ITSMEEME/PropBoard/motoranschluss_varianten/README.md

# Fünf Varianten für den Motoranschluss

Fünf eigenständige Konzeptbilder für 1, 2, 2, 3 und 4 Carbonrohre. Direktanschluss am starren Rahmenknoten und kompakter Aluminium-Motorknoten mit integrierten Befestigungsaugen am feststehenden Motorfuß; keine separate Motorplatte. Ein tatsächliches Klappgelenk ist nicht ausgelegt. Die vorhandene Motor-/Rotorbaugruppe wird durch diese Bilder nicht umgebaut oder freigegeben.

V1 verwendet Ø35/32 mm als neuen Vergleichsquerschnitt. V2–V5 verwenden den vorhandenen Ø20/17-mm-Querschnitt. Ø35/32 ist kein nachgewiesener Kaufartikel.

| Variante | Rohre | Rohrquerschnitt | Nur Rohrmasse je Arm |
|---|---:|---|---:|
| [V1 – Einrohrarm](V1.png) | 1 | Ø35/32 mm | 97.2 g |
| [V2 – Vertikale V-Gabel](V2.png) | 2 | Ø20/17 mm | 108.1 g |
| [V3 – Horizontale V-Gabel](V3.png) | 2 | Ø20/17 mm | 108.0 g |
| [V4 – Räumliches Dreieck](V4.png) | 3 | Ø20/17 mm | 161.8 g |
| [V5 – Vierrohr-Raumrahmen](V5.png) | 4 | Ø20/17 mm | 216.3 g |

Rohrmassen beruhen auf den angenommenen Zuschnittkoordinaten und1600kg/m³. **Keine Gesamtmassen-Rangfolge:** Aluminiumknoten, Klemmkappen, Schrauben, Isolierung und Verbindungsmaterial sind noch nicht volumetrisch geschlossen. Weniger Klemmstellen sind ein Gewichtsargument, aber kein Festigkeitsnachweis.

Die bisherige separate D05-Motorplatte wiegt 502.4g je Motor beziehungsweise 2.010kg für vier Motoren. Ihr Entfall ist eine Brutto-Entnahme; neue integrierte Knoten müssen gegengerechnet werden. Die bisherigen Endschotte sollen durch die direkten Knoten ebenfalls entfallen, sind jedoch nicht als zusätzliche gesicherte Nettoersparnis angesetzt.

## Warum ein einzelnes Rohr nicht automatisch genügt

Vergleichsfall:420mm idealisierter Kragarm,400N Querlast,20Nm Torsionsmoment, angenommener Biegemodul70GPa und Schubmodul5GPa. Diese Lasten und Materialwerte sind Annahmen. Keine Sicherheitsfaktoren und kein Laminat-/Verbindungsnachweis.

| Einzelrohr | Biegespannung | Durchbiegung | Verdrehung |
|---|---:|---:|---:|
| Ø20/17 mm | 448 MPa | 37.6 mm | 12.8° |
| Ø35/32 mm | 132 MPa | 6.4 mm | 2.2° |

Der größere Einzelquerschnitt wiegt pro Meter weniger als zwei Ø20/17-Rohre zusammen und hat deutlich mehr Eigen-Biegesteifigkeit als ein einzelnes Ø20/17-Rohr. Ob er insgesamt am leichtesten ist und ausreichend trägt, bleibt offen: zulässige Laminatspannungen, Mindeststeifigkeit, Dauer-/Spitzenlasten, CFK-Klemmpressung und Knotenmasse fehlen. Die bestehende Ø20/17-Ausführung wird als einzelner langer Arm durch diesen Vergleich nicht freigegeben.

## Auswahlregel zugunsten des Gesamtgewichts

Zuerst V1 mit tatsächlich verfügbarem, geeignetem Laminat und leichten Knoten auslegen. Wenn Last/Steifigkeit nicht geschlossen werden, V2/V3 mit zwei vorhandenen Rohren vergleichen. V4 nur bei belegtem Nutzen des dritten Rohrs; V5 als Rückfalloption bei zusätzlichem Bedarf. Die größere Zahl Rohre ist kein automatischer Stabilitätsnachweis. Vollständige Materialmassen, Verbindungsmassen und Belastbarkeit gemeinsam bewerten.

Die Visualisierungen sind KI-generierte Gestaltungsvorschläge und nicht maßstäblich. Schrauben, Aufnahmen und Radien sind bildlich dargestellt, nicht aus einem nachgewiesenen parametrischen CAD-Modell abgeleitet. Das nominale Motor-Anschlussbild4×M6/PCD50 stammt aus der alten Projektzeichnung und ist nicht OEM-bestätigt; gezeichnete Schraubenköpfe sind keine verbindliche Montagezeichnung. Maßgeblich für die geometrischen Rechenannahmen sind Varianten.json und die gespeicherten Prompts. Die größeren Rohrdurchmesser von V1 brauchen einen neuen Artikel und eine neue CFK-Klemmung; die alten Ø20/17-Verbinder passen dort nicht. Keine Produktions- oder Flugfreigabe; der bekannte Rotor-/Rahmenkonflikt aus D06 wird hierdurch nicht als gelöst behauptet.
