ITSMEEME/PropBoard/modell_r04_taumel/README.md

# R04-Taumelmodell 1:4

**Aktuell: P11 – Direktantrieb 1:1 mit kugelgelagerten Führungsrollen.**
[Native Konstruktion und technische Grenzen](integration_p11/README.md) ·
[Visueller Physik-Prüfstand](simulation/Physik_Pruefstand.html) ·
[Flugsimulator](simulation/H01_Flugsimulator.html).
P10 und frühere Revisionen bleiben historische Vergleichsstände. Der spätere Ringmotor
ist noch auszuwählen; EMAX bleibt die elektrische Vergleichsreferenz.

Eigenständige Variante des R04-Testmodells: Der Pitch wird **je Rotor über eine Taumelscheibe** gestellt (kollektiv + zyklisch), nicht über einen Servo je Flügel. Das Servo-je-Flügel-Modell bleibt unverändert in [`modell_r04/`](../modell_r04/Implementationsplan.md). Die Begründung steht in [`modell_r04/Bewertung_Taumelscheibe.md`](../modell_r04/Bewertung_Taumelscheibe.md).

**Entwurf, keine Freigabe.** Alle Zahlen sind Modellwerte (BEMT mit vereinfachter Polare, Gleichstrom-Motormodell) und müssen am Prüfstand bestätigt werden.

## Historischer Integrationsstand P10

[P10 ergänzt die P09-Baugruppe um vier Punkte](integration_p10/README.md):

1. Die sechs Savöx-Servos sitzen jetzt in **Servohaltern**. Die Laschen sind mit M3 auf einen Steg geschraubt, der Steg mit Füßen auf verbreiterte Halteplatten. Damit gibt es einen durchgehenden Lastpfad zum Mittelrohr; vorher hingen die Servos frei.
2. Ein **Kabelbaum** mit 34 Leitungen läuft durch das Mittelrohr: Hauptstrom, UBEC, Servo-Verteiler oben und unten, Motoren, FC und Empfänger.
3. Ein **Kufenlandegestell** aus CFK sitzt an der verlängerten Akkuverschraubung.
4. Eine **Planetenstufe** ersetzt den einseitigen Außeneingriff: innenverzahntes Hohlrad Z130 im Rotordeckel, EMAX-Ritzel als angetriebener Planet und zwei Stützplaneten. Die Übersetzung bleibt 6,5 : 1, der Motor dreht jetzt gleichsinnig mit dem Rotor.

Der [Flugsimulator](simulation/H01_Flugsimulator.html) zeigt diese Baugruppe in WebGL, animiert aus dem Physikzustand. Neu sind Strömungspartikel, Bodenstart/Landung, ANGLE- und Positionsmodus sowie Tastatur-, Gamepad- und Touch-Steuerung.

Nicht enthalten: Fertigungs-, Festigkeits- oder Flugfreigabe.

## Gemeinsame Animation P09

[P09 verbindet Servoabtrieb, sechs Servogestänge, beide Taumelscheiben, 16 gefasste Blattgestänge und Rotorblätter in einer einzigen nativen Animation](bewegung_p09/README.md). Eine Offline-Browseranimation zeigt die tatsächlichen CAD-Oberflächen. 181 Stellungen und ausgewählte Festkörperkontakte sind geprüft; die Gesamt-Fertigungs-/Flugfreigabe bleibt offen. P08 und M01 sind frühere Teilstände.

## Mechanische Servoverbindung P08

[P08 modelliert den Lastpfad vom SB-2270SG+-Abtrieb zur Taumelscheibe](fertigung_p08/README.md): Klemmhebel, gefasste Kugelgelenke, RH/LH-Verstellstangen, Kontermuttern und radiale Taumelringaufnahmen. Sechs detaillierte Gestängeeinheiten mit 90 neuen Bauteilobjekten und separater FreeCAD-Bewegung. Gesamtfreigabe bleibt wegen offener Passungs-/Material-/Festigkeitsangaben, Servohalter und weiterer P06-Punkte gesperrt.

## Aktueller Servo-CAD-Stand P07

Der Nutzer hat **Savöx SB-2270SG+** ausgewählt. [P07 integriert die hochgeladene detaillierte STEP in sechs Instanzen](fertigung_p07/README.md), einschließlich dokumentiertem Geometriefehler des Imports. SB-2271-Leistungsdaten wurden nicht auf den neuen Servo übertragen; die bisherige Flugauswertung ist damit kein SB-2270-Nachweis.

## Aktuelle Vollständigkeitsprüfung P06

**Noch nicht fertigungsbereit:** [P06 erfasst jedes modellierte Bauteil und die fehlenden Konstruktionen](fertigung_p06/README.md). Funktionsgeometrien für Gestänge/Servohebel und unvollständige Befestigungen sind weiterhin vorhanden. P05 berücksichtigt die bestätigten Motoranschlüsse M3 maximal 3 mm und M5 nutzbar 9 mm; P06 ergänzt eine bauteilweise Prüfung, keine neue Geometriefreigabe.

## Historischer Datenabgleich P04

Die bereitgestellte EMAX-Zeichnung bestätigt **4×M3 auf Lochkreis Ø16 mm**. Die widersprechende 16×16-mm-Textrecherche und ihre P03-Geometrien wurden verworfen. [Aktuelle P04-Baugruppe und Datenabgleich](fertigung_p04/README.md), [nur noch fehlende Anschlussdaten](fertigung_p04/Noch_benoetigte_Daten_P04.md). Die Gesamtkonstruktion ist weiterhin nicht fertigungsfreigegeben.

## Kaufteile und Fertigungsstand P02

Lager, EMAX-Motoren und Savöx-Servos werden als komplette Kaufteile verwendet. [P02-Integration und Status](fertigung_p02/README.md) enthält importierte und maßlich geprüfte Normschrauben/-muttern sowie eine weiterhin gesperrte Gesamtbaugruppe. [Liste der fehlenden Herstellerdaten](fertigung_p02/Herstellerdaten_Anforderung.md). Die damalige offene Lochbildfrage ist durch die spätere EMAX-Zeichnung im P04-Stand geklärt; andere Schnittstellen bleiben offen.

## Bewegungsmodell M01 und gelieferte Servodaten

Die [FreeCAD-Bewegungsbaugruppe](bewegung/README.md) ergänzt feste Servo-/Blattgestänge, Hörner, Wellen, Motorglocken und schematische Lagerinnenteile. [Daten-/Lastauswertung](messdaten/README.md) übernimmt deine Savöx-Spezifikation (69 g, 6,0–7,4 V) und unterscheidet sie von noch ungemessener Reibung/Dynamik. Das aktuelle Massenbudget mit sechs solchen Servos beträgt **1,578 kg ohne neue Halter/BEC**. [Berechnete Aerodynamik](aerodynamik/README.md) verwendet das echte CAD-Profil mit 0,6-mm-Hinterkante; keine empirische Validierung. Der KST X15-755X ist auf dem Bild als 760-µs-Version ausgewiesen und bleibt reine Geometrie-Vergleichsoption.

## Geregelte Flugsimulation H01

[H01-Flugsimulator öffnen](simulation/H01_Flugsimulator.html): Das aktuelle FreeCAD-Modell liefert Schwerpunkt, volle Trägheitsmatrix und die sichtbare Geometrie. Der Simulator ergänzt sechs Freiheitsgrade, dynamische Rotorströmung, zwei Motor-PIDs, sechs lastbegrenzte Servoregler und eine kaskadierte Flugregelung. [Physik, Testfälle und Grenzen](simulation/README.md). Numerische Flugversuche ersetzen keine Messung oder Flugfreigabe.

## Gemeinsam mit dem Servo-Modell

Maßstab 1:4 (Flügelkreis Ø 375 mm, 8 Flügel je Ebene, Sehne 30 mm, NACA 0012, Ebenenabstand 60 mm), EMAX ECO II 2306 KV1900, SpeedyBee F405 V4 + BLS 55A (Bluejay), ELRS, Tattu 1550 mAh 6S, Druck auf 200 × 148 × 150 mm, PA-CF/PETG-CF für drehende Teile, Prüfstand draußen mit Schub- und Summenmoment-Wägezelle. Simulator und Antriebsmodell werden gemeinsam genutzt (`kreis_r04/simulation`, `modell_r04/auslegung/antrieb.js`).

## Unterschiede

| | Servo-Modell (`modell_r04`) | Taumelmodell (dieses Verzeichnis) |
|---|---|---|
| Pitchsteuerung | 16 drehende Servos, nur langsam | 2 Taumelscheiben, 6 feststehende Servos; kollektiv + **zyklisch** |
| Rotorelektronik | ESP32, Akkus, Funk je Rotor | keine |
| Flügelprofil ab | r = 62 mm | **r = 48 mm** (näher an R04: 37,5 mm) |
| Nabe | Trommel mit Servotaschen | **Topf** (Innenring, Boden, Außenwand), Pitchhebel innen |
| Zahnkranz / Ritzel | 91 Z / 14 Z, Motor bei r = 52,6 mm | **130 Z / 20 Z**, bis P09 außen mit Motor bei r = 75,1 mm; ab P10 Hohlrad innen, Motor bei r = 54,8 mm / 330°, zwei Stützplaneten, gleiche Übersetzung 6,5:1 |
| Flugsteuerung | offen | Roll/Nick zyklisch, Gieren über Differenz von Kollektiv bzw. Drehzahl |

## Elektronik und Firmware

- **Ausgänge:** Laut ArduPilot-Dokumentation hat der SpeedyBee F405 V4 bis zu 9 PWM-Ausgänge: M1–M4 am ESC-Stecker, M5–M8 auf Pads, PWM 9 am LED-Pad. Sie sind gruppiert (1-2, 3-4, 5-6, 7-8, 9), und innerhalb einer Gruppe muss das Protokoll gleich sein.
  - Vorschlag: M1/M2 DShot für die Motoren, M5–M8 und PWM 9 für fünf Servos (PWM).
  - Der sechste Servo braucht einen weiteren Ausgang, z. B. M3 oder M4 (Gruppe 3-4 auf PWM umstellen, ESC-Kanäle 3/4 dann unbenutzt). **Am Board prüfen.**
- **Prüfstand:** Für die ersten Messungen genügt die direkte Kanalzuordnung (Kollektiv oben/unten, Zyklik) über Sender bzw. Mischer.
- **Flug:** ArduPilot TradHeli mit `FRAME_CLASS 11` (Heli Dual).
  - Die offizielle Doku nennt die Modi Tandem, quer und ineinandergreifend.
  - Für Koaxialaufbauten wird `H_YAW_SCALER = 0` genannt. Ein eigener Koaxialmodus ist nur aus einem Forumsbeitrag mit angepasstem Code bekannt.
  - **Ob und wie der koaxiale Doppeltaumelscheiben-Aufbau damit läuft, ist am Prüfstand zu verifizieren**; sonst wird ein eigener Mischer nötig.

Quellen: [ArduPilot Dual Helicopter](https://ardupilot.org/copter/docs/dual-helicopter.html), [ArduPilot SpeedyBee F4 V3/V4](https://ardupilot.org/plane/docs/common-speedybeef4-v3.html), [Forum: Co-axial heli](https://discuss.ardupilot.org/t/new-co-axial-heli/60067).

## Inhalt

Die [unabhängige Mechanikprüfung](mechanik/README.md) untersucht die geschlossene Taumelscheibenkinematik und den Servobedarf einschließlich Pitchwurzelreibung und Massenrückkopplung. Die frühere pauschale 9-g-Servoempfehlung ist damit nicht bestätigt. [Halterungen H01](halterungen/README.md) ergänzen FC/ESC und den Akku 78 × 37 × 52 mm. Die Servoprodukte sind wegen noch gesperrter Herstellerdatenzugriffe als unbestätigte Kandidaten dokumentiert.

Die **Cohexial Study, Fertigungsentwurf F01**, liegt unter [`cad/`](cad/README.md): native Baugruppe, skriptparametrische Einzelteile mit TechDraw-Seiten, STEP/STL, Zeichnungssatz und Stücklisten. Führungsnut, Mitnehmerstift und Kappenanordnung wurden gegenüber V1 korrigiert. Fehlende Kaufteilanschlüsse, Passungen und Festigkeitsnachweise sind in den [Fertigungshinweisen](cad/Fertigung/Fertigungshinweise.md) aufgeführt; es liegt keine Fertigungsfreigabe vor.

- [`cad/`](cad/README.md): parametrisches FreeCAD-Modell, STL-Dateien, Prüfbericht
- [`auslegung/`](auslegung/): Nachrechnung der Betriebspunkte und der Steuerwirkung mit CAD-Masse

## Motoranschluss P05

[Bestätigte 9-mm-M5-/3-mm-M3-Anschlüsse und Montageentwurf](fertigung_p05/README.md). Native Baugruppe und STEP-Anschlussreferenzen inklusive Prüfbericht; Gesamtfreigabe weiterhin offen.
