ITSMEEME/PropBoard/quad_r380_d13/Quellen/README.md

# Quellenstatus

Verwendete Norm-/Schnittstellenreferenzen: ASTM B258 (nominaler AWG-Leiterdurchmesser/-querschnitt), IEC 61076-2-101 (M12-Steckfamilien), IEC 61076-2-104 (M8-Steckfamilie), CiA 303-1 (CANopen-Steckerbelegung als Referenz für den projektseitigen CAN-Anschluss). Es wird keine Prüfung gegen den vollständigen kostenpflichtigen Normtext oder eine bestimmte Ausgabe behauptet. Die neue Kabelkonfektion ist weder normzertifiziert noch OEM-freigegeben.

Die V200A-Daten stammen aus der vom Nutzer übermittelten Tabelle; [Transkription und Datensatz](../../quad_r380_d12/Quellen/Regler/). Die Originaltabelle enthält keinen Außen-Ø der DC- oder Encoderleitung und keine eindeutige Pinbelegung der JP-/M6-Anschlüsse. D13 ergänzt diese Lücken nicht durch erfundene Herstellerdaten.

Anderson SB120 ist eine ausgewählte Herstellerfamilie, keine allgemeine IEC-Gehäusenorm. Ein konkreter Artikel mit Datenblatt, zulässigem Kontakt für AWG10 und Original-CAD wurde noch nicht verifiziert. Die dokumentierten Einbaureserven und maximalen Leitungsdurchmesser sind Projektanforderungen. Sie sind nicht als aus einem Herstellerdatenblatt entnommene Maße zu verwenden. Es wurde kein fremdes CAD-Modell übernommen.
