ITSMEEME/PropBoard/quad_r380_d12/Ausgabe/Landelast_Kurzbericht.md

# Vorbemessung, keine Freigabe

Default V4/42 Zoll: vier kombinierte Einheiten 1.219 kg, Zuwachs gegenüber D11 0.772 kg. Gleichgeometrische Aluminiumstützen wären 120 g schwerer. Tatsächliche Regler fehlen in beiden Massen.

Annahme: 160 kg Gesamtmasse einschließlich 100 kg Nutzlast, 3 g vertikaler Spitzenlastfaktor auf zwei Füßen. Daraus folgen 2354 N je Fuß, bei gleicher Teilung 1177 N pro CFK-Stütze. Mittlere axiale Spannung 13.5 MPa, mittlere Klebfugenschubspannung 0.76 MPa. Es liegen keine qualifizierten Vergleichszulässigkeiten vor; diese Zahlen begründen keine Tragfähigkeitsfreigabe.

Bei 0,5 m/s Sinkgeschwindigkeit müssen bei 160 kg bereits 20 J Bewegungsenergie abgebaut werden. Für ideal konstante Verzögerung bei insgesamt 3 g wären 6,37 mm Weg erforderlich; bei nur 2 mm wären es etwa 7,37 g. Reale Spitzen können höher liegen. Die Sohle und der Rahmen haben keine gemessene Kraft-Weg-Kennlinie.

Die vergrößerten Schellen verteilen die nominelle Kontaktlast; Rohrquetschung, Verbundlaminat, Spannkraft und Gesamtarm bleiben nachzuweisen. Isolierte Stützenrechnung ersetzt keinen Nachweis der Carbonarme und ihrer Rahmen-/Motoranschlüsse.

Zuschnitt (je Länge vier Stück, Ø20/17): 153.74 mm und 160.01 mm. Sägeschnitt/Endbearbeitung und Bauteiltoleranzen müssen vor Fertigung ergänzt werden.
