ITSMEEME/PropBoard/modell_r04_taumel/fertigung_p06/Bauteilbericht.md

# P06 – vollständige Bauteilprüfung

Geprüft: 234 modellierte Bauteilobjekte und 4 Zugangs-/Freiräume. Alle Festkörper gültig und native Datei erneut geöffnet. **Gesamtstand nicht fertigungsbereit.**

Das Prüfergebnis bewertet Fertigungsvollständigkeit, nicht nur die Gültigkeit der Festkörper. Es verändert keine Geometrie und erteilt keine Freigabe.

| Bauteilkennung / Rolle | Anzahl | Darstellung | Noch auszuarbeiten |
|---|---:|---|---|
| FUEHRUNGSSTIFT-D3 | 2 | Nennmassreferenz | Stiftartikel, Befestigung am Taumelring und Verschleisspaarung festlegen. |
| H01 | 2 | Konstruierter Festkoerper | Kappe/Rohr: axiale Sicherung und Sitz-/Klemmtoleranzen festlegen; Stack-Daempfer/Anlagehoehen abstimmen. |
| H02 | 4 | Konstruierter Festkoerper | Zuordnung zu realem Stack und Daempfern; Toleranzen, Material/Prozess und Verschraubung abschliessen. |
| H03 | 4 | Konstruierter Festkoerper | Verschraubung, Toleranzen und Material/Prozess abschliessen. |
| H04 | 1 | Konstruierter Festkoerper | Rohr-/Kappenverbindung und Batteriehalter-Verschraubung abschliessen; Toleranzen und Material/Prozess festlegen. |
| H05 | 1 | Konstruierter Festkoerper | Akku 78x37x52 vorhanden; reale Polster-/Bandfixierung, Schraubenklemmung und Kabelzugang abschliessen. |
| H06 | 4 | Konstruierter Festkoerper | Endgueltige Klemmlaenge, Laengentoleranz und Werkstoff mit Batterieverschraubung abstimmen. |
| H07 | 1 | Konstruierter Festkoerper | Rohrprodukt/Werkstoff und Toleranzen, Kappen-/Klemmstellen und Kabeldurchfuehrung abschliessen. |
| ISO4032-M3 | 4 | Importiertes Normteil | Festigkeitsklasse, Bezugsartikel und Anzug/Sicherung festlegen. |
| ISO4035-M5 | 2 | Nennmassreferenz | Duennmutter h2.7: realen Artikel/Guete und Anzug/Losdrehsicherung am M5-Ritzel festlegen. |
| ISO7089-M3 | 8 | Nennmassreferenz | Realen Scheibenartikel und Dickengrenzen im P05-Einschraubbudget bestaetigen. |
| KUGELBOLZEN-M2 | 38 | Funktionsschema | Konkreten Kugelbolzen mit bemaesstem Gewinde, Sitz, Sicherung und passender Pfanne waehlen. |
| LAGER-6806 | 4 | Nennmassreferenz | Konkreten 6806-2RS-Artikel/Spielvariante und Anschlusszeichnung mit Fasen-/Schultergrenzen waehlen; Sitze/axiale Haltung darauf auslegen. |
| LAGER-6809 | 2 | Nennmassreferenz | Konkreten 6809-2RS-Artikel/Spielvariante und Anschlusszeichnung mit Fasen-/Schultergrenzen waehlen; Sitze/axiale Haltung darauf auslegen. |
| M01_Servoanschluss | 6 | Funktionsschema | 8mm-Hebel ist Funktionsgeometrie, kein bestaetigtes 25T-Kaufhorn; Aufnahme, Halteschraube und Kugelbolzenanschluss fehlen. |
| M01_Servoanschluss | 6 | Funktionsschema | Kugel ist Funktionsreferenz ohne realen Gewinde-/Sicherungsanschluss; konkreten Kugelbolzen waehlen. |
| M01_Servoanschluss | 6 | Funktionsschema | Zylinder ist Funktionsreferenz, keine vermessene 25T-Verzahnung. Gehoert zum kompletten Kaufservo. |
| M2x35 | 2 | Funktionsschema | Reale Schraube mit Kopf/Mutter/Anlageflaechen und finaler Klemmlaenge festlegen. |
| M3x12 | 4 | Importiertes Normteil | Nenngeometrie geprueft; Festigkeitsklasse, Bezugsartikel und Anzug/Sicherung festlegen. |
| M3x40 | 4 | Importiertes Normteil | Stack-Daempfer, obere Muttern und reale Anlagehoehen fehlen; Festigkeitsklasse/Anzug/Sicherung festlegen. |
| M3x7-P05-REFERENZ | 8 | Abgeleitete Normteilreferenz | Realen M3x7-Artikel/Guete beschaffen, Laengengrenzen und Anzug bestaetigen; CAD nur gekuerzte M3x10-Referenz. |
| M3x80 | 4 | Funktionsschema | Reale Batterieverschraubung mit Kopf, Muttern, Scheiben, Klemmlaenge und Sicherung abschliessen. |
| MITNEHMERSTIFT-D3 | 2 | Nennmassreferenz | Stiftartikel, Einbindung und axiale Sicherung festlegen; nominal D3 in D3.1 ist keine Sicherung. |
| MOTOR-ECO2-2306 | 2 | Bemasste Anschluss-/Bauraumreferenz | PCD16, M3 max3 und M5 nutzbar9 bestaetigt. Nicht bemasste Fuss-/Pilotkontur pruefen; Schrauben-/Kontermutteranzug und Rundlauf fehlen. Keine OEM-Innenteile erforderlich. |
| REF_AKKU | 1 | Bemasste Bauraumreferenz | Realen Akkuartikel, Polster/Band und Kabelaustritt/Steckerfreiraum bestaetigen. Keine Zellinnenteile erforderlich. |
| REF_ESC | 1 | Bemasste Bauraumreferenz | 55A-ESC: reale Daempfer-/Anlagehoehen, Kuehlung und Kabelraeume bestaetigen. |
| REF_FC | 1 | Bemasste Bauraumreferenz | F405-V4: reale Daempfer-/Anlagehoehen und Stecker-/Kabelraeume bestaetigen. |
| REF_POLSTER | 1 | Nennmassreferenz | Polstermaterial, Dicke/Kompression und Zuschnitt verbindlich festlegen. |
| RITZEL-M1-Z20 | 2 | P05 Gewinderitzelentwurf | M5x0.8-6H ist spezifiziert; Gewindeauslauf, Rundlauf/Zahnqualitaet, Anzug/Vorspannung und Losdrehsicherung nachweisen. Keine glatte Bohrung fertigen. |
| SERVO-PLATZHALTER | 6 | Savox Aussenreferenz | Savox SB-2271SG(+): genaue Variante, Laschendicke/Schlitzmasse und Hornanschluss fehlen; vollstaendiger tangentialer Halter fehlt. |
| SERVOSTANGE | 6 | Funktionsschema | Reale Pfannen, Einstellbereich, Gewindeeingriff und Schwenkraum fuer jeweilige Einbaulaenge fehlen. |
| STEUERSTANGE | 16 | Funktionsschema | Reale Pfannen/Gewindestange fuer 15mm Kugelmittenabstand; Gewindeeingriff, Montage und Schwenkraum fehlen. |
| STIFT-D2x18 | 32 | Nennmassreferenz | Konkreten Stiftstandard/Artikel, Enden, Sitzpassung und Sicherung festlegen. |
| TM-DECKEL-ZAHNKRANZ-130 | 2 | Konstruierter Festkoerper | Deckelbefestigung und Mitnehmerstift sichern; Verzahnungs-/Rundlauf- und Fertigungstoleranzen festlegen. |
| TM-FLUEGEL | 16 | Konstruierter Festkoerper | Fluegelzapfen/Nut/Stiftsitz: Passungen, Verschleiss und tragfaehige Sicherung; Werkstoff-/Prozess- und Toleranzfestlegung. |
| TM-HALTEPLATTE | 2 | Unvollstaendiger Anschluss | Motorlochbild PCD16 bestaetigt; Kragen ohne fertige Klemmschraubverbindung; tangentiale Servohalter und deren Lastpfad fehlen. |
| TM-HUELSE-MITTE | 1 | Konstruierter Festkoerper | Passung, axiale Festlegung und Montagebezuege festlegen. |
| TM-KLEMMRING | 2 | Unvollstaendiger Anschluss | Klemmschraube und tragfaehige axiale Rotorsicherung fehlen. |
| TM-NABE | 2 | Konstruierter Festkoerper | Zapfenlagerung und D2-Stiftsitze: Passungen und Sicherung; Lagersitz und axiale Lagerhaltung. |
| TM-PITCHHEBEL | 16 | Unvollstaendiger Anschluss | Realer Kugelbolzenanschluss fehlt; Vierkantpassung und axiale Hebelsicherung fehlen. |
| TM-TAUMEL-DREHRING | 2 | Unvollstaendiger Anschluss | Reale Kugelbolzenanschluesse, Lagerpassung und axiale Lagerhaltung festlegen. |
| TM-TAUMEL-GLEITKUGEL | 2 | Montage ungeklaert | Geschlossene Kugel-/Pfannenpaarung: Montagefolge bzw. Teilung mit Befestigung ausarbeiten; Gleitpassung/Oberflaeche festlegen. |
| TM-TAUMEL-INNENRING | 2 | Unvollstaendiger Anschluss | Kugelbolzen-/Fuehrungsstiftbefestigung und Kugelmontage fehlen; Gleitpassung festlegen. |

## Noch nicht vorhandene Bauteile

- Tangentialer Servo-Montagehalter: Noch kein finaler Halter mit passenden Savox-Laschenanschluessen, Schrauben und Lastpfad vorhanden.
- Klemm-/Axialsicherungsbefestigungen: Baugruppe enthaelt noch nicht alle notwendigen Klemmschrauben, Sicherungen und Anschluesse; Anzahl folgt aus fertiger Konstruktion.

## Bereits bestätigte Motoranschlüsse

4×M3 auf Ø16 mm Teilkreis; M3 maximal 3 mm Einschraubtiefe; M5 nutzbar 9 mm. P05 enthält M3×7 plus 0,5-mm-Scheibe bei 4-mm-Platte (2,5 mm Einschraubtiefe), Gewinderitzel 5,5 mm plus dünne Kontermutter 2,7 mm. Diese Maße werden nicht erneut angefordert.

M3/M5-Gewinde dürfen in einem Fertigungsmodell normgerecht vereinfacht dargestellt werden, wenn Zeichnung und Prüfmaße sie eindeutig festlegen. Fehlende Anschlüsse werden dadurch nicht vollständig. Kaufmotor-/Servo-/Lagerinnenteile werden gemäß vereinbarter Kaufteilstrategie nicht selbst gefertigt.
