ITSMEEME/PropBoard/quad_r380_d01/BESCHAFFUNGSAUFTRAG.md

# Quad R380 – gezielter Beschaffungsauftrag

Ziel: belastbare Komponentenauswahl und mechanische Integration. Lesender Zugriff; keine Bestellung, Registrierung oder Herstelleranschreiben beauftragt.

Freigabe für HTTPS, jeweils Stammdomain und www: emrax.com, plettenberg-motors.com, mgm-compro.com, mejzlik.eu, molicel.com, skf.com, te.com, littelfuse.com. Falls Hersteller auf zusätzliche Download-/CDN-Hosts verweisen, diese mit konkretem Quelllink benennen und gezielt ergänzen lassen. Keine Umgehung der Netzwerkregeln.

| Baugruppe | Gesuchte Unterlagen |
|---|---|
| Motoren: EMRAX / Plettenberg | Dauer- und Spitzenmoment über Drehzahl, Spannung, Strom, Wirkungsgrad, Kühlbedingungen, Temperaturgrenzen, Masse, Wellen-/Befestigungszeichnung, axial/radial zulässige Lagerlasten, STEP |
| Regler: MGM COMPRO | kompatible Motor-/Spannungsbereiche, dauerhafter Phasen- und Batteriestrom, Kühlung, Masse, Anschlussbelegung, Gehäusezeichnung/STEP |
| Rotoren: Mejzlik | nahe 760 mm Durchmesser, CW/CCW, Blattzahl, Schub-/Leistungskurven über Drehzahl, maximale Drehzahl, Blatt-/Nabenlasten, Befestigung, Masse, STEP/Zeichnung |
| Zellen: Molicel | aktuelles Datenblatt, Entladekurven, DCIR, Dauerstrom mit Temperaturbedingungen, Maßtoleranzen, Zellmasse, Lebensdauer, Sicherheits-/Transportunterlagen |
| Lager: SKF | Abmessungen, Lastzahlen, Drehzahlgrenzen, Passungen, Schmierung, STEP; erst nach Last-/Wellenklärung auswählen |
| Hochstromkomponenten: TE / Littelfuse | Stecker, Kontaktoren, Sicherungen: DC-Nennwerte und Abschaltvermögen, Temperaturderating, Widerstand, Gehäuse/STEP |

Je Dokument: Originaldatei, Hersteller-URL, Abrufdatum, Revision, SHA256 und konkrete Seiten-/Tabellenstelle. Werte mit Betriebsbedingungen übernehmen; fehlende Daten als offen markieren. Keine Drittanbieterangaben als OEM-Beleg ausgeben. Keine Daten durch Annahmen ersetzen.

Anforderungskorridor aus bisherigem *unbestätigten* Dreiblatt-Rechenmodell: vier unabhängige Antriebe, Rotor-Radius 380 mm, 150–200 kg Gesamtmasse, etwa 4.870–5.620 U/min, 18,6–24,8 Nm Schwebe-Drehmoment pro Antrieb. Ungefähre Wellenleistung pro Motor einschließlich 30 % Rechenreserve: 12,35–18,96 kW. Das sind Suchwerte; tatsächliche Rotor-/Motor-Kennfelder müssen sie ersetzen. 30 % Reserve ersetzt keine thermische oder mechanische Prüfung. Rotor-Drehzahlgrenzen und Anschlusskompatibilität zuerst prüfen.

Bisher kein OEM-Antrieb endgültig ausgewählt. IF90 im Rahmen ist ein projekteigenes Anschlussbild. Geeignete Alternativen dürfen mit nachgewiesenen Daten vorgeschlagen werden; Domain-Erweiterungen konkret begründen. Netzwerkkonfigurationsentwurf ist gespeichert, Aktivierung erfolgt durch Prüfung und Veröffentlichung in den Umgebungseinstellungen.
