ITSMEEME/PropBoard/quad_r380_d02/HERSTELLERDATEN.md

# Fehlende Daten für Antrieb, Akku und Elektronik

**Aktualisierung:** Ein ausdrücklich unbestätigter Text-Extrakt liegt jetzt vor. [Plausibilitätsbewertung und gezielter Nachauftrag](KENNDATEN_BEWERTUNG.md). Original-PDFs und verbindliche CAD-/Anschlussunterlagen fehlen weiterhin.

**Die Daten fehlen für eine konkrete Auswahl und die anschließende Detailintegration. Kein Motor-/Regler-/Akkutyp ist bisher abschließend ausgewählt.** Die genannten Hersteller sind Beschaffungskandidaten, keine freigegebenen Stücklistenpositionen. Zeichnungen allein reichen für Produktionsreife nicht aus.

| Baugruppe / Kandidaten | Vorhanden | Benötigt, um die Konstruktion zu schließen |
|---|---|---|
| Motor: T-Motor MN1330 KV40 | Nutzerzeichnung, XLS, 19 NS52x20-Prüfpunkte, teilweise Zeitangaben | Dauerkennfeld Drehmoment/Drehzahl/Strom/Wirkungsgrad bei definierter Spannung, Kühlung und Temperatur; zulässige Rotorträgheit sowie Axial-/Radiallasten; verbindliche Montagebezüge 65/66 mm, Gewindetiefen, STEP, Kabelabgang, Steckerkonfiguration. Bisherige Prüfpunkte decken den QuadR380-Dauerbetrieb nicht ab. |
| Alternative Motoren: EMRAX/Plettenberg | bisher keine verifizierten Unterlagen im Projekt | dieselben Kennfelder/Lastgrenzen; reale Masse einschließlich Kühlung; max. elektrische Drehzahl, Polzahl, Sensorik; Welle/Zentrierung/Flansch, Rundlauf und Befestigung; Cooling-loop-Anschlüsse und Betriebsbedingungen |
| Rotor/Nabe: Mejzlik oder technisch geeignete Alternative | R380-Dreiblatt-Rechenmodell mit angenommener Aerodynamik | real lieferbarer Rotor nahe Ø760 mm, CW/CCW, Blattzahl, Schub-/Drehmoment-/Leistungskennfelder über Drehzahl; max. Drehzahl, zugelassene Nabe/Schrauben, Blatt-/Nabentraglast, Masse/Trägheit, STEP/Zeichnungen; Abstand der flexiblen Blätter unter Last |
| Regler: MGM COMPRO oder bestätigter Motorkombinationslieferant | keine konkrete Ausführung | DC-Spannungsbereich bis maximaler Packspannung und Überspannung; dauerhafter DC-/Phasenstrom (unterscheiden!), Schaltfrequenz, Temperaturderating, Kühlbedingungen; Motor-/Geber-Kompatibilität, Befestigung/STEP, Anschlüsse, Pinbelegung, Leistungskabelabgänge, zulässige DC-Leitungslänge/Zwischenkreiskapazität |
| Akkuzellen: Molicel oder vollständiger Packlieferant | kein bestätigter Zell-/Packtyp | Originaldatenblatt samt Revision; Lade-/Entladekurven, Mindestspannung unter Last, Innenwiderstand/Temperatur/Alterung, Dauerstrom mit Abbruchtemperatur, Maße/Toleranzen/Masse, zulässige Kontaktierung/Schweißung, Entgasungsrichtung und notwendige Kühlung |
| Batteriepack | kein geschlossener Packentwurf | bestätigte S/P-Konfiguration aus Massen-/Leistungsiteration, Zellhalter/Kompression, Busbars, Schweiß-/Kontaktprozess, Isolation und Kriechstrecken, Sicherungen, Entgasung, mechanische Lastgrenzen, Gehäuseabdichtung, Kühlung, Wartungs-/Entnahmekonzept. Bei Fertigpack: verbindliche Gesamtzeichnung/STEP, Innenverschaltung, Anschlussbelegung, Masse/Schwerpunkt, Strom-/Temperaturlimits |
| BMS | kein Lieferteil ausgewählt | zulässige Zellenzahl/Chemie, galvanische Trennung, Messleitungen/Pinout, Strommessung, Temperaturfühler, Fehlerlogik, Kontaktor-/Vorladesteuerung, Zeichnung/STEP und Befestigung; Hauptstrom muss nicht durch die BMS-Platine fließen |
| Schütze/Vorladung/Service-Trenner: TE/Littelfuse oder Alternativen | keine bestätigten Typen | DC-Schaltvermögen bei tatsächlicher Spannung/Fehlerstrom, Schaltpolarität, Einschalt-/Abschaltgrenzen, Dauerstrom/Derating, Spulenversorgung, Hilfskontakte, Kontaktwiderstand, Anschlüsse/Anzugsmomente, Maßzeichnung/STEP; Vorladewiderstand Impulsenergie und Zwischenkreiskapazität |
| Haupt-/Abzweigsicherungen: Littelfuse | keine bestätigten Typen | DC-Nennspannung und Abschaltvermögen, Zeit-Strom-Kurven, I²t, Derating, Verlustleistung, Abmessungen, Halter/Schutzabdeckung; Selektivität gegenüber Zell-/Pack-Kurzschluss nachweisen |
| Kabel/Stecker: TE und geeigneter Kabelhersteller | logische Stromkreise benennbar, keine Liefergeometrien | Kabelaufbau/Leiterquerschnitt, tatsächlicher Außendurchmesser, Temperaturklasse, Strombelastbarkeit bei Bündelung/Kühlung, minimaler statischer/dynamischer Biegeradius, Schirm-/Masseführung; Steckgehäuse UND Kontakte, Crimpwerkzeug, Zugentlastung, Ein-/Aussteckweg, Verriegelung, Spannungs-/Stromderating, STEP/Pinout |
| Flugsteuerung/IMU/DC-DC | kein konkreter freigegebener Geräteverbund | genaue Modelle, Stromaufnahme/Spannungsbereich, Befestigung/STEP und Steckerpositionen, CAN/PWM/Geber-Belegung, galvanische Trennung, Vibrationsgrenzen, Kühlung und Redundanz-/Fehlerverhalten |
| Kühlung | keine bestätigten thermischen Lasten | Verlustleistungen aus gemessenen Betriebspunkten; Pumpen-/Lüfterkurven, Kühlerkennwerte, Fluide, Schlauch-/Fittingmaße, Biegeradien, Entlüftung und zulässige Einbaulagen |
| CFK CBU20171005TG / Klemmung | Nutzerangabe Ø20/17x1000, OD +/-0,2; originale P12-Aluklemmen | Hersteller/Lieferquelle eindeutig identifizieren; Laminataufbau, orthotrope Steifigkeiten/Festigkeiten, ID-Toleranz, zulässige lokale Flächenpressung; PU-Reibung/Haftung, Ermüdung und Einflüsse der Isolierlage; Qualifikation der Klemmkräfte und Schlupfsicherung |

Bei Beibehaltung von 24S mit 4,2 V Zell-Ladeschlussspannung ergäben sich maximal 100,8 V. Für 40 KV entspricht das idealisiert nur 4032 U/min im Leerlauf, unter Last weniger. Damit lässt sich der oben gemeinte alte QuadR380-Suchbereich von mindestens etwa 4870 U/min nicht einfach mit dem MN1330 KV40 im Direktantrieb abdecken. Eine andere Rotor-/Motor-/Spannungskombination ist anhand echter Kennfelder zu wählen; 24S ist für D02 noch nicht festgelegt.

## Beschaffungsformat

Je Quelle Originaldatei, Hersteller-URL, Abrufdatum, Dokumentrevision, relevante Seiten/Tabelle und SHA256. STEP und Zeichnung auf gleiche Variante/Revision prüfen. Interne Rotor- oder Motorgeometrie ist nur nötig, soweit Lastpfad, Kühlung oder Schnittstellen sie erfordern; unbekannte Kaufteilinnereien nicht erfinden.

Vorläufiger Suchkorridor: vier Antriebe mit R380; aus dem unbestätigten alten Dreiblattmodell bei 150–200 kg etwa 4870–5620 U/min, 18,6–24,8 Nm Schwebe-Drehmoment pro Motor und 12,35–18,96 kW Wellenleistung je Motor einschließlich 30 % Rechenreserve. Nach der CFK-Umstellung muss die komplette Masse neu iteriert werden. Diese Werte sind keine bestätigte Komponentenauslegung.

Lesender HTTPS-Zugriff, Stammdomain und www: emrax.com, plettenberg-motors.com, mgm-compro.com, mejzlik.eu, molicel.com, skf.com, te.com, littelfuse.com. Der konkrete CFK-Anbieter und Lieferanten für BMS, Flugsteuerung und Kabel kommen nach eindeutiger Identifikation hinzu. Download-/CDN-Hosts nur anhand tatsächlicher Herstellerlinks ergänzen.

Umgebungsstatus erneut geprüft: Herstellerhosts weiterhin nicht freigeschaltet. Der bereits gespeicherte Netzwerkentwurf wurde noch nicht aktiviert. Daten können alternativ vom beauftragten Beschaffungsagenten als Dateien im Projekt bereitgestellt werden. Keine Bestellung oder Herstellerkontaktaufnahme beauftragt.
