ITSMEEME/PropBoard/tragfaehigkeit/Nachweisversuch.md

---
title: "PropBoard – Tragfähigkeits-Nachweisversuch"
subtitle: "Geometrie, Massen, Antrieb, Batterie und Struktur · rechnerischer Prüfstand"
lang: de-DE
---

# 1. Ergebnis

**Der Nachweis für 100 kg Personengewicht plus Ausrüstung ist mit dem aktuellen Entwurf nicht erbracht. Eine zulässige Nutzlast in kg wird nicht freigegeben.** Das bedeutet weder, dass die nachgewiesene Tragfähigkeit 0 kg betrage, noch dass jeder weiterentwickelte Flügelumlauf unmöglich sei.

Dieser Bericht geht über ein bloßes „Daten fehlen“ hinaus: Er rechnet ausgewählte CAD-Materialgruppen nach, leitet Auftriebs- und Umlenkanforderungen ab, untersucht Energiebedarf und Akku-Massenrückkopplung in ausdrücklich definierten Referenzmodellen und prüft einzelne mechanische Bedingungen. Ein positiver Nachweis darf jedoch nicht durch frei gewählte Auftriebsbeiwerte, Wirkungsgrade oder Akkudaten ersetzt werden.

Wesentliche Ergebnisse:

- Ausgewählte Materialgruppen ergeben bei angesetzten Dichten bereits **75,36 kg**. Das ist eine unvollständige, bedingte CAD-Massenrechnung, kein gemessenes Leergewicht und keine allgemeine Untergrenze für einen später optimierten Entwurf.
- Im quasistationären Geometrieszenario benötigen 200 kg Gesamtmasse bei angenommenem CL = 1 ungefähr **50,05 m/s** am Bahnmittelpunkt. Dieser CL wurde für den realen Flügel nicht nachgewiesen.
- Das ergibt am mittleren Radius ungefähr **5568 N pro kg bewegter Masse** an radialer Schwerpunktkraft. Gegenläufigkeit beseitigt diese lokalen Lasten nicht.
- Der früher beschriebene Tattu-Pack passt nach seinen gegebenen nominalen Abmessungen nicht in die aktuellen 60-mm-hohen Modulräume.
- Im untersuchten hypothetischen 54-Fälle-Raster aus Akkuenergiedichten, Wirkungsgraden und 0/10/20 kg Ausrüstung werden im Vergleichsmodell maximal **9,33 Minuten** erreicht. Das gilt nur für diese Annahmen; es ist keine allgemeine Flugzeitgrenze.

Es wurden **keine neue realmaßstäbliche 3D-CFD, kein Magnetfeldnachweis, kein Antriebsprüfstand und kein Flugversuch** ausgeführt. Die derzeitige Konstruktion bleibt ein Vorentwurf.

# 2. Ziel und erforderliche Nachweiskette

Gefordert sind 100 kg Personengewicht zuzüglich Ausrüstung, maximal 2100 × 1700 × 600 mm Fahrzeughülle, mindestens 15 Minuten Flugzeit und ungefähr 80 km/h Zielgeschwindigkeit. Die Ausrüstungsmasse wird mangels bestätigtem Wert mit 0, 10 und 20 kg getrennt betrachtet. Zehn Kilogramm sind ein Rechenfall, keine bestätigte Nutzervorgabe.

Der Nachweis müsste gleichzeitig schließen:

1. `F_z,dauer >= m_gesamt × g`, mit ausreichender Regel-/Manöverreserve und kontrollierbaren Restkräften/Momenten.
2. `m_gesamt = Person + Ausrüstung + Struktur + bewegte Teile + Antriebe + Elektrik + Akku + Schutz + Nebenaggregate`.
3. Dauerkräfte, Drehmomente, Winkelraten und Temperaturen der tatsächlichen Linear-/Pitchantriebe und Führungen.
4. Genügend nutzbare Akkuenergie **und** gleichzeitig genügend Strom-/Dauerleistungsfähigkeit im zulässigen Bauraum.
5. Nachweis der CFK-Laminate, Verbindungen, Lager-/Fangkräfte, Ermüdung und Bewegungsfreiheit.

Nur ein Gleichgewicht der aerodynamischen Kraft ist noch keine zulässige Personen-Tragfähigkeit. Ein 30-%-Auftriebszuschlag wird weiter unten ausschließlich als zusätzliche Rechenannahme gezeigt; er ist keine Normvorgabe und kein ausreichender Ausfallnachweis.

# 3. Geometrie und Massenrechnung aus dem CAD

Die Hauptvariante besitzt zwei horizontale Gegenläufe mit zusammen 16 Flügeln, jeweils 120 mm Sehne und 600 mm Spannweite. Die geometrische Flächensumme beträgt 1,152 m². Mittlerer Kurvenradius: 450 mm. Gerade Abschnitte: je 500 mm. Die Batteriebauräume umfassen zusammen 6,72 Liter.

Für die Massenrechnung wurden aus `Stueckliste_Instanzen.csv` ausschließlich die markierten Körper der Steh-Hauptbaugruppe ausgewertet. Personenreferenzen und reine Antriebs-/Elektronik-Bauraumkörper wurden nicht als reale Hardwaremassen behandelt. Die Dichten sind ausdrücklich angenommene Rechenwerte, keine bestätigten Lieferantendaten.

| Gruppe | Rechenmasse, kg | Eingesetzte Dichte, kg/m³ |
| --- | --- | --- |
| Aluminiumgruppen | 37,05 | 2700 |
| CFK-Rohre und Fluegelhuellen | 13,12 | 1600 |
| Rueckschluss, als Stahl gerechnet | 21,15 | 7850 |
| Pitchwellen, als Stahl gerechnet | 4,04 | 7850 |

Die Instanzliste wurde separat gegen die native FreeCAD-Hauptdatei geprüft: 712 Instanzen stimmten hinsichtlich ID und gespeichertem CAD-Volumen innerhalb der Rundungstoleranz von 0,002 mm³ überein. Das verifiziert die Volumenübernahme, nicht die Materialdichten oder die Festigkeit.

Die Überlagerung von C-Rückwand und Flanschen wurde mit **1,470 Litern** aus der Aluminiumsumme abgezogen. Die hierfür verwendete Überlappung beträgt zwei 8-mm-Zonen an einer 60-mm-Rückwand. Andere noch nicht fertig ausgearbeitete Materialübergänge und Anschlusskontakte sind damit nicht automatisch bereinigt.

Die Summe liegt im gewählten Dichteszenario bei 75,36 kg; bei den variierten Dichten bei etwa 72,73 bis 78,72 kg. Die Szenariospanne erfasst nur die angesetzten Dichten, nicht sämtliche Konstruktions- und Volumenunsicherheiten.

**Nicht geschlossen enthalten:** tatsächliche Akkus, Motor-/Magnetlagerinnenteile, Wicklungsfüllung und Isolation, Lager/Regler, Sandwich-Deck, Elastomere, real ausgewählte Befestigungen, Kühlung, Schutz- und thermische Systeme. Deshalb darf die Summe nicht als verifiziertes Leergewicht oder als alleinige untere Massenbegrenzung verwendet werden. Ein später anderes Material-/Schienenkonzept verändert sie.

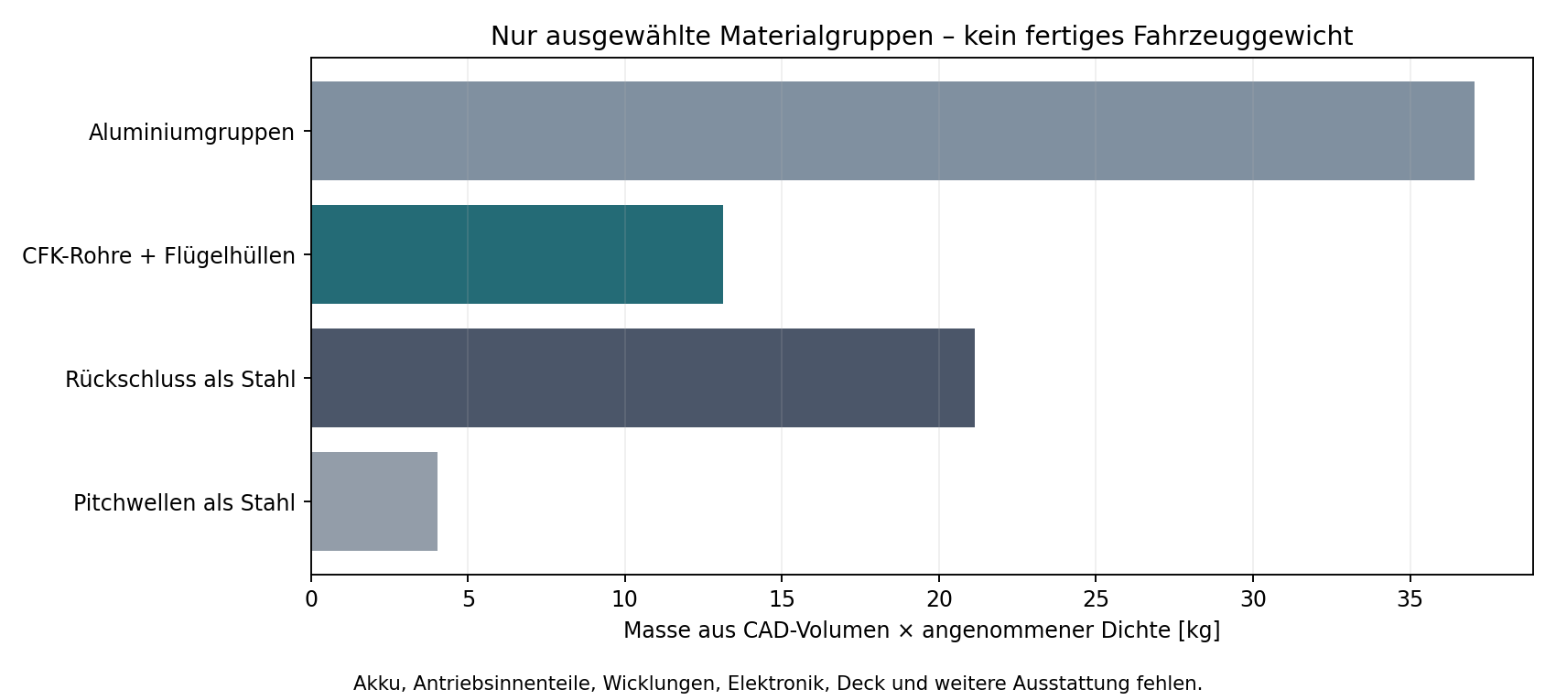
[picture p38: tragfaehigkeit/CAD_Massenszenario.png]
Ausgewählte CAD-Materialgruppen mit angenommenen Dichten.


Die frühere pauschale 45-kg-Nicht-Akku-Annahme wird für diesen Detailentwurf nicht übernommen. Für das folgende gekoppelte Referenzszenario ergeben Person 100 kg, Ausrüstung 10 kg und die ausgewählte Teilmasse zusammen **185,36 kg ohne Akku**, wobei fehlende weitere Systemmassen zunächst mit null angesetzt werden. Das ist eine bewusst unvollständige, günstige Szenariobasis, kein geschlossenes Fahrzeug.
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
