ITSMEEME/PropBoard/entwicklung_ab/HEXA_R265_B4_Draufsicht.png

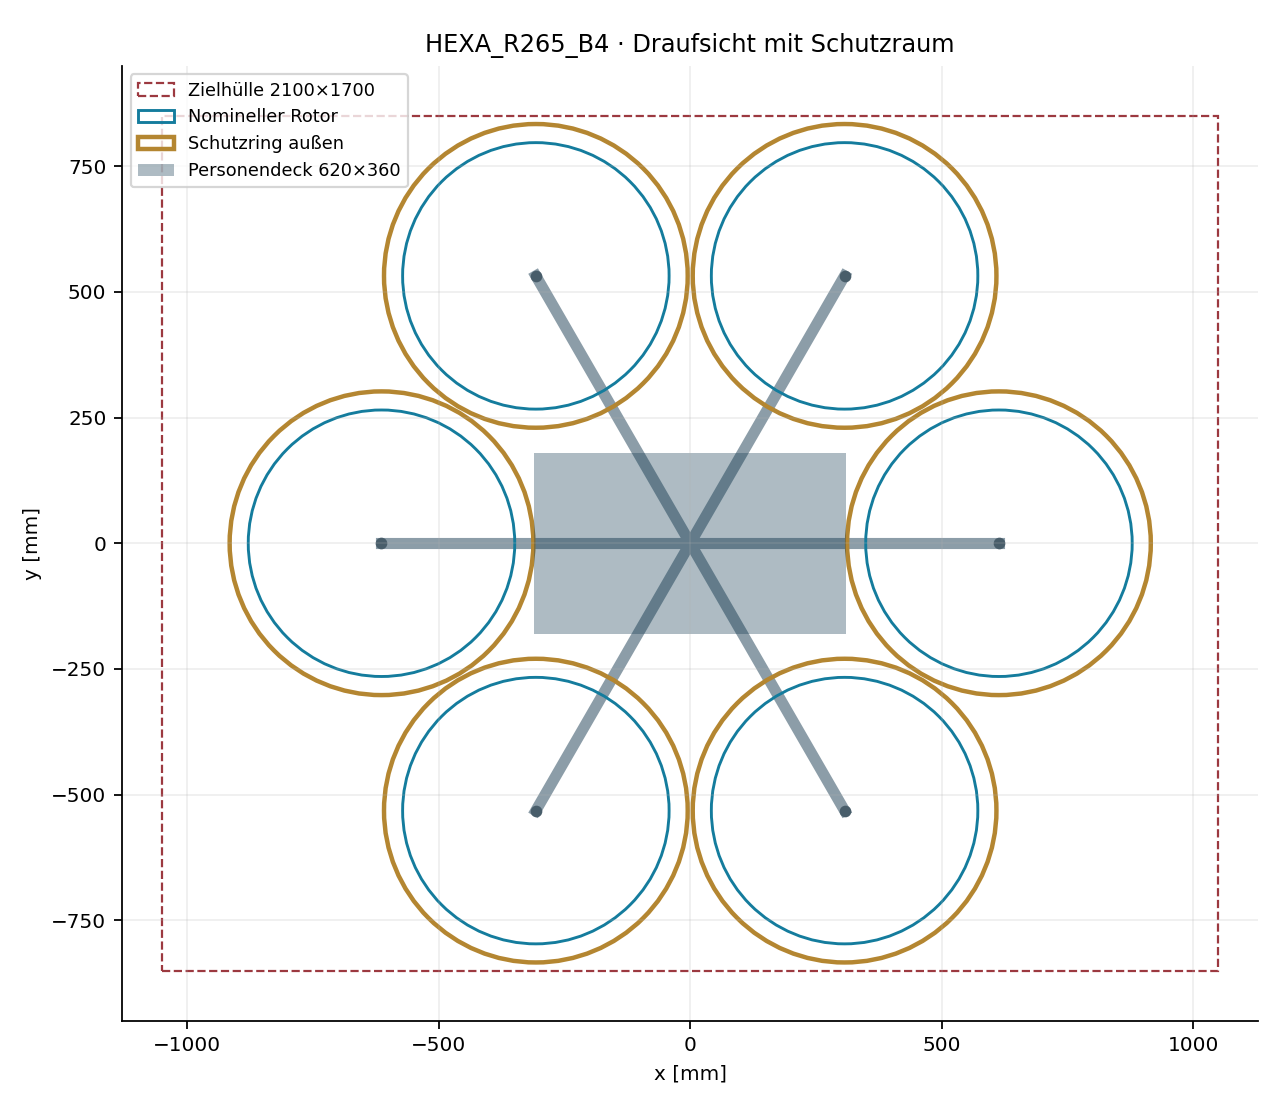
entwicklung_ab/HEXA_R265_B4_Draufsicht.png
