ITSMEEME/PropBoard/entwicklung_ab/P14_R750_Draufsicht.png

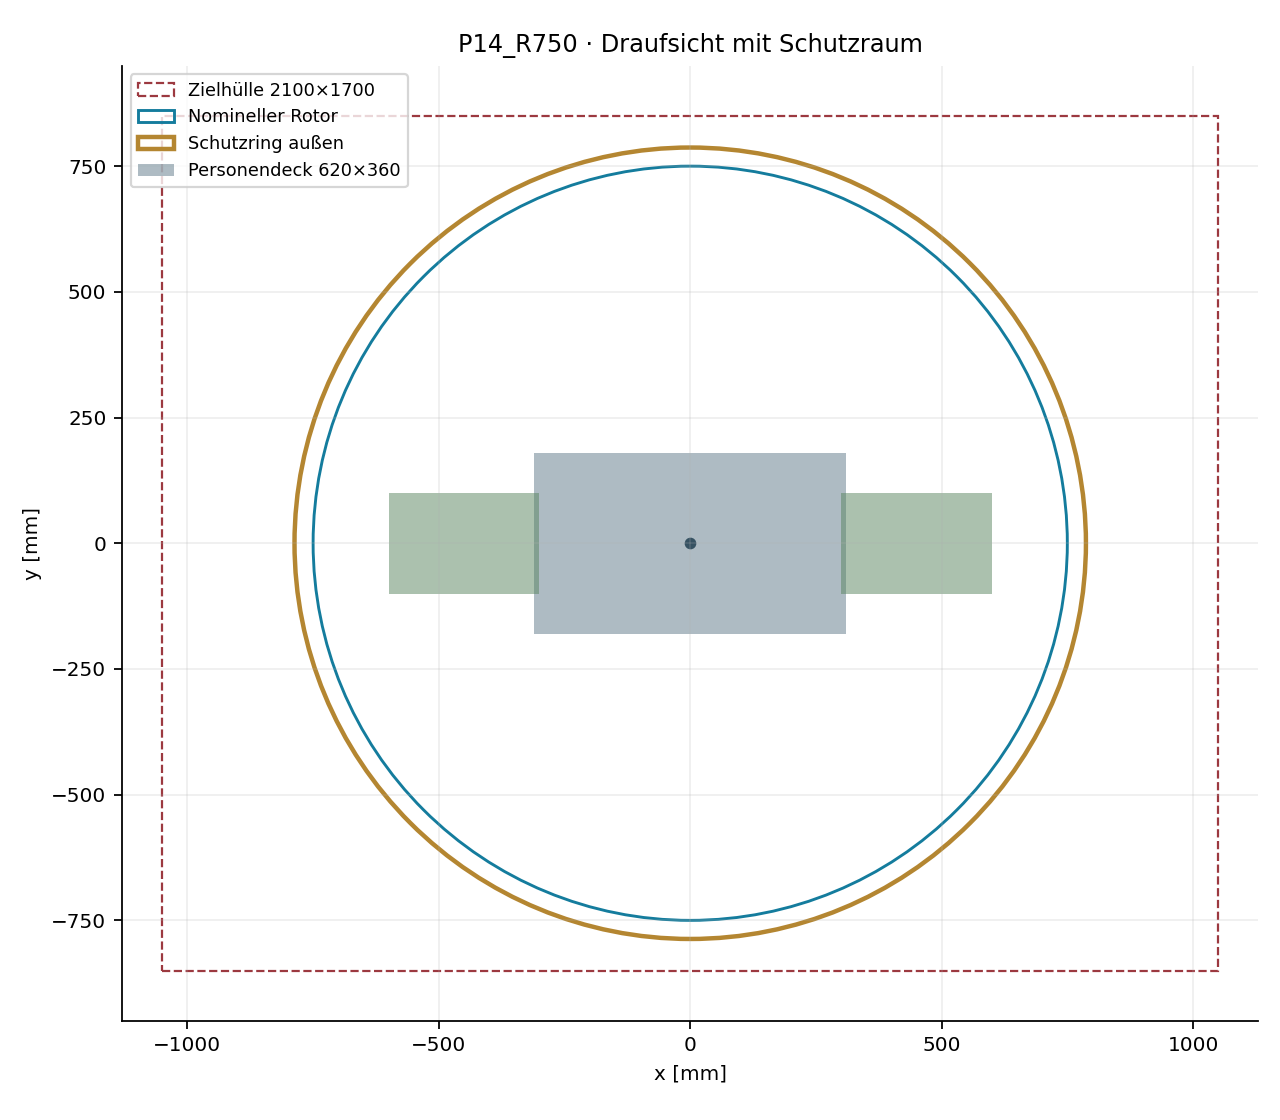
entwicklung_ab/P14_R750_Draufsicht.png
