ITSMEEME/PropBoard/entwicklung_ab/P14_R800_Draufsicht.png

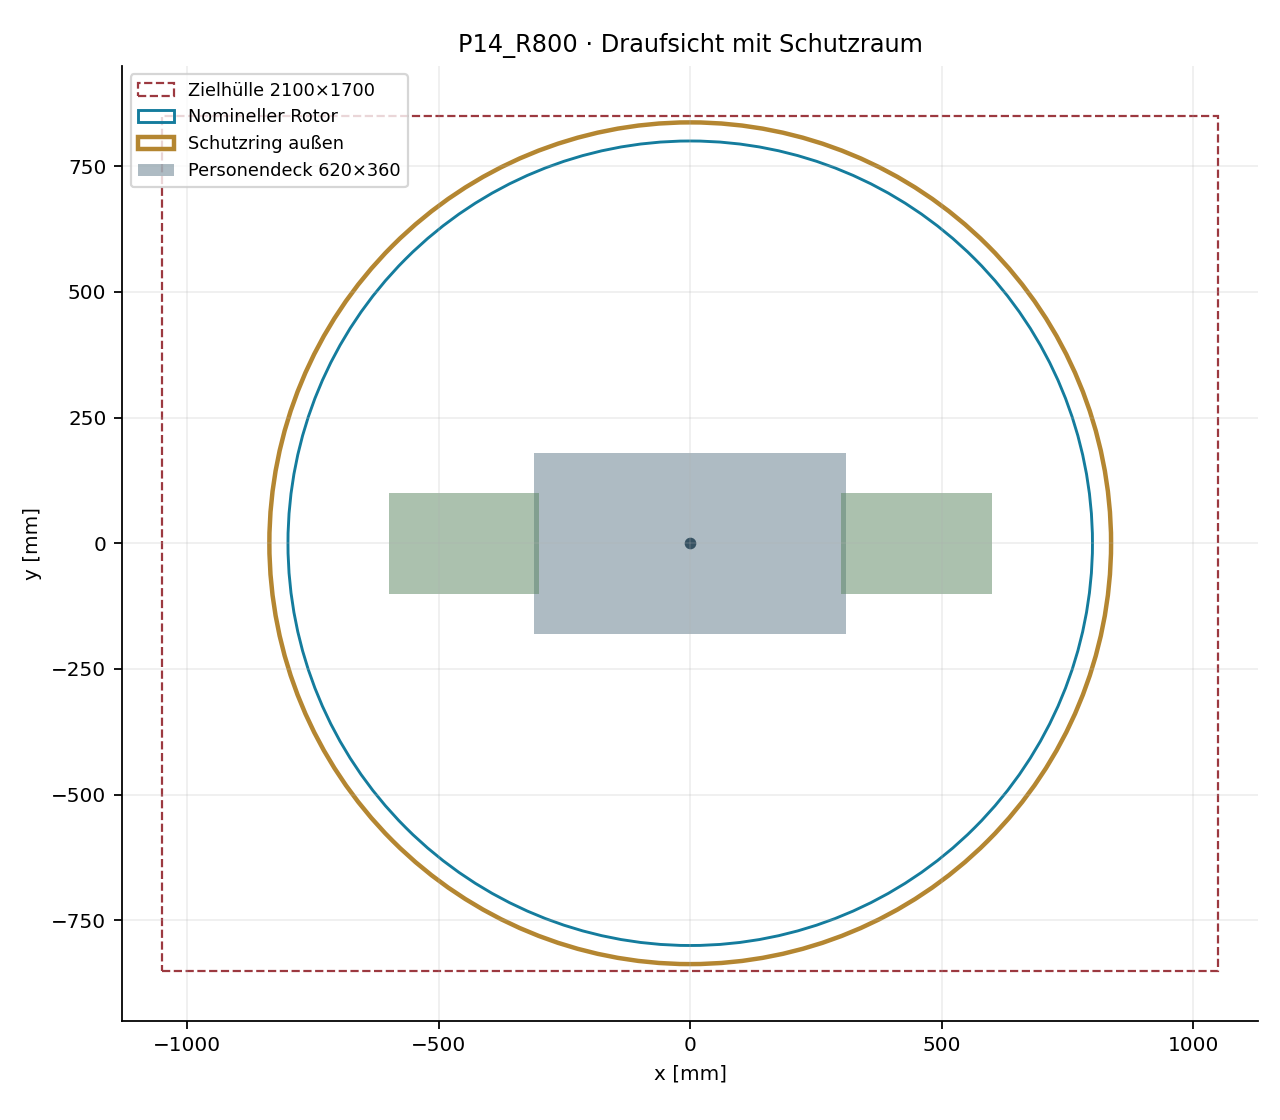
entwicklung_ab/P14_R800_Draufsicht.png
