ITSMEEME/PropBoard/entwicklung_ab/QUAD_R380_CAD.png

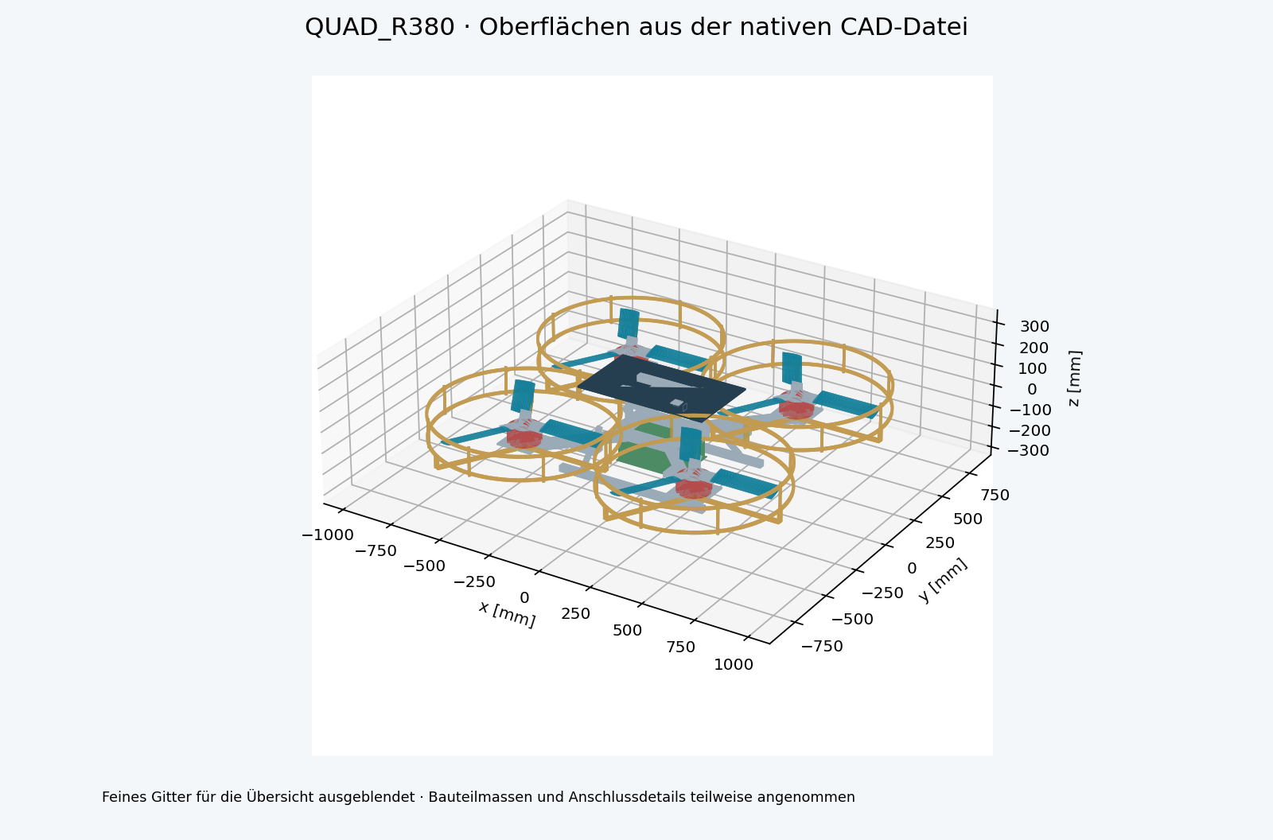
entwicklung_ab/QUAD_R380_CAD.png
