ITSMEEME/PropBoard/entwicklung_ab/Viewer_Vorschau.png

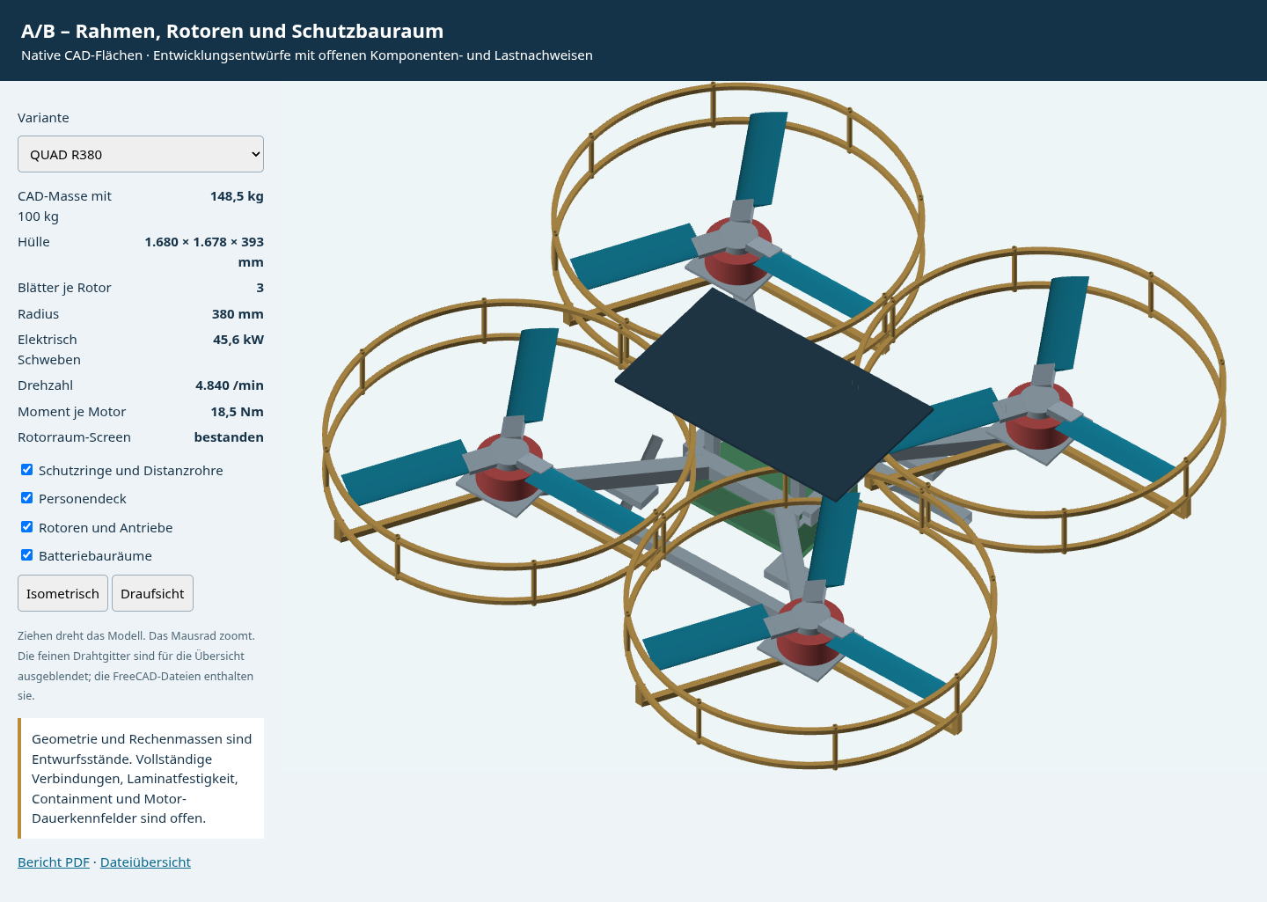
entwicklung_ab/Viewer_Vorschau.png
