ITSMEEME/PropBoard/flugsimulator/Ergebnisse/Simulator_Akku_SemiSolid.png

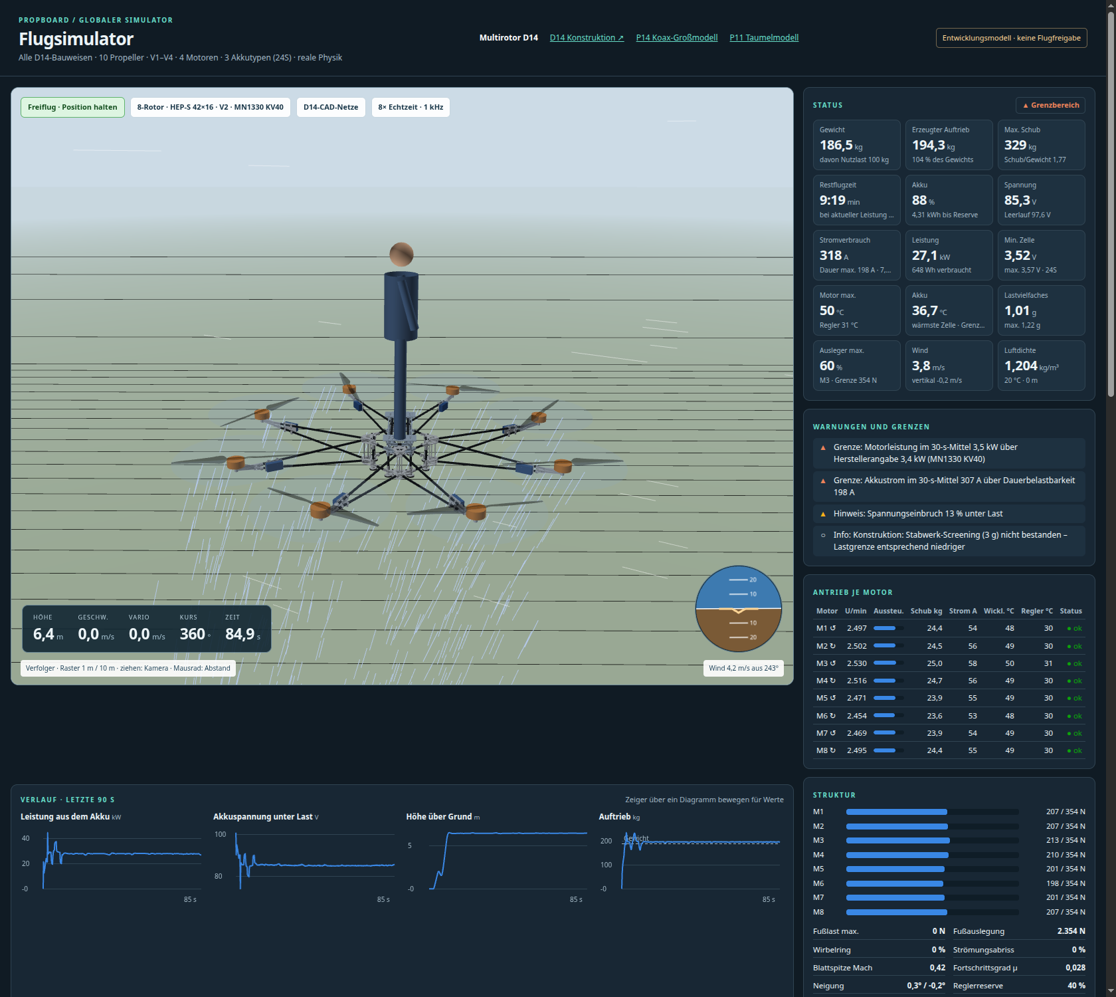
flugsimulator/Ergebnisse/Simulator_Akku_SemiSolid.png
