ITSMEEME/PropBoard/flugsimulator/Ergebnisse/Simulator_Hexa42_Motorausfall.png

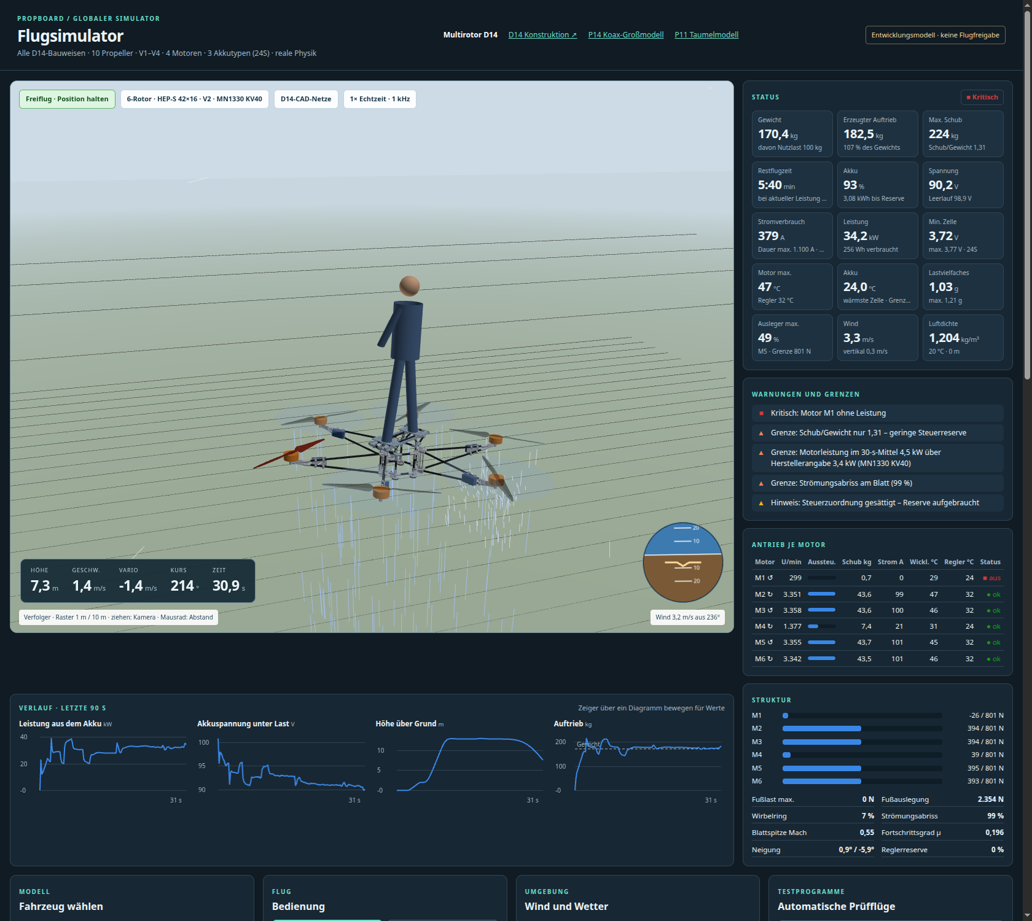
flugsimulator/Ergebnisse/Simulator_Hexa42_Motorausfall.png
