ITSMEEME/PropBoard/flugsimulator/Ergebnisse/Simulator_Koax42_Wirbelring.png

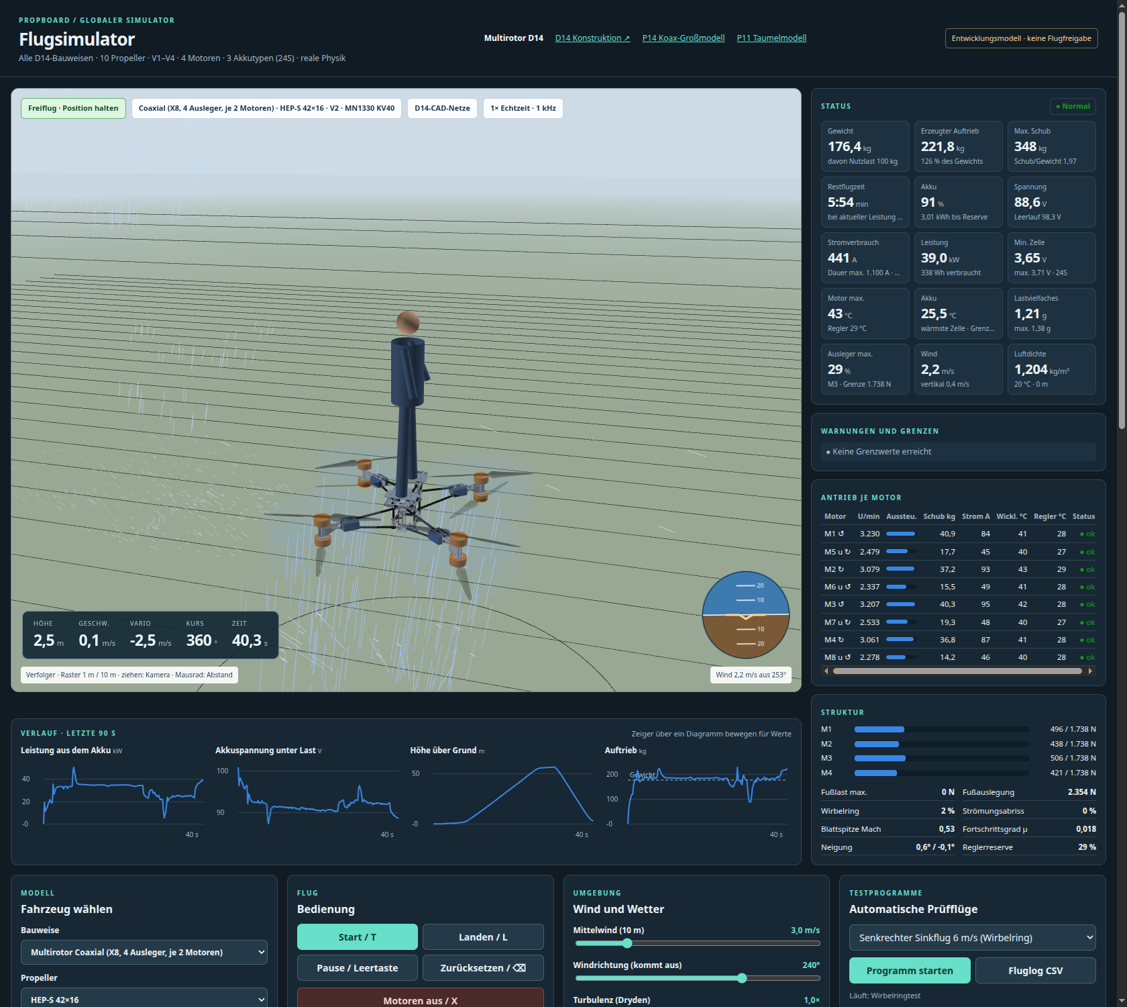
flugsimulator/Ergebnisse/Simulator_Koax42_Wirbelring.png
