ITSMEEME/PropBoard/flugsimulator/Ergebnisse/Simulator_mobil.png

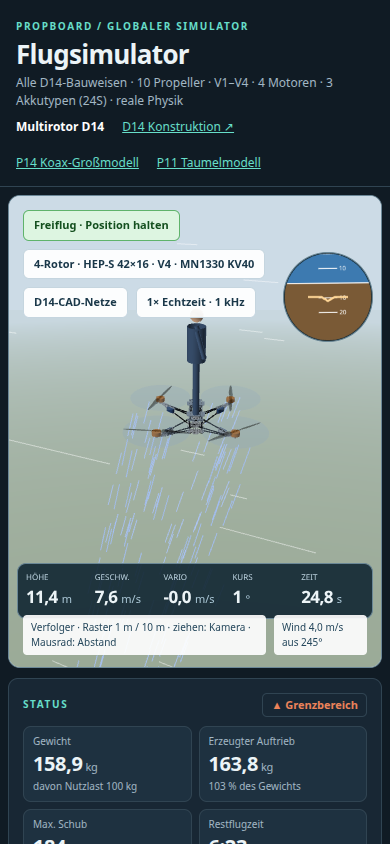
flugsimulator/Ergebnisse/Simulator_mobil.png
