ITSMEEME/PropBoard/flugsimulator/Ergebnisse/Simulator_Okto30_U15II.png

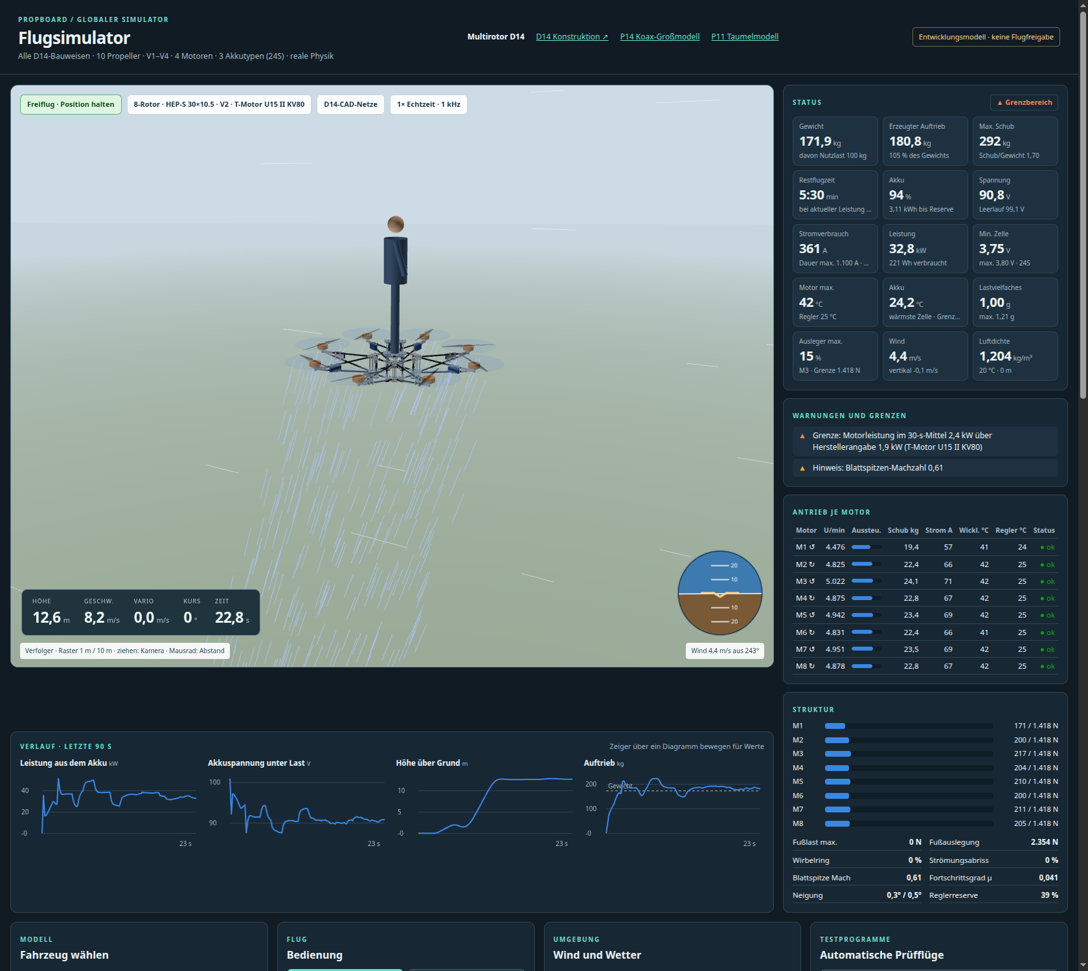
flugsimulator/Ergebnisse/Simulator_Okto30_U15II.png
