ITSMEEME/PropBoard/flugsimulator/Ergebnisse/Simulator_Okto42_Dashboard.png

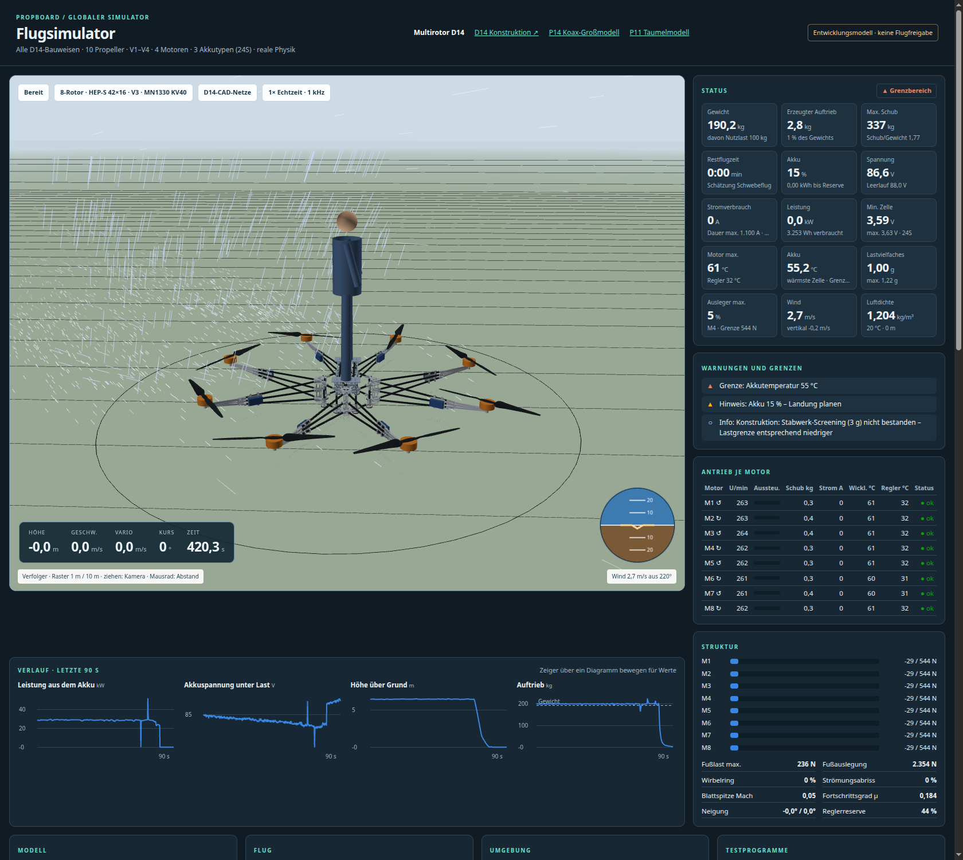
flugsimulator/Ergebnisse/Simulator_Okto42_Dashboard.png
