ITSMEEME/PropBoard/flugsimulator/Ergebnisse/Simulator_Quad42_V4.png

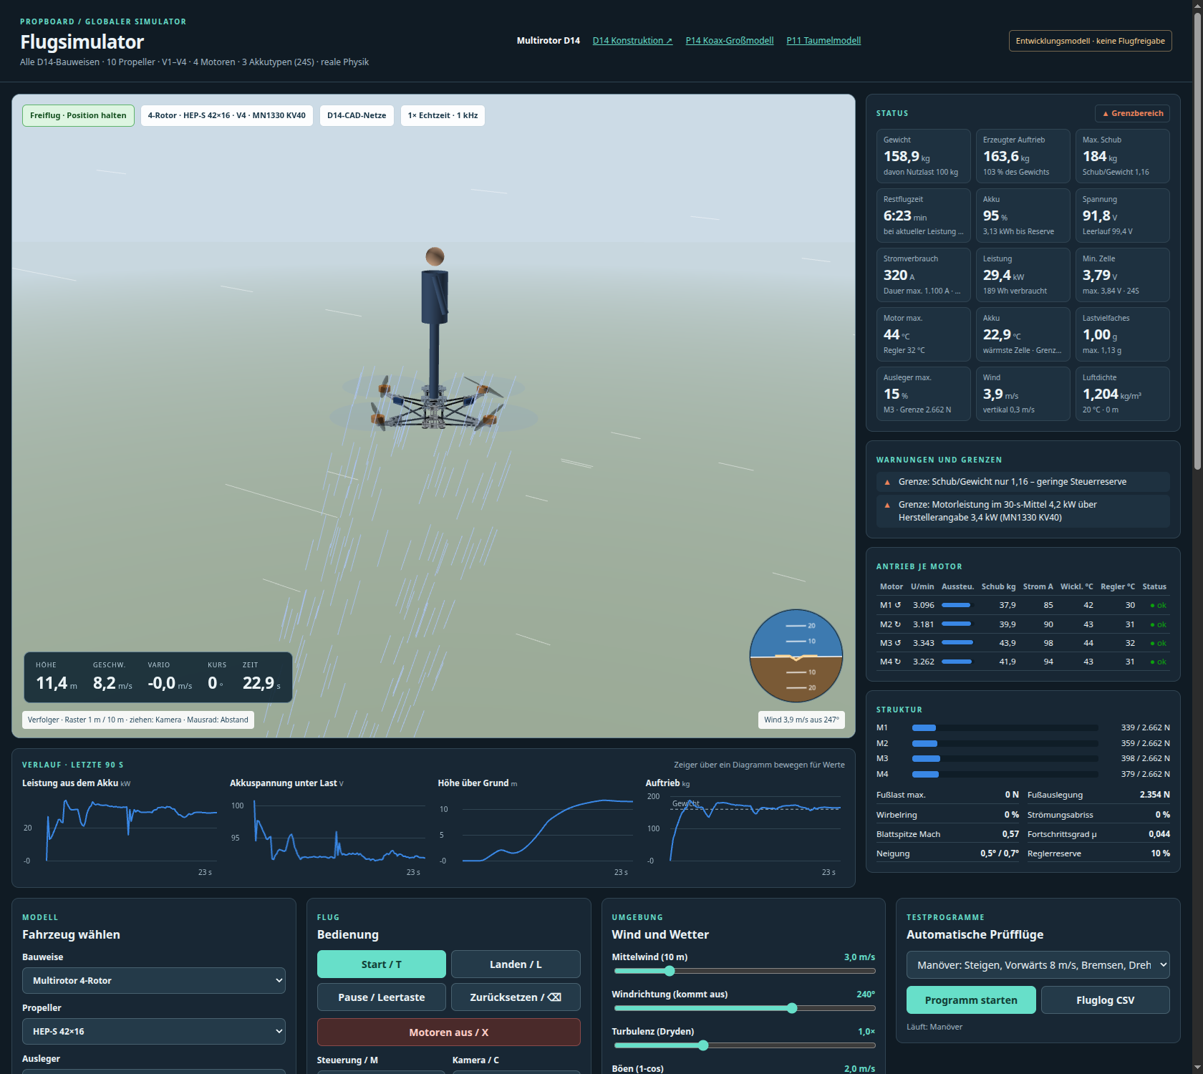
flugsimulator/Ergebnisse/Simulator_Quad42_V4.png
