ITSMEEME/PropBoard/horizontal_z_r02/Ansicht_01.png

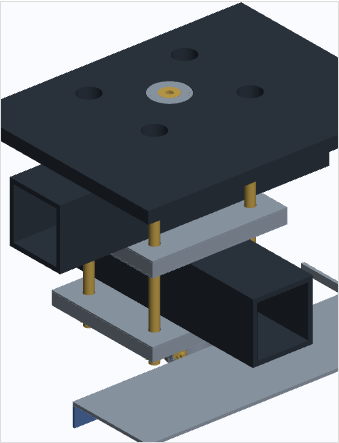
horizontal_z_r02/Ansicht_01.png
