ITSMEEME/PropBoard/horizontal_z_r02/Ansicht_04.png

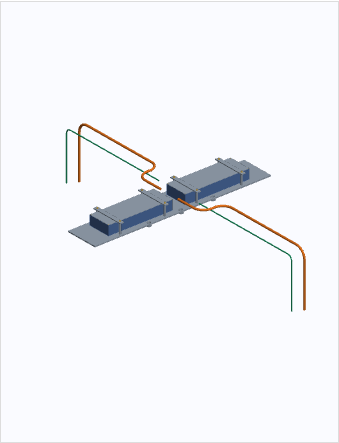
horizontal_z_r02/Ansicht_04.png
