ITSMEEME/PropBoard/konstruktion/Ansicht_00_ohne_Pilot.png

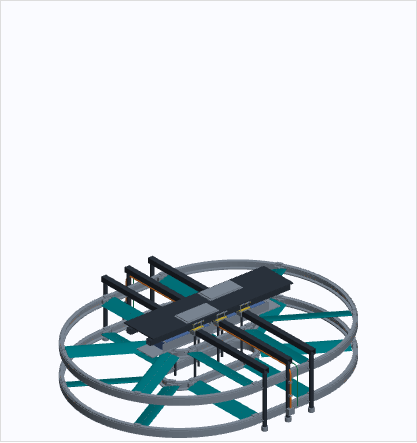
konstruktion/Ansicht_00_ohne_Pilot.png
