ITSMEEME/PropBoard/konstruktion/Ansicht_06.png

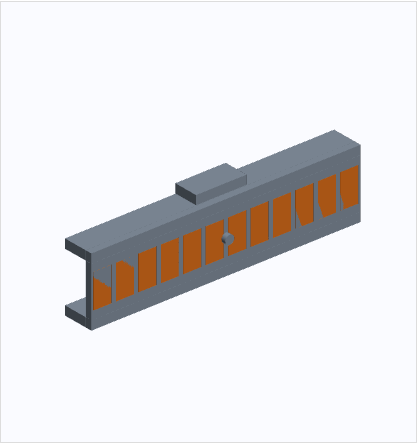
konstruktion/Ansicht_06.png
