ITSMEEME/PropBoard/kreis_r04/mn1330_p12/Ausgabe/Zwischenstand_P12_Perspektive.png

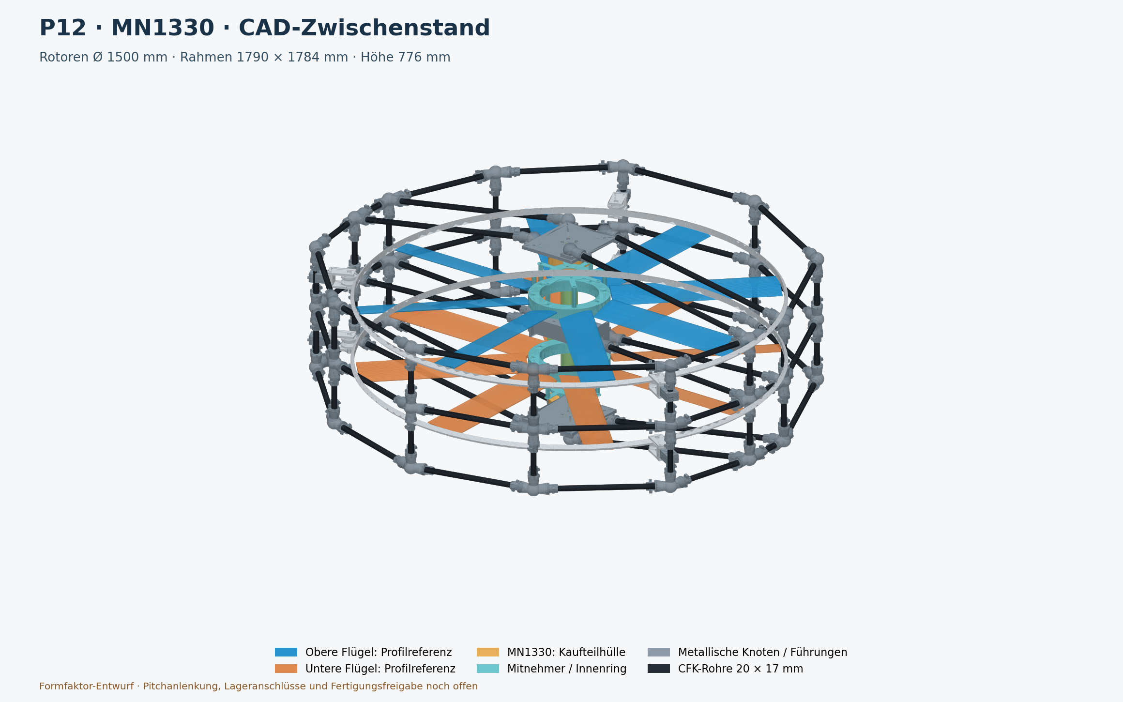
kreis_r04/mn1330_p12/Ausgabe/Zwischenstand_P12_Perspektive.png
