ITSMEEME/PropBoard/kreis_r04/mn1330_p13/Ausgabe/P13_Gesamtansicht.png

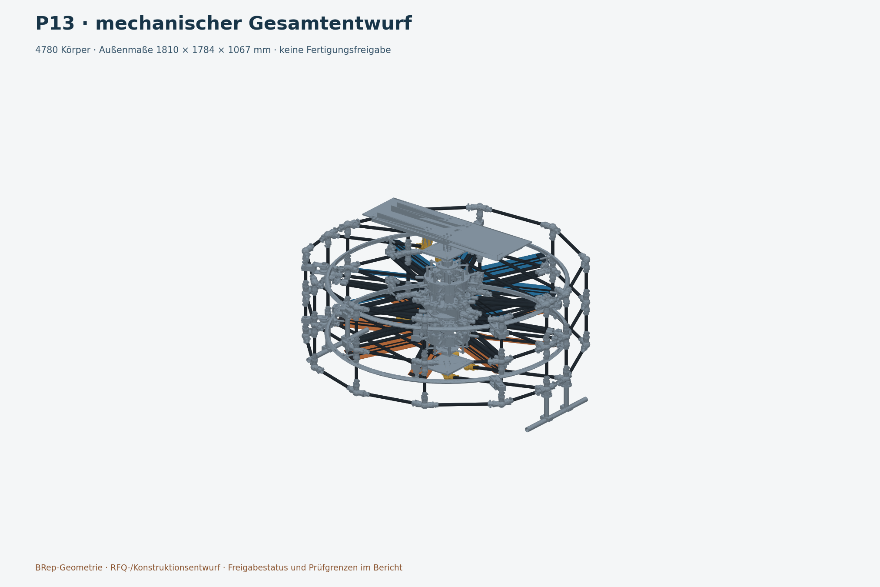
kreis_r04/mn1330_p13/Ausgabe/P13_Gesamtansicht.png
