ITSMEEME/PropBoard/kreis_r04/mn1330_p14/Ansichten/MN1330_Pruefdaten_und_P14.png

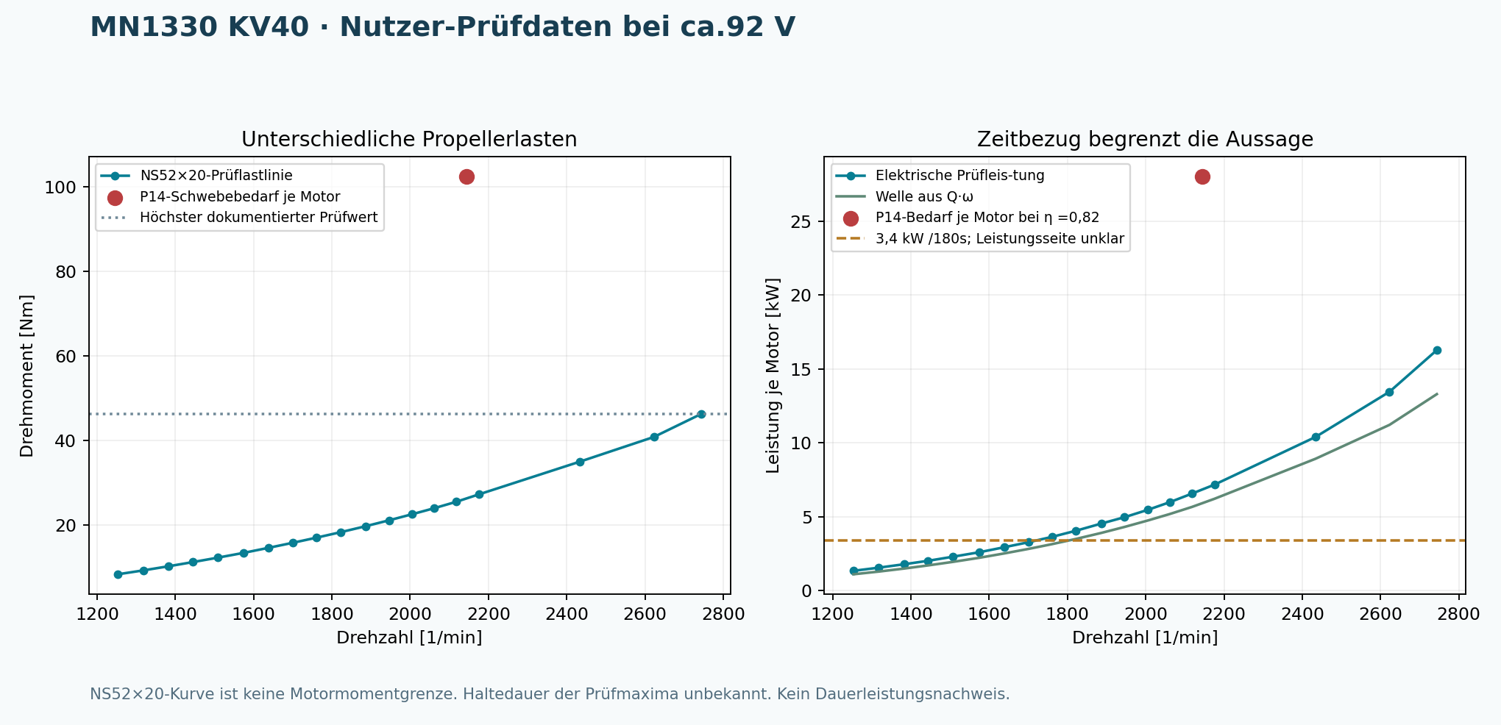
kreis_r04/mn1330_p14/Ansichten/MN1330_Pruefdaten_und_P14.png
