ITSMEEME/PropBoard/kreis_r04/mn1330_p14/Ansichten/P14_Flugsimulator_Mobil.png

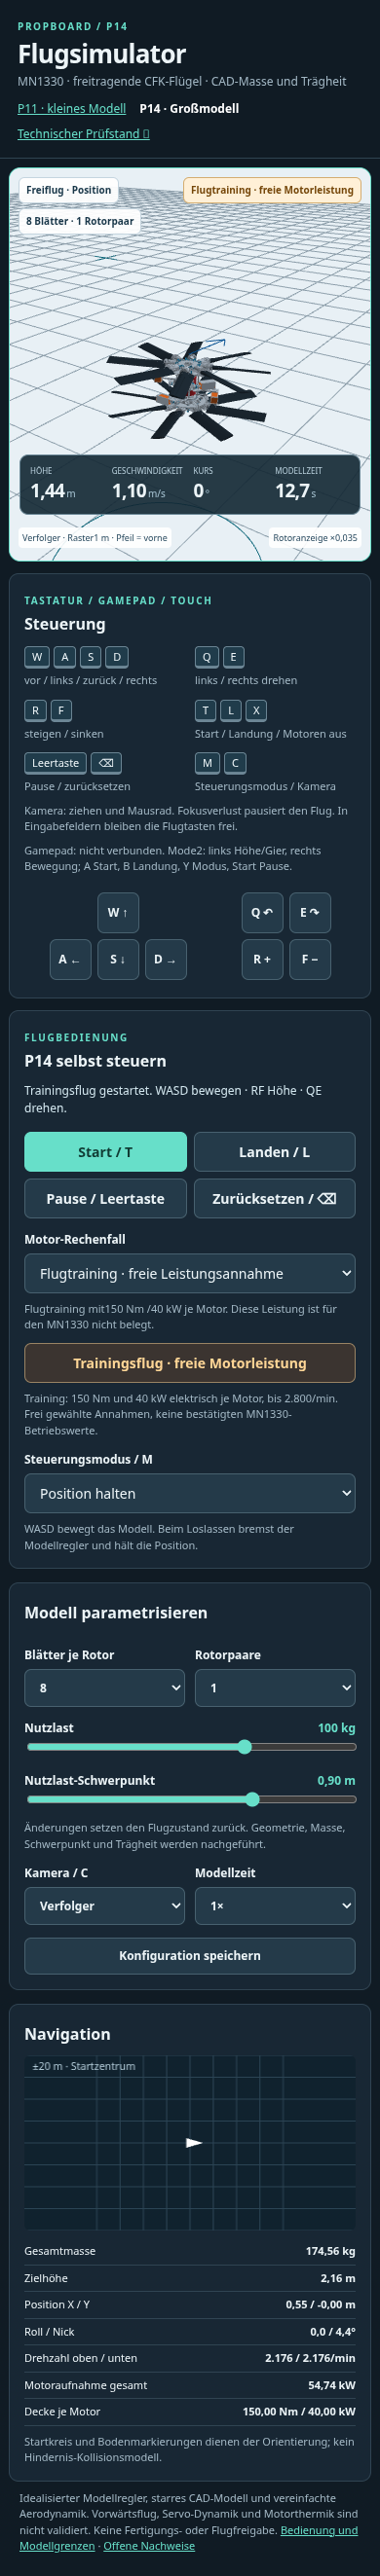
kreis_r04/mn1330_p14/Ansichten/P14_Flugsimulator_Mobil.png
