ITSMEEME/PropBoard/kreis_r04/mn1330_p14/Ansichten/P14_Gelenk_Explodiert.png

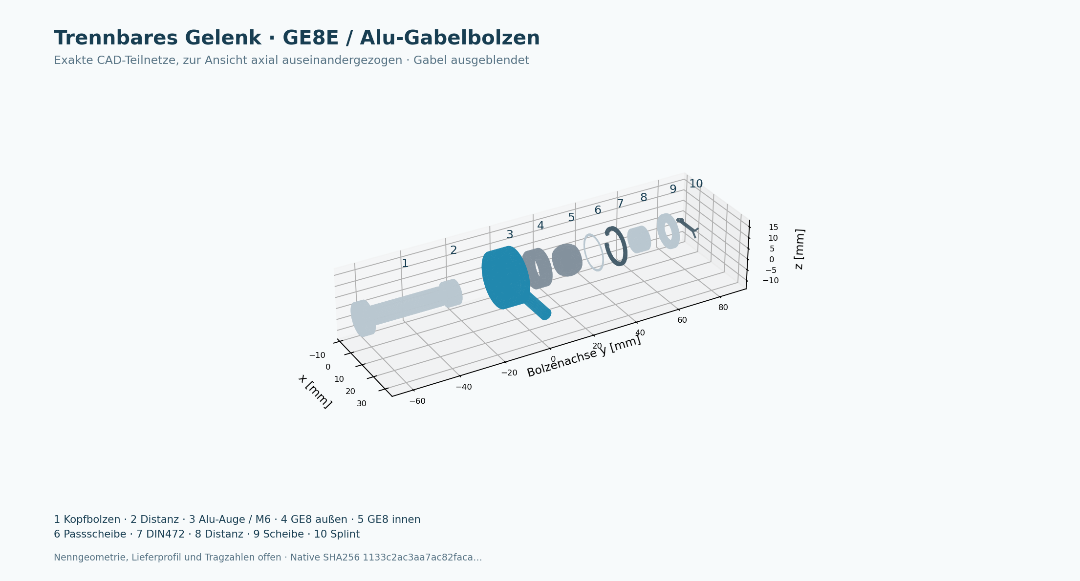
kreis_r04/mn1330_p14/Ansichten/P14_Gelenk_Explodiert.png
