ITSMEEME/PropBoard/kreis_r04/mn1330_p14/Ansichten/P14_Servo.png

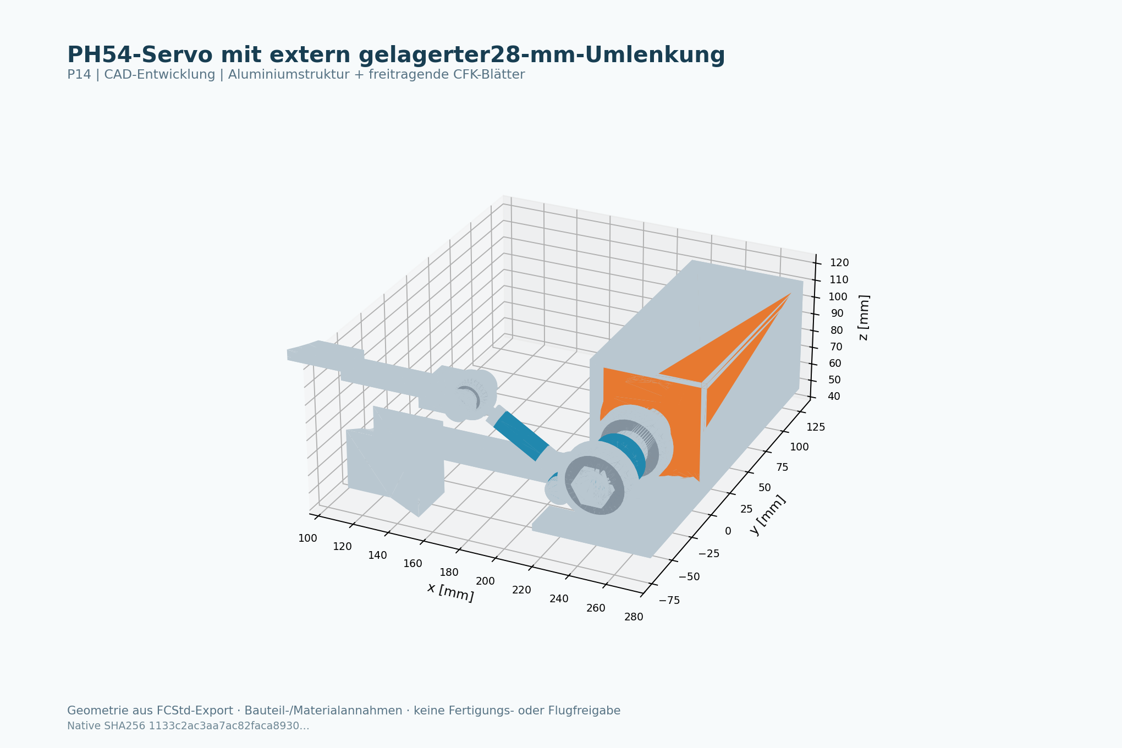
kreis_r04/mn1330_p14/Ansichten/P14_Servo.png
