ITSMEEME/PropBoard/kreis_r04/mn1330_p14/Ansichten/P14_Zentrum_Interaktiv.png

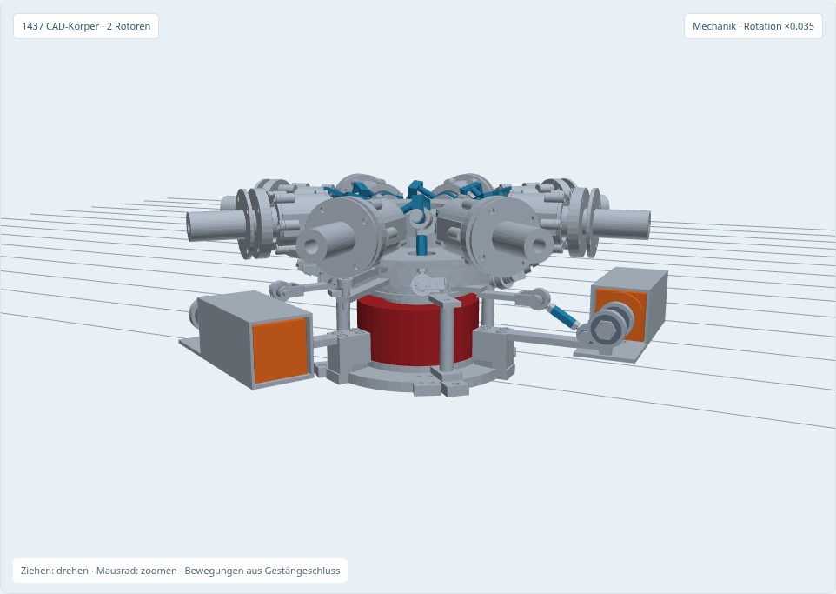
kreis_r04/mn1330_p14/Ansichten/P14_Zentrum_Interaktiv.png
