ITSMEEME/PropBoard/modell_r04/cad/Vorschau_Nabe.png

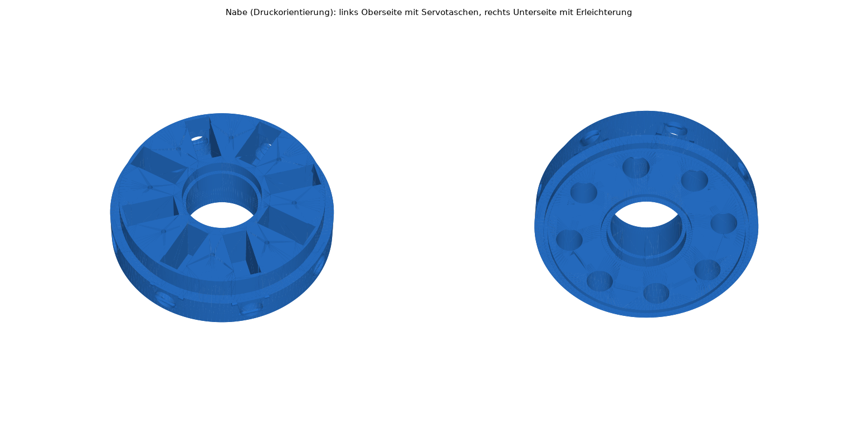
modell_r04/cad/Vorschau_Nabe.png
