ITSMEEME/PropBoard/modell_r04_taumel/aerodynamik/Ausgabe/CAD_Polaren.png

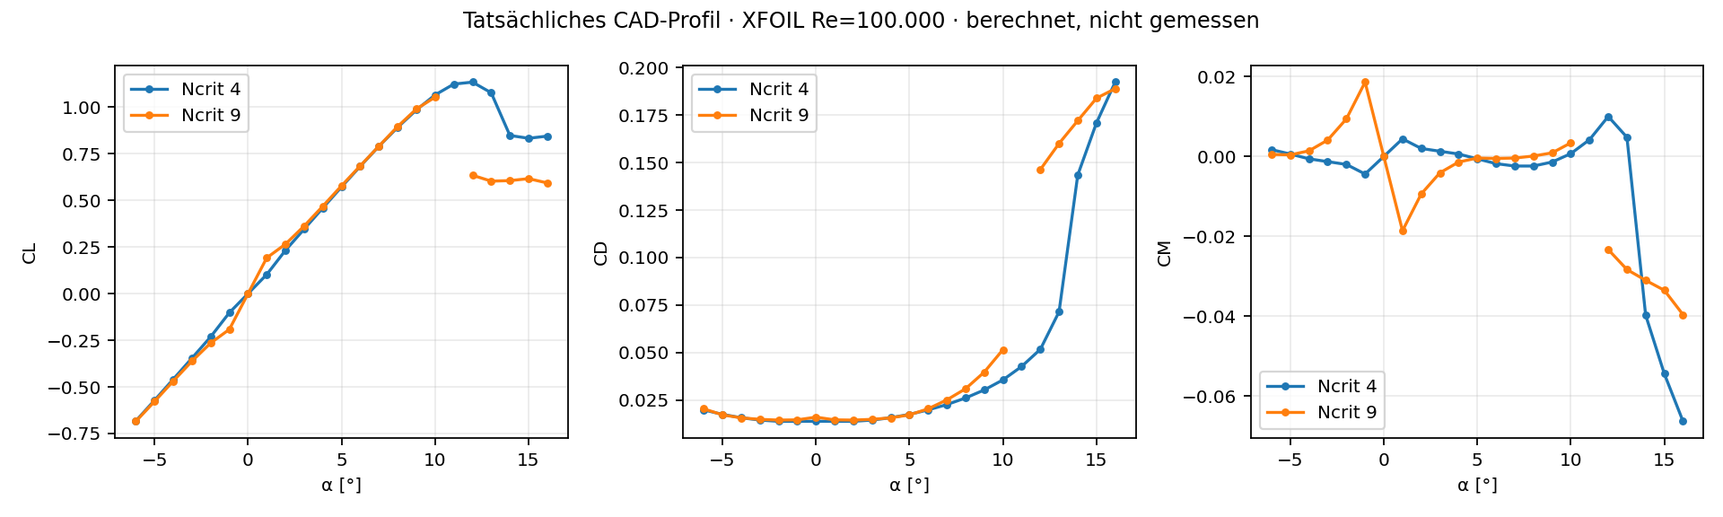
modell_r04_taumel/aerodynamik/Ausgabe/CAD_Polaren.png
