ITSMEEME/PropBoard/modell_r04_taumel/bewegung/Ausgabe/Vorschau_M01.png

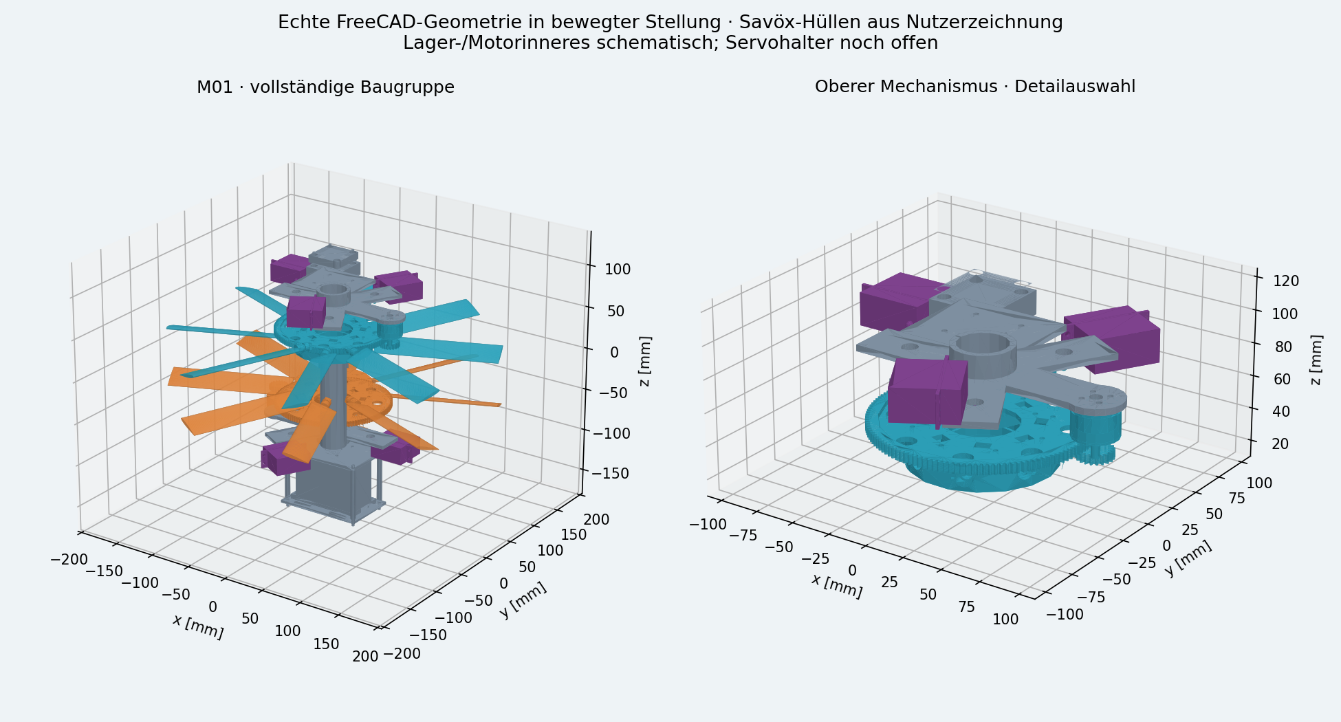
modell_r04_taumel/bewegung/Ausgabe/Vorschau_M01.png
