ITSMEEME/PropBoard/modell_r04_taumel/bewegung_p09/Ausgabe/Browser_P09.png

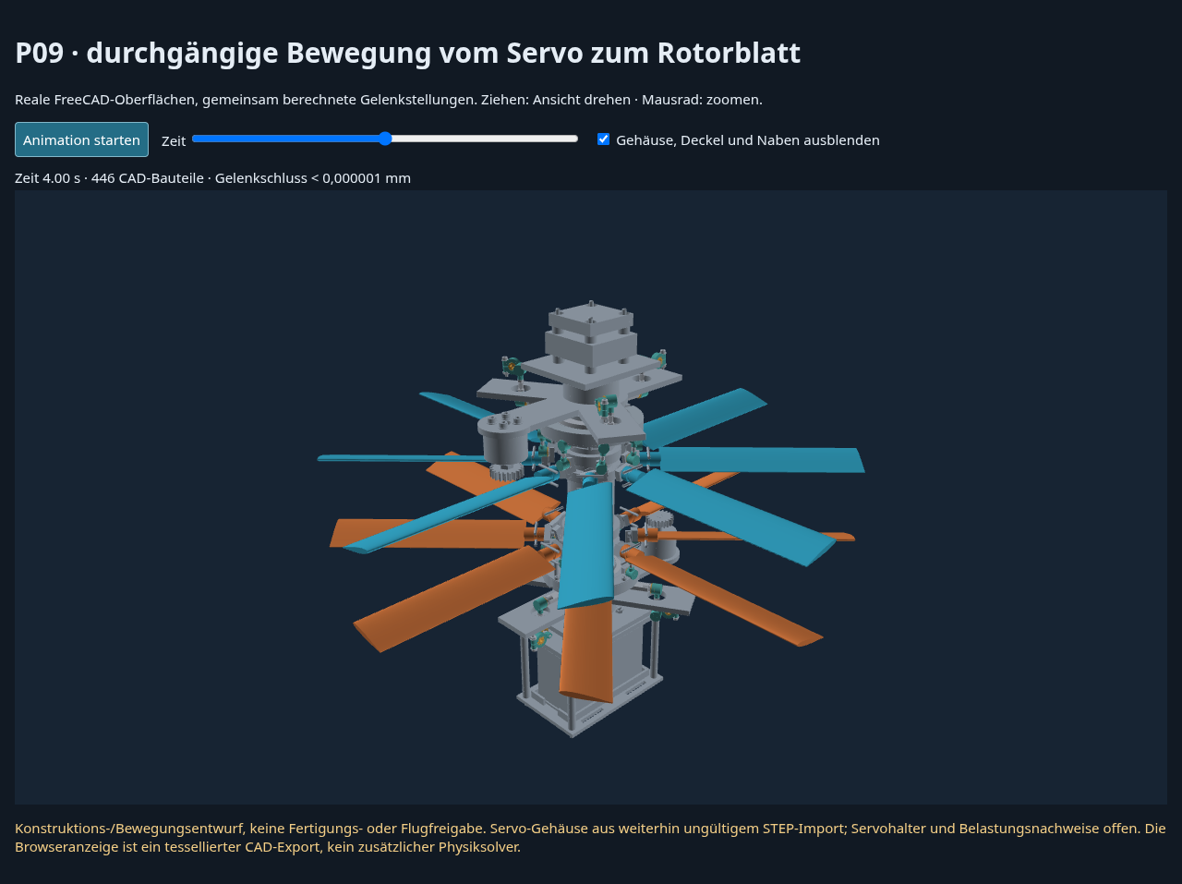
modell_r04_taumel/bewegung_p09/Ausgabe/Browser_P09.png
