ITSMEEME/PropBoard/modell_r04_taumel/cad/Vorschau_Baugruppe.png

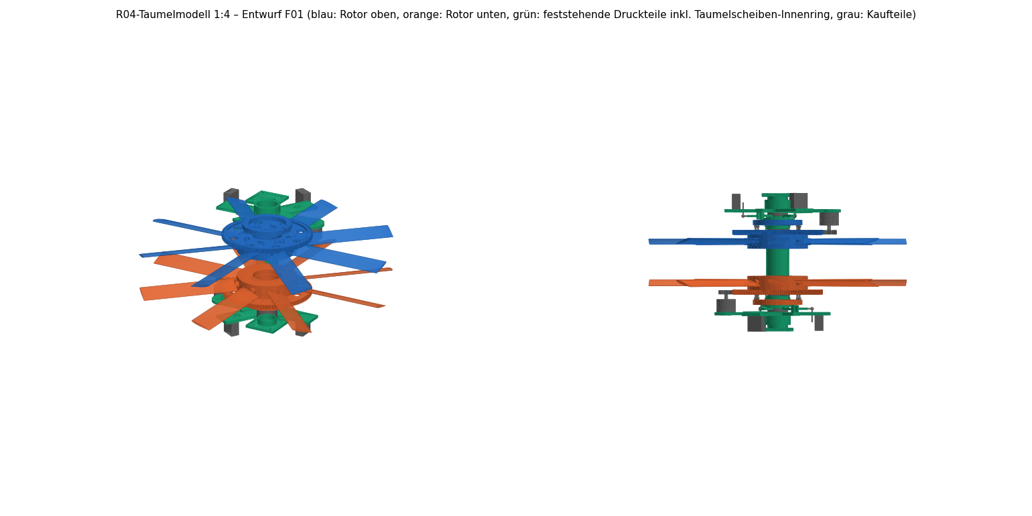
modell_r04_taumel/cad/Vorschau_Baugruppe.png
