ITSMEEME/PropBoard/modell_r04_taumel/cad/Vorschau_Nabe.png

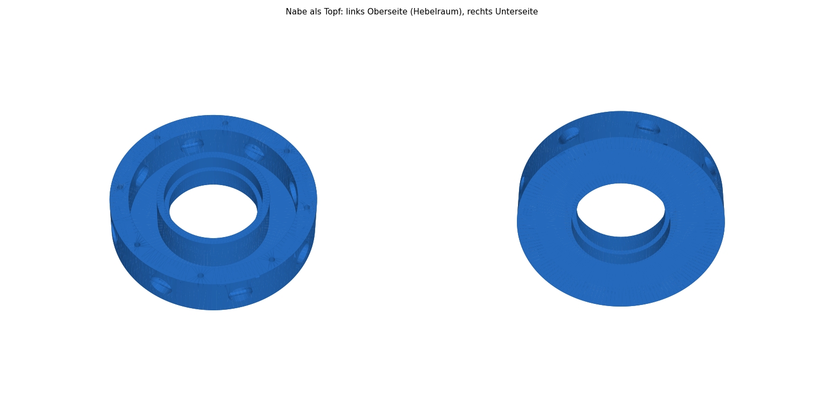
modell_r04_taumel/cad/Vorschau_Nabe.png
