ITSMEEME/PropBoard/modell_r04_taumel/cfd_top10/Ausgabe/K01_coarse_Konvergenz.png

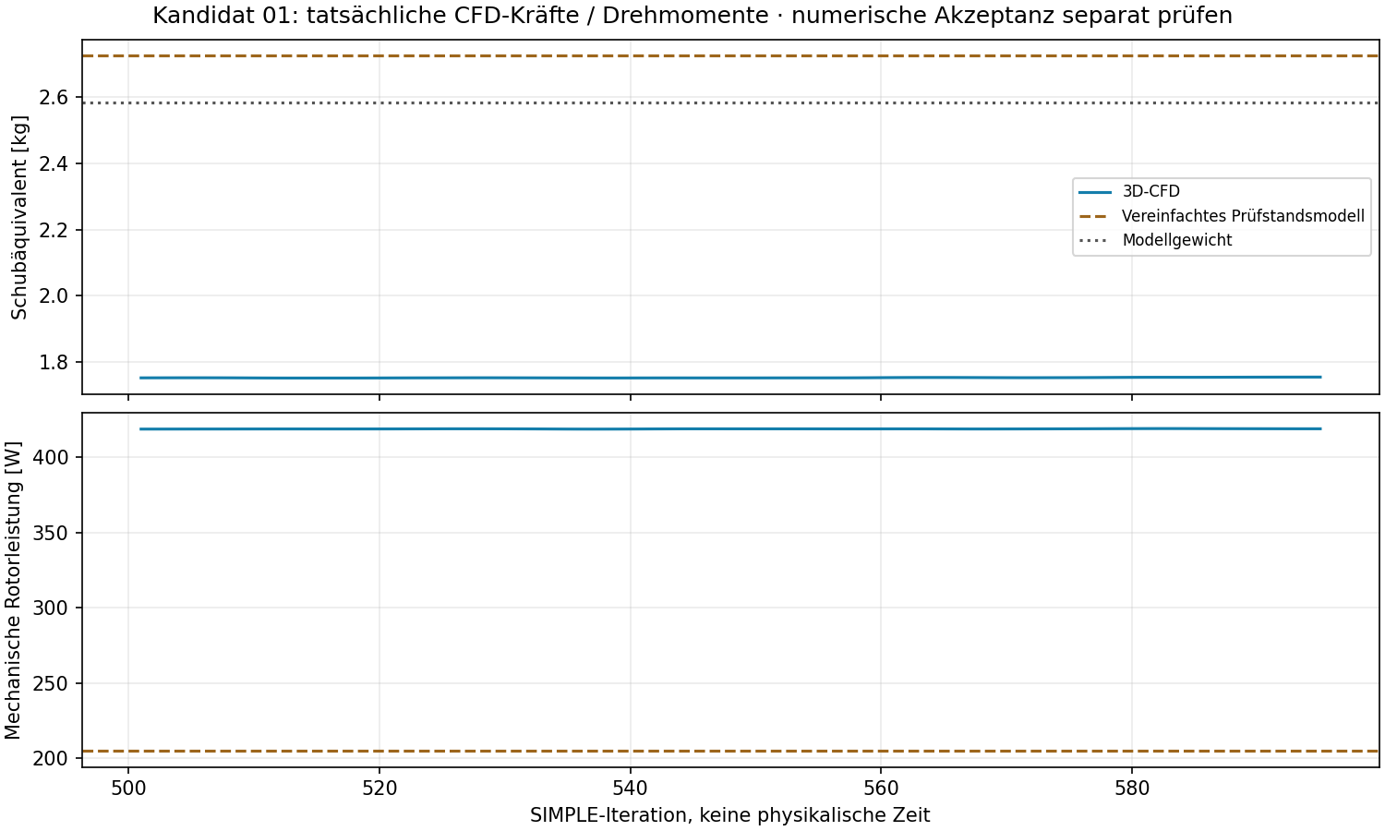
modell_r04_taumel/cfd_top10/Ausgabe/K01_coarse_Konvergenz.png
