ITSMEEME/PropBoard/modell_r04_taumel/cfd_top10/Ausgabe/K01_I500_coarse_Stroemung.png

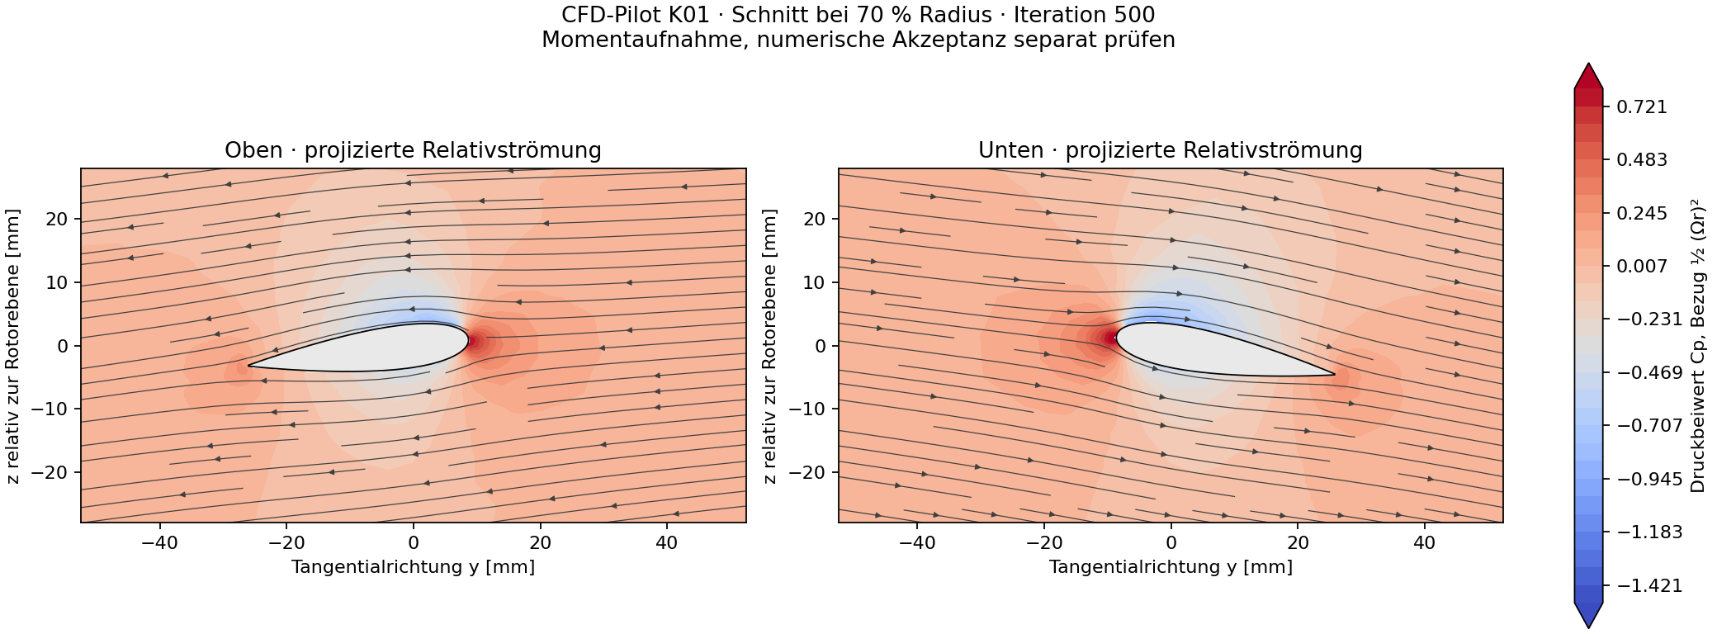
modell_r04_taumel/cfd_top10/Ausgabe/K01_I500_coarse_Stroemung.png
