ITSMEEME/PropBoard/modell_r04_taumel/cfd_top10/Ausgabe/Top10_Planformen.png

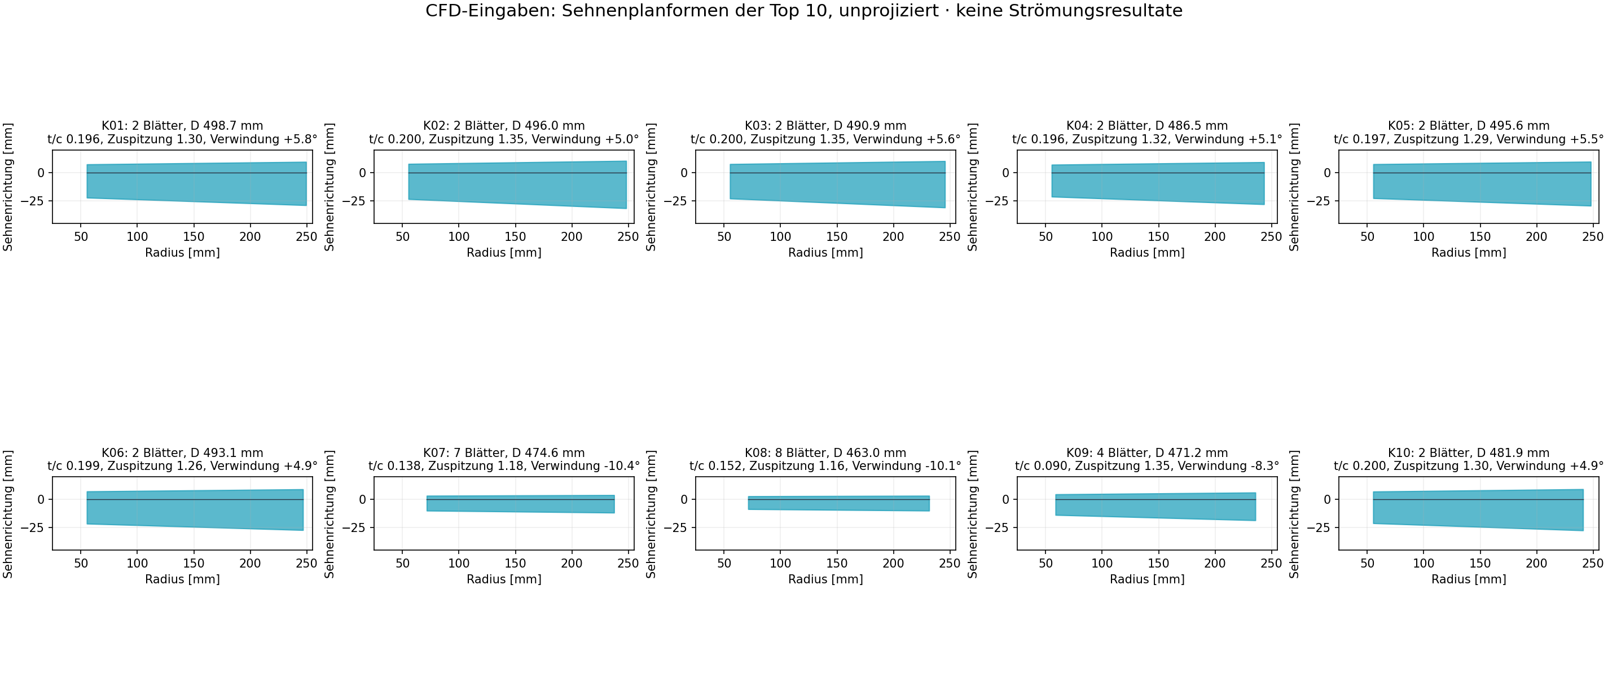
modell_r04_taumel/cfd_top10/Ausgabe/Top10_Planformen.png
