ITSMEEME/PropBoard/modell_r04_taumel/cfd_top10/Ausgabe/Top10_Profile.png

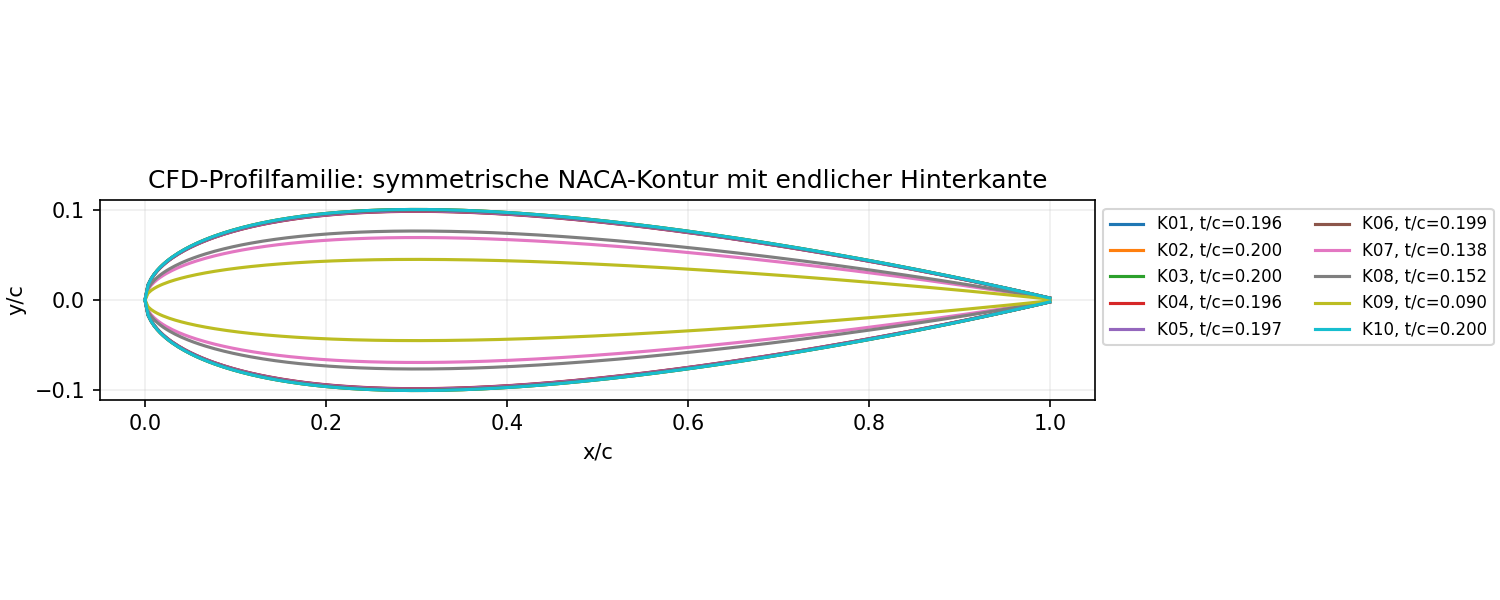
modell_r04_taumel/cfd_top10/Ausgabe/Top10_Profile.png
