ITSMEEME/PropBoard/modell_r04_taumel/fertigung_p08/Ausgabe/Anschluss_Vorschau.png

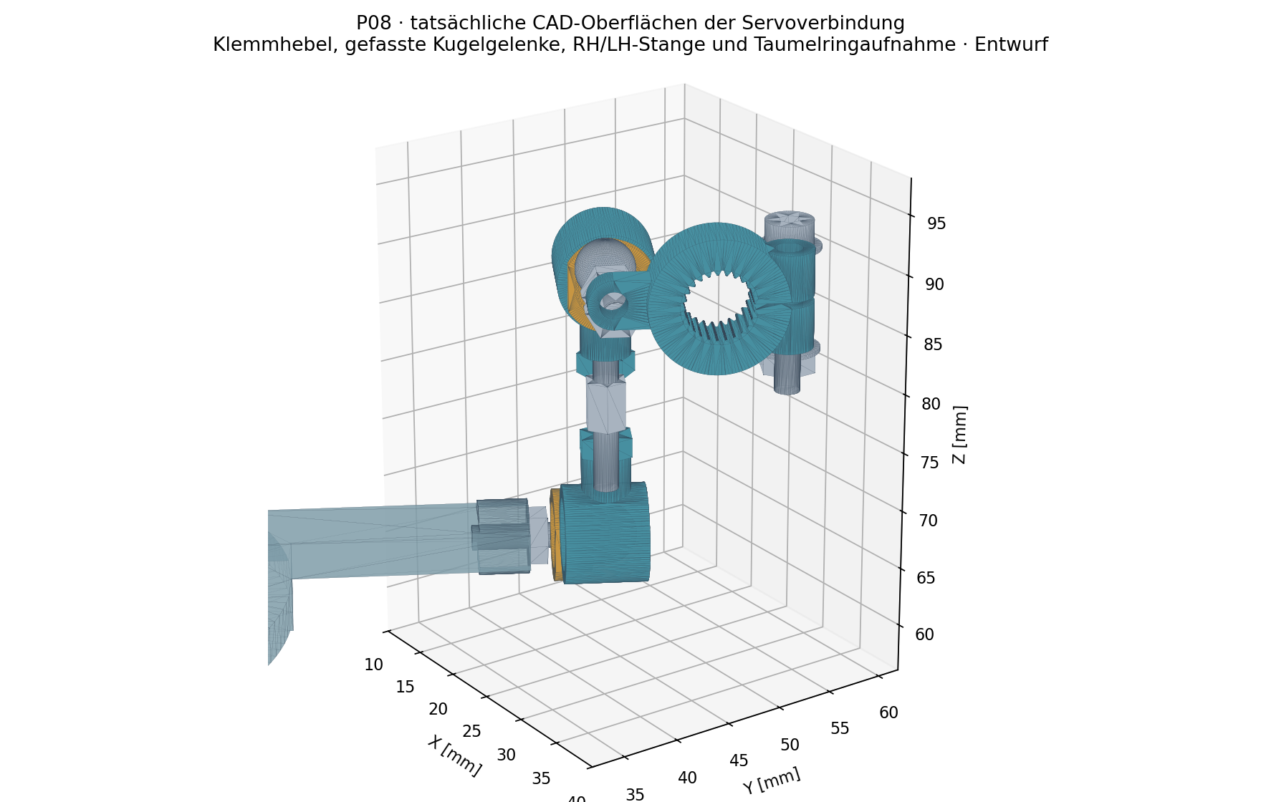
modell_r04_taumel/fertigung_p08/Ausgabe/Anschluss_Vorschau.png
