ITSMEEME/PropBoard/modell_r04_taumel/halterungen/Ausgabe/Vorschau_H01.png

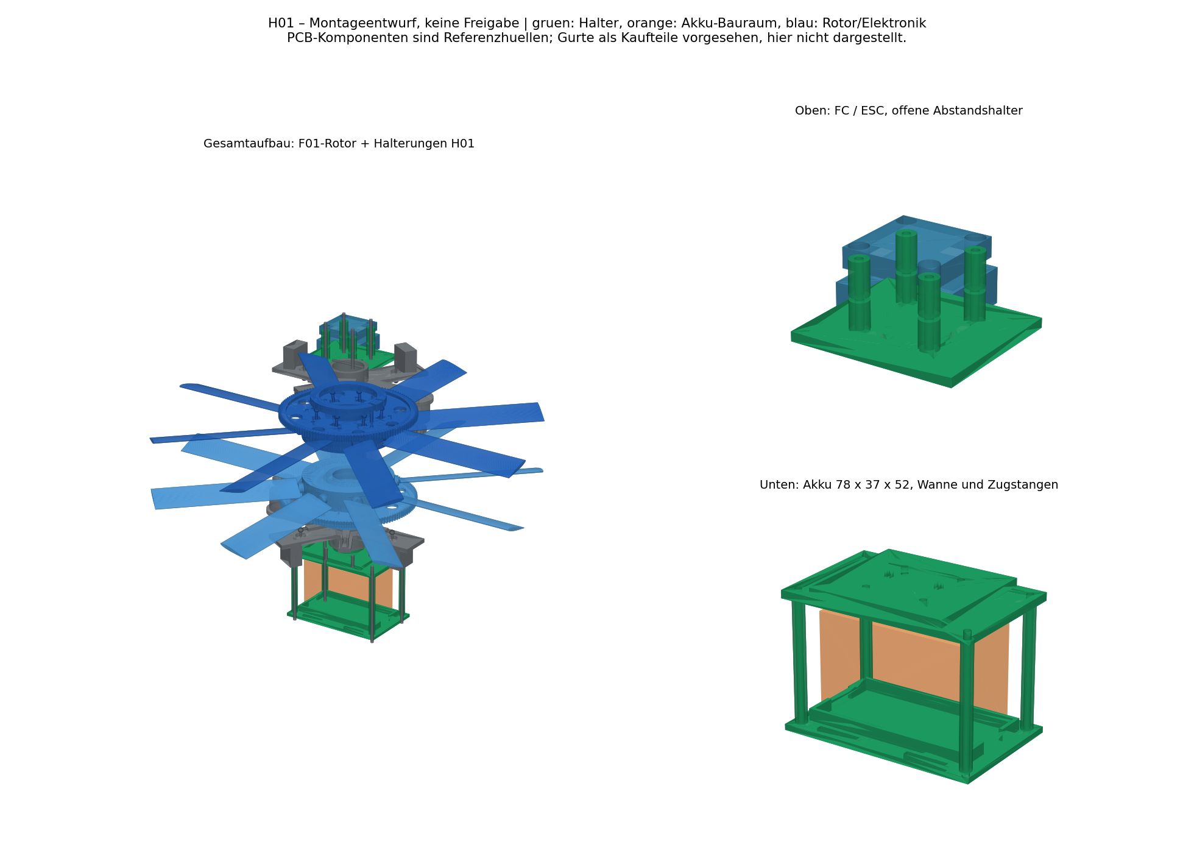
modell_r04_taumel/halterungen/Ausgabe/Vorschau_H01.png
