ITSMEEME/PropBoard/modell_r04_taumel/mechanik/Pitchvergleich.png

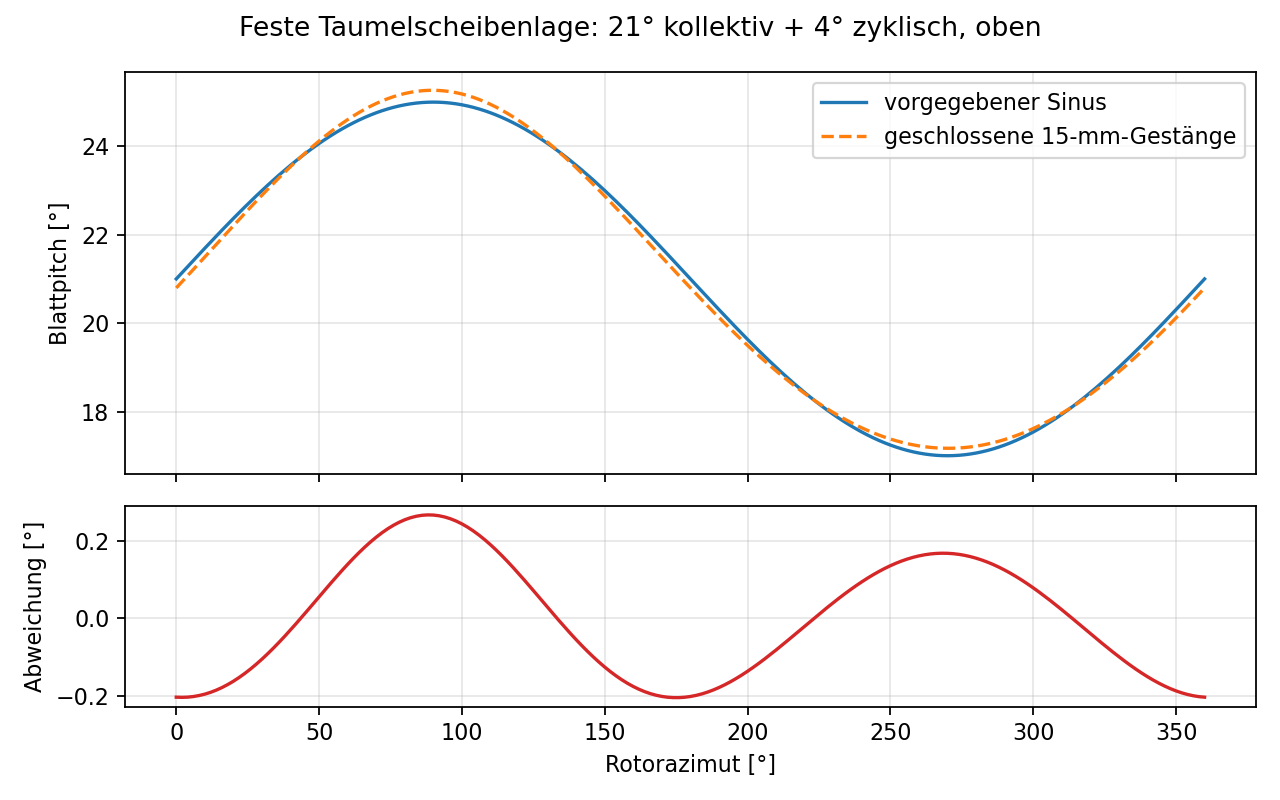
modell_r04_taumel/mechanik/Pitchvergleich.png
