ITSMEEME/PropBoard/modell_r04_taumel/mechanik/Servomoment_Reibung.png

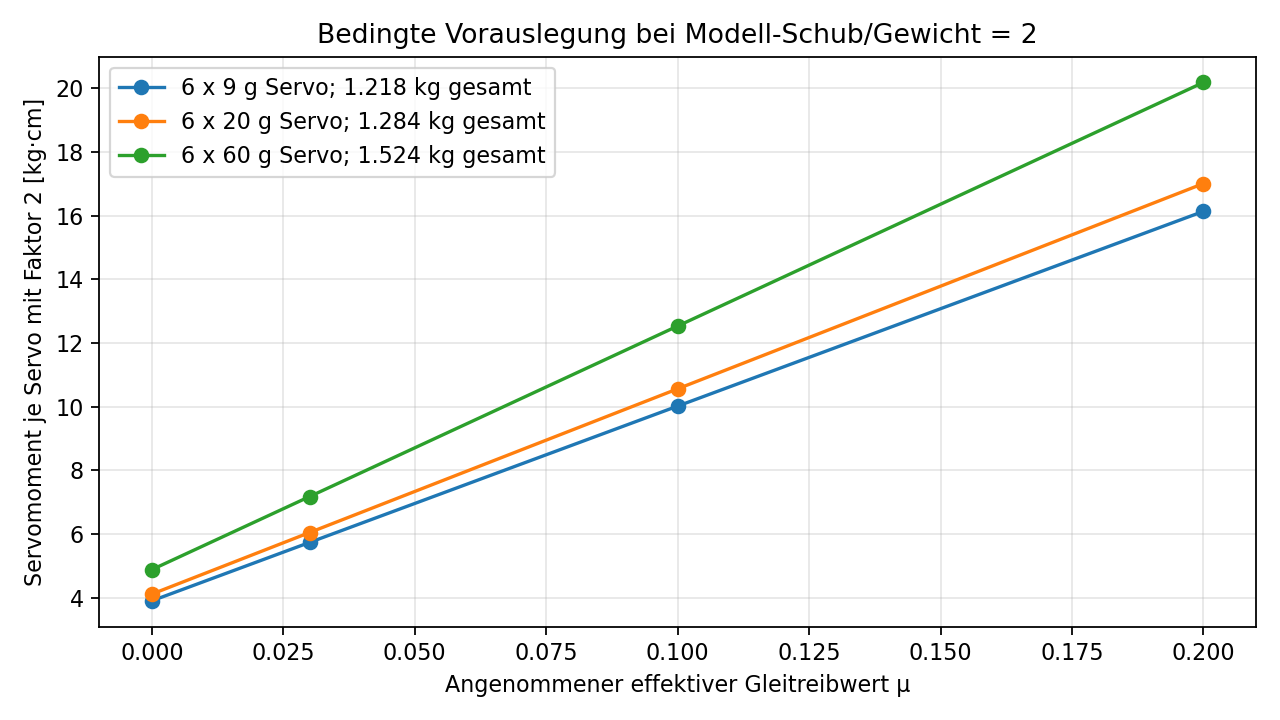
modell_r04_taumel/mechanik/Servomoment_Reibung.png
