ITSMEEME/PropBoard/modell_r04_taumel/messdaten/Reibung_Lastscreen.png

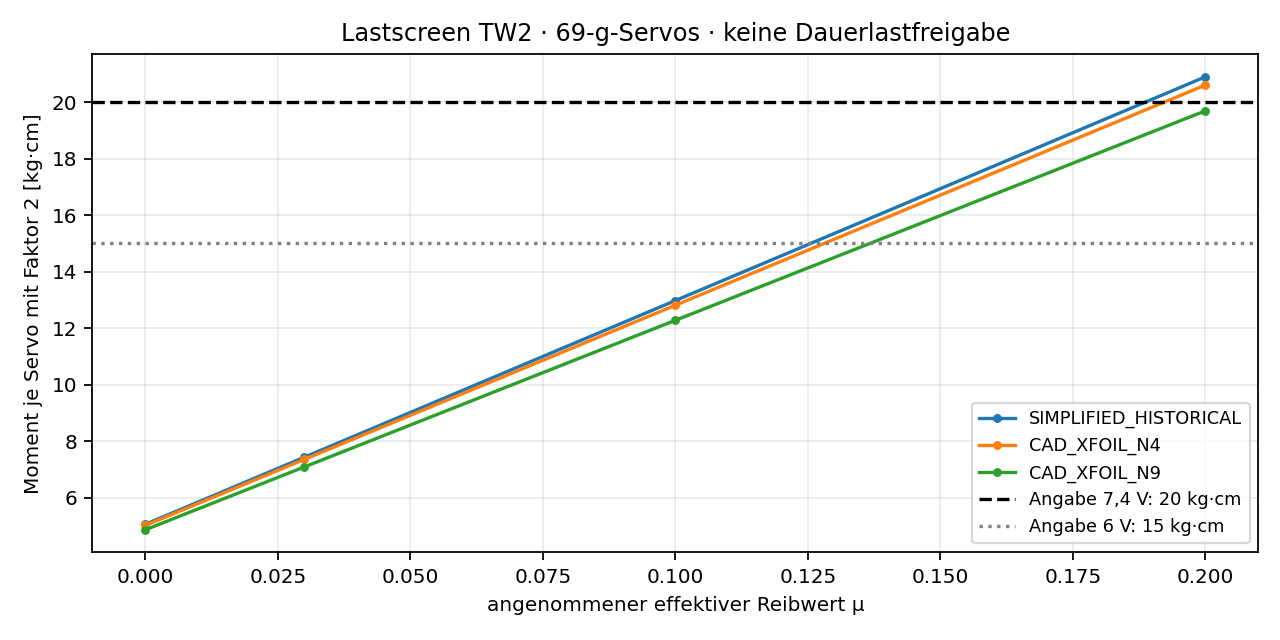
modell_r04_taumel/messdaten/Reibung_Lastscreen.png
