ITSMEEME/PropBoard/modell_r04_taumel/simulation/Ergebnisse/Browser_Desktop.png

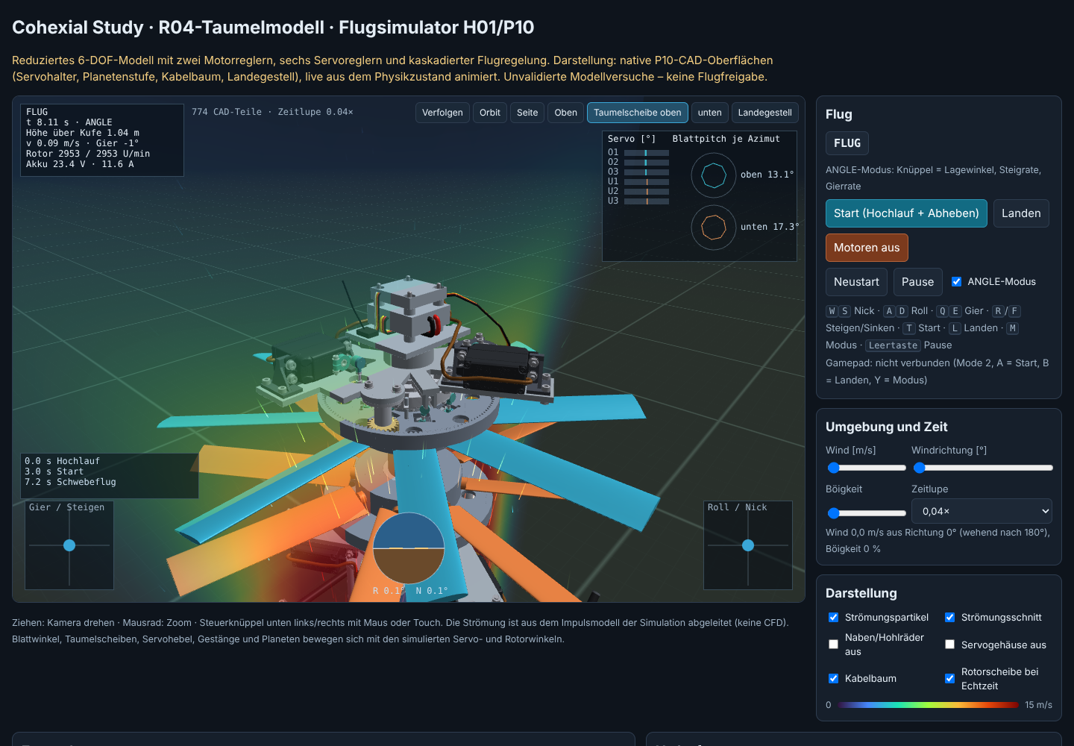
modell_r04_taumel/simulation/Ergebnisse/Browser_Desktop.png
