ITSMEEME/PropBoard/modell_r04_taumel/simulation/Ergebnisse/Browser_Mobil.png

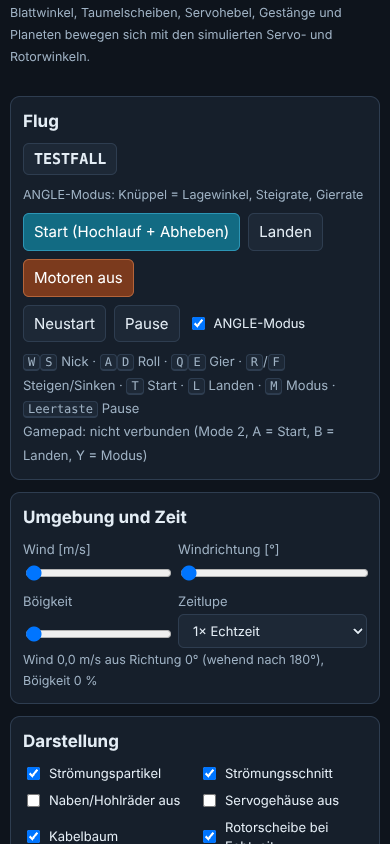
modell_r04_taumel/simulation/Ergebnisse/Browser_Mobil.png
