ITSMEEME/PropBoard/modell_r04_taumel/simulation/Ergebnisse/Flugverhalten.png

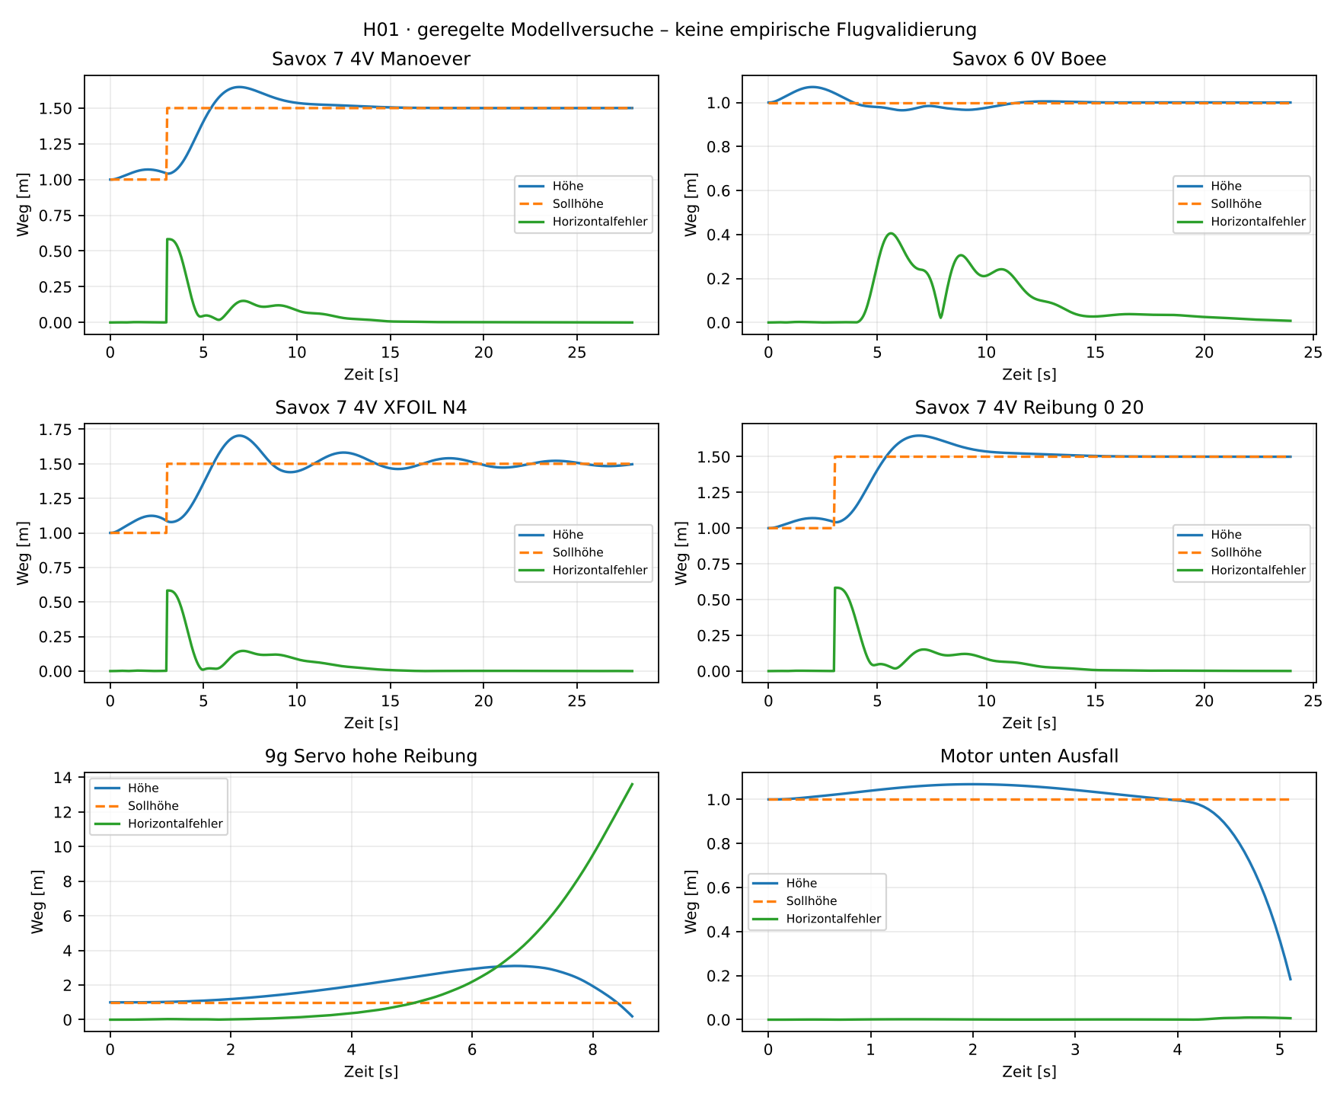
modell_r04_taumel/simulation/Ergebnisse/Flugverhalten.png
