ITSMEEME/PropBoard/modell_r04_taumel/simulation/Ergebnisse/P10_Bodenstart_Landung.png

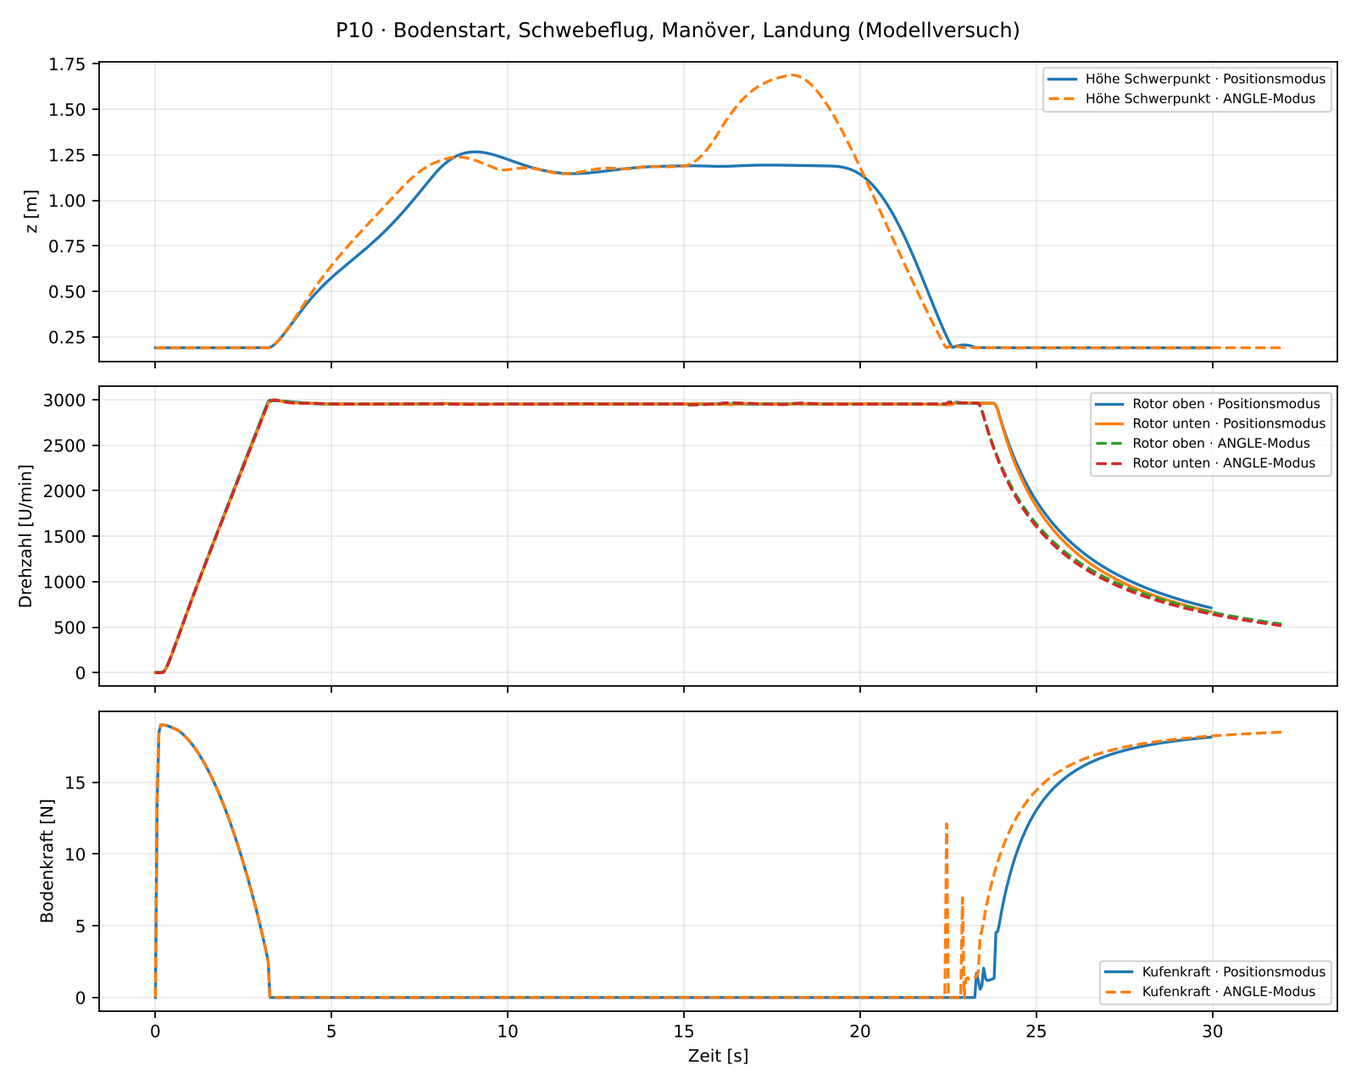
modell_r04_taumel/simulation/Ergebnisse/P10_Bodenstart_Landung.png
