ITSMEEME/PropBoard/modell_r04_taumel/simulation/Ergebnisse/P11/Physik_Pruefstand.png

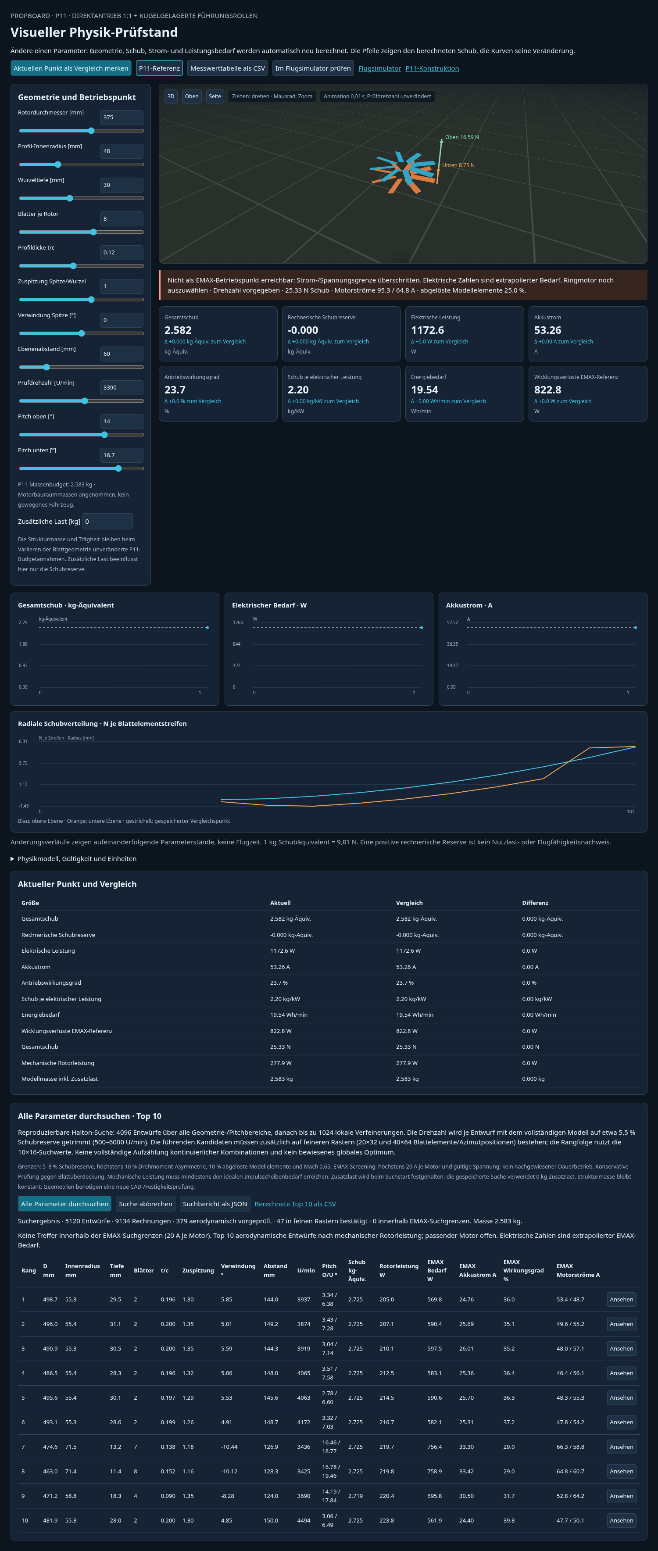
modell_r04_taumel/simulation/Ergebnisse/P11/Physik_Pruefstand.png
