ITSMEEME/PropBoard/modell_r04_taumel/simulation/Ergebnisse/PID_Antwort.png

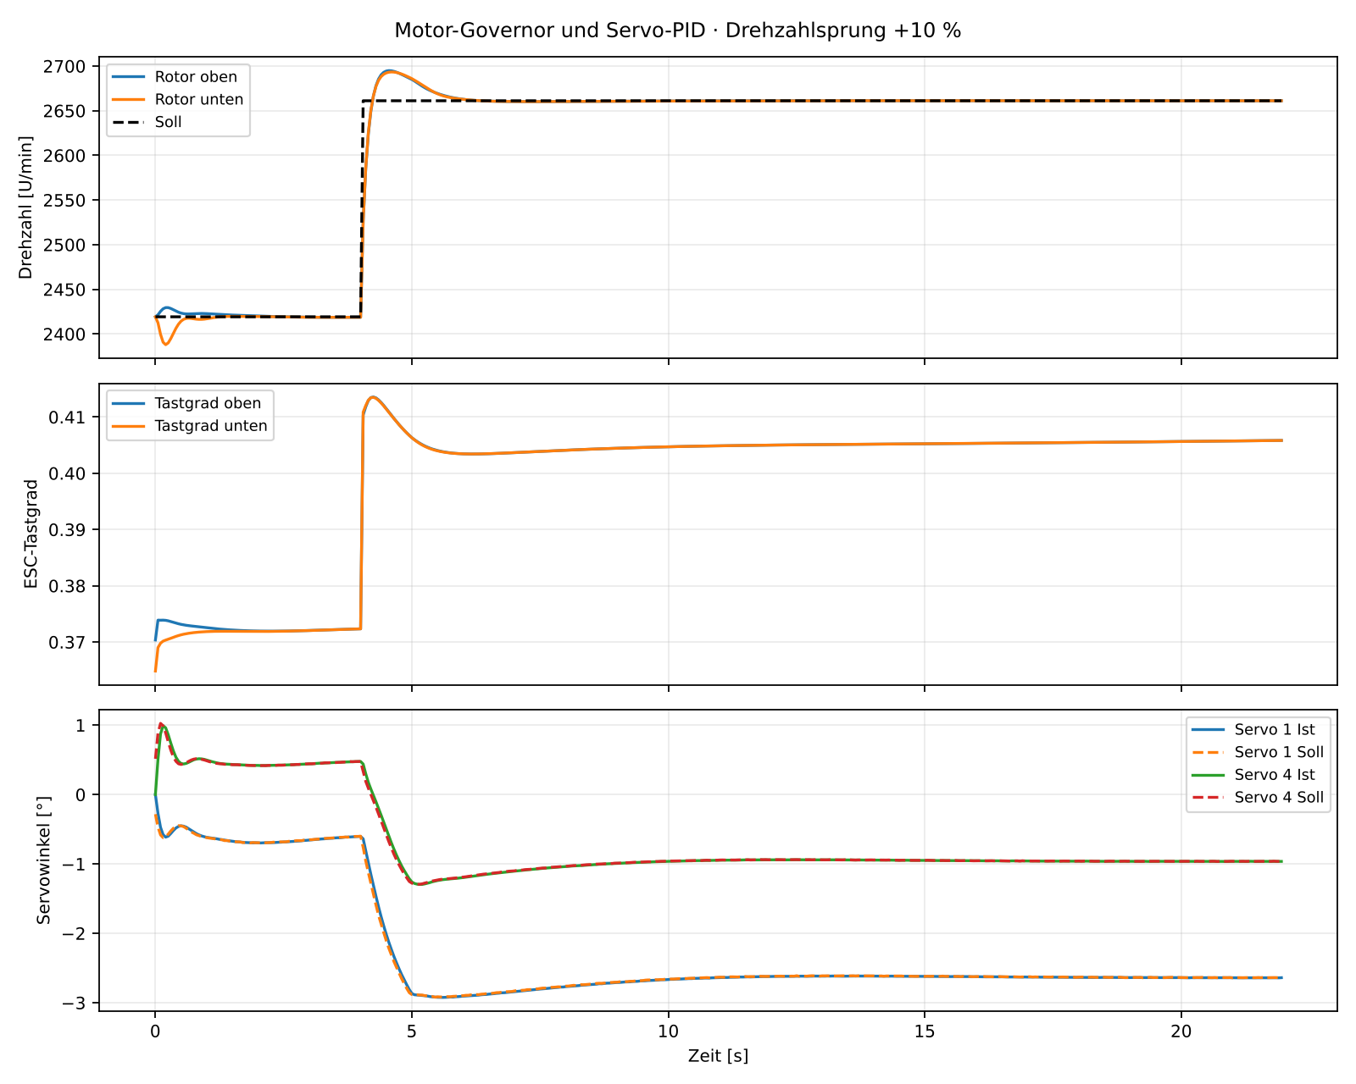
modell_r04_taumel/simulation/Ergebnisse/PID_Antwort.png
