ITSMEEME/PropBoard/motoranschluss_varianten/V1.png

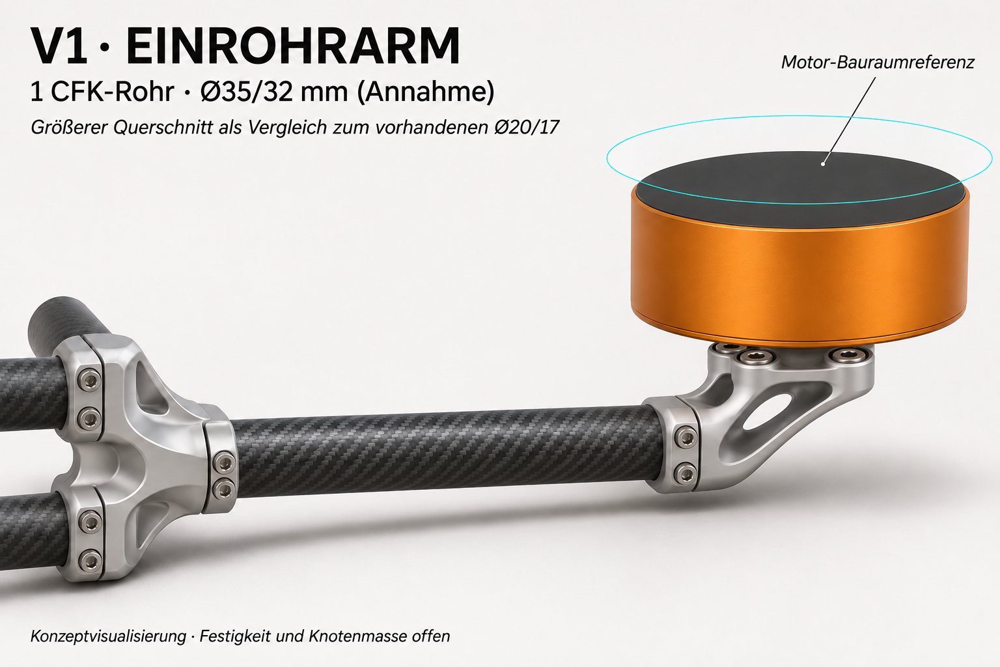
motoranschluss_varianten/V1.png
