ITSMEEME/PropBoard/motoranschluss_varianten/V2.png

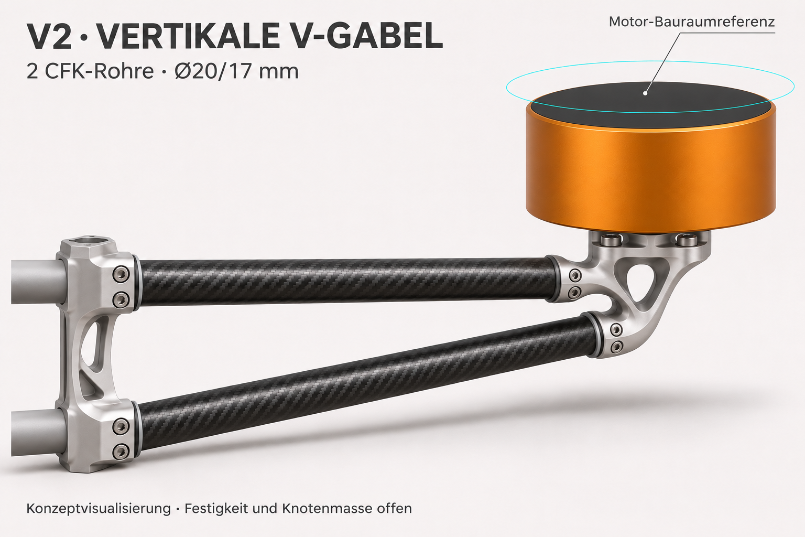
motoranschluss_varianten/V2.png
