ITSMEEME/PropBoard/motoranschluss_varianten/V3.png

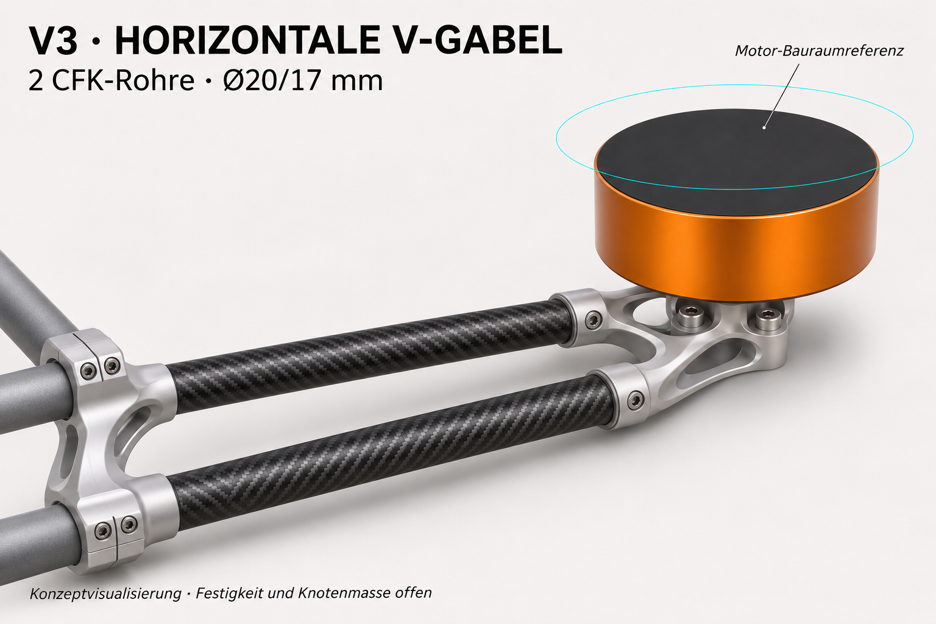
motoranschluss_varianten/V3.png
