ITSMEEME/PropBoard/motoranschluss_varianten/V4.png

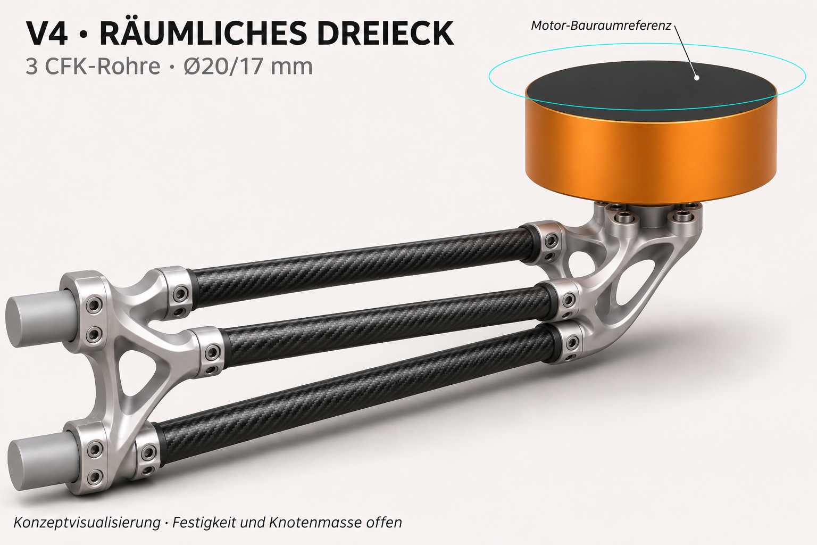
motoranschluss_varianten/V4.png
