ITSMEEME/PropBoard/motoranschluss_varianten/V5.png

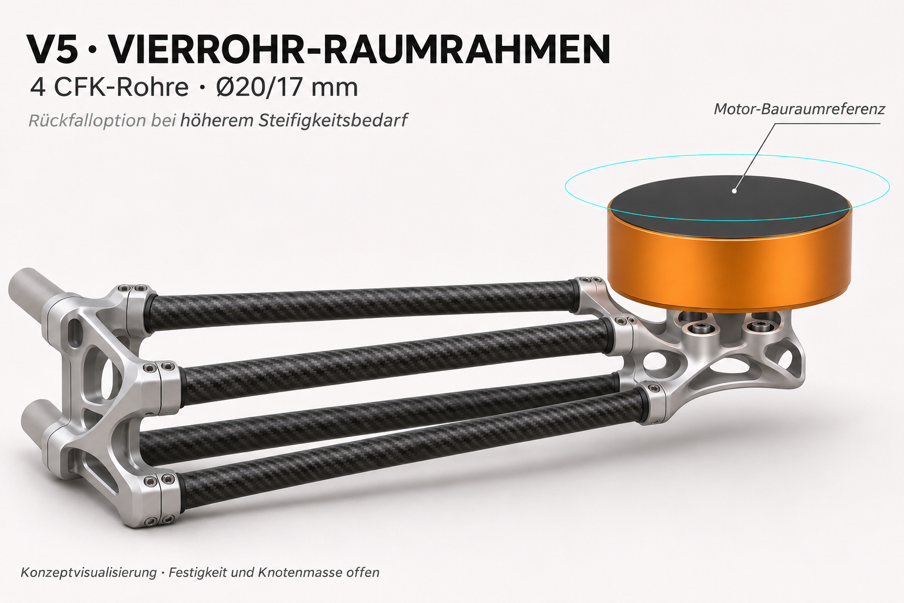
motoranschluss_varianten/V5.png
