ITSMEEME/PropBoard/multirotor_d14/Ausgabe/Dreiecksverbinder_HEXA_30_V2.png

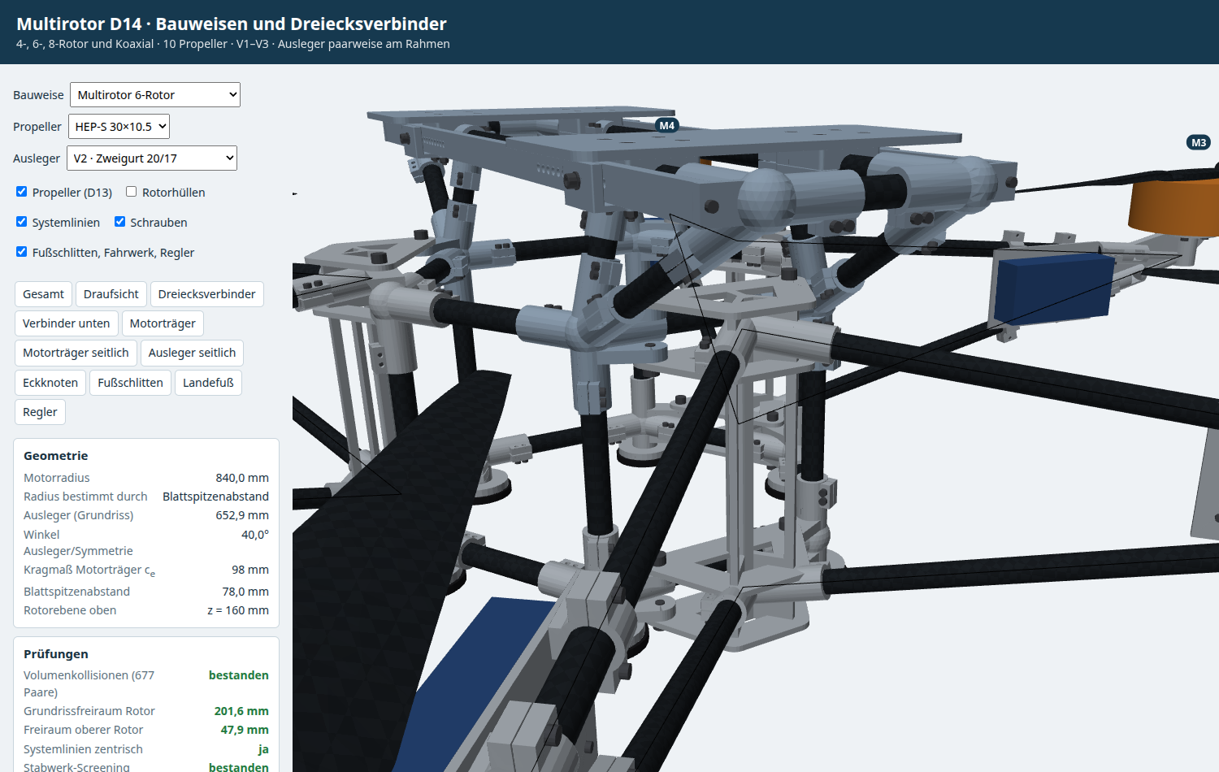
multirotor_d14/Ausgabe/Dreiecksverbinder_HEXA_30_V2.png
