ITSMEEME/PropBoard/multirotor_d14/Ausgabe/Fussschlitten_OKTO_30_V2.png

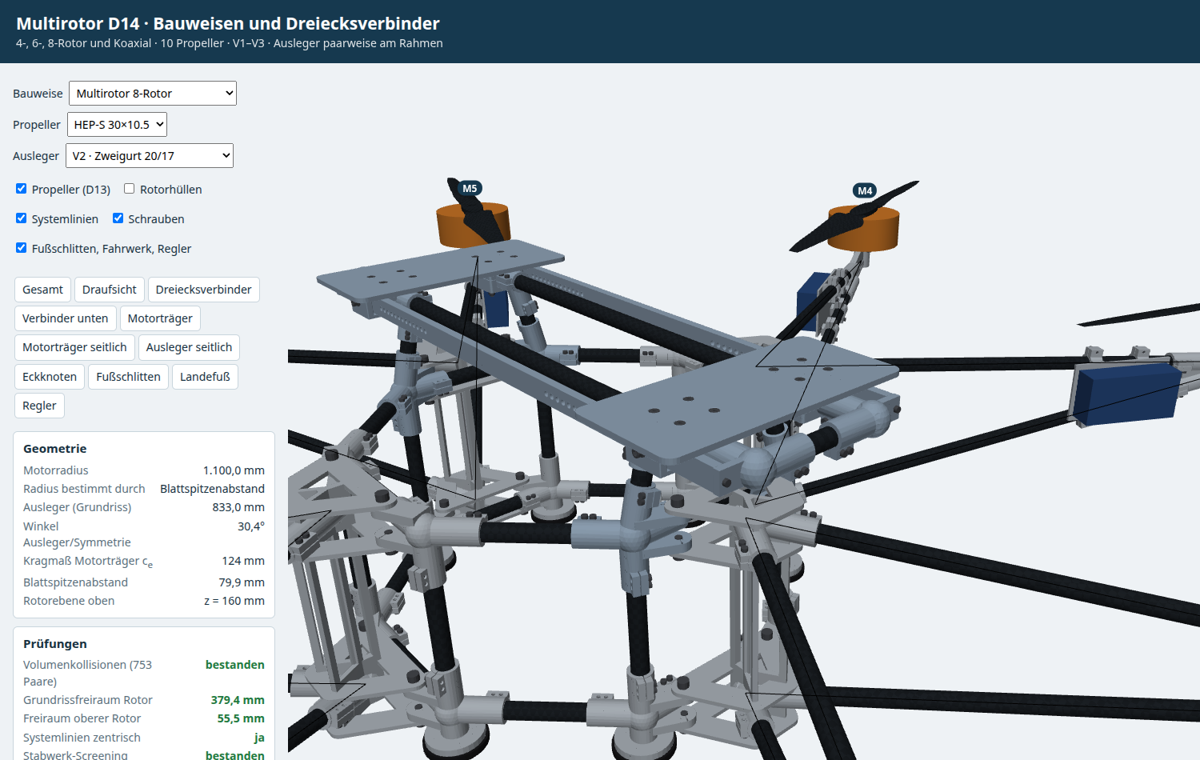
multirotor_d14/Ausgabe/Fussschlitten_OKTO_30_V2.png
