ITSMEEME/PropBoard/multirotor_d14/Ausgabe/Koax_42_V3_seitlich.png

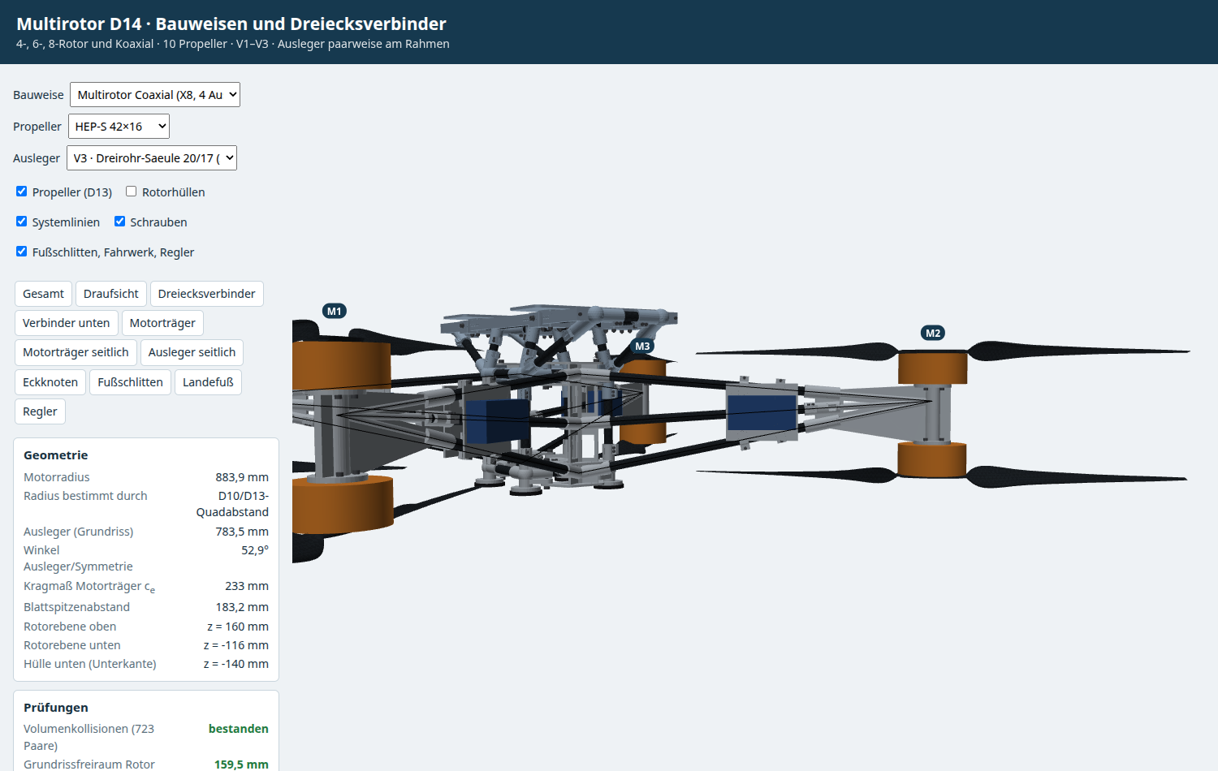
multirotor_d14/Ausgabe/Koax_42_V3_seitlich.png
