ITSMEEME/PropBoard/multirotor_d14/Ausgabe/Regler_QUAD_42_V2.png

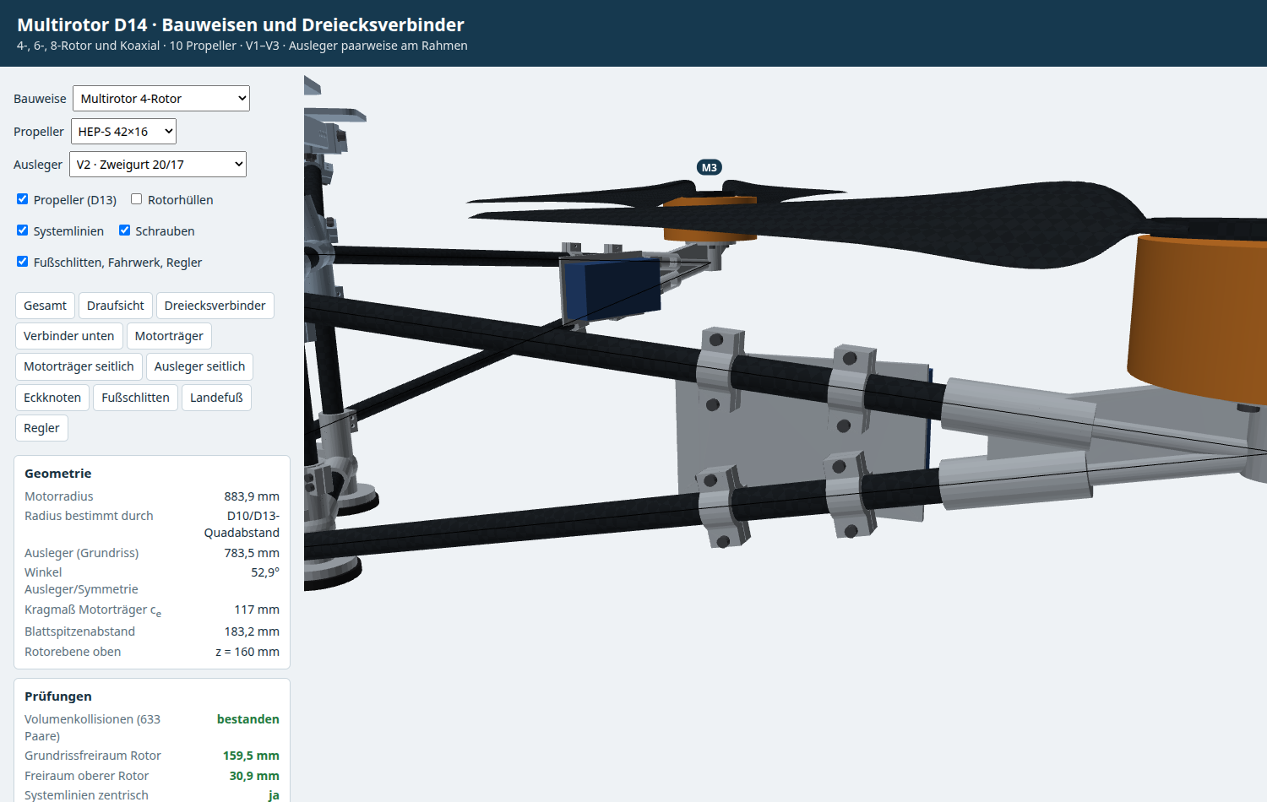
multirotor_d14/Ausgabe/Regler_QUAD_42_V2.png
