ITSMEEME/PropBoard/multirotor_d14/Ausgabe/V4_QUAD_42_drauf.png

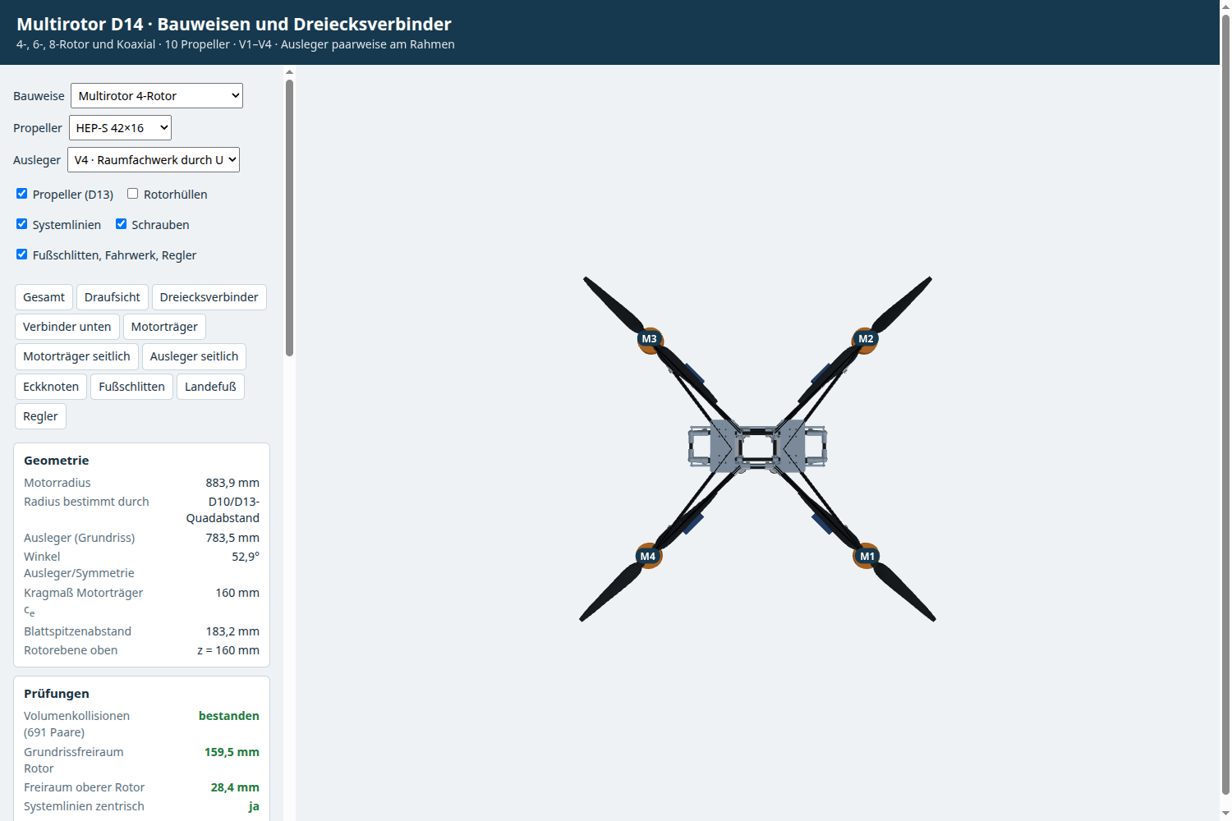
multirotor_d14/Ausgabe/V4_QUAD_42_drauf.png
