ITSMEEME/PropBoard/quad_r380_d01/Armwurzel_Detail.png

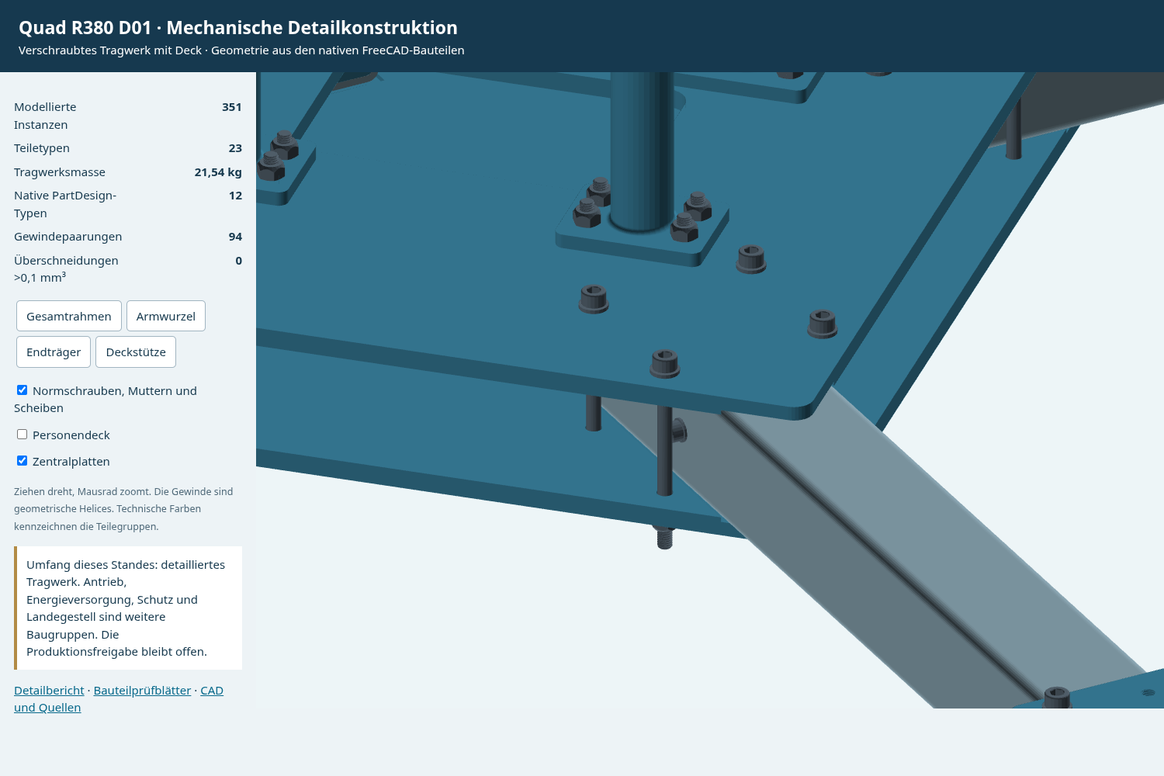
quad_r380_d01/Armwurzel_Detail.png
