ITSMEEME/PropBoard/quad_r380_d01/Tragwerk_Ansicht.png

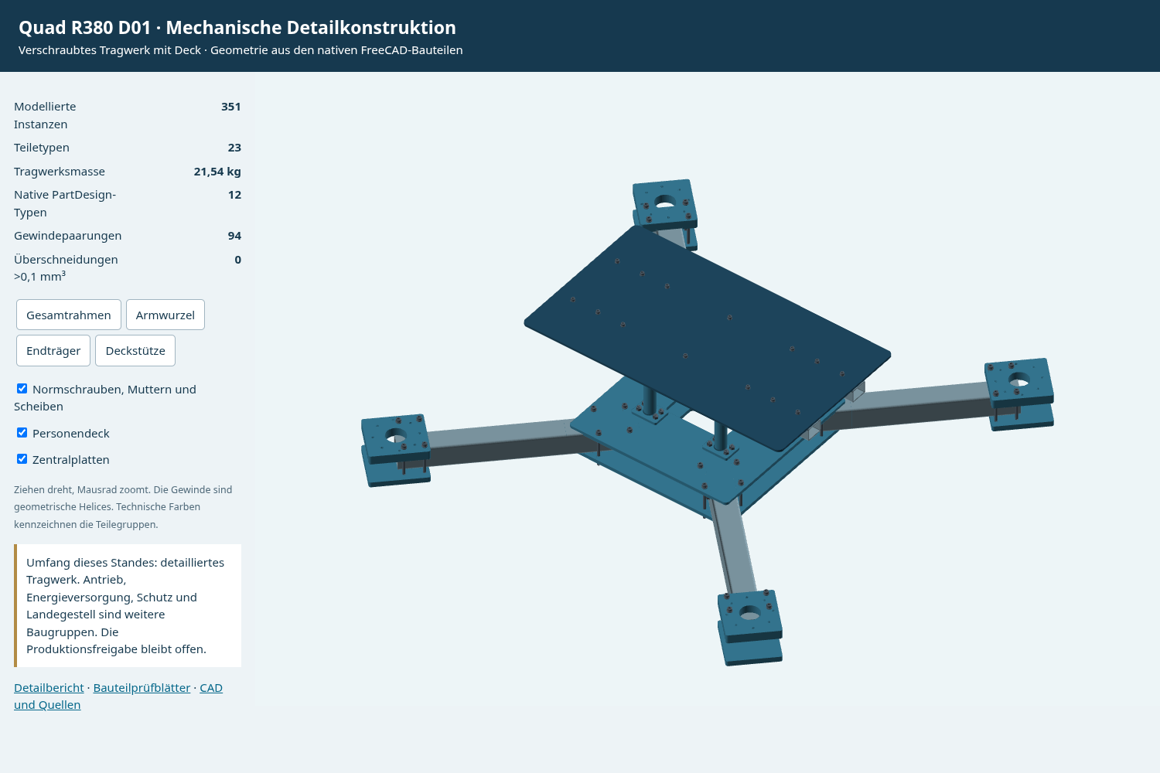
quad_r380_d01/Tragwerk_Ansicht.png
