ITSMEEME/PropBoard/quad_r380_d02/Fussschlitten_Detail.png

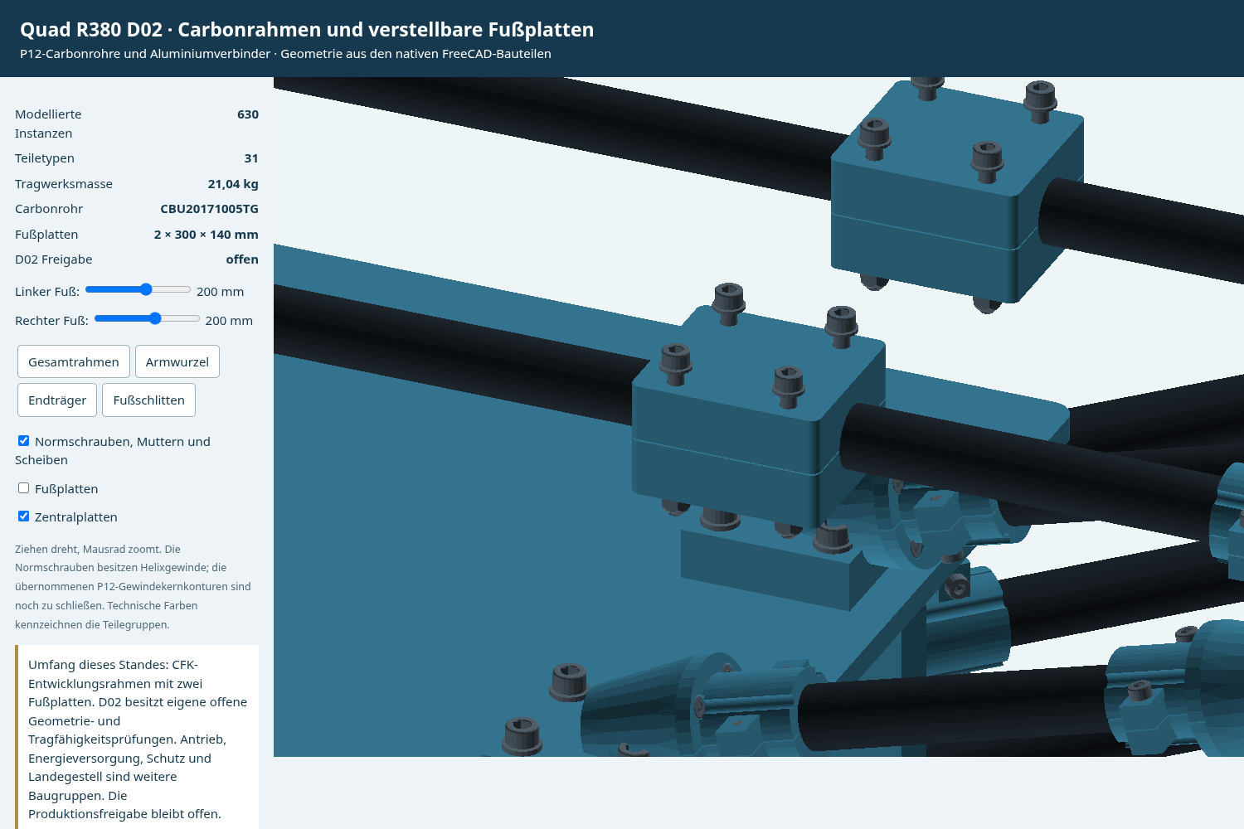
quad_r380_d02/Fussschlitten_Detail.png
