ITSMEEME/PropBoard/quad_r380_d02/Fussverstellung.png

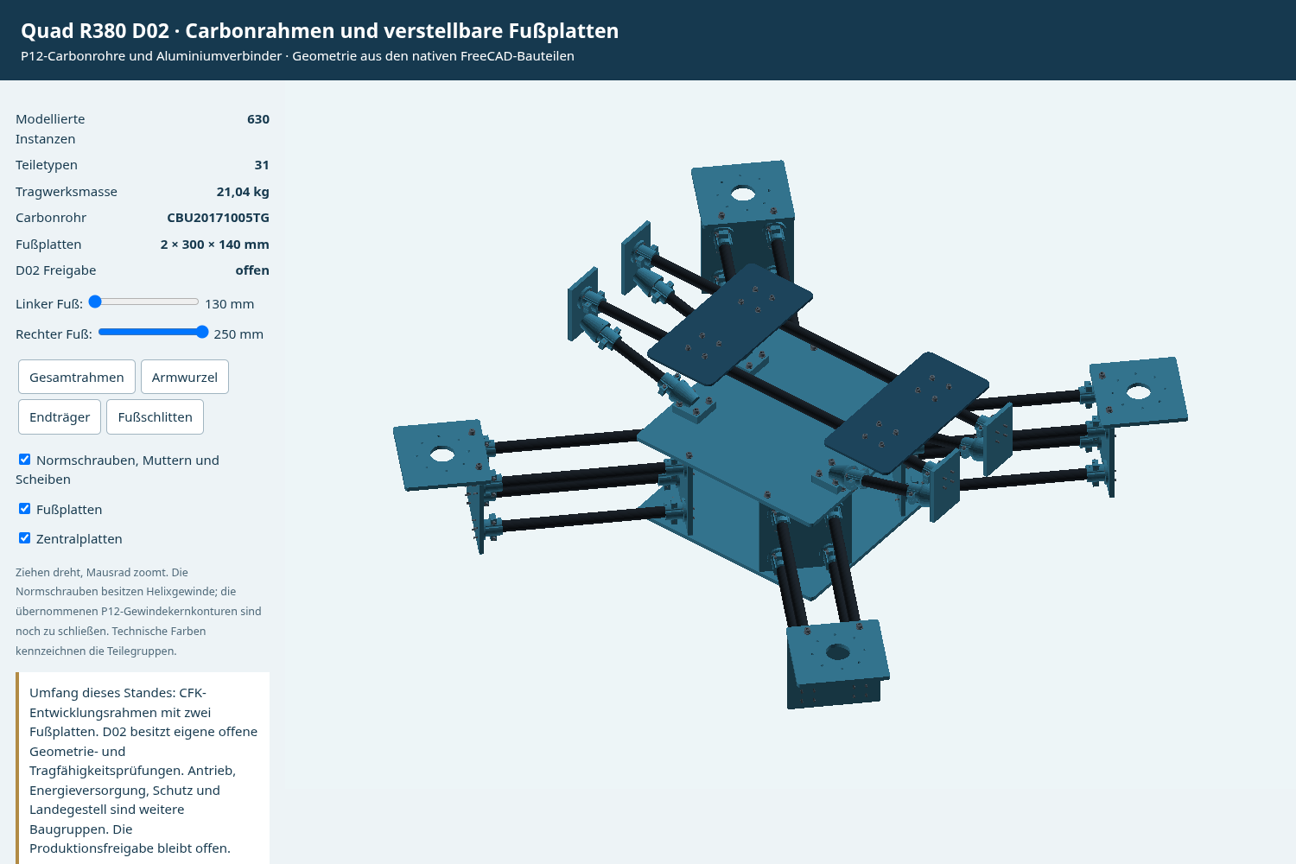
quad_r380_d02/Fussverstellung.png
