ITSMEEME/PropBoard/quad_r380_d03/Fussschlitten_Detail.png

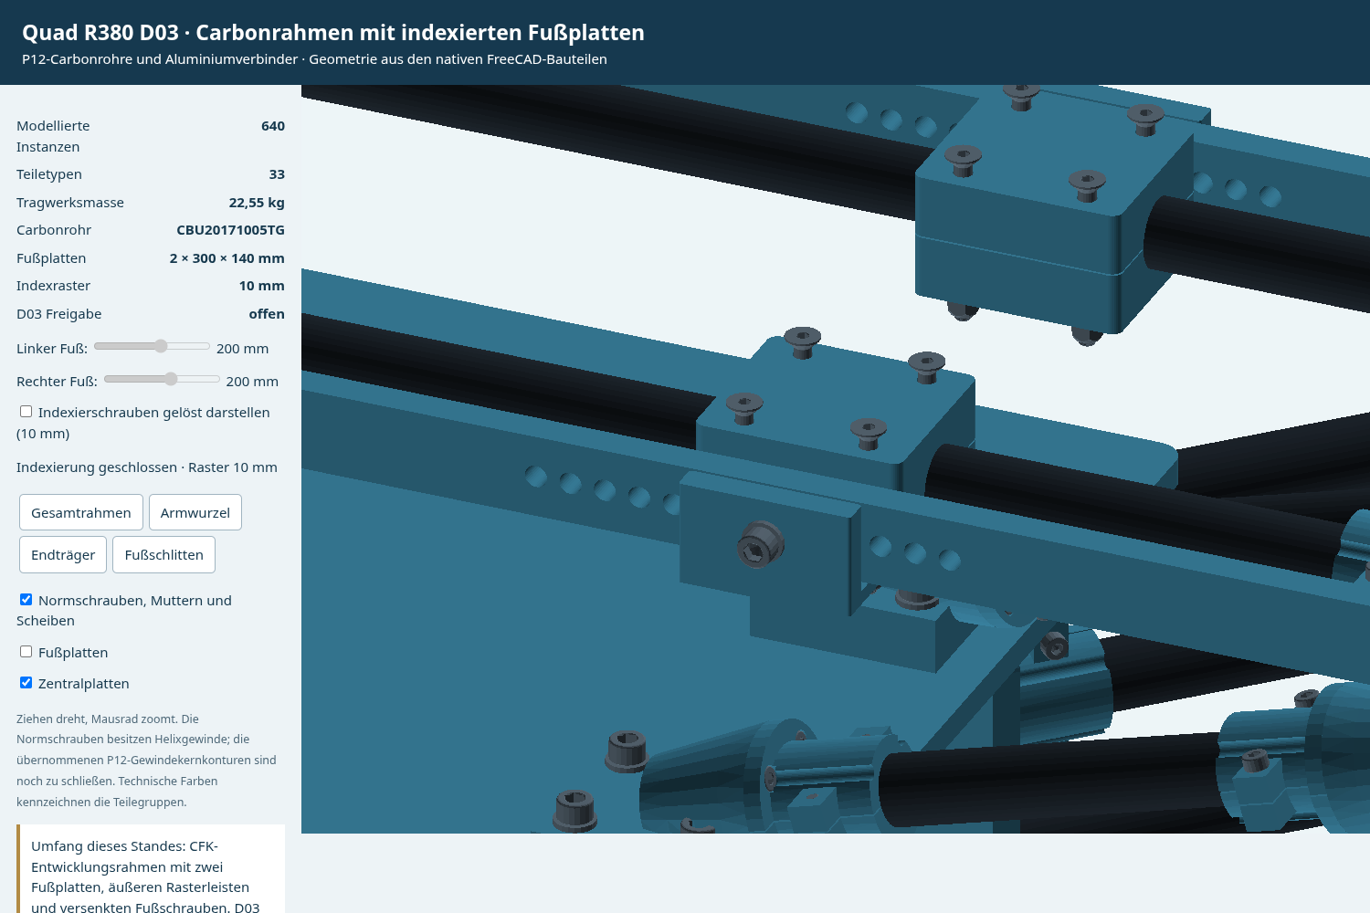
quad_r380_d03/Fussschlitten_Detail.png
