ITSMEEME/PropBoard/quad_r380_d04/Carbon_Mitte.png

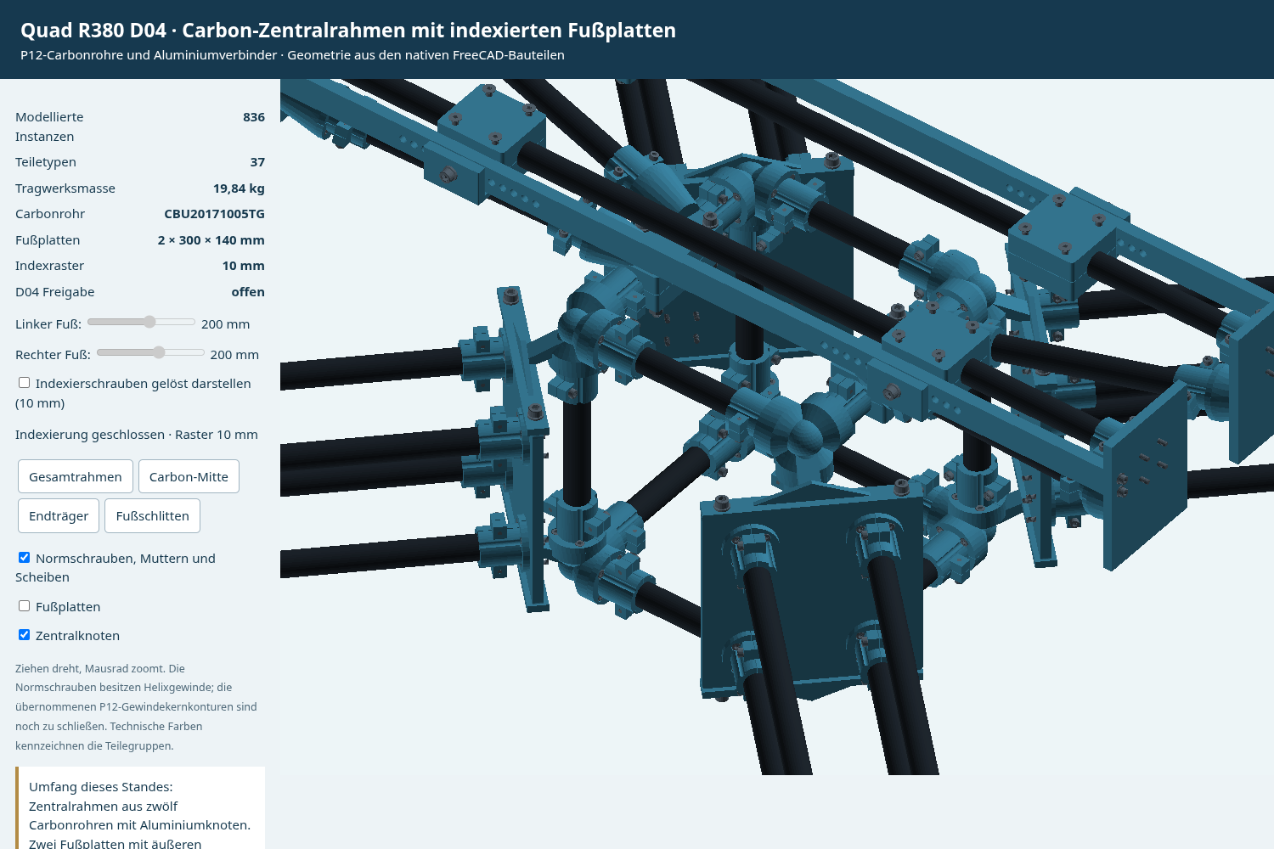
quad_r380_d04/Carbon_Mitte.png
