ITSMEEME/PropBoard/quad_r380_d04/Fussschlitten_Detail.png

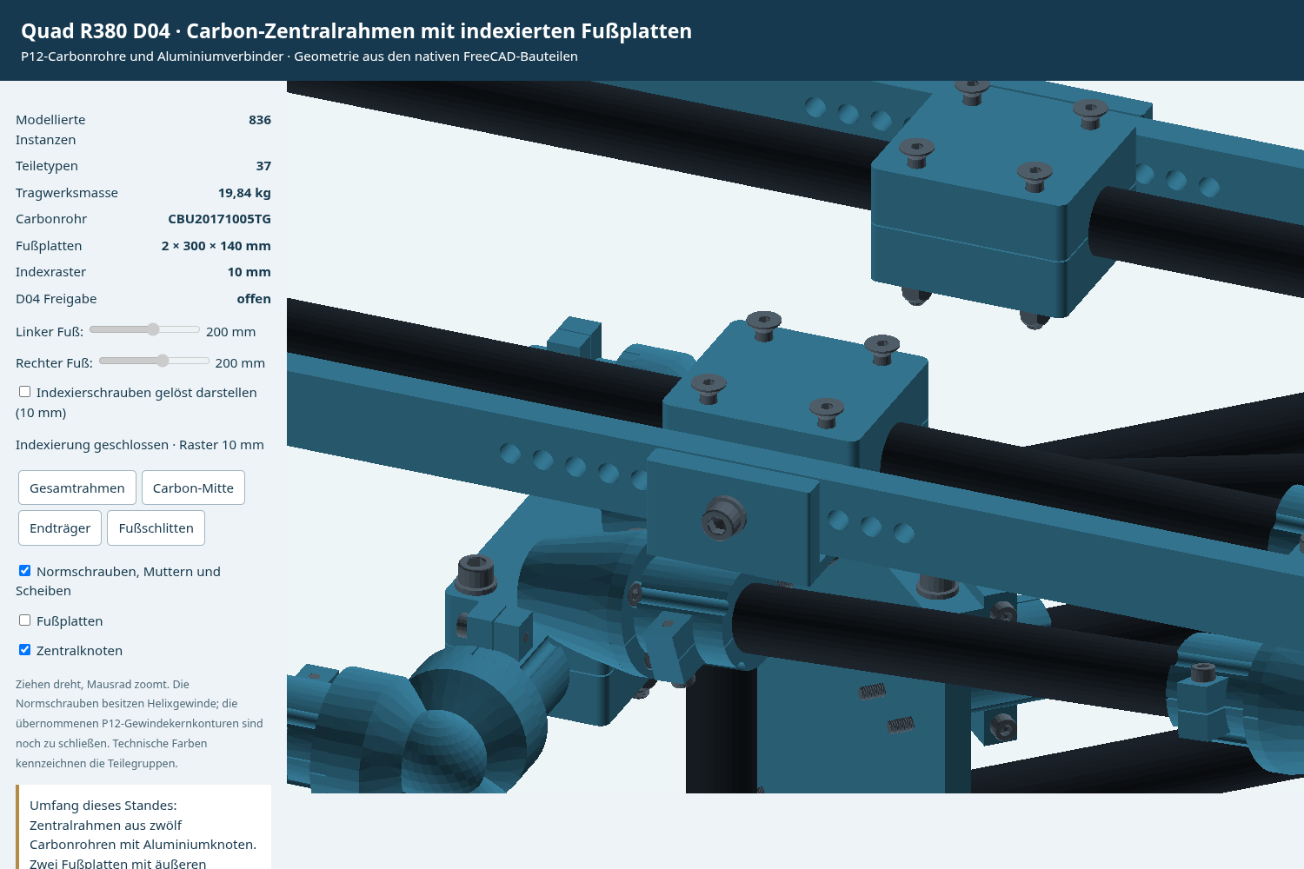
quad_r380_d04/Fussschlitten_Detail.png
