ITSMEEME/PropBoard/quad_r380_d05/Fussschlitten_Detail.png

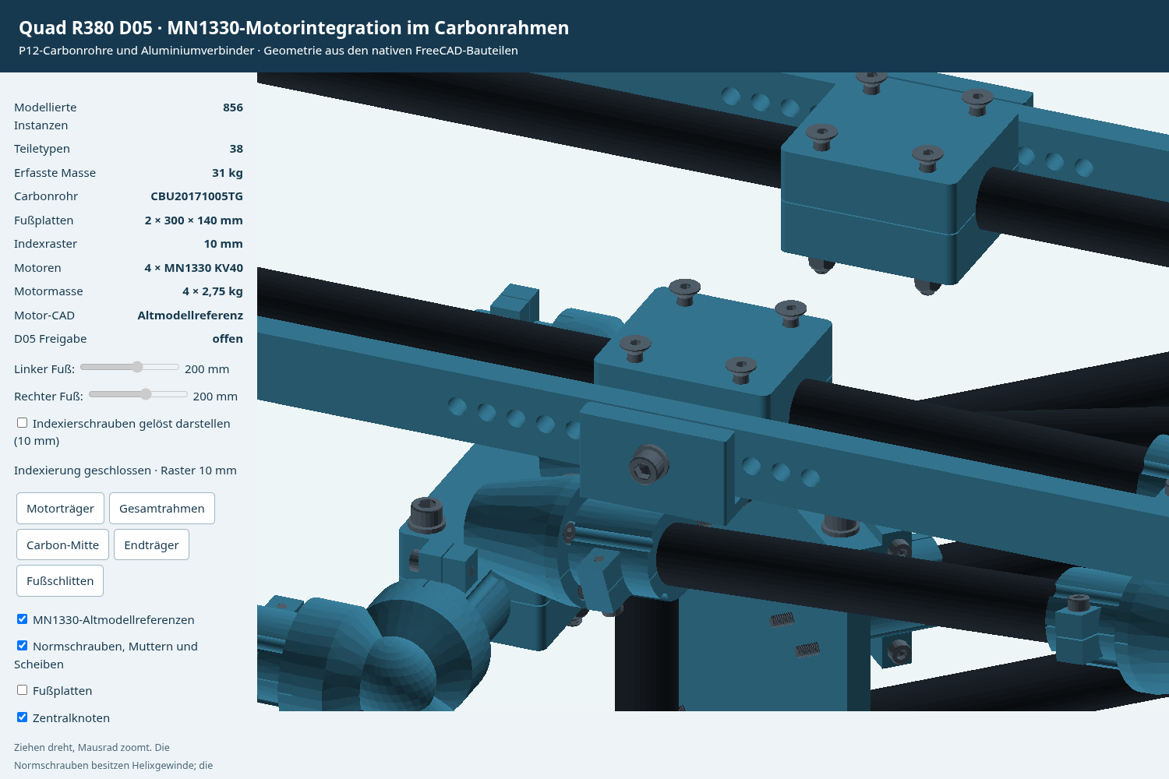
quad_r380_d05/Fussschlitten_Detail.png
