ITSMEEME/PropBoard/quad_r380_d05/Fussverstellung.png

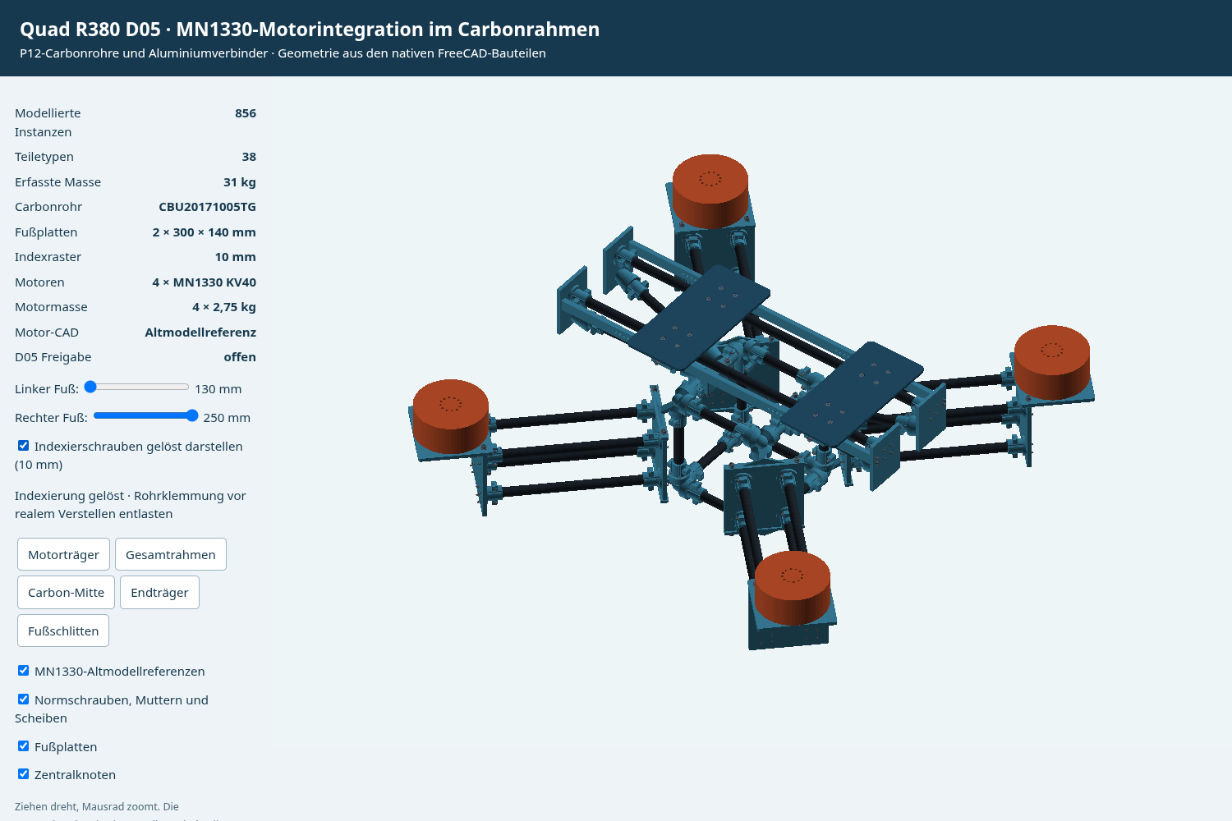
quad_r380_d05/Fussverstellung.png
