ITSMEEME/PropBoard/quad_r380_d05/MN1330_Motortraeger.png

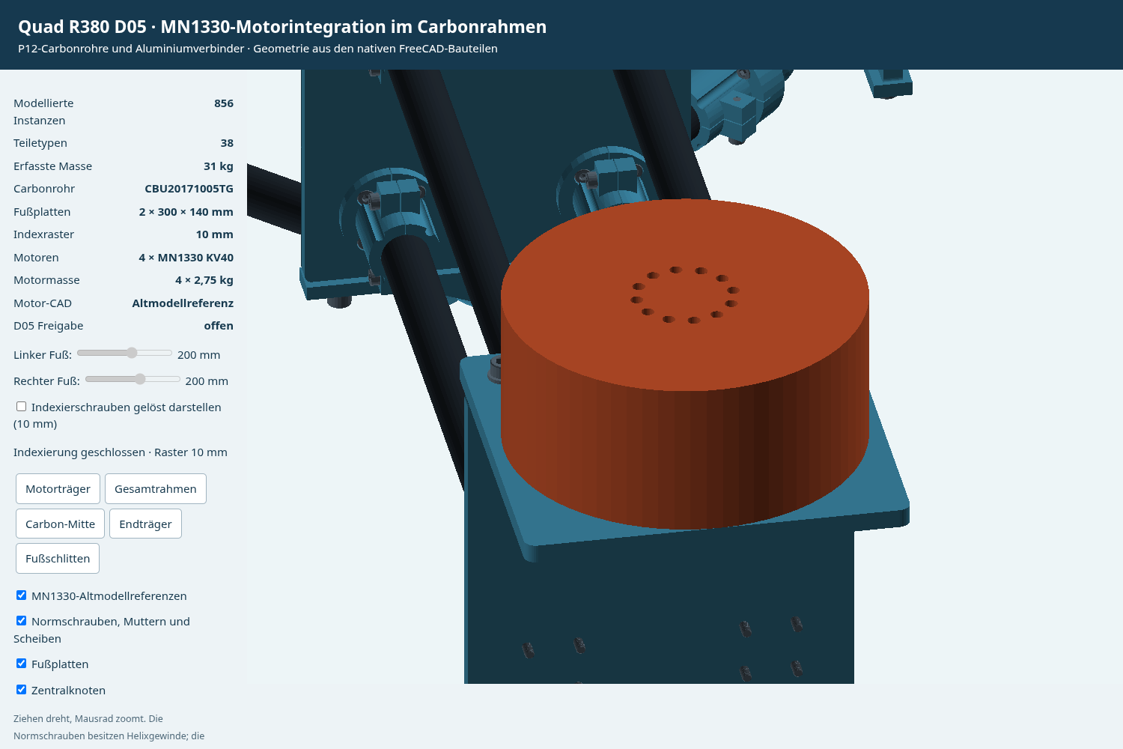
quad_r380_d05/MN1330_Motortraeger.png
