ITSMEEME/PropBoard/quad_r380_d06/Blattinneres.png

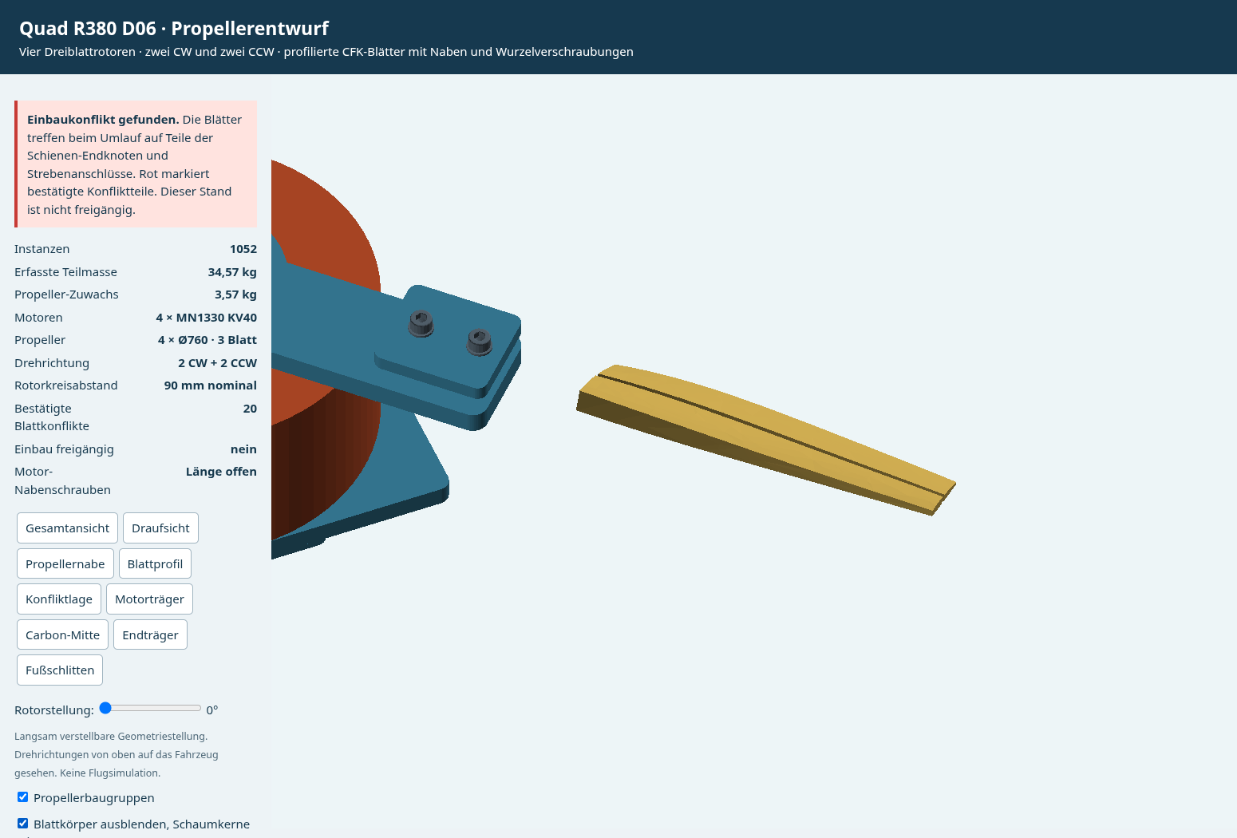
quad_r380_d06/Blattinneres.png
