ITSMEEME/PropBoard/quad_r380_d06/Propeller_Draufsicht.png

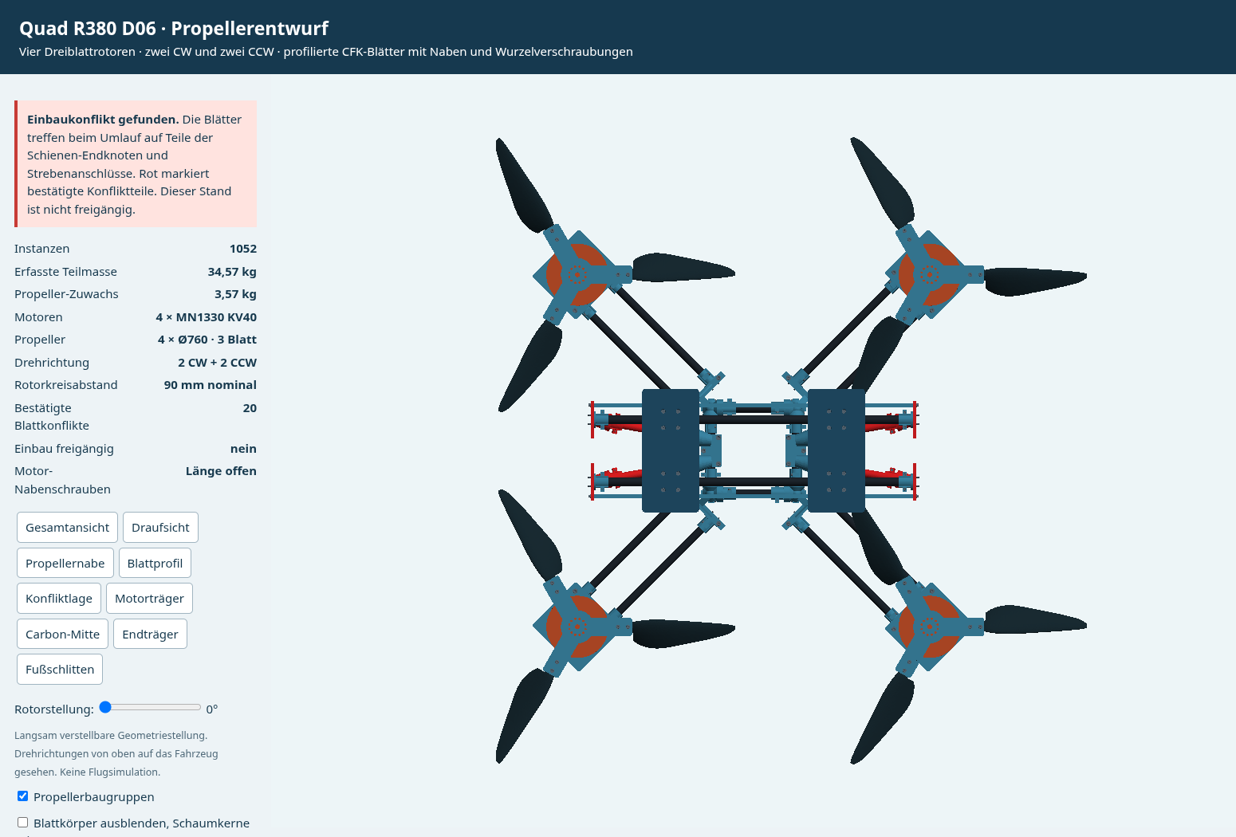
quad_r380_d06/Propeller_Draufsicht.png
