ITSMEEME/PropBoard/quad_r380_d06/Propeller_Gesamt.png

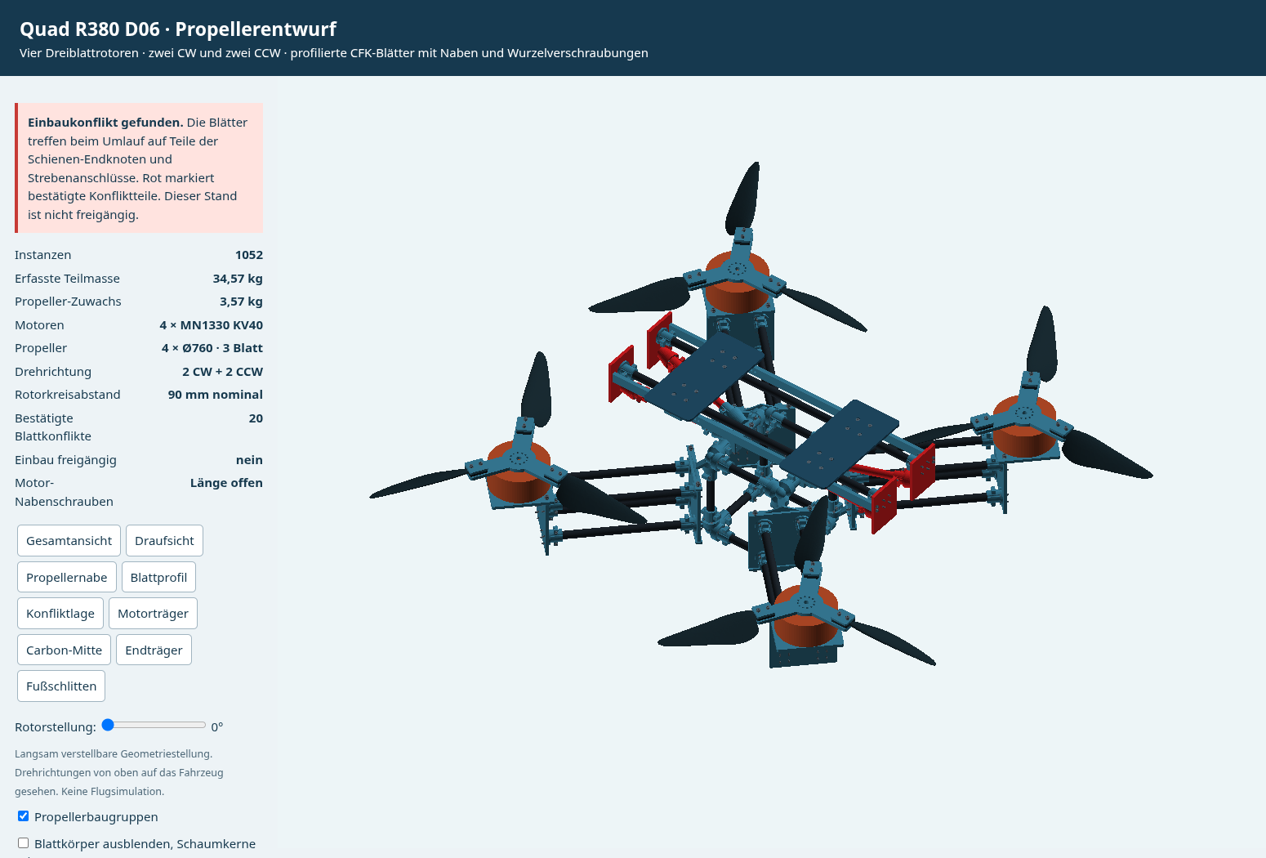
quad_r380_d06/Propeller_Gesamt.png
