ITSMEEME/PropBoard/quad_r380_d06/Propellernabe.png

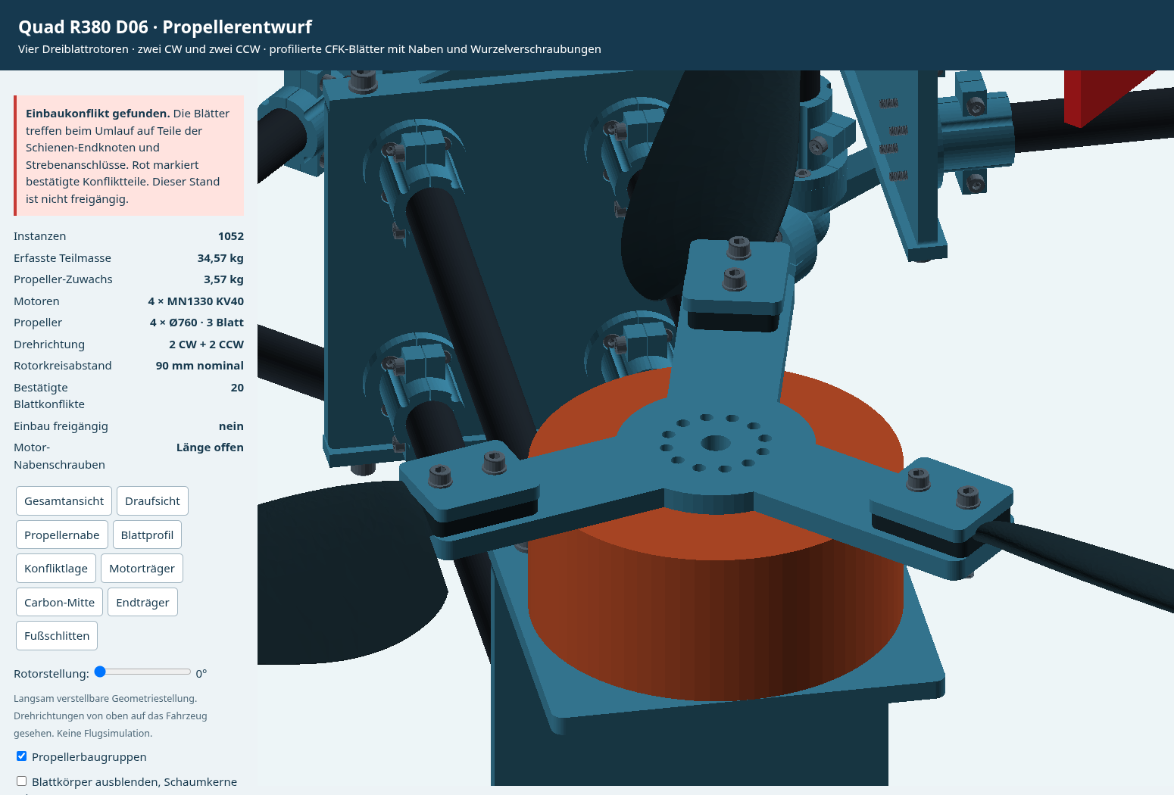
quad_r380_d06/Propellernabe.png
