ITSMEEME/PropBoard/quad_r380_d06/Rotor_Konflikt.png

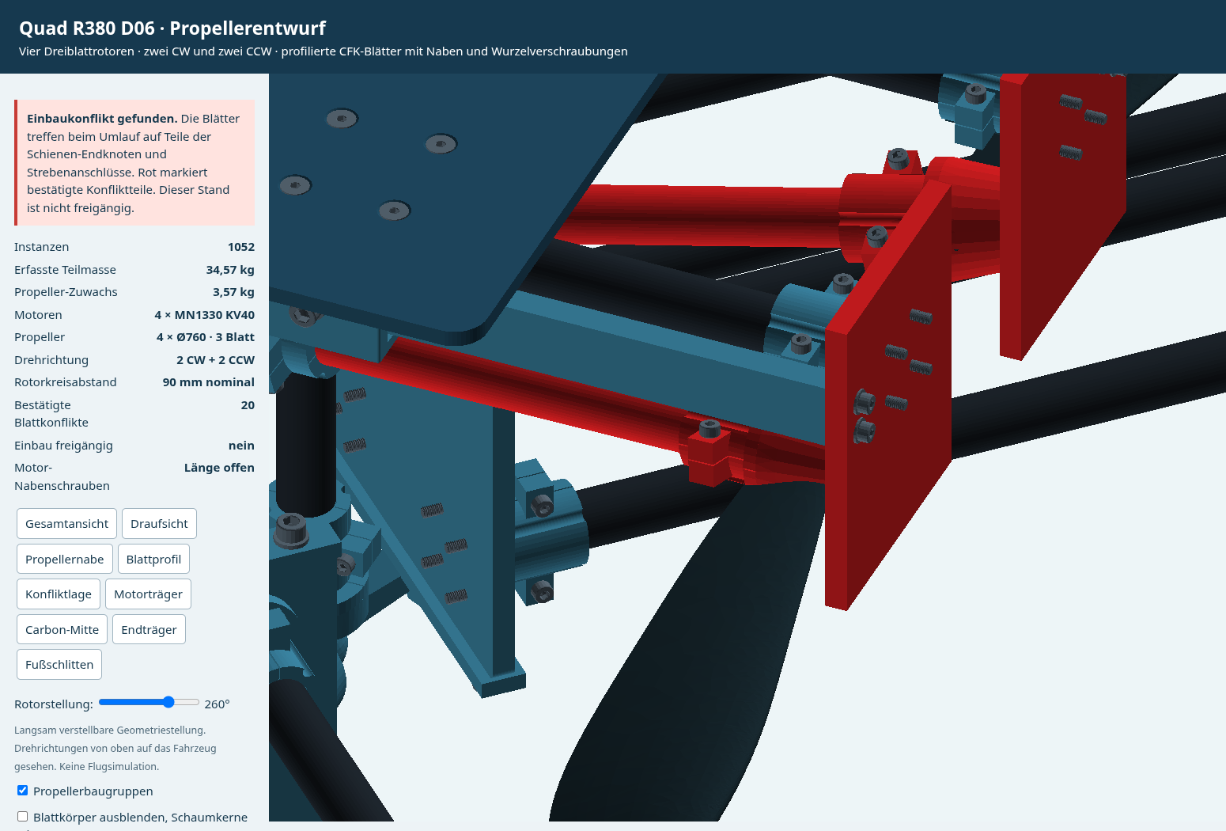
quad_r380_d06/Rotor_Konflikt.png
