ITSMEEME/PropBoard/quad_r380_d08/Ausgabe/Antrieb_Struktur.png

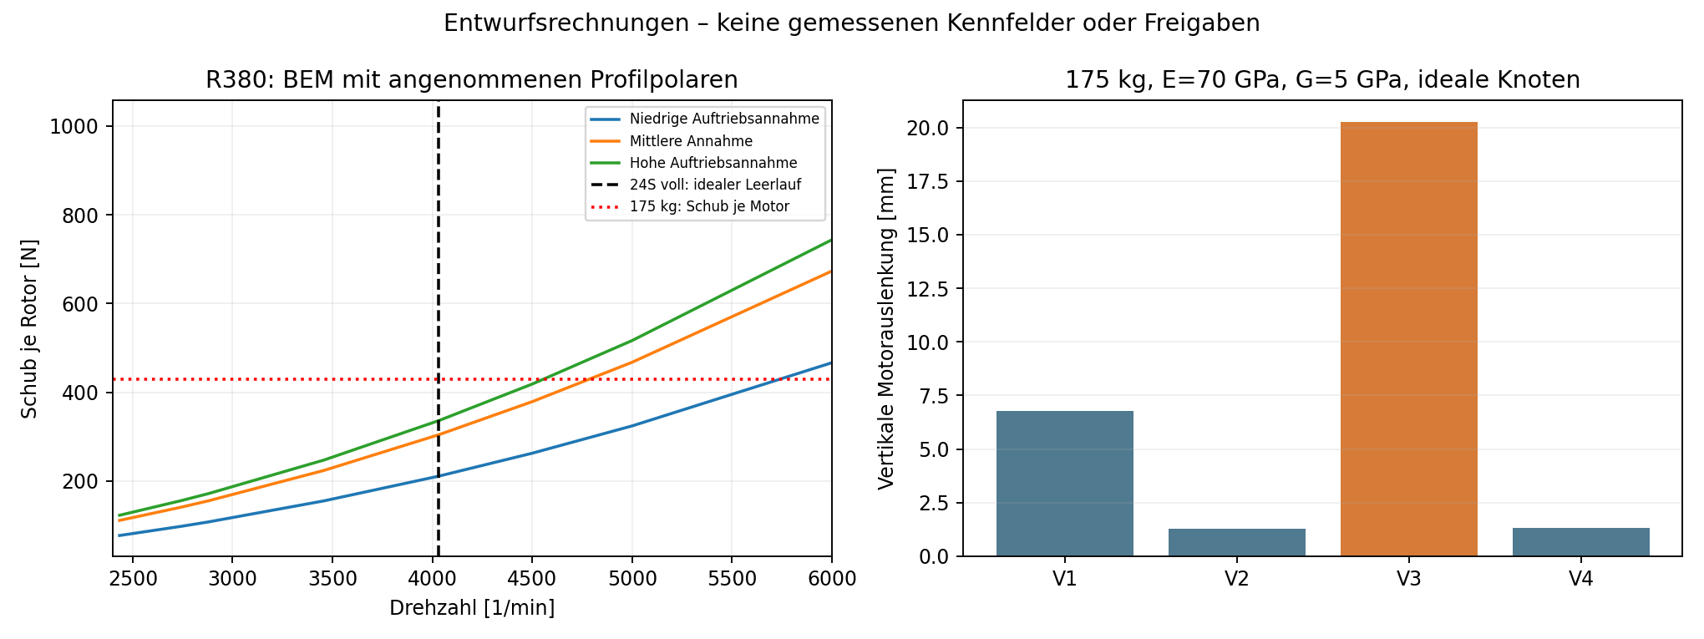
quad_r380_d08/Ausgabe/Antrieb_Struktur.png
