ITSMEEME/PropBoard/quad_r380_d09/Ausgabe/HEPS_18_V4.png

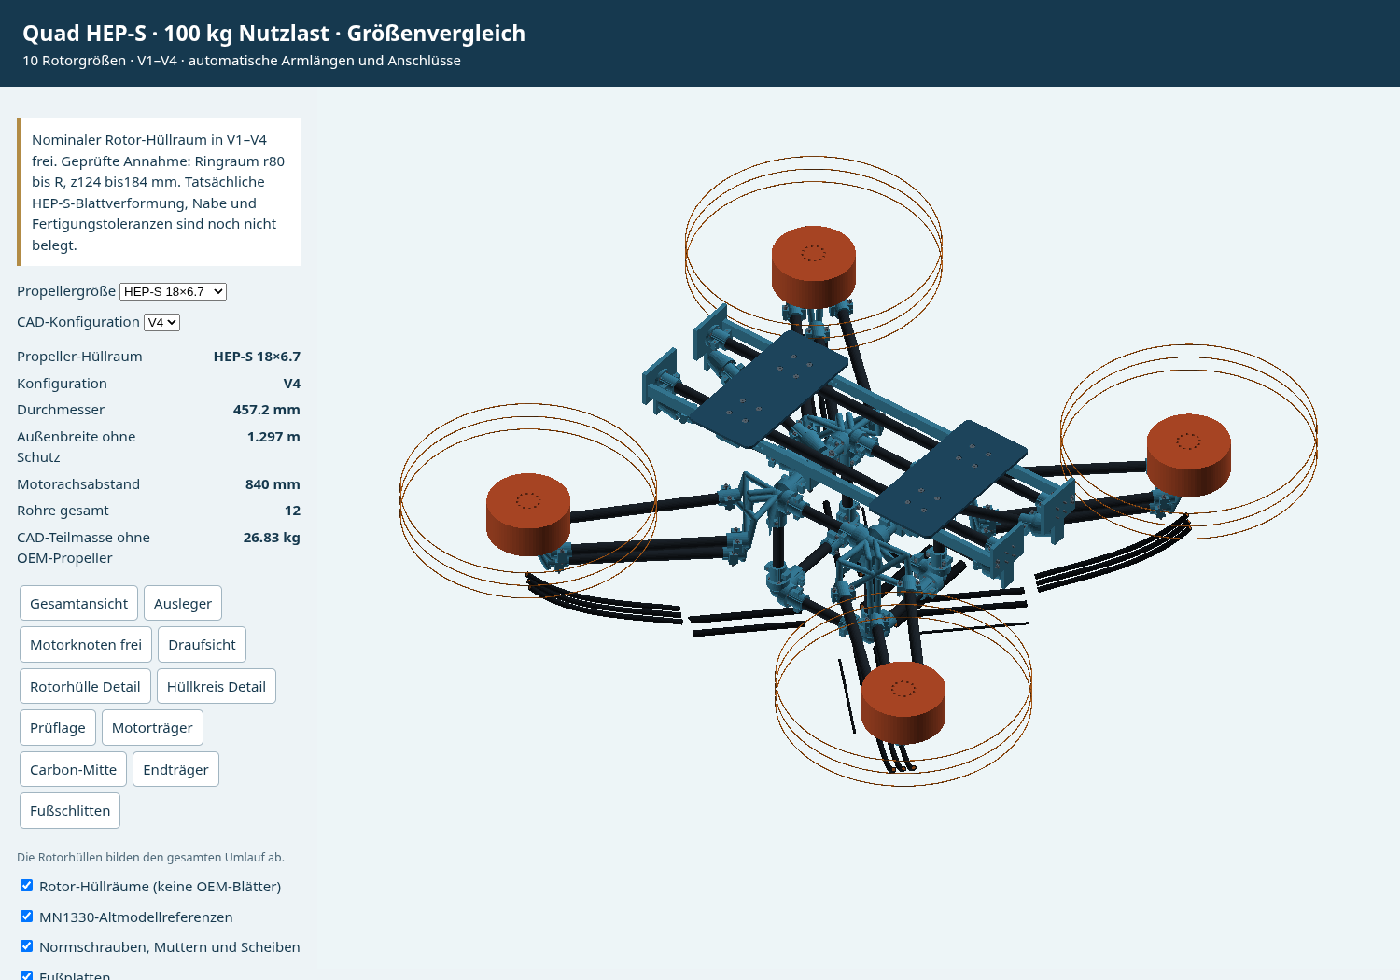
quad_r380_d09/Ausgabe/HEPS_18_V4.png
