ITSMEEME/PropBoard/quad_r380_d09/Ausgabe/HEPS_42_V4_Motorknoten.png

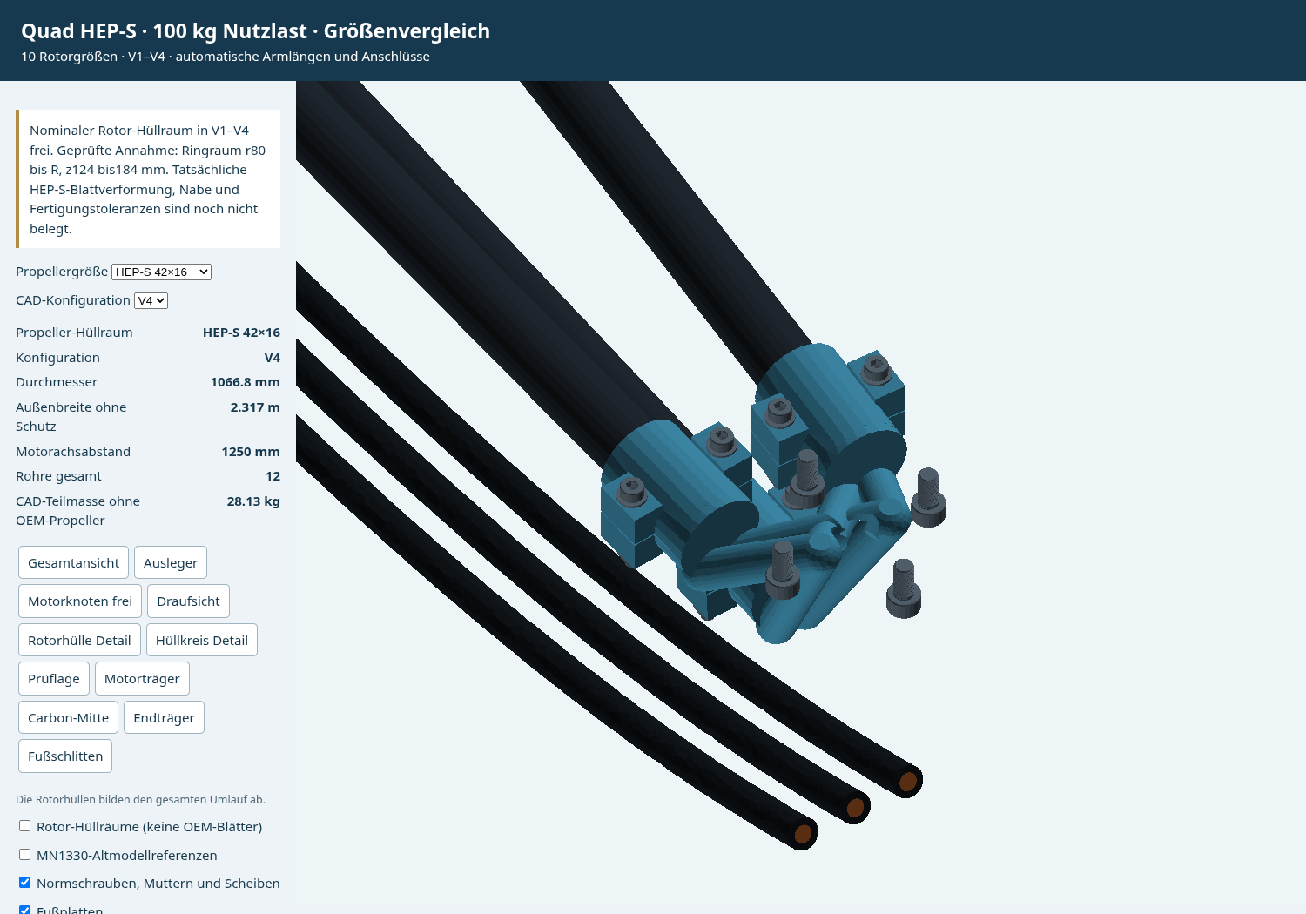
quad_r380_d09/Ausgabe/HEPS_42_V4_Motorknoten.png
