ITSMEEME/PropBoard/quad_r380_d09/Ausgabe/Propeller_Struktur_Vergleich.png

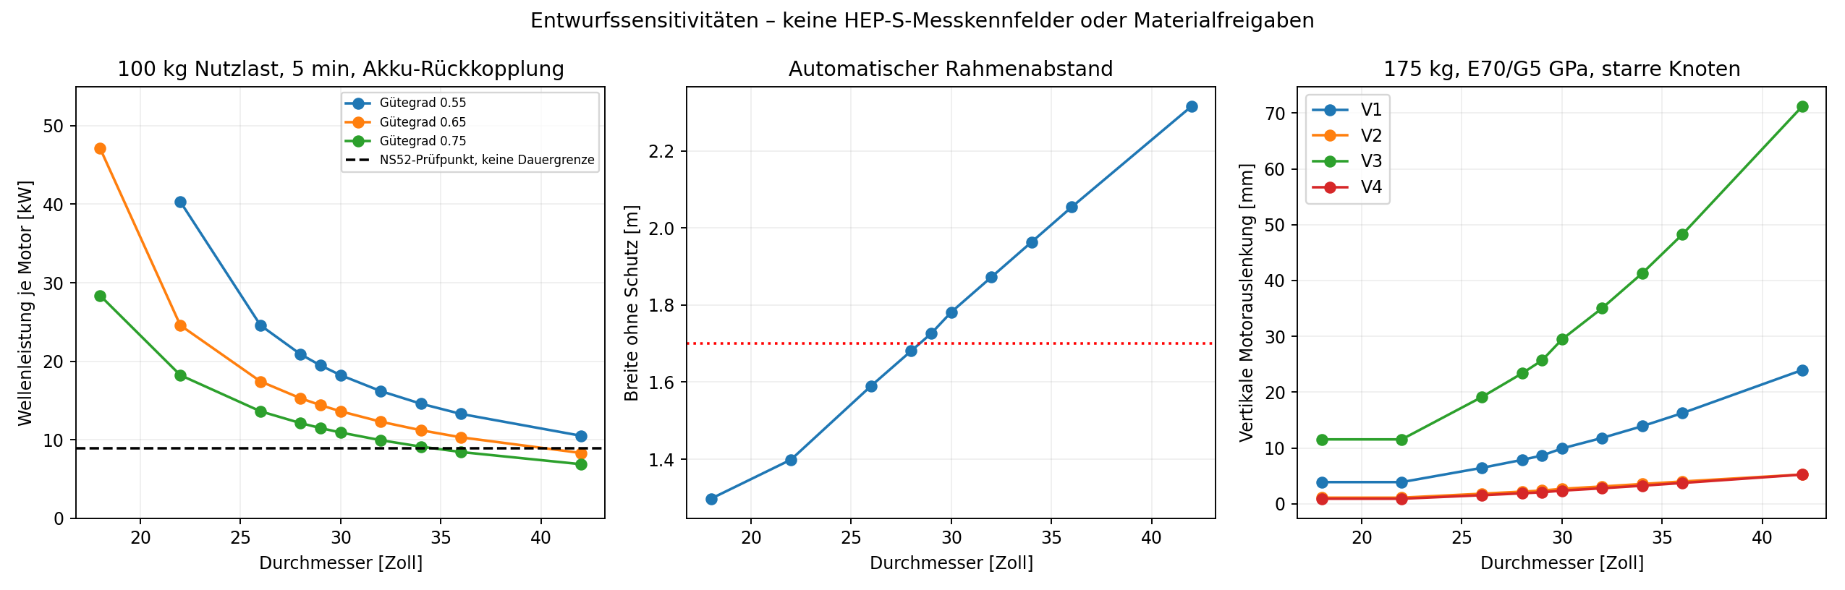
quad_r380_d09/Ausgabe/Propeller_Struktur_Vergleich.png
