ITSMEEME/PropBoard/quad_r380_d10/Ausgabe/Materialreduzierung.png

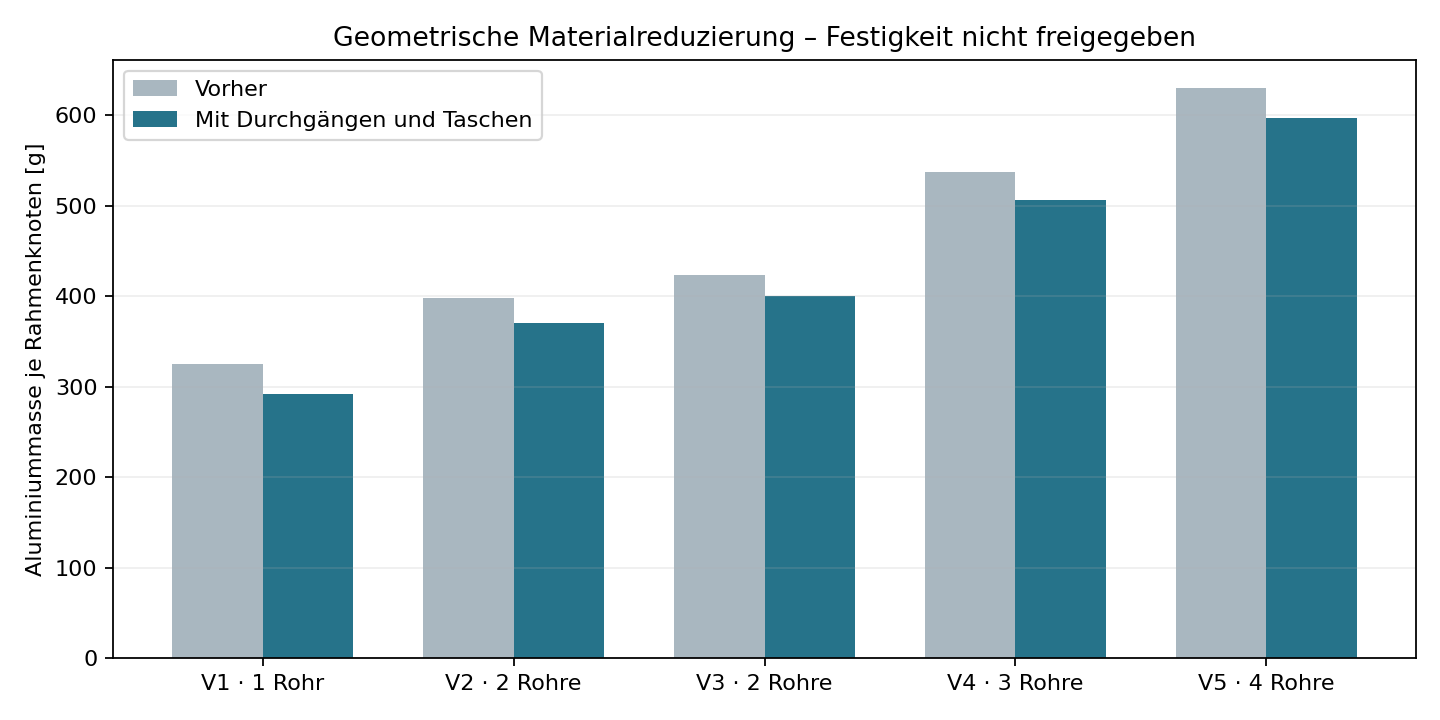
quad_r380_d10/Ausgabe/Materialreduzierung.png
