ITSMEEME/PropBoard/quad_r380_d11/Ausgabe/Reglerhalter_42_V4.png

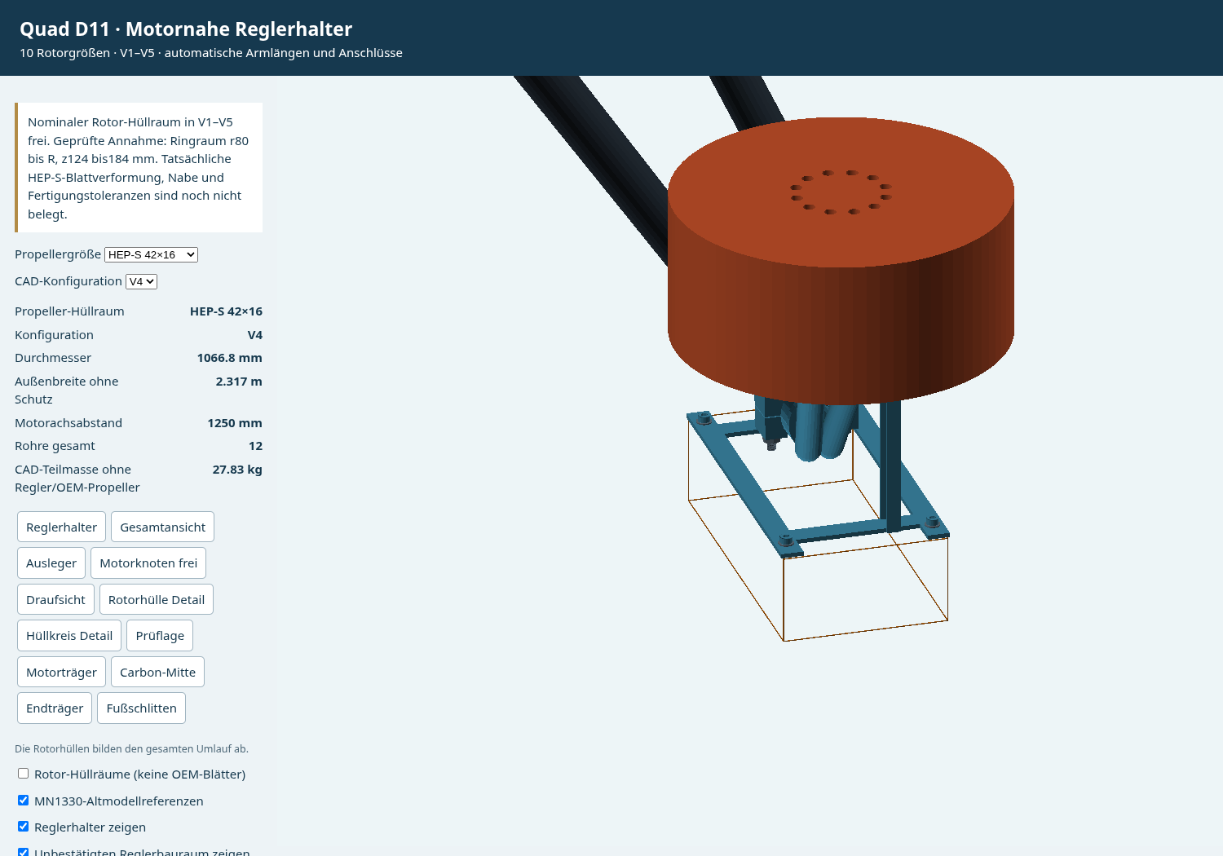
quad_r380_d11/Ausgabe/Reglerhalter_42_V4.png
