ITSMEEME/PropBoard/quad_r380_d12/Ausgabe/Innenverkabelung_V1.png

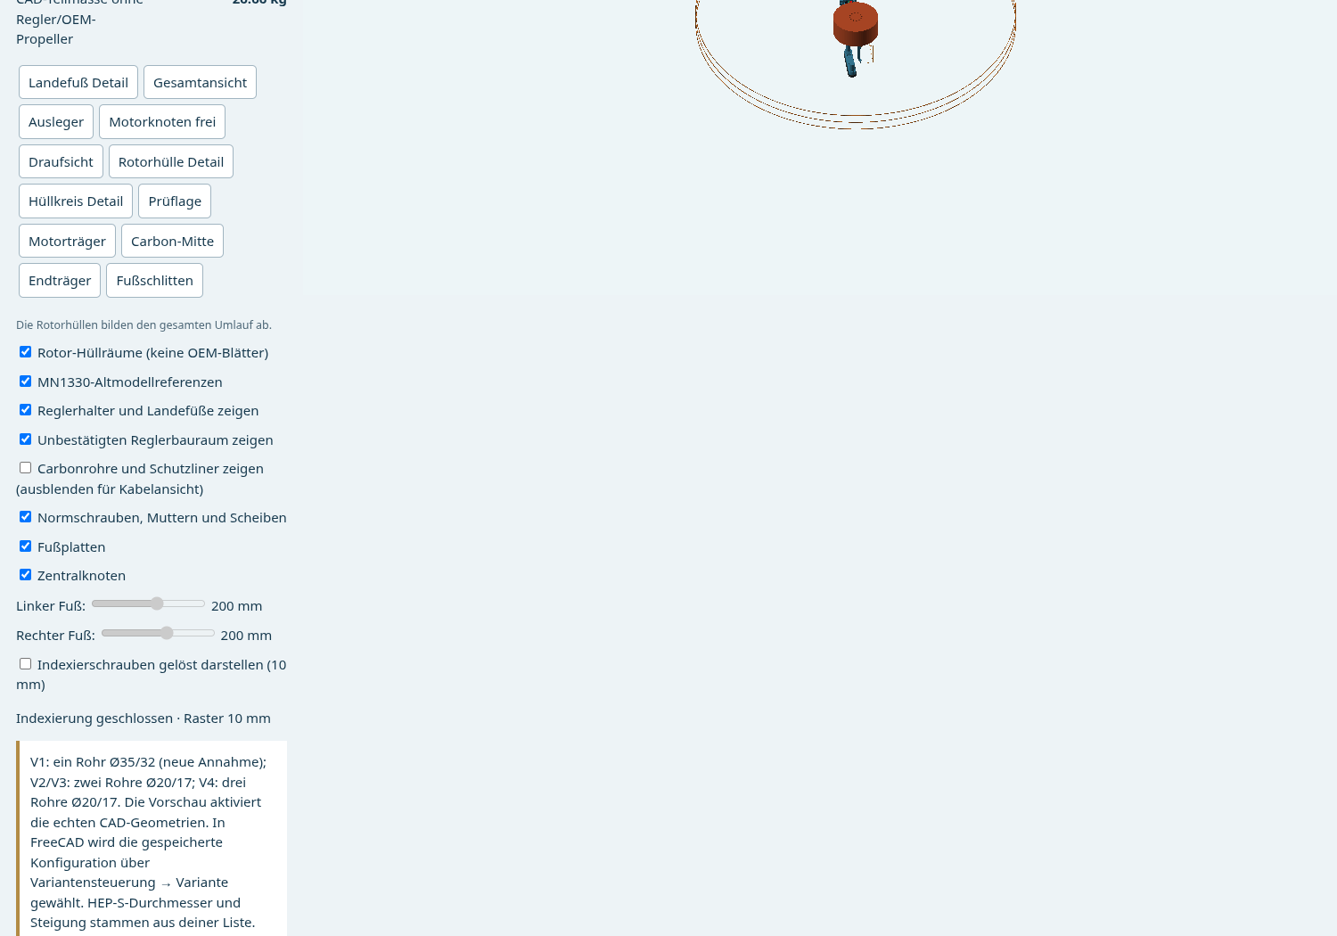
quad_r380_d12/Ausgabe/Innenverkabelung_V1.png
