ITSMEEME/PropBoard/quad_r380_d12/Ausgabe/Landefuss_42_V4.png

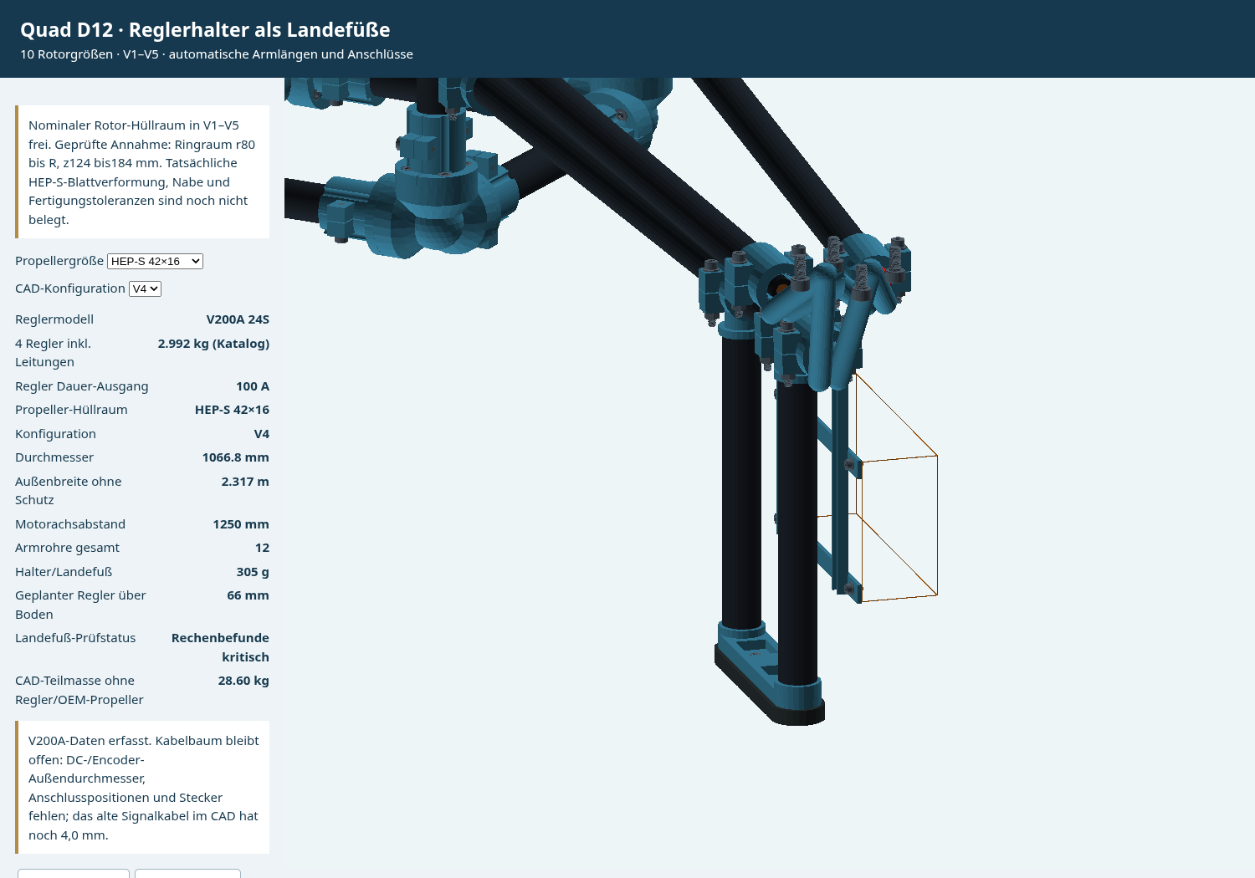
quad_r380_d12/Ausgabe/Landefuss_42_V4.png
