ITSMEEME/PropBoard/quad_r380_d12/Ausgabe/Landefuss_Detail.png

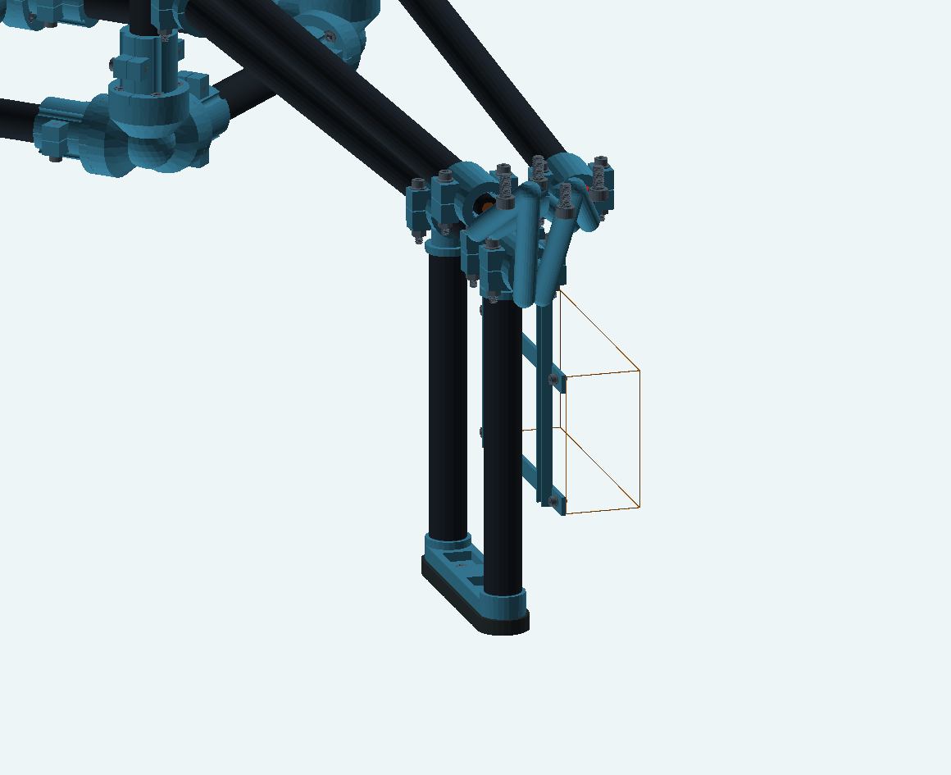
quad_r380_d12/Ausgabe/Landefuss_Detail.png
