ITSMEEME/PropBoard/quad_r380_d13/Ausgabe/HEPS_18_V5.png

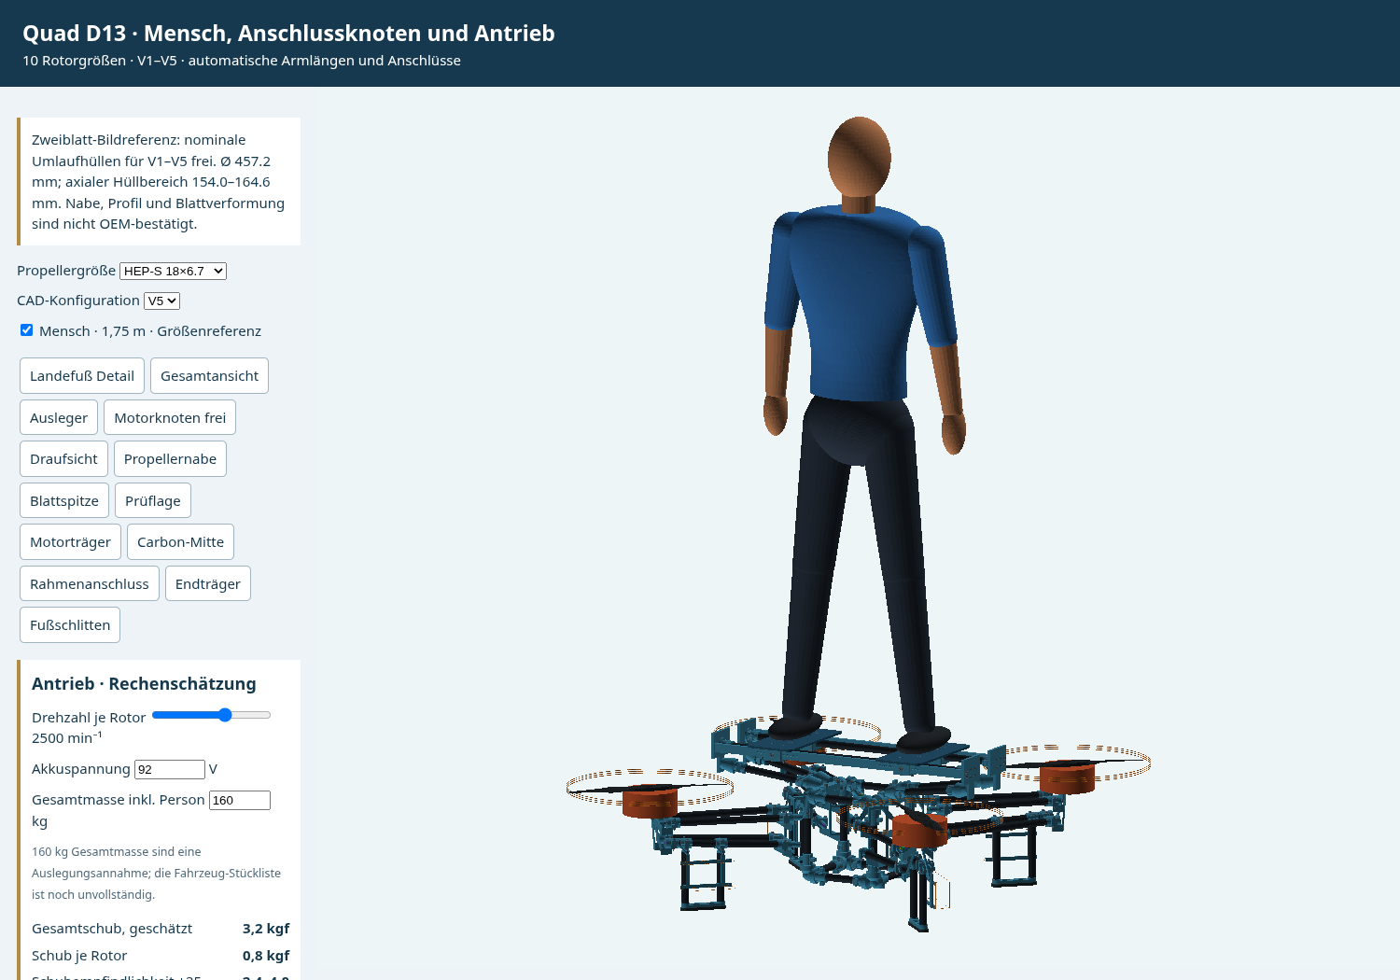
quad_r380_d13/Ausgabe/HEPS_18_V5.png
