ITSMEEME/PropBoard/quad_r380_d13/Ausgabe/Mobile_Ansicht.png

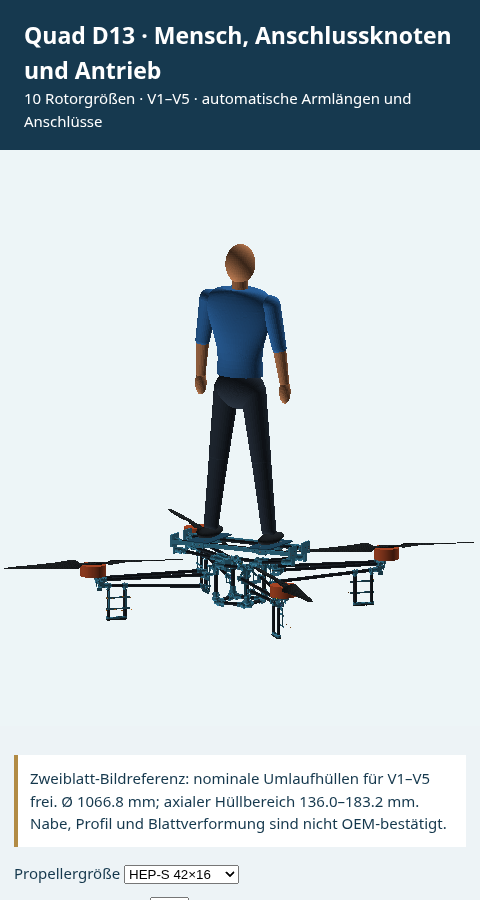
quad_r380_d13/Ausgabe/Mobile_Ansicht.png
