ITSMEEME/PropBoard/quad_r380_d13/Ausgabe/Motoranschluss_V4.png

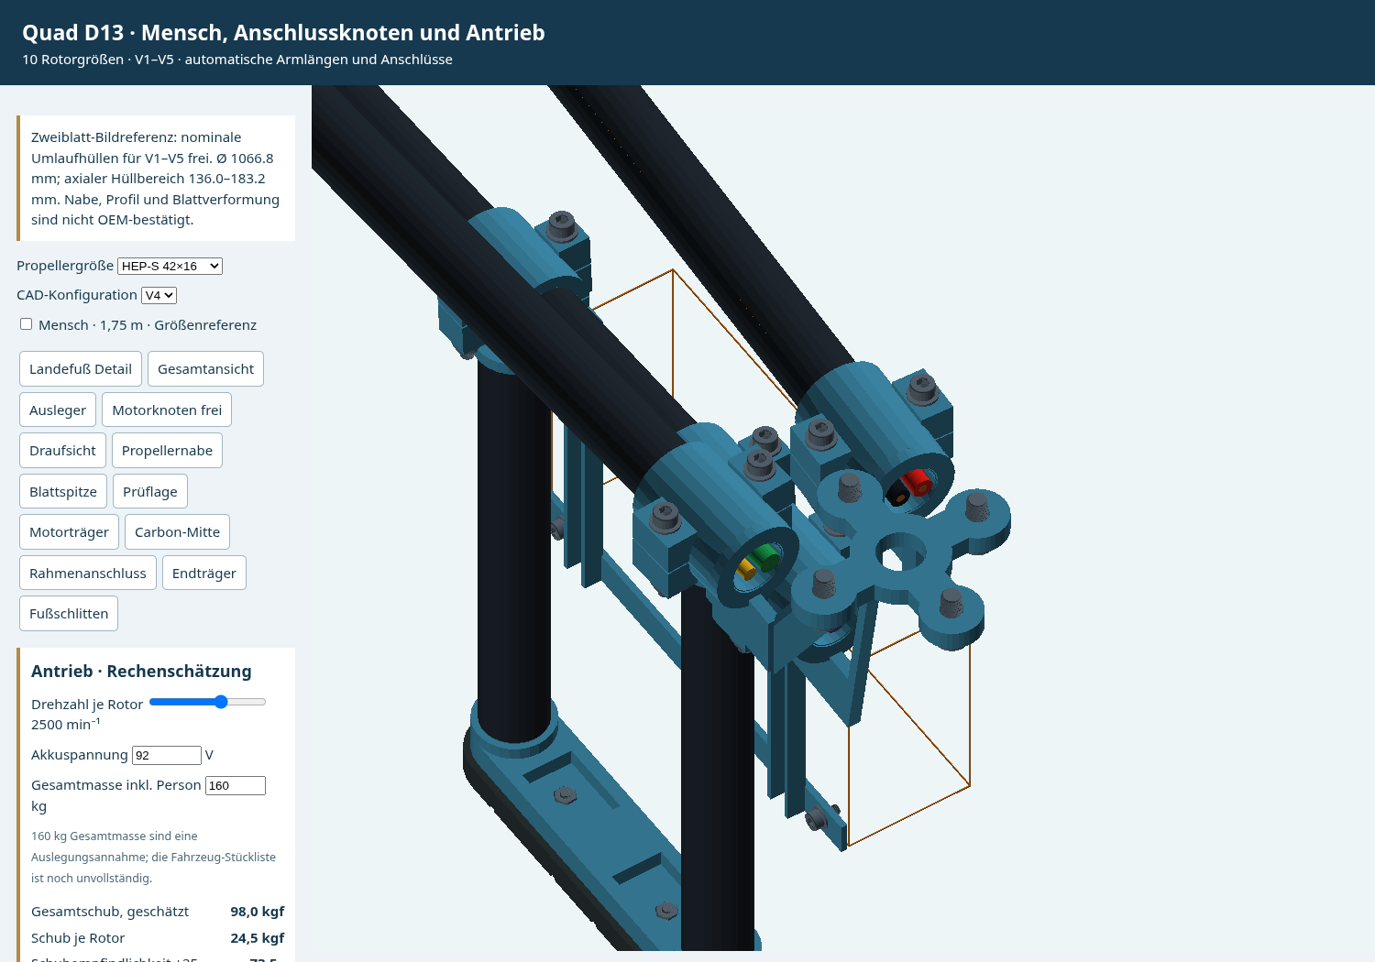
quad_r380_d13/Ausgabe/Motoranschluss_V4.png
