ITSMEEME/PropBoard/quad_r380_d13/Ausgabe/Propeller_18_Detail.png

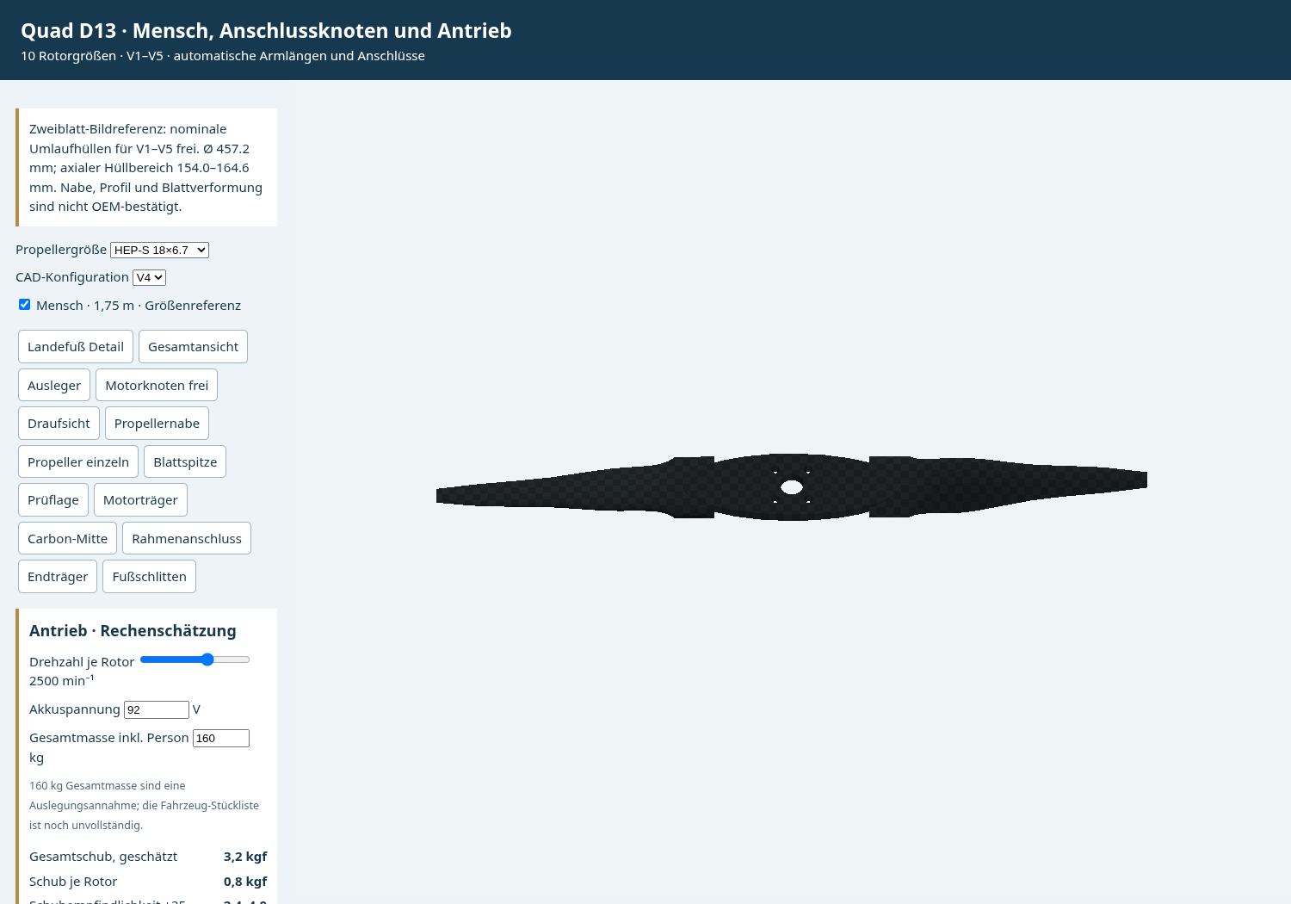
quad_r380_d13/Ausgabe/Propeller_18_Detail.png
