ITSMEEME/PropBoard/quad_r380_varianten/V1_Motorknoten.png

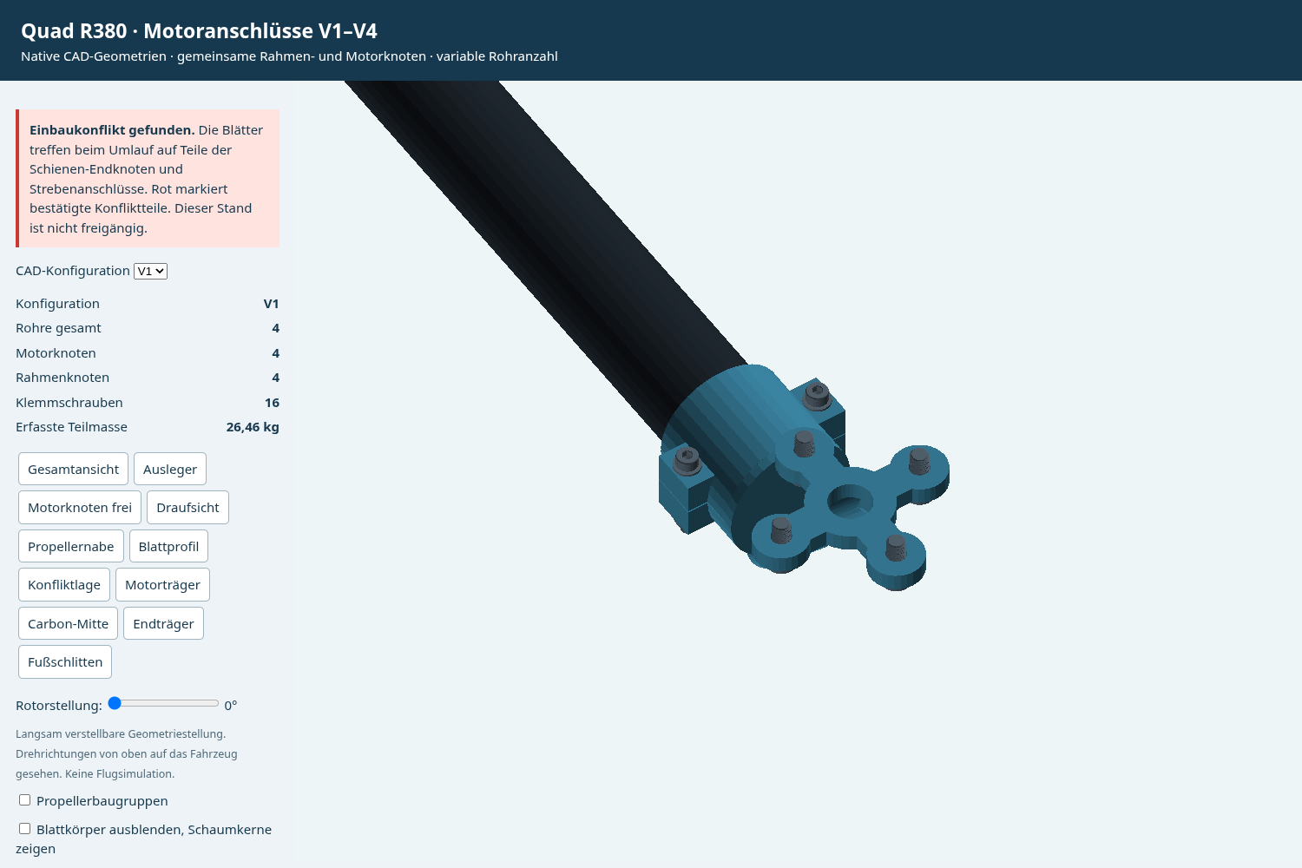
quad_r380_varianten/V1_Motorknoten.png
