ITSMEEME/PropBoard/tragfaehigkeit/Akku_Massenrueckkopplung.png

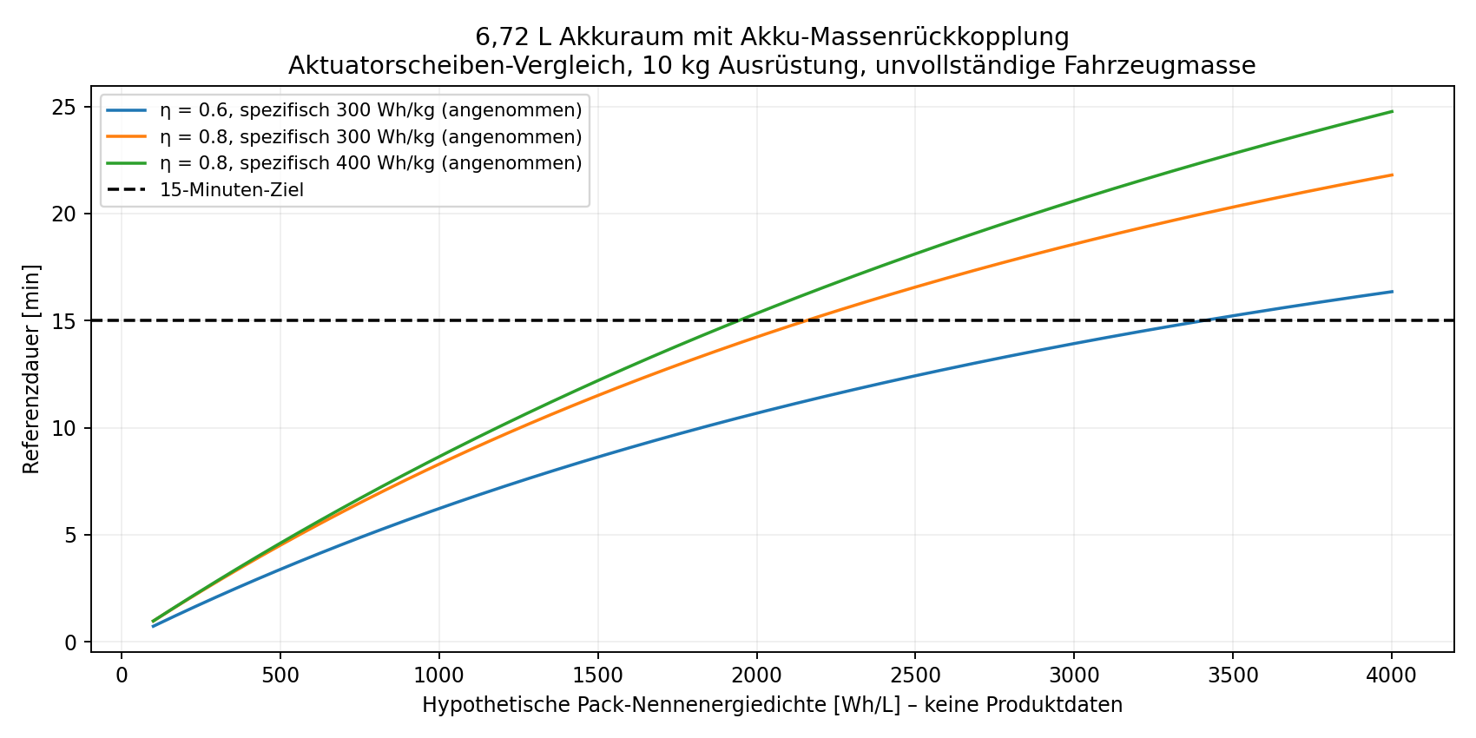
tragfaehigkeit/Akku_Massenrueckkopplung.png
