ITSMEEME/PropBoard/tragfaehigkeit/Auftrieb_und_Umlenkung.png

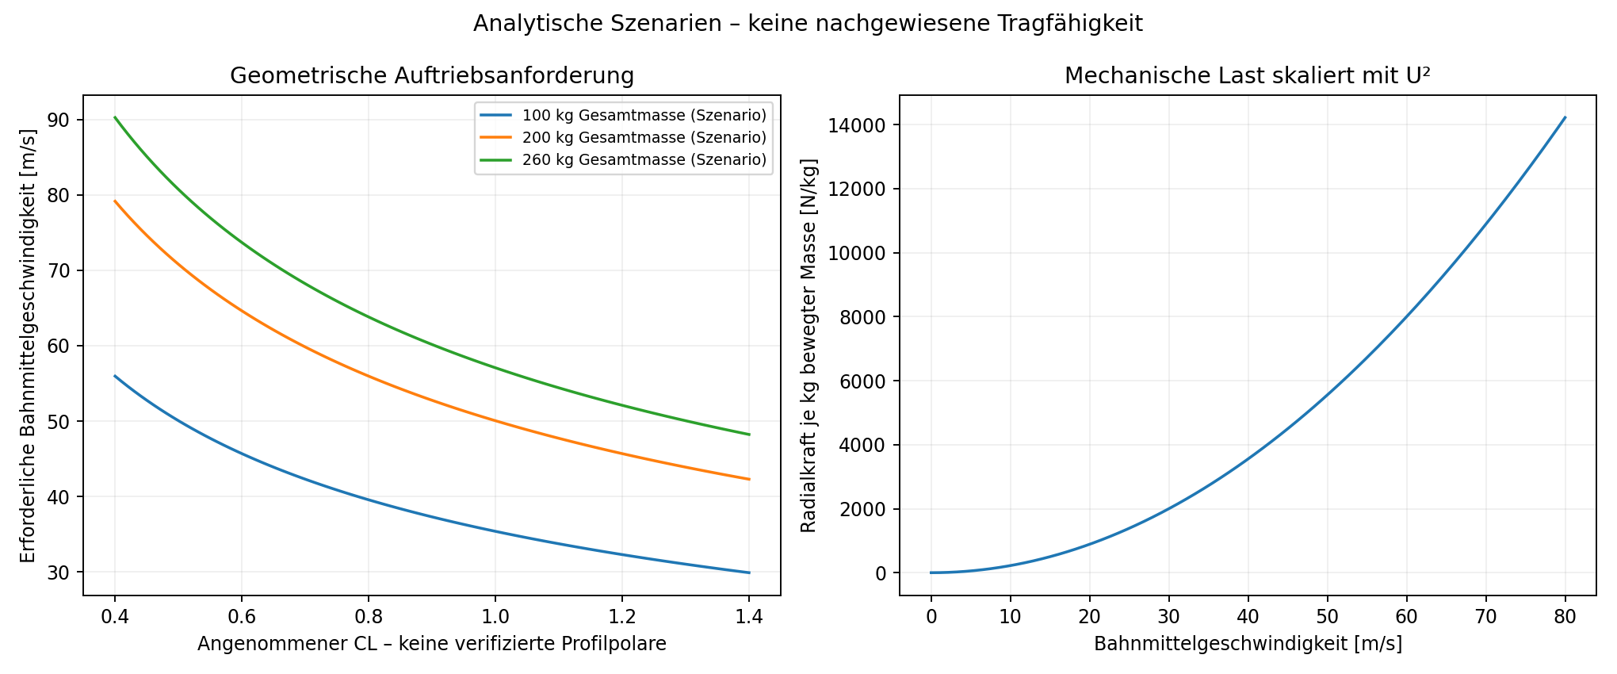
tragfaehigkeit/Auftrieb_und_Umlenkung.png
