ITSMEEME/PropBoard/konstruktion/Stueckliste_Hauptbaugruppe_Familien.csv

ID_Familie | Material_Annahme | Referenz | Instanzanzahl | Freigabe
BAT-BUEGEL | Aluminium / Legierung und Zustand TBD | NEIN | 4 | VOR_ENTWURF_NICHT_BESTELLFERTIG
BAT-GLEIT | GFK/PEEK TBD | NEIN | 4 | VOR_ENTWURF_NICHT_BESTELLFERTIG
BAT-GUARD | GFK/FR4/Brandkonzept TBD | NEIN | 1 | VOR_ENTWURF_NICHT_BESTELLFERTIG
BAT-MOD-REF | Akkusystem unbestimmt | JA | 2 | VOR_ENTWURF_NICHT_BESTELLFERTIG
BAT-TRAY | Aluminium / Legierung und Zustand TBD | NEIN | 1 | VOR_ENTWURF_NICHT_BESTELLFERTIG
BOLT-REF | Schraubenauswahl TBD | JA | 24 | VOR_ENTWURF_NICHT_BESTELLFERTIG
CFK-L01 | CFK Rohr / Laminat TBD | NEIN | 2 | VOR_ENTWURF_NICHT_BESTELLFERTIG
CFK-Q01 | CFK Rohr / Laminat TBD | NEIN | 3 | VOR_ENTWURF_NICHT_BESTELLFERTIG
CFK-S01 | CFK Rohr / Laminat TBD | NEIN | 6 | VOR_ENTWURF_NICHT_BESTELLFERTIG
CFK-S02 | CFK Rohr / Laminat TBD | NEIN | 6 | VOR_ENTWURF_NICHT_BESTELLFERTIG
CTRL-MOB-REF | Elektronik TBD | JA | 32 | VOR_ENTWURF_NICHT_BESTELLFERTIG
DECK-01 | CFK Sandwich / Kern und Laminat TBD | NEIN | 1 | VOR_ENTWURF_NICHT_BESTELLFERTIG
DECK-SP01 | Isolierender Hartpunkt TBD | NEIN | 6 | VOR_ENTWURF_NICHT_BESTELLFERTIG
ENC-REF | Encoder TBD | JA | 16 | VOR_ENTWURF_NICHT_BESTELLFERTIG
ERG-ST-G01 | Elastomer TBD | NEIN | 2 | VOR_ENTWURF_NICHT_BESTELLFERTIG
ERG-ST-P01 | Aluminium / Legierung und Zustand TBD | NEIN | 2 | VOR_ENTWURF_NICHT_BESTELLFERTIG
FANG-REF | PEEK / Lager TBD | JA | 128 | VOR_ENTWURF_NICHT_BESTELLFERTIG
FL-CFK-REF | CFK Laminat TBD | NEIN | 16 | VOR_ENTWURF_NICHT_BESTELLFERTIG
FUEHR-C | Aluminium / Zustand TBD | NEIN | 4 | VOR_ENTWURF_NICHT_BESTELLFERTIG
FUEHR-F | Aluminium / Zustand TBD | NEIN | 8 | VOR_ENTWURF_NICHT_BESTELLFERTIG
FUEHR-L01 | Aluminium / Legierung und Zustand TBD | NEIN | 12 | VOR_ENTWURF_NICHT_BESTELLFERTIG
FUEHR-L02 | Aluminium / Legierung und Zustand TBD | NEIN | 12 | VOR_ENTWURF_NICHT_BESTELLFERTIG
FUSS-01 | Elastomer TBD | NEIN | 6 | VOR_ENTWURF_NICHT_BESTELLFERTIG
HEAD-REF | Schraubenauswahl TBD | JA | 24 | VOR_ENTWURF_NICHT_BESTELLFERTIG
HV-BOX-REF | Isolierendes Gehaeuse TBD | JA | 1 | VOR_ENTWURF_NICHT_BESTELLFERTIG
HV-CABLE-REF | Kabeltyp/Aderquerschnitt TBD | JA | 2 | VOR_ENTWURF_NICHT_BESTELLFERTIG
IPT-PRI-REF | Induktivsystem TBD | NEIN | 4 | VOR_ENTWURF_NICHT_BESTELLFERTIG
IPT-SEC-REF | Sekundaerwicklung TBD | JA | 32 | VOR_ENTWURF_NICHT_BESTELLFERTIG
ISO-01 | GFK/FR4 TBD | NEIN | 18 | VOR_ENTWURF_NICHT_BESTELLFERTIG
KABEL-CLIP | Isolierwerkstoff TBD | NEIN | 6 | VOR_ENTWURF_NICHT_BESTELLFERTIG
KNOTEN-P01 | Aluminium / Legierung und Zustand TBD | NEIN | 12 | VOR_ENTWURF_NICHT_BESTELLFERTIG
KNOTEN-REF | Metall + Isolierlagen TBD | JA | 6 | VOR_ENTWURF_NICHT_BESTELLFERTIG
LAGER-G01 | Aluminium TBD | NEIN | 32 | VOR_ENTWURF_NICHT_BESTELLFERTIG
LAGER-REF | Katalogauswahl offen | JA | 32 | VOR_ENTWURF_NICHT_BESTELLFERTIG
LM-MAG-REF | Permanentmagnet / Guete TBD | JA | 64 | VOR_ENTWURF_NICHT_BESTELLFERTIG
LM-STATOR-REF | Wicklungsbauraum, KEIN Vollkupferteil | NEIN | 4 | VOR_ENTWURF_NICHT_BESTELLFERTIG
LV-CABLE-REF | Daten-/Versorgungstyp TBD | JA | 2 | VOR_ENTWURF_NICHT_BESTELLFERTIG
MAG-AKT-REF | Aktives Magnetlager TBD | JA | 64 | VOR_ENTWURF_NICHT_BESTELLFERTIG
MAG-JOCH | Elektroblech / Paket TBD | NEIN | 4 | VOR_ENTWURF_NICHT_BESTELLFERTIG
PILOT-REF | Menschliche Referenzhuelle | JA | 9 | VOR_ENTWURF_NICHT_BESTELLFERTIG
PITCH-G01 | Aluminium / Zustand TBD | NEIN | 32 | VOR_ENTWURF_NICHT_BESTELLFERTIG
PITCH-MOT-REF | Direktantrieb TBD | JA | 16 | VOR_ENTWURF_NICHT_BESTELLFERTIG
PITCH-W01 | Wellenwerkstoff TBD | NEIN | 16 | VOR_ENTWURF_NICHT_BESTELLFERTIG
SCHL-01 | Aluminium / Zustand TBD | NEIN | 32 | VOR_ENTWURF_NICHT_BESTELLFERTIG
STATOR-JB-REF | Elektronik/Isolation TBD | JA | 2 | VOR_ENTWURF_NICHT_BESTELLFERTIG
