ITSMEEME/PropBoard/konstruktion/Stueckliste_Instanzen.csv

Datei | Instanz | ID | Material_Annahme | Prozess | Referenz | Volumen_mm3 | Bemerkung | Freigabe
01_CFK_Rahmen.FCStd | Laengsrohr_0 | CFK-L01 | CFK Rohr / Laminat TBD | Zuschnitt; Enden/Lastanschluesse gesondert auslegen | NEIN | 532800.0 | Wand 3 mm nur Geometrieannahme. Keine Faserfolge, Festigkeit oder Klebfuge nachgewiesen. | VOR_ENTWURF
01_CFK_Rahmen.FCStd | Laengsrohr_200 | CFK-L01 | CFK Rohr / Laminat TBD | Zuschnitt; Enden/Lastanschluesse gesondert auslegen | NEIN | 532800.0 | Wand 3 mm nur Geometrieannahme. Keine Faserfolge, Festigkeit oder Klebfuge nachgewiesen. | VOR_ENTWURF
01_CFK_Rahmen.FCStd | Quertraeger_0 | CFK-Q01 | CFK Rohr / Laminat TBD | Zuschnitt; Enden/Lastanschluesse gesondert auslegen | NEIN | 737040.0 | Wand 3 mm nur Geometrieannahme. Keine Faserfolge, Festigkeit oder Klebfuge nachgewiesen. | VOR_ENTWURF
01_CFK_Rahmen.FCStd | Aussenstuetze_0_0 | CFK-S01 | CFK Rohr / Laminat TBD | Zuschnitt; Klemm-/Knotenanschluss TBD | NEIN | 101787.602 | Keine Bohrung direkt in tragende CFK-Rohre vorgesehen | VOR_ENTWURF
01_CFK_Rahmen.FCStd | Fuss_Puffer | FUSS-01 | Elastomer TBD | Drehteil / Bauraum | NEIN | 45615.925 | Kein Aufprall-/Landefahrwerksnachweis | VOR_ENTWURF
01_CFK_Rahmen.FCStd | Aussenstuetze_0_1620 | CFK-S01 | CFK Rohr / Laminat TBD | Zuschnitt; Klemm-/Knotenanschluss TBD | NEIN | 101787.602 | Keine Bohrung direkt in tragende CFK-Rohre vorgesehen | VOR_ENTWURF
01_CFK_Rahmen.FCStd | Fuss_Puffer001 | FUSS-01 | Elastomer TBD | Drehteil / Bauraum | NEIN | 45615.925 | Kein Aufprall-/Landefahrwerksnachweis | VOR_ENTWURF
01_CFK_Rahmen.FCStd | Innenstuetze | CFK-S02 | CFK Rohr / Laminat TBD | Zuschnitt; Klemm-/Knotenanschluss TBD | NEIN | 49008.845 | Keine Bohrung direkt in tragende CFK-Rohre vorgesehen | VOR_ENTWURF
01_CFK_Rahmen.FCStd | Klemmplatte_Schnitt3 | KNOTEN-P01 | Aluminium / Legierung und Zustand TBD | Fraesen, Bohren, Entgraten | NEIN | 56505.218 | Bohrbild 64 x 52, D6.6 als Referenz. Schraubenvorspannung/Klemmdruck nicht ausgelegt. | VOR_ENTWURF
01_CFK_Rahmen.FCStd | Klemmplatte_Schnitt007 | KNOTEN-P01 | Aluminium / Legierung und Zustand TBD | Fraesen, Bohren, Entgraten | NEIN | 56505.218 | Bohrbild 64 x 52, D6.6 als Referenz. Schraubenvorspannung/Klemmdruck nicht ausgelegt. | VOR_ENTWURF
01_CFK_Rahmen.FCStd | Isolierlage_Knoten_Schnitt3 | ISO-01 | GFK/FR4 TBD | Fraesen, Bohren, Entgraten | NEIN | 7063.152 | Galvanische Trennung konzeptionell; Feuchte, Durchschlag, Kriechen nicht validiert | VOR_ENTWURF
01_CFK_Rahmen.FCStd | Isolierlage_Knoten_Schnitt007 | ISO-01 | GFK/FR4 TBD | Fraesen, Bohren, Entgraten | NEIN | 7063.152 | Galvanische Trennung konzeptionell; Feuchte, Durchschlag, Kriechen nicht validiert | VOR_ENTWURF
01_CFK_Rahmen.FCStd | Isolierlage_Knoten_Schnitt011 | ISO-01 | GFK/FR4 TBD | Fraesen, Bohren, Entgraten | NEIN | 7063.152 | Galvanische Trennung konzeptionell; Feuchte, Durchschlag, Kriechen nicht validiert | VOR_ENTWURF
01_CFK_Rahmen.FCStd | Schraubenschaft_REF | BOLT-REF | Schraubenauswahl TBD | Drehteil / Bauraum | JA | 1753.009 | Gewinde/Kopf/Vorspannung nicht ausgelegt | VOR_ENTWURF
01_CFK_Rahmen.FCStd | Schraubenkopf_REF | HEAD-REF | Schraubenauswahl TBD | Drehteil / Bauraum | JA | 314.159 |  | VOR_ENTWURF
01_CFK_Rahmen.FCStd | Schraubenschaft_REF001 | BOLT-REF | Schraubenauswahl TBD | Drehteil / Bauraum | JA | 1753.009 | Gewinde/Kopf/Vorspannung nicht ausgelegt | VOR_ENTWURF
01_CFK_Rahmen.FCStd | Schraubenkopf_REF001 | HEAD-REF | Schraubenauswahl TBD | Drehteil / Bauraum | JA | 314.159 |  | VOR_ENTWURF
01_CFK_Rahmen.FCStd | Schraubenschaft_REF002 | BOLT-REF | Schraubenauswahl TBD | Drehteil / Bauraum | JA | 1753.009 | Gewinde/Kopf/Vorspannung nicht ausgelegt | VOR_ENTWURF
01_CFK_Rahmen.FCStd | Schraubenkopf_REF002 | HEAD-REF | Schraubenauswahl TBD | Drehteil / Bauraum | JA | 314.159 |  | VOR_ENTWURF
01_CFK_Rahmen.FCStd | Schraubenschaft_REF003 | BOLT-REF | Schraubenauswahl TBD | Drehteil / Bauraum | JA | 1753.009 | Gewinde/Kopf/Vorspannung nicht ausgelegt | VOR_ENTWURF
01_CFK_Rahmen.FCStd | Schraubenkopf_REF003 | HEAD-REF | Schraubenauswahl TBD | Drehteil / Bauraum | JA | 314.159 |  | VOR_ENTWURF
01_CFK_Rahmen.FCStd | Deck_Distanz | DECK-SP01 | Isolierender Hartpunkt TBD | Drehteil / Bauraum | NEIN | 4071.504 | Druck-/Kernlast nicht nachgewiesen | VOR_ENTWURF
01_CFK_Rahmen.FCStd | Innenstuetze001 | CFK-S02 | CFK Rohr / Laminat TBD | Zuschnitt; Klemm-/Knotenanschluss TBD | NEIN | 49008.845 | Keine Bohrung direkt in tragende CFK-Rohre vorgesehen | VOR_ENTWURF
01_CFK_Rahmen.FCStd | Klemmplatte_Schnitt011 | KNOTEN-P01 | Aluminium / Legierung und Zustand TBD | Fraesen, Bohren, Entgraten | NEIN | 56505.218 | Bohrbild 64 x 52, D6.6 als Referenz. Schraubenvorspannung/Klemmdruck nicht ausgelegt. | VOR_ENTWURF
01_CFK_Rahmen.FCStd | Klemmplatte_Schnitt015 | KNOTEN-P01 | Aluminium / Legierung und Zustand TBD | Fraesen, Bohren, Entgraten | NEIN | 56505.218 | Bohrbild 64 x 52, D6.6 als Referenz. Schraubenvorspannung/Klemmdruck nicht ausgelegt. | VOR_ENTWURF
01_CFK_Rahmen.FCStd | Isolierlage_Knoten_Schnitt015 | ISO-01 | GFK/FR4 TBD | Fraesen, Bohren, Entgraten | NEIN | 7063.152 | Galvanische Trennung konzeptionell; Feuchte, Durchschlag, Kriechen nicht validiert | VOR_ENTWURF
01_CFK_Rahmen.FCStd | Isolierlage_Knoten_Schnitt019 | ISO-01 | GFK/FR4 TBD | Fraesen, Bohren, Entgraten | NEIN | 7063.152 | Galvanische Trennung konzeptionell; Feuchte, Durchschlag, Kriechen nicht validiert | VOR_ENTWURF
01_CFK_Rahmen.FCStd | Isolierlage_Knoten_Schnitt023 | ISO-01 | GFK/FR4 TBD | Fraesen, Bohren, Entgraten | NEIN | 7063.152 | Galvanische Trennung konzeptionell; Feuchte, Durchschlag, Kriechen nicht validiert | VOR_ENTWURF
01_CFK_Rahmen.FCStd | Schraubenschaft_REF004 | BOLT-REF | Schraubenauswahl TBD | Drehteil / Bauraum | JA | 1753.009 | Gewinde/Kopf/Vorspannung nicht ausgelegt | VOR_ENTWURF
01_CFK_Rahmen.FCStd | Schraubenkopf_REF004 | HEAD-REF | Schraubenauswahl TBD | Drehteil / Bauraum | JA | 314.159 |  | VOR_ENTWURF
01_CFK_Rahmen.FCStd | Schraubenschaft_REF005 | BOLT-REF | Schraubenauswahl TBD | Drehteil / Bauraum | JA | 1753.009 | Gewinde/Kopf/Vorspannung nicht ausgelegt | VOR_ENTWURF
01_CFK_Rahmen.FCStd | Schraubenkopf_REF005 | HEAD-REF | Schraubenauswahl TBD | Drehteil / Bauraum | JA | 314.159 |  | VOR_ENTWURF
01_CFK_Rahmen.FCStd | Schraubenschaft_REF006 | BOLT-REF | Schraubenauswahl TBD | Drehteil / Bauraum | JA | 1753.009 | Gewinde/Kopf/Vorspannung nicht ausgelegt | VOR_ENTWURF
01_CFK_Rahmen.FCStd | Schraubenkopf_REF006 | HEAD-REF | Schraubenauswahl TBD | Drehteil / Bauraum | JA | 314.159 |  | VOR_ENTWURF
01_CFK_Rahmen.FCStd | Schraubenschaft_REF007 | BOLT-REF | Schraubenauswahl TBD | Drehteil / Bauraum | JA | 1753.009 | Gewinde/Kopf/Vorspannung nicht ausgelegt | VOR_ENTWURF
01_CFK_Rahmen.FCStd | Schraubenkopf_REF007 | HEAD-REF | Schraubenauswahl TBD | Drehteil / Bauraum | JA | 314.159 |  | VOR_ENTWURF
01_CFK_Rahmen.FCStd | Deck_Distanz001 | DECK-SP01 | Isolierender Hartpunkt TBD | Drehteil / Bauraum | NEIN | 4071.504 | Druck-/Kernlast nicht nachgewiesen | VOR_ENTWURF
01_CFK_Rahmen.FCStd | Quertraeger_200 | CFK-Q01 | CFK Rohr / Laminat TBD | Zuschnitt; Enden/Lastanschluesse gesondert auslegen | NEIN | 737040.0 | Wand 3 mm nur Geometrieannahme. Keine Faserfolge, Festigkeit oder Klebfuge nachgewiesen. | VOR_ENTWURF
01_CFK_Rahmen.FCStd | Aussenstuetze_200_0 | CFK-S01 | CFK Rohr / Laminat TBD | Zuschnitt; Klemm-/Knotenanschluss TBD | NEIN | 101787.602 | Keine Bohrung direkt in tragende CFK-Rohre vorgesehen | VOR_ENTWURF
01_CFK_Rahmen.FCStd | Fuss_Puffer002 | FUSS-01 | Elastomer TBD | Drehteil / Bauraum | NEIN | 45615.925 | Kein Aufprall-/Landefahrwerksnachweis | VOR_ENTWURF
01_CFK_Rahmen.FCStd | Aussenstuetze_200_1620 | CFK-S01 | CFK Rohr / Laminat TBD | Zuschnitt; Klemm-/Knotenanschluss TBD | NEIN | 101787.602 | Keine Bohrung direkt in tragende CFK-Rohre vorgesehen | VOR_ENTWURF
01_CFK_Rahmen.FCStd | Fuss_Puffer003 | FUSS-01 | Elastomer TBD | Drehteil / Bauraum | NEIN | 45615.925 | Kein Aufprall-/Landefahrwerksnachweis | VOR_ENTWURF
01_CFK_Rahmen.FCStd | Innenstuetze002 | CFK-S02 | CFK Rohr / Laminat TBD | Zuschnitt; Klemm-/Knotenanschluss TBD | NEIN | 49008.845 | Keine Bohrung direkt in tragende CFK-Rohre vorgesehen | VOR_ENTWURF
01_CFK_Rahmen.FCStd | Klemmplatte_Schnitt019 | KNOTEN-P01 | Aluminium / Legierung und Zustand TBD | Fraesen, Bohren, Entgraten | NEIN | 56505.218 | Bohrbild 64 x 52, D6.6 als Referenz. Schraubenvorspannung/Klemmdruck nicht ausgelegt. | VOR_ENTWURF
01_CFK_Rahmen.FCStd | Klemmplatte_Schnitt023 | KNOTEN-P01 | Aluminium / Legierung und Zustand TBD | Fraesen, Bohren, Entgraten | NEIN | 56505.218 | Bohrbild 64 x 52, D6.6 als Referenz. Schraubenvorspannung/Klemmdruck nicht ausgelegt. | VOR_ENTWURF
01_CFK_Rahmen.FCStd | Isolierlage_Knoten_Schnitt027 | ISO-01 | GFK/FR4 TBD | Fraesen, Bohren, Entgraten | NEIN | 7063.152 | Galvanische Trennung konzeptionell; Feuchte, Durchschlag, Kriechen nicht validiert | VOR_ENTWURF
01_CFK_Rahmen.FCStd | Isolierlage_Knoten_Schnitt031 | ISO-01 | GFK/FR4 TBD | Fraesen, Bohren, Entgraten | NEIN | 7063.152 | Galvanische Trennung konzeptionell; Feuchte, Durchschlag, Kriechen nicht validiert | VOR_ENTWURF
01_CFK_Rahmen.FCStd | Isolierlage_Knoten_Schnitt035 | ISO-01 | GFK/FR4 TBD | Fraesen, Bohren, Entgraten | NEIN | 7063.152 | Galvanische Trennung konzeptionell; Feuchte, Durchschlag, Kriechen nicht validiert | VOR_ENTWURF
01_CFK_Rahmen.FCStd | Schraubenschaft_REF008 | BOLT-REF | Schraubenauswahl TBD | Drehteil / Bauraum | JA | 1753.009 | Gewinde/Kopf/Vorspannung nicht ausgelegt | VOR_ENTWURF
01_CFK_Rahmen.FCStd | Schraubenkopf_REF008 | HEAD-REF | Schraubenauswahl TBD | Drehteil / Bauraum | JA | 314.159 |  | VOR_ENTWURF
01_CFK_Rahmen.FCStd | Schraubenschaft_REF009 | BOLT-REF | Schraubenauswahl TBD | Drehteil / Bauraum | JA | 1753.009 | Gewinde/Kopf/Vorspannung nicht ausgelegt | VOR_ENTWURF
01_CFK_Rahmen.FCStd | Schraubenkopf_REF009 | HEAD-REF | Schraubenauswahl TBD | Drehteil / Bauraum | JA | 314.159 |  | VOR_ENTWURF
01_CFK_Rahmen.FCStd | Schraubenschaft_REF010 | BOLT-REF | Schraubenauswahl TBD | Drehteil / Bauraum | JA | 1753.009 | Gewinde/Kopf/Vorspannung nicht ausgelegt | VOR_ENTWURF
01_CFK_Rahmen.FCStd | Schraubenkopf_REF010 | HEAD-REF | Schraubenauswahl TBD | Drehteil / Bauraum | JA | 314.159 |  | VOR_ENTWURF
01_CFK_Rahmen.FCStd | Schraubenschaft_REF011 | BOLT-REF | Schraubenauswahl TBD | Drehteil / Bauraum | JA | 1753.009 | Gewinde/Kopf/Vorspannung nicht ausgelegt | VOR_ENTWURF
01_CFK_Rahmen.FCStd | Schraubenkopf_REF011 | HEAD-REF | Schraubenauswahl TBD | Drehteil / Bauraum | JA | 314.159 |  | VOR_ENTWURF
01_CFK_Rahmen.FCStd | Deck_Distanz002 | DECK-SP01 | Isolierender Hartpunkt TBD | Drehteil / Bauraum | NEIN | 4071.504 | Druck-/Kernlast nicht nachgewiesen | VOR_ENTWURF
01_CFK_Rahmen.FCStd | Innenstuetze003 | CFK-S02 | CFK Rohr / Laminat TBD | Zuschnitt; Klemm-/Knotenanschluss TBD | NEIN | 49008.845 | Keine Bohrung direkt in tragende CFK-Rohre vorgesehen | VOR_ENTWURF
01_CFK_Rahmen.FCStd | Klemmplatte_Schnitt027 | KNOTEN-P01 | Aluminium / Legierung und Zustand TBD | Fraesen, Bohren, Entgraten | NEIN | 56505.218 | Bohrbild 64 x 52, D6.6 als Referenz. Schraubenvorspannung/Klemmdruck nicht ausgelegt. | VOR_ENTWURF
01_CFK_Rahmen.FCStd | Klemmplatte_Schnitt031 | KNOTEN-P01 | Aluminium / Legierung und Zustand TBD | Fraesen, Bohren, Entgraten | NEIN | 56505.218 | Bohrbild 64 x 52, D6.6 als Referenz. Schraubenvorspannung/Klemmdruck nicht ausgelegt. | VOR_ENTWURF
01_CFK_Rahmen.FCStd | Isolierlage_Knoten_Schnitt039 | ISO-01 | GFK/FR4 TBD | Fraesen, Bohren, Entgraten | NEIN | 7063.152 | Galvanische Trennung konzeptionell; Feuchte, Durchschlag, Kriechen nicht validiert | VOR_ENTWURF
01_CFK_Rahmen.FCStd | Isolierlage_Knoten_Schnitt043 | ISO-01 | GFK/FR4 TBD | Fraesen, Bohren, Entgraten | NEIN | 7063.152 | Galvanische Trennung konzeptionell; Feuchte, Durchschlag, Kriechen nicht validiert | VOR_ENTWURF
01_CFK_Rahmen.FCStd | Isolierlage_Knoten_Schnitt047 | ISO-01 | GFK/FR4 TBD | Fraesen, Bohren, Entgraten | NEIN | 7063.152 | Galvanische Trennung konzeptionell; Feuchte, Durchschlag, Kriechen nicht validiert | VOR_ENTWURF
01_CFK_Rahmen.FCStd | Schraubenschaft_REF012 | BOLT-REF | Schraubenauswahl TBD | Drehteil / Bauraum | JA | 1753.009 | Gewinde/Kopf/Vorspannung nicht ausgelegt | VOR_ENTWURF
01_CFK_Rahmen.FCStd | Schraubenkopf_REF012 | HEAD-REF | Schraubenauswahl TBD | Drehteil / Bauraum | JA | 314.159 |  | VOR_ENTWURF
01_CFK_Rahmen.FCStd | Schraubenschaft_REF013 | BOLT-REF | Schraubenauswahl TBD | Drehteil / Bauraum | JA | 1753.009 | Gewinde/Kopf/Vorspannung nicht ausgelegt | VOR_ENTWURF
01_CFK_Rahmen.FCStd | Schraubenkopf_REF013 | HEAD-REF | Schraubenauswahl TBD | Drehteil / Bauraum | JA | 314.159 |  | VOR_ENTWURF
01_CFK_Rahmen.FCStd | Schraubenschaft_REF014 | BOLT-REF | Schraubenauswahl TBD | Drehteil / Bauraum | JA | 1753.009 | Gewinde/Kopf/Vorspannung nicht ausgelegt | VOR_ENTWURF
01_CFK_Rahmen.FCStd | Schraubenkopf_REF014 | HEAD-REF | Schraubenauswahl TBD | Drehteil / Bauraum | JA | 314.159 |  | VOR_ENTWURF
01_CFK_Rahmen.FCStd | Schraubenschaft_REF015 | BOLT-REF | Schraubenauswahl TBD | Drehteil / Bauraum | JA | 1753.009 | Gewinde/Kopf/Vorspannung nicht ausgelegt | VOR_ENTWURF
01_CFK_Rahmen.FCStd | Schraubenkopf_REF015 | HEAD-REF | Schraubenauswahl TBD | Drehteil / Bauraum | JA | 314.159 |  | VOR_ENTWURF
01_CFK_Rahmen.FCStd | Deck_Distanz003 | DECK-SP01 | Isolierender Hartpunkt TBD | Drehteil / Bauraum | NEIN | 4071.504 | Druck-/Kernlast nicht nachgewiesen | VOR_ENTWURF
01_CFK_Rahmen.FCStd | Quertraeger_400 | CFK-Q01 | CFK Rohr / Laminat TBD | Zuschnitt; Enden/Lastanschluesse gesondert auslegen | NEIN | 737040.0 | Wand 3 mm nur Geometrieannahme. Keine Faserfolge, Festigkeit oder Klebfuge nachgewiesen. | VOR_ENTWURF
01_CFK_Rahmen.FCStd | Aussenstuetze_400_0 | CFK-S01 | CFK Rohr / Laminat TBD | Zuschnitt; Klemm-/Knotenanschluss TBD | NEIN | 101787.602 | Keine Bohrung direkt in tragende CFK-Rohre vorgesehen | VOR_ENTWURF
01_CFK_Rahmen.FCStd | Fuss_Puffer004 | FUSS-01 | Elastomer TBD | Drehteil / Bauraum | NEIN | 45615.925 | Kein Aufprall-/Landefahrwerksnachweis | VOR_ENTWURF
01_CFK_Rahmen.FCStd | Aussenstuetze_400_1620 | CFK-S01 | CFK Rohr / Laminat TBD | Zuschnitt; Klemm-/Knotenanschluss TBD | NEIN | 101787.602 | Keine Bohrung direkt in tragende CFK-Rohre vorgesehen | VOR_ENTWURF
01_CFK_Rahmen.FCStd | Fuss_Puffer005 | FUSS-01 | Elastomer TBD | Drehteil / Bauraum | NEIN | 45615.925 | Kein Aufprall-/Landefahrwerksnachweis | VOR_ENTWURF
01_CFK_Rahmen.FCStd | Innenstuetze004 | CFK-S02 | CFK Rohr / Laminat TBD | Zuschnitt; Klemm-/Knotenanschluss TBD | NEIN | 49008.845 | Keine Bohrung direkt in tragende CFK-Rohre vorgesehen | VOR_ENTWURF
01_CFK_Rahmen.FCStd | Klemmplatte_Schnitt035 | KNOTEN-P01 | Aluminium / Legierung und Zustand TBD | Fraesen, Bohren, Entgraten | NEIN | 56505.218 | Bohrbild 64 x 52, D6.6 als Referenz. Schraubenvorspannung/Klemmdruck nicht ausgelegt. | VOR_ENTWURF
01_CFK_Rahmen.FCStd | Klemmplatte_Schnitt039 | KNOTEN-P01 | Aluminium / Legierung und Zustand TBD | Fraesen, Bohren, Entgraten | NEIN | 56505.218 | Bohrbild 64 x 52, D6.6 als Referenz. Schraubenvorspannung/Klemmdruck nicht ausgelegt. | VOR_ENTWURF
01_CFK_Rahmen.FCStd | Isolierlage_Knoten_Schnitt051 | ISO-01 | GFK/FR4 TBD | Fraesen, Bohren, Entgraten | NEIN | 7063.152 | Galvanische Trennung konzeptionell; Feuchte, Durchschlag, Kriechen nicht validiert | VOR_ENTWURF
01_CFK_Rahmen.FCStd | Isolierlage_Knoten_Schnitt055 | ISO-01 | GFK/FR4 TBD | Fraesen, Bohren, Entgraten | NEIN | 7063.152 | Galvanische Trennung konzeptionell; Feuchte, Durchschlag, Kriechen nicht validiert | VOR_ENTWURF
01_CFK_Rahmen.FCStd | Isolierlage_Knoten_Schnitt059 | ISO-01 | GFK/FR4 TBD | Fraesen, Bohren, Entgraten | NEIN | 7063.152 | Galvanische Trennung konzeptionell; Feuchte, Durchschlag, Kriechen nicht validiert | VOR_ENTWURF
01_CFK_Rahmen.FCStd | Schraubenschaft_REF016 | BOLT-REF | Schraubenauswahl TBD | Drehteil / Bauraum | JA | 1753.009 | Gewinde/Kopf/Vorspannung nicht ausgelegt | VOR_ENTWURF
01_CFK_Rahmen.FCStd | Schraubenkopf_REF016 | HEAD-REF | Schraubenauswahl TBD | Drehteil / Bauraum | JA | 314.159 |  | VOR_ENTWURF
01_CFK_Rahmen.FCStd | Schraubenschaft_REF017 | BOLT-REF | Schraubenauswahl TBD | Drehteil / Bauraum | JA | 1753.009 | Gewinde/Kopf/Vorspannung nicht ausgelegt | VOR_ENTWURF
01_CFK_Rahmen.FCStd | Schraubenkopf_REF017 | HEAD-REF | Schraubenauswahl TBD | Drehteil / Bauraum | JA | 314.159 |  | VOR_ENTWURF
01_CFK_Rahmen.FCStd | Schraubenschaft_REF018 | BOLT-REF | Schraubenauswahl TBD | Drehteil / Bauraum | JA | 1753.009 | Gewinde/Kopf/Vorspannung nicht ausgelegt | VOR_ENTWURF
01_CFK_Rahmen.FCStd | Schraubenkopf_REF018 | HEAD-REF | Schraubenauswahl TBD | Drehteil / Bauraum | JA | 314.159 |  | VOR_ENTWURF
01_CFK_Rahmen.FCStd | Schraubenschaft_REF019 | BOLT-REF | Schraubenauswahl TBD | Drehteil / Bauraum | JA | 1753.009 | Gewinde/Kopf/Vorspannung nicht ausgelegt | VOR_ENTWURF
01_CFK_Rahmen.FCStd | Schraubenkopf_REF019 | HEAD-REF | Schraubenauswahl TBD | Drehteil / Bauraum | JA | 314.159 |  | VOR_ENTWURF
01_CFK_Rahmen.FCStd | Deck_Distanz004 | DECK-SP01 | Isolierender Hartpunkt TBD | Drehteil / Bauraum | NEIN | 4071.504 | Druck-/Kernlast nicht nachgewiesen | VOR_ENTWURF
01_CFK_Rahmen.FCStd | Innenstuetze005 | CFK-S02 | CFK Rohr / Laminat TBD | Zuschnitt; Klemm-/Knotenanschluss TBD | NEIN | 49008.845 | Keine Bohrung direkt in tragende CFK-Rohre vorgesehen | VOR_ENTWURF
01_CFK_Rahmen.FCStd | Klemmplatte_Schnitt043 | KNOTEN-P01 | Aluminium / Legierung und Zustand TBD | Fraesen, Bohren, Entgraten | NEIN | 56505.218 | Bohrbild 64 x 52, D6.6 als Referenz. Schraubenvorspannung/Klemmdruck nicht ausgelegt. | VOR_ENTWURF
01_CFK_Rahmen.FCStd | Klemmplatte_Schnitt047 | KNOTEN-P01 | Aluminium / Legierung und Zustand TBD | Fraesen, Bohren, Entgraten | NEIN | 56505.218 | Bohrbild 64 x 52, D6.6 als Referenz. Schraubenvorspannung/Klemmdruck nicht ausgelegt. | VOR_ENTWURF
01_CFK_Rahmen.FCStd | Isolierlage_Knoten_Schnitt063 | ISO-01 | GFK/FR4 TBD | Fraesen, Bohren, Entgraten | NEIN | 7063.152 | Galvanische Trennung konzeptionell; Feuchte, Durchschlag, Kriechen nicht validiert | VOR_ENTWURF
01_CFK_Rahmen.FCStd | Isolierlage_Knoten_Schnitt067 | ISO-01 | GFK/FR4 TBD | Fraesen, Bohren, Entgraten | NEIN | 7063.152 | Galvanische Trennung konzeptionell; Feuchte, Durchschlag, Kriechen nicht validiert | VOR_ENTWURF
01_CFK_Rahmen.FCStd | Isolierlage_Knoten_Schnitt071 | ISO-01 | GFK/FR4 TBD | Fraesen, Bohren, Entgraten | NEIN | 7063.152 | Galvanische Trennung konzeptionell; Feuchte, Durchschlag, Kriechen nicht validiert | VOR_ENTWURF
01_CFK_Rahmen.FCStd | Schraubenschaft_REF020 | BOLT-REF | Schraubenauswahl TBD | Drehteil / Bauraum | JA | 1753.009 | Gewinde/Kopf/Vorspannung nicht ausgelegt | VOR_ENTWURF
01_CFK_Rahmen.FCStd | Schraubenkopf_REF020 | HEAD-REF | Schraubenauswahl TBD | Drehteil / Bauraum | JA | 314.159 |  | VOR_ENTWURF
01_CFK_Rahmen.FCStd | Schraubenschaft_REF021 | BOLT-REF | Schraubenauswahl TBD | Drehteil / Bauraum | JA | 1753.009 | Gewinde/Kopf/Vorspannung nicht ausgelegt | VOR_ENTWURF
01_CFK_Rahmen.FCStd | Schraubenkopf_REF021 | HEAD-REF | Schraubenauswahl TBD | Drehteil / Bauraum | JA | 314.159 |  | VOR_ENTWURF
01_CFK_Rahmen.FCStd | Schraubenschaft_REF022 | BOLT-REF | Schraubenauswahl TBD | Drehteil / Bauraum | JA | 1753.009 | Gewinde/Kopf/Vorspannung nicht ausgelegt | VOR_ENTWURF
01_CFK_Rahmen.FCStd | Schraubenkopf_REF022 | HEAD-REF | Schraubenauswahl TBD | Drehteil / Bauraum | JA | 314.159 |  | VOR_ENTWURF
01_CFK_Rahmen.FCStd | Schraubenschaft_REF023 | BOLT-REF | Schraubenauswahl TBD | Drehteil / Bauraum | JA | 1753.009 | Gewinde/Kopf/Vorspannung nicht ausgelegt | VOR_ENTWURF
01_CFK_Rahmen.FCStd | Schraubenkopf_REF023 | HEAD-REF | Schraubenauswahl TBD | Drehteil / Bauraum | JA | 314.159 |  | VOR_ENTWURF
01_CFK_Rahmen.FCStd | Deck_Distanz005 | DECK-SP01 | Isolierender Hartpunkt TBD | Drehteil / Bauraum | NEIN | 4071.504 | Druck-/Kernlast nicht nachgewiesen | VOR_ENTWURF
01_CFK_Rahmen.FCStd | Deckplatte | DECK-01 | CFK Sandwich / Kern und Laminat TBD | Panelzuschnitt; Hardpoints TBD | NEIN | 2880000.0 | Keine Lasteinleitung in Kern ohne ausgelegte Inserts. Nicht als ungepruefte Stehplatte verwenden. | VOR_ENTWURF
01_CFK_Rahmen.FCStd | Knotenwinkel_Bauraum | KNOTEN-REF | Metall + Isolierlagen TBD | Referenzhülle | JA | 87500.0 | Ueberlagerung mit Rohren ist Anschlussbauraum, kein fertiger Formschluss | VOR_ENTWURF
01_CFK_Rahmen.FCStd | Knotenwinkel_Bauraum001 | KNOTEN-REF | Metall + Isolierlagen TBD | Referenzhülle | JA | 87500.0 | Ueberlagerung mit Rohren ist Anschlussbauraum, kein fertiger Formschluss | VOR_ENTWURF
01_CFK_Rahmen.FCStd | Knotenwinkel_Bauraum002 | KNOTEN-REF | Metall + Isolierlagen TBD | Referenzhülle | JA | 87500.0 | Ueberlagerung mit Rohren ist Anschlussbauraum, kein fertiger Formschluss | VOR_ENTWURF
01_CFK_Rahmen.FCStd | Knotenwinkel_Bauraum003 | KNOTEN-REF | Metall + Isolierlagen TBD | Referenzhülle | JA | 87500.0 | Ueberlagerung mit Rohren ist Anschlussbauraum, kein fertiger Formschluss | VOR_ENTWURF
01_CFK_Rahmen.FCStd | Knotenwinkel_Bauraum004 | KNOTEN-REF | Metall + Isolierlagen TBD | Referenzhülle | JA | 87500.0 | Ueberlagerung mit Rohren ist Anschlussbauraum, kein fertiger Formschluss | VOR_ENTWURF
01_CFK_Rahmen.FCStd | Knotenwinkel_Bauraum005 | KNOTEN-REF | Metall + Isolierlagen TBD | Referenzhülle | JA | 87500.0 | Ueberlagerung mit Rohren ist Anschlussbauraum, kein fertiger Formschluss | VOR_ENTWURF
02_Fuehrung_Antrieb_Detail.FCStd | Fluegel_Huelle | FL-CFK-REF | CFK Laminat TBD | Formwerkzeug/Laminieren; Profilinnenkontur nur Referenz | NEIN | 251149.264 | Innenkontur skaliert, NICHT konstante Wandstaerke. Kein Laminat-, Flatter- oder Ermuedungsnachweis. | VOR_ENTWURF
02_Fuehrung_Antrieb_Detail.FCStd | Pitchwelle | PITCH-W01 | Wellenwerkstoff TBD | Drehteil / Bauraum | NEIN | 32169.909 | Achse bei 50 Prozent Sehne wie Referenzmodell; Torsion und Eigenfrequenz offen | VOR_ENTWURF
02_Fuehrung_Antrieb_Detail.FCStd | Schlitten_Traeger | SCHL-01 | Aluminium / Zustand TBD | Fraesen, Querbohren | NEIN | 29848.107 | Lagersitz und integrierter Motorbauraum ohne Passungs-, Last- oder Waermenachweis | VOR_ENTWURF
02_Fuehrung_Antrieb_Detail.FCStd | Pitchlager_Sitz | LAGER-G01 | Aluminium TBD | Dreh-/Katalogbauraum | NEIN | 2558.262 | Sitz D22.2 nur Referenz, keine Passungsfreigabe | VOR_ENTWURF
02_Fuehrung_Antrieb_Detail.FCStd | Lager_Bauraum | LAGER-REF | Katalogauswahl offen | Dreh-/Katalogbauraum | JA | 2309.071 | Nur Geometrie 8/22/7; kein ausgewaehltes oder lastbewertetes Lager | VOR_ENTWURF
02_Fuehrung_Antrieb_Detail.FCStd | Wurzelgabel | PITCH-G01 | Aluminium / Zustand TBD | Fraesen, Querbohren | NEIN | 1395.494 | Lagersitz und integrierter Motorbauraum ohne Passungs-, Last- oder Waermenachweis | VOR_ENTWURF
02_Fuehrung_Antrieb_Detail.FCStd | Magnet_0_0 | LM-MAG-REF | Permanentmagnet / Guete TBD | Katalogbauraum | JA | 384.0 | Polsymbol N; Polteilung und Fluss nicht ausgelegt | VOR_ENTWURF
02_Fuehrung_Antrieb_Detail.FCStd | Magnet_0_1 | LM-MAG-REF | Permanentmagnet / Guete TBD | Katalogbauraum | JA | 384.0 | Polsymbol S; Polteilung und Fluss nicht ausgelegt | VOR_ENTWURF
02_Fuehrung_Antrieb_Detail.FCStd | Fuehrpol_Bauraum | MAG-AKT-REF | Aktives Magnetlager TBD | Referenzvolumen | JA | 1152.0 | Nomineller CAD-Abstand 2 mm zum Flansch; kein funktionsfaehiger Luftspaltnachweis | VOR_ENTWURF
02_Fuehrung_Antrieb_Detail.FCStd | Fangrolle | FANG-REF | PEEK / Lager TBD | Drehteil / Bauraum | JA | 565.487 | 1 mm nominelle Restfreiheit; keine Fanglastfreigabe | VOR_ENTWURF
02_Fuehrung_Antrieb_Detail.FCStd | Fangrolle001 | FANG-REF | PEEK / Lager TBD | Drehteil / Bauraum | JA | 565.487 | 1 mm nominelle Restfreiheit; keine Fanglastfreigabe | VOR_ENTWURF
02_Fuehrung_Antrieb_Detail.FCStd | Fuehrpol_Bauraum001 | MAG-AKT-REF | Aktives Magnetlager TBD | Referenzvolumen | JA | 1152.0 | Nomineller CAD-Abstand 2 mm zum Flansch; kein funktionsfaehiger Luftspaltnachweis | VOR_ENTWURF
02_Fuehrung_Antrieb_Detail.FCStd | Fangrolle002 | FANG-REF | PEEK / Lager TBD | Drehteil / Bauraum | JA | 565.487 | 1 mm nominelle Restfreiheit; keine Fanglastfreigabe | VOR_ENTWURF
02_Fuehrung_Antrieb_Detail.FCStd | Fangrolle003 | FANG-REF | PEEK / Lager TBD | Drehteil / Bauraum | JA | 565.487 | 1 mm nominelle Restfreiheit; keine Fanglastfreigabe | VOR_ENTWURF
02_Fuehrung_Antrieb_Detail.FCStd | Induktiv_Sekundaer | IPT-SEC-REF | Sekundaerwicklung TBD | Bauraum | JA | 2160.0 | Versorgt Pitch/Encoder nur konzeptionell; Leistungsuebertragung nicht nachgewiesen | VOR_ENTWURF
02_Fuehrung_Antrieb_Detail.FCStd | Schlitten_Elektronik | CTRL-MOB-REF | Elektronik TBD | Bauraum | JA | 7920.0 | Positionssensor, Pitchregler und Puffer; keine fertige Elektronik | VOR_ENTWURF
02_Fuehrung_Antrieb_Detail.FCStd | Schlitten_Traeger001 | SCHL-01 | Aluminium / Zustand TBD | Fraesen, Querbohren | NEIN | 29848.107 | Lagersitz und integrierter Motorbauraum ohne Passungs-, Last- oder Waermenachweis | VOR_ENTWURF
02_Fuehrung_Antrieb_Detail.FCStd | Pitchlager_Sitz001 | LAGER-G01 | Aluminium TBD | Dreh-/Katalogbauraum | NEIN | 2558.262 | Sitz D22.2 nur Referenz, keine Passungsfreigabe | VOR_ENTWURF
02_Fuehrung_Antrieb_Detail.FCStd | Lager_Bauraum001 | LAGER-REF | Katalogauswahl offen | Dreh-/Katalogbauraum | JA | 2309.071 | Nur Geometrie 8/22/7; kein ausgewaehltes oder lastbewertetes Lager | VOR_ENTWURF
02_Fuehrung_Antrieb_Detail.FCStd | Wurzelgabel001 | PITCH-G01 | Aluminium / Zustand TBD | Fraesen, Querbohren | NEIN | 1395.494 | Lagersitz und integrierter Motorbauraum ohne Passungs-, Last- oder Waermenachweis | VOR_ENTWURF
02_Fuehrung_Antrieb_Detail.FCStd | Magnet_2_0 | LM-MAG-REF | Permanentmagnet / Guete TBD | Katalogbauraum | JA | 384.0 | Polsymbol N; Polteilung und Fluss nicht ausgelegt | VOR_ENTWURF
02_Fuehrung_Antrieb_Detail.FCStd | Magnet_2_1 | LM-MAG-REF | Permanentmagnet / Guete TBD | Katalogbauraum | JA | 384.0 | Polsymbol S; Polteilung und Fluss nicht ausgelegt | VOR_ENTWURF
02_Fuehrung_Antrieb_Detail.FCStd | Fuehrpol_Bauraum002 | MAG-AKT-REF | Aktives Magnetlager TBD | Referenzvolumen | JA | 1152.0 | Nomineller CAD-Abstand 2 mm zum Flansch; kein funktionsfaehiger Luftspaltnachweis | VOR_ENTWURF
02_Fuehrung_Antrieb_Detail.FCStd | Fangrolle004 | FANG-REF | PEEK / Lager TBD | Drehteil / Bauraum | JA | 565.487 | 1 mm nominelle Restfreiheit; keine Fanglastfreigabe | VOR_ENTWURF
02_Fuehrung_Antrieb_Detail.FCStd | Fangrolle005 | FANG-REF | PEEK / Lager TBD | Drehteil / Bauraum | JA | 565.487 | 1 mm nominelle Restfreiheit; keine Fanglastfreigabe | VOR_ENTWURF
02_Fuehrung_Antrieb_Detail.FCStd | Fuehrpol_Bauraum003 | MAG-AKT-REF | Aktives Magnetlager TBD | Referenzvolumen | JA | 1152.0 | Nomineller CAD-Abstand 2 mm zum Flansch; kein funktionsfaehiger Luftspaltnachweis | VOR_ENTWURF
02_Fuehrung_Antrieb_Detail.FCStd | Fangrolle006 | FANG-REF | PEEK / Lager TBD | Drehteil / Bauraum | JA | 565.487 | 1 mm nominelle Restfreiheit; keine Fanglastfreigabe | VOR_ENTWURF
02_Fuehrung_Antrieb_Detail.FCStd | Fangrolle007 | FANG-REF | PEEK / Lager TBD | Drehteil / Bauraum | JA | 565.487 | 1 mm nominelle Restfreiheit; keine Fanglastfreigabe | VOR_ENTWURF
02_Fuehrung_Antrieb_Detail.FCStd | Induktiv_Sekundaer001 | IPT-SEC-REF | Sekundaerwicklung TBD | Bauraum | JA | 2160.0 | Versorgt Pitch/Encoder nur konzeptionell; Leistungsuebertragung nicht nachgewiesen | VOR_ENTWURF
02_Fuehrung_Antrieb_Detail.FCStd | Schlitten_Elektronik001 | CTRL-MOB-REF | Elektronik TBD | Bauraum | JA | 7920.0 | Positionssensor, Pitchregler und Puffer; keine fertige Elektronik | VOR_ENTWURF
02_Fuehrung_Antrieb_Detail.FCStd | Pitch_Torquemotor_Huelle | PITCH-MOT-REF | Direktantrieb TBD | Dreh-/Katalogbauraum | JA | 4763.66 | Integrierter koaxialer Motorbauraum; kein Drehmoment-, Winkelraten- oder Waermenachweis | VOR_ENTWURF
02_Fuehrung_Antrieb_Detail.FCStd | Absolutencoder_Bauraum | ENC-REF | Encoder TBD | Dreh-/Katalogbauraum | JA | 582.577 | Referenzhuelle | VOR_ENTWURF
02_Fuehrung_Antrieb_Detail.FCStd | C_Probe_Rueckwand | FUEHR-C-PROBE | Aluminium TBD | Fraes-/Profilreferenz | NEIN | 86400.0 |  | VOR_ENTWURF
02_Fuehrung_Antrieb_Detail.FCStd | C_Probe_Flansch | FUEHR-F-PROBE | Aluminium TBD | Profilreferenz | NEIN | 53760.0 |  | VOR_ENTWURF
02_Fuehrung_Antrieb_Detail.FCStd | C_Probe_Flansch001 | FUEHR-F-PROBE | Aluminium TBD | Profilreferenz | NEIN | 53760.0 |  | VOR_ENTWURF
02_Fuehrung_Antrieb_Detail.FCStd | ABC_Statorzelle | LM-SPULE-REF | Wicklungsraum TBD | Referenz | JA | 1920.0 | Phasenkennzeichen A; KEINE Wicklungsauslegung | VOR_ENTWURF
02_Fuehrung_Antrieb_Detail.FCStd | ABC_Statorzelle001 | LM-SPULE-REF | Wicklungsraum TBD | Referenz | JA | 1920.0 | Phasenkennzeichen B; KEINE Wicklungsauslegung | VOR_ENTWURF
02_Fuehrung_Antrieb_Detail.FCStd | ABC_Statorzelle002 | LM-SPULE-REF | Wicklungsraum TBD | Referenz | JA | 1920.0 | Phasenkennzeichen C; KEINE Wicklungsauslegung | VOR_ENTWURF
02_Fuehrung_Antrieb_Detail.FCStd | ABC_Statorzelle003 | LM-SPULE-REF | Wicklungsraum TBD | Referenz | JA | 1920.0 | Phasenkennzeichen A; KEINE Wicklungsauslegung | VOR_ENTWURF
02_Fuehrung_Antrieb_Detail.FCStd | ABC_Statorzelle004 | LM-SPULE-REF | Wicklungsraum TBD | Referenz | JA | 1920.0 | Phasenkennzeichen B; KEINE Wicklungsauslegung | VOR_ENTWURF
02_Fuehrung_Antrieb_Detail.FCStd | ABC_Statorzelle005 | LM-SPULE-REF | Wicklungsraum TBD | Referenz | JA | 1920.0 | Phasenkennzeichen C; KEINE Wicklungsauslegung | VOR_ENTWURF
02_Fuehrung_Antrieb_Detail.FCStd | ABC_Statorzelle006 | LM-SPULE-REF | Wicklungsraum TBD | Referenz | JA | 1920.0 | Phasenkennzeichen A; KEINE Wicklungsauslegung | VOR_ENTWURF
02_Fuehrung_Antrieb_Detail.FCStd | ABC_Statorzelle007 | LM-SPULE-REF | Wicklungsraum TBD | Referenz | JA | 1920.0 | Phasenkennzeichen B; KEINE Wicklungsauslegung | VOR_ENTWURF
02_Fuehrung_Antrieb_Detail.FCStd | ABC_Statorzelle008 | LM-SPULE-REF | Wicklungsraum TBD | Referenz | JA | 1920.0 | Phasenkennzeichen C; KEINE Wicklungsauslegung | VOR_ENTWURF
02_Fuehrung_Antrieb_Detail.FCStd | ABC_Statorzelle009 | LM-SPULE-REF | Wicklungsraum TBD | Referenz | JA | 1920.0 | Phasenkennzeichen A; KEINE Wicklungsauslegung | VOR_ENTWURF
02_Fuehrung_Antrieb_Detail.FCStd | ABC_Statorzelle010 | LM-SPULE-REF | Wicklungsraum TBD | Referenz | JA | 1920.0 | Phasenkennzeichen B; KEINE Wicklungsauslegung | VOR_ENTWURF
02_Fuehrung_Antrieb_Detail.FCStd | ABC_Statorzelle011 | LM-SPULE-REF | Wicklungsraum TBD | Referenz | JA | 1920.0 | Phasenkennzeichen C; KEINE Wicklungsauslegung | VOR_ENTWURF
02_Fuehrung_Antrieb_Detail.FCStd | C_Probe_Rueckwand001 | FUEHR-C-PROBE | Aluminium TBD | Fraes-/Profilreferenz | NEIN | 86400.0 |  | VOR_ENTWURF
02_Fuehrung_Antrieb_Detail.FCStd | C_Probe_Flansch002 | FUEHR-F-PROBE | Aluminium TBD | Profilreferenz | NEIN | 53760.0 |  | VOR_ENTWURF
02_Fuehrung_Antrieb_Detail.FCStd | C_Probe_Flansch003 | FUEHR-F-PROBE | Aluminium TBD | Profilreferenz | NEIN | 53760.0 |  | VOR_ENTWURF
02_Fuehrung_Antrieb_Detail.FCStd | ABC_Statorzelle012 | LM-SPULE-REF | Wicklungsraum TBD | Referenz | JA | 1920.0 | Phasenkennzeichen A; KEINE Wicklungsauslegung | VOR_ENTWURF
02_Fuehrung_Antrieb_Detail.FCStd | ABC_Statorzelle013 | LM-SPULE-REF | Wicklungsraum TBD | Referenz | JA | 1920.0 | Phasenkennzeichen B; KEINE Wicklungsauslegung | VOR_ENTWURF
02_Fuehrung_Antrieb_Detail.FCStd | ABC_Statorzelle014 | LM-SPULE-REF | Wicklungsraum TBD | Referenz | JA | 1920.0 | Phasenkennzeichen C; KEINE Wicklungsauslegung | VOR_ENTWURF
02_Fuehrung_Antrieb_Detail.FCStd | ABC_Statorzelle015 | LM-SPULE-REF | Wicklungsraum TBD | Referenz | JA | 1920.0 | Phasenkennzeichen A; KEINE Wicklungsauslegung | VOR_ENTWURF
02_Fuehrung_Antrieb_Detail.FCStd | ABC_Statorzelle016 | LM-SPULE-REF | Wicklungsraum TBD | Referenz | JA | 1920.0 | Phasenkennzeichen B; KEINE Wicklungsauslegung | VOR_ENTWURF
02_Fuehrung_Antrieb_Detail.FCStd | ABC_Statorzelle017 | LM-SPULE-REF | Wicklungsraum TBD | Referenz | JA | 1920.0 | Phasenkennzeichen C; KEINE Wicklungsauslegung | VOR_ENTWURF
02_Fuehrung_Antrieb_Detail.FCStd | ABC_Statorzelle018 | LM-SPULE-REF | Wicklungsraum TBD | Referenz | JA | 1920.0 | Phasenkennzeichen A; KEINE Wicklungsauslegung | VOR_ENTWURF
02_Fuehrung_Antrieb_Detail.FCStd | ABC_Statorzelle019 | LM-SPULE-REF | Wicklungsraum TBD | Referenz | JA | 1920.0 | Phasenkennzeichen B; KEINE Wicklungsauslegung | VOR_ENTWURF
02_Fuehrung_Antrieb_Detail.FCStd | ABC_Statorzelle020 | LM-SPULE-REF | Wicklungsraum TBD | Referenz | JA | 1920.0 | Phasenkennzeichen C; KEINE Wicklungsauslegung | VOR_ENTWURF
02_Fuehrung_Antrieb_Detail.FCStd | ABC_Statorzelle021 | LM-SPULE-REF | Wicklungsraum TBD | Referenz | JA | 1920.0 | Phasenkennzeichen A; KEINE Wicklungsauslegung | VOR_ENTWURF
02_Fuehrung_Antrieb_Detail.FCStd | ABC_Statorzelle022 | LM-SPULE-REF | Wicklungsraum TBD | Referenz | JA | 1920.0 | Phasenkennzeichen B; KEINE Wicklungsauslegung | VOR_ENTWURF
02_Fuehrung_Antrieb_Detail.FCStd | ABC_Statorzelle023 | LM-SPULE-REF | Wicklungsraum TBD | Referenz | JA | 1920.0 | Phasenkennzeichen C; KEINE Wicklungsauslegung | VOR_ENTWURF
03_Batterie_Kabel.FCStd | Trennschutz_Unterseite | BAT-GUARD | GFK/FR4/Brandkonzept TBD | Zuschnitt | NEIN | 704000.0 | Nur Trenngeometrie. Keine Brand-, Splitter- oder Durchschlagpruefung. | VOR_ENTWURF
03_Batterie_Kabel.FCStd | Schubkasten_Boden_Rohteil | BAT-TRAY | Aluminium / Legierung und Zustand TBD | Fraesen, Bohren, Entgraten | NEIN | 528000.0 | Entnahme laengs x; Befestigung und Rueckhaltung offen | VOR_ENTWURF
03_Batterie_Kabel.FCStd | Akku_Modulhuelle | BAT-MOD-REF | Akkusystem unbestimmt | Bauraum | JA | 3360000.0 | KEINE Tattu-Auswahl. Energie, Spannung, Strom, Masse und thermischer Aufbau offen. | VOR_ENTWURF
03_Batterie_Kabel.FCStd | Gleit_Isolation | BAT-GLEIT | GFK/PEEK TBD | Zuschnitt | NEIN | 77400.0 | Keine Kriech-/Brandfreigabe | VOR_ENTWURF
03_Batterie_Kabel.FCStd | Gleit_Isolation001 | BAT-GLEIT | GFK/PEEK TBD | Zuschnitt | NEIN | 77400.0 | Keine Kriech-/Brandfreigabe | VOR_ENTWURF
03_Batterie_Kabel.FCStd | Modul_Rueckhaltebuegel_Schnitt1 | BAT-BUEGEL | Aluminium / Legierung und Zustand TBD | Fraesen, Bohren, Entgraten | NEIN | 9257.881 | Positiver Rueckhalt nur Konzept; Belastung, Verriegelung und Sicherung offen | VOR_ENTWURF
03_Batterie_Kabel.FCStd | Modul_Rueckhaltebuegel_Schnitt003 | BAT-BUEGEL | Aluminium / Legierung und Zustand TBD | Fraesen, Bohren, Entgraten | NEIN | 9257.881 | Positiver Rueckhalt nur Konzept; Belastung, Verriegelung und Sicherung offen | VOR_ENTWURF
03_Batterie_Kabel.FCStd | Akku_Modulhuelle001 | BAT-MOD-REF | Akkusystem unbestimmt | Bauraum | JA | 3360000.0 | KEINE Tattu-Auswahl. Energie, Spannung, Strom, Masse und thermischer Aufbau offen. | VOR_ENTWURF
03_Batterie_Kabel.FCStd | Gleit_Isolation002 | BAT-GLEIT | GFK/PEEK TBD | Zuschnitt | NEIN | 77400.0 | Keine Kriech-/Brandfreigabe | VOR_ENTWURF
03_Batterie_Kabel.FCStd | Gleit_Isolation003 | BAT-GLEIT | GFK/PEEK TBD | Zuschnitt | NEIN | 77400.0 | Keine Kriech-/Brandfreigabe | VOR_ENTWURF
03_Batterie_Kabel.FCStd | Modul_Rueckhaltebuegel_Schnitt005 | BAT-BUEGEL | Aluminium / Legierung und Zustand TBD | Fraesen, Bohren, Entgraten | NEIN | 9257.881 | Positiver Rueckhalt nur Konzept; Belastung, Verriegelung und Sicherung offen | VOR_ENTWURF
03_Batterie_Kabel.FCStd | Modul_Rueckhaltebuegel_Schnitt007 | BAT-BUEGEL | Aluminium / Legierung und Zustand TBD | Fraesen, Bohren, Entgraten | NEIN | 9257.881 | Positiver Rueckhalt nur Konzept; Belastung, Verriegelung und Sicherung offen | VOR_ENTWURF
03_Batterie_Kabel.FCStd | Servicebox_HV | HV-BOX-REF | Isolierendes Gehaeuse TBD | Bauraum | JA | 504000.0 | BMS, Sicherung, Schuetze, Vorladung, Trennstelle nur Funktionsanforderungen; kein Schaltplan | VOR_ENTWURF
03_Batterie_Kabel.FCStd | HV_Kabelraum | HV-CABLE-REF | Kabeltyp/Aderquerschnitt TBD | Routingbauraum | JA | 121494.562 | D12 und R60 nur CAD-Referenz; keine Strombelastbarkeit, Isolations- oder Mindestbiegeradiusfreigabe | VOR_ENTWURF
03_Batterie_Kabel.FCStd | LV_Datenraum | LV-CABLE-REF | Daten-/Versorgungstyp TBD | Routingbauraum | JA | 27486.155 | Getrennte Trasse; kein EMV- oder Sicherheitsabstandsnachweis | VOR_ENTWURF
03_Batterie_Kabel.FCStd | Stator_Verteilbox | STATOR-JB-REF | Elektronik/Isolation TBD | Bauraum | JA | 63000.0 | Fester Anschluss an untere/obere Statorzonen noch elektrisch auszuarbeiten | VOR_ENTWURF
03_Batterie_Kabel.FCStd | Kabelschelle_Isoliert | KABEL-CLIP | Isolierwerkstoff TBD | Klemmhalter | NEIN | 6048.0 | Schellen-Ueberlagerung mit Kabel ist beabsichtigter Halteraum; keine Klemmkraftfreigabe | VOR_ENTWURF
03_Batterie_Kabel.FCStd | Kabelschelle_Isoliert001 | KABEL-CLIP | Isolierwerkstoff TBD | Klemmhalter | NEIN | 6048.0 | Schellen-Ueberlagerung mit Kabel ist beabsichtigter Halteraum; keine Klemmkraftfreigabe | VOR_ENTWURF
03_Batterie_Kabel.FCStd | Kabelschelle_Isoliert002 | KABEL-CLIP | Isolierwerkstoff TBD | Klemmhalter | NEIN | 6048.0 | Schellen-Ueberlagerung mit Kabel ist beabsichtigter Halteraum; keine Klemmkraftfreigabe | VOR_ENTWURF
03_Batterie_Kabel.FCStd | HV_Kabelraum001 | HV-CABLE-REF | Kabeltyp/Aderquerschnitt TBD | Routingbauraum | JA | 121494.562 | D12 und R60 nur CAD-Referenz; keine Strombelastbarkeit, Isolations- oder Mindestbiegeradiusfreigabe | VOR_ENTWURF
03_Batterie_Kabel.FCStd | LV_Datenraum001 | LV-CABLE-REF | Daten-/Versorgungstyp TBD | Routingbauraum | JA | 27486.155 | Getrennte Trasse; kein EMV- oder Sicherheitsabstandsnachweis | VOR_ENTWURF
03_Batterie_Kabel.FCStd | Stator_Verteilbox001 | STATOR-JB-REF | Elektronik/Isolation TBD | Bauraum | JA | 63000.0 | Fester Anschluss an untere/obere Statorzonen noch elektrisch auszuarbeiten | VOR_ENTWURF
03_Batterie_Kabel.FCStd | Kabelschelle_Isoliert003 | KABEL-CLIP | Isolierwerkstoff TBD | Klemmhalter | NEIN | 6048.0 | Schellen-Ueberlagerung mit Kabel ist beabsichtigter Halteraum; keine Klemmkraftfreigabe | VOR_ENTWURF
03_Batterie_Kabel.FCStd | Kabelschelle_Isoliert004 | KABEL-CLIP | Isolierwerkstoff TBD | Klemmhalter | NEIN | 6048.0 | Schellen-Ueberlagerung mit Kabel ist beabsichtigter Halteraum; keine Klemmkraftfreigabe | VOR_ENTWURF
03_Batterie_Kabel.FCStd | Kabelschelle_Isoliert005 | KABEL-CLIP | Isolierwerkstoff TBD | Klemmhalter | NEIN | 6048.0 | Schellen-Ueberlagerung mit Kabel ist beabsichtigter Halteraum; keine Klemmkraftfreigabe | VOR_ENTWURF
00_PropBoard_Detail_Stehen.FCStd | Laengsrohr_0 | CFK-L01 | CFK Rohr / Laminat TBD | Zuschnitt; Enden/Lastanschluesse gesondert auslegen | NEIN | 532800.0 | Wand 3 mm nur Geometrieannahme. Keine Faserfolge, Festigkeit oder Klebfuge nachgewiesen. | VOR_ENTWURF
00_PropBoard_Detail_Stehen.FCStd | Laengsrohr_200 | CFK-L01 | CFK Rohr / Laminat TBD | Zuschnitt; Enden/Lastanschluesse gesondert auslegen | NEIN | 532800.0 | Wand 3 mm nur Geometrieannahme. Keine Faserfolge, Festigkeit oder Klebfuge nachgewiesen. | VOR_ENTWURF
00_PropBoard_Detail_Stehen.FCStd | Quertraeger_0 | CFK-Q01 | CFK Rohr / Laminat TBD | Zuschnitt; Enden/Lastanschluesse gesondert auslegen | NEIN | 737040.0 | Wand 3 mm nur Geometrieannahme. Keine Faserfolge, Festigkeit oder Klebfuge nachgewiesen. | VOR_ENTWURF
00_PropBoard_Detail_Stehen.FCStd | Aussenstuetze_0_0 | CFK-S01 | CFK Rohr / Laminat TBD | Zuschnitt; Klemm-/Knotenanschluss TBD | NEIN | 101787.602 | Keine Bohrung direkt in tragende CFK-Rohre vorgesehen | VOR_ENTWURF
00_PropBoard_Detail_Stehen.FCStd | Fuss_Puffer | FUSS-01 | Elastomer TBD | Drehteil / Bauraum | NEIN | 45615.925 | Kein Aufprall-/Landefahrwerksnachweis | VOR_ENTWURF
00_PropBoard_Detail_Stehen.FCStd | Aussenstuetze_0_1620 | CFK-S01 | CFK Rohr / Laminat TBD | Zuschnitt; Klemm-/Knotenanschluss TBD | NEIN | 101787.602 | Keine Bohrung direkt in tragende CFK-Rohre vorgesehen | VOR_ENTWURF
00_PropBoard_Detail_Stehen.FCStd | Fuss_Puffer001 | FUSS-01 | Elastomer TBD | Drehteil / Bauraum | NEIN | 45615.925 | Kein Aufprall-/Landefahrwerksnachweis | VOR_ENTWURF
00_PropBoard_Detail_Stehen.FCStd | Innenstuetze | CFK-S02 | CFK Rohr / Laminat TBD | Zuschnitt; Klemm-/Knotenanschluss TBD | NEIN | 49008.845 | Keine Bohrung direkt in tragende CFK-Rohre vorgesehen | VOR_ENTWURF
00_PropBoard_Detail_Stehen.FCStd | Klemmplatte_Schnitt3 | KNOTEN-P01 | Aluminium / Legierung und Zustand TBD | Fraesen, Bohren, Entgraten | NEIN | 56505.218 | Bohrbild 64 x 52, D6.6 als Referenz. Schraubenvorspannung/Klemmdruck nicht ausgelegt. | VOR_ENTWURF
00_PropBoard_Detail_Stehen.FCStd | Klemmplatte_Schnitt007 | KNOTEN-P01 | Aluminium / Legierung und Zustand TBD | Fraesen, Bohren, Entgraten | NEIN | 56505.218 | Bohrbild 64 x 52, D6.6 als Referenz. Schraubenvorspannung/Klemmdruck nicht ausgelegt. | VOR_ENTWURF
00_PropBoard_Detail_Stehen.FCStd | Isolierlage_Knoten_Schnitt3 | ISO-01 | GFK/FR4 TBD | Fraesen, Bohren, Entgraten | NEIN | 7063.152 | Galvanische Trennung konzeptionell; Feuchte, Durchschlag, Kriechen nicht validiert | VOR_ENTWURF
00_PropBoard_Detail_Stehen.FCStd | Isolierlage_Knoten_Schnitt007 | ISO-01 | GFK/FR4 TBD | Fraesen, Bohren, Entgraten | NEIN | 7063.152 | Galvanische Trennung konzeptionell; Feuchte, Durchschlag, Kriechen nicht validiert | VOR_ENTWURF
00_PropBoard_Detail_Stehen.FCStd | Isolierlage_Knoten_Schnitt011 | ISO-01 | GFK/FR4 TBD | Fraesen, Bohren, Entgraten | NEIN | 7063.152 | Galvanische Trennung konzeptionell; Feuchte, Durchschlag, Kriechen nicht validiert | VOR_ENTWURF
00_PropBoard_Detail_Stehen.FCStd | Schraubenschaft_REF | BOLT-REF | Schraubenauswahl TBD | Drehteil / Bauraum | JA | 1753.009 | Gewinde/Kopf/Vorspannung nicht ausgelegt | VOR_ENTWURF
00_PropBoard_Detail_Stehen.FCStd | Schraubenkopf_REF | HEAD-REF | Schraubenauswahl TBD | Drehteil / Bauraum | JA | 314.159 |  | VOR_ENTWURF
00_PropBoard_Detail_Stehen.FCStd | Schraubenschaft_REF001 | BOLT-REF | Schraubenauswahl TBD | Drehteil / Bauraum | JA | 1753.009 | Gewinde/Kopf/Vorspannung nicht ausgelegt | VOR_ENTWURF
00_PropBoard_Detail_Stehen.FCStd | Schraubenkopf_REF001 | HEAD-REF | Schraubenauswahl TBD | Drehteil / Bauraum | JA | 314.159 |  | VOR_ENTWURF
00_PropBoard_Detail_Stehen.FCStd | Schraubenschaft_REF002 | BOLT-REF | Schraubenauswahl TBD | Drehteil / Bauraum | JA | 1753.009 | Gewinde/Kopf/Vorspannung nicht ausgelegt | VOR_ENTWURF
00_PropBoard_Detail_Stehen.FCStd | Schraubenkopf_REF002 | HEAD-REF | Schraubenauswahl TBD | Drehteil / Bauraum | JA | 314.159 |  | VOR_ENTWURF
00_PropBoard_Detail_Stehen.FCStd | Schraubenschaft_REF003 | BOLT-REF | Schraubenauswahl TBD | Drehteil / Bauraum | JA | 1753.009 | Gewinde/Kopf/Vorspannung nicht ausgelegt | VOR_ENTWURF
00_PropBoard_Detail_Stehen.FCStd | Schraubenkopf_REF003 | HEAD-REF | Schraubenauswahl TBD | Drehteil / Bauraum | JA | 314.159 |  | VOR_ENTWURF
00_PropBoard_Detail_Stehen.FCStd | Deck_Distanz | DECK-SP01 | Isolierender Hartpunkt TBD | Drehteil / Bauraum | NEIN | 4071.504 | Druck-/Kernlast nicht nachgewiesen | VOR_ENTWURF
00_PropBoard_Detail_Stehen.FCStd | Innenstuetze001 | CFK-S02 | CFK Rohr / Laminat TBD | Zuschnitt; Klemm-/Knotenanschluss TBD | NEIN | 49008.845 | Keine Bohrung direkt in tragende CFK-Rohre vorgesehen | VOR_ENTWURF
00_PropBoard_Detail_Stehen.FCStd | Klemmplatte_Schnitt011 | KNOTEN-P01 | Aluminium / Legierung und Zustand TBD | Fraesen, Bohren, Entgraten | NEIN | 56505.218 | Bohrbild 64 x 52, D6.6 als Referenz. Schraubenvorspannung/Klemmdruck nicht ausgelegt. | VOR_ENTWURF
00_PropBoard_Detail_Stehen.FCStd | Klemmplatte_Schnitt015 | KNOTEN-P01 | Aluminium / Legierung und Zustand TBD | Fraesen, Bohren, Entgraten | NEIN | 56505.218 | Bohrbild 64 x 52, D6.6 als Referenz. Schraubenvorspannung/Klemmdruck nicht ausgelegt. | VOR_ENTWURF
00_PropBoard_Detail_Stehen.FCStd | Isolierlage_Knoten_Schnitt015 | ISO-01 | GFK/FR4 TBD | Fraesen, Bohren, Entgraten | NEIN | 7063.152 | Galvanische Trennung konzeptionell; Feuchte, Durchschlag, Kriechen nicht validiert | VOR_ENTWURF
00_PropBoard_Detail_Stehen.FCStd | Isolierlage_Knoten_Schnitt019 | ISO-01 | GFK/FR4 TBD | Fraesen, Bohren, Entgraten | NEIN | 7063.152 | Galvanische Trennung konzeptionell; Feuchte, Durchschlag, Kriechen nicht validiert | VOR_ENTWURF
00_PropBoard_Detail_Stehen.FCStd | Isolierlage_Knoten_Schnitt023 | ISO-01 | GFK/FR4 TBD | Fraesen, Bohren, Entgraten | NEIN | 7063.152 | Galvanische Trennung konzeptionell; Feuchte, Durchschlag, Kriechen nicht validiert | VOR_ENTWURF
00_PropBoard_Detail_Stehen.FCStd | Schraubenschaft_REF004 | BOLT-REF | Schraubenauswahl TBD | Drehteil / Bauraum | JA | 1753.009 | Gewinde/Kopf/Vorspannung nicht ausgelegt | VOR_ENTWURF
00_PropBoard_Detail_Stehen.FCStd | Schraubenkopf_REF004 | HEAD-REF | Schraubenauswahl TBD | Drehteil / Bauraum | JA | 314.159 |  | VOR_ENTWURF
00_PropBoard_Detail_Stehen.FCStd | Schraubenschaft_REF005 | BOLT-REF | Schraubenauswahl TBD | Drehteil / Bauraum | JA | 1753.009 | Gewinde/Kopf/Vorspannung nicht ausgelegt | VOR_ENTWURF
00_PropBoard_Detail_Stehen.FCStd | Schraubenkopf_REF005 | HEAD-REF | Schraubenauswahl TBD | Drehteil / Bauraum | JA | 314.159 |  | VOR_ENTWURF
00_PropBoard_Detail_Stehen.FCStd | Schraubenschaft_REF006 | BOLT-REF | Schraubenauswahl TBD | Drehteil / Bauraum | JA | 1753.009 | Gewinde/Kopf/Vorspannung nicht ausgelegt | VOR_ENTWURF
00_PropBoard_Detail_Stehen.FCStd | Schraubenkopf_REF006 | HEAD-REF | Schraubenauswahl TBD | Drehteil / Bauraum | JA | 314.159 |  | VOR_ENTWURF
00_PropBoard_Detail_Stehen.FCStd | Schraubenschaft_REF007 | BOLT-REF | Schraubenauswahl TBD | Drehteil / Bauraum | JA | 1753.009 | Gewinde/Kopf/Vorspannung nicht ausgelegt | VOR_ENTWURF
00_PropBoard_Detail_Stehen.FCStd | Schraubenkopf_REF007 | HEAD-REF | Schraubenauswahl TBD | Drehteil / Bauraum | JA | 314.159 |  | VOR_ENTWURF
00_PropBoard_Detail_Stehen.FCStd | Deck_Distanz001 | DECK-SP01 | Isolierender Hartpunkt TBD | Drehteil / Bauraum | NEIN | 4071.504 | Druck-/Kernlast nicht nachgewiesen | VOR_ENTWURF
00_PropBoard_Detail_Stehen.FCStd | Quertraeger_200 | CFK-Q01 | CFK Rohr / Laminat TBD | Zuschnitt; Enden/Lastanschluesse gesondert auslegen | NEIN | 737040.0 | Wand 3 mm nur Geometrieannahme. Keine Faserfolge, Festigkeit oder Klebfuge nachgewiesen. | VOR_ENTWURF
00_PropBoard_Detail_Stehen.FCStd | Aussenstuetze_200_0 | CFK-S01 | CFK Rohr / Laminat TBD | Zuschnitt; Klemm-/Knotenanschluss TBD | NEIN | 101787.602 | Keine Bohrung direkt in tragende CFK-Rohre vorgesehen | VOR_ENTWURF
00_PropBoard_Detail_Stehen.FCStd | Fuss_Puffer002 | FUSS-01 | Elastomer TBD | Drehteil / Bauraum | NEIN | 45615.925 | Kein Aufprall-/Landefahrwerksnachweis | VOR_ENTWURF
00_PropBoard_Detail_Stehen.FCStd | Aussenstuetze_200_1620 | CFK-S01 | CFK Rohr / Laminat TBD | Zuschnitt; Klemm-/Knotenanschluss TBD | NEIN | 101787.602 | Keine Bohrung direkt in tragende CFK-Rohre vorgesehen | VOR_ENTWURF
00_PropBoard_Detail_Stehen.FCStd | Fuss_Puffer003 | FUSS-01 | Elastomer TBD | Drehteil / Bauraum | NEIN | 45615.925 | Kein Aufprall-/Landefahrwerksnachweis | VOR_ENTWURF
00_PropBoard_Detail_Stehen.FCStd | Innenstuetze002 | CFK-S02 | CFK Rohr / Laminat TBD | Zuschnitt; Klemm-/Knotenanschluss TBD | NEIN | 49008.845 | Keine Bohrung direkt in tragende CFK-Rohre vorgesehen | VOR_ENTWURF
00_PropBoard_Detail_Stehen.FCStd | Klemmplatte_Schnitt019 | KNOTEN-P01 | Aluminium / Legierung und Zustand TBD | Fraesen, Bohren, Entgraten | NEIN | 56505.218 | Bohrbild 64 x 52, D6.6 als Referenz. Schraubenvorspannung/Klemmdruck nicht ausgelegt. | VOR_ENTWURF
00_PropBoard_Detail_Stehen.FCStd | Klemmplatte_Schnitt023 | KNOTEN-P01 | Aluminium / Legierung und Zustand TBD | Fraesen, Bohren, Entgraten | NEIN | 56505.218 | Bohrbild 64 x 52, D6.6 als Referenz. Schraubenvorspannung/Klemmdruck nicht ausgelegt. | VOR_ENTWURF
00_PropBoard_Detail_Stehen.FCStd | Isolierlage_Knoten_Schnitt027 | ISO-01 | GFK/FR4 TBD | Fraesen, Bohren, Entgraten | NEIN | 7063.152 | Galvanische Trennung konzeptionell; Feuchte, Durchschlag, Kriechen nicht validiert | VOR_ENTWURF
00_PropBoard_Detail_Stehen.FCStd | Isolierlage_Knoten_Schnitt031 | ISO-01 | GFK/FR4 TBD | Fraesen, Bohren, Entgraten | NEIN | 7063.152 | Galvanische Trennung konzeptionell; Feuchte, Durchschlag, Kriechen nicht validiert | VOR_ENTWURF
00_PropBoard_Detail_Stehen.FCStd | Isolierlage_Knoten_Schnitt035 | ISO-01 | GFK/FR4 TBD | Fraesen, Bohren, Entgraten | NEIN | 7063.152 | Galvanische Trennung konzeptionell; Feuchte, Durchschlag, Kriechen nicht validiert | VOR_ENTWURF
00_PropBoard_Detail_Stehen.FCStd | Schraubenschaft_REF008 | BOLT-REF | Schraubenauswahl TBD | Drehteil / Bauraum | JA | 1753.009 | Gewinde/Kopf/Vorspannung nicht ausgelegt | VOR_ENTWURF
00_PropBoard_Detail_Stehen.FCStd | Schraubenkopf_REF008 | HEAD-REF | Schraubenauswahl TBD | Drehteil / Bauraum | JA | 314.159 |  | VOR_ENTWURF
00_PropBoard_Detail_Stehen.FCStd | Schraubenschaft_REF009 | BOLT-REF | Schraubenauswahl TBD | Drehteil / Bauraum | JA | 1753.009 | Gewinde/Kopf/Vorspannung nicht ausgelegt | VOR_ENTWURF
00_PropBoard_Detail_Stehen.FCStd | Schraubenkopf_REF009 | HEAD-REF | Schraubenauswahl TBD | Drehteil / Bauraum | JA | 314.159 |  | VOR_ENTWURF
00_PropBoard_Detail_Stehen.FCStd | Schraubenschaft_REF010 | BOLT-REF | Schraubenauswahl TBD | Drehteil / Bauraum | JA | 1753.009 | Gewinde/Kopf/Vorspannung nicht ausgelegt | VOR_ENTWURF
00_PropBoard_Detail_Stehen.FCStd | Schraubenkopf_REF010 | HEAD-REF | Schraubenauswahl TBD | Drehteil / Bauraum | JA | 314.159 |  | VOR_ENTWURF
00_PropBoard_Detail_Stehen.FCStd | Schraubenschaft_REF011 | BOLT-REF | Schraubenauswahl TBD | Drehteil / Bauraum | JA | 1753.009 | Gewinde/Kopf/Vorspannung nicht ausgelegt | VOR_ENTWURF
00_PropBoard_Detail_Stehen.FCStd | Schraubenkopf_REF011 | HEAD-REF | Schraubenauswahl TBD | Drehteil / Bauraum | JA | 314.159 |  | VOR_ENTWURF
00_PropBoard_Detail_Stehen.FCStd | Deck_Distanz002 | DECK-SP01 | Isolierender Hartpunkt TBD | Drehteil / Bauraum | NEIN | 4071.504 | Druck-/Kernlast nicht nachgewiesen | VOR_ENTWURF
00_PropBoard_Detail_Stehen.FCStd | Innenstuetze003 | CFK-S02 | CFK Rohr / Laminat TBD | Zuschnitt; Klemm-/Knotenanschluss TBD | NEIN | 49008.845 | Keine Bohrung direkt in tragende CFK-Rohre vorgesehen | VOR_ENTWURF
00_PropBoard_Detail_Stehen.FCStd | Klemmplatte_Schnitt027 | KNOTEN-P01 | Aluminium / Legierung und Zustand TBD | Fraesen, Bohren, Entgraten | NEIN | 56505.218 | Bohrbild 64 x 52, D6.6 als Referenz. Schraubenvorspannung/Klemmdruck nicht ausgelegt. | VOR_ENTWURF
00_PropBoard_Detail_Stehen.FCStd | Klemmplatte_Schnitt031 | KNOTEN-P01 | Aluminium / Legierung und Zustand TBD | Fraesen, Bohren, Entgraten | NEIN | 56505.218 | Bohrbild 64 x 52, D6.6 als Referenz. Schraubenvorspannung/Klemmdruck nicht ausgelegt. | VOR_ENTWURF
00_PropBoard_Detail_Stehen.FCStd | Isolierlage_Knoten_Schnitt039 | ISO-01 | GFK/FR4 TBD | Fraesen, Bohren, Entgraten | NEIN | 7063.152 | Galvanische Trennung konzeptionell; Feuchte, Durchschlag, Kriechen nicht validiert | VOR_ENTWURF
00_PropBoard_Detail_Stehen.FCStd | Isolierlage_Knoten_Schnitt043 | ISO-01 | GFK/FR4 TBD | Fraesen, Bohren, Entgraten | NEIN | 7063.152 | Galvanische Trennung konzeptionell; Feuchte, Durchschlag, Kriechen nicht validiert | VOR_ENTWURF
00_PropBoard_Detail_Stehen.FCStd | Isolierlage_Knoten_Schnitt047 | ISO-01 | GFK/FR4 TBD | Fraesen, Bohren, Entgraten | NEIN | 7063.152 | Galvanische Trennung konzeptionell; Feuchte, Durchschlag, Kriechen nicht validiert | VOR_ENTWURF
00_PropBoard_Detail_Stehen.FCStd | Schraubenschaft_REF012 | BOLT-REF | Schraubenauswahl TBD | Drehteil / Bauraum | JA | 1753.009 | Gewinde/Kopf/Vorspannung nicht ausgelegt | VOR_ENTWURF
00_PropBoard_Detail_Stehen.FCStd | Schraubenkopf_REF012 | HEAD-REF | Schraubenauswahl TBD | Drehteil / Bauraum | JA | 314.159 |  | VOR_ENTWURF
00_PropBoard_Detail_Stehen.FCStd | Schraubenschaft_REF013 | BOLT-REF | Schraubenauswahl TBD | Drehteil / Bauraum | JA | 1753.009 | Gewinde/Kopf/Vorspannung nicht ausgelegt | VOR_ENTWURF
00_PropBoard_Detail_Stehen.FCStd | Schraubenkopf_REF013 | HEAD-REF | Schraubenauswahl TBD | Drehteil / Bauraum | JA | 314.159 |  | VOR_ENTWURF
00_PropBoard_Detail_Stehen.FCStd | Schraubenschaft_REF014 | BOLT-REF | Schraubenauswahl TBD | Drehteil / Bauraum | JA | 1753.009 | Gewinde/Kopf/Vorspannung nicht ausgelegt | VOR_ENTWURF
00_PropBoard_Detail_Stehen.FCStd | Schraubenkopf_REF014 | HEAD-REF | Schraubenauswahl TBD | Drehteil / Bauraum | JA | 314.159 |  | VOR_ENTWURF
00_PropBoard_Detail_Stehen.FCStd | Schraubenschaft_REF015 | BOLT-REF | Schraubenauswahl TBD | Drehteil / Bauraum | JA | 1753.009 | Gewinde/Kopf/Vorspannung nicht ausgelegt | VOR_ENTWURF
00_PropBoard_Detail_Stehen.FCStd | Schraubenkopf_REF015 | HEAD-REF | Schraubenauswahl TBD | Drehteil / Bauraum | JA | 314.159 |  | VOR_ENTWURF
00_PropBoard_Detail_Stehen.FCStd | Deck_Distanz003 | DECK-SP01 | Isolierender Hartpunkt TBD | Drehteil / Bauraum | NEIN | 4071.504 | Druck-/Kernlast nicht nachgewiesen | VOR_ENTWURF
00_PropBoard_Detail_Stehen.FCStd | Quertraeger_400 | CFK-Q01 | CFK Rohr / Laminat TBD | Zuschnitt; Enden/Lastanschluesse gesondert auslegen | NEIN | 737040.0 | Wand 3 mm nur Geometrieannahme. Keine Faserfolge, Festigkeit oder Klebfuge nachgewiesen. | VOR_ENTWURF
00_PropBoard_Detail_Stehen.FCStd | Aussenstuetze_400_0 | CFK-S01 | CFK Rohr / Laminat TBD | Zuschnitt; Klemm-/Knotenanschluss TBD | NEIN | 101787.602 | Keine Bohrung direkt in tragende CFK-Rohre vorgesehen | VOR_ENTWURF
00_PropBoard_Detail_Stehen.FCStd | Fuss_Puffer004 | FUSS-01 | Elastomer TBD | Drehteil / Bauraum | NEIN | 45615.925 | Kein Aufprall-/Landefahrwerksnachweis | VOR_ENTWURF
00_PropBoard_Detail_Stehen.FCStd | Aussenstuetze_400_1620 | CFK-S01 | CFK Rohr / Laminat TBD | Zuschnitt; Klemm-/Knotenanschluss TBD | NEIN | 101787.602 | Keine Bohrung direkt in tragende CFK-Rohre vorgesehen | VOR_ENTWURF
00_PropBoard_Detail_Stehen.FCStd | Fuss_Puffer005 | FUSS-01 | Elastomer TBD | Drehteil / Bauraum | NEIN | 45615.925 | Kein Aufprall-/Landefahrwerksnachweis | VOR_ENTWURF
00_PropBoard_Detail_Stehen.FCStd | Innenstuetze004 | CFK-S02 | CFK Rohr / Laminat TBD | Zuschnitt; Klemm-/Knotenanschluss TBD | NEIN | 49008.845 | Keine Bohrung direkt in tragende CFK-Rohre vorgesehen | VOR_ENTWURF
00_PropBoard_Detail_Stehen.FCStd | Klemmplatte_Schnitt035 | KNOTEN-P01 | Aluminium / Legierung und Zustand TBD | Fraesen, Bohren, Entgraten | NEIN | 56505.218 | Bohrbild 64 x 52, D6.6 als Referenz. Schraubenvorspannung/Klemmdruck nicht ausgelegt. | VOR_ENTWURF
00_PropBoard_Detail_Stehen.FCStd | Klemmplatte_Schnitt039 | KNOTEN-P01 | Aluminium / Legierung und Zustand TBD | Fraesen, Bohren, Entgraten | NEIN | 56505.218 | Bohrbild 64 x 52, D6.6 als Referenz. Schraubenvorspannung/Klemmdruck nicht ausgelegt. | VOR_ENTWURF
00_PropBoard_Detail_Stehen.FCStd | Isolierlage_Knoten_Schnitt051 | ISO-01 | GFK/FR4 TBD | Fraesen, Bohren, Entgraten | NEIN | 7063.152 | Galvanische Trennung konzeptionell; Feuchte, Durchschlag, Kriechen nicht validiert | VOR_ENTWURF
00_PropBoard_Detail_Stehen.FCStd | Isolierlage_Knoten_Schnitt055 | ISO-01 | GFK/FR4 TBD | Fraesen, Bohren, Entgraten | NEIN | 7063.152 | Galvanische Trennung konzeptionell; Feuchte, Durchschlag, Kriechen nicht validiert | VOR_ENTWURF
00_PropBoard_Detail_Stehen.FCStd | Isolierlage_Knoten_Schnitt059 | ISO-01 | GFK/FR4 TBD | Fraesen, Bohren, Entgraten | NEIN | 7063.152 | Galvanische Trennung konzeptionell; Feuchte, Durchschlag, Kriechen nicht validiert | VOR_ENTWURF
00_PropBoard_Detail_Stehen.FCStd | Schraubenschaft_REF016 | BOLT-REF | Schraubenauswahl TBD | Drehteil / Bauraum | JA | 1753.009 | Gewinde/Kopf/Vorspannung nicht ausgelegt | VOR_ENTWURF
00_PropBoard_Detail_Stehen.FCStd | Schraubenkopf_REF016 | HEAD-REF | Schraubenauswahl TBD | Drehteil / Bauraum | JA | 314.159 |  | VOR_ENTWURF
00_PropBoard_Detail_Stehen.FCStd | Schraubenschaft_REF017 | BOLT-REF | Schraubenauswahl TBD | Drehteil / Bauraum | JA | 1753.009 | Gewinde/Kopf/Vorspannung nicht ausgelegt | VOR_ENTWURF
00_PropBoard_Detail_Stehen.FCStd | Schraubenkopf_REF017 | HEAD-REF | Schraubenauswahl TBD | Drehteil / Bauraum | JA | 314.159 |  | VOR_ENTWURF
00_PropBoard_Detail_Stehen.FCStd | Schraubenschaft_REF018 | BOLT-REF | Schraubenauswahl TBD | Drehteil / Bauraum | JA | 1753.009 | Gewinde/Kopf/Vorspannung nicht ausgelegt | VOR_ENTWURF
00_PropBoard_Detail_Stehen.FCStd | Schraubenkopf_REF018 | HEAD-REF | Schraubenauswahl TBD | Drehteil / Bauraum | JA | 314.159 |  | VOR_ENTWURF
00_PropBoard_Detail_Stehen.FCStd | Schraubenschaft_REF019 | BOLT-REF | Schraubenauswahl TBD | Drehteil / Bauraum | JA | 1753.009 | Gewinde/Kopf/Vorspannung nicht ausgelegt | VOR_ENTWURF
00_PropBoard_Detail_Stehen.FCStd | Schraubenkopf_REF019 | HEAD-REF | Schraubenauswahl TBD | Drehteil / Bauraum | JA | 314.159 |  | VOR_ENTWURF
00_PropBoard_Detail_Stehen.FCStd | Deck_Distanz004 | DECK-SP01 | Isolierender Hartpunkt TBD | Drehteil / Bauraum | NEIN | 4071.504 | Druck-/Kernlast nicht nachgewiesen | VOR_ENTWURF
00_PropBoard_Detail_Stehen.FCStd | Innenstuetze005 | CFK-S02 | CFK Rohr / Laminat TBD | Zuschnitt; Klemm-/Knotenanschluss TBD | NEIN | 49008.845 | Keine Bohrung direkt in tragende CFK-Rohre vorgesehen | VOR_ENTWURF
00_PropBoard_Detail_Stehen.FCStd | Klemmplatte_Schnitt043 | KNOTEN-P01 | Aluminium / Legierung und Zustand TBD | Fraesen, Bohren, Entgraten | NEIN | 56505.218 | Bohrbild 64 x 52, D6.6 als Referenz. Schraubenvorspannung/Klemmdruck nicht ausgelegt. | VOR_ENTWURF
00_PropBoard_Detail_Stehen.FCStd | Klemmplatte_Schnitt047 | KNOTEN-P01 | Aluminium / Legierung und Zustand TBD | Fraesen, Bohren, Entgraten | NEIN | 56505.218 | Bohrbild 64 x 52, D6.6 als Referenz. Schraubenvorspannung/Klemmdruck nicht ausgelegt. | VOR_ENTWURF
00_PropBoard_Detail_Stehen.FCStd | Isolierlage_Knoten_Schnitt063 | ISO-01 | GFK/FR4 TBD | Fraesen, Bohren, Entgraten | NEIN | 7063.152 | Galvanische Trennung konzeptionell; Feuchte, Durchschlag, Kriechen nicht validiert | VOR_ENTWURF
00_PropBoard_Detail_Stehen.FCStd | Isolierlage_Knoten_Schnitt067 | ISO-01 | GFK/FR4 TBD | Fraesen, Bohren, Entgraten | NEIN | 7063.152 | Galvanische Trennung konzeptionell; Feuchte, Durchschlag, Kriechen nicht validiert | VOR_ENTWURF
00_PropBoard_Detail_Stehen.FCStd | Isolierlage_Knoten_Schnitt071 | ISO-01 | GFK/FR4 TBD | Fraesen, Bohren, Entgraten | NEIN | 7063.152 | Galvanische Trennung konzeptionell; Feuchte, Durchschlag, Kriechen nicht validiert | VOR_ENTWURF
00_PropBoard_Detail_Stehen.FCStd | Schraubenschaft_REF020 | BOLT-REF | Schraubenauswahl TBD | Drehteil / Bauraum | JA | 1753.009 | Gewinde/Kopf/Vorspannung nicht ausgelegt | VOR_ENTWURF
00_PropBoard_Detail_Stehen.FCStd | Schraubenkopf_REF020 | HEAD-REF | Schraubenauswahl TBD | Drehteil / Bauraum | JA | 314.159 |  | VOR_ENTWURF
00_PropBoard_Detail_Stehen.FCStd | Schraubenschaft_REF021 | BOLT-REF | Schraubenauswahl TBD | Drehteil / Bauraum | JA | 1753.009 | Gewinde/Kopf/Vorspannung nicht ausgelegt | VOR_ENTWURF
00_PropBoard_Detail_Stehen.FCStd | Schraubenkopf_REF021 | HEAD-REF | Schraubenauswahl TBD | Drehteil / Bauraum | JA | 314.159 |  | VOR_ENTWURF
00_PropBoard_Detail_Stehen.FCStd | Schraubenschaft_REF022 | BOLT-REF | Schraubenauswahl TBD | Drehteil / Bauraum | JA | 1753.009 | Gewinde/Kopf/Vorspannung nicht ausgelegt | VOR_ENTWURF
00_PropBoard_Detail_Stehen.FCStd | Schraubenkopf_REF022 | HEAD-REF | Schraubenauswahl TBD | Drehteil / Bauraum | JA | 314.159 |  | VOR_ENTWURF
00_PropBoard_Detail_Stehen.FCStd | Schraubenschaft_REF023 | BOLT-REF | Schraubenauswahl TBD | Drehteil / Bauraum | JA | 1753.009 | Gewinde/Kopf/Vorspannung nicht ausgelegt | VOR_ENTWURF
00_PropBoard_Detail_Stehen.FCStd | Schraubenkopf_REF023 | HEAD-REF | Schraubenauswahl TBD | Drehteil / Bauraum | JA | 314.159 |  | VOR_ENTWURF
00_PropBoard_Detail_Stehen.FCStd | Deck_Distanz005 | DECK-SP01 | Isolierender Hartpunkt TBD | Drehteil / Bauraum | NEIN | 4071.504 | Druck-/Kernlast nicht nachgewiesen | VOR_ENTWURF
00_PropBoard_Detail_Stehen.FCStd | Deckplatte | DECK-01 | CFK Sandwich / Kern und Laminat TBD | Panelzuschnitt; Hardpoints TBD | NEIN | 2880000.0 | Keine Lasteinleitung in Kern ohne ausgelegte Inserts. Nicht als ungepruefte Stehplatte verwenden. | VOR_ENTWURF
00_PropBoard_Detail_Stehen.FCStd | Knotenwinkel_Bauraum | KNOTEN-REF | Metall + Isolierlagen TBD | Referenzhülle | JA | 87500.0 | Ueberlagerung mit Rohren ist Anschlussbauraum, kein fertiger Formschluss | VOR_ENTWURF
00_PropBoard_Detail_Stehen.FCStd | Knotenwinkel_Bauraum001 | KNOTEN-REF | Metall + Isolierlagen TBD | Referenzhülle | JA | 87500.0 | Ueberlagerung mit Rohren ist Anschlussbauraum, kein fertiger Formschluss | VOR_ENTWURF
00_PropBoard_Detail_Stehen.FCStd | Knotenwinkel_Bauraum002 | KNOTEN-REF | Metall + Isolierlagen TBD | Referenzhülle | JA | 87500.0 | Ueberlagerung mit Rohren ist Anschlussbauraum, kein fertiger Formschluss | VOR_ENTWURF
00_PropBoard_Detail_Stehen.FCStd | Knotenwinkel_Bauraum003 | KNOTEN-REF | Metall + Isolierlagen TBD | Referenzhülle | JA | 87500.0 | Ueberlagerung mit Rohren ist Anschlussbauraum, kein fertiger Formschluss | VOR_ENTWURF
00_PropBoard_Detail_Stehen.FCStd | Knotenwinkel_Bauraum004 | KNOTEN-REF | Metall + Isolierlagen TBD | Referenzhülle | JA | 87500.0 | Ueberlagerung mit Rohren ist Anschlussbauraum, kein fertiger Formschluss | VOR_ENTWURF
00_PropBoard_Detail_Stehen.FCStd | Knotenwinkel_Bauraum005 | KNOTEN-REF | Metall + Isolierlagen TBD | Referenzhülle | JA | 87500.0 | Ueberlagerung mit Rohren ist Anschlussbauraum, kein fertiger Formschluss | VOR_ENTWURF
00_PropBoard_Detail_Stehen.FCStd | C_Rueckwand | FUEHR-C | Aluminium / Zustand TBD | Segmentierte Schiene erforderlich; hier Gesamt-Huelle | NEIN | 624647.765 | C-Profil; Oeffnung zur Fluegelspannweite. Keine Magnet- oder Kontaktkraftauslegung. | VOR_ENTWURF
00_PropBoard_Detail_Stehen.FCStd | C_Flansch | FUEHR-F | Aluminium / Zustand TBD | Segmentierte Schiene erforderlich; hier Gesamt-Huelle | NEIN | 404151.489 | Freiraum/Fangfunktion nur geometrischer Entwurf; Segmente und Stossfugen offen | VOR_ENTWURF
00_PropBoard_Detail_Stehen.FCStd | C_Flansch001 | FUEHR-F | Aluminium / Zustand TBD | Segmentierte Schiene erforderlich; hier Gesamt-Huelle | NEIN | 404151.489 | Freiraum/Fangfunktion nur geometrischer Entwurf; Segmente und Stossfugen offen | VOR_ENTWURF
00_PropBoard_Detail_Stehen.FCStd | Rueckschluss_Eisen | MAG-JOCH | Elektroblech / Paket TBD | Segmentierte Schiene erforderlich; hier Gesamt-Huelle | NEIN | 299854.149 | Keine Saettigungs-, Wirbelstrom- oder Waermenachweise | VOR_ENTWURF
00_PropBoard_Detail_Stehen.FCStd | Stator_Wicklungsraum | LM-STATOR-REF | Wicklungsbauraum, KEIN Vollkupferteil | Segmentierte Schiene erforderlich; hier Gesamt-Huelle | NEIN | 207461.939 | Polteilung, Windungen, Isolation und Strom noch offen | VOR_ENTWURF
00_PropBoard_Detail_Stehen.FCStd | Kontaktlose_Energie_Primaer | IPT-PRI-REF | Induktivsystem TBD | Segmentierte Schiene erforderlich; hier Gesamt-Huelle | NEIN | 41492.388 | Frequenz, Leistung, EMV und Beruehrschutz nicht ausgelegt | VOR_ENTWURF
00_PropBoard_Detail_Stehen.FCStd | C_Rueckwand001 | FUEHR-C | Aluminium / Zustand TBD | Segmentierte Schiene erforderlich; hier Gesamt-Huelle | NEIN | 2131104.274 | C-Profil; Oeffnung zur Fluegelspannweite. Keine Magnet- oder Kontaktkraftauslegung. | VOR_ENTWURF
00_PropBoard_Detail_Stehen.FCStd | C_Flansch002 | FUEHR-F | Aluminium / Zustand TBD | Segmentierte Schiene erforderlich; hier Gesamt-Huelle | NEIN | 1310538.669 | Freiraum/Fangfunktion nur geometrischer Entwurf; Segmente und Stossfugen offen | VOR_ENTWURF
00_PropBoard_Detail_Stehen.FCStd | C_Flansch003 | FUEHR-F | Aluminium / Zustand TBD | Segmentierte Schiene erforderlich; hier Gesamt-Huelle | NEIN | 1310538.669 | Freiraum/Fangfunktion nur geometrischer Entwurf; Segmente und Stossfugen offen | VOR_ENTWURF
00_PropBoard_Detail_Stehen.FCStd | Rueckschluss_Eisen001 | MAG-JOCH | Elektroblech / Paket TBD | Segmentierte Schiene erforderlich; hier Gesamt-Huelle | NEIN | 1047402.404 | Keine Saettigungs-, Wirbelstrom- oder Waermenachweise | VOR_ENTWURF
00_PropBoard_Detail_Stehen.FCStd | Stator_Wicklungsraum001 | LM-STATOR-REF | Wicklungsbauraum, KEIN Vollkupferteil | Segmentierte Schiene erforderlich; hier Gesamt-Huelle | NEIN | 711122.074 | Polteilung, Windungen, Isolation und Strom noch offen | VOR_ENTWURF
00_PropBoard_Detail_Stehen.FCStd | Kontaktlose_Energie_Primaer001 | IPT-PRI-REF | Induktivsystem TBD | Segmentierte Schiene erforderlich; hier Gesamt-Huelle | NEIN | 142224.415 | Frequenz, Leistung, EMV und Beruehrschutz nicht ausgelegt | VOR_ENTWURF
00_PropBoard_Detail_Stehen.FCStd | C_Rueckwand002 | FUEHR-C | Aluminium / Zustand TBD | Segmentierte Schiene erforderlich; hier Gesamt-Huelle | NEIN | 624647.765 | C-Profil; Oeffnung zur Fluegelspannweite. Keine Magnet- oder Kontaktkraftauslegung. | VOR_ENTWURF
00_PropBoard_Detail_Stehen.FCStd | C_Flansch004 | FUEHR-F | Aluminium / Zustand TBD | Segmentierte Schiene erforderlich; hier Gesamt-Huelle | NEIN | 404151.489 | Freiraum/Fangfunktion nur geometrischer Entwurf; Segmente und Stossfugen offen | VOR_ENTWURF
00_PropBoard_Detail_Stehen.FCStd | C_Flansch005 | FUEHR-F | Aluminium / Zustand TBD | Segmentierte Schiene erforderlich; hier Gesamt-Huelle | NEIN | 404151.489 | Freiraum/Fangfunktion nur geometrischer Entwurf; Segmente und Stossfugen offen | VOR_ENTWURF
00_PropBoard_Detail_Stehen.FCStd | Rueckschluss_Eisen002 | MAG-JOCH | Elektroblech / Paket TBD | Segmentierte Schiene erforderlich; hier Gesamt-Huelle | NEIN | 299854.149 | Keine Saettigungs-, Wirbelstrom- oder Waermenachweise | VOR_ENTWURF
00_PropBoard_Detail_Stehen.FCStd | Stator_Wicklungsraum002 | LM-STATOR-REF | Wicklungsbauraum, KEIN Vollkupferteil | Segmentierte Schiene erforderlich; hier Gesamt-Huelle | NEIN | 207461.939 | Polteilung, Windungen, Isolation und Strom noch offen | VOR_ENTWURF
00_PropBoard_Detail_Stehen.FCStd | Kontaktlose_Energie_Primaer002 | IPT-PRI-REF | Induktivsystem TBD | Segmentierte Schiene erforderlich; hier Gesamt-Huelle | NEIN | 41492.388 | Frequenz, Leistung, EMV und Beruehrschutz nicht ausgelegt | VOR_ENTWURF
00_PropBoard_Detail_Stehen.FCStd | C_Rueckwand003 | FUEHR-C | Aluminium / Zustand TBD | Segmentierte Schiene erforderlich; hier Gesamt-Huelle | NEIN | 2131104.274 | C-Profil; Oeffnung zur Fluegelspannweite. Keine Magnet- oder Kontaktkraftauslegung. | VOR_ENTWURF
00_PropBoard_Detail_Stehen.FCStd | C_Flansch006 | FUEHR-F | Aluminium / Zustand TBD | Segmentierte Schiene erforderlich; hier Gesamt-Huelle | NEIN | 1310538.669 | Freiraum/Fangfunktion nur geometrischer Entwurf; Segmente und Stossfugen offen | VOR_ENTWURF
00_PropBoard_Detail_Stehen.FCStd | C_Flansch007 | FUEHR-F | Aluminium / Zustand TBD | Segmentierte Schiene erforderlich; hier Gesamt-Huelle | NEIN | 1310538.669 | Freiraum/Fangfunktion nur geometrischer Entwurf; Segmente und Stossfugen offen | VOR_ENTWURF
00_PropBoard_Detail_Stehen.FCStd | Rueckschluss_Eisen003 | MAG-JOCH | Elektroblech / Paket TBD | Segmentierte Schiene erforderlich; hier Gesamt-Huelle | NEIN | 1047402.404 | Keine Saettigungs-, Wirbelstrom- oder Waermenachweise | VOR_ENTWURF
00_PropBoard_Detail_Stehen.FCStd | Stator_Wicklungsraum003 | LM-STATOR-REF | Wicklungsbauraum, KEIN Vollkupferteil | Segmentierte Schiene erforderlich; hier Gesamt-Huelle | NEIN | 711122.074 | Polteilung, Windungen, Isolation und Strom noch offen | VOR_ENTWURF
00_PropBoard_Detail_Stehen.FCStd | Kontaktlose_Energie_Primaer003 | IPT-PRI-REF | Induktivsystem TBD | Segmentierte Schiene erforderlich; hier Gesamt-Huelle | NEIN | 142224.415 | Frequenz, Leistung, EMV und Beruehrschutz nicht ausgelegt | VOR_ENTWURF
00_PropBoard_Detail_Stehen.FCStd | Aussen_Statorlasche_Schnitt1 | FUEHR-L01 | Aluminium / Legierung und Zustand TBD | Fraesen, Bohren, Entgraten | NEIN | 6933.457 | Backside-Anbindung; isolierter Anschluss an CFK-Stuetze konstruktiv abzustimmen | VOR_ENTWURF
00_PropBoard_Detail_Stehen.FCStd | Innen_Statorlasche_Rohteil | FUEHR-L02 | Aluminium / Legierung und Zustand TBD | Fraesen, Bohren, Entgraten | NEIN | 4320.0 | Montagezone innen; Anbindung und Verbindung nicht festigkeitsvalidiert | VOR_ENTWURF
00_PropBoard_Detail_Stehen.FCStd | Aussen_Statorlasche_Schnitt003 | FUEHR-L01 | Aluminium / Legierung und Zustand TBD | Fraesen, Bohren, Entgraten | NEIN | 6933.457 | Backside-Anbindung; isolierter Anschluss an CFK-Stuetze konstruktiv abzustimmen | VOR_ENTWURF
00_PropBoard_Detail_Stehen.FCStd | Innen_Statorlasche_Rohteil001 | FUEHR-L02 | Aluminium / Legierung und Zustand TBD | Fraesen, Bohren, Entgraten | NEIN | 4320.0 | Montagezone innen; Anbindung und Verbindung nicht festigkeitsvalidiert | VOR_ENTWURF
00_PropBoard_Detail_Stehen.FCStd | Aussen_Statorlasche_Schnitt005 | FUEHR-L01 | Aluminium / Legierung und Zustand TBD | Fraesen, Bohren, Entgraten | NEIN | 6933.457 | Backside-Anbindung; isolierter Anschluss an CFK-Stuetze konstruktiv abzustimmen | VOR_ENTWURF
00_PropBoard_Detail_Stehen.FCStd | Innen_Statorlasche_Rohteil002 | FUEHR-L02 | Aluminium / Legierung und Zustand TBD | Fraesen, Bohren, Entgraten | NEIN | 4320.0 | Montagezone innen; Anbindung und Verbindung nicht festigkeitsvalidiert | VOR_ENTWURF
00_PropBoard_Detail_Stehen.FCStd | Aussen_Statorlasche_Schnitt007 | FUEHR-L01 | Aluminium / Legierung und Zustand TBD | Fraesen, Bohren, Entgraten | NEIN | 6933.457 | Backside-Anbindung; isolierter Anschluss an CFK-Stuetze konstruktiv abzustimmen | VOR_ENTWURF
00_PropBoard_Detail_Stehen.FCStd | Innen_Statorlasche_Rohteil003 | FUEHR-L02 | Aluminium / Legierung und Zustand TBD | Fraesen, Bohren, Entgraten | NEIN | 4320.0 | Montagezone innen; Anbindung und Verbindung nicht festigkeitsvalidiert | VOR_ENTWURF
00_PropBoard_Detail_Stehen.FCStd | Aussen_Statorlasche_Schnitt009 | FUEHR-L01 | Aluminium / Legierung und Zustand TBD | Fraesen, Bohren, Entgraten | NEIN | 6933.457 | Backside-Anbindung; isolierter Anschluss an CFK-Stuetze konstruktiv abzustimmen | VOR_ENTWURF
00_PropBoard_Detail_Stehen.FCStd | Innen_Statorlasche_Rohteil004 | FUEHR-L02 | Aluminium / Legierung und Zustand TBD | Fraesen, Bohren, Entgraten | NEIN | 4320.0 | Montagezone innen; Anbindung und Verbindung nicht festigkeitsvalidiert | VOR_ENTWURF
00_PropBoard_Detail_Stehen.FCStd | Aussen_Statorlasche_Schnitt011 | FUEHR-L01 | Aluminium / Legierung und Zustand TBD | Fraesen, Bohren, Entgraten | NEIN | 6933.457 | Backside-Anbindung; isolierter Anschluss an CFK-Stuetze konstruktiv abzustimmen | VOR_ENTWURF
00_PropBoard_Detail_Stehen.FCStd | Innen_Statorlasche_Rohteil005 | FUEHR-L02 | Aluminium / Legierung und Zustand TBD | Fraesen, Bohren, Entgraten | NEIN | 4320.0 | Montagezone innen; Anbindung und Verbindung nicht festigkeitsvalidiert | VOR_ENTWURF
00_PropBoard_Detail_Stehen.FCStd | Aussen_Statorlasche_Schnitt013 | FUEHR-L01 | Aluminium / Legierung und Zustand TBD | Fraesen, Bohren, Entgraten | NEIN | 6933.457 | Backside-Anbindung; isolierter Anschluss an CFK-Stuetze konstruktiv abzustimmen | VOR_ENTWURF
00_PropBoard_Detail_Stehen.FCStd | Innen_Statorlasche_Rohteil006 | FUEHR-L02 | Aluminium / Legierung und Zustand TBD | Fraesen, Bohren, Entgraten | NEIN | 4320.0 | Montagezone innen; Anbindung und Verbindung nicht festigkeitsvalidiert | VOR_ENTWURF
00_PropBoard_Detail_Stehen.FCStd | Aussen_Statorlasche_Schnitt015 | FUEHR-L01 | Aluminium / Legierung und Zustand TBD | Fraesen, Bohren, Entgraten | NEIN | 6933.457 | Backside-Anbindung; isolierter Anschluss an CFK-Stuetze konstruktiv abzustimmen | VOR_ENTWURF
00_PropBoard_Detail_Stehen.FCStd | Innen_Statorlasche_Rohteil007 | FUEHR-L02 | Aluminium / Legierung und Zustand TBD | Fraesen, Bohren, Entgraten | NEIN | 4320.0 | Montagezone innen; Anbindung und Verbindung nicht festigkeitsvalidiert | VOR_ENTWURF
00_PropBoard_Detail_Stehen.FCStd | Aussen_Statorlasche_Schnitt017 | FUEHR-L01 | Aluminium / Legierung und Zustand TBD | Fraesen, Bohren, Entgraten | NEIN | 6933.457 | Backside-Anbindung; isolierter Anschluss an CFK-Stuetze konstruktiv abzustimmen | VOR_ENTWURF
00_PropBoard_Detail_Stehen.FCStd | Innen_Statorlasche_Rohteil008 | FUEHR-L02 | Aluminium / Legierung und Zustand TBD | Fraesen, Bohren, Entgraten | NEIN | 4320.0 | Montagezone innen; Anbindung und Verbindung nicht festigkeitsvalidiert | VOR_ENTWURF
00_PropBoard_Detail_Stehen.FCStd | Aussen_Statorlasche_Schnitt019 | FUEHR-L01 | Aluminium / Legierung und Zustand TBD | Fraesen, Bohren, Entgraten | NEIN | 6933.457 | Backside-Anbindung; isolierter Anschluss an CFK-Stuetze konstruktiv abzustimmen | VOR_ENTWURF
00_PropBoard_Detail_Stehen.FCStd | Innen_Statorlasche_Rohteil009 | FUEHR-L02 | Aluminium / Legierung und Zustand TBD | Fraesen, Bohren, Entgraten | NEIN | 4320.0 | Montagezone innen; Anbindung und Verbindung nicht festigkeitsvalidiert | VOR_ENTWURF
00_PropBoard_Detail_Stehen.FCStd | Aussen_Statorlasche_Schnitt021 | FUEHR-L01 | Aluminium / Legierung und Zustand TBD | Fraesen, Bohren, Entgraten | NEIN | 6933.457 | Backside-Anbindung; isolierter Anschluss an CFK-Stuetze konstruktiv abzustimmen | VOR_ENTWURF
00_PropBoard_Detail_Stehen.FCStd | Innen_Statorlasche_Rohteil010 | FUEHR-L02 | Aluminium / Legierung und Zustand TBD | Fraesen, Bohren, Entgraten | NEIN | 4320.0 | Montagezone innen; Anbindung und Verbindung nicht festigkeitsvalidiert | VOR_ENTWURF
00_PropBoard_Detail_Stehen.FCStd | Aussen_Statorlasche_Schnitt023 | FUEHR-L01 | Aluminium / Legierung und Zustand TBD | Fraesen, Bohren, Entgraten | NEIN | 6933.457 | Backside-Anbindung; isolierter Anschluss an CFK-Stuetze konstruktiv abzustimmen | VOR_ENTWURF
00_PropBoard_Detail_Stehen.FCStd | Innen_Statorlasche_Rohteil011 | FUEHR-L02 | Aluminium / Legierung und Zustand TBD | Fraesen, Bohren, Entgraten | NEIN | 4320.0 | Montagezone innen; Anbindung und Verbindung nicht festigkeitsvalidiert | VOR_ENTWURF
00_PropBoard_Detail_Stehen.FCStd | Trennschutz_Unterseite | BAT-GUARD | GFK/FR4/Brandkonzept TBD | Zuschnitt | NEIN | 704000.0 | Nur Trenngeometrie. Keine Brand-, Splitter- oder Durchschlagpruefung. | VOR_ENTWURF
00_PropBoard_Detail_Stehen.FCStd | Schubkasten_Boden_Rohteil | BAT-TRAY | Aluminium / Legierung und Zustand TBD | Fraesen, Bohren, Entgraten | NEIN | 528000.0 | Entnahme laengs x; Befestigung und Rueckhaltung offen | VOR_ENTWURF
00_PropBoard_Detail_Stehen.FCStd | Akku_Modulhuelle | BAT-MOD-REF | Akkusystem unbestimmt | Bauraum | JA | 3360000.0 | KEINE Tattu-Auswahl. Energie, Spannung, Strom, Masse und thermischer Aufbau offen. | VOR_ENTWURF
00_PropBoard_Detail_Stehen.FCStd | Gleit_Isolation | BAT-GLEIT | GFK/PEEK TBD | Zuschnitt | NEIN | 77400.0 | Keine Kriech-/Brandfreigabe | VOR_ENTWURF
00_PropBoard_Detail_Stehen.FCStd | Gleit_Isolation001 | BAT-GLEIT | GFK/PEEK TBD | Zuschnitt | NEIN | 77400.0 | Keine Kriech-/Brandfreigabe | VOR_ENTWURF
00_PropBoard_Detail_Stehen.FCStd | Modul_Rueckhaltebuegel_Schnitt1 | BAT-BUEGEL | Aluminium / Legierung und Zustand TBD | Fraesen, Bohren, Entgraten | NEIN | 9257.881 | Positiver Rueckhalt nur Konzept; Belastung, Verriegelung und Sicherung offen | VOR_ENTWURF
00_PropBoard_Detail_Stehen.FCStd | Modul_Rueckhaltebuegel_Schnitt003 | BAT-BUEGEL | Aluminium / Legierung und Zustand TBD | Fraesen, Bohren, Entgraten | NEIN | 9257.881 | Positiver Rueckhalt nur Konzept; Belastung, Verriegelung und Sicherung offen | VOR_ENTWURF
00_PropBoard_Detail_Stehen.FCStd | Akku_Modulhuelle001 | BAT-MOD-REF | Akkusystem unbestimmt | Bauraum | JA | 3360000.0 | KEINE Tattu-Auswahl. Energie, Spannung, Strom, Masse und thermischer Aufbau offen. | VOR_ENTWURF
00_PropBoard_Detail_Stehen.FCStd | Gleit_Isolation002 | BAT-GLEIT | GFK/PEEK TBD | Zuschnitt | NEIN | 77400.0 | Keine Kriech-/Brandfreigabe | VOR_ENTWURF
00_PropBoard_Detail_Stehen.FCStd | Gleit_Isolation003 | BAT-GLEIT | GFK/PEEK TBD | Zuschnitt | NEIN | 77400.0 | Keine Kriech-/Brandfreigabe | VOR_ENTWURF
00_PropBoard_Detail_Stehen.FCStd | Modul_Rueckhaltebuegel_Schnitt005 | BAT-BUEGEL | Aluminium / Legierung und Zustand TBD | Fraesen, Bohren, Entgraten | NEIN | 9257.881 | Positiver Rueckhalt nur Konzept; Belastung, Verriegelung und Sicherung offen | VOR_ENTWURF
00_PropBoard_Detail_Stehen.FCStd | Modul_Rueckhaltebuegel_Schnitt007 | BAT-BUEGEL | Aluminium / Legierung und Zustand TBD | Fraesen, Bohren, Entgraten | NEIN | 9257.881 | Positiver Rueckhalt nur Konzept; Belastung, Verriegelung und Sicherung offen | VOR_ENTWURF
00_PropBoard_Detail_Stehen.FCStd | Servicebox_HV | HV-BOX-REF | Isolierendes Gehaeuse TBD | Bauraum | JA | 504000.0 | BMS, Sicherung, Schuetze, Vorladung, Trennstelle nur Funktionsanforderungen; kein Schaltplan | VOR_ENTWURF
00_PropBoard_Detail_Stehen.FCStd | HV_Kabelraum | HV-CABLE-REF | Kabeltyp/Aderquerschnitt TBD | Routingbauraum | JA | 121494.562 | D12 und R60 nur CAD-Referenz; keine Strombelastbarkeit, Isolations- oder Mindestbiegeradiusfreigabe | VOR_ENTWURF
00_PropBoard_Detail_Stehen.FCStd | LV_Datenraum | LV-CABLE-REF | Daten-/Versorgungstyp TBD | Routingbauraum | JA | 27486.155 | Getrennte Trasse; kein EMV- oder Sicherheitsabstandsnachweis | VOR_ENTWURF
00_PropBoard_Detail_Stehen.FCStd | Stator_Verteilbox | STATOR-JB-REF | Elektronik/Isolation TBD | Bauraum | JA | 63000.0 | Fester Anschluss an untere/obere Statorzonen noch elektrisch auszuarbeiten | VOR_ENTWURF
00_PropBoard_Detail_Stehen.FCStd | Kabelschelle_Isoliert | KABEL-CLIP | Isolierwerkstoff TBD | Klemmhalter | NEIN | 6048.0 | Schellen-Ueberlagerung mit Kabel ist beabsichtigter Halteraum; keine Klemmkraftfreigabe | VOR_ENTWURF
00_PropBoard_Detail_Stehen.FCStd | Kabelschelle_Isoliert001 | KABEL-CLIP | Isolierwerkstoff TBD | Klemmhalter | NEIN | 6048.0 | Schellen-Ueberlagerung mit Kabel ist beabsichtigter Halteraum; keine Klemmkraftfreigabe | VOR_ENTWURF
00_PropBoard_Detail_Stehen.FCStd | Kabelschelle_Isoliert002 | KABEL-CLIP | Isolierwerkstoff TBD | Klemmhalter | NEIN | 6048.0 | Schellen-Ueberlagerung mit Kabel ist beabsichtigter Halteraum; keine Klemmkraftfreigabe | VOR_ENTWURF
00_PropBoard_Detail_Stehen.FCStd | HV_Kabelraum001 | HV-CABLE-REF | Kabeltyp/Aderquerschnitt TBD | Routingbauraum | JA | 121494.562 | D12 und R60 nur CAD-Referenz; keine Strombelastbarkeit, Isolations- oder Mindestbiegeradiusfreigabe | VOR_ENTWURF
00_PropBoard_Detail_Stehen.FCStd | LV_Datenraum001 | LV-CABLE-REF | Daten-/Versorgungstyp TBD | Routingbauraum | JA | 27486.155 | Getrennte Trasse; kein EMV- oder Sicherheitsabstandsnachweis | VOR_ENTWURF
00_PropBoard_Detail_Stehen.FCStd | Stator_Verteilbox001 | STATOR-JB-REF | Elektronik/Isolation TBD | Bauraum | JA | 63000.0 | Fester Anschluss an untere/obere Statorzonen noch elektrisch auszuarbeiten | VOR_ENTWURF
00_PropBoard_Detail_Stehen.FCStd | Kabelschelle_Isoliert003 | KABEL-CLIP | Isolierwerkstoff TBD | Klemmhalter | NEIN | 6048.0 | Schellen-Ueberlagerung mit Kabel ist beabsichtigter Halteraum; keine Klemmkraftfreigabe | VOR_ENTWURF
00_PropBoard_Detail_Stehen.FCStd | Kabelschelle_Isoliert004 | KABEL-CLIP | Isolierwerkstoff TBD | Klemmhalter | NEIN | 6048.0 | Schellen-Ueberlagerung mit Kabel ist beabsichtigter Halteraum; keine Klemmkraftfreigabe | VOR_ENTWURF
00_PropBoard_Detail_Stehen.FCStd | Kabelschelle_Isoliert005 | KABEL-CLIP | Isolierwerkstoff TBD | Klemmhalter | NEIN | 6048.0 | Schellen-Ueberlagerung mit Kabel ist beabsichtigter Halteraum; keine Klemmkraftfreigabe | VOR_ENTWURF
00_PropBoard_Detail_Stehen.FCStd | Fluegel_0_0_Fluegel_Huelle | FL-CFK-REF | CFK Laminat TBD | Formwerkzeug/Laminieren; Profilinnenkontur nur Referenz | NEIN | 251149.264 | Innenkontur skaliert, NICHT konstante Wandstaerke. Kein Laminat-, Flatter- oder Ermuedungsnachweis. | Kopie aus Mechanismus-Datei; lokale Quellen editierbar. | VOR_ENTWURF
00_PropBoard_Detail_Stehen.FCStd | Fluegel_0_0_Pitchwelle | PITCH-W01 | Wellenwerkstoff TBD | Drehteil / Bauraum | NEIN | 32169.909 | Achse bei 50 Prozent Sehne wie Referenzmodell; Torsion und Eigenfrequenz offen | Kopie aus Mechanismus-Datei; lokale Quellen editierbar. | VOR_ENTWURF
00_PropBoard_Detail_Stehen.FCStd | Fluegel_0_0_Schlitten_Traeger | SCHL-01 | Aluminium / Zustand TBD | Fraesen, Querbohren | NEIN | 29848.107 | Lagersitz und integrierter Motorbauraum ohne Passungs-, Last- oder Waermenachweis | Kopie aus Mechanismus-Datei; lokale Quellen editierbar. | VOR_ENTWURF
00_PropBoard_Detail_Stehen.FCStd | Fluegel_0_0_Pitchlager_Sitz | LAGER-G01 | Aluminium TBD | Dreh-/Katalogbauraum | NEIN | 2558.262 | Sitz D22.2 nur Referenz, keine Passungsfreigabe | Kopie aus Mechanismus-Datei; lokale Quellen editierbar. | VOR_ENTWURF
00_PropBoard_Detail_Stehen.FCStd | Fluegel_0_0_Lager_Bauraum | LAGER-REF | Katalogauswahl offen | Dreh-/Katalogbauraum | JA | 2309.071 | Nur Geometrie 8/22/7; kein ausgewaehltes oder lastbewertetes Lager | Kopie aus Mechanismus-Datei; lokale Quellen editierbar. | VOR_ENTWURF
00_PropBoard_Detail_Stehen.FCStd | Fluegel_0_0_Wurzelgabel | PITCH-G01 | Aluminium / Zustand TBD | Fraesen, Querbohren | NEIN | 1395.494 | Lagersitz und integrierter Motorbauraum ohne Passungs-, Last- oder Waermenachweis | Kopie aus Mechanismus-Datei; lokale Quellen editierbar. | VOR_ENTWURF
00_PropBoard_Detail_Stehen.FCStd | Fluegel_0_0_Magnet_0_0 | LM-MAG-REF | Permanentmagnet / Guete TBD | Katalogbauraum | JA | 384.0 | Polsymbol N; Polteilung und Fluss nicht ausgelegt | Kopie aus Mechanismus-Datei; lokale Quellen editierbar. | VOR_ENTWURF
00_PropBoard_Detail_Stehen.FCStd | Fluegel_0_0_Magnet_0_1 | LM-MAG-REF | Permanentmagnet / Guete TBD | Katalogbauraum | JA | 384.0 | Polsymbol S; Polteilung und Fluss nicht ausgelegt | Kopie aus Mechanismus-Datei; lokale Quellen editierbar. | VOR_ENTWURF
00_PropBoard_Detail_Stehen.FCStd | Fluegel_0_0_Fuehrpol_Bauraum | MAG-AKT-REF | Aktives Magnetlager TBD | Referenzvolumen | JA | 1152.0 | Nomineller CAD-Abstand 2 mm zum Flansch; kein funktionsfaehiger Luftspaltnachweis | Kopie aus Mechanismus-Datei; lokale Quellen editierbar. | VOR_ENTWURF
00_PropBoard_Detail_Stehen.FCStd | Fluegel_0_0_Fangrolle | FANG-REF | PEEK / Lager TBD | Drehteil / Bauraum | JA | 565.487 | 1 mm nominelle Restfreiheit; keine Fanglastfreigabe | Kopie aus Mechanismus-Datei; lokale Quellen editierbar. | VOR_ENTWURF
00_PropBoard_Detail_Stehen.FCStd | Fluegel_0_0_Fangrolle001 | FANG-REF | PEEK / Lager TBD | Drehteil / Bauraum | JA | 565.487 | 1 mm nominelle Restfreiheit; keine Fanglastfreigabe | Kopie aus Mechanismus-Datei; lokale Quellen editierbar. | VOR_ENTWURF
00_PropBoard_Detail_Stehen.FCStd | Fluegel_0_0_Fuehrpol_Bauraum001 | MAG-AKT-REF | Aktives Magnetlager TBD | Referenzvolumen | JA | 1152.0 | Nomineller CAD-Abstand 2 mm zum Flansch; kein funktionsfaehiger Luftspaltnachweis | Kopie aus Mechanismus-Datei; lokale Quellen editierbar. | VOR_ENTWURF
00_PropBoard_Detail_Stehen.FCStd | Fluegel_0_0_Fangrolle002 | FANG-REF | PEEK / Lager TBD | Drehteil / Bauraum | JA | 565.487 | 1 mm nominelle Restfreiheit; keine Fanglastfreigabe | Kopie aus Mechanismus-Datei; lokale Quellen editierbar. | VOR_ENTWURF
00_PropBoard_Detail_Stehen.FCStd | Fluegel_0_0_Fangrolle003 | FANG-REF | PEEK / Lager TBD | Drehteil / Bauraum | JA | 565.487 | 1 mm nominelle Restfreiheit; keine Fanglastfreigabe | Kopie aus Mechanismus-Datei; lokale Quellen editierbar. | VOR_ENTWURF
00_PropBoard_Detail_Stehen.FCStd | Fluegel_0_0_Induktiv_Sekundaer | IPT-SEC-REF | Sekundaerwicklung TBD | Bauraum | JA | 2160.0 | Versorgt Pitch/Encoder nur konzeptionell; Leistungsuebertragung nicht nachgewiesen | Kopie aus Mechanismus-Datei; lokale Quellen editierbar. | VOR_ENTWURF
00_PropBoard_Detail_Stehen.FCStd | Fluegel_0_0_Schlitten_Elektronik | CTRL-MOB-REF | Elektronik TBD | Bauraum | JA | 7920.0 | Positionssensor, Pitchregler und Puffer; keine fertige Elektronik | Kopie aus Mechanismus-Datei; lokale Quellen editierbar. | VOR_ENTWURF
00_PropBoard_Detail_Stehen.FCStd | Fluegel_0_0_Schlitten_Traeger001 | SCHL-01 | Aluminium / Zustand TBD | Fraesen, Querbohren | NEIN | 29848.107 | Lagersitz und integrierter Motorbauraum ohne Passungs-, Last- oder Waermenachweis | Kopie aus Mechanismus-Datei; lokale Quellen editierbar. | VOR_ENTWURF
00_PropBoard_Detail_Stehen.FCStd | Fluegel_0_0_Pitchlager_Sitz001 | LAGER-G01 | Aluminium TBD | Dreh-/Katalogbauraum | NEIN | 2558.262 | Sitz D22.2 nur Referenz, keine Passungsfreigabe | Kopie aus Mechanismus-Datei; lokale Quellen editierbar. | VOR_ENTWURF
00_PropBoard_Detail_Stehen.FCStd | Fluegel_0_0_Lager_Bauraum001 | LAGER-REF | Katalogauswahl offen | Dreh-/Katalogbauraum | JA | 2309.071 | Nur Geometrie 8/22/7; kein ausgewaehltes oder lastbewertetes Lager | Kopie aus Mechanismus-Datei; lokale Quellen editierbar. | VOR_ENTWURF
00_PropBoard_Detail_Stehen.FCStd | Fluegel_0_0_Wurzelgabel001 | PITCH-G01 | Aluminium / Zustand TBD | Fraesen, Querbohren | NEIN | 1395.494 | Lagersitz und integrierter Motorbauraum ohne Passungs-, Last- oder Waermenachweis | Kopie aus Mechanismus-Datei; lokale Quellen editierbar. | VOR_ENTWURF
00_PropBoard_Detail_Stehen.FCStd | Fluegel_0_0_Magnet_2_0 | LM-MAG-REF | Permanentmagnet / Guete TBD | Katalogbauraum | JA | 384.0 | Polsymbol N; Polteilung und Fluss nicht ausgelegt | Kopie aus Mechanismus-Datei; lokale Quellen editierbar. | VOR_ENTWURF
00_PropBoard_Detail_Stehen.FCStd | Fluegel_0_0_Magnet_2_1 | LM-MAG-REF | Permanentmagnet / Guete TBD | Katalogbauraum | JA | 384.0 | Polsymbol S; Polteilung und Fluss nicht ausgelegt | Kopie aus Mechanismus-Datei; lokale Quellen editierbar. | VOR_ENTWURF
00_PropBoard_Detail_Stehen.FCStd | Fluegel_0_0_Fuehrpol_Bauraum002 | MAG-AKT-REF | Aktives Magnetlager TBD | Referenzvolumen | JA | 1152.0 | Nomineller CAD-Abstand 2 mm zum Flansch; kein funktionsfaehiger Luftspaltnachweis | Kopie aus Mechanismus-Datei; lokale Quellen editierbar. | VOR_ENTWURF
00_PropBoard_Detail_Stehen.FCStd | Fluegel_0_0_Fangrolle004 | FANG-REF | PEEK / Lager TBD | Drehteil / Bauraum | JA | 565.487 | 1 mm nominelle Restfreiheit; keine Fanglastfreigabe | Kopie aus Mechanismus-Datei; lokale Quellen editierbar. | VOR_ENTWURF
00_PropBoard_Detail_Stehen.FCStd | Fluegel_0_0_Fangrolle005 | FANG-REF | PEEK / Lager TBD | Drehteil / Bauraum | JA | 565.487 | 1 mm nominelle Restfreiheit; keine Fanglastfreigabe | Kopie aus Mechanismus-Datei; lokale Quellen editierbar. | VOR_ENTWURF
00_PropBoard_Detail_Stehen.FCStd | Fluegel_0_0_Fuehrpol_Bauraum003 | MAG-AKT-REF | Aktives Magnetlager TBD | Referenzvolumen | JA | 1152.0 | Nomineller CAD-Abstand 2 mm zum Flansch; kein funktionsfaehiger Luftspaltnachweis | Kopie aus Mechanismus-Datei; lokale Quellen editierbar. | VOR_ENTWURF
00_PropBoard_Detail_Stehen.FCStd | Fluegel_0_0_Fangrolle006 | FANG-REF | PEEK / Lager TBD | Drehteil / Bauraum | JA | 565.487 | 1 mm nominelle Restfreiheit; keine Fanglastfreigabe | Kopie aus Mechanismus-Datei; lokale Quellen editierbar. | VOR_ENTWURF
00_PropBoard_Detail_Stehen.FCStd | Fluegel_0_0_Fangrolle007 | FANG-REF | PEEK / Lager TBD | Drehteil / Bauraum | JA | 565.487 | 1 mm nominelle Restfreiheit; keine Fanglastfreigabe | Kopie aus Mechanismus-Datei; lokale Quellen editierbar. | VOR_ENTWURF
00_PropBoard_Detail_Stehen.FCStd | Fluegel_0_0_Induktiv_Sekundaer001 | IPT-SEC-REF | Sekundaerwicklung TBD | Bauraum | JA | 2160.0 | Versorgt Pitch/Encoder nur konzeptionell; Leistungsuebertragung nicht nachgewiesen | Kopie aus Mechanismus-Datei; lokale Quellen editierbar. | VOR_ENTWURF
00_PropBoard_Detail_Stehen.FCStd | Fluegel_0_0_Schlitten_Elektronik001 | CTRL-MOB-REF | Elektronik TBD | Bauraum | JA | 7920.0 | Positionssensor, Pitchregler und Puffer; keine fertige Elektronik | Kopie aus Mechanismus-Datei; lokale Quellen editierbar. | VOR_ENTWURF
00_PropBoard_Detail_Stehen.FCStd | Fluegel_0_0_Pitch_Torquemotor_Huelle | PITCH-MOT-REF | Direktantrieb TBD | Dreh-/Katalogbauraum | JA | 4763.66 | Integrierter koaxialer Motorbauraum; kein Drehmoment-, Winkelraten- oder Waermenachweis | Kopie aus Mechanismus-Datei; lokale Quellen editierbar. | VOR_ENTWURF
00_PropBoard_Detail_Stehen.FCStd | Fluegel_0_0_Absolutencoder_Bauraum | ENC-REF | Encoder TBD | Dreh-/Katalogbauraum | JA | 582.577 | Referenzhuelle | Kopie aus Mechanismus-Datei; lokale Quellen editierbar. | VOR_ENTWURF
00_PropBoard_Detail_Stehen.FCStd | Fluegel_0_1_Fluegel_Huelle | FL-CFK-REF | CFK Laminat TBD | Formwerkzeug/Laminieren; Profilinnenkontur nur Referenz | NEIN | 251149.264 | Innenkontur skaliert, NICHT konstante Wandstaerke. Kein Laminat-, Flatter- oder Ermuedungsnachweis. | Kopie aus Mechanismus-Datei; lokale Quellen editierbar. | VOR_ENTWURF
00_PropBoard_Detail_Stehen.FCStd | Fluegel_0_1_Pitchwelle | PITCH-W01 | Wellenwerkstoff TBD | Drehteil / Bauraum | NEIN | 32169.909 | Achse bei 50 Prozent Sehne wie Referenzmodell; Torsion und Eigenfrequenz offen | Kopie aus Mechanismus-Datei; lokale Quellen editierbar. | VOR_ENTWURF
00_PropBoard_Detail_Stehen.FCStd | Fluegel_0_1_Schlitten_Traeger | SCHL-01 | Aluminium / Zustand TBD | Fraesen, Querbohren | NEIN | 29848.107 | Lagersitz und integrierter Motorbauraum ohne Passungs-, Last- oder Waermenachweis | Kopie aus Mechanismus-Datei; lokale Quellen editierbar. | VOR_ENTWURF
00_PropBoard_Detail_Stehen.FCStd | Fluegel_0_1_Pitchlager_Sitz | LAGER-G01 | Aluminium TBD | Dreh-/Katalogbauraum | NEIN | 2558.262 | Sitz D22.2 nur Referenz, keine Passungsfreigabe | Kopie aus Mechanismus-Datei; lokale Quellen editierbar. | VOR_ENTWURF
00_PropBoard_Detail_Stehen.FCStd | Fluegel_0_1_Lager_Bauraum | LAGER-REF | Katalogauswahl offen | Dreh-/Katalogbauraum | JA | 2309.071 | Nur Geometrie 8/22/7; kein ausgewaehltes oder lastbewertetes Lager | Kopie aus Mechanismus-Datei; lokale Quellen editierbar. | VOR_ENTWURF
00_PropBoard_Detail_Stehen.FCStd | Fluegel_0_1_Wurzelgabel | PITCH-G01 | Aluminium / Zustand TBD | Fraesen, Querbohren | NEIN | 1395.494 | Lagersitz und integrierter Motorbauraum ohne Passungs-, Last- oder Waermenachweis | Kopie aus Mechanismus-Datei; lokale Quellen editierbar. | VOR_ENTWURF
00_PropBoard_Detail_Stehen.FCStd | Fluegel_0_1_Magnet_0_0 | LM-MAG-REF | Permanentmagnet / Guete TBD | Katalogbauraum | JA | 384.0 | Polsymbol N; Polteilung und Fluss nicht ausgelegt | Kopie aus Mechanismus-Datei; lokale Quellen editierbar. | VOR_ENTWURF
00_PropBoard_Detail_Stehen.FCStd | Fluegel_0_1_Magnet_0_1 | LM-MAG-REF | Permanentmagnet / Guete TBD | Katalogbauraum | JA | 384.0 | Polsymbol S; Polteilung und Fluss nicht ausgelegt | Kopie aus Mechanismus-Datei; lokale Quellen editierbar. | VOR_ENTWURF
00_PropBoard_Detail_Stehen.FCStd | Fluegel_0_1_Fuehrpol_Bauraum | MAG-AKT-REF | Aktives Magnetlager TBD | Referenzvolumen | JA | 1152.0 | Nomineller CAD-Abstand 2 mm zum Flansch; kein funktionsfaehiger Luftspaltnachweis | Kopie aus Mechanismus-Datei; lokale Quellen editierbar. | VOR_ENTWURF
00_PropBoard_Detail_Stehen.FCStd | Fluegel_0_1_Fangrolle | FANG-REF | PEEK / Lager TBD | Drehteil / Bauraum | JA | 565.487 | 1 mm nominelle Restfreiheit; keine Fanglastfreigabe | Kopie aus Mechanismus-Datei; lokale Quellen editierbar. | VOR_ENTWURF
00_PropBoard_Detail_Stehen.FCStd | Fluegel_0_1_Fangrolle001 | FANG-REF | PEEK / Lager TBD | Drehteil / Bauraum | JA | 565.487 | 1 mm nominelle Restfreiheit; keine Fanglastfreigabe | Kopie aus Mechanismus-Datei; lokale Quellen editierbar. | VOR_ENTWURF
00_PropBoard_Detail_Stehen.FCStd | Fluegel_0_1_Fuehrpol_Bauraum001 | MAG-AKT-REF | Aktives Magnetlager TBD | Referenzvolumen | JA | 1152.0 | Nomineller CAD-Abstand 2 mm zum Flansch; kein funktionsfaehiger Luftspaltnachweis | Kopie aus Mechanismus-Datei; lokale Quellen editierbar. | VOR_ENTWURF
00_PropBoard_Detail_Stehen.FCStd | Fluegel_0_1_Fangrolle002 | FANG-REF | PEEK / Lager TBD | Drehteil / Bauraum | JA | 565.487 | 1 mm nominelle Restfreiheit; keine Fanglastfreigabe | Kopie aus Mechanismus-Datei; lokale Quellen editierbar. | VOR_ENTWURF
00_PropBoard_Detail_Stehen.FCStd | Fluegel_0_1_Fangrolle003 | FANG-REF | PEEK / Lager TBD | Drehteil / Bauraum | JA | 565.487 | 1 mm nominelle Restfreiheit; keine Fanglastfreigabe | Kopie aus Mechanismus-Datei; lokale Quellen editierbar. | VOR_ENTWURF
00_PropBoard_Detail_Stehen.FCStd | Fluegel_0_1_Induktiv_Sekundaer | IPT-SEC-REF | Sekundaerwicklung TBD | Bauraum | JA | 2160.0 | Versorgt Pitch/Encoder nur konzeptionell; Leistungsuebertragung nicht nachgewiesen | Kopie aus Mechanismus-Datei; lokale Quellen editierbar. | VOR_ENTWURF
00_PropBoard_Detail_Stehen.FCStd | Fluegel_0_1_Schlitten_Elektronik | CTRL-MOB-REF | Elektronik TBD | Bauraum | JA | 7920.0 | Positionssensor, Pitchregler und Puffer; keine fertige Elektronik | Kopie aus Mechanismus-Datei; lokale Quellen editierbar. | VOR_ENTWURF
00_PropBoard_Detail_Stehen.FCStd | Fluegel_0_1_Schlitten_Traeger001 | SCHL-01 | Aluminium / Zustand TBD | Fraesen, Querbohren | NEIN | 29848.107 | Lagersitz und integrierter Motorbauraum ohne Passungs-, Last- oder Waermenachweis | Kopie aus Mechanismus-Datei; lokale Quellen editierbar. | VOR_ENTWURF
00_PropBoard_Detail_Stehen.FCStd | Fluegel_0_1_Pitchlager_Sitz001 | LAGER-G01 | Aluminium TBD | Dreh-/Katalogbauraum | NEIN | 2558.262 | Sitz D22.2 nur Referenz, keine Passungsfreigabe | Kopie aus Mechanismus-Datei; lokale Quellen editierbar. | VOR_ENTWURF
00_PropBoard_Detail_Stehen.FCStd | Fluegel_0_1_Lager_Bauraum001 | LAGER-REF | Katalogauswahl offen | Dreh-/Katalogbauraum | JA | 2309.071 | Nur Geometrie 8/22/7; kein ausgewaehltes oder lastbewertetes Lager | Kopie aus Mechanismus-Datei; lokale Quellen editierbar. | VOR_ENTWURF
00_PropBoard_Detail_Stehen.FCStd | Fluegel_0_1_Wurzelgabel001 | PITCH-G01 | Aluminium / Zustand TBD | Fraesen, Querbohren | NEIN | 1395.494 | Lagersitz und integrierter Motorbauraum ohne Passungs-, Last- oder Waermenachweis | Kopie aus Mechanismus-Datei; lokale Quellen editierbar. | VOR_ENTWURF
00_PropBoard_Detail_Stehen.FCStd | Fluegel_0_1_Magnet_2_0 | LM-MAG-REF | Permanentmagnet / Guete TBD | Katalogbauraum | JA | 384.0 | Polsymbol N; Polteilung und Fluss nicht ausgelegt | Kopie aus Mechanismus-Datei; lokale Quellen editierbar. | VOR_ENTWURF
00_PropBoard_Detail_Stehen.FCStd | Fluegel_0_1_Magnet_2_1 | LM-MAG-REF | Permanentmagnet / Guete TBD | Katalogbauraum | JA | 384.0 | Polsymbol S; Polteilung und Fluss nicht ausgelegt | Kopie aus Mechanismus-Datei; lokale Quellen editierbar. | VOR_ENTWURF
00_PropBoard_Detail_Stehen.FCStd | Fluegel_0_1_Fuehrpol_Bauraum002 | MAG-AKT-REF | Aktives Magnetlager TBD | Referenzvolumen | JA | 1152.0 | Nomineller CAD-Abstand 2 mm zum Flansch; kein funktionsfaehiger Luftspaltnachweis | Kopie aus Mechanismus-Datei; lokale Quellen editierbar. | VOR_ENTWURF
00_PropBoard_Detail_Stehen.FCStd | Fluegel_0_1_Fangrolle004 | FANG-REF | PEEK / Lager TBD | Drehteil / Bauraum | JA | 565.487 | 1 mm nominelle Restfreiheit; keine Fanglastfreigabe | Kopie aus Mechanismus-Datei; lokale Quellen editierbar. | VOR_ENTWURF
00_PropBoard_Detail_Stehen.FCStd | Fluegel_0_1_Fangrolle005 | FANG-REF | PEEK / Lager TBD | Drehteil / Bauraum | JA | 565.487 | 1 mm nominelle Restfreiheit; keine Fanglastfreigabe | Kopie aus Mechanismus-Datei; lokale Quellen editierbar. | VOR_ENTWURF
00_PropBoard_Detail_Stehen.FCStd | Fluegel_0_1_Fuehrpol_Bauraum003 | MAG-AKT-REF | Aktives Magnetlager TBD | Referenzvolumen | JA | 1152.0 | Nomineller CAD-Abstand 2 mm zum Flansch; kein funktionsfaehiger Luftspaltnachweis | Kopie aus Mechanismus-Datei; lokale Quellen editierbar. | VOR_ENTWURF
00_PropBoard_Detail_Stehen.FCStd | Fluegel_0_1_Fangrolle006 | FANG-REF | PEEK / Lager TBD | Drehteil / Bauraum | JA | 565.487 | 1 mm nominelle Restfreiheit; keine Fanglastfreigabe | Kopie aus Mechanismus-Datei; lokale Quellen editierbar. | VOR_ENTWURF
00_PropBoard_Detail_Stehen.FCStd | Fluegel_0_1_Fangrolle007 | FANG-REF | PEEK / Lager TBD | Drehteil / Bauraum | JA | 565.487 | 1 mm nominelle Restfreiheit; keine Fanglastfreigabe | Kopie aus Mechanismus-Datei; lokale Quellen editierbar. | VOR_ENTWURF
00_PropBoard_Detail_Stehen.FCStd | Fluegel_0_1_Induktiv_Sekundaer001 | IPT-SEC-REF | Sekundaerwicklung TBD | Bauraum | JA | 2160.0 | Versorgt Pitch/Encoder nur konzeptionell; Leistungsuebertragung nicht nachgewiesen | Kopie aus Mechanismus-Datei; lokale Quellen editierbar. | VOR_ENTWURF
00_PropBoard_Detail_Stehen.FCStd | Fluegel_0_1_Schlitten_Elektronik001 | CTRL-MOB-REF | Elektronik TBD | Bauraum | JA | 7920.0 | Positionssensor, Pitchregler und Puffer; keine fertige Elektronik | Kopie aus Mechanismus-Datei; lokale Quellen editierbar. | VOR_ENTWURF
00_PropBoard_Detail_Stehen.FCStd | Fluegel_0_1_Pitch_Torquemotor_Huelle | PITCH-MOT-REF | Direktantrieb TBD | Dreh-/Katalogbauraum | JA | 4763.66 | Integrierter koaxialer Motorbauraum; kein Drehmoment-, Winkelraten- oder Waermenachweis | Kopie aus Mechanismus-Datei; lokale Quellen editierbar. | VOR_ENTWURF
00_PropBoard_Detail_Stehen.FCStd | Fluegel_0_1_Absolutencoder_Bauraum | ENC-REF | Encoder TBD | Dreh-/Katalogbauraum | JA | 582.577 | Referenzhuelle | Kopie aus Mechanismus-Datei; lokale Quellen editierbar. | VOR_ENTWURF
00_PropBoard_Detail_Stehen.FCStd | Fluegel_0_2_Fluegel_Huelle | FL-CFK-REF | CFK Laminat TBD | Formwerkzeug/Laminieren; Profilinnenkontur nur Referenz | NEIN | 251149.264 | Innenkontur skaliert, NICHT konstante Wandstaerke. Kein Laminat-, Flatter- oder Ermuedungsnachweis. | Kopie aus Mechanismus-Datei; lokale Quellen editierbar. | VOR_ENTWURF
00_PropBoard_Detail_Stehen.FCStd | Fluegel_0_2_Pitchwelle | PITCH-W01 | Wellenwerkstoff TBD | Drehteil / Bauraum | NEIN | 32169.909 | Achse bei 50 Prozent Sehne wie Referenzmodell; Torsion und Eigenfrequenz offen | Kopie aus Mechanismus-Datei; lokale Quellen editierbar. | VOR_ENTWURF
00_PropBoard_Detail_Stehen.FCStd | Fluegel_0_2_Schlitten_Traeger | SCHL-01 | Aluminium / Zustand TBD | Fraesen, Querbohren | NEIN | 29848.107 | Lagersitz und integrierter Motorbauraum ohne Passungs-, Last- oder Waermenachweis | Kopie aus Mechanismus-Datei; lokale Quellen editierbar. | VOR_ENTWURF
00_PropBoard_Detail_Stehen.FCStd | Fluegel_0_2_Pitchlager_Sitz | LAGER-G01 | Aluminium TBD | Dreh-/Katalogbauraum | NEIN | 2558.262 | Sitz D22.2 nur Referenz, keine Passungsfreigabe | Kopie aus Mechanismus-Datei; lokale Quellen editierbar. | VOR_ENTWURF
00_PropBoard_Detail_Stehen.FCStd | Fluegel_0_2_Lager_Bauraum | LAGER-REF | Katalogauswahl offen | Dreh-/Katalogbauraum | JA | 2309.071 | Nur Geometrie 8/22/7; kein ausgewaehltes oder lastbewertetes Lager | Kopie aus Mechanismus-Datei; lokale Quellen editierbar. | VOR_ENTWURF
00_PropBoard_Detail_Stehen.FCStd | Fluegel_0_2_Wurzelgabel | PITCH-G01 | Aluminium / Zustand TBD | Fraesen, Querbohren | NEIN | 1395.494 | Lagersitz und integrierter Motorbauraum ohne Passungs-, Last- oder Waermenachweis | Kopie aus Mechanismus-Datei; lokale Quellen editierbar. | VOR_ENTWURF
00_PropBoard_Detail_Stehen.FCStd | Fluegel_0_2_Magnet_0_0 | LM-MAG-REF | Permanentmagnet / Guete TBD | Katalogbauraum | JA | 384.0 | Polsymbol N; Polteilung und Fluss nicht ausgelegt | Kopie aus Mechanismus-Datei; lokale Quellen editierbar. | VOR_ENTWURF
00_PropBoard_Detail_Stehen.FCStd | Fluegel_0_2_Magnet_0_1 | LM-MAG-REF | Permanentmagnet / Guete TBD | Katalogbauraum | JA | 384.0 | Polsymbol S; Polteilung und Fluss nicht ausgelegt | Kopie aus Mechanismus-Datei; lokale Quellen editierbar. | VOR_ENTWURF
00_PropBoard_Detail_Stehen.FCStd | Fluegel_0_2_Fuehrpol_Bauraum | MAG-AKT-REF | Aktives Magnetlager TBD | Referenzvolumen | JA | 1152.0 | Nomineller CAD-Abstand 2 mm zum Flansch; kein funktionsfaehiger Luftspaltnachweis | Kopie aus Mechanismus-Datei; lokale Quellen editierbar. | VOR_ENTWURF
00_PropBoard_Detail_Stehen.FCStd | Fluegel_0_2_Fangrolle | FANG-REF | PEEK / Lager TBD | Drehteil / Bauraum | JA | 565.487 | 1 mm nominelle Restfreiheit; keine Fanglastfreigabe | Kopie aus Mechanismus-Datei; lokale Quellen editierbar. | VOR_ENTWURF
00_PropBoard_Detail_Stehen.FCStd | Fluegel_0_2_Fangrolle001 | FANG-REF | PEEK / Lager TBD | Drehteil / Bauraum | JA | 565.487 | 1 mm nominelle Restfreiheit; keine Fanglastfreigabe | Kopie aus Mechanismus-Datei; lokale Quellen editierbar. | VOR_ENTWURF
00_PropBoard_Detail_Stehen.FCStd | Fluegel_0_2_Fuehrpol_Bauraum001 | MAG-AKT-REF | Aktives Magnetlager TBD | Referenzvolumen | JA | 1152.0 | Nomineller CAD-Abstand 2 mm zum Flansch; kein funktionsfaehiger Luftspaltnachweis | Kopie aus Mechanismus-Datei; lokale Quellen editierbar. | VOR_ENTWURF
00_PropBoard_Detail_Stehen.FCStd | Fluegel_0_2_Fangrolle002 | FANG-REF | PEEK / Lager TBD | Drehteil / Bauraum | JA | 565.487 | 1 mm nominelle Restfreiheit; keine Fanglastfreigabe | Kopie aus Mechanismus-Datei; lokale Quellen editierbar. | VOR_ENTWURF
00_PropBoard_Detail_Stehen.FCStd | Fluegel_0_2_Fangrolle003 | FANG-REF | PEEK / Lager TBD | Drehteil / Bauraum | JA | 565.487 | 1 mm nominelle Restfreiheit; keine Fanglastfreigabe | Kopie aus Mechanismus-Datei; lokale Quellen editierbar. | VOR_ENTWURF
00_PropBoard_Detail_Stehen.FCStd | Fluegel_0_2_Induktiv_Sekundaer | IPT-SEC-REF | Sekundaerwicklung TBD | Bauraum | JA | 2160.0 | Versorgt Pitch/Encoder nur konzeptionell; Leistungsuebertragung nicht nachgewiesen | Kopie aus Mechanismus-Datei; lokale Quellen editierbar. | VOR_ENTWURF
00_PropBoard_Detail_Stehen.FCStd | Fluegel_0_2_Schlitten_Elektronik | CTRL-MOB-REF | Elektronik TBD | Bauraum | JA | 7920.0 | Positionssensor, Pitchregler und Puffer; keine fertige Elektronik | Kopie aus Mechanismus-Datei; lokale Quellen editierbar. | VOR_ENTWURF
00_PropBoard_Detail_Stehen.FCStd | Fluegel_0_2_Schlitten_Traeger001 | SCHL-01 | Aluminium / Zustand TBD | Fraesen, Querbohren | NEIN | 29848.107 | Lagersitz und integrierter Motorbauraum ohne Passungs-, Last- oder Waermenachweis | Kopie aus Mechanismus-Datei; lokale Quellen editierbar. | VOR_ENTWURF
00_PropBoard_Detail_Stehen.FCStd | Fluegel_0_2_Pitchlager_Sitz001 | LAGER-G01 | Aluminium TBD | Dreh-/Katalogbauraum | NEIN | 2558.262 | Sitz D22.2 nur Referenz, keine Passungsfreigabe | Kopie aus Mechanismus-Datei; lokale Quellen editierbar. | VOR_ENTWURF
00_PropBoard_Detail_Stehen.FCStd | Fluegel_0_2_Lager_Bauraum001 | LAGER-REF | Katalogauswahl offen | Dreh-/Katalogbauraum | JA | 2309.071 | Nur Geometrie 8/22/7; kein ausgewaehltes oder lastbewertetes Lager | Kopie aus Mechanismus-Datei; lokale Quellen editierbar. | VOR_ENTWURF
00_PropBoard_Detail_Stehen.FCStd | Fluegel_0_2_Wurzelgabel001 | PITCH-G01 | Aluminium / Zustand TBD | Fraesen, Querbohren | NEIN | 1395.494 | Lagersitz und integrierter Motorbauraum ohne Passungs-, Last- oder Waermenachweis | Kopie aus Mechanismus-Datei; lokale Quellen editierbar. | VOR_ENTWURF
00_PropBoard_Detail_Stehen.FCStd | Fluegel_0_2_Magnet_2_0 | LM-MAG-REF | Permanentmagnet / Guete TBD | Katalogbauraum | JA | 384.0 | Polsymbol N; Polteilung und Fluss nicht ausgelegt | Kopie aus Mechanismus-Datei; lokale Quellen editierbar. | VOR_ENTWURF
00_PropBoard_Detail_Stehen.FCStd | Fluegel_0_2_Magnet_2_1 | LM-MAG-REF | Permanentmagnet / Guete TBD | Katalogbauraum | JA | 384.0 | Polsymbol S; Polteilung und Fluss nicht ausgelegt | Kopie aus Mechanismus-Datei; lokale Quellen editierbar. | VOR_ENTWURF
00_PropBoard_Detail_Stehen.FCStd | Fluegel_0_2_Fuehrpol_Bauraum002 | MAG-AKT-REF | Aktives Magnetlager TBD | Referenzvolumen | JA | 1152.0 | Nomineller CAD-Abstand 2 mm zum Flansch; kein funktionsfaehiger Luftspaltnachweis | Kopie aus Mechanismus-Datei; lokale Quellen editierbar. | VOR_ENTWURF
00_PropBoard_Detail_Stehen.FCStd | Fluegel_0_2_Fangrolle004 | FANG-REF | PEEK / Lager TBD | Drehteil / Bauraum | JA | 565.487 | 1 mm nominelle Restfreiheit; keine Fanglastfreigabe | Kopie aus Mechanismus-Datei; lokale Quellen editierbar. | VOR_ENTWURF
00_PropBoard_Detail_Stehen.FCStd | Fluegel_0_2_Fangrolle005 | FANG-REF | PEEK / Lager TBD | Drehteil / Bauraum | JA | 565.487 | 1 mm nominelle Restfreiheit; keine Fanglastfreigabe | Kopie aus Mechanismus-Datei; lokale Quellen editierbar. | VOR_ENTWURF
00_PropBoard_Detail_Stehen.FCStd | Fluegel_0_2_Fuehrpol_Bauraum003 | MAG-AKT-REF | Aktives Magnetlager TBD | Referenzvolumen | JA | 1152.0 | Nomineller CAD-Abstand 2 mm zum Flansch; kein funktionsfaehiger Luftspaltnachweis | Kopie aus Mechanismus-Datei; lokale Quellen editierbar. | VOR_ENTWURF
00_PropBoard_Detail_Stehen.FCStd | Fluegel_0_2_Fangrolle006 | FANG-REF | PEEK / Lager TBD | Drehteil / Bauraum | JA | 565.487 | 1 mm nominelle Restfreiheit; keine Fanglastfreigabe | Kopie aus Mechanismus-Datei; lokale Quellen editierbar. | VOR_ENTWURF
00_PropBoard_Detail_Stehen.FCStd | Fluegel_0_2_Fangrolle007 | FANG-REF | PEEK / Lager TBD | Drehteil / Bauraum | JA | 565.487 | 1 mm nominelle Restfreiheit; keine Fanglastfreigabe | Kopie aus Mechanismus-Datei; lokale Quellen editierbar. | VOR_ENTWURF
00_PropBoard_Detail_Stehen.FCStd | Fluegel_0_2_Induktiv_Sekundaer001 | IPT-SEC-REF | Sekundaerwicklung TBD | Bauraum | JA | 2160.0 | Versorgt Pitch/Encoder nur konzeptionell; Leistungsuebertragung nicht nachgewiesen | Kopie aus Mechanismus-Datei; lokale Quellen editierbar. | VOR_ENTWURF
00_PropBoard_Detail_Stehen.FCStd | Fluegel_0_2_Schlitten_Elektronik001 | CTRL-MOB-REF | Elektronik TBD | Bauraum | JA | 7920.0 | Positionssensor, Pitchregler und Puffer; keine fertige Elektronik | Kopie aus Mechanismus-Datei; lokale Quellen editierbar. | VOR_ENTWURF
00_PropBoard_Detail_Stehen.FCStd | Fluegel_0_2_Pitch_Torquemotor_Huelle | PITCH-MOT-REF | Direktantrieb TBD | Dreh-/Katalogbauraum | JA | 4763.66 | Integrierter koaxialer Motorbauraum; kein Drehmoment-, Winkelraten- oder Waermenachweis | Kopie aus Mechanismus-Datei; lokale Quellen editierbar. | VOR_ENTWURF
00_PropBoard_Detail_Stehen.FCStd | Fluegel_0_2_Absolutencoder_Bauraum | ENC-REF | Encoder TBD | Dreh-/Katalogbauraum | JA | 582.577 | Referenzhuelle | Kopie aus Mechanismus-Datei; lokale Quellen editierbar. | VOR_ENTWURF
00_PropBoard_Detail_Stehen.FCStd | Fluegel_0_3_Fluegel_Huelle | FL-CFK-REF | CFK Laminat TBD | Formwerkzeug/Laminieren; Profilinnenkontur nur Referenz | NEIN | 251149.264 | Innenkontur skaliert, NICHT konstante Wandstaerke. Kein Laminat-, Flatter- oder Ermuedungsnachweis. | Kopie aus Mechanismus-Datei; lokale Quellen editierbar. | VOR_ENTWURF
00_PropBoard_Detail_Stehen.FCStd | Fluegel_0_3_Pitchwelle | PITCH-W01 | Wellenwerkstoff TBD | Drehteil / Bauraum | NEIN | 32169.909 | Achse bei 50 Prozent Sehne wie Referenzmodell; Torsion und Eigenfrequenz offen | Kopie aus Mechanismus-Datei; lokale Quellen editierbar. | VOR_ENTWURF
00_PropBoard_Detail_Stehen.FCStd | Fluegel_0_3_Schlitten_Traeger | SCHL-01 | Aluminium / Zustand TBD | Fraesen, Querbohren | NEIN | 29848.107 | Lagersitz und integrierter Motorbauraum ohne Passungs-, Last- oder Waermenachweis | Kopie aus Mechanismus-Datei; lokale Quellen editierbar. | VOR_ENTWURF
00_PropBoard_Detail_Stehen.FCStd | Fluegel_0_3_Pitchlager_Sitz | LAGER-G01 | Aluminium TBD | Dreh-/Katalogbauraum | NEIN | 2558.262 | Sitz D22.2 nur Referenz, keine Passungsfreigabe | Kopie aus Mechanismus-Datei; lokale Quellen editierbar. | VOR_ENTWURF
00_PropBoard_Detail_Stehen.FCStd | Fluegel_0_3_Lager_Bauraum | LAGER-REF | Katalogauswahl offen | Dreh-/Katalogbauraum | JA | 2309.071 | Nur Geometrie 8/22/7; kein ausgewaehltes oder lastbewertetes Lager | Kopie aus Mechanismus-Datei; lokale Quellen editierbar. | VOR_ENTWURF
00_PropBoard_Detail_Stehen.FCStd | Fluegel_0_3_Wurzelgabel | PITCH-G01 | Aluminium / Zustand TBD | Fraesen, Querbohren | NEIN | 1395.494 | Lagersitz und integrierter Motorbauraum ohne Passungs-, Last- oder Waermenachweis | Kopie aus Mechanismus-Datei; lokale Quellen editierbar. | VOR_ENTWURF
00_PropBoard_Detail_Stehen.FCStd | Fluegel_0_3_Magnet_0_0 | LM-MAG-REF | Permanentmagnet / Guete TBD | Katalogbauraum | JA | 384.0 | Polsymbol N; Polteilung und Fluss nicht ausgelegt | Kopie aus Mechanismus-Datei; lokale Quellen editierbar. | VOR_ENTWURF
00_PropBoard_Detail_Stehen.FCStd | Fluegel_0_3_Magnet_0_1 | LM-MAG-REF | Permanentmagnet / Guete TBD | Katalogbauraum | JA | 384.0 | Polsymbol S; Polteilung und Fluss nicht ausgelegt | Kopie aus Mechanismus-Datei; lokale Quellen editierbar. | VOR_ENTWURF
00_PropBoard_Detail_Stehen.FCStd | Fluegel_0_3_Fuehrpol_Bauraum | MAG-AKT-REF | Aktives Magnetlager TBD | Referenzvolumen | JA | 1152.0 | Nomineller CAD-Abstand 2 mm zum Flansch; kein funktionsfaehiger Luftspaltnachweis | Kopie aus Mechanismus-Datei; lokale Quellen editierbar. | VOR_ENTWURF
00_PropBoard_Detail_Stehen.FCStd | Fluegel_0_3_Fangrolle | FANG-REF | PEEK / Lager TBD | Drehteil / Bauraum | JA | 565.487 | 1 mm nominelle Restfreiheit; keine Fanglastfreigabe | Kopie aus Mechanismus-Datei; lokale Quellen editierbar. | VOR_ENTWURF
00_PropBoard_Detail_Stehen.FCStd | Fluegel_0_3_Fangrolle001 | FANG-REF | PEEK / Lager TBD | Drehteil / Bauraum | JA | 565.487 | 1 mm nominelle Restfreiheit; keine Fanglastfreigabe | Kopie aus Mechanismus-Datei; lokale Quellen editierbar. | VOR_ENTWURF
00_PropBoard_Detail_Stehen.FCStd | Fluegel_0_3_Fuehrpol_Bauraum001 | MAG-AKT-REF | Aktives Magnetlager TBD | Referenzvolumen | JA | 1152.0 | Nomineller CAD-Abstand 2 mm zum Flansch; kein funktionsfaehiger Luftspaltnachweis | Kopie aus Mechanismus-Datei; lokale Quellen editierbar. | VOR_ENTWURF
00_PropBoard_Detail_Stehen.FCStd | Fluegel_0_3_Fangrolle002 | FANG-REF | PEEK / Lager TBD | Drehteil / Bauraum | JA | 565.487 | 1 mm nominelle Restfreiheit; keine Fanglastfreigabe | Kopie aus Mechanismus-Datei; lokale Quellen editierbar. | VOR_ENTWURF
00_PropBoard_Detail_Stehen.FCStd | Fluegel_0_3_Fangrolle003 | FANG-REF | PEEK / Lager TBD | Drehteil / Bauraum | JA | 565.487 | 1 mm nominelle Restfreiheit; keine Fanglastfreigabe | Kopie aus Mechanismus-Datei; lokale Quellen editierbar. | VOR_ENTWURF
00_PropBoard_Detail_Stehen.FCStd | Fluegel_0_3_Induktiv_Sekundaer | IPT-SEC-REF | Sekundaerwicklung TBD | Bauraum | JA | 2160.0 | Versorgt Pitch/Encoder nur konzeptionell; Leistungsuebertragung nicht nachgewiesen | Kopie aus Mechanismus-Datei; lokale Quellen editierbar. | VOR_ENTWURF
00_PropBoard_Detail_Stehen.FCStd | Fluegel_0_3_Schlitten_Elektronik | CTRL-MOB-REF | Elektronik TBD | Bauraum | JA | 7920.0 | Positionssensor, Pitchregler und Puffer; keine fertige Elektronik | Kopie aus Mechanismus-Datei; lokale Quellen editierbar. | VOR_ENTWURF
00_PropBoard_Detail_Stehen.FCStd | Fluegel_0_3_Schlitten_Traeger001 | SCHL-01 | Aluminium / Zustand TBD | Fraesen, Querbohren | NEIN | 29848.107 | Lagersitz und integrierter Motorbauraum ohne Passungs-, Last- oder Waermenachweis | Kopie aus Mechanismus-Datei; lokale Quellen editierbar. | VOR_ENTWURF
00_PropBoard_Detail_Stehen.FCStd | Fluegel_0_3_Pitchlager_Sitz001 | LAGER-G01 | Aluminium TBD | Dreh-/Katalogbauraum | NEIN | 2558.262 | Sitz D22.2 nur Referenz, keine Passungsfreigabe | Kopie aus Mechanismus-Datei; lokale Quellen editierbar. | VOR_ENTWURF
00_PropBoard_Detail_Stehen.FCStd | Fluegel_0_3_Lager_Bauraum001 | LAGER-REF | Katalogauswahl offen | Dreh-/Katalogbauraum | JA | 2309.071 | Nur Geometrie 8/22/7; kein ausgewaehltes oder lastbewertetes Lager | Kopie aus Mechanismus-Datei; lokale Quellen editierbar. | VOR_ENTWURF
00_PropBoard_Detail_Stehen.FCStd | Fluegel_0_3_Wurzelgabel001 | PITCH-G01 | Aluminium / Zustand TBD | Fraesen, Querbohren | NEIN | 1395.494 | Lagersitz und integrierter Motorbauraum ohne Passungs-, Last- oder Waermenachweis | Kopie aus Mechanismus-Datei; lokale Quellen editierbar. | VOR_ENTWURF
00_PropBoard_Detail_Stehen.FCStd | Fluegel_0_3_Magnet_2_0 | LM-MAG-REF | Permanentmagnet / Guete TBD | Katalogbauraum | JA | 384.0 | Polsymbol N; Polteilung und Fluss nicht ausgelegt | Kopie aus Mechanismus-Datei; lokale Quellen editierbar. | VOR_ENTWURF
00_PropBoard_Detail_Stehen.FCStd | Fluegel_0_3_Magnet_2_1 | LM-MAG-REF | Permanentmagnet / Guete TBD | Katalogbauraum | JA | 384.0 | Polsymbol S; Polteilung und Fluss nicht ausgelegt | Kopie aus Mechanismus-Datei; lokale Quellen editierbar. | VOR_ENTWURF
00_PropBoard_Detail_Stehen.FCStd | Fluegel_0_3_Fuehrpol_Bauraum002 | MAG-AKT-REF | Aktives Magnetlager TBD | Referenzvolumen | JA | 1152.0 | Nomineller CAD-Abstand 2 mm zum Flansch; kein funktionsfaehiger Luftspaltnachweis | Kopie aus Mechanismus-Datei; lokale Quellen editierbar. | VOR_ENTWURF
00_PropBoard_Detail_Stehen.FCStd | Fluegel_0_3_Fangrolle004 | FANG-REF | PEEK / Lager TBD | Drehteil / Bauraum | JA | 565.487 | 1 mm nominelle Restfreiheit; keine Fanglastfreigabe | Kopie aus Mechanismus-Datei; lokale Quellen editierbar. | VOR_ENTWURF
00_PropBoard_Detail_Stehen.FCStd | Fluegel_0_3_Fangrolle005 | FANG-REF | PEEK / Lager TBD | Drehteil / Bauraum | JA | 565.487 | 1 mm nominelle Restfreiheit; keine Fanglastfreigabe | Kopie aus Mechanismus-Datei; lokale Quellen editierbar. | VOR_ENTWURF
00_PropBoard_Detail_Stehen.FCStd | Fluegel_0_3_Fuehrpol_Bauraum003 | MAG-AKT-REF | Aktives Magnetlager TBD | Referenzvolumen | JA | 1152.0 | Nomineller CAD-Abstand 2 mm zum Flansch; kein funktionsfaehiger Luftspaltnachweis | Kopie aus Mechanismus-Datei; lokale Quellen editierbar. | VOR_ENTWURF
00_PropBoard_Detail_Stehen.FCStd | Fluegel_0_3_Fangrolle006 | FANG-REF | PEEK / Lager TBD | Drehteil / Bauraum | JA | 565.487 | 1 mm nominelle Restfreiheit; keine Fanglastfreigabe | Kopie aus Mechanismus-Datei; lokale Quellen editierbar. | VOR_ENTWURF
00_PropBoard_Detail_Stehen.FCStd | Fluegel_0_3_Fangrolle007 | FANG-REF | PEEK / Lager TBD | Drehteil / Bauraum | JA | 565.487 | 1 mm nominelle Restfreiheit; keine Fanglastfreigabe | Kopie aus Mechanismus-Datei; lokale Quellen editierbar. | VOR_ENTWURF
00_PropBoard_Detail_Stehen.FCStd | Fluegel_0_3_Induktiv_Sekundaer001 | IPT-SEC-REF | Sekundaerwicklung TBD | Bauraum | JA | 2160.0 | Versorgt Pitch/Encoder nur konzeptionell; Leistungsuebertragung nicht nachgewiesen | Kopie aus Mechanismus-Datei; lokale Quellen editierbar. | VOR_ENTWURF
00_PropBoard_Detail_Stehen.FCStd | Fluegel_0_3_Schlitten_Elektronik001 | CTRL-MOB-REF | Elektronik TBD | Bauraum | JA | 7920.0 | Positionssensor, Pitchregler und Puffer; keine fertige Elektronik | Kopie aus Mechanismus-Datei; lokale Quellen editierbar. | VOR_ENTWURF
00_PropBoard_Detail_Stehen.FCStd | Fluegel_0_3_Pitch_Torquemotor_Huelle | PITCH-MOT-REF | Direktantrieb TBD | Dreh-/Katalogbauraum | JA | 4763.66 | Integrierter koaxialer Motorbauraum; kein Drehmoment-, Winkelraten- oder Waermenachweis | Kopie aus Mechanismus-Datei; lokale Quellen editierbar. | VOR_ENTWURF
00_PropBoard_Detail_Stehen.FCStd | Fluegel_0_3_Absolutencoder_Bauraum | ENC-REF | Encoder TBD | Dreh-/Katalogbauraum | JA | 582.577 | Referenzhuelle | Kopie aus Mechanismus-Datei; lokale Quellen editierbar. | VOR_ENTWURF
00_PropBoard_Detail_Stehen.FCStd | Fluegel_0_4_Fluegel_Huelle | FL-CFK-REF | CFK Laminat TBD | Formwerkzeug/Laminieren; Profilinnenkontur nur Referenz | NEIN | 251149.264 | Innenkontur skaliert, NICHT konstante Wandstaerke. Kein Laminat-, Flatter- oder Ermuedungsnachweis. | Kopie aus Mechanismus-Datei; lokale Quellen editierbar. | VOR_ENTWURF
00_PropBoard_Detail_Stehen.FCStd | Fluegel_0_4_Pitchwelle | PITCH-W01 | Wellenwerkstoff TBD | Drehteil / Bauraum | NEIN | 32169.909 | Achse bei 50 Prozent Sehne wie Referenzmodell; Torsion und Eigenfrequenz offen | Kopie aus Mechanismus-Datei; lokale Quellen editierbar. | VOR_ENTWURF
00_PropBoard_Detail_Stehen.FCStd | Fluegel_0_4_Schlitten_Traeger | SCHL-01 | Aluminium / Zustand TBD | Fraesen, Querbohren | NEIN | 29848.107 | Lagersitz und integrierter Motorbauraum ohne Passungs-, Last- oder Waermenachweis | Kopie aus Mechanismus-Datei; lokale Quellen editierbar. | VOR_ENTWURF
00_PropBoard_Detail_Stehen.FCStd | Fluegel_0_4_Pitchlager_Sitz | LAGER-G01 | Aluminium TBD | Dreh-/Katalogbauraum | NEIN | 2558.262 | Sitz D22.2 nur Referenz, keine Passungsfreigabe | Kopie aus Mechanismus-Datei; lokale Quellen editierbar. | VOR_ENTWURF
00_PropBoard_Detail_Stehen.FCStd | Fluegel_0_4_Lager_Bauraum | LAGER-REF | Katalogauswahl offen | Dreh-/Katalogbauraum | JA | 2309.071 | Nur Geometrie 8/22/7; kein ausgewaehltes oder lastbewertetes Lager | Kopie aus Mechanismus-Datei; lokale Quellen editierbar. | VOR_ENTWURF
00_PropBoard_Detail_Stehen.FCStd | Fluegel_0_4_Wurzelgabel | PITCH-G01 | Aluminium / Zustand TBD | Fraesen, Querbohren | NEIN | 1395.494 | Lagersitz und integrierter Motorbauraum ohne Passungs-, Last- oder Waermenachweis | Kopie aus Mechanismus-Datei; lokale Quellen editierbar. | VOR_ENTWURF
00_PropBoard_Detail_Stehen.FCStd | Fluegel_0_4_Magnet_0_0 | LM-MAG-REF | Permanentmagnet / Guete TBD | Katalogbauraum | JA | 384.0 | Polsymbol N; Polteilung und Fluss nicht ausgelegt | Kopie aus Mechanismus-Datei; lokale Quellen editierbar. | VOR_ENTWURF
00_PropBoard_Detail_Stehen.FCStd | Fluegel_0_4_Magnet_0_1 | LM-MAG-REF | Permanentmagnet / Guete TBD | Katalogbauraum | JA | 384.0 | Polsymbol S; Polteilung und Fluss nicht ausgelegt | Kopie aus Mechanismus-Datei; lokale Quellen editierbar. | VOR_ENTWURF
00_PropBoard_Detail_Stehen.FCStd | Fluegel_0_4_Fuehrpol_Bauraum | MAG-AKT-REF | Aktives Magnetlager TBD | Referenzvolumen | JA | 1152.0 | Nomineller CAD-Abstand 2 mm zum Flansch; kein funktionsfaehiger Luftspaltnachweis | Kopie aus Mechanismus-Datei; lokale Quellen editierbar. | VOR_ENTWURF
00_PropBoard_Detail_Stehen.FCStd | Fluegel_0_4_Fangrolle | FANG-REF | PEEK / Lager TBD | Drehteil / Bauraum | JA | 565.487 | 1 mm nominelle Restfreiheit; keine Fanglastfreigabe | Kopie aus Mechanismus-Datei; lokale Quellen editierbar. | VOR_ENTWURF
00_PropBoard_Detail_Stehen.FCStd | Fluegel_0_4_Fangrolle001 | FANG-REF | PEEK / Lager TBD | Drehteil / Bauraum | JA | 565.487 | 1 mm nominelle Restfreiheit; keine Fanglastfreigabe | Kopie aus Mechanismus-Datei; lokale Quellen editierbar. | VOR_ENTWURF
00_PropBoard_Detail_Stehen.FCStd | Fluegel_0_4_Fuehrpol_Bauraum001 | MAG-AKT-REF | Aktives Magnetlager TBD | Referenzvolumen | JA | 1152.0 | Nomineller CAD-Abstand 2 mm zum Flansch; kein funktionsfaehiger Luftspaltnachweis | Kopie aus Mechanismus-Datei; lokale Quellen editierbar. | VOR_ENTWURF
00_PropBoard_Detail_Stehen.FCStd | Fluegel_0_4_Fangrolle002 | FANG-REF | PEEK / Lager TBD | Drehteil / Bauraum | JA | 565.487 | 1 mm nominelle Restfreiheit; keine Fanglastfreigabe | Kopie aus Mechanismus-Datei; lokale Quellen editierbar. | VOR_ENTWURF
00_PropBoard_Detail_Stehen.FCStd | Fluegel_0_4_Fangrolle003 | FANG-REF | PEEK / Lager TBD | Drehteil / Bauraum | JA | 565.487 | 1 mm nominelle Restfreiheit; keine Fanglastfreigabe | Kopie aus Mechanismus-Datei; lokale Quellen editierbar. | VOR_ENTWURF
00_PropBoard_Detail_Stehen.FCStd | Fluegel_0_4_Induktiv_Sekundaer | IPT-SEC-REF | Sekundaerwicklung TBD | Bauraum | JA | 2160.0 | Versorgt Pitch/Encoder nur konzeptionell; Leistungsuebertragung nicht nachgewiesen | Kopie aus Mechanismus-Datei; lokale Quellen editierbar. | VOR_ENTWURF
00_PropBoard_Detail_Stehen.FCStd | Fluegel_0_4_Schlitten_Elektronik | CTRL-MOB-REF | Elektronik TBD | Bauraum | JA | 7920.0 | Positionssensor, Pitchregler und Puffer; keine fertige Elektronik | Kopie aus Mechanismus-Datei; lokale Quellen editierbar. | VOR_ENTWURF
00_PropBoard_Detail_Stehen.FCStd | Fluegel_0_4_Schlitten_Traeger001 | SCHL-01 | Aluminium / Zustand TBD | Fraesen, Querbohren | NEIN | 29848.107 | Lagersitz und integrierter Motorbauraum ohne Passungs-, Last- oder Waermenachweis | Kopie aus Mechanismus-Datei; lokale Quellen editierbar. | VOR_ENTWURF
00_PropBoard_Detail_Stehen.FCStd | Fluegel_0_4_Pitchlager_Sitz001 | LAGER-G01 | Aluminium TBD | Dreh-/Katalogbauraum | NEIN | 2558.262 | Sitz D22.2 nur Referenz, keine Passungsfreigabe | Kopie aus Mechanismus-Datei; lokale Quellen editierbar. | VOR_ENTWURF
00_PropBoard_Detail_Stehen.FCStd | Fluegel_0_4_Lager_Bauraum001 | LAGER-REF | Katalogauswahl offen | Dreh-/Katalogbauraum | JA | 2309.071 | Nur Geometrie 8/22/7; kein ausgewaehltes oder lastbewertetes Lager | Kopie aus Mechanismus-Datei; lokale Quellen editierbar. | VOR_ENTWURF
00_PropBoard_Detail_Stehen.FCStd | Fluegel_0_4_Wurzelgabel001 | PITCH-G01 | Aluminium / Zustand TBD | Fraesen, Querbohren | NEIN | 1395.494 | Lagersitz und integrierter Motorbauraum ohne Passungs-, Last- oder Waermenachweis | Kopie aus Mechanismus-Datei; lokale Quellen editierbar. | VOR_ENTWURF
00_PropBoard_Detail_Stehen.FCStd | Fluegel_0_4_Magnet_2_0 | LM-MAG-REF | Permanentmagnet / Guete TBD | Katalogbauraum | JA | 384.0 | Polsymbol N; Polteilung und Fluss nicht ausgelegt | Kopie aus Mechanismus-Datei; lokale Quellen editierbar. | VOR_ENTWURF
00_PropBoard_Detail_Stehen.FCStd | Fluegel_0_4_Magnet_2_1 | LM-MAG-REF | Permanentmagnet / Guete TBD | Katalogbauraum | JA | 384.0 | Polsymbol S; Polteilung und Fluss nicht ausgelegt | Kopie aus Mechanismus-Datei; lokale Quellen editierbar. | VOR_ENTWURF
00_PropBoard_Detail_Stehen.FCStd | Fluegel_0_4_Fuehrpol_Bauraum002 | MAG-AKT-REF | Aktives Magnetlager TBD | Referenzvolumen | JA | 1152.0 | Nomineller CAD-Abstand 2 mm zum Flansch; kein funktionsfaehiger Luftspaltnachweis | Kopie aus Mechanismus-Datei; lokale Quellen editierbar. | VOR_ENTWURF
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
