ITSMEEME/PropBoard/modell_r04_taumel/cad/Stueckliste.csv

BauteilID | Herstellung | Anzahl | Masse_gesamt_g
FUEHRUNGSSTIFT-D3 | Kauf | 2 | 1.0
KUGELBOLZEN-M2 | Kauf | 38 | 19.0
LAGER-6806 | Kauf | 4 | 76
LAGER-6809 | Kauf | 2 | 64
MITNEHMERSTIFT-D3 | Kauf | 2 | 2.2
MITTELROHR-AL-D30x1 | Kauf | 1 | 47.2
MOTOR-ECO2-2306 | Kauf | 2 | 64
MOTORWELLE-M5 | Teil Motor | 2 | 0
RITZEL-M1-Z20 | Kauf | 2 | 16
SERVO-PLATZHALTER | Kauf | 6 | 54
SERVOSTANGE | Kauf | 6 | 6.0
STEUERSTANGE | Kauf | 16 | 16.0
STIFT-D2x18 | Kauf | 32 | 14.2
TM-DECKEL-ZAHNKRANZ-130 | Druck | 2 | 61.3
TM-FLUEGEL | Druck | 16 | 142.7
TM-HALTEPLATTE | Druck | 2 | 48.9
TM-HUELSE-MITTE | Druck | 1 | 6.5
TM-KAPPE-STACK-PRUEFSTAND | Druck | 2 | 11.9
TM-KLEMMRING | Druck | 2 | 1.2
TM-NABE | Druck | 2 | 59.1
TM-PITCHHEBEL | Druck | 16 | 6.8
TM-TAUMEL-DREHRING | Druck | 2 | 18.0
TM-TAUMEL-GLEITKUGEL | Druck | 2 | 10.0
TM-TAUMEL-INNENRING | Druck | 2 | 15.5
BATTERY | Kauf | 1 | 255
FC_ESC | Kauf | 1 | 26
RECEIVER | Kauf | 1 | 3
WIRING | Kauf | 1 | 45
