ITSMEEME/PropBoard/modell_r04/cad/Stueckliste.csv

BauteilID | Herstellung | Anzahl | Masse_gesamt_g
LAGER-6806 | Kauf | 4 | 76
MITTELROHR-AL-D30x1 | Kauf | 1 | 49.2
MOTOR-ECO2-2306 | Kauf | 2 | 64
MOTORWELLE-M5 | Teil Motor | 2 | 0
RITZEL-M1-Z14 | Kauf | 2 | 12
ROT-ESP32C3 | Kauf | 2 | 6
ROT-SCHALTER | Kauf | 2 | 4
ROT-ZELLE-1S | Kauf | 4 | 36
SERVO-PLATZHALTER | Kauf | 16 | 144
STIFT-D2x20 | Kauf | 32 | 15.7
TM-FLUEGEL | Druck | 16 | 126.1
TM-HALTEPLATTE | Druck | 2 | 32.6
TM-HUELSE-AUSSEN | Druck | 2 | 10.6
TM-HUELSE-MITTE | Druck | 1 | 5.2
TM-MITNEHMER | Druck | 16 | 7.0
TM-NABE | Druck | 2 | 221.5
TM-ZAHNKRANZ-91 | Druck | 2 | 48.0
BATTERY | Kauf | 1 | 255
FC_ESC | Kauf | 1 | 26
RECEIVER | Kauf | 1 | 3
BRIDGE | Kauf | 1 | 3
WIRING | Kauf | 1 | 50
