ITSMEEME/PropBoard/entwicklung_ab/Ausgabe/HEXA_R265/Stueckliste.csv

id | label | group | material | mass_kg | volume_mm3 | cg_mm | solid_count | mass_override | note
CENTER_FRAME | Zentralrahmen 40×40×2,5 | new_static | CFK | 0.6098000000000002 | 381125.0000000002 | [1.7410754236983652e-13, 6.042218655005715e-15, -110.00000000000003] | 1 | False | Rohranschlüsse als starrer Ersatz; reale Klemmen und Laminatnachweis offen
ARM_0 | CFK-Ausleger 1 | new_static | CFK | 0.2873999999999998 | 179624.99999999988 | [374.5000000000002, 2.0169326658837026e-15, -110.00000000000001] | 1 | False | Geometrievorschlag; Last-/Montagenachweis offen
MOUNT_0 | Motorträger 170×170×8, PCD50-Annahme | new_static | Aluminium | 0.6465956619957364 | 230105.217792077 | [614.0, -2.648186147340999e-16, -85.99999999999999] | 1 | False | 4×Ø6,6 auf PCD50 als Platzhalter; neuer Motor noch nicht ausgewählt
MOTOR_0 | Motorbauraum Ø150×66, neuer Typ offen | motor | Reserve | 2.75 | 1166316.2726452108 | [614.0, 3.9283686047564325e-16, -48.999999999999986] | 1 | True | 2,75 kg freie Masseannahme; kein ausgewählter Motor, keine bestätigte Dauerkennlinie oder Montage
HUB_0 | Rotornabe Nennkörper | rotor | Aluminium | 0.3575289519417864 | 127234.50247038662 | [614.0, 2.5602470623908294e-15, -5.999999999999999] | 1 | False | Anschluss-, Lager- und Blattwurzelkonstruktion noch offen
BLADE_0_0 | Profilblatt 3-Blatt-Referenz, Schalenmasse geschätzt | rotor | CFK | 0.16926565732383253 | 76630.43355969888 | [791.5, 11.976009885896335, 2.985954626880723] | 1 | True | Vollprofil als äußere Hülle, 2×1,2mm Schalenmasse +120g Wurzel/Spar; Laminat und Hubanschluss offen
GRIP_0_0 | Nabensteg mit formgleichem Blattwurzel-Nennsitz | rotor | Aluminium | 0.13108701446383794 | 46650.18308321635 | [682.821527342916, -0.41126551884416523, -0.10254001045168011] | 1 | False | Geometrische Lastpfadreserve Nabe–Blatt; Teilung, Bolzen, CFK-Klemmdruck, Fliehkraft und Ermüdung offen
BLADE_0_1 | Profilblatt 3-Blatt-Referenz, Schalenmasse geschätzt | rotor | CFK | 0.16926565732383253 | 76630.43355969887 | [514.8784712028404, 147.7315042287897, 2.985954626880724] | 1 | True | Vollprofil als äußere Hülle, 2×1,2mm Schalenmasse +120g Wurzel/Spar; Laminat und Hubanschluss offen
GRIP_0_1 | Nabensteg mit formgleichem Blattwurzel-Nennsitz | rotor | Aluminium | 0.13108701446383794 | 46650.18308321634 | [579.9454027155617, 59.80682376563236, -0.1025400104516811] | 1 | False | Geometrische Lastpfadreserve Nabe–Blatt; Teilung, Bolzen, CFK-Klemmdruck, Fliehkraft und Ermüdung offen
BLADE_0_2 | Profilblatt 3-Blatt-Referenz, Schalenmasse geschätzt | rotor | CFK | 0.16926565732383253 | 76630.43355969887 | [535.6215287971598, -159.70751411468598, 2.9859546268807216] | 1 | True | Vollprofil als äußere Hülle, 2×1,2mm Schalenmasse +120g Wurzel/Spar; Laminat und Hubanschluss offen
GRIP_0_2 | Nabensteg mit formgleichem Blattwurzel-Nennsitz | rotor | Aluminium | 0.1310870144638379 | 46650.183083216325 | [579.2330699415224, -59.3955582467882, -0.10254001045168006] | 1 | False | Geometrische Lastpfadreserve Nabe–Blatt; Teilung, Bolzen, CFK-Klemmdruck, Fliehkraft und Ermüdung offen
ESC_0 | ESC-Platzhalter 120×65×22 | electronics | Reserve | 0.21666666666666667 | 171600.0 | [337.7000000000001, -4.736951571734001e-16, -149.0] | 1 | True | Massenbudget; Strom, Spannung, Kühlung und Befestigung offen
ARM_1 | CFK-Ausleger 2 | new_static | CFK | 0.2873999999999999 | 179624.99999999994 | [187.2500000000001, 324.32651371727235, -110.0] | 1 | False | Geometrievorschlag; Last-/Montagenachweis offen
MOUNT_1 | Motorträger 170×170×8, PCD50-Annahme | new_static | Aluminium | 0.6465956619957365 | 230105.21779207702 | [307.00000000000006, 531.7395979236454, -85.99999999999999] | 1 | False | 4×Ø6,6 auf PCD50 als Platzhalter; neuer Motor noch nicht ausgewählt
MOTOR_1 | Motorbauraum Ø150×66, neuer Typ offen | motor | Reserve | 2.75 | 1166316.2726452108 | [307.0000000000001, 531.7395979236453, -48.999999999999986] | 1 | True | 2,75 kg freie Masseannahme; kein ausgewählter Motor, keine bestätigte Dauerkennlinie oder Montage
HUB_1 | Rotornabe Nennkörper | rotor | Aluminium | 0.35752895194178635 | 127234.5024703866 | [307.0000000000001, 531.7395979236454, -6.000000000000001] | 1 | False | Anschluss-, Lager- und Blattwurzelkonstruktion noch offen
BLADE_1_0 | Profilblatt 3-Blatt-Referenz, Schalenmasse geschätzt | rotor | CFK | 0.16926565732383253 | 76630.43355969888 | [484.50000000000006, 543.7156078095418, 2.9859546268807233] | 1 | True | Vollprofil als äußere Hülle, 2×1,2mm Schalenmasse +120g Wurzel/Spar; Laminat und Hubanschluss offen
GRIP_1_0 | Nabensteg mit formgleichem Blattwurzel-Nennsitz | rotor | Aluminium | 0.13108701446383794 | 46650.18308321635 | [375.821527342916, 531.3283324048014, -0.10254001045167897] | 1 | False | Geometrische Lastpfadreserve Nabe–Blatt; Teilung, Bolzen, CFK-Klemmdruck, Fliehkraft und Ermüdung offen
BLADE_1_1 | Profilblatt 3-Blatt-Referenz, Schalenmasse geschätzt | rotor | CFK | 0.16926565732383253 | 76630.43355969888 | [207.87847120284036, 679.4711021524352, 2.985954626880721] | 1 | True | Vollprofil als äußere Hülle, 2×1,2mm Schalenmasse +120g Wurzel/Spar; Laminat und Hubanschluss offen
GRIP_1_1 | Nabensteg mit formgleichem Blattwurzel-Nennsitz | rotor | Aluminium | 0.1310870144638379 | 46650.183083216325 | [272.9454027155619, 591.5464216892774, -0.10254001045167961] | 1 | False | Geometrische Lastpfadreserve Nabe–Blatt; Teilung, Bolzen, CFK-Klemmdruck, Fliehkraft und Ermüdung offen
BLADE_1_2 | Profilblatt 3-Blatt-Referenz, Schalenmasse geschätzt | rotor | CFK | 0.16926565732383253 | 76630.43355969887 | [228.62152879715987, 372.03208380895944, 2.9859546268807238] | 1 | True | Vollprofil als äußere Hülle, 2×1,2mm Schalenmasse +120g Wurzel/Spar; Laminat und Hubanschluss offen
GRIP_1_2 | Nabensteg mit formgleichem Blattwurzel-Nennsitz | rotor | Aluminium | 0.13108701446383794 | 46650.18308321634 | [272.2330699415228, 472.34403967685705, -0.10254001045168042] | 1 | False | Geometrische Lastpfadreserve Nabe–Blatt; Teilung, Bolzen, CFK-Klemmdruck, Fliehkraft und Ermüdung offen
ESC_1 | ESC-Platzhalter 120×65×22 | electronics | Reserve | 0.21666666666666667 | 171600.0 | [168.85000000000008, 292.456778858005, -149.0] | 1 | True | Massenbudget; Strom, Spannung, Kühlung und Befestigung offen
ARM_2 | CFK-Ausleger 3 | new_static | CFK | 0.2873999999999998 | 179624.99999999988 | [-187.2499999999999, 324.3265137172723, -110.00000000000001] | 1 | False | Geometrievorschlag; Last-/Montagenachweis offen
MOUNT_2 | Motorträger 170×170×8, PCD50-Annahme | new_static | Aluminium | 0.6465956619957365 | 230105.21779207705 | [-306.9999999999999, 531.7395979236454, -85.99999999999997] | 1 | False | 4×Ø6,6 auf PCD50 als Platzhalter; neuer Motor noch nicht ausgewählt
MOTOR_2 | Motorbauraum Ø150×66, neuer Typ offen | motor | Reserve | 2.75 | 1166316.2726452108 | [-306.99999999999994, 531.7395979236454, -48.99999999999999] | 1 | True | 2,75 kg freie Masseannahme; kein ausgewählter Motor, keine bestätigte Dauerkennlinie oder Montage
HUB_2 | Rotornabe Nennkörper | rotor | Aluminium | 0.35752895194178635 | 127234.5024703866 | [-307.0, 531.7395979236454, -6.000000000000001] | 1 | False | Anschluss-, Lager- und Blattwurzelkonstruktion noch offen
BLADE_2_0 | Profilblatt 3-Blatt-Referenz, Schalenmasse geschätzt | rotor | CFK | 0.16926565732383253 | 76630.43355969888 | [-129.49999999999997, 543.7156078095418, 2.985954626880723] | 1 | True | Vollprofil als äußere Hülle, 2×1,2mm Schalenmasse +120g Wurzel/Spar; Laminat und Hubanschluss offen
GRIP_2_0 | Nabensteg mit formgleichem Blattwurzel-Nennsitz | rotor | Aluminium | 0.13108701446383797 | 46650.183083216354 | [-238.17847265708428, 531.3283324048016, -0.102540010451679] | 1 | False | Geometrische Lastpfadreserve Nabe–Blatt; Teilung, Bolzen, CFK-Klemmdruck, Fliehkraft und Ermüdung offen
BLADE_2_1 | Profilblatt 3-Blatt-Referenz, Schalenmasse geschätzt | rotor | CFK | 0.16926565732383253 | 76630.43355969885 | [-406.1215287971597, 679.4711021524352, 2.985954626880723] | 1 | True | Vollprofil als äußere Hülle, 2×1,2mm Schalenmasse +120g Wurzel/Spar; Laminat und Hubanschluss offen
GRIP_2_1 | Nabensteg mit formgleichem Blattwurzel-Nennsitz | rotor | Aluminium | 0.1310870144638379 | 46650.18308321633 | [-341.054597284438, 591.5464216892776, -0.1025400104516797] | 1 | False | Geometrische Lastpfadreserve Nabe–Blatt; Teilung, Bolzen, CFK-Klemmdruck, Fliehkraft und Ermüdung offen
BLADE_2_2 | Profilblatt 3-Blatt-Referenz, Schalenmasse geschätzt | rotor | CFK | 0.16926565732383253 | 76630.43355969887 | [-385.3784712028402, 372.0320838089593, 2.9859546268807224] | 1 | True | Vollprofil als äußere Hülle, 2×1,2mm Schalenmasse +120g Wurzel/Spar; Laminat und Hubanschluss offen
GRIP_2_2 | Nabensteg mit formgleichem Blattwurzel-Nennsitz | rotor | Aluminium | 0.13108701446383794 | 46650.18308321634 | [-341.76693005847716, 472.34403967685705, -0.10254001045168071] | 1 | False | Geometrische Lastpfadreserve Nabe–Blatt; Teilung, Bolzen, CFK-Klemmdruck, Fliehkraft und Ermüdung offen
ESC_2 | ESC-Platzhalter 120×65×22 | electronics | Reserve | 0.21666666666666667 | 171600.0 | [-168.85, 292.456778858005, -149.0] | 1 | True | Massenbudget; Strom, Spannung, Kühlung und Befestigung offen
ARM_3 | CFK-Ausleger 4 | new_static | CFK | 0.28740000000000016 | 179625.00000000006 | [-374.5000000000001, 4.169999034928063e-14, -110.0] | 1 | False | Geometrievorschlag; Last-/Montagenachweis offen
MOUNT_3 | Motorträger 170×170×8, PCD50-Annahme | new_static | Aluminium | 0.6465956619957365 | 230105.21779207702 | [-614.0000000000002, 7.173817697647632e-14, -85.99999999999997] | 1 | False | 4×Ø6,6 auf PCD50 als Platzhalter; neuer Motor noch nicht ausgewählt
MOTOR_3 | Motorbauraum Ø150×66, neuer Typ offen | motor | Reserve | 2.75 | 1166316.2726452108 | [-614.0000000000001, 7.558615032812309e-14, -48.999999999999986] | 1 | True | 2,75 kg freie Masseannahme; kein ausgewählter Motor, keine bestätigte Dauerkennlinie oder Montage
HUB_3 | Rotornabe Nennkörper | rotor | Aluminium | 0.3575289519417864 | 127234.50247038662 | [-614.0000000000001, 7.775356053003833e-14, -5.999999999999999] | 1 | False | Anschluss-, Lager- und Blattwurzelkonstruktion noch offen
BLADE_3_0 | Profilblatt 3-Blatt-Referenz, Schalenmasse geschätzt | rotor | CFK | 0.16926565732383253 | 76630.43355969887 | [-436.5000000000001, 11.976009885896415, 2.985954626880723] | 1 | True | Vollprofil als äußere Hülle, 2×1,2mm Schalenmasse +120g Wurzel/Spar; Laminat und Hubanschluss offen
GRIP_3_0 | Nabensteg mit formgleichem Blattwurzel-Nennsitz | rotor | Aluminium | 0.13108701446383794 | 46650.18308321635 | [-545.1784726570843, -0.41126551884409157, -0.10254001045167993] | 1 | False | Geometrische Lastpfadreserve Nabe–Blatt; Teilung, Bolzen, CFK-Klemmdruck, Fliehkraft und Ermüdung offen
BLADE_3_1 | Profilblatt 3-Blatt-Referenz, Schalenmasse geschätzt | rotor | CFK | 0.16926565732383253 | 76630.43355969884 | [-713.1215287971598, 147.73150422878982, 2.9859546268807216] | 1 | True | Vollprofil als äußere Hülle, 2×1,2mm Schalenmasse +120g Wurzel/Spar; Laminat und Hubanschluss offen
GRIP_3_1 | Nabensteg mit formgleichem Blattwurzel-Nennsitz | rotor | Aluminium | 0.13108701446383786 | 46650.18308321632 | [-648.0545972844386, 59.80682376563244, -0.10254001045168121] | 1 | False | Geometrische Lastpfadreserve Nabe–Blatt; Teilung, Bolzen, CFK-Klemmdruck, Fliehkraft und Ermüdung offen
BLADE_3_2 | Profilblatt 3-Blatt-Referenz, Schalenmasse geschätzt | rotor | CFK | 0.16926565732383253 | 76630.43355969887 | [-692.3784712028404, -159.70751411468592, 2.985954626880723] | 1 | True | Vollprofil als äußere Hülle, 2×1,2mm Schalenmasse +120g Wurzel/Spar; Laminat und Hubanschluss offen
GRIP_3_2 | Nabensteg mit formgleichem Blattwurzel-Nennsitz | rotor | Aluminium | 0.13108701446383786 | 46650.18308321632 | [-648.7669300584777, -59.39555824678812, -0.1025400104516802] | 1 | False | Geometrische Lastpfadreserve Nabe–Blatt; Teilung, Bolzen, CFK-Klemmdruck, Fliehkraft und Ermüdung offen
ESC_3 | ESC-Platzhalter 120×65×22 | electronics | Reserve | 0.21666666666666667 | 171600.0 | [-337.7000000000001, 4.284765928923627e-14, -149.0] | 1 | True | Massenbudget; Strom, Spannung, Kühlung und Befestigung offen
ARM_4 | CFK-Ausleger 5 | new_static | CFK | 0.28740000000000027 | 179625.00000000015 | [-187.25000000000034, -324.3265137172722, -110.0] | 1 | False | Geometrievorschlag; Last-/Montagenachweis offen
MOUNT_4 | Motorträger 170×170×8, PCD50-Annahme | new_static | Aluminium | 0.6465956619957365 | 230105.21779207705 | [-307.00000000000034, -531.7395979236452, -85.99999999999996] | 1 | False | 4×Ø6,6 auf PCD50 als Platzhalter; neuer Motor noch nicht ausgewählt
MOTOR_4 | Motorbauraum Ø150×66, neuer Typ offen | motor | Reserve | 2.75 | 1166316.2726452108 | [-307.00000000000034, -531.7395979236453, -48.99999999999999] | 1 | True | 2,75 kg freie Masseannahme; kein ausgewählter Motor, keine bestätigte Dauerkennlinie oder Montage
HUB_4 | Rotornabe Nennkörper | rotor | Aluminium | 0.35752895194178635 | 127234.5024703866 | [-307.00000000000034, -531.7395979236453, -6.000000000000001] | 1 | False | Anschluss-, Lager- und Blattwurzelkonstruktion noch offen
BLADE_4_0 | Profilblatt 3-Blatt-Referenz, Schalenmasse geschätzt | rotor | CFK | 0.16926565732383253 | 76630.43355969885 | [-129.50000000000028, -519.763588037749, 2.9859546268807216] | 1 | True | Vollprofil als äußere Hülle, 2×1,2mm Schalenmasse +120g Wurzel/Spar; Laminat und Hubanschluss offen
GRIP_4_0 | Nabensteg mit formgleichem Blattwurzel-Nennsitz | rotor | Aluminium | 0.13108701446383794 | 46650.18308321634 | [-238.1784726570846, -532.1508634424891, -0.10254001045168205] | 1 | False | Geometrische Lastpfadreserve Nabe–Blatt; Teilung, Bolzen, CFK-Klemmdruck, Fliehkraft und Ermüdung offen
BLADE_4_1 | Profilblatt 3-Blatt-Referenz, Schalenmasse geschätzt | rotor | CFK | 0.16926565732383253 | 76630.43355969887 | [-406.1215287971601, -384.00809369485563, 2.9859546268807224] | 1 | True | Vollprofil als äußere Hülle, 2×1,2mm Schalenmasse +120g Wurzel/Spar; Laminat und Hubanschluss offen
GRIP_4_1 | Nabensteg mit formgleichem Blattwurzel-Nennsitz | rotor | Aluminium | 0.13108701446383797 | 46650.183083216354 | [-341.0545972844384, -471.9327741580126, -0.10254001045167882] | 1 | False | Geometrische Lastpfadreserve Nabe–Blatt; Teilung, Bolzen, CFK-Klemmdruck, Fliehkraft und Ermüdung offen
BLADE_4_2 | Profilblatt 3-Blatt-Referenz, Schalenmasse geschätzt | rotor | CFK | 0.16926565732383253 | 76630.43355969887 | [-385.3784712028406, -691.4471120383313, 2.985954626880721] | 1 | True | Vollprofil als äußere Hülle, 2×1,2mm Schalenmasse +120g Wurzel/Spar; Laminat und Hubanschluss offen
GRIP_4_2 | Nabensteg mit formgleichem Blattwurzel-Nennsitz | rotor | Aluminium | 0.1310870144638379 | 46650.183083216325 | [-341.7669300584776, -591.1351561704334, -0.10254001045168076] | 1 | False | Geometrische Lastpfadreserve Nabe–Blatt; Teilung, Bolzen, CFK-Klemmdruck, Fliehkraft und Ermüdung offen
ESC_4 | ESC-Platzhalter 120×65×22 | electronics | Reserve | 0.21666666666666667 | 171600.0 | [-168.85000000000025, -292.456778858005, -149.0] | 1 | True | Massenbudget; Strom, Spannung, Kühlung und Befestigung offen
ARM_5 | CFK-Ausleger 6 | new_static | CFK | 0.2873999999999999 | 179624.99999999994 | [187.25000000000006, -324.3265137172723, -110.0] | 1 | False | Geometrievorschlag; Last-/Montagenachweis offen
MOUNT_5 | Motorträger 170×170×8, PCD50-Annahme | new_static | Aluminium | 0.6465956619957365 | 230105.21779207702 | [307.00000000000006, -531.7395979236456, -85.99999999999999] | 1 | False | 4×Ø6,6 auf PCD50 als Platzhalter; neuer Motor noch nicht ausgewählt
MOTOR_5 | Motorbauraum Ø150×66, neuer Typ offen | motor | Reserve | 2.75 | 1166316.2726452108 | [307.0000000000001, -531.7395979236453, -48.999999999999986] | 1 | True | 2,75 kg freie Masseannahme; kein ausgewählter Motor, keine bestätigte Dauerkennlinie oder Montage
HUB_5 | Rotornabe Nennkörper | rotor | Aluminium | 0.35752895194178635 | 127234.5024703866 | [307.0000000000001, -531.7395979236454, -6.000000000000001] | 1 | False | Anschluss-, Lager- und Blattwurzelkonstruktion noch offen
BLADE_5_0 | Profilblatt 3-Blatt-Referenz, Schalenmasse geschätzt | rotor | CFK | 0.16926565732383253 | 76630.43355969885 | [484.50000000000017, -519.7635880377491, 2.985954626880723] | 1 | True | Vollprofil als äußere Hülle, 2×1,2mm Schalenmasse +120g Wurzel/Spar; Laminat und Hubanschluss offen
GRIP_5_0 | Nabensteg mit formgleichem Blattwurzel-Nennsitz | rotor | Aluminium | 0.13108701446383797 | 46650.183083216354 | [375.8215273429158, -532.1508634424888, -0.10254001045168176] | 1 | False | Geometrische Lastpfadreserve Nabe–Blatt; Teilung, Bolzen, CFK-Klemmdruck, Fliehkraft und Ermüdung offen
BLADE_5_1 | Profilblatt 3-Blatt-Referenz, Schalenmasse geschätzt | rotor | CFK | 0.16926565732383253 | 76630.43355969887 | [207.8784712028404, -384.0080936948557, 2.9859546268807224] | 1 | True | Vollprofil als äußere Hülle, 2×1,2mm Schalenmasse +120g Wurzel/Spar; Laminat und Hubanschluss offen
GRIP_5_1 | Nabensteg mit formgleichem Blattwurzel-Nennsitz | rotor | Aluminium | 0.13108701446383794 | 46650.18308321634 | [272.945402715562, -471.9327741580131, -0.10254001045168022] | 1 | False | Geometrische Lastpfadreserve Nabe–Blatt; Teilung, Bolzen, CFK-Klemmdruck, Fliehkraft und Ermüdung offen
BLADE_5_2 | Profilblatt 3-Blatt-Referenz, Schalenmasse geschätzt | rotor | CFK | 0.16926565732383253 | 76630.43355969888 | [228.6215287971598, -691.4471120383314, 2.985954626880721] | 1 | True | Vollprofil als äußere Hülle, 2×1,2mm Schalenmasse +120g Wurzel/Spar; Laminat und Hubanschluss offen
GRIP_5_2 | Nabensteg mit formgleichem Blattwurzel-Nennsitz | rotor | Aluminium | 0.13108701446383786 | 46650.18308321632 | [272.2330699415227, -591.1351561704334, -0.10254001045168132] | 1 | False | Geometrische Lastpfadreserve Nabe–Blatt; Teilung, Bolzen, CFK-Klemmdruck, Fliehkraft und Ermüdung offen
ESC_5 | ESC-Platzhalter 120×65×22 | electronics | Reserve | 0.21666666666666667 | 171600.0 | [168.85000000000008, -292.456778858005, -149.0] | 1 | True | Massenbudget; Strom, Spannung, Kühlung und Befestigung offen
DECK_POST_0 | Zentrale Deckstütze | new_static | CFK | 0.05593600000000002 | 34960.00000000001 | [-119.99999999999997, -70.0, -15.000000000000027] | 1 | False | Geometrievorschlag; Last-/Montagenachweis offen
DECK_PAD_0 | Deckauflage | new_static | Aluminium | 0.022479999999999997 | 7999.999999999998 | [-120.00000000000001, -70.0, 92.49999999999999] | 1 | False | Geometrievorschlag; Last-/Montagenachweis offen
DECK_POST_1 | Zentrale Deckstütze | new_static | CFK | 0.05593600000000002 | 34960.00000000001 | [-119.99999999999997, 70.0, -15.000000000000027] | 1 | False | Geometrievorschlag; Last-/Montagenachweis offen
DECK_PAD_1 | Deckauflage | new_static | Aluminium | 0.022479999999999997 | 7999.999999999998 | [-120.00000000000001, 70.0, 92.49999999999999] | 1 | False | Geometrievorschlag; Last-/Montagenachweis offen
DECK_POST_2 | Zentrale Deckstütze | new_static | CFK | 0.055935999999999986 | 34959.99999999999 | [120.00000000000003, -70.0, -15.000000000000012] | 1 | False | Geometrievorschlag; Last-/Montagenachweis offen
DECK_PAD_2 | Deckauflage | new_static | Aluminium | 0.022479999999999997 | 7999.999999999998 | [120.00000000000001, -70.0, 92.49999999999999] | 1 | False | Geometrievorschlag; Last-/Montagenachweis offen
DECK_POST_3 | Zentrale Deckstütze | new_static | CFK | 0.055935999999999986 | 34959.99999999999 | [120.00000000000003, 70.0, -15.000000000000012] | 1 | False | Geometrievorschlag; Last-/Montagenachweis offen
DECK_PAD_3 | Deckauflage | new_static | Aluminium | 0.022479999999999997 | 7999.999999999998 | [120.00000000000001, 70.0, 92.49999999999999] | 1 | False | Geometrievorschlag; Last-/Montagenachweis offen
DECK_BEAM_0 | Deckquerträger | new_static | CFK | 0.11468800000000014 | 71680.00000000009 | [-8.526512829121202e-14, -70.0, 80.0] | 1 | False | Geometrievorschlag; Last-/Montagenachweis offen
DECK_BEAM_1 | Deckquerträger | new_static | CFK | 0.11468800000000014 | 71680.00000000009 | [-8.526512829121202e-14, 70.0, 80.0] | 1 | False | Geometrievorschlag; Last-/Montagenachweis offen
RING_0_LOW | Schutzring 12×12 Nennquerschnitt | new_static | CFK | 0.4285031848531559 | 267814.49053322244 | [613.9999999999994, -2.0291462207005598e-13, -54.99999999999999] | 1 | False | Geometrievorschlag; Last-/Montagenachweis offen
RING_0_HIGH | Schutzring 12×12 Nennquerschnitt | new_static | CFK | 0.4285031848531559 | 267814.49053322244 | [613.9999999999994, -2.0291462207005598e-13, 54.99999999999999] | 1 | False | Geometrievorschlag; Last-/Montagenachweis offen
GUARD_POST_0_0 | Ringdistanzrohr Ø12×1,5 bis Gitterlagen | new_static | CFK | 0.010806450409818162 | 6754.031506136351 | [910.0000000000002, -9.476287379746635e-16, 3.878299639259528e-15] | 1 | False | Geometrievorschlag; Last-/Montagenachweis offen
GUARD_POST_0_1 | Ringdistanzrohr Ø12×1,5 bis Gitterlagen | new_static | CFK | 0.010806450409818171 | 6754.031506136356 | [823.3036072312182, 209.303607231218, 1.220614988865011e-15] | 1 | False | Geometrievorschlag; Last-/Montagenachweis offen
GUARD_POST_0_2 | Ringdistanzrohr Ø12×1,5 bis Gitterlagen | new_static | CFK | 0.01080645040981817 | 6754.031506136355 | [614.0, 296.0, 3.1595018016021073e-15] | 1 | False | Geometrievorschlag; Last-/Montagenachweis offen
GUARD_POST_0_3 | Ringdistanzrohr Ø12×1,5 bis Gitterlagen | new_static | CFK | 0.010806450409818159 | 6754.031506136348 | [404.6963927687821, 209.30360723121802, -2.442282005300691e-15] | 1 | False | Geometrievorschlag; Last-/Montagenachweis offen
GUARD_POST_0_4 | Ringdistanzrohr Ø12×1,5 bis Gitterlagen | new_static | CFK | 0.010806450409818162 | 6754.031506136351 | [318.0000000000001, 3.7369557624568814e-14, -1.4365436477441706e-15] | 1 | False | Geometrievorschlag; Last-/Montagenachweis offen
GUARD_POST_0_5 | Ringdistanzrohr Ø12×1,5 bis Gitterlagen | new_static | CFK | 0.010806450409818162 | 6754.031506136351 | [404.6963927687819, -209.303607231218, -3.59109611246776e-15] | 1 | False | Geometrievorschlag; Last-/Montagenachweis offen
GUARD_POST_0_6 | Ringdistanzrohr Ø12×1,5 bis Gitterlagen | new_static | CFK | 0.01080645040981817 | 6754.031506136355 | [614.0, -296.0, 3.1595018016021073e-15] | 1 | False | Geometrievorschlag; Last-/Montagenachweis offen
GUARD_POST_0_7 | Ringdistanzrohr Ø12×1,5 bis Gitterlagen | new_static | CFK | 0.010806450409818166 | 6754.031506136353 | [823.3036072312183, -209.30360723121805, 1.651420279052663e-15] | 1 | False | Geometrievorschlag; Last-/Montagenachweis offen
GRID_0_TOP | Drahtgitter Ø1,2 / 30 mm, Ausschnitt unten | new_static | Steel | 0.1644893382792317 | 20954.05583174926 | [614.0000000000007, -4.340423205300789e-17, 67.00000000000003] | 38 | False | Nennvolumen aus Drahtsegmenten; Befestigung, Maschenverformung, Durchgriff- und Fragmentrückhalt nicht nachgewiesen
GRID_0_BOTTOM | Drahtgitter Ø1,2 / 30 mm, Ausschnitt unten | new_static | Steel | 0.1521875191819388 | 19386.945118718315 | [613.9994888901452, 2.4576400251278407e-07, -66.99994511042111] | 48 | False | Nennvolumen aus Drahtsegmenten; Befestigung, Maschenverformung, Durchgriff- und Fragmentrückhalt nicht nachgewiesen
GRID_0_SIDE | Seitliches Berührungsgitter | new_static | Steel | 0.11701389625861386 | 14906.228822753357 | [613.9999999999727, -3.634918197139159e-13, -2.371593323215606] | 65 | False | Nenn-Drahtgitter; Kreuzungen nicht verschweißt modelliert, kein Containmentnachweis
GUARD_ARM_0_0 | Schutzringausleger unter Rotor | new_static | CFK | 0.04878360000000002 | 30489.750000000007 | [785.0296103608589, 1.431817108539773e-15, -107.39676653629495] | 1 | False | Geometrievorschlag; Last-/Montagenachweis offen
GUARD_ARM_0_1 | Schutzringausleger unter Rotor | new_static | CFK | 0.04898099999999998 | 30613.124999999985 | [528.2388093524369, 148.53508092007473, -107.40045466669949] | 1 | False | Geometrievorschlag; Last-/Montagenachweis offen
GUARD_ARM_0_2 | Schutzringausleger unter Rotor | new_static | CFK | 0.04898100000000012 | 30613.125000000073 | [528.2388093524369, -148.5350809200748, -107.40045466669952] | 1 | False | Geometrievorschlag; Last-/Montagenachweis offen
RING_1_LOW | Schutzring 12×12 Nennquerschnitt | new_static | CFK | 0.42850318485315814 | 267814.49053322384 | [307.0000000000008, 531.7395979236456, -54.99999999999992] | 1 | False | Geometrievorschlag; Last-/Montagenachweis offen
RING_1_HIGH | Schutzring 12×12 Nennquerschnitt | new_static | CFK | 0.42850318485315814 | 267814.49053322384 | [307.0000000000008, 531.7395979236456, 54.99999999999992] | 1 | False | Geometrievorschlag; Last-/Montagenachweis offen
GUARD_POST_1_0 | Ringdistanzrohr Ø12×1,5 bis Gitterlagen | new_static | CFK | 0.010806450409818197 | 6754.031506136373 | [602.9999999999998, 531.7395979236454, 4.8829859692453654e-15] | 1 | False | Geometrievorschlag; Last-/Montagenachweis offen
GUARD_POST_1_1 | Ringdistanzrohr Ø12×1,5 bis Gitterlagen | new_static | CFK | 0.010806450409818195 | 6754.031506136372 | [516.3036072312179, 741.0432051548636, 1.615782845096354e-15] | 1 | False | Geometrievorschlag; Last-/Montagenachweis offen
GUARD_POST_1_2 | Ringdistanzrohr Ø12×1,5 bis Gitterlagen | new_static | CFK | 0.01080645040981819 | 6754.031506136368 | [307.0, 827.7395979236455, -5.098388614339194e-15] | 1 | False | Geometrievorschlag; Last-/Montagenachweis offen
GUARD_POST_1_3 | Ringdistanzrohr Ø12×1,5 bis Gitterlagen | new_static | CFK | 0.0108064504098182 | 6754.031506136375 | [97.69639276878205, 741.0432051548635, -2.9443621634009395e-15] | 1 | False | Geometrievorschlag; Last-/Montagenachweis offen
GUARD_POST_1_4 | Ringdistanzrohr Ø12×1,5 bis Gitterlagen | new_static | CFK | 0.01080645040981821 | 6754.03150613638 | [11.00000000000012, 531.7395979236454, 1.1852405618013688e-15] | 1 | False | Geometrievorschlag; Last-/Montagenachweis offen
GUARD_POST_1_5 | Ringdistanzrohr Ø12×1,5 bis Gitterlagen | new_static | CFK | 0.010806450409818171 | 6754.031506136357 | [97.69639276878202, 322.43599069242737, 4.667057310366218e-16] | 1 | False | Geometrievorschlag; Last-/Montagenachweis offen
GUARD_POST_1_6 | Ringdistanzrohr Ø12×1,5 bis Gitterlagen | new_static | CFK | 0.010806450409818166 | 6754.031506136353 | [307.0000000000001, 235.73959792364548, -1.4360176339588373e-16] | 1 | False | Geometrievorschlag; Last-/Montagenachweis offen
GUARD_POST_1_7 | Ringdistanzrohr Ø12×1,5 bis Gitterlagen | new_static | CFK | 0.01080645040981817 | 6754.031506136355 | [516.3036072312179, 322.4359906924273, -3.590833105575091e-15] | 1 | False | Geometrievorschlag; Last-/Montagenachweis offen
GRID_1_TOP | Drahtgitter Ø1,2 / 30 mm, Ausschnitt unten | new_static | Steel | 0.16448933827923135 | 20954.055831749214 | [307.00000000000006, 531.7395979236459, 67.00000000000003] | 38 | False | Nennvolumen aus Drahtsegmenten; Befestigung, Maschenverformung, Durchgriff- und Fragmentrückhalt nicht nachgewiesen
GRID_1_BOTTOM | Drahtgitter Ø1,2 / 30 mm, Ausschnitt unten | new_static | Steel | 0.15218751918634685 | 19386.94511927985 | [306.9997405697233, 531.7391621962284, -66.99994510703482] | 48 | False | Nennvolumen aus Drahtsegmenten; Befestigung, Maschenverformung, Durchgriff- und Fragmentrückhalt nicht nachgewiesen
GRID_1_SIDE | Seitliches Berührungsgitter | new_static | Steel | 0.11701389625861386 | 14906.228822753357 | [306.99999999998994, 531.7395979236205, -2.371593323215606] | 65 | False | Nenn-Drahtgitter; Kreuzungen nicht verschweißt modelliert, kein Containmentnachweis
GUARD_ARM_1_0 | Schutzringausleger unter Rotor | new_static | CFK | 0.048783600000000274 | 30489.750000000167 | [478.0296103608591, 531.7395979236458, -107.39676653629498] | 1 | False | Geometrievorschlag; Last-/Montagenachweis offen
GUARD_ARM_1_1 | Schutzringausleger unter Rotor | new_static | CFK | 0.04898100000000002 | 30613.125000000007 | [221.2388093524368, 680.2746788437203, -107.40045466669943] | 1 | False | Geometrievorschlag; Last-/Montagenachweis offen
GUARD_ARM_1_2 | Schutzringausleger unter Rotor | new_static | CFK | 0.04898100000000002 | 30613.125000000007 | [221.2388093524368, 383.2045170035708, -107.40045466669953] | 1 | False | Geometrievorschlag; Last-/Montagenachweis offen
RING_2_LOW | Schutzring 12×12 Nennquerschnitt | new_static | CFK | 0.42850318485315814 | 267814.49053322384 | [-306.9999999999986, 531.7395979236456, -54.99999999999992] | 1 | False | Geometrievorschlag; Last-/Montagenachweis offen
RING_2_HIGH | Schutzring 12×12 Nennquerschnitt | new_static | CFK | 0.42850318485315814 | 267814.49053322384 | [-306.9999999999986, 531.7395979236456, 54.99999999999992] | 1 | False | Geometrievorschlag; Last-/Montagenachweis offen
GUARD_POST_2_0 | Ringdistanzrohr Ø12×1,5 bis Gitterlagen | new_static | CFK | 0.01080645040981821 | 6754.03150613638 | [-10.999999999999936, 531.7395979236454, -1.4001171931098607e-15] | 1 | False | Geometrievorschlag; Last-/Montagenachweis offen
GUARD_POST_2_1 | Ringdistanzrohr Ø12×1,5 bis Gitterlagen | new_static | CFK | 0.010806450409818202 | 6754.031506136376 | [-97.69639276878185, 741.0432051548635, -1.0775392392544571e-15] | 1 | False | Geometrievorschlag; Last-/Montagenachweis offen
GUARD_POST_2_2 | Ringdistanzrohr Ø12×1,5 bis Gitterlagen | new_static | CFK | 0.010806450409818192 | 6754.031506136369 | [-307.0, 827.7395979236456, -2.9797365904645803e-15] | 1 | False | Geometrievorschlag; Last-/Montagenachweis offen
GUARD_POST_2_3 | Ringdistanzrohr Ø12×1,5 bis Gitterlagen | new_static | CFK | 0.01080645040981821 | 6754.03150613638 | [-516.3036072312179, 741.0432051548634, 3.590570098682412e-15] | 1 | False | Geometrievorschlag; Last-/Montagenachweis offen
GUARD_POST_2_4 | Ringdistanzrohr Ø12×1,5 bis Gitterlagen | new_static | CFK | 0.010806450409818197 | 6754.031506136373 | [-603.0, 531.7395979236454, 4.8829859692453654e-15] | 1 | False | Geometrievorschlag; Last-/Montagenachweis offen
GUARD_POST_2_5 | Ringdistanzrohr Ø12×1,5 bis Gitterlagen | new_static | CFK | 0.01080645040981818 | 6754.031506136363 | [-516.3036072312182, 322.4359906924274, -7.544352716137214e-16] | 1 | False | Geometrievorschlag; Last-/Montagenachweis offen
GUARD_POST_2_6 | Ringdistanzrohr Ø12×1,5 bis Gitterlagen | new_static | CFK | 0.010806450409818166 | 6754.031506136353 | [-306.99999999999994, 235.73959792364548, -1.4360176339588373e-16] | 1 | False | Geometrievorschlag; Last-/Montagenachweis offen
GUARD_POST_2_7 | Ringdistanzrohr Ø12×1,5 bis Gitterlagen | new_static | CFK | 0.010806450409818171 | 6754.031506136357 | [-97.69639276878195, 322.43599069242714, -2.6209951888675427e-15] | 1 | False | Geometrievorschlag; Last-/Montagenachweis offen
GRID_2_TOP | Drahtgitter Ø1,2 / 30 mm, Ausschnitt unten | new_static | Steel | 0.16448933827923135 | 20954.055831749214 | [-306.9999999999999, 531.739597923646, 67.00000000000001] | 38 | False | Nennvolumen aus Drahtsegmenten; Befestigung, Maschenverformung, Durchgriff- und Fragmentrückhalt nicht nachgewiesen
GRID_2_BOTTOM | Drahtgitter Ø1,2 / 30 mm, Ausschnitt unten | new_static | Steel | 0.15218751918603543 | 19386.945119240183 | [-306.99975601680256, 531.7391622033892, -66.99994510797545] | 48 | False | Nennvolumen aus Drahtsegmenten; Befestigung, Maschenverformung, Durchgriff- und Fragmentrückhalt nicht nachgewiesen
GRID_2_SIDE | Seitliches Berührungsgitter | new_static | Steel | 0.11701389625861386 | 14906.228822753357 | [-306.999999999987, 531.7395979236204, -2.371593323215606] | 65 | False | Nenn-Drahtgitter; Kreuzungen nicht verschweißt modelliert, kein Containmentnachweis
GUARD_ARM_2_0 | Schutzringausleger unter Rotor | new_static | CFK | 0.048783600000000274 | 30489.750000000167 | [-135.97038963914088, 531.7395979236455, -107.39676653629498] | 1 | False | Geometrievorschlag; Last-/Montagenachweis offen
GUARD_ARM_2_1 | Schutzringausleger unter Rotor | new_static | CFK | 0.048981000000000045 | 30613.12500000003 | [-392.7611906475632, 680.2746788437203, -107.40045466669949] | 1 | False | Geometrievorschlag; Last-/Montagenachweis offen
GUARD_ARM_2_2 | Schutzringausleger unter Rotor | new_static | CFK | 0.04898099999999997 | 30613.124999999978 | [-392.7611906475635, 383.20451700357086, -107.40045466669952] | 1 | False | Geometrievorschlag; Last-/Montagenachweis offen
RING_3_LOW | Schutzring 12×12 Nennquerschnitt | new_static | CFK | 0.4285031848531574 | 267814.4905332234 | [-613.9999999999991, -1.0160406209879346e-13, -54.999999999999964] | 1 | False | Geometrievorschlag; Last-/Montagenachweis offen
RING_3_HIGH | Schutzring 12×12 Nennquerschnitt | new_static | CFK | 0.4285031848531574 | 267814.4905332234 | [-613.9999999999991, -1.0160406209879346e-13, 54.999999999999964] | 1 | False | Geometrievorschlag; Last-/Montagenachweis offen
GUARD_POST_3_0 | Ringdistanzrohr Ø12×1,5 bis Gitterlagen | new_static | CFK | 0.010806450409818162 | 6754.031506136351 | [-318.0000000000001, 7.607141709041361e-14, -2.944099156508284e-15] | 1 | False | Geometrievorschlag; Last-/Montagenachweis offen
GUARD_POST_3_1 | Ringdistanzrohr Ø12×1,5 bis Gitterlagen | new_static | CFK | 0.01080645040981816 | 6754.03150613635 | [-404.69639276878195, 209.3036072312182, -5.206615950671453e-15] | 1 | False | Geometrievorschlag; Last-/Montagenachweis offen
GUARD_POST_3_2 | Ringdistanzrohr Ø12×1,5 bis Gitterlagen | new_static | CFK | 0.01080645040981817 | 6754.031506136355 | [-614.0000000000002, 296.00000000000006, 3.1595018016021073e-15] | 1 | False | Geometrievorschlag; Last-/Montagenachweis offen
GUARD_POST_3_3 | Ringdistanzrohr Ø12×1,5 bis Gitterlagen | new_static | CFK | 0.010806450409818166 | 6754.031506136353 | [-823.3036072312179, 209.3036072312183, -3.616344774163739e-17] | 1 | False | Geometrievorschlag; Last-/Montagenachweis offen
GUARD_POST_3_4 | Ringdistanzrohr Ø12×1,5 bis Gitterlagen | new_static | CFK | 0.010806450409818162 | 6754.031506136351 | [-910.0, 1.1049522998443453e-13, 3.878299639259528e-15] | 1 | False | Geometrievorschlag; Last-/Montagenachweis offen
GUARD_POST_3_5 | Ringdistanzrohr Ø12×1,5 bis Gitterlagen | new_static | CFK | 0.010806450409818164 | 6754.031506136352 | [-823.303607231218, -209.3036072312179, -2.8746653368443397e-16] | 1 | False | Geometrievorschlag; Last-/Montagenachweis offen
GUARD_POST_3_6 | Ringdistanzrohr Ø12×1,5 bis Gitterlagen | new_static | CFK | 0.01080645040981817 | 6754.031506136355 | [-614.0000000000002, -295.9999999999999, 3.1595018016021073e-15] | 1 | False | Geometrievorschlag; Last-/Montagenachweis offen
GUARD_POST_3_7 | Ringdistanzrohr Ø12×1,5 bis Gitterlagen | new_static | CFK | 0.01080645040981816 | 6754.03150613635 | [-404.69639276878195, -209.30360723121794, 7.900727055700273e-16] | 1 | False | Geometrievorschlag; Last-/Montagenachweis offen
GRID_3_TOP | Drahtgitter Ø1,2 / 30 mm, Ausschnitt unten | new_static | Steel | 0.16448933827923176 | 20954.05583174927 | [-614.0000000000005, 5.603486358043317e-14, 67.00000000000001] | 38 | False | Nennvolumen aus Drahtsegmenten; Befestigung, Maschenverformung, Durchgriff- und Fragmentrückhalt nicht nachgewiesen
GRID_3_BOTTOM | Drahtgitter Ø1,2 / 30 mm, Ausschnitt unten | new_static | Steel | 0.15218751918549744 | 19386.945119171647 | [-613.999504306408, 2.459744303496726e-07, -66.99994510747568] | 48 | False | Nennvolumen aus Drahtsegmenten; Befestigung, Maschenverformung, Durchgriff- und Fragmentrückhalt nicht nachgewiesen
GRID_3_SIDE | Seitliches Berührungsgitter | new_static | Steel | 0.11701389625861386 | 14906.228822753357 | [-613.9999999999676, 7.397482002769692e-14, -2.371593323215606] | 65 | False | Nenn-Drahtgitter; Kreuzungen nicht verschweißt modelliert, kein Containmentnachweis
GUARD_ARM_3_0 | Schutzringausleger unter Rotor | new_static | CFK | 0.0487836 | 30489.75 | [-442.9703896391413, 7.159085542698867e-14, -107.396766536295] | 1 | False | Geometrievorschlag; Last-/Montagenachweis offen
GUARD_ARM_3_1 | Schutzringausleger unter Rotor | new_static | CFK | 0.048981000000000004 | 30613.125 | [-699.7611906475635, 148.53508092007485, -107.4004546666995] | 1 | False | Geometrievorschlag; Last-/Montagenachweis offen
GUARD_ARM_3_2 | Schutzringausleger unter Rotor | new_static | CFK | 0.048981000000000184 | 30613.125000000113 | [-699.7611906475632, -148.5350809200746, -107.4004546666995] | 1 | False | Geometrievorschlag; Last-/Montagenachweis offen
RING_4_LOW | Schutzring 12×12 Nennquerschnitt | new_static | CFK | 0.4285031848531574 | 267814.4905332234 | [-307.00000000000045, -531.7395979236456, -54.999999999999964] | 1 | False | Geometrievorschlag; Last-/Montagenachweis offen
RING_4_HIGH | Schutzring 12×12 Nennquerschnitt | new_static | CFK | 0.4285031848531574 | 267814.4905332234 | [-307.00000000000045, -531.7395979236456, 54.999999999999964] | 1 | False | Geometrievorschlag; Last-/Montagenachweis offen
GUARD_POST_4_0 | Ringdistanzrohr Ø12×1,5 bis Gitterlagen | new_static | CFK | 0.01080645040981821 | 6754.03150613638 | [-11.000000000000332, -531.7395979236453, 3.2336697453340344e-16] | 1 | False | Geometrievorschlag; Last-/Montagenachweis offen
GUARD_POST_4_1 | Ringdistanzrohr Ø12×1,5 bis Gitterlagen | new_static | CFK | 0.010806450409818171 | 6754.031506136357 | [-97.69639276878225, -322.4359906924272, -2.6927960705654845e-15] | 1 | False | Geometrievorschlag; Last-/Montagenachweis offen
GUARD_POST_4_2 | Ringdistanzrohr Ø12×1,5 bis Gitterlagen | new_static | CFK | 0.010806450409818164 | 6754.031506136352 | [-307.0000000000004, -235.73959792364536, -4.7758106604838e-15] | 1 | False | Geometrievorschlag; Last-/Montagenachweis offen
GUARD_POST_4_3 | Ringdistanzrohr Ø12×1,5 bis Gitterlagen | new_static | CFK | 0.01080645040981818 | 6754.031506136363 | [-516.3036072312183, -322.4359906924273, 2.4055925437737154e-15] | 1 | False | Geometrievorschlag; Last-/Montagenachweis offen
GUARD_POST_4_4 | Ringdistanzrohr Ø12×1,5 bis Gitterlagen | new_static | CFK | 0.010806450409818194 | 6754.031506136371 | [-603.0000000000007, -531.7395979236452, 5.379805989492296e-16] | 1 | False | Geometrievorschlag; Last-/Montagenachweis offen
GUARD_POST_4_5 | Ringdistanzrohr Ø12×1,5 bis Gitterlagen | new_static | CFK | 0.010806450409818213 | 6754.031506136382 | [-516.3036072312183, -741.0432051548635, 4.703746771893171e-15] | 1 | False | Geometrievorschlag; Last-/Montagenachweis offen
GUARD_POST_4_6 | Ringdistanzrohr Ø12×1,5 bis Gitterlagen | new_static | CFK | 0.01080645040981819 | 6754.031506136368 | [-307.00000000000034, -827.7395979236451, 2.8799254746976617e-16] | 1 | False | Geometrievorschlag; Last-/Montagenachweis offen
GUARD_POST_4_7 | Ringdistanzrohr Ø12×1,5 bis Gitterlagen | new_static | CFK | 0.010806450409818202 | 6754.031506136376 | [-97.69639276878232, -741.0432051548635, -5.026061718855913e-16] | 1 | False | Geometrievorschlag; Last-/Montagenachweis offen
GRID_4_TOP | Drahtgitter Ø1,2 / 30 mm, Ausschnitt unten | new_static | Steel | 0.16448933827923137 | 20954.055831749218 | [-307.0000000000002, -531.7395979236456, 67.00000000000003] | 38 | False | Nennvolumen aus Drahtsegmenten; Befestigung, Maschenverformung, Durchgriff- und Fragmentrückhalt nicht nachgewiesen
GRID_4_BOTTOM | Drahtgitter Ø1,2 / 30 mm, Ausschnitt unten | new_static | Steel | 0.1521875191907033 | 19386.945119834814 | [-306.9997559930117, -531.7391616746866, -66.99994510334193] | 48 | False | Nennvolumen aus Drahtsegmenten; Befestigung, Maschenverformung, Durchgriff- und Fragmentrückhalt nicht nachgewiesen
GRID_4_SIDE | Seitliches Berührungsgitter | new_static | Steel | 0.11701389625861386 | 14906.228822753357 | [-306.9999999999841, -531.7395979236144, -2.3715933232155124] | 65 | False | Nenn-Drahtgitter; Kreuzungen nicht verschweißt modelliert, kein Containmentnachweis
GUARD_ARM_4_0 | Schutzringausleger unter Rotor | new_static | CFK | 0.0487835999999998 | 30489.749999999876 | [-135.97038963914147, -531.7395979236458, -107.39676653629496] | 1 | False | Geometrievorschlag; Last-/Montagenachweis offen
GUARD_ARM_4_1 | Schutzringausleger unter Rotor | new_static | CFK | 0.048981000000000004 | 30613.125 | [-392.76119064756347, -383.20451700357063, -107.40045466669949] | 1 | False | Geometrievorschlag; Last-/Montagenachweis offen
GUARD_ARM_4_2 | Schutzringausleger unter Rotor | new_static | CFK | 0.04898100000000007 | 30613.125000000044 | [-392.7611906475635, -680.2746788437202, -107.40045466669943] | 1 | False | Geometrievorschlag; Last-/Montagenachweis offen
RING_5_LOW | Schutzring 12×12 Nennquerschnitt | new_static | CFK | 0.42850318485315814 | 267814.49053322384 | [307.0000000000008, -531.7395979236456, -54.99999999999992] | 1 | False | Geometrievorschlag; Last-/Montagenachweis offen
RING_5_HIGH | Schutzring 12×12 Nennquerschnitt | new_static | CFK | 0.42850318485315814 | 267814.49053322384 | [307.0000000000008, -531.7395979236456, 54.99999999999992] | 1 | False | Geometrievorschlag; Last-/Montagenachweis offen
GUARD_POST_5_0 | Ringdistanzrohr Ø12×1,5 bis Gitterlagen | new_static | CFK | 0.010806450409818195 | 6754.031506136372 | [602.9999999999998, -531.7395979236452, 2.298154228119466e-15] | 1 | False | Geometrievorschlag; Last-/Montagenachweis offen
GUARD_POST_5_1 | Ringdistanzrohr Ø12×1,5 bis Gitterlagen | new_static | CFK | 0.01080645040981817 | 6754.031506136355 | [516.3036072312179, -322.4359906924274, -3.590833105575091e-15] | 1 | False | Geometrievorschlag; Last-/Montagenachweis offen
GUARD_POST_5_2 | Ringdistanzrohr Ø12×1,5 bis Gitterlagen | new_static | CFK | 0.01080645040981816 | 6754.03150613635 | [307.00000000000006, -235.7395979236454, 1.7593846084922428e-15] | 1 | False | Geometrievorschlag; Last-/Montagenachweis offen
GUARD_POST_5_3 | Ringdistanzrohr Ø12×1,5 bis Gitterlagen | new_static | CFK | 0.010806450409818171 | 6754.031506136356 | [97.69639276878205, -322.4359906924273, -6.10570501325172e-16] | 1 | False | Geometrievorschlag; Last-/Montagenachweis offen
GUARD_POST_5_4 | Ringdistanzrohr Ø12×1,5 bis Gitterlagen | new_static | CFK | 0.01080645040981821 | 6754.03150613638 | [11.00000000000012, -531.7395979236454, 3.9516785623134513e-16] | 1 | False | Geometrievorschlag; Last-/Montagenachweis offen
GUARD_POST_5_5 | Ringdistanzrohr Ø12×1,5 bis Gitterlagen | new_static | CFK | 0.0108064504098182 | 6754.031506136375 | [97.69639276878203, -741.0432051548635, -2.9802626042499104e-15] | 1 | False | Geometrievorschlag; Last-/Montagenachweis offen
GUARD_POST_5_6 | Ringdistanzrohr Ø12×1,5 bis Gitterlagen | new_static | CFK | 0.01080645040981819 | 6754.031506136368 | [307.0, -827.7395979236452, -4.09317627056801e-15] | 1 | False | Geometrievorschlag; Last-/Montagenachweis offen
GUARD_POST_5_7 | Ringdistanzrohr Ø12×1,5 bis Gitterlagen | new_static | CFK | 0.010806450409818195 | 6754.031506136372 | [516.3036072312179, -741.0432051548636, -1.6160458519890203e-15] | 1 | False | Geometrievorschlag; Last-/Montagenachweis offen
GRID_5_TOP | Drahtgitter Ø1,2 / 30 mm, Ausschnitt unten | new_static | Steel | 0.16448933827923143 | 20954.055831749225 | [306.99999999999994, -531.7395979236456, 67.0] | 38 | False | Nennvolumen aus Drahtsegmenten; Befestigung, Maschenverformung, Durchgriff- und Fragmentrückhalt nicht nachgewiesen
GRID_5_BOTTOM | Drahtgitter Ø1,2 / 30 mm, Ausschnitt unten | new_static | Steel | 0.15218751918456655 | 19386.94511905306 | [306.9997405729762, -531.7391617116693, -66.9999451078212] | 48 | False | Nennvolumen aus Drahtsegmenten; Befestigung, Maschenverformung, Durchgriff- und Fragmentrückhalt nicht nachgewiesen
GRID_5_SIDE | Seitliches Berührungsgitter | new_static | Steel | 0.11701389625861386 | 14906.228822753357 | [306.99999999998994, -531.7395979236204, -2.371593323215606] | 65 | False | Nenn-Drahtgitter; Kreuzungen nicht verschweißt modelliert, kein Containmentnachweis
GUARD_ARM_5_0 | Schutzringausleger unter Rotor | new_static | CFK | 0.04878359999999973 | 30489.749999999833 | [478.029610360859, -531.7395979236459, -107.39676653629496] | 1 | False | Geometrievorschlag; Last-/Montagenachweis offen
GUARD_ARM_5_1 | Schutzringausleger unter Rotor | new_static | CFK | 0.048981000000000025 | 30613.125000000015 | [221.238809352437, -383.2045170035705, -107.40045466669947] | 1 | False | Geometrievorschlag; Last-/Montagenachweis offen
GUARD_ARM_5_2 | Schutzringausleger unter Rotor | new_static | CFK | 0.04898099999999997 | 30613.124999999978 | [221.23880935243682, -680.2746788437202, -107.40045466669952] | 1 | False | Geometrievorschlag; Last-/Montagenachweis offen
DECK | Personendeck 620×360×8, Voll-CFK-Ersatz | new_static | CFK | 2.8569600000000004 | 1785600.0 | [-7.808568606530268e-16, -1.2835610710505039e-15, 99.0] | 1 | False | Vollplatten-Ersatz; Auflagen, Rutschbelag, Laminat, Decklast und Rückhalt offen
BATTERY | Batteriebauraum, 12 kg / 2,64 kWh angenommen | battery | Reserve | 12 | 5940000.0 | [5.268064323716299e-16, -4.042198674546348e-16, -193.0] | 1 | True | Packtyp, tatsächliche Masse/Kapazität, Strom, Kühlung und Halterung offen
BATTERY_TRAY | Batteriewanne 2mm Alu | new_static | Aluminium | 0.41911711999999995 | 149151.99999999997 | [-1.2132479578424914e-15, -5.396527107038737e-16, -240.0] | 1 | False | Geometrievorschlag; Last-/Montagenachweis offen
BATTERY_HANGER_0 | Batteriewannen-Halter | new_static | CFK | 0.01809599999999999 | 11309.999999999993 | [-140.0, -100.0, -175.0] | 1 | False | Geometrievorschlag; Last-/Montagenachweis offen
BATTERY_HANGER_1 | Batteriewannen-Halter | new_static | CFK | 0.01809599999999999 | 11309.999999999993 | [-140.0, 100.0, -175.0] | 1 | False | Geometrievorschlag; Last-/Montagenachweis offen
BATTERY_HANGER_2 | Batteriewannen-Halter | new_static | CFK | 0.01809599999999999 | 11309.999999999993 | [140.0, -100.0, -175.0] | 1 | False | Geometrievorschlag; Last-/Montagenachweis offen
BATTERY_HANGER_3 | Batteriewannen-Halter | new_static | CFK | 0.01809599999999999 | 11309.999999999993 | [140.0, 100.0, -175.0] | 1 | False | Geometrievorschlag; Last-/Montagenachweis offen
ELECTRONICS | Restelektronik-/Kabelbudget | electronics | Reserve | 0.7 | 270000.0 | [-1.5057584808649457e-15, -7.579122514774402e-17, 75.0] | 1 | True | Elektronik insgesamt 2kg einschließlich ESC-Reservemassen; Stecker/Kabel/Kühlung noch unbestimmt
SKID_0 | Kufenrohr 30×30×2 | new_static | CFK | 0.258048 | 161280.0 | [-5.684341886080802e-14, -240.0, -275.0] | 1 | False | Geometrievorschlag; Last-/Montagenachweis offen
LEG_0_0 | Kufenstütze außerhalb Rotor oder darunter | new_static | CFK | 0.05252680839342896 | 32829.255245893095 | [-250.0, -169.99999999999994, -184.99999999999994] | 1 | False | Geometrievorschlag; Last-/Montagenachweis offen
LEG_0_1 | Kufenstütze außerhalb Rotor oder darunter | new_static | CFK | 0.05252680839342898 | 32829.25524589311 | [250.0, -169.99999999999994, -185.00000000000006] | 1 | False | Geometrievorschlag; Last-/Montagenachweis offen
SKID_1 | Kufenrohr 30×30×2 | new_static | CFK | 0.258048 | 161280.0 | [-5.684341886080802e-14, 240.0, -275.0] | 1 | False | Geometrievorschlag; Last-/Montagenachweis offen
LEG_1_0 | Kufenstütze außerhalb Rotor oder darunter | new_static | CFK | 0.05252680839342897 | 32829.2552458931 | [-250.0, 170.0, -184.99999999999997] | 1 | False | Geometrievorschlag; Last-/Montagenachweis offen
LEG_1_1 | Kufenstütze außerhalb Rotor oder darunter | new_static | CFK | 0.05252680839342897 | 32829.2552458931 | [250.00000000000003, 170.0, -184.99999999999997] | 1 | False | Geometrievorschlag; Last-/Montagenachweis offen
