ITSMEEME/PropBoard/entwicklung_ab/Ausgabe/HEXA_R275/Stueckliste.csv

id | label | group | material | mass_kg | volume_mm3 | cg_mm | solid_count | mass_override | note
CENTER_FRAME | Zentralrahmen 40×40×2,5 | new_static | CFK | 0.6098000000000002 | 381125.0000000002 | [1.7410754236983652e-13, 6.042218655005715e-15, -110.00000000000003] | 1 | False | Rohranschlüsse als starrer Ersatz; reale Klemmen und Laminatnachweis offen
ARM_0 | CFK-Ausleger 1 | new_static | CFK | 0.2994000000000001 | 187125.00000000006 | [384.50000000000006, 3.3301054335957663e-16, -110.0] | 1 | False | Geometrievorschlag; Last-/Montagenachweis offen
MOUNT_0 | Motorträger 170×170×8, PCD50-Annahme | new_static | Aluminium | 0.6465956619957365 | 230105.21779207702 | [634.0000000000001, 1.9762583189111932e-16, -85.99999999999999] | 1 | False | 4×Ø6,6 auf PCD50 als Platzhalter; neuer Motor noch nicht ausgewählt
MOTOR_0 | Motorbauraum Ø150×66, neuer Typ offen | motor | Reserve | 2.75 | 1166316.2726452108 | [634.0000000000001, 3.9283686047566756e-16, -48.999999999999986] | 1 | True | 2,75 kg freie Masseannahme; kein ausgewählter Motor, keine bestätigte Dauerkennlinie oder Montage
HUB_0 | Rotornabe Nennkörper | rotor | Aluminium | 0.3575289519417864 | 127234.50247038662 | [634.0000000000001, 2.5602470623908543e-15, -5.999999999999999] | 1 | False | Anschluss-, Lager- und Blattwurzelkonstruktion noch offen
BLADE_0_0 | Profilblatt 3-Blatt-Referenz, Schalenmasse geschätzt | rotor | CFK | 0.1730543955991807 | 84066.27077842975 | [816.5000000000001, 12.199879912252907, 3.041771693448656] | 1 | True | Vollprofil als äußere Hülle, 2×1,2mm Schalenmasse +120g Wurzel/Spar; Laminat und Hubanschluss offen
GRIP_0_0 | Nabensteg mit formgleichem Blattwurzel-Nennsitz | rotor | Aluminium | 0.1307115872831119 | 46516.57910431029 | [702.7391576130323, -0.4118852718911655, -0.10269453224114457] | 1 | False | Geometrische Lastpfadreserve Nabe–Blatt; Teilung, Bolzen, CFK-Klemmdruck, Fliehkraft und Ermüdung offen
BLADE_0_1 | Profilblatt 3-Blatt-Referenz, Schalenmasse geschätzt | rotor | CFK | 0.1730543955991807 | 84066.27077842975 | [532.1845940728697, 151.94969623453355, 3.041771693448655] | 1 | True | Vollprofil als äußere Hülle, 2×1,2mm Schalenmasse +120g Wurzel/Spar; Laminat und Hubanschluss offen
GRIP_0_1 | Nabensteg mit formgleichem Blattwurzel-Nennsitz | rotor | Aluminium | 0.13071158728311205 | 46516.57910431033 | [599.9871243023861, 59.73579936357377, -0.10269453224114451] | 1 | False | Geometrische Lastpfadreserve Nabe–Blatt; Teilung, Bolzen, CFK-Klemmdruck, Fliehkraft und Ermüdung offen
BLADE_0_2 | Profilblatt 3-Blatt-Referenz, Schalenmasse geschätzt | rotor | CFK | 0.1730543955991807 | 84066.27077842974 | [553.3154059271305, -164.14957614678642, 3.0417716934486565] | 1 | True | Vollprofil als äußere Hülle, 2×1,2mm Schalenmasse +120g Wurzel/Spar; Laminat und Hubanschluss offen
GRIP_0_2 | Nabensteg mit formgleichem Blattwurzel-Nennsitz | rotor | Aluminium | 0.1307115872831119 | 46516.57910431029 | [599.2737180845822, -59.323914091682575, -0.10269453224114551] | 1 | False | Geometrische Lastpfadreserve Nabe–Blatt; Teilung, Bolzen, CFK-Klemmdruck, Fliehkraft und Ermüdung offen
ESC_0 | ESC-Platzhalter 120×65×22 | electronics | Reserve | 0.21666666666666667 | 171600.0 | [348.7000000000001, -4.736951571734001e-16, -149.0] | 1 | True | Massenbudget; Strom, Spannung, Kühlung und Befestigung offen
ARM_1 | CFK-Ausleger 2 | new_static | CFK | 0.29939999999999994 | 187124.99999999997 | [192.25, 332.9867677551167, -110.0] | 1 | False | Geometrievorschlag; Last-/Montagenachweis offen
MOUNT_1 | Motorträger 170×170×8, PCD50-Annahme | new_static | Aluminium | 0.6465956619957365 | 230105.21779207702 | [317.00000000000006, 549.0601059993342, -85.99999999999999] | 1 | False | 4×Ø6,6 auf PCD50 als Platzhalter; neuer Motor noch nicht ausgewählt
MOTOR_1 | Motorbauraum Ø150×66, neuer Typ offen | motor | Reserve | 2.75 | 1166316.2726452108 | [317.00000000000006, 549.0601059993342, -48.999999999999986] | 1 | True | 2,75 kg freie Masseannahme; kein ausgewählter Motor, keine bestätigte Dauerkennlinie oder Montage
HUB_1 | Rotornabe Nennkörper | rotor | Aluminium | 0.35752895194178635 | 127234.5024703866 | [317.0000000000001, 549.0601059993342, -6.000000000000001] | 1 | False | Anschluss-, Lager- und Blattwurzelkonstruktion noch offen
BLADE_1_0 | Profilblatt 3-Blatt-Referenz, Schalenmasse geschätzt | rotor | CFK | 0.1730543955991807 | 84066.27077842974 | [499.5000000000001, 561.259985911587, 3.0417716934486565] | 1 | True | Vollprofil als äußere Hülle, 2×1,2mm Schalenmasse +120g Wurzel/Spar; Laminat und Hubanschluss offen
GRIP_1_0 | Nabensteg mit formgleichem Blattwurzel-Nennsitz | rotor | Aluminium | 0.13071158728311214 | 46516.57910431037 | [385.7391576130318, 548.6482207274428, -0.102694532241144] | 1 | False | Geometrische Lastpfadreserve Nabe–Blatt; Teilung, Bolzen, CFK-Klemmdruck, Fliehkraft und Ermüdung offen
BLADE_1_1 | Profilblatt 3-Blatt-Referenz, Schalenmasse geschätzt | rotor | CFK | 0.1730543955991807 | 84066.27077842974 | [215.18459407286966, 701.0098022338677, 3.041771693448656] | 1 | True | Vollprofil als äußere Hülle, 2×1,2mm Schalenmasse +120g Wurzel/Spar; Laminat und Hubanschluss offen
GRIP_1_1 | Nabensteg mit formgleichem Blattwurzel-Nennsitz | rotor | Aluminium | 0.1307115872831119 | 46516.57910431029 | [282.9871243023866, 608.7959053629086, -0.10269453224114355] | 1 | False | Geometrische Lastpfadreserve Nabe–Blatt; Teilung, Bolzen, CFK-Klemmdruck, Fliehkraft und Ermüdung offen
BLADE_1_2 | Profilblatt 3-Blatt-Referenz, Schalenmasse geschätzt | rotor | CFK | 0.1730543955991807 | 84066.27077842975 | [236.3154059271305, 384.9105298525477, 3.041771693448656] | 1 | True | Vollprofil als äußere Hülle, 2×1,2mm Schalenmasse +120g Wurzel/Spar; Laminat und Hubanschluss offen
GRIP_1_2 | Nabensteg mit formgleichem Blattwurzel-Nennsitz | rotor | Aluminium | 0.130711587283112 | 46516.57910431031 | [282.2737180845816, 489.7361919076515, -0.10269453224114519] | 1 | False | Geometrische Lastpfadreserve Nabe–Blatt; Teilung, Bolzen, CFK-Klemmdruck, Fliehkraft und Ermüdung offen
ESC_1 | ESC-Platzhalter 120×65×22 | electronics | Reserve | 0.21666666666666667 | 171600.0 | [174.35000000000008, 301.9830582996338, -149.0] | 1 | True | Massenbudget; Strom, Spannung, Kühlung und Befestigung offen
ARM_2 | CFK-Ausleger 3 | new_static | CFK | 0.2993999999999999 | 187124.99999999994 | [-192.24999999999994, 332.9867677551166, -110.0] | 1 | False | Geometrievorschlag; Last-/Montagenachweis offen
MOUNT_2 | Motorträger 170×170×8, PCD50-Annahme | new_static | Aluminium | 0.6465956619957365 | 230105.21779207705 | [-316.9999999999999, 549.0601059993343, -85.99999999999997] | 1 | False | 4×Ø6,6 auf PCD50 als Platzhalter; neuer Motor noch nicht ausgewählt
MOTOR_2 | Motorbauraum Ø150×66, neuer Typ offen | motor | Reserve | 2.75 | 1166316.2726452108 | [-316.99999999999994, 549.0601059993343, -48.99999999999999] | 1 | True | 2,75 kg freie Masseannahme; kein ausgewählter Motor, keine bestätigte Dauerkennlinie oder Montage
HUB_2 | Rotornabe Nennkörper | rotor | Aluminium | 0.3575289519417864 | 127234.50247038662 | [-316.9999999999999, 549.0601059993343, -5.999999999999999] | 1 | False | Anschluss-, Lager- und Blattwurzelkonstruktion noch offen
BLADE_2_0 | Profilblatt 3-Blatt-Referenz, Schalenmasse geschätzt | rotor | CFK | 0.1730543955991807 | 84066.27077842977 | [-134.5, 561.2599859115871, 3.041771693448656] | 1 | True | Vollprofil als äußere Hülle, 2×1,2mm Schalenmasse +120g Wurzel/Spar; Laminat und Hubanschluss offen
GRIP_2_0 | Nabensteg mit formgleichem Blattwurzel-Nennsitz | rotor | Aluminium | 0.13071158728311216 | 46516.579104310375 | [-248.26084238696777, 548.6482207274428, -0.10269453224114514] | 1 | False | Geometrische Lastpfadreserve Nabe–Blatt; Teilung, Bolzen, CFK-Klemmdruck, Fliehkraft und Ermüdung offen
BLADE_2_1 | Profilblatt 3-Blatt-Referenz, Schalenmasse geschätzt | rotor | CFK | 0.1730543955991807 | 84066.27077842975 | [-418.81540592713037, 701.0098022338678, 3.0417716934486547] | 1 | True | Vollprofil als äußere Hülle, 2×1,2mm Schalenmasse +120g Wurzel/Spar; Laminat und Hubanschluss offen
GRIP_2_1 | Nabensteg mit formgleichem Blattwurzel-Nennsitz | rotor | Aluminium | 0.13071158728311194 | 46516.579104310294 | [-351.0128756976136, 608.7959053629083, -0.10269453224114404] | 1 | False | Geometrische Lastpfadreserve Nabe–Blatt; Teilung, Bolzen, CFK-Klemmdruck, Fliehkraft und Ermüdung offen
BLADE_2_2 | Profilblatt 3-Blatt-Referenz, Schalenmasse geschätzt | rotor | CFK | 0.1730543955991807 | 84066.27077842972 | [-397.6845940728696, 384.9105298525478, 3.041771693448657] | 1 | True | Vollprofil als äußere Hülle, 2×1,2mm Schalenmasse +120g Wurzel/Spar; Laminat und Hubanschluss offen
GRIP_2_2 | Nabensteg mit formgleichem Blattwurzel-Nennsitz | rotor | Aluminium | 0.130711587283112 | 46516.579104310316 | [-351.7262819154184, 489.7361919076514, -0.10269453224114433] | 1 | False | Geometrische Lastpfadreserve Nabe–Blatt; Teilung, Bolzen, CFK-Klemmdruck, Fliehkraft und Ermüdung offen
ESC_2 | ESC-Platzhalter 120×65×22 | electronics | Reserve | 0.21666666666666667 | 171600.0 | [-174.35, 301.9830582996338, -149.0] | 1 | True | Massenbudget; Strom, Spannung, Kühlung und Befestigung offen
ARM_3 | CFK-Ausleger 4 | new_static | CFK | 0.2994000000000001 | 187125.00000000006 | [-384.50000000000017, 4.1876504177877e-14, -110.0] | 1 | False | Geometrievorschlag; Last-/Montagenachweis offen
MOUNT_3 | Motorträger 170×170×8, PCD50-Annahme | new_static | Aluminium | 0.6465956619957365 | 230105.21779207705 | [-634.0000000000002, 7.164726909380639e-14, -85.99999999999996] | 1 | False | 4×Ø6,6 auf PCD50 als Platzhalter; neuer Motor noch nicht ausgewählt
MOTOR_3 | Motorbauraum Ø150×66, neuer Typ offen | motor | Reserve | 2.75 | 1166316.2726452108 | [-634.0000000000001, 7.80354439264179e-14, -48.999999999999986] | 1 | True | 2,75 kg freie Masseannahme; kein ausgewählter Motor, keine bestätigte Dauerkennlinie oder Montage
HUB_3 | Rotornabe Nennkörper | rotor | Aluminium | 0.3575289519417864 | 127234.50247038662 | [-634.0000000000001, 8.020285412833305e-14, -5.999999999999999] | 1 | False | Anschluss-, Lager- und Blattwurzelkonstruktion noch offen
BLADE_3_0 | Profilblatt 3-Blatt-Referenz, Schalenmasse geschätzt | rotor | CFK | 0.1730543955991807 | 84066.27077842974 | [-451.50000000000017, 12.199879912252987, 3.0417716934486574] | 1 | True | Vollprofil als äußere Hülle, 2×1,2mm Schalenmasse +120g Wurzel/Spar; Laminat und Hubanschluss offen
GRIP_3_0 | Nabensteg mit formgleichem Blattwurzel-Nennsitz | rotor | Aluminium | 0.13071158728311194 | 46516.579104310294 | [-565.2608423869684, -0.411885271891088, -0.10269453224114447] | 1 | False | Geometrische Lastpfadreserve Nabe–Blatt; Teilung, Bolzen, CFK-Klemmdruck, Fliehkraft und Ermüdung offen
BLADE_3_1 | Profilblatt 3-Blatt-Referenz, Schalenmasse geschätzt | rotor | CFK | 0.1730543955991807 | 84066.27077842972 | [-735.8154059271305, 151.94969623453372, 3.0417716934486556] | 1 | True | Vollprofil als äußere Hülle, 2×1,2mm Schalenmasse +120g Wurzel/Spar; Laminat und Hubanschluss offen
GRIP_3_1 | Nabensteg mit formgleichem Blattwurzel-Nennsitz | rotor | Aluminium | 0.13071158728311194 | 46516.5791043103 | [-668.0128756976143, 59.735799363573825, -0.10269453224114478] | 1 | False | Geometrische Lastpfadreserve Nabe–Blatt; Teilung, Bolzen, CFK-Klemmdruck, Fliehkraft und Ermüdung offen
BLADE_3_2 | Profilblatt 3-Blatt-Referenz, Schalenmasse geschätzt | rotor | CFK | 0.1730543955991807 | 84066.27077842975 | [-714.6845940728697, -164.1495761467864, 3.041771693448655] | 1 | True | Vollprofil als äußere Hülle, 2×1,2mm Schalenmasse +120g Wurzel/Spar; Laminat und Hubanschluss offen
GRIP_3_2 | Nabensteg mit formgleichem Blattwurzel-Nennsitz | rotor | Aluminium | 0.13071158728311194 | 46516.5791043103 | [-668.7262819154188, -59.323914091682475, -0.10269453224114522] | 1 | False | Geometrische Lastpfadreserve Nabe–Blatt; Teilung, Bolzen, CFK-Klemmdruck, Fliehkraft und Ermüdung offen
ESC_3 | ESC-Platzhalter 120×65×22 | electronics | Reserve | 0.21666666666666667 | 171600.0 | [-348.7000000000001, 4.284765928923627e-14, -149.0] | 1 | True | Massenbudget; Strom, Spannung, Kühlung und Befestigung offen
ARM_4 | CFK-Ausleger 5 | new_static | CFK | 0.2994 | 187125.0 | [-192.25000000000028, -332.9867677551167, -110.0] | 1 | False | Geometrievorschlag; Last-/Montagenachweis offen
MOUNT_4 | Motorträger 170×170×8, PCD50-Annahme | new_static | Aluminium | 0.6465956619957365 | 230105.21779207705 | [-317.0000000000003, -549.060105999334, -85.99999999999996] | 1 | False | 4×Ø6,6 auf PCD50 als Platzhalter; neuer Motor noch nicht ausgewählt
MOTOR_4 | Motorbauraum Ø150×66, neuer Typ offen | motor | Reserve | 2.75 | 1166316.2726452108 | [-317.0000000000003, -549.0601059993342, -48.99999999999999] | 1 | True | 2,75 kg freie Masseannahme; kein ausgewählter Motor, keine bestätigte Dauerkennlinie oder Montage
HUB_4 | Rotornabe Nennkörper | rotor | Aluminium | 0.35752895194178635 | 127234.5024703866 | [-317.00000000000034, -549.060105999334, -6.000000000000001] | 1 | False | Anschluss-, Lager- und Blattwurzelkonstruktion noch offen
BLADE_4_0 | Profilblatt 3-Blatt-Referenz, Schalenmasse geschätzt | rotor | CFK | 0.1730543955991807 | 84066.27077842974 | [-134.50000000000037, -536.8602260870812, 3.041771693448656] | 1 | True | Vollprofil als äußere Hülle, 2×1,2mm Schalenmasse +120g Wurzel/Spar; Laminat und Hubanschluss offen
GRIP_4_0 | Nabensteg mit formgleichem Blattwurzel-Nennsitz | rotor | Aluminium | 0.130711587283112 | 46516.579104310316 | [-248.26084238696848, -549.4719912712256, -0.10269453224114453] | 1 | False | Geometrische Lastpfadreserve Nabe–Blatt; Teilung, Bolzen, CFK-Klemmdruck, Fliehkraft und Ermüdung offen
BLADE_4_1 | Profilblatt 3-Blatt-Referenz, Schalenmasse geschätzt | rotor | CFK | 0.1730543955991807 | 84066.27077842974 | [-418.81540592713077, -397.11040976480047, 3.0417716934486556] | 1 | True | Vollprofil als äußere Hülle, 2×1,2mm Schalenmasse +120g Wurzel/Spar; Laminat und Hubanschluss offen
GRIP_4_1 | Nabensteg mit formgleichem Blattwurzel-Nennsitz | rotor | Aluminium | 0.13071158728311194 | 46516.5791043103 | [-351.0128756976141, -489.32430663576054, -0.1026945322411433] | 1 | False | Geometrische Lastpfadreserve Nabe–Blatt; Teilung, Bolzen, CFK-Klemmdruck, Fliehkraft und Ermüdung offen
BLADE_4_2 | Profilblatt 3-Blatt-Referenz, Schalenmasse geschätzt | rotor | CFK | 0.1730543955991807 | 84066.27077842974 | [-397.6845940728699, -713.2096821461205, 3.041771693448655] | 1 | True | Vollprofil als äußere Hülle, 2×1,2mm Schalenmasse +120g Wurzel/Spar; Laminat und Hubanschluss offen
GRIP_4_2 | Nabensteg mit formgleichem Blattwurzel-Nennsitz | rotor | Aluminium | 0.13071158728311194 | 46516.5791043103 | [-351.7262819154188, -608.3840200910171, -0.10269453224114569] | 1 | False | Geometrische Lastpfadreserve Nabe–Blatt; Teilung, Bolzen, CFK-Klemmdruck, Fliehkraft und Ermüdung offen
ESC_4 | ESC-Platzhalter 120×65×22 | electronics | Reserve | 0.21666666666666667 | 171600.0 | [-174.3500000000002, -301.9830582996337, -149.0] | 1 | True | Massenbudget; Strom, Spannung, Kühlung und Befestigung offen
ARM_5 | CFK-Ausleger 6 | new_static | CFK | 0.2993999999999999 | 187124.99999999994 | [192.24999999999991, -332.9867677551166, -110.0] | 1 | False | Geometrievorschlag; Last-/Montagenachweis offen
MOUNT_5 | Motorträger 170×170×8, PCD50-Annahme | new_static | Aluminium | 0.6465956619957365 | 230105.21779207702 | [317.00000000000006, -549.060105999334, -85.99999999999997] | 1 | False | 4×Ø6,6 auf PCD50 als Platzhalter; neuer Motor noch nicht ausgewählt
MOTOR_5 | Motorbauraum Ø150×66, neuer Typ offen | motor | Reserve | 2.75 | 1166316.2726452108 | [317.00000000000006, -549.0601059993342, -48.999999999999986] | 1 | True | 2,75 kg freie Masseannahme; kein ausgewählter Motor, keine bestätigte Dauerkennlinie oder Montage
HUB_5 | Rotornabe Nennkörper | rotor | Aluminium | 0.35752895194178635 | 127234.5024703866 | [317.0000000000001, -549.0601059993342, -6.000000000000001] | 1 | False | Anschluss-, Lager- und Blattwurzelkonstruktion noch offen
BLADE_5_0 | Profilblatt 3-Blatt-Referenz, Schalenmasse geschätzt | rotor | CFK | 0.1730543955991807 | 84066.27077842978 | [499.50000000000006, -536.8602260870813, 3.041771693448655] | 1 | True | Vollprofil als äußere Hülle, 2×1,2mm Schalenmasse +120g Wurzel/Spar; Laminat und Hubanschluss offen
GRIP_5_0 | Nabensteg mit formgleichem Blattwurzel-Nennsitz | rotor | Aluminium | 0.130711587283112 | 46516.579104310316 | [385.7391576130324, -549.471991271226, -0.10269453224114437] | 1 | False | Geometrische Lastpfadreserve Nabe–Blatt; Teilung, Bolzen, CFK-Klemmdruck, Fliehkraft und Ermüdung offen
BLADE_5_1 | Profilblatt 3-Blatt-Referenz, Schalenmasse geschätzt | rotor | CFK | 0.1730543955991807 | 84066.27077842972 | [215.18459407286963, -397.11040976480047, 3.0417716934486565] | 1 | True | Vollprofil als äußere Hülle, 2×1,2mm Schalenmasse +120g Wurzel/Spar; Laminat und Hubanschluss offen
GRIP_5_1 | Nabensteg mit formgleichem Blattwurzel-Nennsitz | rotor | Aluminium | 0.13071158728311205 | 46516.57910431034 | [282.9871243023862, -489.3243066357603, -0.10269453224114382] | 1 | False | Geometrische Lastpfadreserve Nabe–Blatt; Teilung, Bolzen, CFK-Klemmdruck, Fliehkraft und Ermüdung offen
BLADE_5_2 | Profilblatt 3-Blatt-Referenz, Schalenmasse geschätzt | rotor | CFK | 0.1730543955991807 | 84066.27077842974 | [236.31540592713054, -713.2096821461206, 3.041771693448656] | 1 | True | Vollprofil als äußere Hülle, 2×1,2mm Schalenmasse +120g Wurzel/Spar; Laminat und Hubanschluss offen
GRIP_5_2 | Nabensteg mit formgleichem Blattwurzel-Nennsitz | rotor | Aluminium | 0.13071158728311202 | 46516.57910431032 | [282.27371808458173, -608.3840200910171, -0.10269453224114498] | 1 | False | Geometrische Lastpfadreserve Nabe–Blatt; Teilung, Bolzen, CFK-Klemmdruck, Fliehkraft und Ermüdung offen
ESC_5 | ESC-Platzhalter 120×65×22 | electronics | Reserve | 0.21666666666666667 | 171600.0 | [174.35000000000008, -301.9830582996338, -149.0] | 1 | True | Massenbudget; Strom, Spannung, Kühlung und Befestigung offen
DECK_POST_0 | Zentrale Deckstütze | new_static | CFK | 0.05593600000000002 | 34960.00000000001 | [-119.99999999999997, -70.0, -15.000000000000027] | 1 | False | Geometrievorschlag; Last-/Montagenachweis offen
DECK_PAD_0 | Deckauflage | new_static | Aluminium | 0.022479999999999997 | 7999.999999999998 | [-120.00000000000001, -70.0, 92.49999999999999] | 1 | False | Geometrievorschlag; Last-/Montagenachweis offen
DECK_POST_1 | Zentrale Deckstütze | new_static | CFK | 0.05593600000000002 | 34960.00000000001 | [-119.99999999999997, 70.0, -15.000000000000027] | 1 | False | Geometrievorschlag; Last-/Montagenachweis offen
DECK_PAD_1 | Deckauflage | new_static | Aluminium | 0.022479999999999997 | 7999.999999999998 | [-120.00000000000001, 70.0, 92.49999999999999] | 1 | False | Geometrievorschlag; Last-/Montagenachweis offen
DECK_POST_2 | Zentrale Deckstütze | new_static | CFK | 0.055935999999999986 | 34959.99999999999 | [120.00000000000003, -70.0, -15.000000000000012] | 1 | False | Geometrievorschlag; Last-/Montagenachweis offen
DECK_PAD_2 | Deckauflage | new_static | Aluminium | 0.022479999999999997 | 7999.999999999998 | [120.00000000000001, -70.0, 92.49999999999999] | 1 | False | Geometrievorschlag; Last-/Montagenachweis offen
DECK_POST_3 | Zentrale Deckstütze | new_static | CFK | 0.055935999999999986 | 34959.99999999999 | [120.00000000000003, 70.0, -15.000000000000012] | 1 | False | Geometrievorschlag; Last-/Montagenachweis offen
DECK_PAD_3 | Deckauflage | new_static | Aluminium | 0.022479999999999997 | 7999.999999999998 | [120.00000000000001, 70.0, 92.49999999999999] | 1 | False | Geometrievorschlag; Last-/Montagenachweis offen
DECK_BEAM_0 | Deckquerträger | new_static | CFK | 0.11468800000000014 | 71680.00000000009 | [-8.526512829121202e-14, -70.0, 80.0] | 1 | False | Geometrievorschlag; Last-/Montagenachweis offen
DECK_BEAM_1 | Deckquerträger | new_static | CFK | 0.11468800000000014 | 71680.00000000009 | [-8.526512829121202e-14, 70.0, 80.0] | 1 | False | Geometrievorschlag; Last-/Montagenachweis offen
RING_0_LOW | Schutzring 12×12 Nennquerschnitt | new_static | CFK | 0.4429796438008987 | 276862.27737556165 | [634.0000000000007, -1.6907827159164234e-14, -54.99999999999987] | 1 | False | Geometrievorschlag; Last-/Montagenachweis offen
RING_0_HIGH | Schutzring 12×12 Nennquerschnitt | new_static | CFK | 0.4429796438008987 | 276862.27737556165 | [634.0000000000007, -1.6907827159164234e-14, 54.99999999999987] | 1 | False | Geometrievorschlag; Last-/Montagenachweis offen
GUARD_POST_0_0 | Ringdistanzrohr Ø12×1,5 bis Gitterlagen | new_static | CFK | 0.010806450409818162 | 6754.031506136351 | [940.0000000000005, -9.47628737974676e-16, 3.878299639259528e-15] | 1 | False | Geometrievorschlag; Last-/Montagenachweis offen
GUARD_POST_0_1 | Ringdistanzrohr Ø12×1,5 bis Gitterlagen | new_static | CFK | 0.010806450409818166 | 6754.0315061363535 | [850.3746750430834, 216.37467504308358, 6.462079352814767e-16] | 1 | False | Geometrievorschlag; Last-/Montagenachweis offen
GUARD_POST_0_2 | Ringdistanzrohr Ø12×1,5 bis Gitterlagen | new_static | CFK | 0.01080645040981817 | 6754.031506136355 | [634.0, 306.0000000000001, 3.1595018016021073e-15] | 1 | False | Geometrievorschlag; Last-/Montagenachweis offen
GUARD_POST_0_3 | Ringdistanzrohr Ø12×1,5 bis Gitterlagen | new_static | CFK | 0.01080645040981816 | 6754.03150613635 | [417.6253249569166, 216.37467504308356, -2.1566565198649213e-16] | 1 | False | Geometrievorschlag; Last-/Montagenachweis offen
GUARD_POST_0_4 | Ringdistanzrohr Ø12×1,5 bis Gitterlagen | new_static | CFK | 0.010806450409818162 | 6754.031506136351 | [328.0000000000002, 3.7344691949556917e-14, 1.8311854901901846e-15] | 1 | False | Geometrievorschlag; Last-/Montagenachweis offen
GUARD_POST_0_5 | Ringdistanzrohr Ø12×1,5 bis Gitterlagen | new_static | CFK | 0.010806450409818162 | 6754.031506136351 | [417.6253249569165, -216.37467504308353, 3.0877009199041675e-15] | 1 | False | Geometrievorschlag; Last-/Montagenachweis offen
GUARD_POST_0_6 | Ringdistanzrohr Ø12×1,5 bis Gitterlagen | new_static | CFK | 0.01080645040981817 | 6754.031506136355 | [634.0, -306.0000000000001, 3.1595018016021073e-15] | 1 | False | Geometrievorschlag; Last-/Montagenachweis offen
GUARD_POST_0_7 | Ringdistanzrohr Ø12×1,5 bis Gitterlagen | new_static | CFK | 0.010806450409818166 | 6754.031506136353 | [850.3746750430835, -216.3746750430836, -1.4721810817004747e-15] | 1 | False | Geometrievorschlag; Last-/Montagenachweis offen
GRID_0_TOP | Drahtgitter Ø1,2 / 30 mm, Ausschnitt unten | new_static | Steel | 0.17844537908804026 | 22731.895425228056 | [634.0000000000003, -6.411543042616718e-15, 67.00000000000001] | 42 | False | Nennvolumen aus Drahtsegmenten; Befestigung, Maschenverformung, Durchgriff- und Fragmentrückhalt nicht nachgewiesen
GRID_0_BOTTOM | Drahtgitter Ø1,2 / 30 mm, Ausschnitt unten | new_static | Steel | 0.16614356000182906 | 21164.7847136088 | [633.9995124390169, 2.1459343458593354e-07, -66.99994930279591] | 52 | False | Nennvolumen aus Drahtsegmenten; Befestigung, Maschenverformung, Durchgriff- und Fragmentrückhalt nicht nachgewiesen
GRID_0_SIDE | Seitliches Berührungsgitter | new_static | Steel | 0.12175482346667964 | 15510.168594481482 | [633.9999999998811, -1.136715720296732e-12, -2.3562490885208165] | 68 | False | Nenn-Drahtgitter; Kreuzungen nicht verschweißt modelliert, kein Containmentnachweis
GUARD_ARM_0_0 | Schutzringausleger unter Rotor | new_static | CFK | 0.05017559999999999 | 31359.749999999993 | [810.1460969076605, 1.8561264331975675e-15, -107.52447205414586] | 1 | False | Geometrievorschlag; Last-/Montagenachweis offen
GUARD_ARM_0_1 | Schutzringausleger unter Rotor | new_static | CFK | 0.05037300000000005 | 31483.12500000003 | [545.6778059851848, 152.97108050710054, -107.52755781926048] | 1 | False | Geometrievorschlag; Last-/Montagenachweis offen
GUARD_ARM_0_2 | Schutzringausleger unter Rotor | new_static | CFK | 0.05037300000000009 | 31483.12500000006 | [545.6778059851849, -152.97108050710048, -107.52755781926044] | 1 | False | Geometrievorschlag; Last-/Montagenachweis offen
RING_1_LOW | Schutzring 12×12 Nennquerschnitt | new_static | CFK | 0.44297964380089716 | 276862.2773755607 | [316.99999999999926, 549.0601059993339, -54.99999999999989] | 1 | False | Geometrievorschlag; Last-/Montagenachweis offen
RING_1_HIGH | Schutzring 12×12 Nennquerschnitt | new_static | CFK | 0.44297964380089716 | 276862.2773755607 | [316.99999999999926, 549.0601059993339, 54.99999999999989] | 1 | False | Geometrievorschlag; Last-/Montagenachweis offen
GUARD_POST_1_0 | Ringdistanzrohr Ø12×1,5 bis Gitterlagen | new_static | CFK | 0.010806450409818195 | 6754.031506136372 | [623.0000000000003, 549.0601059993342, 2.585357754911233e-15] | 1 | False | Geometrievorschlag; Last-/Montagenachweis offen
GUARD_POST_1_1 | Ringdistanzrohr Ø12×1,5 bis Gitterlagen | new_static | CFK | 0.010806450409818197 | 6754.031506136373 | [533.3746750430837, 765.4347810424175, 1.759384608492237e-15] | 1 | False | Geometrievorschlag; Last-/Montagenachweis offen
GUARD_POST_1_2 | Ringdistanzrohr Ø12×1,5 bis Gitterlagen | new_static | CFK | 0.01080645040981819 | 6754.031506136368 | [317.00000000000006, 855.0601059993342, -5.098388614339194e-15] | 1 | False | Geometrievorschlag; Last-/Montagenachweis offen
GUARD_POST_1_3 | Ringdistanzrohr Ø12×1,5 bis Gitterlagen | new_static | CFK | 0.0108064504098182 | 6754.031506136375 | [100.62532495691661, 765.4347810424177, -6.821083761304455e-16] | 1 | False | Geometrievorschlag; Last-/Montagenachweis offen
GUARD_POST_1_4 | Ringdistanzrohr Ø12×1,5 bis Gitterlagen | new_static | CFK | 0.010806450409818204 | 6754.031506136378 | [11.000000000000124, 549.0601059993343, -3.1238643676457924e-15] | 1 | False | Geometrievorschlag; Last-/Montagenachweis offen
GUARD_POST_1_5 | Ringdistanzrohr Ø12×1,5 bis Gitterlagen | new_static | CFK | 0.010806450409818171 | 6754.031506136357 | [100.62532495691651, 332.6854309562506, -1.8309224832975164e-15] | 1 | False | Geometrievorschlag; Last-/Montagenachweis offen
GUARD_POST_1_6 | Ringdistanzrohr Ø12×1,5 bis Gitterlagen | new_static | CFK | 0.010806450409818159 | 6754.031506136349 | [317.00000000000006, 243.06010599933413, 2.3696921029247492e-15] | 1 | False | Geometrievorschlag; Last-/Montagenachweis offen
GUARD_POST_1_7 | Ringdistanzrohr Ø12×1,5 bis Gitterlagen | new_static | CFK | 0.01080645040981817 | 6754.031506136355 | [533.3746750430837, 332.68543095625057, -3.16002781538744e-15] | 1 | False | Geometrievorschlag; Last-/Montagenachweis offen
GRID_1_TOP | Drahtgitter Ø1,2 / 30 mm, Ausschnitt unten | new_static | Steel | 0.17844537908803998 | 22731.89542522802 | [316.9999999999998, 549.0601059993342, 66.99999999999996] | 42 | False | Nennvolumen aus Drahtsegmenten; Befestigung, Maschenverformung, Durchgriff- und Fragmentrückhalt nicht nachgewiesen
GRID_1_BOTTOM | Drahtgitter Ø1,2 / 30 mm, Ausschnitt unten | new_static | Steel | 0.16614356000517677 | 21164.784714035253 | [316.9997524810166, 549.0596904187013, -66.9999493007189] | 52 | False | Nennvolumen aus Drahtsegmenten; Befestigung, Maschenverformung, Durchgriff- und Fragmentrückhalt nicht nachgewiesen
GRID_1_SIDE | Seitliches Berührungsgitter | new_static | Steel | 0.12175482346668055 | 15510.168594481598 | [316.9999999999499, 549.060105999237, -2.3562490885209426] | 68 | False | Nenn-Drahtgitter; Kreuzungen nicht verschweißt modelliert, kein Containmentnachweis
GUARD_ARM_1_0 | Schutzringausleger unter Rotor | new_static | CFK | 0.050175599999999605 | 31359.749999999753 | [493.14609690766014, 549.0601059993338, -107.52447205414586] | 1 | False | Geometrievorschlag; Last-/Montagenachweis offen
GUARD_ARM_1_1 | Schutzringausleger unter Rotor | new_static | CFK | 0.05037299999999999 | 31483.124999999993 | [228.67780598518476, 702.0311865064348, -107.52755781926051] | 1 | False | Geometrievorschlag; Last-/Montagenachweis offen
GUARD_ARM_1_2 | Schutzringausleger unter Rotor | new_static | CFK | 0.05037299999999996 | 31483.12499999997 | [228.67780598518465, 396.08902549223376, -107.52755781926048] | 1 | False | Geometrievorschlag; Last-/Montagenachweis offen
RING_2_LOW | Schutzring 12×12 Nennquerschnitt | new_static | CFK | 0.44297964380089716 | 276862.2773755607 | [-317.0000000000014, 549.0601059993339, -54.99999999999989] | 1 | False | Geometrievorschlag; Last-/Montagenachweis offen
RING_2_HIGH | Schutzring 12×12 Nennquerschnitt | new_static | CFK | 0.44297964380089716 | 276862.2773755607 | [-317.0000000000014, 549.0601059993339, 54.99999999999989] | 1 | False | Geometrievorschlag; Last-/Montagenachweis offen
GUARD_POST_2_0 | Ringdistanzrohr Ø12×1,5 bis Gitterlagen | new_static | CFK | 0.01080645040981821 | 6754.03150613638 | [-10.999999999999936, 549.0601059993343, 1.2565154297139776e-15] | 1 | False | Geometrievorschlag; Last-/Montagenachweis offen
GUARD_POST_2_1 | Ringdistanzrohr Ø12×1,5 bis Gitterlagen | new_static | CFK | 0.010806450409818197 | 6754.031506136373 | [-100.62532495691636, 765.4347810424176, -4.3106829708031637e-16] | 1 | False | Geometrievorschlag; Last-/Montagenachweis offen
GUARD_POST_2_2 | Ringdistanzrohr Ø12×1,5 bis Gitterlagen | new_static | CFK | 0.010806450409818192 | 6754.031506136369 | [-316.99999999999994, 855.0601059993343, -2.9797365904645803e-15] | 1 | False | Geometrievorschlag; Last-/Montagenachweis offen
GUARD_POST_2_3 | Ringdistanzrohr Ø12×1,5 bis Gitterlagen | new_static | CFK | 0.010806450409818194 | 6754.031506136371 | [-533.3746750430836, 765.434781042418, -5.38769619627229e-16] | 1 | False | Geometrievorschlag; Last-/Montagenachweis offen
GUARD_POST_2_4 | Ringdistanzrohr Ø12×1,5 bis Gitterlagen | new_static | CFK | 0.010806450409818197 | 6754.031506136373 | [-622.9999999999998, 549.0601059993343, 4.8829859692453654e-15] | 1 | False | Geometrievorschlag; Last-/Montagenachweis offen
GUARD_POST_2_5 | Ringdistanzrohr Ø12×1,5 bis Gitterlagen | new_static | CFK | 0.01080645040981817 | 6754.031506136355 | [-533.3746750430835, 332.6854309562508, 1.113176673210765e-15] | 1 | False | Geometrievorschlag; Last-/Montagenachweis offen
GUARD_POST_2_6 | Ringdistanzrohr Ø12×1,5 bis Gitterlagen | new_static | CFK | 0.010806450409818166 | 6754.031506136353 | [-316.9999999999999, 243.06010599933433, -1.4360176339588373e-16] | 1 | False | Geometrievorschlag; Last-/Montagenachweis offen
GUARD_POST_2_7 | Ringdistanzrohr Ø12×1,5 bis Gitterlagen | new_static | CFK | 0.010806450409818171 | 6754.031506136357 | [-100.62532495691646, 332.6854309562507, 2.513030859427964e-16] | 1 | False | Geometrievorschlag; Last-/Montagenachweis offen
GRID_2_TOP | Drahtgitter Ø1,2 / 30 mm, Ausschnitt unten | new_static | Steel | 0.17844537908803992 | 22731.895425228013 | [-316.9999999999997, 549.0601059993345, 66.99999999999999] | 42 | False | Nennvolumen aus Drahtsegmenten; Befestigung, Maschenverformung, Durchgriff- und Fragmentrückhalt nicht nachgewiesen
GRID_2_BOTTOM | Drahtgitter Ø1,2 / 30 mm, Ausschnitt unten | new_static | Steel | 0.1661435600010436 | 21164.784713508736 | [-316.99976741622214, 549.0596904427756, -66.99994930402433] | 52 | False | Nennvolumen aus Drahtsegmenten; Befestigung, Maschenverformung, Durchgriff- und Fragmentrückhalt nicht nachgewiesen
GRID_2_SIDE | Seitliches Berührungsgitter | new_static | Steel | 0.12175482346667964 | 15510.168594481482 | [-316.99999999994935, 549.0601059992371, -2.356249088520884] | 68 | False | Nenn-Drahtgitter; Kreuzungen nicht verschweißt modelliert, kein Containmentnachweis
GUARD_ARM_2_0 | Schutzringausleger unter Rotor | new_static | CFK | 0.05017560000000109 | 31359.75000000068 | [-140.85390309233935, 549.0601059993343, -107.52447205414585] | 1 | False | Geometrievorschlag; Last-/Montagenachweis offen
GUARD_ARM_2_1 | Schutzringausleger unter Rotor | new_static | CFK | 0.050372999999999966 | 31483.124999999978 | [-405.32219401481507, 702.0311865064349, -107.5275578192605] | 1 | False | Geometrievorschlag; Last-/Montagenachweis offen
GUARD_ARM_2_2 | Schutzringausleger unter Rotor | new_static | CFK | 0.05037299999999999 | 31483.124999999993 | [-405.3221940148155, 396.0890254922339, -107.52755781926048] | 1 | False | Geometrievorschlag; Last-/Montagenachweis offen
RING_3_LOW | Schutzring 12×12 Nennquerschnitt | new_static | CFK | 0.44297964380089716 | 276862.2773755607 | [-634.0000000000002, -8.143568818082061e-14, -54.99999999999989] | 1 | False | Geometrievorschlag; Last-/Montagenachweis offen
RING_3_HIGH | Schutzring 12×12 Nennquerschnitt | new_static | CFK | 0.44297964380089716 | 276862.2773755607 | [-634.0000000000002, -8.143568818082061e-14, 54.99999999999989] | 1 | False | Geometrievorschlag; Last-/Montagenachweis offen
GUARD_POST_3_0 | Ringdistanzrohr Ø12×1,5 bis Gitterlagen | new_static | CFK | 0.010806450409818159 | 6754.031506136349 | [-328.00000000000017, 7.741394117485814e-14, -3.6163447741637285e-17] | 1 | False | Geometrievorschlag; Last-/Montagenachweis offen
GUARD_POST_3_1 | Ringdistanzrohr Ø12×1,5 bis Gitterlagen | new_static | CFK | 0.01080645040981816 | 6754.03150613635 | [-417.6253249569166, 216.37467504308358, 2.0106876944350395e-15] | 1 | False | Geometrievorschlag; Last-/Montagenachweis offen
GUARD_POST_3_2 | Ringdistanzrohr Ø12×1,5 bis Gitterlagen | new_static | CFK | 0.01080645040981817 | 6754.031506136355 | [-634.0000000000002, 306.0, 3.1595018016021073e-15] | 1 | False | Geometrievorschlag; Last-/Montagenachweis offen
GUARD_POST_3_3 | Ringdistanzrohr Ø12×1,5 bis Gitterlagen | new_static | CFK | 0.010806450409818166 | 6754.0315061363535 | [-850.3746750430839, 216.3746750430836, 7.898096986773606e-16] | 1 | False | Geometrievorschlag; Last-/Montagenachweis offen
GUARD_POST_3_4 | Ringdistanzrohr Ø12×1,5 bis Gitterlagen | new_static | CFK | 0.010806450409818162 | 6754.031506136351 | [-940.0, 1.1552678581224048e-13, -4.3080529018765133e-16] | 1 | False | Geometrievorschlag; Last-/Montagenachweis offen
GUARD_POST_3_5 | Ringdistanzrohr Ø12×1,5 bis Gitterlagen | new_static | CFK | 0.010806450409818164 | 6754.031506136352 | [-850.3746750430838, -216.3746750430835, 2.6566326228238494e-15] | 1 | False | Geometrievorschlag; Last-/Montagenachweis offen
GUARD_POST_3_6 | Ringdistanzrohr Ø12×1,5 bis Gitterlagen | new_static | CFK | 0.01080645040981817 | 6754.031506136355 | [-634.0000000000002, -305.99999999999983, 3.1595018016021073e-15] | 1 | False | Geometrievorschlag; Last-/Montagenachweis offen
GUARD_POST_3_7 | Ringdistanzrohr Ø12×1,5 bis Gitterlagen | new_static | CFK | 0.010806450409818159 | 6754.031506136348 | [-417.62532495691664, -216.37467504308347, -2.442282005300691e-15] | 1 | False | Geometrievorschlag; Last-/Montagenachweis offen
GRID_3_TOP | Drahtgitter Ø1,2 / 30 mm, Ausschnitt unten | new_static | Steel | 0.17844537908804037 | 22731.89542522807 | [-634.0, 5.4623145952776716e-14, 66.99999999999997] | 42 | False | Nennvolumen aus Drahtsegmenten; Befestigung, Maschenverformung, Durchgriff- und Fragmentrückhalt nicht nachgewiesen
GRID_3_BOTTOM | Drahtgitter Ø1,2 / 30 mm, Ausschnitt unten | new_static | Steel | 0.16614355999864325 | 21164.78471320296 | [-633.9995273925115, 2.1431664722657037e-07, -66.99994930593691] | 52 | False | Nennvolumen aus Drahtsegmenten; Befestigung, Maschenverformung, Durchgriff- und Fragmentrückhalt nicht nachgewiesen
GRID_3_SIDE | Seitliches Berührungsgitter | new_static | Steel | 0.12175482346667826 | 15510.168594481307 | [-633.9999999998844, -8.292949745206329e-13, -2.3562490885209866] | 68 | False | Nenn-Drahtgitter; Kreuzungen nicht verschweißt modelliert, kein Containmentnachweis
GUARD_ARM_3_0 | Schutzringausleger unter Rotor | new_static | CFK | 0.05017559999999999 | 31359.749999999993 | [-457.8539030923399, 7.517312054450149e-14, -107.52447205414583] | 1 | False | Geometrievorschlag; Last-/Montagenachweis offen
GUARD_ARM_3_1 | Schutzringausleger unter Rotor | new_static | CFK | 0.05037300000000007 | 31483.125000000044 | [-722.3221940148155, 152.97108050710062, -107.52755781926042] | 1 | False | Geometrievorschlag; Last-/Montagenachweis offen
GUARD_ARM_3_2 | Schutzringausleger unter Rotor | new_static | CFK | 0.05037300000000013 | 31483.12500000008 | [-722.3221940148154, -152.97108050710045, -107.52755781926052] | 1 | False | Geometrievorschlag; Last-/Montagenachweis offen
RING_4_LOW | Schutzring 12×12 Nennquerschnitt | new_static | CFK | 0.44297964380089716 | 276862.2773755607 | [-316.9999999999997, -549.0601059993339, -54.99999999999989] | 1 | False | Geometrievorschlag; Last-/Montagenachweis offen
RING_4_HIGH | Schutzring 12×12 Nennquerschnitt | new_static | CFK | 0.44297964380089716 | 276862.2773755607 | [-316.9999999999997, -549.0601059993339, 54.99999999999989] | 1 | False | Geometrievorschlag; Last-/Montagenachweis offen
GUARD_POST_4_0 | Ringdistanzrohr Ø12×1,5 bis Gitterlagen | new_static | CFK | 0.01080645040981821 | 6754.03150613638 | [-11.000000000000332, -549.060105999334, -1.4001171931098607e-15] | 1 | False | Geometrievorschlag; Last-/Montagenachweis offen
GUARD_POST_4_1 | Ringdistanzrohr Ø12×1,5 bis Gitterlagen | new_static | CFK | 0.010806450409818171 | 6754.031506136357 | [-100.62532495691681, -332.6854309562505, 6.821083761304474e-16] | 1 | False | Geometrievorschlag; Last-/Montagenachweis offen
GUARD_POST_4_2 | Ringdistanzrohr Ø12×1,5 bis Gitterlagen | new_static | CFK | 0.010806450409818159 | 6754.031506136348 | [-317.0000000000004, -243.06010599933404, 9.336744689659113e-16] | 1 | False | Geometrievorschlag; Last-/Montagenachweis offen
GUARD_POST_4_3 | Ringdistanzrohr Ø12×1,5 bis Gitterlagen | new_static | CFK | 0.01080645040981817 | 6754.031506136355 | [-533.3746750430837, -332.68543095625057, -3.590833105575091e-15] | 1 | False | Geometrievorschlag; Last-/Montagenachweis offen
GUARD_POST_4_4 | Ringdistanzrohr Ø12×1,5 bis Gitterlagen | new_static | CFK | 0.010806450409818199 | 6754.0315061363735 | [-623.0000000000003, -549.0601059993342, 5.673058674815389e-15] | 1 | False | Geometrievorschlag; Last-/Montagenachweis offen
GUARD_POST_4_5 | Ringdistanzrohr Ø12×1,5 bis Gitterlagen | new_static | CFK | 0.010806450409818195 | 6754.031506136372 | [-533.374675043084, -765.4347810424175, -1.6160458519890203e-15] | 1 | False | Geometrievorschlag; Last-/Montagenachweis offen
GUARD_POST_4_6 | Ringdistanzrohr Ø12×1,5 bis Gitterlagen | new_static | CFK | 0.010806450409818192 | 6754.031506136369 | [-317.0000000000005, -855.0601059993342, -5.134289055188164e-15] | 1 | False | Geometrievorschlag; Last-/Montagenachweis offen
GUARD_POST_4_7 | Ringdistanzrohr Ø12×1,5 bis Gitterlagen | new_static | CFK | 0.0108064504098182 | 6754.031506136375 | [-100.62532495691681, -765.4347810424176, -2.6930590774581436e-15] | 1 | False | Geometrievorschlag; Last-/Montagenachweis offen
GRID_4_TOP | Drahtgitter Ø1,2 / 30 mm, Ausschnitt unten | new_static | Steel | 0.17844537908803995 | 22731.895425228016 | [-317.0000000000001, -549.0601059993342, 66.99999999999999] | 42 | False | Nennvolumen aus Drahtsegmenten; Befestigung, Maschenverformung, Durchgriff- und Fragmentrückhalt nicht nachgewiesen
GRID_4_BOTTOM | Drahtgitter Ø1,2 / 30 mm, Ausschnitt unten | new_static | Steel | 0.16614356000550207 | 21164.784714076693 | [-316.9997674006865, -549.0596899855512, -66.99994930010601] | 52 | False | Nennvolumen aus Drahtsegmenten; Befestigung, Maschenverformung, Durchgriff- und Fragmentrückhalt nicht nachgewiesen
GRID_4_SIDE | Seitliches Berührungsgitter | new_static | Steel | 0.12175482346667964 | 15510.168594481482 | [-316.9999999999437, -549.0601059992362, -2.3562490885209892] | 68 | False | Nenn-Drahtgitter; Kreuzungen nicht verschweißt modelliert, kein Containmentnachweis
GUARD_ARM_4_0 | Schutzringausleger unter Rotor | new_static | CFK | 0.05017560000000015 | 31359.750000000095 | [-140.85390309234006, -549.0601059993339, -107.52447205414585] | 1 | False | Geometrievorschlag; Last-/Montagenachweis offen
GUARD_ARM_4_1 | Schutzringausleger unter Rotor | new_static | CFK | 0.05037299999999996 | 31483.12499999997 | [-405.3221940148155, -396.0890254922335, -107.52755781926048] | 1 | False | Geometrievorschlag; Last-/Montagenachweis offen
GUARD_ARM_4_2 | Schutzringausleger unter Rotor | new_static | CFK | 0.05037299999999992 | 31483.12499999995 | [-405.32219401481603, -702.0311865064344, -107.5275578192605] | 1 | False | Geometrievorschlag; Last-/Montagenachweis offen
RING_5_LOW | Schutzring 12×12 Nennquerschnitt | new_static | CFK | 0.44297964380089716 | 276862.2773755607 | [316.99999999999926, -549.0601059993339, -54.99999999999989] | 1 | False | Geometrievorschlag; Last-/Montagenachweis offen
RING_5_HIGH | Schutzring 12×12 Nennquerschnitt | new_static | CFK | 0.44297964380089716 | 276862.2773755607 | [316.99999999999926, -549.0601059993339, 54.99999999999989] | 1 | False | Geometrievorschlag; Last-/Montagenachweis offen
GUARD_POST_5_0 | Ringdistanzrohr Ø12×1,5 bis Gitterlagen | new_static | CFK | 0.010806450409818194 | 6754.031506136371 | [623.0000000000002, -549.0601059993342, 1.3285793183045874e-15] | 1 | False | Geometrievorschlag; Last-/Montagenachweis offen
GUARD_POST_5_1 | Ringdistanzrohr Ø12×1,5 bis Gitterlagen | new_static | CFK | 0.010806450409818171 | 6754.031506136356 | [533.3746750430836, -332.6854309562507, 2.5491943071696013e-15] | 1 | False | Geometrievorschlag; Last-/Montagenachweis offen
GUARD_POST_5_2 | Ringdistanzrohr Ø12×1,5 bis Gitterlagen | new_static | CFK | 0.010806450409818166 | 6754.031506136353 | [317.00000000000006, -243.06010599933416, -1.7232211607506051e-15] | 1 | False | Geometrievorschlag; Last-/Montagenachweis offen
GUARD_POST_5_3 | Ringdistanzrohr Ø12×1,5 bis Gitterlagen | new_static | CFK | 0.010806450409818171 | 6754.031506136357 | [100.6253249569166, -332.6854309562506, 9.334114620732437e-16] | 1 | False | Geometrievorschlag; Last-/Montagenachweis offen
GUARD_POST_5_4 | Ringdistanzrohr Ø12×1,5 bis Gitterlagen | new_static | CFK | 0.01080645040981821 | 6754.03150613638 | [11.00000000000012, -549.0601059993342, 1.0796432943957882e-16] | 1 | False | Geometrievorschlag; Last-/Montagenachweis offen
GUARD_POST_5_5 | Ringdistanzrohr Ø12×1,5 bis Gitterlagen | new_static | CFK | 0.010806450409818199 | 6754.031506136374 | [100.62532495691651, -765.4347810424176, -2.693059077458144e-15] | 1 | False | Geometrievorschlag; Last-/Montagenachweis offen
GUARD_POST_5_6 | Ringdistanzrohr Ø12×1,5 bis Gitterlagen | new_static | CFK | 0.01080645040981819 | 6754.031506136368 | [317.0, -855.060105999334, -4.09317627056801e-15] | 1 | False | Geometrievorschlag; Last-/Montagenachweis offen
GUARD_POST_5_7 | Ringdistanzrohr Ø12×1,5 bis Gitterlagen | new_static | CFK | 0.010806450409818197 | 6754.031506136373 | [533.3746750430834, -765.4347810424176, 4.8829859692453654e-15] | 1 | False | Geometrievorschlag; Last-/Montagenachweis offen
GRID_5_TOP | Drahtgitter Ø1,2 / 30 mm, Ausschnitt unten | new_static | Steel | 0.17844537908803998 | 22731.89542522802 | [316.99999999999983, -549.0601059993342, 66.99999999999999] | 42 | False | Nennvolumen aus Drahtsegmenten; Befestigung, Maschenverformung, Durchgriff- und Fragmentrückhalt nicht nachgewiesen
GRID_5_BOTTOM | Drahtgitter Ø1,2 / 30 mm, Ausschnitt unten | new_static | Steel | 0.16614356000358707 | 21164.78471383275 | [316.99975248603465, -549.0596900006594, -66.99994930172589] | 52 | False | Nennvolumen aus Drahtsegmenten; Befestigung, Maschenverformung, Durchgriff- und Fragmentrückhalt nicht nachgewiesen
GRID_5_SIDE | Seitliches Berührungsgitter | new_static | Steel | 0.12175482346667964 | 15510.168594481482 | [316.9999999999556, -549.0601059992496, -2.3562490885209892] | 68 | False | Nenn-Drahtgitter; Kreuzungen nicht verschweißt modelliert, kein Containmentnachweis
GUARD_ARM_5_0 | Schutzringausleger unter Rotor | new_static | CFK | 0.05017559999999975 | 31359.74999999984 | [493.14609690766036, -549.0601059993342, -107.52447205414585] | 1 | False | Geometrievorschlag; Last-/Montagenachweis offen
GUARD_ARM_5_1 | Schutzringausleger unter Rotor | new_static | CFK | 0.05037299999999994 | 31483.124999999956 | [228.67780598518476, -396.08902549223365, -107.52755781926045] | 1 | False | Geometrievorschlag; Last-/Montagenachweis offen
GUARD_ARM_5_2 | Schutzringausleger unter Rotor | new_static | CFK | 0.05037300000000003 | 31483.125000000015 | [228.67780598518465, -702.0311865064343, -107.5275578192605] | 1 | False | Geometrievorschlag; Last-/Montagenachweis offen
DECK | Personendeck 620×360×8, Voll-CFK-Ersatz | new_static | CFK | 2.8569600000000004 | 1785600.0 | [-7.808568606530268e-16, -1.2835610710505039e-15, 99.0] | 1 | False | Vollplatten-Ersatz; Auflagen, Rutschbelag, Laminat, Decklast und Rückhalt offen
BATTERY | Batteriebauraum, 12 kg / 2,64 kWh angenommen | battery | Reserve | 12 | 5940000.0 | [5.268064323716299e-16, -4.042198674546348e-16, -193.0] | 1 | True | Packtyp, tatsächliche Masse/Kapazität, Strom, Kühlung und Halterung offen
BATTERY_TRAY | Batteriewanne 2mm Alu | new_static | Aluminium | 0.41911711999999995 | 149151.99999999997 | [-1.2132479578424914e-15, -5.396527107038737e-16, -240.0] | 1 | False | Geometrievorschlag; Last-/Montagenachweis offen
BATTERY_HANGER_0 | Batteriewannen-Halter | new_static | CFK | 0.01809599999999999 | 11309.999999999993 | [-140.0, -100.0, -175.0] | 1 | False | Geometrievorschlag; Last-/Montagenachweis offen
BATTERY_HANGER_1 | Batteriewannen-Halter | new_static | CFK | 0.01809599999999999 | 11309.999999999993 | [-140.0, 100.0, -175.0] | 1 | False | Geometrievorschlag; Last-/Montagenachweis offen
BATTERY_HANGER_2 | Batteriewannen-Halter | new_static | CFK | 0.01809599999999999 | 11309.999999999993 | [140.0, -100.0, -175.0] | 1 | False | Geometrievorschlag; Last-/Montagenachweis offen
BATTERY_HANGER_3 | Batteriewannen-Halter | new_static | CFK | 0.01809599999999999 | 11309.999999999993 | [140.0, 100.0, -175.0] | 1 | False | Geometrievorschlag; Last-/Montagenachweis offen
ELECTRONICS | Restelektronik-/Kabelbudget | electronics | Reserve | 0.7 | 270000.0 | [-1.5057584808649457e-15, -7.579122514774402e-17, 75.0] | 1 | True | Elektronik insgesamt 2kg einschließlich ESC-Reservemassen; Stecker/Kabel/Kühlung noch unbestimmt
SKID_0 | Kufenrohr 30×30×2 | new_static | CFK | 0.258048 | 161280.0 | [-5.684341886080802e-14, -240.0, -275.0] | 1 | False | Geometrievorschlag; Last-/Montagenachweis offen
LEG_0_0 | Kufenstütze außerhalb Rotor oder darunter | new_static | CFK | 0.05252680839342896 | 32829.255245893095 | [-250.0, -169.99999999999994, -184.99999999999994] | 1 | False | Geometrievorschlag; Last-/Montagenachweis offen
LEG_0_1 | Kufenstütze außerhalb Rotor oder darunter | new_static | CFK | 0.05252680839342898 | 32829.25524589311 | [250.0, -169.99999999999994, -185.00000000000006] | 1 | False | Geometrievorschlag; Last-/Montagenachweis offen
SKID_1 | Kufenrohr 30×30×2 | new_static | CFK | 0.258048 | 161280.0 | [-5.684341886080802e-14, 240.0, -275.0] | 1 | False | Geometrievorschlag; Last-/Montagenachweis offen
LEG_1_0 | Kufenstütze außerhalb Rotor oder darunter | new_static | CFK | 0.05252680839342897 | 32829.2552458931 | [-250.0, 170.0, -184.99999999999997] | 1 | False | Geometrievorschlag; Last-/Montagenachweis offen
LEG_1_1 | Kufenstütze außerhalb Rotor oder darunter | new_static | CFK | 0.05252680839342897 | 32829.2552458931 | [250.00000000000003, 170.0, -184.99999999999997] | 1 | False | Geometrievorschlag; Last-/Montagenachweis offen
