ITSMEEME/PropBoard/entwicklung_ab/Ausgabe/P14_R750/Stueckliste.csv

id | label | group | material | mass_kg | volume_mm3 | cg_mm | solid_count | mass_override | note
P14_0000 | +1 Zentralblock | P14_existing | Aluminium7075-T6 | 1.229278389783735 | 437465.6191401192 | [-1.2913137043216723e-13, 1.566740738628304e-14, -1.2681951307898959e-16] | 1 | True | Ein Mittelblock für beide Motoren;4×M8-Anschluss im Zentrum, noch kein freigegebenes Personendeck
P14_0001 | +1 Zentralanker_67.1751_67.1751 | P14_existing | Aluminium7075-T6 | 0.010593450427904782 | 3769.91118430775 | [67.17514421272202, 67.175144212722, 0.0] | 1 | True | Vier gemeinsame Zuganker statt doppelter Schrauben; Vorspannung/Ermüdung offen
P14_0002 | +1 Zentralankermutter_67.1751_67.1751_-101 | P14_existing | Aluminium7075-T6 | 0.0009183835052644855 | 326.8268702008844 | [67.17514421272202, 67.175144212722, -98.5] | 1 | True | ISO4032-Konturfamilie, Gewinde nominal; keine übertragene Stahlklassifizierung
P14_0003 | +1 Zentralankermutter_67.1751_67.1751_96 | P14_existing | Aluminium7075-T6 | 0.0009183835052644855 | 326.8268702008844 | [67.17514421272202, 67.175144212722, 98.5] | 1 | True | ISO4032-Konturfamilie, Gewinde nominal; keine übertragene Stahlklassifizierung
P14_0004 | +1 Zentralanker_-67.1751_67.1751 | P14_existing | Aluminium7075-T6 | 0.010593450427904782 | 3769.91118430775 | [-67.175144212722, 67.17514421272202, 0.0] | 1 | True | Vier gemeinsame Zuganker statt doppelter Schrauben; Vorspannung/Ermüdung offen
P14_0005 | +1 Zentralankermutter_-67.1751_67.1751_-101 | P14_existing | Aluminium7075-T6 | 0.0009183835052644855 | 326.8268702008844 | [-67.175144212722, 67.17514421272202, -98.5] | 1 | True | ISO4032-Konturfamilie, Gewinde nominal; keine übertragene Stahlklassifizierung
P14_0006 | +1 Zentralankermutter_-67.1751_67.1751_96 | P14_existing | Aluminium7075-T6 | 0.0009183835052644855 | 326.8268702008844 | [-67.175144212722, 67.17514421272202, 98.5] | 1 | True | ISO4032-Konturfamilie, Gewinde nominal; keine übertragene Stahlklassifizierung
P14_0007 | +1 Zentralanker_-67.1751_-67.1751 | P14_existing | Aluminium7075-T6 | 0.010593450427904782 | 3769.91118430775 | [-67.17514421272203, -67.175144212722, -1.9300077000406772e-15] | 1 | True | Vier gemeinsame Zuganker statt doppelter Schrauben; Vorspannung/Ermüdung offen
P14_0008 | +1 Zentralankermutter_-67.1751_-67.1751_-101 | P14_existing | Aluminium7075-T6 | 0.0009183835052644855 | 326.8268702008844 | [-67.17514421272203, -67.175144212722, -98.5] | 1 | True | ISO4032-Konturfamilie, Gewinde nominal; keine übertragene Stahlklassifizierung
P14_0009 | +1 Zentralankermutter_-67.1751_-67.1751_96 | P14_existing | Aluminium7075-T6 | 0.0009183835052644855 | 326.8268702008844 | [-67.17514421272203, -67.175144212722, 98.5] | 1 | True | ISO4032-Konturfamilie, Gewinde nominal; keine übertragene Stahlklassifizierung
P14_0010 | +1 Zentralanker_67.1751_-67.1751 | P14_existing | Aluminium7075-T6 | 0.010593450427904782 | 3769.91118430775 | [67.175144212722, -67.17514421272203, 0.0] | 1 | True | Vier gemeinsame Zuganker statt doppelter Schrauben; Vorspannung/Ermüdung offen
P14_0011 | +1 Zentralankermutter_67.1751_-67.1751_-101 | P14_existing | Aluminium7075-T6 | 0.0009183835052644855 | 326.8268702008843 | [67.175144212722, -67.17514421272203, -98.5] | 1 | True | ISO4032-Konturfamilie, Gewinde nominal; keine übertragene Stahlklassifizierung
P14_0012 | +1 Zentralankermutter_67.1751_-67.1751_96 | P14_existing | Aluminium7075-T6 | 0.0009183835052644855 | 326.8268702008843 | [67.175144212722, -67.17514421272203, 98.5] | 1 | True | ISO4032-Konturfamilie, Gewinde nominal; keine übertragene Stahlklassifizierung
P14_0013 | +1 A01 | P14_existing | Aluminium7075-T6 | 0.4718488921636597 | 167917.75521838423 | [2.975720992126153e-14, -2.751485737167975e-15, 10.008984865561118] | 1 | True | 8mm; 4×M6/PCD50;2mm Kopfsenkung; M6×12 ->6mm Motoreingriff angenommen
P14_0014 | +1 A03 | P14_existing | Aluminium7075-T6 | 0.21389526482784632 | 76119.31132663568 | [1.8495934524460696e-14, -2.2462762859164152e-14, 93.5747169007433] | 1 | True | Festigkeit, Passungen und Freigabe offen
P14_0015 | +1 MN1330 | P14_existing | Kaufteil | 2.75 | 1164509.1657190132 | [3.657475452992978e-15, -3.7457297186748504e-15, 46.991083072875995] | 1 | True | Ø150×66 nach Nutzerzeichnung, XLS nennt65mm;2.75kg inkl Kabel nach XLS;3400W für180s, NS52x20-Prüfwerte bis16270W mit unbekannter Haltedauer; keine Dauerdaten
P14_0016 | +1 A05 | P14_existing | Aluminium7075-T6 | 0.4843236374096961 | 172357.16633797012 | [-8.06295400322373e-15, -6.493787010563923e-15, 123.02056030850677] | 1 | True | Zwei7212B in DB-Anordnung; Innenringdistanz6mm; Montage-/Thermalspiel zu qualifizieren
P14_0017 | +1 A06O | P14_existing | Aluminium7075-T6 | 0.030870020776943053 | 10985.772518485071 | [1.2709315375129703e-15, -5.3398528110468615e-15, 149.00000000000006] | 1 | True | Festigkeit, Passungen und Freigabe offen
P14_0018 | +1 Hauptlagerbefestigung_59_0 | P14_existing | Aluminium7075-T6 | 0.0007503521021551781 | 267.02921784881795 | [59.0, -1.1473061601583823e-16, 92.87731199855385] | 1 | True | Vier M4, von unten vor Montage ueber Motor zugaenglich;8mm Eingriff
P14_0019 | +1 Hauptlagerdeckelbolzen_59_0 | P14_existing | Aluminium7075-T6 | 0.0002791651895295146 | 99.34704253719379 | [59.0, -2.1578655673098636e-17, 149.4351116408421] | 1 | True | Vier M3 von oben;6mm Eingriff
P14_0020 | +1 Hauptlagerbefestigung_3.61271e-15_59 | P14_existing | Aluminium7075-T6 | 0.0007503521021551781 | 267.0292178488179 | [3.943039733404845e-15, 59.0, 92.87731199855389] | 1 | True | Vier M4, von unten vor Montage ueber Motor zugaenglich;8mm Eingriff
P14_0021 | +1 Hauptlagerdeckelbolzen_3.61271e-15_59 | P14_existing | Aluminium7075-T6 | 0.0002791651895295146 | 99.34704253719379 | [3.7216676863156946e-15, 59.0, 149.4351116408422] | 1 | True | Vier M3 von oben;6mm Eingriff
P14_0022 | +1 Hauptlagerbefestigung_-59_7.22542e-15 | P14_existing | Aluminium7075-T6 | 0.0007503521021551781 | 267.02921784881795 | [-59.0, 7.077024520591142e-15, 92.87731199855385] | 1 | True | Vier M4, von unten vor Montage ueber Motor zugaenglich;8mm Eingriff
P14_0023 | +1 Hauptlagerdeckelbolzen_-59_7.22542e-15 | P14_existing | Aluminium7075-T6 | 0.0002791651895295146 | 99.34704253719379 | [-59.0, 7.025609101664655e-15, 149.4351116408421] | 1 | True | Vier M3 von oben;6mm Eingriff
P14_0024 | +1 Hauptlagerbefestigung_-1.08381e-14_-59 | P14_existing | Aluminium7075-T6 | 0.0007503521021551781 | 267.0292178488179 | [-1.120195948539122e-14, -59.0, 92.87731199855389] | 1 | True | Vier M4, von unten vor Montage ueber Motor zugaenglich;8mm Eingriff
P14_0025 | +1 Hauptlagerdeckelbolzen_-1.08381e-14_-59 | P14_existing | Aluminium7075-T6 | 0.0002791651895295146 | 99.34704253719379 | [-1.142256223282059e-14, -59.0, 149.43511164084222] | 1 | True | Vier M3 von oben;6mm Eingriff
P14_0026 | +1 A02_67.1751_67.1751 | P14_existing | Aluminium6082-T6 | 0.0244904363275066 | 9070.531973150592 | [67.17514421272202, 67.175144212722, 52.0] | 1 | True | 16×10.2 Rohr; vier Stützen statt Perimeterrahmen
P14_0027 | +1 A02_-67.1751_67.1751 | P14_existing | Aluminium6082-T6 | 0.0244904363275066 | 9070.531973150592 | [-67.175144212722, 67.17514421272202, 51.99999999999999] | 1 | True | 16×10.2 Rohr; vier Stützen statt Perimeterrahmen
P14_0028 | +1 A02_-67.1751_-67.1751 | P14_existing | Aluminium6082-T6 | 0.0244904363275066 | 9070.531973150592 | [-67.17514421272203, -67.175144212722, 51.99999999999999] | 1 | True | 16×10.2 Rohr; vier Stützen statt Perimeterrahmen
P14_0029 | +1 A02_67.1751_-67.1751 | P14_existing | Aluminium6082-T6 | 0.0244904363275066 | 9070.531973150592 | [67.175144212722, -67.17514421272203, 52.0] | 1 | True | 16×10.2 Rohr; vier Stützen statt Perimeterrahmen
P14_0030 | +1 Statormotorbolzen_25_0 | P14_existing | Aluminium7075-T6 | 0.0018037571013845757 | 641.9064417738703 | [25.0, -2.1861782524696298e-16, 8.455336720051513] | 1 | True | Kern-/Kopfkontur;4×M6;6mm Motoreingriff Annahme
P14_0031 | +1 Statormotorbolzen_1.53081e-15_25 | P14_existing | Aluminium7075-T6 | 0.0018037571013845757 | 641.9064417738703 | [1.667922290764107e-15, 25.0, 8.455336720051513] | 1 | True | Kern-/Kopfkontur;4×M6;6mm Motoreingriff Annahme
P14_0032 | +1 Statormotorbolzen_-25_3.06162e-15 | P14_existing | Aluminium7075-T6 | 0.0018037571013845757 | 641.9064417738703 | [-25.0, 2.9916980572691024e-15, 8.455336720051513] | 1 | True | Kern-/Kopfkontur;4×M6;6mm Motoreingriff Annahme
P14_0033 | +1 Statormotorbolzen_-4.59243e-15_-25 | P14_existing | Aluminium7075-T6 | 0.0018037571013845757 | 641.9064417738703 | [-5.614343762086403e-15, -25.0, 8.455336720051513] | 1 | True | Kern-/Kopfkontur;4×M6;6mm Motoreingriff Annahme
P14_0034 | +1 Rotormotorbolzen_20_0 | P14_existing | Aluminium7075-T6 | 0.0010530412520199143 | 374.7477765195424 | [20.0, -1.2324363403393813e-16, 85.8694865506033] | 1 | True | Kern-/Kopfkontur;12×M5;4mm Motoreingriff Annahme
P14_0035 | +1 Rotormotorbolzen_17.3205_10 | P14_existing | Aluminium7075-T6 | 0.0010530412520199143 | 374.7477765195424 | [17.320508075688775, 9.999999999999998, 85.8694865506033] | 1 | True | Kern-/Kopfkontur;12×M5;4mm Motoreingriff Annahme
P14_0036 | +1 Rotormotorbolzen_10_17.3205 | P14_existing | Aluminium7075-T6 | 0.0010530412520199143 | 374.74777651954236 | [10.000000000000002, 17.32050807568877, 85.86948655060333] | 1 | True | Kern-/Kopfkontur;12×M5;4mm Motoreingriff Annahme
P14_0037 | +1 Rotormotorbolzen_1.22465e-15_20 | P14_existing | Aluminium7075-T6 | 0.0010530412520199143 | 374.7477765195423 | [7.274419631941753e-16, 20.0, 85.8694865506033] | 1 | True | Kern-/Kopfkontur;12×M5;4mm Motoreingriff Annahme
P14_0038 | +1 Rotormotorbolzen_-10_17.3205 | P14_existing | Aluminium7075-T6 | 0.0010530412520199143 | 374.7477765195424 | [-9.999999999999996, 17.320508075688775, 85.8694865506033] | 1 | True | Kern-/Kopfkontur;12×M5;4mm Motoreingriff Annahme
P14_0039 | +1 Rotormotorbolzen_-17.3205_10 | P14_existing | Aluminium7075-T6 | 0.0010530412520199143 | 374.7477765195424 | [-17.320508075688775, 9.999999999999998, 85.8694865506033] | 1 | True | Kern-/Kopfkontur;12×M5;4mm Motoreingriff Annahme
P14_0040 | +1 Rotormotorbolzen_-20_2.44929e-15 | P14_existing | Aluminium7075-T6 | 0.0010530412520199143 | 374.7477765195424 | [-20.0, 1.7327746204360284e-15, 85.8694865506033] | 1 | True | Kern-/Kopfkontur;12×M5;4mm Motoreingriff Annahme
P14_0041 | +1 Rotormotorbolzen_-17.3205_-10 | P14_existing | Aluminium7075-T6 | 0.0010530412520199143 | 374.7477765195424 | [-17.32050807568877, -10.000000000000002, 85.8694865506033] | 1 | True | Kern-/Kopfkontur;12×M5;4mm Motoreingriff Annahme
P14_0042 | +1 Rotormotorbolzen_-10_-17.3205 | P14_existing | Aluminium7075-T6 | 0.0010530412520199143 | 374.74777651954236 | [-10.000000000000009, -17.320508075688767, 85.8694865506033] | 1 | True | Kern-/Kopfkontur;12×M5;4mm Motoreingriff Annahme
P14_0043 | +1 Rotormotorbolzen_-3.67394e-15_-20 | P14_existing | Aluminium7075-T6 | 0.0010530412520199143 | 374.7477765195424 | [-4.287963491060067e-15, -20.0, 85.8694865506033] | 1 | True | Kern-/Kopfkontur;12×M5;4mm Motoreingriff Annahme
P14_0044 | +1 Rotormotorbolzen_10_-17.3205 | P14_existing | Aluminium7075-T6 | 0.0010530412520199143 | 374.7477765195424 | [10.000000000000002, -17.32050807568877, 85.86948655060328] | 1 | True | Kern-/Kopfkontur;12×M5;4mm Motoreingriff Annahme
P14_0045 | +1 Rotormotorbolzen_17.3205_-10 | P14_existing | Aluminium7075-T6 | 0.0010530412520199143 | 374.74777651954236 | [17.320508075688767, -10.000000000000009, 85.8694865506033] | 1 | True | Kern-/Kopfkontur;12×M5;4mm Motoreingriff Annahme
P14_0046 | +1 Rotornabenbolzen_48_0 | P14_existing | Aluminium7075-T6 | 0.003348635288787356 | 1191.6851561520843 | [48.0, -1.6855805713556667e-16, 179.7597450364237] | 1 | True | 6xM6/PCD96, SW5 von oben;12mm Gewindeeingriff direkt im Rotorflansch
P14_0047 | +1 Rotornabenbolzen_24_41.5692 | P14_existing | Aluminium7075-T6 | 0.003348635288787356 | 1191.685156152084 | [24.000000000000007, 41.569219381653056, 179.75974503642377] | 1 | True | 6xM6/PCD96, SW5 von oben;12mm Gewindeeingriff direkt im Rotorflansch
P14_0048 | +1 Rotornabenbolzen_-24_41.5692 | P14_existing | Aluminium7075-T6 | 0.003348635288787356 | 1191.685156152084 | [-23.99999999999999, 41.569219381653056, 179.75974503642377] | 1 | True | 6xM6/PCD96, SW5 von oben;12mm Gewindeeingriff direkt im Rotorflansch
P14_0049 | +1 Rotornabenbolzen_-48_5.8783e-15 | P14_existing | Aluminium7075-T6 | 0.003348635288787356 | 1191.6851561520843 | [-48.0, 6.063742742096176e-15, 179.7597450364237] | 1 | True | 6xM6/PCD96, SW5 von oben;12mm Gewindeeingriff direkt im Rotorflansch
P14_0050 | +1 Rotornabenbolzen_-24_-41.5692 | P14_existing | Aluminium7075-T6 | 0.003348635288787356 | 1191.685156152084 | [-24.00000000000002, -41.56921938165304, 179.75974503642374] | 1 | True | 6xM6/PCD96, SW5 von oben;12mm Gewindeeingriff direkt im Rotorflansch
P14_0051 | +1 Rotornabenbolzen_24_-41.5692 | P14_existing | Aluminium7075-T6 | 0.003348635288787356 | 1191.685156152084 | [24.000000000000007, -41.569219381653056, 179.75974503642377] | 1 | True | 6xM6/PCD96, SW5 von oben;12mm Gewindeeingriff direkt im Rotorflansch
P14_0052 | +1 Hauptlager98 | P14_existing | Wälzlagerstahl | 0.65 | 146786.4908632527 | [-1.1103300419487742e-14, -4.8872836691853884e-15, 109.0] | 1 | True | 60×110×22;0.65kg Masseannahme, reale Lieferdaten/Schulterradien offen
P14_0053 | +1 Hauptlager126 | P14_existing | Wälzlagerstahl | 0.65 | 146786.4908632527 | [-1.1103300419487742e-14, -4.8872836691853884e-15, 137.0] | 1 | True | 60×110×22;0.65kg Masseannahme, reale Lieferdaten/Schulterradien offen
P14_0054 | +1 A04 | P14_existing | Aluminium7075-T6 | 0.32743182407392907 | 116523.78080922746 | [4.4958114522466795e-15, -0.030529503079069445, 113.41412497162116] | 1 | True | 60/50.4; oberer Flansch separat montierbar; durchgehender unterbrochener M60x1.5-Bereich148..175 mit D57;12×M5/PCD40
P14_0055 | +1 A04F | P14_existing | Aluminium7075-T6 | 0.22792927772340976 | 81113.62196562624 | [-4.825903592481085e-14, -3.1374608921402094e-15, 162.18422288506778] | 1 | True | D57-Sitz,80mm Zentrierbund; sechs M6/PCD96 von oben direkt in12mm Alu-Gewinde; beide7212 montierbar
P14_0056 | +1 A04W | P14_existing | Aluminium1050 | 0.002789498327936576 | 1033.1475288653985 | [0.5941068268092213, 0.10152954642905657, 168.5522674627691] | 1 | True | Festigkeit, Passungen und Freigabe offen
P14_0057 | +1 A04N | P14_existing | Aluminium7075-T6 | 0.016879153656295755 | 6006.816247792083 | [-0.34956641977716546, -1.3412155628612586e-15, 171.9999999999999] | 1 | True | M60x1.5, D-Flansch formschluessig; keyed tab washer retains nut
P14_0058 | +1 A07 | P14_existing | Aluminium7075-T6 | 0.034812594050571743 | 12388.823505541544 | [1.8206303926986703e-14, -5.025201272698245e-15, 122.99999999999996] | 1 | True | Festigkeit, Passungen und Freigabe offen
P14_0059 | +1 A08W | P14_existing | Aluminium1050 | 0.00597036088969624 | 2211.244773961571 | [0.31828226720422875, 0.047437082151722106, 148.5244206343123] | 1 | True | Innennase in durchgehender Wellennut; Aussentab in Mutternut umlegen, nach Demontage ersetzen
P14_0060 | +1 A08 | P14_existing | Aluminium7075-T6 | 0.03674176553164435 | 13075.361399161695 | [-0.1846817977937526, 8.858834908591818e-16, 151.99999999999994] | 1 | True | M60x1.5, mit Formschluss-Sicherungsblech; konkrete Lagervorspannung nach Lieferteil
P14_0061 | +1 A09 | P14_existing | Aluminium7075-T6 | 2.96000970940717 | 1053384.238223193 | [1.8109509025940096e-07, 0.0001922159297746551, 166.38585745786793] | 1 | True | Ein CNC-Teil statt Stern plus8 verschraubten Patronen; geschlossene Lager-/Fliehkraftpfade im Zentrum
P14_0062 | +1 A24 | P14_existing | Aluminium7075-T6 | 0.0038454225053294335 | 1368.477759903713 | [51.88527685766289, 177.57510536503617, 122.06060606060609] | 1 | True | D8-Schulter/M6-Anker; harteloxiert; tangentiale Spielführung mit wechselbarer Gleitbuchse, keine Schubführung
P14_0063 | +1 A24_Gegenseite | P14_existing | Aluminium7075-T6 | 0.0038454225053294335 | 1368.477759903713 | [-51.88527685766289, -177.57510536503617, 122.06060606060609] | 1 | True | D8-Schulter/M6-Anker; harteloxiert; tangentiale Spielführung mit wechselbarer Gleitbuchse, keine Schubführung
P14_0064 | +1 A19 | P14_existing | Aluminium7075-T6 | 0.24951071596356897 | 88793.8490973555 | [6.817585673488843e-14, -1.2810920772647443e-14, 119.99999999999994] | 1 | True | Eigenkonstruktion, nicht als Norm-Gelenklager ausgegeben; verschleißarme Auskleidung und Spiel prüfen
P14_0065 | +1 POM01 | P14_existing | PTFE | 0.006285045130030695 | 2856.8386954684975 | [3.2599760570757374e-13, -3.264211233884685e-13, 120.00000000000033] | 1 | True | 0.2mm nominale Folie; realen Verbund, Kriechen und Reibung qualifizieren
P14_0066 | +1 A20 | P14_existing | Aluminium7075-T6 | 0.29629202391960435 | 105442.00139487702 | [9.798618838282452e-15, 1.766511565211484e-14, 108.50864996192756] | 1 | True | Geteilte Kugelpfanne: Ball und PTFE montierbar; Phase durch eine gefuehrte RRS-Anlenkung
P14_0067 | +1 A20C | P14_existing | Aluminium7075-T6 | 0.20237351041454132 | 72019.04285214993 | [-2.9500247978901555e-14, -7.555465108651558e-15, 128.23823261181116] | 1 | True | Vier M3/PCD152,6mm Eingriff, vor Montage des Rotationslagers schliessen
P14_0068 | +1 POM02 | P14_existing | PTFE | 0.01403311739246551 | 6378.689723847958 | [1.6060584170553164e-12, -1.0764727765729995e-13, 112.00000000000014] | 1 | True | Festigkeit, Passungen und Freigabe offen
P14_0069 | +1 POM02U | P14_existing | PTFE | 0.014033117392468196 | 6378.6897238498495 | [-2.00757302131855e-12, -5.865245575590274e-14, 128.0] | 1 | True | Festigkeit, Passungen und Freigabe offen
P14_0070 | +1 A22 | P14_existing | Aluminium7075-T6 | 0.028849408386573912 | 10266.69337600495 | [1.0205212701600295e-13, -1.5753277333900009e-15, 137.99999999999983] | 1 | True | Festigkeit, Passungen und Freigabe offen
P14_0071 | +1 B61832 | P14_existing | Wälzlagerstahl | 0.9 | 225993.58399589424 | [2.884709338662813e-14, -9.966325435495979e-16, 125.99999999999997] | 1 | True | 160×200×20; Massendatum0.90kg angenommen, Lieferdaten prüfen
P14_0072 | +1 A21 | P14_existing | Aluminium7075-T6 | 0.44248104072213473 | 157466.56253456755 | [-6.653716697552286e-15, -2.3657659369074796e-14, 122.19982435183623] | 1 | True | Festigkeit, Passungen und Freigabe offen
P14_0073 | +1 A21C | P14_existing | Aluminium7075-T6 | 0.06389015887573654 | 22736.711343678482 | [1.9710568847205387e-14, -1.1700337671857079e-15, 137.49999999999986] | 1 | True | Vier M3/PCD206;61832 von oben montierbar
P14_0074 | +1 Kugelpfannenbolzen_53.7401_53.7401 | P14_existing | Aluminium7075-T6 | 0.00045713515671831476 | 162.68155043356398 | [53.74011537017761, 53.7401153701776, 129.8152937219364] | 1 | True | Vier M3,6mm Gewindeeingriff
P14_0075 | +1 Kugelpfannenbolzen_-53.7401_53.7401 | P14_existing | Aluminium7075-T6 | 0.00045713515671831476 | 162.68155043356398 | [-53.7401153701776, 53.74011537017761, 129.81529372193646] | 1 | True | Vier M3,6mm Gewindeeingriff
P14_0076 | +1 Kugelpfannenbolzen_-53.7401_-53.7401 | P14_existing | Aluminium7075-T6 | 0.00045713515671831476 | 162.68155043356398 | [-53.74011537017763, -53.7401153701776, 129.8152937219364] | 1 | True | Vier M3,6mm Gewindeeingriff
P14_0077 | +1 Kugelpfannenbolzen_53.7401_-53.7401 | P14_existing | Aluminium7075-T6 | 0.00045713515671831476 | 162.68155043356398 | [53.7401153701776, -53.74011537017763, 129.8152937219364] | 1 | True | Vier M3,6mm Gewindeeingriff
P14_0078 | +1 Taumeldeckelbolzen_72.832_72.832 | P14_existing | Aluminium7075-T6 | 0.0002791651895295146 | 99.34704253719377 | [72.8319984622144, 72.83199846221439, 138.4351116408422] | 1 | True | Vier M3,5mm Gewindeeingriff
P14_0079 | +1 Taumeldeckelbolzen_-72.832_72.832 | P14_existing | Aluminium7075-T6 | 0.0002791651895295146 | 99.3470425371937 | [-72.83199846221439, 72.8319984622144, 138.43511164084222] | 1 | True | Vier M3,5mm Gewindeeingriff
P14_0080 | +1 Taumeldeckelbolzen_-72.832_-72.832 | P14_existing | Aluminium7075-T6 | 0.0002791651895295146 | 99.34704253719372 | [-72.83199846221441, -72.83199846221439, 138.4351116408421] | 1 | True | Vier M3,5mm Gewindeeingriff
P14_0081 | +1 Taumeldeckelbolzen_72.832_-72.832 | P14_existing | Aluminium7075-T6 | 0.0002791651895295146 | 99.34704253719374 | [72.83199846221437, -72.83199846221441, 138.43511164084225] | 1 | True | Vier M3,5mm Gewindeeingriff
P14_0082 | +1 Blatt1_A11 | P14_existing | Aluminium7075-T6 | 0.01734045985669258 | 6170.982155406611 | [92.99999999999999, 1.5106704991854345e-15, 180.0] | 1 | True | Festigkeit, Passungen und Freigabe offen
P14_0083 | +1 Blatt1_A11O | P14_existing | Aluminium7075-T6 | 0.028691565939951476 | 10210.52168681547 | [151.30934952763133, -4.899084506338514e-16, 180.0] | 1 | True | Offenes Aussenlager-Montagefenster52.1mm; sechs M6/PCD64,14.4mm Eingriff
P14_0084 | +1 Blatt1_B720595 | P14_existing | Wälzlagerstahl | 0.12 | 24469.06093109158 | [102.5, 2.322528648499182e-15, 180.0] | 1 | True | 25×52×15; Paarabstimmung, Tragzahlen und Massendaten nach Lieferteil
P14_0085 | +1 Blatt1_B7205130 | P14_existing | Wälzlagerstahl | 0.12 | 24469.06093109158 | [137.5, 2.322528648499182e-15, 180.0] | 1 | True | 25×52×15; Paarabstimmung, Tragzahlen und Massendaten nach Lieferteil
P14_0086 | +1 Blatt1_A12 | P14_existing | Aluminium7075-T6 | 0.02939638354366796 | 10461.346456821337 | [119.99999999999997, 6.836586334288439e-16, 180.0] | 1 | True | Festigkeit, Passungen und Freigabe offen
P14_0087 | +1 Blatt1_A13 | P14_existing | Aluminium7075-T6 | 0.37670176314978054 | 134057.56695721726 | [170.75999737729737, 0.005229060494247745, 179.97539920455446] | 1 | True | Ein CNC-Teil statt Welle/Innenplatte/Einsatz/Endschraube;12mm Integralflansch,4xM6/PCD64; obere Bohrungen-24Grad indexiert; Ermuedung/Flankenpressung offen
P14_0088 | +1 Blatt1_A13C | P14_existing | Aluminium7075-T6 | 0.00587927670873359 | 2092.269291364266 | [147.00000000000003, 7.60712655236081e-16, 180.0] | 1 | True | Separater Ring statt unmontierbarem Integralbund
P14_0089 | +1 Blatt1_A13D | P14_existing | Aluminium7075-T6 | 0.02351710683493436 | 8369.077165457064 | [157.0, 1.5757619287033107e-15, 180.0] | 1 | True | Festigkeit, Passungen und Freigabe offen
P14_0090 | +1 Blatt1_A14 | P14_existing | Aluminium7075-T6 | 0.012438092144294009 | 4426.367311136657 | [88.50000000000001, -0.19281889498003227, 179.95901507865804] | 1 | True | M25x1.5; Sicherungsblech mit Innennase und Aussentab
P14_0091 | +1 Blatt1_A14W | P14_existing | Aluminium1050 | 0.0017632627869432148 | 653.0602914604499 | [92.45589993699417, 0.3020003351009338, 180.1063891614515] | 1 | True | Festigkeit, Passungen und Freigabe offen
P14_0092 | +1 Blatt1_A14S | P14_existing | Aluminium7075-T6 | 0.002939638354366795 | 1046.134645682133 | [94.00000000000001, 7.60712655236081e-16, 180.0] | 1 | True | Festigkeit, Passungen und Freigabe offen
P14_0093 | +1 Blatt1_A16A | P14_existing | Aluminium7075-T6 | 0.042995284136722885 | 15300.812860043734 | [186.99999999999994, 2.1695943162209877e-15, 180.0] | 1 | True | Vier M6/PCD64 von aussen in12mm Integralflansch; CFK-Klemmdruck und Ermuedung qualifizieren
P14_0094 | +1 Blatt1_CFK01 | P14_existing | CFK | 0.5931560830883226 | 370722.5519302023 | [377.643445265029, 18.999343090261224, 175.96156495874502] | 1 | True | Kontinuierliche Innenanbindung; 1.2mm nominale Vertikalschale; interner geschlossener Kastenspar und Wurzelaufdickung; Laminatnachweis offen
P14_0095 | +1 Blatt1_A18 | P14_existing | Aluminium7075-T6 | 0.030692688917754184 | 10922.665095286187 | [75.14268082576996, 14.358836759706897, 188.5827708257649] | 1 | True | D-Flach10.5/10.6mm zur Welle; M4×30-Klemmung axial sichern; Füge-/Ermüdungsnachweis offen
P14_0096 | +1 Blatt1_A18B | P14_existing | Aluminium7075-T6 | 0.001066743154935268 | 379.62389855347607 | [79.0, -17.761578512244604, 186.60590754466537] | 1 | True | ISO4762-Konturfamilie, keine übertragene Stahl8.8-Festigkeit; Anzug/Alu-Schraube qualifizieren
P14_0097 | +1 Blatt1_A18S | P14_existing | Aluminium7075-T6 | 0.00734909588591699 | 2615.3366142053333 | [72.5, 1.2171402483777293e-15, 180.0] | 1 | True | Festigkeit, Passungen und Freigabe offen
P14_0098 | +1 Blatt1_A18T | P14_existing | Aluminium7075-T6 | 0.002939638354366795 | 1046.134645682133 | [84.0, 7.60712655236081e-16, 180.0] | 1 | True | Festigkeit, Passungen und Freigabe offen
P14_0099 | +1 Blatt1_A18W | P14_existing | Aluminium7075-T6 | 0.002769834171882837 | 985.7061109903336 | [69.5, -3.4420417256475245e-16, 180.0] | 1 | True | Festigkeit, Passungen und Freigabe offen
P14_0100 | +1 Blatt1_F6_PITCH_END | P14_existing | Aluminium7075-T6 | 0.001883516955231342 | 670.2907313990543 | [70.08399686305707, -7.049860480148255e-16, 180.0] | 1 | True | Positiver Endanschlag;13mm Gewindeeingriff; Sicherungskleber und Kontrollmarke, Anzug qualifizieren
P14_0101 | +1 Blatt1_Lagerdeckelbolzen0 | P14_existing | Aluminium7075-T6 | 0.00030458947055648583 | 108.39482937953237 | [92.26897260888201, 1.9540134164658043e-15, 210.0] | 1 | True | Drei M3 auf PCD60;6mm Eingriff
P14_0102 | +1 Blatt1_Lagerdeckelbolzen1 | P14_existing | Aluminium7075-T6 | 0.00030458947055648583 | 108.39482937953237 | [92.26897260888201, -25.980762113533157, 165.0] | 1 | True | Drei M3 auf PCD60;6mm Eingriff
P14_0103 | +1 Blatt1_Lagerdeckelbolzen2 | P14_existing | Aluminium7075-T6 | 0.00030458947055648583 | 108.39482937953237 | [92.26897260888201, 25.980762113533153, 165.0] | 1 | True | Drei M3 auf PCD60;6mm Eingriff
P14_0104 | +1 Blatt1_F6_ROOT_OUT0 | P14_existing | Aluminium7075-T6 | 0.0022451508692139426 | 798.9860744533604 | [153.0886025096639, 32.0, 180.0] | 1 | True | M6x20 unter Kopf, von aussen nach innen;14.4mm Gewindeeingriff
P14_0105 | +1 Blatt1_W6_ROOT_OUT0 | P14_existing | Aluminium7075-T6 | 0.00036384971069710286 | 129.48388281035687 | [155.8, 32.0, 180.0] | 1 | True | Festigkeit, Passungen und Freigabe offen
P14_0106 | +1 Blatt1_F6_ROOT_OUT1 | P14_existing | Aluminium7075-T6 | 0.0022451508692139426 | 798.9860744533605 | [153.08860250966373, 16.000000000000004, 207.71281292110203] | 1 | True | M6x20 unter Kopf, von aussen nach innen;14.4mm Gewindeeingriff
P14_0107 | +1 Blatt1_W6_ROOT_OUT1 | P14_existing | Aluminium7075-T6 | 0.00036384971069710286 | 129.48388281035687 | [155.8, 16.000000000000004, 207.71281292110203] | 1 | True | Festigkeit, Passungen und Freigabe offen
P14_0108 | +1 Blatt1_F6_ROOT_OUT2 | P14_existing | Aluminium7075-T6 | 0.0022451508692139426 | 798.9860744533603 | [153.08860250966384, -15.999999999999993, 207.71281292110203] | 1 | True | M6x20 unter Kopf, von aussen nach innen;14.4mm Gewindeeingriff
P14_0109 | +1 Blatt1_W6_ROOT_OUT2 | P14_existing | Aluminium7075-T6 | 0.00036384971069710286 | 129.48388281035687 | [155.8, -15.999999999999993, 207.71281292110203] | 1 | True | Festigkeit, Passungen und Freigabe offen
P14_0110 | +1 Blatt1_F6_ROOT_OUT3 | P14_existing | Aluminium7075-T6 | 0.0022451508692139426 | 798.9860744533604 | [153.0886025096639, -32.0, 180.0] | 1 | True | M6x20 unter Kopf, von aussen nach innen;14.4mm Gewindeeingriff
P14_0111 | +1 Blatt1_W6_ROOT_OUT3 | P14_existing | Aluminium7075-T6 | 0.00036384971069710286 | 129.48388281035687 | [155.8, -32.0, 180.0] | 1 | True | Festigkeit, Passungen und Freigabe offen
P14_0112 | +1 Blatt1_F6_ROOT_OUT4 | P14_existing | Aluminium7075-T6 | 0.0022451508692139426 | 798.9860744533602 | [153.0886025096638, -16.000000000000014, 152.28718707889797] | 1 | True | M6x20 unter Kopf, von aussen nach innen;14.4mm Gewindeeingriff
P14_0113 | +1 Blatt1_W6_ROOT_OUT4 | P14_existing | Aluminium7075-T6 | 0.00036384971069710286 | 129.4838828103569 | [155.79999999999998, -16.000000000000014, 152.28718707889797] | 1 | True | Festigkeit, Passungen und Freigabe offen
P14_0114 | +1 Blatt1_F6_ROOT_OUT5 | P14_existing | Aluminium7075-T6 | 0.0022451508692139426 | 798.9860744533604 | [153.0886025096638, 16.000000000000004, 152.28718707889797] | 1 | True | M6x20 unter Kopf, von aussen nach innen;14.4mm Gewindeeingriff
P14_0115 | +1 Blatt1_W6_ROOT_OUT5 | P14_existing | Aluminium7075-T6 | 0.00036384971069710286 | 129.4838828103569 | [155.79999999999998, 16.000000000000004, 152.28718707889797] | 1 | True | Festigkeit, Passungen und Freigabe offen
P14_0116 | +1 Blatt1_F6_ROOT0 | P14_existing | Aluminium7075-T6 | 0.0024663994953384124 | 877.7222403339549 | [183.56376145534605, 26.83745817425357, 197.42844912048085] | 1 | True | SW5 von aussen;12mm Gewindeeingriff im Integralflansch; Alu-Verbindung und CFK-Lip qualifizieren
P14_0117 | +1 Blatt1_F6_ROOT1 | P14_existing | Aluminium7075-T6 | 0.0024663994953384124 | 877.7222403339546 | [183.5637614553462, -17.428449120480863, 206.83745817425358] | 1 | True | SW5 von aussen;12mm Gewindeeingriff im Integralflansch; Alu-Verbindung und CFK-Lip qualifizieren
P14_0118 | +1 Blatt1_F6_ROOT2 | P14_existing | Aluminium7075-T6 | 0.0024663994953384124 | 877.7222403339546 | [183.5637614553462, -26.837458174253577, 162.57155087951912] | 1 | True | SW5 von aussen;12mm Gewindeeingriff im Integralflansch; Alu-Verbindung und CFK-Lip qualifizieren
P14_0119 | +1 Blatt1_F6_ROOT3 | P14_existing | Aluminium7075-T6 | 0.0024663994953384124 | 877.7222403339546 | [183.56376145534617, 17.42844912048085, 153.16254182574644] | 1 | True | SW5 von aussen;12mm Gewindeeingriff im Integralflansch; Alu-Verbindung und CFK-Lip qualifizieren
P14_0120 | +1 Blatt2_A11 | P14_existing | Aluminium7075-T6 | 0.01734045985669258 | 6170.982155406611 | [-2.7173646174372146e-15, 92.99999999999999, 180.0] | 1 | True | Festigkeit, Passungen und Freigabe offen
P14_0121 | +1 Blatt2_A11O | P14_existing | Aluminium7075-T6 | 0.028691565939951476 | 10210.52168681547 | [-3.5963733989712274e-15, 151.30934952763144, 180.0] | 1 | True | Offenes Aussenlager-Montagefenster52.1mm; sechs M6/PCD64,14.4mm Eingriff
P14_0122 | +1 Blatt2_B720595 | P14_existing | Wälzlagerstahl | 0.12 | 24469.06093109158 | [9.565571496748417e-15, 102.5, 180.0] | 1 | True | 25×52×15; Paarabstimmung, Tragzahlen und Massendaten nach Lieferteil
P14_0123 | +1 Blatt2_B7205130 | P14_existing | Wälzlagerstahl | 0.12 | 24469.06093109158 | [1.2952303246229691e-14, 137.5, 180.0] | 1 | True | 25×52×15; Paarabstimmung, Tragzahlen und Massendaten nach Lieferteil
P14_0124 | +1 Blatt2_A12 | P14_existing | Aluminium7075-T6 | 0.02939638354366796 | 10461.346456821335 | [1.1077291542401619e-16, 119.99999999999997, 180.0] | 1 | True | Festigkeit, Passungen und Freigabe offen
P14_0125 | +1 Blatt2_A13 | P14_existing | Aluminium7075-T6 | 0.37670176314978054 | 134057.56695721726 | [-0.005229060494247745, 170.75999737729737, 179.97539920455446] | 1 | True | Ein CNC-Teil statt Welle/Innenplatte/Einsatz/Endschraube;12mm Integralflansch,4xM6/PCD64; obere Bohrungen-24Grad indexiert; Ermuedung/Flankenpressung offen
P14_0126 | +1 Blatt2_A13C | P14_existing | Aluminium7075-T6 | 0.00587927670873359 | 2092.269291364266 | [-1.3040788375475676e-15, 147.00000000000003, 180.0] | 1 | True | Separater Ring statt unmontierbarem Integralbund
P14_0127 | +1 Blatt2_A13D | P14_existing | Aluminium7075-T6 | 0.02351710683493436 | 8369.077165457065 | [2.716830911557432e-16, 157.0, 180.00000000000003] | 1 | True | Festigkeit, Passungen und Freigabe offen
P14_0128 | +1 Blatt2_A14 | P14_existing | Aluminium7075-T6 | 0.012438092144294009 | 4426.367311136659 | [0.19281889498002724, 88.49999999999997, 179.95901507865804] | 1 | True | M25x1.5; Sicherungsblech mit Innennase und Aussentab
P14_0129 | +1 Blatt2_A14W | P14_existing | Aluminium1050 | 0.0017632627869432148 | 653.0602914604498 | [-0.3020003351009362, 92.45589993699419, 180.1063891614515] | 1 | True | Festigkeit, Passungen und Freigabe offen
P14_0130 | +1 Blatt2_A14S | P14_existing | Aluminium7075-T6 | 0.002939638354366795 | 1046.134645682133 | [-1.5757619287033107e-15, 94.00000000000001, 180.0] | 1 | True | Festigkeit, Passungen und Freigabe offen
P14_0131 | +1 Blatt2_A16A | P14_existing | Aluminium7075-T6 | 0.042995284136722885 | 15300.812860043734 | [-9.956357478548369e-16, 186.99999999999994, 180.0] | 1 | True | Vier M6/PCD64 von aussen in12mm Integralflansch; CFK-Klemmdruck und Ermuedung qualifizieren
P14_0132 | +1 Blatt2_CFK01 | P14_existing | CFK | 0.5931560830883226 | 370722.5519302024 | [-18.999343090261217, 377.6434452650285, 175.961564958745] | 1 | True | Kontinuierliche Innenanbindung; 1.2mm nominale Vertikalschale; interner geschlossener Kastenspar und Wurzelaufdickung; Laminatnachweis offen
P14_0133 | +1 Blatt2_A18 | P14_existing | Aluminium7075-T6 | 0.030692688917754184 | 10922.665095286186 | [-14.358836759706898, 75.14268082576999, 188.58277082576492] | 1 | True | D-Flach10.5/10.6mm zur Welle; M4×30-Klemmung axial sichern; Füge-/Ermüdungsnachweis offen
P14_0134 | +1 Blatt2_A18B | P14_existing | Aluminium7075-T6 | 0.001066743154935268 | 379.6238985534761 | [17.761578512244597, 79.00000000000003, 186.60590754466537] | 1 | True | ISO4762-Konturfamilie, keine übertragene Stahl8.8-Festigkeit; Anzug/Alu-Schraube qualifizieren
P14_0135 | +1 Blatt2_A18S | P14_existing | Aluminium7075-T6 | 0.00734909588591699 | 2615.3366142053333 | [-1.5648946050570804e-15, 72.5, 180.0] | 1 | True | Festigkeit, Passungen und Freigabe offen
P14_0136 | +1 Blatt2_A18T | P14_existing | Aluminium7075-T6 | 0.002939638354366795 | 1046.134645682133 | [-1.793108401627905e-15, 84.0, 180.0] | 1 | True | Festigkeit, Passungen und Freigabe offen
P14_0137 | +1 Blatt2_A18W | P14_existing | Aluminium7075-T6 | 0.002769834171882837 | 985.7061109903336 | [-6.748924744790565e-16, 69.5, 180.0] | 1 | True | Festigkeit, Passungen und Freigabe offen
P14_0138 | +1 Blatt2_F6_PITCH_END | P14_existing | Aluminium7075-T6 | 0.001883516955231342 | 670.2907313990543 | [7.06186887673123e-16, 70.08399686305705, 180.0] | 1 | True | Positiver Endanschlag;13mm Gewindeeingriff; Sicherungskleber und Kontrollmarke, Anzug qualifizieren
P14_0139 | +1 Blatt2_Lagerdeckelbolzen0 | P14_existing | Aluminium7075-T6 | 0.00030458947055648583 | 108.39482937953237 | [-1.9650666401380404e-15, 92.26897260888201, 210.0] | 1 | True | Drei M3 auf PCD60;6mm Eingriff
P14_0140 | +1 Blatt2_Lagerdeckelbolzen1 | P14_existing | Aluminium7075-T6 | 0.00030458947055648583 | 108.39482937953238 | [25.980762113533157, 92.268972608882, 165.0] | 1 | True | Drei M3 auf PCD60;6mm Eingriff
P14_0141 | +1 Blatt2_Lagerdeckelbolzen2 | P14_existing | Aluminium7075-T6 | 0.00030458947055648583 | 108.39482937953237 | [-25.980762113533153, 92.26897260888201, 165.0] | 1 | True | Drei M3 auf PCD60;6mm Eingriff
P14_0142 | +1 Blatt2_F6_ROOT_OUT0 | P14_existing | Aluminium7075-T6 | 0.0022451508692139426 | 798.9860744533601 | [-32.0, 153.08860250966387, 180.0] | 1 | True | M6x20 unter Kopf, von aussen nach innen;14.4mm Gewindeeingriff
P14_0143 | +1 Blatt2_W6_ROOT_OUT0 | P14_existing | Aluminium7075-T6 | 0.00036384971069710286 | 129.48388281035687 | [-32.0, 155.79999999999998, 180.0] | 1 | True | Festigkeit, Passungen und Freigabe offen
P14_0144 | +1 Blatt2_F6_ROOT_OUT1 | P14_existing | Aluminium7075-T6 | 0.0022451508692139426 | 798.9860744533604 | [-16.000000000000004, 153.0886025096638, 207.71281292110203] | 1 | True | M6x20 unter Kopf, von aussen nach innen;14.4mm Gewindeeingriff
P14_0145 | +1 Blatt2_W6_ROOT_OUT1 | P14_existing | Aluminium7075-T6 | 0.00036384971069710286 | 129.48388281035687 | [-16.000000000000004, 155.8, 207.71281292110203] | 1 | True | Festigkeit, Passungen und Freigabe offen
P14_0146 | +1 Blatt2_F6_ROOT_OUT2 | P14_existing | Aluminium7075-T6 | 0.0022451508692139426 | 798.9860744533602 | [15.999999999999993, 153.0886025096639, 207.71281292110206] | 1 | True | M6x20 unter Kopf, von aussen nach innen;14.4mm Gewindeeingriff
P14_0147 | +1 Blatt2_W6_ROOT_OUT2 | P14_existing | Aluminium7075-T6 | 0.00036384971069710286 | 129.4838828103569 | [15.999999999999993, 155.79999999999998, 207.71281292110203] | 1 | True | Festigkeit, Passungen und Freigabe offen
P14_0148 | +1 Blatt2_F6_ROOT_OUT3 | P14_existing | Aluminium7075-T6 | 0.0022451508692139426 | 798.9860744533601 | [32.0, 153.08860250966381, 180.0] | 1 | True | M6x20 unter Kopf, von aussen nach innen;14.4mm Gewindeeingriff
P14_0149 | +1 Blatt2_W6_ROOT_OUT3 | P14_existing | Aluminium7075-T6 | 0.00036384971069710286 | 129.48388281035685 | [32.0, 155.79999999999998, 180.0] | 1 | True | Festigkeit, Passungen und Freigabe offen
P14_0150 | +1 Blatt2_F6_ROOT_OUT4 | P14_existing | Aluminium7075-T6 | 0.0022451508692139426 | 798.9860744533604 | [16.000000000000014, 153.0886025096638, 152.28718707889797] | 1 | True | M6x20 unter Kopf, von aussen nach innen;14.4mm Gewindeeingriff
P14_0151 | +1 Blatt2_W6_ROOT_OUT4 | P14_existing | Aluminium7075-T6 | 0.00036384971069710286 | 129.48388281035687 | [16.000000000000014, 155.8, 152.28718707889797] | 1 | True | Festigkeit, Passungen und Freigabe offen
P14_0152 | +1 Blatt2_F6_ROOT_OUT5 | P14_existing | Aluminium7075-T6 | 0.0022451508692139426 | 798.9860744533604 | [-16.000000000000004, 153.0886025096638, 152.28718707889797] | 1 | True | M6x20 unter Kopf, von aussen nach innen;14.4mm Gewindeeingriff
P14_0153 | +1 Blatt2_W6_ROOT_OUT5 | P14_existing | Aluminium7075-T6 | 0.00036384971069710286 | 129.4838828103569 | [-16.000000000000004, 155.79999999999998, 152.28718707889797] | 1 | True | Festigkeit, Passungen und Freigabe offen
P14_0154 | +1 Blatt2_F6_ROOT0 | P14_existing | Aluminium7075-T6 | 0.0024663994953384124 | 877.7222403339546 | [-26.83745817425357, 183.56376145534622, 197.42844912048082] | 1 | True | SW5 von aussen;12mm Gewindeeingriff im Integralflansch; Alu-Verbindung und CFK-Lip qualifizieren
P14_0155 | +1 Blatt2_F6_ROOT1 | P14_existing | Aluminium7075-T6 | 0.0024663994953384124 | 877.7222403339547 | [17.428449120480863, 183.56376145534617, 206.83745817425358] | 1 | True | SW5 von aussen;12mm Gewindeeingriff im Integralflansch; Alu-Verbindung und CFK-Lip qualifizieren
P14_0156 | +1 Blatt2_F6_ROOT2 | P14_existing | Aluminium7075-T6 | 0.0024663994953384124 | 877.7222403339547 | [26.837458174253577, 183.56376145534622, 162.57155087951912] | 1 | True | SW5 von aussen;12mm Gewindeeingriff im Integralflansch; Alu-Verbindung und CFK-Lip qualifizieren
P14_0157 | +1 Blatt2_F6_ROOT3 | P14_existing | Aluminium7075-T6 | 0.0024663994953384124 | 877.7222403339547 | [-17.42844912048085, 183.56376145534617, 153.16254182574642] | 1 | True | SW5 von aussen;12mm Gewindeeingriff im Integralflansch; Alu-Verbindung und CFK-Lip qualifizieren
P14_0158 | +1 Blatt3_A11 | P14_existing | Aluminium7075-T6 | 0.01734045985669258 | 6170.982155406611 | [-92.99999999999999, -2.431811047469236e-15, 180.0] | 1 | True | Festigkeit, Passungen und Freigabe offen
P14_0159 | +1 Blatt3_A11O | P14_existing | Aluminium7075-T6 | 0.028691565939951476 | 10210.52168681547 | [-151.30934952763144, -4.320101791953053e-15, 180.0] | 1 | True | Offenes Aussenlager-Montagefenster52.1mm; sechs M6/PCD64,14.4mm Eingriff
P14_0160 | +1 Blatt3_B720595 | P14_existing | Wälzlagerstahl | 0.12 | 24469.06093109158 | [-102.5, 9.264469096114715e-15, 180.0] | 1 | True | 25×52×15; Paarabstimmung, Tragzahlen und Massendaten nach Lieferteil
P14_0161 | +1 Blatt3_B7205130 | P14_existing | Wälzlagerstahl | 0.12 | 24469.06093109158 | [-137.5, 1.6232342324136328e-14, 180.0] | 1 | True | 25×52×15; Paarabstimmung, Tragzahlen und Massendaten nach Lieferteil
P14_0162 | +1 Blatt3_A12 | P14_existing | Aluminium7075-T6 | 0.02939638354366796 | 10461.346456821335 | [-119.99999999999997, 1.9206662422295487e-16, 180.0] | 1 | True | Festigkeit, Passungen und Freigabe offen
P14_0163 | +1 Blatt3_A13 | P14_existing | Aluminium7075-T6 | 0.37670176314978054 | 134057.56695721726 | [-170.75999737729737, -0.005229060494247745, 179.97539920455446] | 1 | True | Ein CNC-Teil statt Welle/Innenplatte/Einsatz/Endschraube;12mm Integralflansch,4xM6/PCD64; obere Bohrungen-24Grad indexiert; Ermuedung/Flankenpressung offen
P14_0164 | +1 Blatt3_A13C | P14_existing | Aluminium7075-T6 | 0.00587927670873359 | 2092.2692913642663 | [-147.0, 2.1734647292459454e-16, 180.0] | 1 | True | Separater Ring statt unmontierbarem Integralbund
P14_0165 | +1 Blatt3_A13D | P14_existing | Aluminium7075-T6 | 0.02351710683493436 | 8369.077165457064 | [-157.0, -4.890295640803378e-16, 180.0] | 1 | True | Festigkeit, Passungen und Freigabe offen
P14_0166 | +1 Blatt3_A14 | P14_existing | Aluminium7075-T6 | 0.012438092144294009 | 4426.367311136659 | [-88.49999999999997, 0.19281889498002686, 179.95901507865804] | 1 | True | M25x1.5; Sicherungsblech mit Innennase und Aussentab
P14_0167 | +1 Blatt3_A14W | P14_existing | Aluminium1050 | 0.0017632627869432148 | 653.0602914604498 | [-92.45589993699419, -0.3020003351009362, 180.1063891614515] | 1 | True | Festigkeit, Passungen und Freigabe offen
P14_0168 | +1 Blatt3_A14S | P14_existing | Aluminium7075-T6 | 0.002939638354366795 | 1046.134645682133 | [-94.00000000000001, -1.5757619287033107e-15, 180.0] | 1 | True | Festigkeit, Passungen und Freigabe offen
P14_0169 | +1 Blatt3_A16A | P14_existing | Aluminium7075-T6 | 0.042995284136722885 | 15300.812860043734 | [-186.99999999999994, -3.5813166452688905e-15, 180.0] | 1 | True | Vier M6/PCD64 von aussen in12mm Integralflansch; CFK-Klemmdruck und Ermuedung qualifizieren
P14_0170 | +1 Blatt3_CFK01 | P14_existing | CFK | 0.5931560830883226 | 370722.5519302025 | [-377.6434452650281, -18.999343090261206, 175.96156495874502] | 1 | True | Kontinuierliche Innenanbindung; 1.2mm nominale Vertikalschale; interner geschlossener Kastenspar und Wurzelaufdickung; Laminatnachweis offen
P14_0171 | +1 Blatt3_A18 | P14_existing | Aluminium7075-T6 | 0.030692688917754184 | 10922.665095286186 | [-75.14268082576999, -14.358836759706898, 188.58277082576492] | 1 | True | D-Flach10.5/10.6mm zur Welle; M4×30-Klemmung axial sichern; Füge-/Ermüdungsnachweis offen
P14_0172 | +1 Blatt3_A18B | P14_existing | Aluminium7075-T6 | 0.001066743154935268 | 379.6238985534761 | [-79.00000000000003, 17.761578512244597, 186.60590754466537] | 1 | True | ISO4762-Konturfamilie, keine übertragene Stahl8.8-Festigkeit; Anzug/Alu-Schraube qualifizieren
P14_0173 | +1 Blatt3_A18S | P14_existing | Aluminium7075-T6 | 0.00734909588591699 | 2615.3366142053333 | [-72.5, -7.389780079436213e-16, 180.0] | 1 | True | Festigkeit, Passungen und Freigabe offen
P14_0174 | +1 Blatt3_A18T | P14_existing | Aluminium7075-T6 | 0.002939638354366795 | 1046.134645682133 | [-84.0, -1.793108401627905e-15, 180.0] | 1 | True | Festigkeit, Passungen und Freigabe offen
P14_0175 | +1 Blatt3_A18W | P14_existing | Aluminium7075-T6 | 0.002769834171882837 | 985.7061109903336 | [-69.5, -5.307231875409403e-16, 180.0] | 1 | True | Festigkeit, Passungen und Freigabe offen
P14_0176 | +1 Blatt3_F6_PITCH_END | P14_existing | Aluminium7075-T6 | 0.001883516955231342 | 670.2907313990544 | [-70.08399686305701, 6.977706579990204e-16, 180.0] | 1 | True | Positiver Endanschlag;13mm Gewindeeingriff; Sicherungskleber und Kontrollmarke, Anzug qualifizieren
P14_0177 | +1 Blatt3_Lagerdeckelbolzen0 | P14_existing | Aluminium7075-T6 | 0.00030458947055648583 | 108.39482937953238 | [-92.268972608882, -2.0280770172913555e-15, 209.99999999999997] | 1 | True | Drei M3 auf PCD60;6mm Eingriff
P14_0178 | +1 Blatt3_Lagerdeckelbolzen1 | P14_existing | Aluminium7075-T6 | 0.00030458947055648583 | 108.39482937953238 | [-92.268972608882, 25.980762113533157, 165.0] | 1 | True | Drei M3 auf PCD60;6mm Eingriff
P14_0179 | +1 Blatt3_Lagerdeckelbolzen2 | P14_existing | Aluminium7075-T6 | 0.00030458947055648583 | 108.39482937953237 | [-92.26897260888201, -25.980762113533153, 165.0] | 1 | True | Drei M3 auf PCD60;6mm Eingriff
P14_0180 | +1 Blatt3_F6_ROOT_OUT0 | P14_existing | Aluminium7075-T6 | 0.0022451508692139426 | 798.9860744533601 | [-153.08860250966387, -32.0, 180.0] | 1 | True | M6x20 unter Kopf, von aussen nach innen;14.4mm Gewindeeingriff
P14_0181 | +1 Blatt3_W6_ROOT_OUT0 | P14_existing | Aluminium7075-T6 | 0.00036384971069710286 | 129.48388281035687 | [-155.79999999999998, -32.0, 180.0] | 1 | True | Festigkeit, Passungen und Freigabe offen
P14_0182 | +1 Blatt3_F6_ROOT_OUT1 | P14_existing | Aluminium7075-T6 | 0.0022451508692139426 | 798.9860744533604 | [-153.0886025096638, -16.000000000000004, 207.71281292110203] | 1 | True | M6x20 unter Kopf, von aussen nach innen;14.4mm Gewindeeingriff
P14_0183 | +1 Blatt3_W6_ROOT_OUT1 | P14_existing | Aluminium7075-T6 | 0.00036384971069710286 | 129.4838828103569 | [-155.79999999999998, -16.000000000000004, 207.71281292110203] | 1 | True | Festigkeit, Passungen und Freigabe offen
P14_0184 | +1 Blatt3_F6_ROOT_OUT2 | P14_existing | Aluminium7075-T6 | 0.0022451508692139426 | 798.9860744533602 | [-153.0886025096639, 15.999999999999993, 207.71281292110206] | 1 | True | M6x20 unter Kopf, von aussen nach innen;14.4mm Gewindeeingriff
P14_0185 | +1 Blatt3_W6_ROOT_OUT2 | P14_existing | Aluminium7075-T6 | 0.00036384971069710286 | 129.4838828103569 | [-155.79999999999998, 15.999999999999993, 207.71281292110203] | 1 | True | Festigkeit, Passungen und Freigabe offen
P14_0186 | +1 Blatt3_F6_ROOT_OUT3 | P14_existing | Aluminium7075-T6 | 0.0022451508692139426 | 798.9860744533601 | [-153.08860250966381, 32.0, 180.0] | 1 | True | M6x20 unter Kopf, von aussen nach innen;14.4mm Gewindeeingriff
P14_0187 | +1 Blatt3_W6_ROOT_OUT3 | P14_existing | Aluminium7075-T6 | 0.00036384971069710286 | 129.48388281035685 | [-155.79999999999998, 32.0, 180.0] | 1 | True | Festigkeit, Passungen und Freigabe offen
P14_0188 | +1 Blatt3_F6_ROOT_OUT4 | P14_existing | Aluminium7075-T6 | 0.0022451508692139426 | 798.9860744533604 | [-153.0886025096638, 16.000000000000014, 152.28718707889797] | 1 | True | M6x20 unter Kopf, von aussen nach innen;14.4mm Gewindeeingriff
P14_0189 | +1 Blatt3_W6_ROOT_OUT4 | P14_existing | Aluminium7075-T6 | 0.00036384971069710286 | 129.48388281035687 | [-155.8, 16.000000000000014, 152.28718707889797] | 1 | True | Festigkeit, Passungen und Freigabe offen
P14_0190 | +1 Blatt3_F6_ROOT_OUT5 | P14_existing | Aluminium7075-T6 | 0.0022451508692139426 | 798.9860744533604 | [-153.0886025096638, -16.000000000000004, 152.28718707889797] | 1 | True | M6x20 unter Kopf, von aussen nach innen;14.4mm Gewindeeingriff
P14_0191 | +1 Blatt3_W6_ROOT_OUT5 | P14_existing | Aluminium7075-T6 | 0.00036384971069710286 | 129.48388281035687 | [-155.8, -16.000000000000004, 152.28718707889797] | 1 | True | Festigkeit, Passungen und Freigabe offen
P14_0192 | +1 Blatt3_F6_ROOT0 | P14_existing | Aluminium7075-T6 | 0.0024663994953384124 | 877.7222403339546 | [-183.56376145534622, -26.83745817425357, 197.42844912048082] | 1 | True | SW5 von aussen;12mm Gewindeeingriff im Integralflansch; Alu-Verbindung und CFK-Lip qualifizieren
P14_0193 | +1 Blatt3_F6_ROOT1 | P14_existing | Aluminium7075-T6 | 0.0024663994953384124 | 877.7222403339547 | [-183.56376145534617, 17.428449120480863, 206.83745817425358] | 1 | True | SW5 von aussen;12mm Gewindeeingriff im Integralflansch; Alu-Verbindung und CFK-Lip qualifizieren
P14_0194 | +1 Blatt3_F6_ROOT2 | P14_existing | Aluminium7075-T6 | 0.0024663994953384124 | 877.7222403339547 | [-183.56376145534622, 26.837458174253577, 162.57155087951912] | 1 | True | SW5 von aussen;12mm Gewindeeingriff im Integralflansch; Alu-Verbindung und CFK-Lip qualifizieren
P14_0195 | +1 Blatt3_F6_ROOT3 | P14_existing | Aluminium7075-T6 | 0.0024663994953384124 | 877.7222403339547 | [-183.56376145534617, -17.42844912048085, 153.16254182574642] | 1 | True | SW5 von aussen;12mm Gewindeeingriff im Integralflansch; Alu-Verbindung und CFK-Lip qualifizieren
P14_0196 | +1 Blatt4_A11 | P14_existing | Aluminium7075-T6 | 0.01734045985669258 | 6170.982155406611 | [4.68860539076455e-15, -92.99999999999994, 180.0] | 1 | True | Festigkeit, Passungen und Freigabe offen
P14_0197 | +1 Blatt4_A11O | P14_existing | Aluminium7075-T6 | 0.028691565939951476 | 10210.52168681547 | [1.2804425414293843e-15, -151.30934952763144, 180.0] | 1 | True | Offenes Aussenlager-Montagefenster52.1mm; sechs M6/PCD64,14.4mm Eingriff
P14_0198 | +1 Blatt4_B720595 | P14_existing | Wälzlagerstahl | 0.12 | 24469.060931091586 | [-1.9661414521124322e-14, -102.5, 180.0] | 1 | True | 25×52×15; Paarabstimmung, Tragzahlen und Massendaten nach Lieferteil
P14_0199 | +1 Blatt4_B7205130 | P14_existing | Wälzlagerstahl | 0.12 | 24469.06093109158 | [-2.8776541288338344e-14, -137.5, 180.0] | 1 | True | 25×52×15; Paarabstimmung, Tragzahlen und Massendaten nach Lieferteil
P14_0200 | +1 Blatt4_A12 | P14_existing | Aluminium7075-T6 | 0.02939638354366796 | 10461.346456821337 | [-6.865699552262576e-16, -119.99999999999997, 180.0] | 1 | True | Festigkeit, Passungen und Freigabe offen
P14_0201 | +1 Blatt4_A13 | P14_existing | Aluminium7075-T6 | 0.37670176314978054 | 134057.56695721726 | [0.005229060494247745, -170.75999737729737, 179.97539920455446] | 1 | True | Ein CNC-Teil statt Welle/Innenplatte/Einsatz/Endschraube;12mm Integralflansch,4xM6/PCD64; obere Bohrungen-24Grad indexiert; Ermuedung/Flankenpressung offen
P14_0202 | +1 Blatt4_A13C | P14_existing | Aluminium7075-T6 | 0.00587927670873359 | 2092.269291364266 | [3.260197093868919e-16, -147.00000000000003, 180.0] | 1 | True | Separater Ring statt unmontierbarem Integralbund
P14_0203 | +1 Blatt4_A13D | P14_existing | Aluminium7075-T6 | 0.02351710683493436 | 8369.077165457064 | [3.260197093868919e-16, -157.0, 180.0] | 1 | True | Festigkeit, Passungen und Freigabe offen
P14_0204 | +1 Blatt4_A14 | P14_existing | Aluminium7075-T6 | 0.012438092144294009 | 4426.367311136659 | [-0.19281889498002983, -88.49999999999997, 179.95901507865804] | 1 | True | M25x1.5; Sicherungsblech mit Innennase und Aussentab
P14_0205 | +1 Blatt4_A14W | P14_existing | Aluminium1050 | 0.0017632627869432148 | 653.0602914604499 | [0.30200033510093527, -92.45589993699417, 180.1063891614515] | 1 | True | Festigkeit, Passungen und Freigabe offen
P14_0206 | +1 Blatt4_A14S | P14_existing | Aluminium7075-T6 | 0.002939638354366795 | 1046.134645682133 | [1.4670886922410134e-15, -94.00000000000001, 180.0] | 1 | True | Festigkeit, Passungen und Freigabe offen
P14_0207 | +1 Blatt4_A16A | P14_existing | Aluminium7075-T6 | 0.042995284136722885 | 15300.812860043734 | [-1.3374211538348554e-16, -186.99999999999994, 180.0] | 1 | True | Vier M6/PCD64 von aussen in12mm Integralflansch; CFK-Klemmdruck und Ermuedung qualifizieren
P14_0208 | +1 Blatt4_CFK01 | P14_existing | CFK | 0.5931560830883226 | 370722.55193020235 | [18.999343090261195, -377.64344526502856, 175.96156495874502] | 1 | True | Kontinuierliche Innenanbindung; 1.2mm nominale Vertikalschale; interner geschlossener Kastenspar und Wurzelaufdickung; Laminatnachweis offen
P14_0209 | +1 Blatt4_A18 | P14_existing | Aluminium7075-T6 | 0.030692688917754184 | 10922.665095286186 | [14.358836759706893, -75.14268082576999, 188.58277082576492] | 1 | True | D-Flach10.5/10.6mm zur Welle; M4×30-Klemmung axial sichern; Füge-/Ermüdungsnachweis offen
P14_0210 | +1 Blatt4_A18B | P14_existing | Aluminium7075-T6 | 0.001066743154935268 | 379.6238985534761 | [-17.76157851224459, -79.0, 186.60590754466537] | 1 | True | ISO4762-Konturfamilie, keine übertragene Stahl8.8-Festigkeit; Anzug/Alu-Schraube qualifizieren
P14_0211 | +1 Blatt4_A18S | P14_existing | Aluminium7075-T6 | 0.00734909588591699 | 2615.3366142053333 | [1.869179667151513e-15, -72.5, 180.0] | 1 | True | Festigkeit, Passungen und Freigabe offen
P14_0212 | +1 Blatt4_A18T | P14_existing | Aluminium7075-T6 | 0.002939638354366795 | 1046.1346456821332 | [-2.1734647292459454e-16, -84.0, 180.0] | 1 | True | Festigkeit, Passungen und Freigabe offen
P14_0213 | +1 Blatt4_A18W | P14_existing | Aluminium7075-T6 | 0.002769834171882837 | 985.7061109903336 | [3.5321475299838473e-16, -69.5, 180.0] | 1 | True | Festigkeit, Passungen und Freigabe offen
P14_0214 | +1 Blatt4_F6_PITCH_END | P14_existing | Aluminium7075-T6 | 0.001883516955231342 | 670.2907313990546 | [-7.602246722965113e-16, -70.083996863057, 180.0] | 1 | True | Positiver Endanschlag;13mm Gewindeeingriff; Sicherungskleber und Kontrollmarke, Anzug qualifizieren
P14_0215 | +1 Blatt4_Lagerdeckelbolzen0 | P14_existing | Aluminium7075-T6 | 0.00030458947055648583 | 108.39482937953235 | [2.0056887477840076e-15, -92.26897260888204, 210.0] | 1 | True | Drei M3 auf PCD60;6mm Eingriff
P14_0216 | +1 Blatt4_Lagerdeckelbolzen1 | P14_existing | Aluminium7075-T6 | 0.00030458947055648583 | 108.39482937953238 | [-25.980762113533157, -92.268972608882, 165.0] | 1 | True | Drei M3 auf PCD60;6mm Eingriff
P14_0217 | +1 Blatt4_Lagerdeckelbolzen2 | P14_existing | Aluminium7075-T6 | 0.00030458947055648583 | 108.39482937953237 | [25.980762113533153, -92.26897260888201, 165.0] | 1 | True | Drei M3 auf PCD60;6mm Eingriff
P14_0218 | +1 Blatt4_F6_ROOT_OUT0 | P14_existing | Aluminium7075-T6 | 0.0022451508692139426 | 798.9860744533601 | [32.0, -153.08860250966387, 180.0] | 1 | True | M6x20 unter Kopf, von aussen nach innen;14.4mm Gewindeeingriff
P14_0219 | +1 Blatt4_W6_ROOT_OUT0 | P14_existing | Aluminium7075-T6 | 0.00036384971069710286 | 129.48388281035687 | [32.0, -155.8, 180.0] | 1 | True | Festigkeit, Passungen und Freigabe offen
P14_0220 | +1 Blatt4_F6_ROOT_OUT1 | P14_existing | Aluminium7075-T6 | 0.0022451508692139426 | 798.9860744533604 | [16.000000000000004, -153.0886025096638, 207.71281292110203] | 1 | True | M6x20 unter Kopf, von aussen nach innen;14.4mm Gewindeeingriff
P14_0221 | +1 Blatt4_W6_ROOT_OUT1 | P14_existing | Aluminium7075-T6 | 0.00036384971069710286 | 129.48388281035687 | [16.000000000000004, -155.8, 207.71281292110203] | 1 | True | Festigkeit, Passungen und Freigabe offen
P14_0222 | +1 Blatt4_F6_ROOT_OUT2 | P14_existing | Aluminium7075-T6 | 0.0022451508692139426 | 798.9860744533602 | [-15.999999999999993, -153.0886025096639, 207.71281292110206] | 1 | True | M6x20 unter Kopf, von aussen nach innen;14.4mm Gewindeeingriff
P14_0223 | +1 Blatt4_W6_ROOT_OUT2 | P14_existing | Aluminium7075-T6 | 0.00036384971069710286 | 129.4838828103569 | [-15.999999999999993, -155.79999999999998, 207.71281292110203] | 1 | True | Festigkeit, Passungen und Freigabe offen
P14_0224 | +1 Blatt4_F6_ROOT_OUT3 | P14_existing | Aluminium7075-T6 | 0.0022451508692139426 | 798.9860744533601 | [-32.0, -153.08860250966381, 180.0] | 1 | True | M6x20 unter Kopf, von aussen nach innen;14.4mm Gewindeeingriff
P14_0225 | +1 Blatt4_W6_ROOT_OUT3 | P14_existing | Aluminium7075-T6 | 0.00036384971069710286 | 129.48388281035687 | [-32.0, -155.8, 180.0] | 1 | True | Festigkeit, Passungen und Freigabe offen
P14_0226 | +1 Blatt4_F6_ROOT_OUT4 | P14_existing | Aluminium7075-T6 | 0.0022451508692139426 | 798.9860744533604 | [-16.000000000000014, -153.0886025096638, 152.28718707889797] | 1 | True | M6x20 unter Kopf, von aussen nach innen;14.4mm Gewindeeingriff
P14_0227 | +1 Blatt4_W6_ROOT_OUT4 | P14_existing | Aluminium7075-T6 | 0.00036384971069710286 | 129.4838828103569 | [-16.000000000000014, -155.79999999999998, 152.28718707889797] | 1 | True | Festigkeit, Passungen und Freigabe offen
P14_0228 | +1 Blatt4_F6_ROOT_OUT5 | P14_existing | Aluminium7075-T6 | 0.0022451508692139426 | 798.9860744533602 | [16.000000000000004, -153.08860250966381, 152.28718707889797] | 1 | True | M6x20 unter Kopf, von aussen nach innen;14.4mm Gewindeeingriff
P14_0229 | +1 Blatt4_W6_ROOT_OUT5 | P14_existing | Aluminium7075-T6 | 0.00036384971069710286 | 129.4838828103569 | [16.000000000000004, -155.79999999999998, 152.28718707889797] | 1 | True | Festigkeit, Passungen und Freigabe offen
P14_0230 | +1 Blatt4_F6_ROOT0 | P14_existing | Aluminium7075-T6 | 0.0024663994953384124 | 877.7222403339548 | [26.83745817425357, -183.5637614553462, 197.42844912048085] | 1 | True | SW5 von aussen;12mm Gewindeeingriff im Integralflansch; Alu-Verbindung und CFK-Lip qualifizieren
P14_0231 | +1 Blatt4_F6_ROOT1 | P14_existing | Aluminium7075-T6 | 0.0024663994953384124 | 877.7222403339546 | [-17.428449120480863, -183.5637614553462, 206.83745817425358] | 1 | True | SW5 von aussen;12mm Gewindeeingriff im Integralflansch; Alu-Verbindung und CFK-Lip qualifizieren
P14_0232 | +1 Blatt4_F6_ROOT2 | P14_existing | Aluminium7075-T6 | 0.0024663994953384124 | 877.7222403339545 | [-26.837458174253577, -183.56376145534622, 162.57155087951912] | 1 | True | SW5 von aussen;12mm Gewindeeingriff im Integralflansch; Alu-Verbindung und CFK-Lip qualifizieren
P14_0233 | +1 Blatt4_F6_ROOT3 | P14_existing | Aluminium7075-T6 | 0.0024663994953384124 | 877.7222403339546 | [17.42844912048085, -183.56376145534617, 153.16254182574644] | 1 | True | SW5 von aussen;12mm Gewindeeingriff im Integralflansch; Alu-Verbindung und CFK-Lip qualifizieren
P14_0234 | +1 Servo1_SERVO | P14_existing | Kaufteil | 0.855 | 364912.8841778678 | [245.0, 63.41842881347987, 80.00000000000001] | 1 | True | Herstellernennmaße54×126×54;0.855kg;44.7Nm continuous@24V; OEM-STEP/Horn-/Montagebezug offen
P14_0235 | +1 Servo1_A25 | P14_existing | Aluminium7075-T6 | 0.30582581103903983 | 108834.80819894657 | [245.3861172288632, 41.423079732367796, 79.96728310600992] | 1 | True | Klemmhalter ist Vorentwurf; OEM-Montage-/Kühlfreigaben fehlen
P14_0236 | +1 Servo1_A28 | P14_existing | Aluminium7075-T6 | 0.2020111179588829 | 71890.07756543875 | [132.61912418252024, 0.022842836835022248, 33.9298965014501] | 1 | True | Vier M6 direkt auf Zentralblock; Fussausnehmungen mit0.3mm Abstand zu diagonalen Statorarmen
P14_0237 | +1 Servo1_Lager-66 | P14_existing | Wälzlagerstahl | 0.03 | 5639.304583092806 | [245.0, -61.5, 80.0] | 1 | True | 15×32×9; externe Lager tragen Gestängelast; Liefermasse angenommen
P14_0238 | +1 Servo1_Lager-24 | P14_existing | Wälzlagerstahl | 0.03 | 5639.304583092806 | [245.0, -19.5, 80.0] | 1 | True | 15×32×9; externe Lager tragen Gestängelast; Liefermasse angenommen
P14_0239 | +1 Servo1_A26 | P14_existing | Aluminium7075-T6 | 0.03848035355310493 | 13694.075997546246 | [245.0261968676399, -37.949334995419186, 79.95462569424845] | 1 | True | Runde Lagerzapfen; DIN6885-Familie5x5x8 am Hebel, D-Flach an OEM-Kupplungsreserve; zwei M15x1-Sondermuttern; Kerbfestigkeit/Preload offen
P14_0240 | +1 Servo1_A26K | P14_existing | Aluminium7075-T6 | 0.0005575129919999993 | 198.40319999999963 | [241.00000000000003, -40.00000000000001, 86.92820323027553] | 1 | True | DIN6885-Konturfamilie, Alu-Sonderteil; Flankenpressung und Lastwechsel qualifizieren
P14_0241 | +1 Servo1_A26S | P14_existing | Aluminium7075-T6 | 0.0045549188477383585 | 1620.967561472727 | [245.00000000000006, -30.000000000000004, 80.00000000000006] | 1 | True | Festigkeit, Passungen und Freigabe offen
P14_0242 | +1 Servo1_KUPP | P14_existing | Kaufteil | 0.03 | 2214.3698412171334 | [244.92644092301754, -4.0, 80.12740805869143] | 1 | True | D-Flach6.5 zur eigenen Welle; OEM-Horn/Flanschanschluss noch offen; keine erfundene Verzahnung
P14_0243 | +1 Servo1_Mutter0 | P14_existing | Aluminium7075-T6 | 0.0015011754593564164 | 534.226142119721 | [245.0, -68.0, 80.0] | 1 | True | Sondermutter mit19mm SW; Gewinde und Verliersicherung nominal/offen
P14_0244 | +1 Servo1_Mutter55 | P14_existing | Aluminium7075-T6 | 0.0015011754593564164 | 534.226142119721 | [245.0, -13.0, 80.0] | 1 | True | Sondermutter mit19mm SW; Gewinde und Verliersicherung nominal/offen
P14_0245 | +1 Servo1_Hebel | P14_existing | Aluminium7075-T6 | 0.01834268627475905 | 6527.6463611242125 | [239.1652409064795, -40.00000000000002, 73.11510166579808] | 1 | True | Festigkeit, Passungen und Freigabe offen
P14_0246 | +1 Servo1_Sattelbolzen178 | P14_existing | Aluminium7075-T6 | 0.0007503521021551783 | 267.02921784881806 | [223.0, -6.0, 50.922688001446105] | 1 | True | Vier M4 von oben, vor Montage der Umlenkwelle;8mm Gewinde im Ausleger
P14_0247 | +1 Servo1_Sattelscheibe178 | P14_existing | Aluminium7075-T6 | 0.0001103660977080547 | 39.276191355179506 | [223.0, -6.0, 53.4] | 1 | True | Festigkeit, Passungen und Freigabe offen
P14_0248 | +1 Servo1_Sattelbolzen188 | P14_existing | Aluminium7075-T6 | 0.0007503521021551783 | 267.02921784881806 | [233.0, -6.0, 50.92268800144608] | 1 | True | Vier M4 von oben, vor Montage der Umlenkwelle;8mm Gewinde im Ausleger
P14_0249 | +1 Servo1_Sattelscheibe188 | P14_existing | Aluminium7075-T6 | 0.0001103660977080547 | 39.276191355179506 | [233.00000000000003, -6.0, 53.4] | 1 | True | Festigkeit, Passungen und Freigabe offen
P14_0250 | +1 Servo1_Sattelbolzen198 | P14_existing | Aluminium7075-T6 | 0.0007503521021551783 | 267.02921784881795 | [243.0, -6.0, 50.92268800144612] | 1 | True | Vier M4 von oben, vor Montage der Umlenkwelle;8mm Gewinde im Ausleger
P14_0251 | +1 Servo1_Sattelscheibe198 | P14_existing | Aluminium7075-T6 | 0.0001103660977080547 | 39.276191355179506 | [243.0, -6.0, 53.4] | 1 | True | Festigkeit, Passungen und Freigabe offen
P14_0252 | +1 Servo1_Sattelbolzen208 | P14_existing | Aluminium7075-T6 | 0.0007503521021551783 | 267.029217848818 | [253.00000000000003, -6.0, 50.922688001446126] | 1 | True | Vier M4 von oben, vor Montage der Umlenkwelle;8mm Gewinde im Ausleger
P14_0253 | +1 Servo1_Sattelscheibe208 | P14_existing | Aluminium7075-T6 | 0.0001103660977080547 | 39.276191355179556 | [253.0, -6.0, 53.4] | 1 | True | Festigkeit, Passungen und Freigabe offen
P14_0254 | +1 Servo1_Traegerbolzen87_-6.5 | P14_existing | Aluminium7075-T6 | 0.004452119708360772 | 1584.384237850808 | [86.99999999999999, -6.5, 29.000767051957094] | 1 | True | Vier M6 je Servotraeger,12mm Eingriff im Zentralblock, Scheibe1.6mm
P14_0255 | +1 Servo1_Traegerscheibe87_-6.5 | P14_existing | Aluminium7075-T6 | 0.0003638497106971029 | 129.48388281035693 | [87.0, -6.5, 49.8] | 1 | True | Festigkeit, Passungen und Freigabe offen
P14_0256 | +1 Servo1_Traegerbolzen87_6.5 | P14_existing | Aluminium7075-T6 | 0.004452119708360772 | 1584.384237850808 | [86.99999999999999, 6.5, 29.0007670519571] | 1 | True | Vier M6 je Servotraeger,12mm Eingriff im Zentralblock, Scheibe1.6mm
P14_0257 | +1 Servo1_Traegerscheibe87_6.5 | P14_existing | Aluminium7075-T6 | 0.0003638497106971029 | 129.48388281035693 | [87.0, 6.5, 49.8] | 1 | True | Festigkeit, Passungen und Freigabe offen
P14_0258 | +1 Servo1_Traegerbolzen111_-6.5 | P14_existing | Aluminium7075-T6 | 0.004452119708360772 | 1584.384237850808 | [111.0, -6.5, 29.000767051957094] | 1 | True | Vier M6 je Servotraeger,12mm Eingriff im Zentralblock, Scheibe1.6mm
P14_0259 | +1 Servo1_Traegerscheibe111_-6.5 | P14_existing | Aluminium7075-T6 | 0.0003638497106971029 | 129.48388281035693 | [111.0, -6.5, 49.8] | 1 | True | Festigkeit, Passungen und Freigabe offen
P14_0260 | +1 Servo1_Traegerbolzen111_6.5 | P14_existing | Aluminium7075-T6 | 0.004452119708360772 | 1584.384237850808 | [111.0, 6.5, 29.0007670519571] | 1 | True | Vier M6 je Servotraeger,12mm Eingriff im Zentralblock, Scheibe1.6mm
P14_0261 | +1 Servo1_Traegerscheibe111_6.5 | P14_existing | Aluminium7075-T6 | 0.0003638497106971029 | 129.48388281035693 | [111.0, 6.5, 49.8] | 1 | True | Festigkeit, Passungen und Freigabe offen
P14_0262 | +1 Servo2_SERVO | P14_existing | Kaufteil | 0.855 | 364912.88417786796 | [-177.42197042056856, 180.46700952044762, 80.0] | 1 | True | Herstellernennmaße54×126×54;0.855kg;44.7Nm continuous@24V; OEM-STEP/Horn-/Montagebezug offen
P14_0263 | +1 Servo2_A25 | P14_existing | Aluminium7075-T6 | 0.30582581103903983 | 108834.80819894657 | [-158.56649796565068, 191.79907139003814, 79.96728310600993] | 1 | True | Klemmhalter ist Vorentwurf; OEM-Montage-/Kühlfreigaben fehlen
P14_0264 | +1 Servo2_A28 | P14_existing | Aluminium7075-T6 | 0.2020111179588829 | 71890.07756543875 | [-66.3293445682537, 114.8401091512882, 33.92989650145011] | 1 | True | Vier M6 direkt auf Zentralblock; Fussausnehmungen mit0.3mm Abstand zu diagonalen Statorarmen
P14_0265 | +1 Servo2_Lager-66 | P14_existing | Wälzlagerstahl | 0.03 | 5639.304583092806 | [-69.23943766725696, 242.9262239271875, 80.0] | 1 | True | 15×32×9; externe Lager tragen Gestängelast; Liefermasse angenommen
P14_0266 | +1 Servo2_Lager-24 | P14_existing | Wälzlagerstahl | 0.03 | 5639.304583092807 | [-105.61250462620339, 221.9262239271875, 80.0] | 1 | True | 15×32×9; externe Lager tragen Gestängelast; Liefermasse angenommen
P14_0267 | +1 Servo2_A26 | P14_existing | Aluminium7075-T6 | 0.03848035355310493 | 13694.07599754624 | [-89.64801027106105, 231.1735785777728, 79.95462569424848] | 1 | True | Runde Lagerzapfen; DIN6885-Familie5x5x8 am Hebel, D-Flach an OEM-Kupplungsreserve; zwei M15x1-Sondermuttern; Kerbfestigkeit/Preload offen
P14_0268 | +1 Servo2_A26K | P14_existing | Aluminium7075-T6 | 0.0005575129919999993 | 198.40319999999946 | [-85.85898384862234, 228.71212231204964, 86.92820323027553] | 1 | True | DIN6885-Konturfamilie, Alu-Sonderteil; Flankenpressung und Lastwechsel qualifizieren
P14_0269 | +1 Servo2_A26S | P14_existing | Aluminium7075-T6 | 0.0045549188477383585 | 1620.967561472727 | [-96.51923788646677, 227.1762239271875, 80.00000000000009] | 1 | True | Festigkeit, Passungen und Freigabe offen
P14_0270 | +1 Servo2_KUPP | P14_existing | Kaufteil | 0.03 | 2214.3698412171348 | [-118.99911884637092, 214.11251989784176, 80.12740805869146] | 1 | True | D-Flach6.5 zur eigenen Welle; OEM-Horn/Flanschanschluss noch offen; keine erfundene Verzahnung
P14_0271 | +1 Servo2_Mutter0 | P14_existing | Aluminium7075-T6 | 0.0015011754593564164 | 534.2261421197214 | [-63.61027254265811, 246.1762239271875, 80.0] | 1 | True | Sondermutter mit19mm SW; Gewinde und Verliersicherung nominal/offen
P14_0272 | +1 Servo2_Mutter55 | P14_existing | Aluminium7075-T6 | 0.0015011754593564164 | 534.2261421197211 | [-111.24166975080225, 218.6762239271875, 80.0] | 1 | True | Sondermutter mit19mm SW; Gewinde und Verliersicherung nominal/offen
P14_0273 | +1 Servo2_Hebel | P14_existing | Aluminium7075-T6 | 0.01834268627475905 | 6527.646361124218 | [-84.9416043018621, 227.12317432723637, 73.11510166579802] | 1 | True | Festigkeit, Passungen und Freigabe offen
P14_0274 | +1 Servo2_Sattelbolzen178 | P14_existing | Aluminium7075-T6 | 0.0007503521021551783 | 267.029217848818 | [-106.30384757729333, 196.12366504392983, 50.92268800144611] | 1 | True | Vier M4 von oben, vor Montage der Umlenkwelle;8mm Gewinde im Ausleger
P14_0275 | +1 Servo2_Sattelscheibe178 | P14_existing | Aluminium7075-T6 | 0.0001103660977080547 | 39.27619135517956 | [-106.30384757729333, 196.12366504392983, 53.4] | 1 | True | Festigkeit, Passungen und Freigabe offen
P14_0276 | +1 Servo2_Sattelbolzen188 | P14_existing | Aluminium7075-T6 | 0.0007503521021551783 | 267.02921784881795 | [-111.30384757729331, 204.78391908177423, 50.92268800144613] | 1 | True | Vier M4 von oben, vor Montage der Umlenkwelle;8mm Gewinde im Ausleger
P14_0277 | +1 Servo2_Sattelscheibe188 | P14_existing | Aluminium7075-T6 | 0.0001103660977080547 | 39.27619135517957 | [-111.30384757729331, 204.78391908177423, 53.4] | 1 | True | Festigkeit, Passungen und Freigabe offen
P14_0278 | +1 Servo2_Sattelbolzen198 | P14_existing | Aluminium7075-T6 | 0.0007503521021551783 | 267.02921784881806 | [-116.30384757729331, 213.4441731196186, 50.92268800144611] | 1 | True | Vier M4 von oben, vor Montage der Umlenkwelle;8mm Gewinde im Ausleger
P14_0279 | +1 Servo2_Sattelscheibe198 | P14_existing | Aluminium7075-T6 | 0.0001103660977080547 | 39.27619135517956 | [-116.30384757729331, 213.4441731196186, 53.4] | 1 | True | Festigkeit, Passungen und Freigabe offen
P14_0280 | +1 Servo2_Sattelbolzen208 | P14_existing | Aluminium7075-T6 | 0.0007503521021551783 | 267.029217848818 | [-121.30384757729331, 222.104427157463, 50.922688001446126] | 1 | True | Vier M4 von oben, vor Montage der Umlenkwelle;8mm Gewinde im Ausleger
P14_0281 | +1 Servo2_Sattelscheibe208 | P14_existing | Aluminium7075-T6 | 0.0001103660977080547 | 39.27619135517956 | [-121.3038475772933, 222.104427157463, 53.4] | 1 | True | Festigkeit, Passungen und Freigabe offen
P14_0282 | +1 Servo2_Traegerbolzen87_-6.5 | P14_existing | Aluminium7075-T6 | 0.004452119708360772 | 1584.3842378508089 | [-37.87083487540113, 78.59421012924616, 29.000767051957105] | 1 | True | Vier M6 je Servotraeger,12mm Eingriff im Zentralblock, Scheibe1.6mm
P14_0283 | +1 Servo2_Traegerscheibe87_-6.5 | P14_existing | Aluminium7075-T6 | 0.0003638497106971029 | 129.483882810357 | [-37.87083487540113, 78.59421012924616, 49.8] | 1 | True | Festigkeit, Passungen und Freigabe offen
P14_0284 | +1 Servo2_Traegerbolzen87_6.5 | P14_existing | Aluminium7075-T6 | 0.004452119708360772 | 1584.3842378508086 | [-49.12916512459882, 72.09421012924616, 29.0007670519571] | 1 | True | Vier M6 je Servotraeger,12mm Eingriff im Zentralblock, Scheibe1.6mm
P14_0285 | +1 Servo2_Traegerscheibe87_6.5 | P14_existing | Aluminium7075-T6 | 0.0003638497106971029 | 129.483882810357 | [-49.12916512459883, 72.09421012924616, 49.8] | 1 | True | Festigkeit, Passungen und Freigabe offen
P14_0286 | +1 Servo2_Traegerbolzen111_-6.5 | P14_existing | Aluminium7075-T6 | 0.004452119708360772 | 1584.3842378508086 | [-49.87083487540114, 99.3788198200727, 29.00076705195711] | 1 | True | Vier M6 je Servotraeger,12mm Eingriff im Zentralblock, Scheibe1.6mm
P14_0287 | +1 Servo2_Traegerscheibe111_-6.5 | P14_existing | Aluminium7075-T6 | 0.0003638497106971029 | 129.483882810357 | [-49.87083487540113, 99.37881982007269, 49.8] | 1 | True | Festigkeit, Passungen und Freigabe offen
P14_0288 | +1 Servo2_Traegerbolzen111_6.5 | P14_existing | Aluminium7075-T6 | 0.004452119708360772 | 1584.3842378508086 | [-61.12916512459883, 92.87881982007269, 29.00076705195711] | 1 | True | Vier M6 je Servotraeger,12mm Eingriff im Zentralblock, Scheibe1.6mm
P14_0289 | +1 Servo2_Traegerscheibe111_6.5 | P14_existing | Aluminium7075-T6 | 0.0003638497106971029 | 129.483882810357 | [-61.12916512459883, 92.87881982007269, 49.8] | 1 | True | Festigkeit, Passungen und Freigabe offen
P14_0290 | +1 Servo3_SERVO | P14_existing | Kaufteil | 0.855 | 364912.88417786785 | [-67.57802957943169, -243.8854383339274, 79.99999999999999] | 1 | True | Herstellernennmaße54×126×54;0.855kg;44.7Nm continuous@24V; OEM-STEP/Horn-/Montagebezug offen
P14_0291 | +1 Servo3_A25 | P14_existing | Aluminium7075-T6 | 0.30582581103903983 | 108834.80819894647 | [-86.81961926321311, -233.22215112240593, 79.96728310600996] | 1 | True | Klemmhalter ist Vorentwurf; OEM-Montage-/Kühlfreigaben fehlen
P14_0292 | +1 Servo3_A28 | P14_existing | Aluminium7075-T6 | 0.2020111179588829 | 71890.07756543874 | [-66.28977961426658, -114.8629519881231, 33.929896501450095] | 1 | True | Vier M6 direkt auf Zentralblock; Fussausnehmungen mit0.3mm Abstand zu diagonalen Statorarmen
P14_0293 | +1 Servo3_Lager-66 | P14_existing | Wälzlagerstahl | 0.03 | 5639.304583092804 | [-175.76056233274306, -181.42622392718738, 80.0] | 1 | True | 15×32×9; externe Lager tragen Gestängelast; Liefermasse angenommen
P14_0294 | +1 Servo3_Lager-24 | P14_existing | Wälzlagerstahl | 0.03 | 5639.304583092806 | [-139.38749537379667, -202.4262239271874, 80.0] | 1 | True | 15×32×9; externe Lager tragen Gestängelast; Liefermasse angenommen
P14_0295 | +1 Servo3_A26 | P14_existing | Aluminium7075-T6 | 0.03848035355310493 | 13694.075997546242 | [-155.3781865965789, -193.22424358235355, 79.95462569424842] | 1 | True | Runde Lagerzapfen; DIN6885-Familie5x5x8 am Hebel, D-Flach an OEM-Kupplungsreserve; zwei M15x1-Sondermuttern; Kerbfestigkeit/Preload offen
P14_0296 | +1 Servo3_A26K | P14_existing | Aluminium7075-T6 | 0.0005575129919999993 | 198.40320000000006 | [-155.14101615137764, -188.71212231204962, 86.92820323027553] | 1 | True | DIN6885-Konturfamilie, Alu-Sonderteil; Flankenpressung und Lastwechsel qualifizieren
P14_0297 | +1 Servo3_A26S | P14_existing | Aluminium7075-T6 | 0.0045549188477383585 | 1620.9675614727257 | [-148.48076211353327, -197.17622392718738, 80.0] | 1 | True | Festigkeit, Passungen und Freigabe offen
P14_0298 | +1 Servo3_KUPP | P14_existing | Kaufteil | 0.03 | 2214.3698412171343 | [-125.92732207664667, -210.1125198978417, 80.12740805869149] | 1 | True | D-Flach6.5 zur eigenen Welle; OEM-Horn/Flanschanschluss noch offen; keine erfundene Verzahnung
P14_0299 | +1 Servo3_Mutter0 | P14_existing | Aluminium7075-T6 | 0.0015011754593564164 | 534.2261421197217 | [-181.38972745734193, -178.17622392718738, 80.0] | 1 | True | Sondermutter mit19mm SW; Gewinde und Verliersicherung nominal/offen
P14_0300 | +1 Servo3_Mutter55 | P14_existing | Aluminium7075-T6 | 0.0015011754593564164 | 534.2261421197215 | [-133.75833024919783, -205.6762239271874, 80.0] | 1 | True | Sondermutter mit19mm SW; Gewinde und Verliersicherung nominal/offen
P14_0301 | +1 Servo3_Hebel | P14_existing | Aluminium7075-T6 | 0.01834268627475905 | 6527.646361124214 | [-154.22363660461738, -187.12317432723637, 73.11510166579814] | 1 | True | Festigkeit, Passungen und Freigabe offen
P14_0302 | +1 Servo3_Sattelbolzen178 | P14_existing | Aluminium7075-T6 | 0.0007503521021551783 | 267.02921784881806 | [-116.69615242270673, -190.12366504392975, 50.9226880014461] | 1 | True | Vier M4 von oben, vor Montage der Umlenkwelle;8mm Gewinde im Ausleger
P14_0303 | +1 Servo3_Sattelscheibe178 | P14_existing | Aluminium7075-T6 | 0.0001103660977080547 | 39.276191355179535 | [-116.69615242270673, -190.12366504392975, 53.400000000000006] | 1 | True | Festigkeit, Passungen und Freigabe offen
P14_0304 | +1 Servo3_Sattelbolzen188 | P14_existing | Aluminium7075-T6 | 0.0007503521021551783 | 267.029217848818 | [-121.69615242270673, -198.78391908177414, 50.92268800144611] | 1 | True | Vier M4 von oben, vor Montage der Umlenkwelle;8mm Gewinde im Ausleger
P14_0305 | +1 Servo3_Sattelscheibe188 | P14_existing | Aluminium7075-T6 | 0.0001103660977080547 | 39.276191355179535 | [-121.69615242270673, -198.78391908177414, 53.400000000000006] | 1 | True | Festigkeit, Passungen und Freigabe offen
P14_0306 | +1 Servo3_Sattelbolzen198 | P14_existing | Aluminium7075-T6 | 0.0007503521021551783 | 267.02921784881806 | [-126.69615242270676, -207.4441731196185, 50.922688001446105] | 1 | True | Vier M4 von oben, vor Montage der Umlenkwelle;8mm Gewinde im Ausleger
P14_0307 | +1 Servo3_Sattelscheibe198 | P14_existing | Aluminium7075-T6 | 0.0001103660977080547 | 39.276191355179556 | [-126.69615242270675, -207.4441731196185, 53.4] | 1 | True | Festigkeit, Passungen und Freigabe offen
P14_0308 | +1 Servo3_Sattelbolzen208 | P14_existing | Aluminium7075-T6 | 0.0007503521021551783 | 267.0292178488182 | [-131.69615242270675, -216.1044271574629, 50.92268800144609] | 1 | True | Vier M4 von oben, vor Montage der Umlenkwelle;8mm Gewinde im Ausleger
P14_0309 | +1 Servo3_Sattelscheibe208 | P14_existing | Aluminium7075-T6 | 0.0001103660977080547 | 39.27619135517954 | [-131.69615242270675, -216.1044271574629, 53.39999999999999] | 1 | True | Festigkeit, Passungen und Freigabe offen
P14_0310 | +1 Servo3_Traegerbolzen87_-6.5 | P14_existing | Aluminium7075-T6 | 0.004452119708360772 | 1584.384237850808 | [-49.129165124598885, -72.09421012924614, 29.000767051957112] | 1 | True | Vier M6 je Servotraeger,12mm Eingriff im Zentralblock, Scheibe1.6mm
P14_0311 | +1 Servo3_Traegerscheibe87_-6.5 | P14_existing | Aluminium7075-T6 | 0.0003638497106971029 | 129.48388281035693 | [-49.129165124598885, -72.09421012924614, 49.800000000000004] | 1 | True | Festigkeit, Passungen und Freigabe offen
P14_0312 | +1 Servo3_Traegerbolzen87_6.5 | P14_existing | Aluminium7075-T6 | 0.004452119708360772 | 1584.3842378508084 | [-37.87083487540119, -78.59421012924614, 29.000767051957116] | 1 | True | Vier M6 je Servotraeger,12mm Eingriff im Zentralblock, Scheibe1.6mm
P14_0313 | +1 Servo3_Traegerscheibe87_6.5 | P14_existing | Aluminium7075-T6 | 0.0003638497106971029 | 129.48388281035693 | [-37.87083487540119, -78.59421012924614, 49.800000000000004] | 1 | True | Festigkeit, Passungen und Freigabe offen
P14_0314 | +1 Servo3_Traegerbolzen111_-6.5 | P14_existing | Aluminium7075-T6 | 0.004452119708360772 | 1584.3842378508084 | [-61.1291651245989, -92.87881982007266, 29.0007670519571] | 1 | True | Vier M6 je Servotraeger,12mm Eingriff im Zentralblock, Scheibe1.6mm
P14_0315 | +1 Servo3_Traegerscheibe111_-6.5 | P14_existing | Aluminium7075-T6 | 0.0003638497106971029 | 129.48388281035693 | [-61.1291651245989, -92.87881982007266, 49.800000000000004] | 1 | True | Festigkeit, Passungen und Freigabe offen
P14_0316 | +1 Servo3_Traegerbolzen111_6.5 | P14_existing | Aluminium7075-T6 | 0.004452119708360772 | 1584.3842378508086 | [-49.8708348754012, -99.37881982007266, 29.00076705195711] | 1 | True | Vier M6 je Servotraeger,12mm Eingriff im Zentralblock, Scheibe1.6mm
P14_0317 | +1 Servo3_Traegerscheibe111_6.5 | P14_existing | Aluminium7075-T6 | 0.0003638497106971029 | 129.48388281035693 | [-49.8708348754012, -99.37881982007266, 49.800000000000004] | 1 | True | Festigkeit, Passungen und Freigabe offen
P14_0318 | +1 P0_Einstellhuelse | P14_existing | Aluminium7075-T6 | 0.00901177478403147 | 3207.037289690915 | [94.50780809954752, 51.76784801618275, 154.36614550717263] | 1 | True | SW10, zwei gegenläufige M6; Gewinde-Kernkontur; keine Nennachsen-Stange durch Gelenke
P14_0319 | +1 P0_L_eye | P14_existing | Aluminium7075-T6 | 0.007551686122008283 | 2687.432783632841 | [112.61064538709608, 61.68390578221066, 122.95706110444307] | 1 | True | GE8E-Sitz16H7, Schulter und DIN472-Nut;20mm M6-Bereich, Mindestgewindeeingriff10.5mm; Sonderteil
P14_0320 | +1 P0_L_clip | P14_existing | Federstahl | 0.0005296777701920098 | 67.4748751836955 | [115.9692561276785, 63.52362779849683, 122.35570802016159] | 1 | True | Nenngeometrie und Einbau geprüft; Norm-Innenprofile/Massen und Werkstoff-Lebensdauer nach Lieferteil qualifizieren
P14_0321 | +1 P0_L_outer_shim | P14_existing | Aluminium1050 | 1.8191352990703534e-05 | 6.737538144704972 | [115.91154440420405, 63.49201547154041, 121.39912837622006] | 1 | True | Nenngeometrie und Einbau geprüft; Norm-Innenprofile/Massen und Werkstoff-Lebensdauer nach Lieferteil qualifizieren
P14_0322 | +1 P0_L_jam_nut | P14_existing | Aluminium7075-T6 | 0.0009297493947860914 | 330.8716707423814 | [106.152670761365, 58.14646892136032, 133.85184463826346] | 1 | True | 5mm Kontermutter; Gewindehand je Einbaulage in Gelenkregister
P14_0323 | +1 P0_L_outer_race | P14_existing | Wälzlagerstahl | 0.0025470071470396075 | 324.45950917702027 | [114.01561623282758, 62.453496835230595, 119.99999992928689] | 1 | True | Nenngeometrie und Einbau geprüft; Norm-Innenprofile/Massen und Werkstoff-Lebensdauer nach Lieferteil qualifizieren
P14_0324 | +1 P0_L_Innen | P14_existing | Wälzlagerstahl | 0.004615896669451625 | 588.0123145798245 | [114.01561618438298, 62.453496834910986, 119.99999999516959] | 1 | True | Nenngeometrie und Einbau geprüft; Norm-Innenprofile/Massen und Werkstoff-Lebensdauer nach Lieferteil qualifizieren
P14_0325 | +1 P0_L_J_SP_L | P14_existing | Aluminium7075-T6 | 0.0005015060815856277 | 178.47191515502772 | [109.22977801144127, 59.831993362723395, 116.46821963284255] | 1 | True | Nenngeometrie und Einbau geprüft; Norm-Innenprofile/Massen und Werkstoff-Lebensdauer nach Lieferteil qualifizieren
P14_0326 | +1 P0_L_J_SP_R | P14_existing | Aluminium7075-T6 | 0.0005015060815856277 | 178.4719151550276 | [118.8014543867488, 65.0750002403676, 123.53178036715744] | 1 | True | Nenngeometrie und Einbau geprüft; Norm-Innenprofile/Massen und Werkstoff-Lebensdauer nach Lieferteil qualifizieren
P14_0327 | +1 P0_L_pin | P14_existing | Aluminium7075-T6 | 0.006148509033634557 | 2188.081506631516 | [115.62436843527092, 63.334713752601985, 121.18720339868254] | 1 | True | Nenngeometrie und Einbau geprüft; Norm-Innenprofile/Massen und Werkstoff-Lebensdauer nach Lieferteil qualifizieren
P14_0328 | +1 P0_L_pin_washer | P14_existing | Aluminium7075-T6 | 0.0005570742465020862 | 198.24706281213042 | [103.85491358530706, 56.88784334681551, 112.50175860511186] | 1 | True | Nenngeometrie und Einbau geprüft; Norm-Innenprofile/Massen und Werkstoff-Lebensdauer nach Lieferteil qualifizieren
P14_0329 | +1 P0_L_cotter | P14_existing | Sicherungsstahl | 0.00010349916397298404 | 13.184606875539373 | [102.2468819011613, 56.00702363154046, 111.15096883595676] | 1 | True | Nenngeometrie und Einbau geprüft; Norm-Innenprofile/Massen und Werkstoff-Lebensdauer nach Lieferteil qualifizieren
P14_0330 | +1 P0_U_eye | P14_existing | Aluminium7075-T6 | 0.007551686122008283 | 2687.432783632842 | [76.82553977496553, 41.95741000185765, 186.04680514931107] | 1 | True | GE8E-Sitz16H7, Schulter und DIN472-Nut;20mm M6-Bereich, Mindestgewindeeingriff10.5mm; Sonderteil
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
