ITSMEEME/PropBoard/modell_r04_taumel/fertigung_p08/Ausgabe/P08_Baugruppe_Servoverbindung_ENTWURF.FCStd

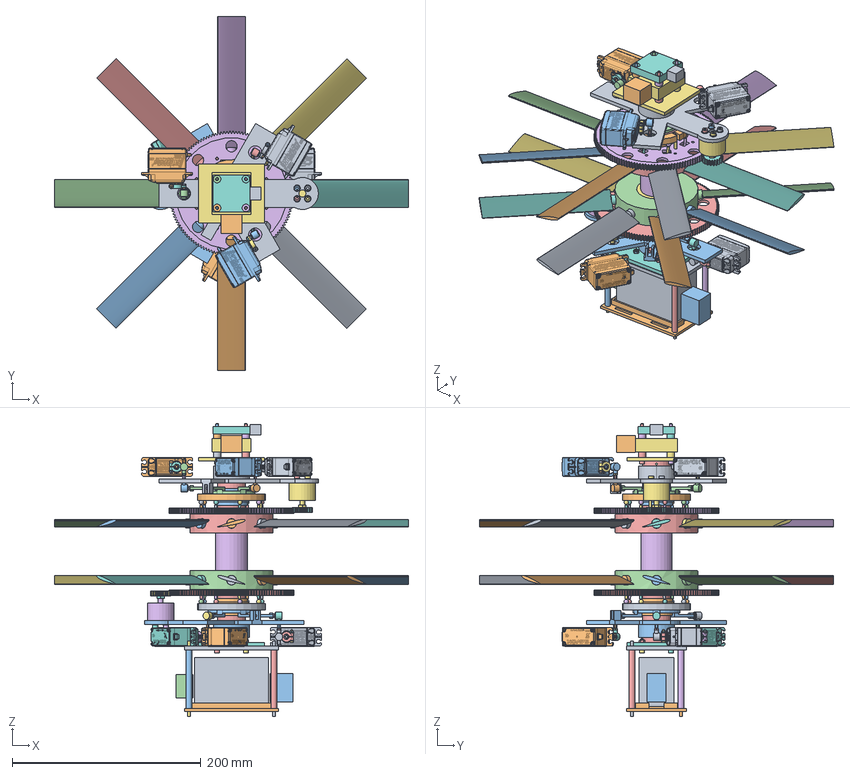
[picture p136: CAD file, 2026-10-30]
modell_r04_taumel/fertigung_p08/Ausgabe/P08_Baugruppe_Servoverbindung_ENTWURF.FCStd
375.0 x 375.0 x 310.5 mm
Oben_feststehend_10
Oben_feststehend_14
Unten_feststehend_10
Unten_feststehend_14
Mitte_0
Mitte_1
Mitte_2
Mitte_3
ESC_Distanz_0
FC_Distanz_0
ESC_Distanz_1
FC_Distanz_1
ESC_Distanz_2
FC_Distanz_2
ESC_Distanz_3
FC_Distanz_3
Akku_Anschlussplatte
Akkuwanne
Akku_Distanz_0
Akku_Distanz_1
Akku_Distanz_2
Akku_Distanz_3
REF_ESC
REF_FC
Akku_Referenz
Bodenpolster
N03_M3x40__M3_Stack_0
N03_M3x40__M3_Stack_1
N03_M3x40__M3_Stack_2
N03_M3x40__M3_Stack_3
M3_Akku_0
M3_Akku_1
M3_Akku_2
M3_Akku_3
M2_Quer__1
M2_Quer_1
N02_M3x12__M3_Anschluss_0
N02_M3x12__M3_Anschluss_1
N02_M3x12__M3_Anschluss_2
N02_M3x12__M3_Anschluss_3
USB_Zugang
ESC_Kabel
XT60_Zugang
JST_XHR_Zugang
Rotor_oben_0
Rotor_oben_1
Rotor_oben_2
Rotor_oben_3
Rotor_oben_4
Rotor_oben_5
Rotor_oben_6
Rotor_oben_7
Rotor_oben_8
Rotor_oben_9
Rotor_oben_10
Rotor_oben_11
Rotor_oben_12
Rotor_oben_13
Rotor_oben_14
Rotor_oben_15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
