ITSMEEME/PropBoard/cad/Tmotor_X605_Bauraum.FCStd

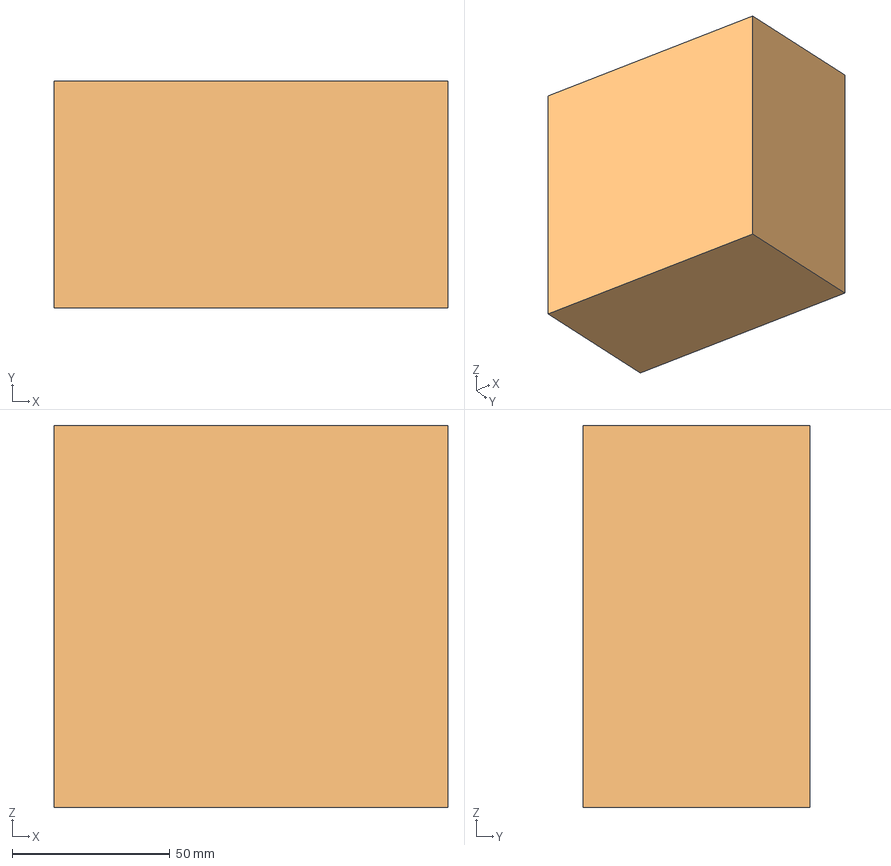
[picture p137: CAD file, 2026-10-29]
cad/Tmotor_X605_Bauraum.FCStd
124.8 x 72.0 x 121.0 mm
Motorkoerper
Referenzhuelle
