ITSMEEME/PropBoard/entwicklung_ab/Ausgabe/P14_R800/P14_R800_Rahmen.step

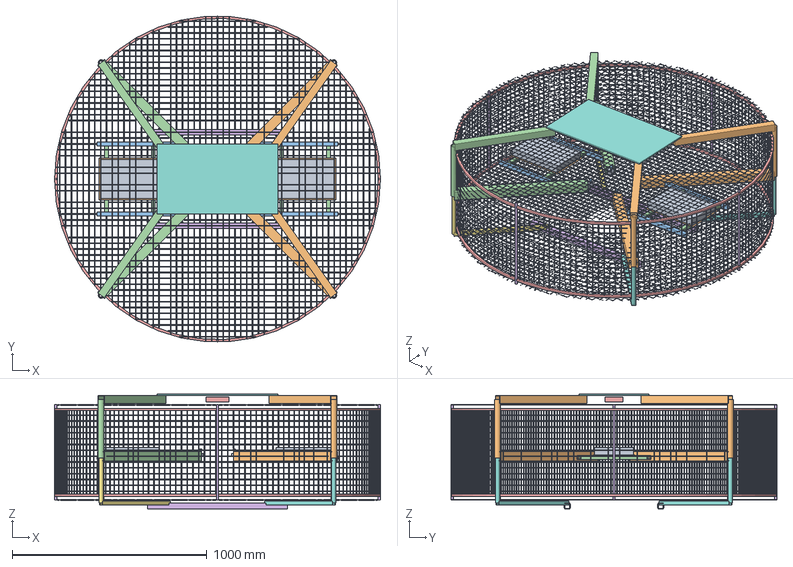
[picture p142: CAD file, 2026-11-02]
entwicklung_ab/Ausgabe/P14_R800/P14_R800_Rahmen.step
1674.0 x 1673.9 x 589.0 mm
A29-Alu-Anschlussadapter
Lastpfad A29–Außenpfosten–Deck
A29-Anschluss M8 Nennkontur
A29-Alu-Anschlussadapter001
Lastpfad A29–Außenpfosten–Deck001
A29-Anschluss M8 Nennkontur001
A29-Alu-Anschlussadapter002
Lastpfad A29–Außenpfosten–Deck002
A29-Anschluss M8 Nennkontur002
A29-Alu-Anschlussadapter003
Lastpfad A29–Außenpfosten–Deck003
A29-Anschluss M8 Nennkontur003
Schutzring 12×12 Nennquerschnitt
Schutzring 12×12 Nennquerschnitt001
Ringdistanzrohr Ø12×1,5 bis Gitterlagen
Ringdistanzrohr Ø12×1,5 bis Gitterlagen001
Ringdistanzrohr Ø12×1,5 bis Gitterlagen002
Ringdistanzrohr Ø12×1,5 bis Gitterlagen003
Ringdistanzrohr Ø12×1,5 bis Gitterlagen004
Ringdistanzrohr Ø12×1,5 bis Gitterlagen005
Ringdistanzrohr Ø12×1,5 bis Gitterlagen006
Ringdistanzrohr Ø12×1,5 bis Gitterlagen007
Drahtgitter Ø1,2 / 30 mm, Ausschnitt unten
Drahtgitter Ø1,2 / 30 mm, Ausschnitt unten001
Seitliches Berührungsgitter
Personendeck 620×360×8, Voll-CFK-Ersatz
Batteriebauraum 6 kg, symmetrisch im Zwischenraum
Batteriewanne 2mm Alu
Batterieschiene im Zwischenraum
Batterieschiene im Zwischenraum001
Batteriequerträger im Zwischenraum
Batteriequerträger im Zwischenraum001
Batteriebauraum 6 kg, symmetrisch im Zwischenraum001
Batteriewanne 2mm Alu001
Batterieschiene im Zwischenraum002
Batterieschiene im Zwischenraum003
Batteriequerträger im Zwischenraum002
Batteriequerträger im Zwischenraum003
Restelektronik-/Kabelbudget
Kufenrohr 30×30×2
Kufenstütze außerhalb Rotor oder darunter
Kufenstütze außerhalb Rotor oder darunter001
Kufenrohr 30×30×003
Kufenstütze außerhalb Rotor oder darunter002
Kufenstütze außerhalb Rotor oder darunter003
