ITSMEEME/PropBoard/entwicklung_ab/Ausgabe/QUAD_R400/QUAD_R400_Rahmen.step

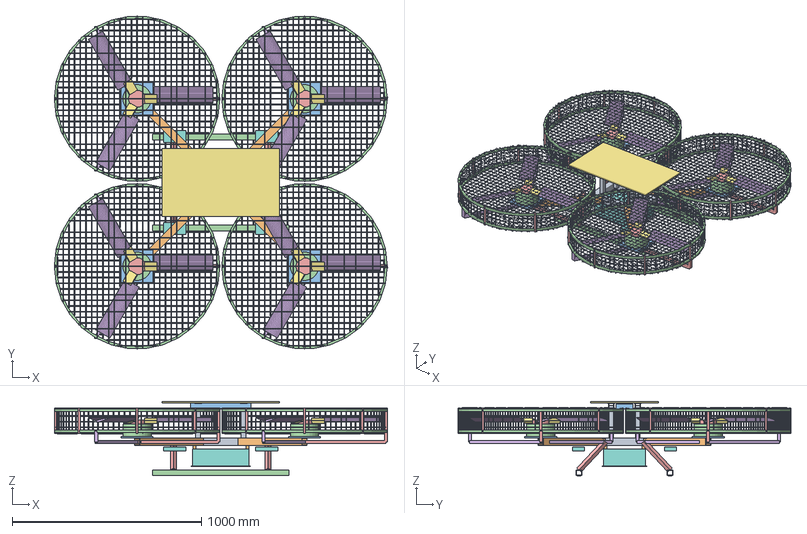
[picture p144: CAD file, 2026-11-02]
entwicklung_ab/Ausgabe/QUAD_R400/QUAD_R400_Rahmen.step
1760.0 x 1757.9 x 393.0 mm
Zentralrahmen 40×40×2,5
CFK-Ausleger 1
Motorträger 170×170×8, PCD50-Annahme
Motorbauraum Ø150×66, neuer Typ offen
Rotornabe Nennkörper
Profilblatt 3-Blatt-Referenz, Schalenmasse geschätzt
Nabensteg mit formgleichem Blattwurzel-Nennsitz
Profilblatt 3-Blatt-Referenz, Schalenmasse geschätzt001
Nabensteg mit formgleichem Blattwurzel-Nennsitz001
Profilblatt 3-Blatt-Referenz, Schalenmasse geschätzt002
Nabensteg mit formgleichem Blattwurzel-Nennsitz002
ESC-Platzhalter 120×65×22
CFK-Ausleger 2
Motorträger 170×170×8, PCD50-Annahme001
Motorbauraum Ø150×66, neuer Typ offen001
Rotornabe Nennkörper001
Profilblatt 3-Blatt-Referenz, Schalenmasse geschätzt003
Nabensteg mit formgleichem Blattwurzel-Nennsitz003
Profilblatt 3-Blatt-Referenz, Schalenmasse geschätzt004
Nabensteg mit formgleichem Blattwurzel-Nennsitz004
Profilblatt 3-Blatt-Referenz, Schalenmasse geschätzt005
Nabensteg mit formgleichem Blattwurzel-Nennsitz005
ESC-Platzhalter 120×65×023
CFK-Ausleger 3
Motorträger 170×170×8, PCD50-Annahme002
Motorbauraum Ø150×66, neuer Typ offen002
Rotornabe Nennkörper002
Profilblatt 3-Blatt-Referenz, Schalenmasse geschätzt006
Nabensteg mit formgleichem Blattwurzel-Nennsitz006
Profilblatt 3-Blatt-Referenz, Schalenmasse geschätzt007
Nabensteg mit formgleichem Blattwurzel-Nennsitz007
Profilblatt 3-Blatt-Referenz, Schalenmasse geschätzt008
Nabensteg mit formgleichem Blattwurzel-Nennsitz008
ESC-Platzhalter 120×65×024
CFK-Ausleger 4
Motorträger 170×170×8, PCD50-Annahme003
Motorbauraum Ø150×66, neuer Typ offen003
Rotornabe Nennkörper003
Profilblatt 3-Blatt-Referenz, Schalenmasse geschätzt009
Nabensteg mit formgleichem Blattwurzel-Nennsitz009
Profilblatt 3-Blatt-Referenz, Schalenmasse geschätzt010
Nabensteg mit formgleichem Blattwurzel-Nennsitz010
Profilblatt 3-Blatt-Referenz, Schalenmasse geschätzt011
Nabensteg mit formgleichem Blattwurzel-Nennsitz011
ESC-Platzhalter 120×65×025
Zentrale Deckstütze
Deckauflage
Zentrale Deckstütze001
Deckauflage001
Zentrale Deckstütze002
Deckauflage002
Zentrale Deckstütze003
Deckauflage003
Deckquerträger
Deckquerträger001
Schutzring 12×12 Nennquerschnitt
Schutzring 12×12 Nennquerschnitt001
Ringdistanzrohr Ø12×1,5 bis Gitterlagen
Ringdistanzrohr Ø12×1,5 bis Gitterlagen001
Ringdistanzrohr Ø12×1,5 bis Gitterlagen002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
