ITSMEEME/PropBoard/horizontal_z_r02/02_Schlitten_R02_Detail.step

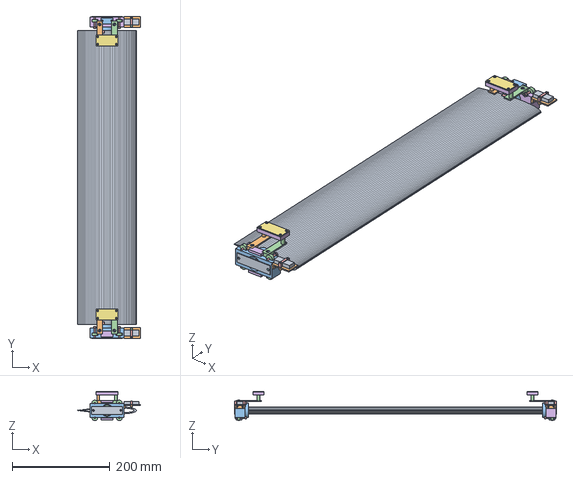
[picture p145: CAD file, 2026-10-29]
horizontal_z_r02/02_Schlitten_R02_Detail.step
128.0 x 658.0 x 60.0 mm
