ITSMEEME/PropBoard/konstruktion/02_Fuehrung_Antrieb_Detail.step

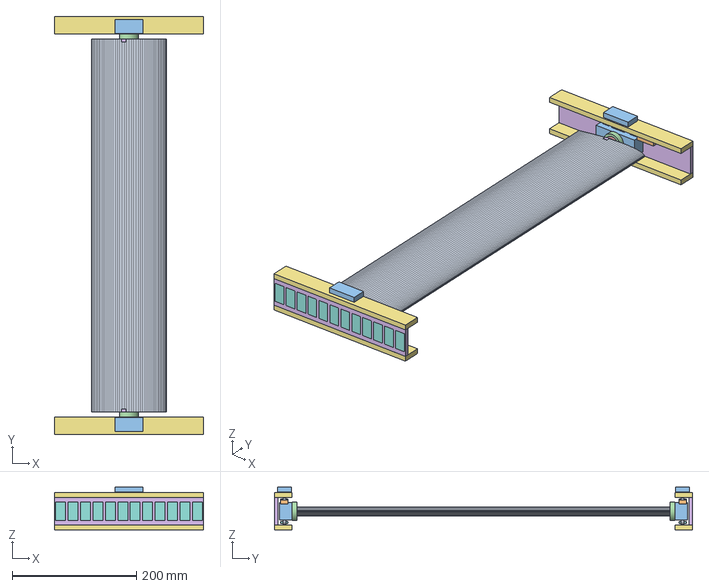
[picture p146: CAD file, 2026-10-29]
konstruktion/02_Fuehrung_Antrieb_Detail.step
240.0 x 672.0 x 69.0 mm
