ITSMEEME/PropBoard/kreis_r03/Kreis_R03_Layout.step

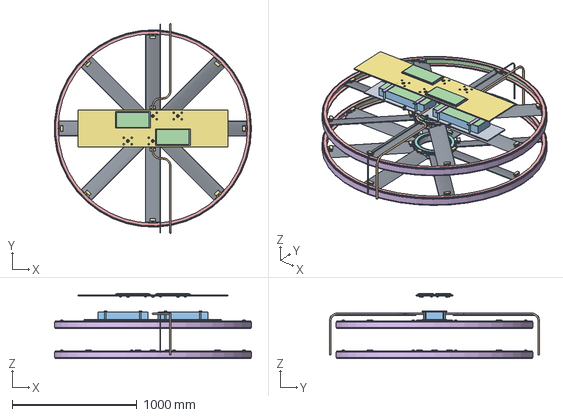
[picture p147: CAD file, 2026-10-30]
kreis_r03/Kreis_R03_Layout.step
1577.7 x 1681.9 x 523.0 mm
