ITSMEEME/PropBoard/kreis_r04/mn1330_p12/Ausgabe/Referenz_STEP/REF-ACHS-MUTTER-M14.step

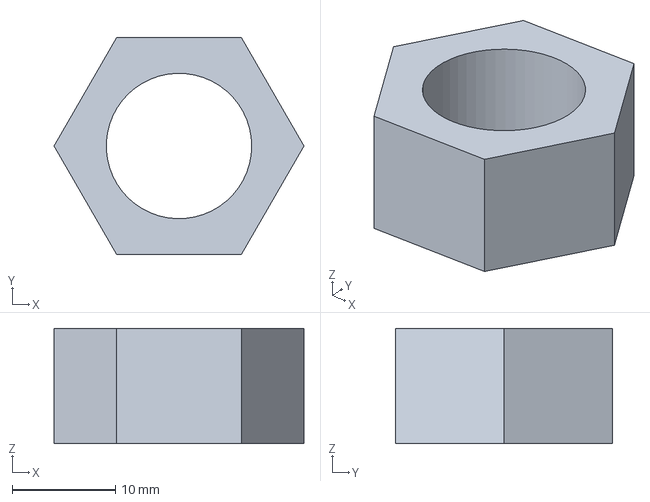
[picture p148: CAD file, 2026-11-01]
kreis_r04/mn1330_p12/Ausgabe/Referenz_STEP/REF-ACHS-MUTTER-M14.step
24.2 x 21.0 x 11.2 mm
