ITSMEEME/PropBoard/kreis_r04/mn1330_p12/Ausgabe/STEP/P12-005_MZ.step

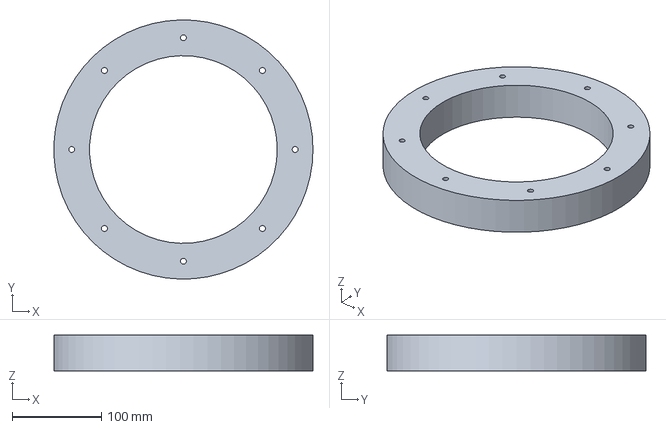
[picture p149: CAD file, 2026-11-01]
kreis_r04/mn1330_p12/Ausgabe/STEP/P12-005_MZ.step
289.8 x 289.9 x 40.0 mm
