ITSMEEME/PropBoard/kreis_r04/mn1330_p12/Ausgabe/STL/REF-SCHRAUBE-M5-L60-K4.1.stl

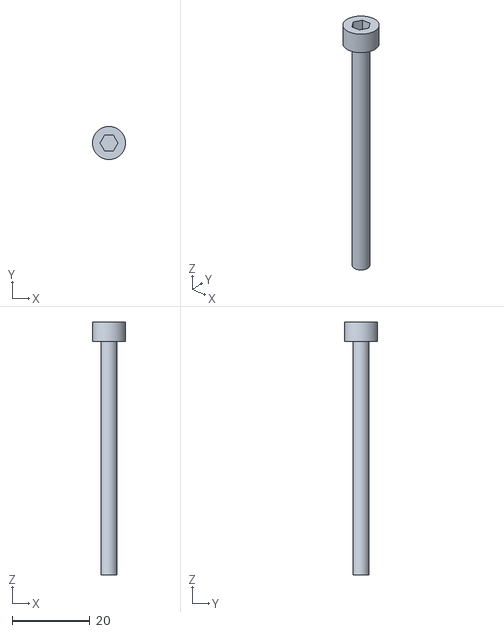
[picture p150: CAD file, 2026-11-01]
kreis_r04/mn1330_p12/Ausgabe/STL/REF-SCHRAUBE-M5-L60-K4.1.stl
8.50 x 8.50 x 65.0
