ITSMEEME/PropBoard/kreis_r04/mn1330_p12/Varianten/Aluminium/P12_MN1330.step

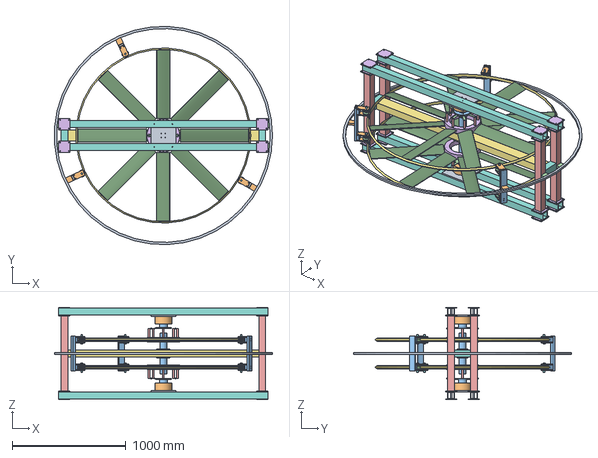
[picture p151: CAD file, 2026-11-01]
kreis_r04/mn1330_p12/Varianten/Aluminium/P12_MN1330.step
1917.2 x 1918.6 x 812.0 mm
