ITSMEEME/PropBoard/kreis_r04/mn1330_p12/Varianten/Aluminium/STEP/P12-003_MZ.step

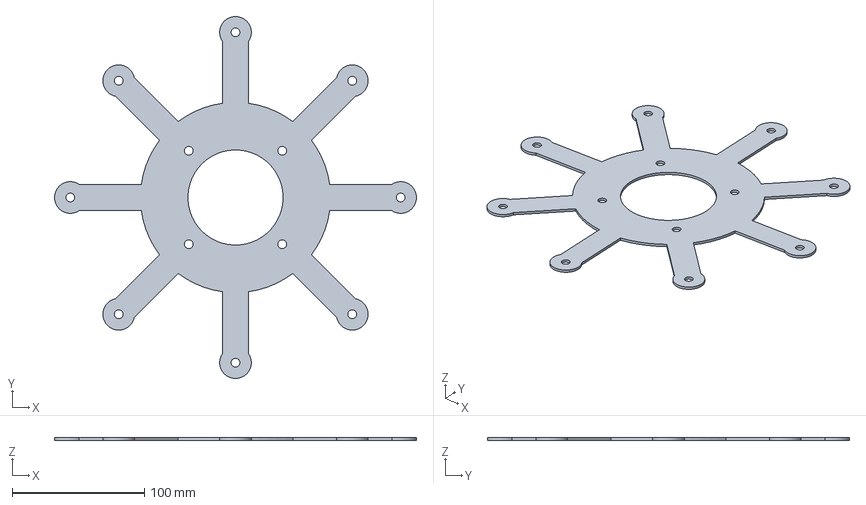
[picture p152: CAD file, 2026-11-01]
kreis_r04/mn1330_p12/Varianten/Aluminium/STEP/P12-003_MZ.step
274.0 x 274.0 x 2.00 mm
