ITSMEEME/PropBoard/kreis_r04/mn1330_p12/Varianten/Aluminium/STL/REF-FLUEGEL.stl

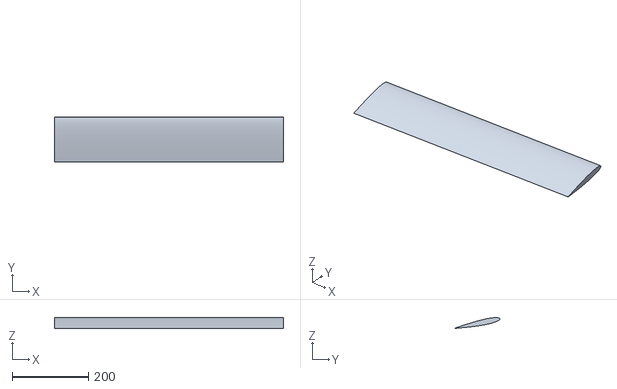
[picture p153: CAD file, 2026-11-01]
kreis_r04/mn1330_p12/Varianten/Aluminium/STL/REF-FLUEGEL.stl
600.0 x 117.5 x 28.4
