ITSMEEME/PropBoard/kreis_r04/mn1330_p13/Ausgabe/P13_Mechanik.FCStd

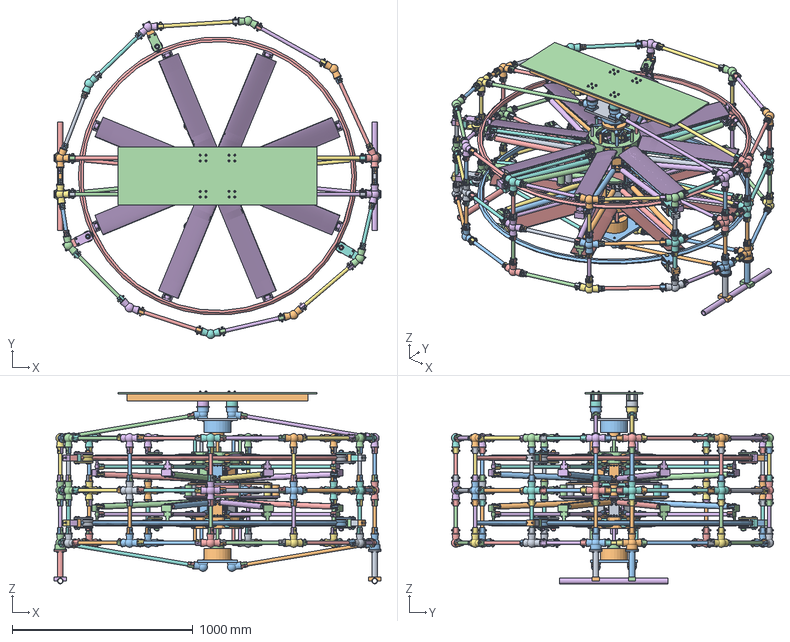
[picture p154: CAD file, 2026-11-01]
kreis_r04/mn1330_p13/Ausgabe/P13_Mechanik.FCStd
1810.0 x 1783.5 x 1066.6 mm
Oben_Statorplatte
Oben_Nabe
Oben_Membran
Oben_Distanz_1
Oben_Distanz_2
Oben_Distanz_3
Oben_Distanz_4
Oben_Distanz_5
Oben_Distanz_6
Oben_Distanz_7
Oben_Distanz_8
Oben_Mittelstuetze_Rohr
Oben_Rolle_1
Oben_Rolle_1_Deckel_A
Oben_Rolle_1_Deckel_B
Oben_Rolle_1_Distanz
Oben_Rolle_1_Achse
Oben_Rolle_1_Anlauf_A
Oben_Rolle_1_Anlauf_B
Oben_Rolle_1_Gabel_A
Oben_Rolle_1_Gabel_B
Oben_Rolle_1_Steg
Oben_Rolle_2
Oben_Rolle_2_Deckel_A
Oben_Rolle_2_Deckel_B
Oben_Rolle_2_Distanz
Oben_Rolle_2_Achse
Oben_Rolle_2_Anlauf_A
Oben_Rolle_2_Anlauf_B
Oben_Rolle_2_Gabel_A
Oben_Rolle_2_Gabel_B
Oben_Rolle_2_Steg
Oben_Rolle_3
Oben_Rolle_3_Deckel_A
Oben_Rolle_3_Deckel_B
Oben_Rolle_3_Distanz
Oben_Rolle_3_Achse
Oben_Rolle_3_Anlauf_A
Oben_Rolle_3_Anlauf_B
Oben_Rolle_3_Gabel_A
Oben_Rolle_3_Gabel_B
Oben_Rolle_3_Steg
Unten_Statorplatte
Unten_Nabe
Unten_Membran
Unten_Distanz_1
Unten_Distanz_2
Unten_Distanz_3
Unten_Distanz_4
Unten_Distanz_5
Unten_Distanz_6
Unten_Distanz_7
Unten_Distanz_8
Unten_Mittelstuetze_Rohr
Unten_Rolle_1
Unten_Rolle_1_Deckel_A
Unten_Rolle_1_Deckel_B
Unten_Rolle_1_Distanz
Unten_Rolle_1_Achse
Unten_Rolle_1_Anlauf_A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
