ITSMEEME/PropBoard/kreis_r04/mn1330_p13/Ausgabe/STEP_Nennkonturen/REF-SCHRAUBE-M4-L8-K3.2.step

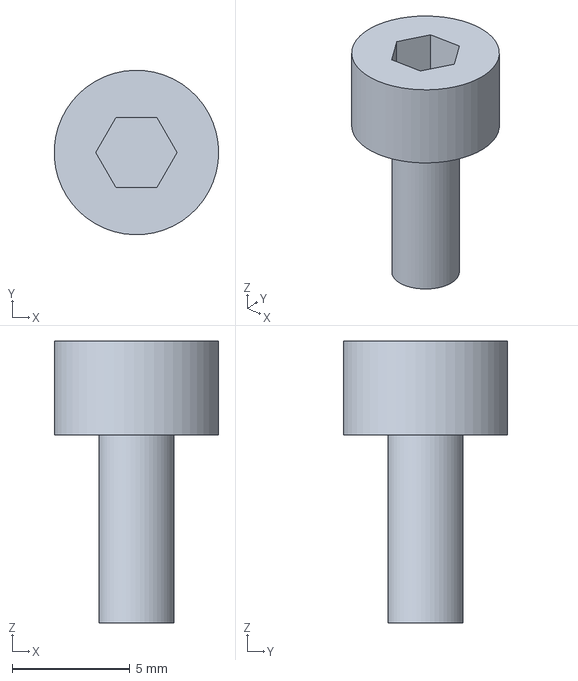
[picture p155: CAD file, 2026-11-01]
kreis_r04/mn1330_p13/Ausgabe/STEP_Nennkonturen/REF-SCHRAUBE-M4-L8-K3.2.step
6.99 x 7.00 x 12.0 mm
