ITSMEEME/PropBoard/kreis_r04/mn1330_p13/Ausgabe/STEP_Sonderteile/CFK-ROHR-001.step

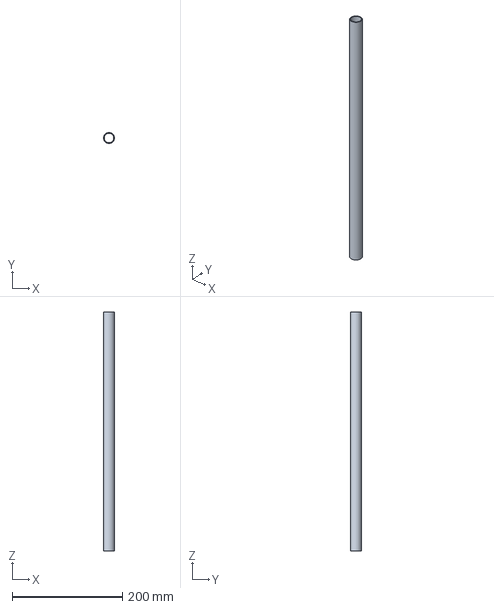
[picture p156: CAD file, 2026-11-01]
kreis_r04/mn1330_p13/Ausgabe/STEP_Sonderteile/CFK-ROHR-001.step
20.0 x 20.0 x 433.4 mm
