ITSMEEME/PropBoard/kreis_r04/mn1330_p13/Ausgabe/STL/STD-DIN6325-4x25.stl

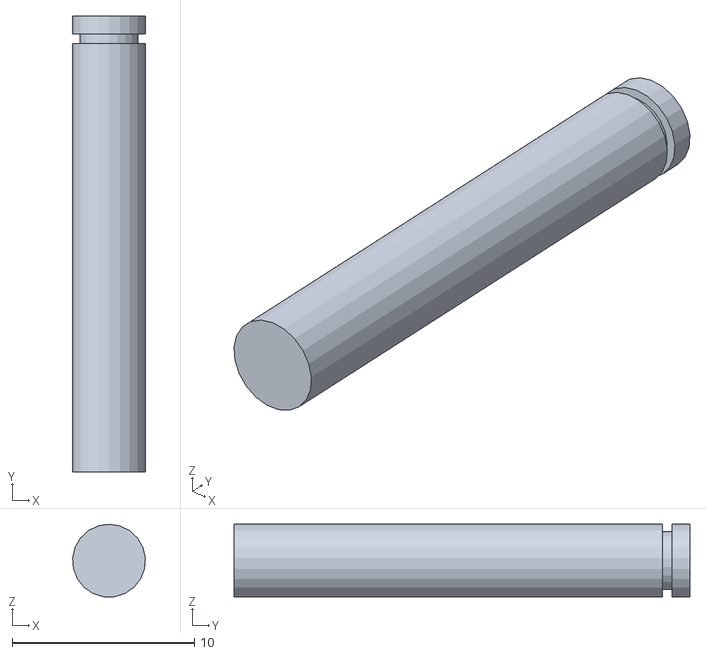
[picture p157: CAD file, 2026-11-01]
kreis_r04/mn1330_p13/Ausgabe/STL/STD-DIN6325-4x25.stl
3.99 x 25.0 x 3.98
