ITSMEEME/PropBoard/kreis_r04/mn1330_p14/Ausgabe/Montagewerkzeuge/Splint_vor_Umbiegen.step

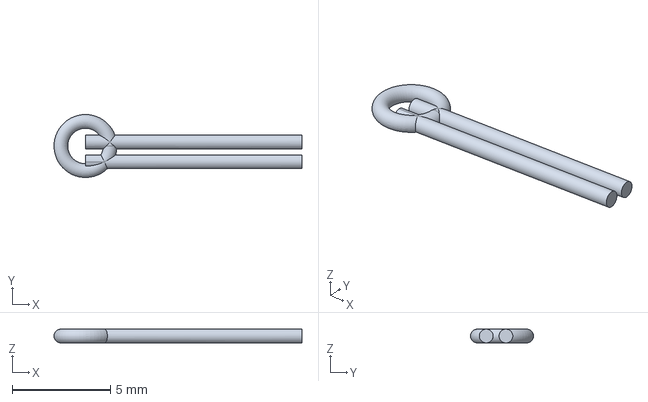
[picture p158: CAD file, 2026-11-01]
kreis_r04/mn1330_p14/Ausgabe/Montagewerkzeuge/Splint_vor_Umbiegen.step
12.6 x 3.20 x 0.7 mm
