ITSMEEME/PropBoard/kreis_r04/mn1330_p14/Ausgabe/STEP_Referenzen/J_W8.step

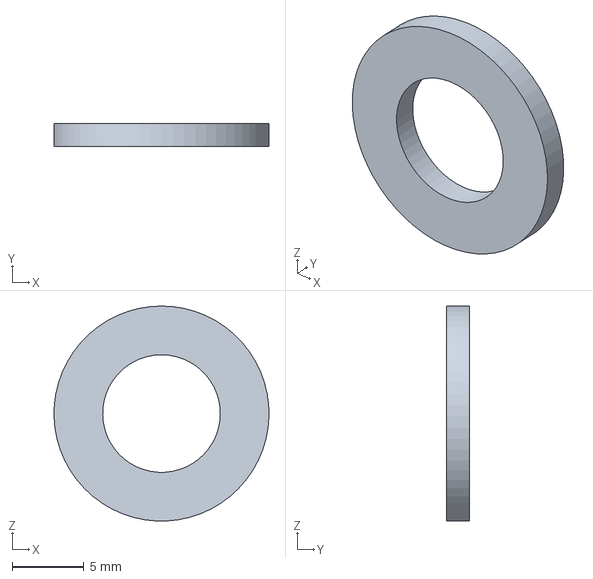
[picture p159: CAD file, 2026-11-01]
kreis_r04/mn1330_p14/Ausgabe/STEP_Referenzen/J_W8.step
15.0 x 1.60 x 15.0 mm
