ITSMEEME/PropBoard/kreis_r04/mn1330_p14/Ausgabe/STEP_Sonderteile/A11.step

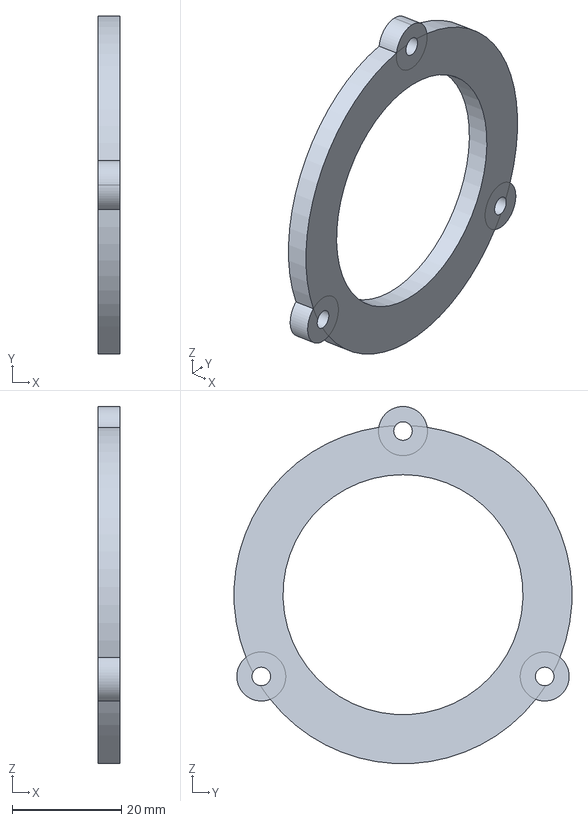
[picture p160: CAD file, 2026-11-01]
kreis_r04/mn1330_p14/Ausgabe/STEP_Sonderteile/A11.step
4.00 x 61.9 x 65.5 mm
