ITSMEEME/PropBoard/modell_r04/cad/R04_Testmodell_1zu4.step

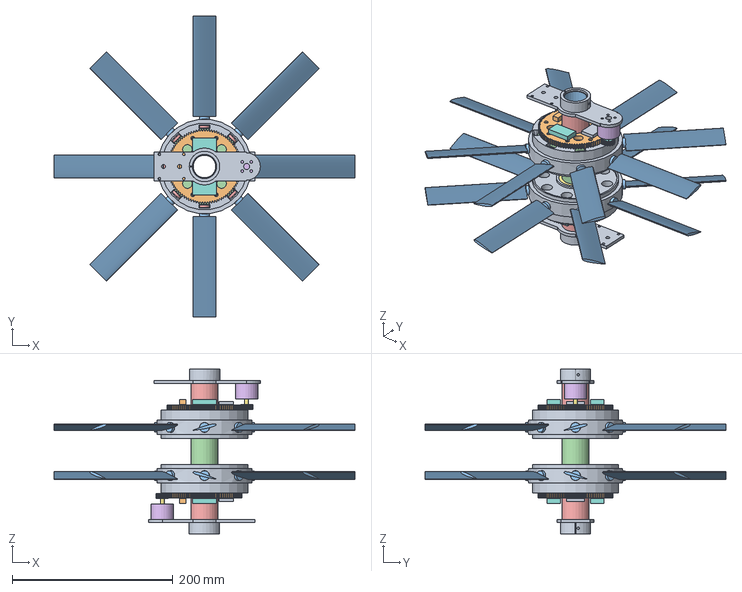
[picture p161: CAD file, 2026-10-30]
modell_r04/cad/R04_Testmodell_1zu4.step
375.0 x 375.0 x 205.0 mm
