ITSMEEME/PropBoard/modell_r04/cad/stl/Huelse_Aussen.stl

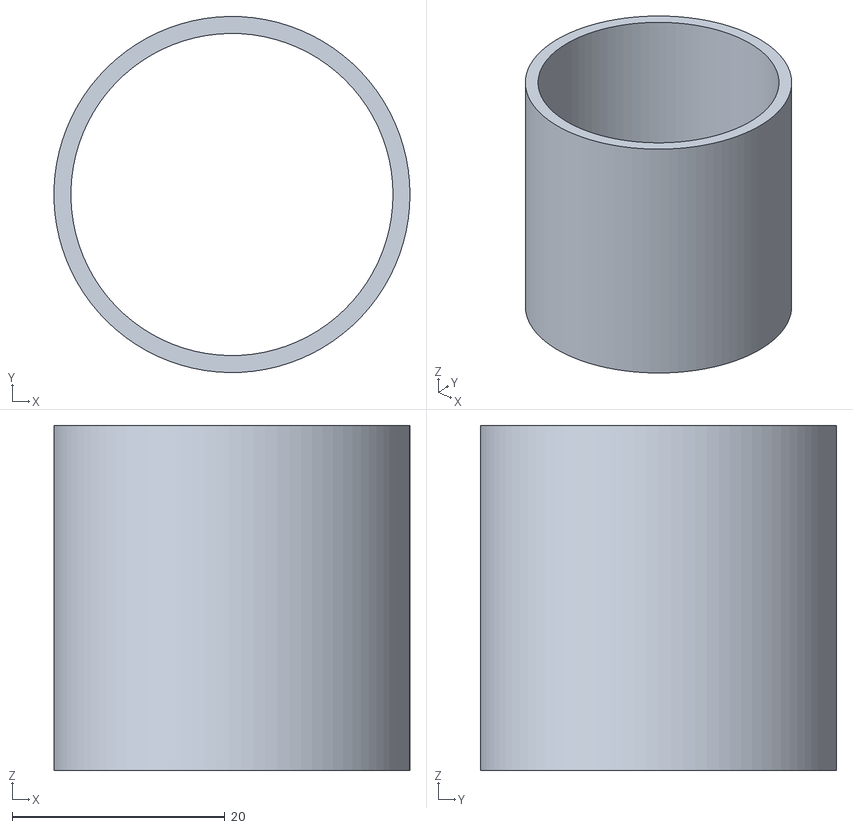
[picture p162: CAD file, 2026-10-30]
modell_r04/cad/stl/Huelse_Aussen.stl
33.5 x 33.5 x 32.5
