ITSMEEME/PropBoard/modell_r04_taumel/cad/Fertigung/Einzelteile/TM-12_Mittelrohr_Zuschnitt.FCStd

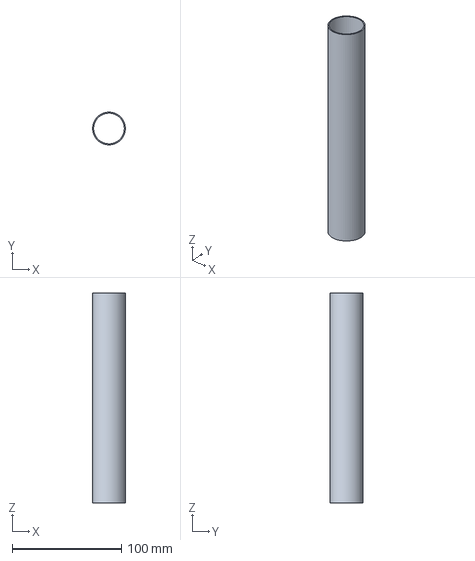
[picture p165: CAD file, 2026-10-30]
modell_r04_taumel/cad/Fertigung/Einzelteile/TM-12_Mittelrohr_Zuschnitt.FCStd
30.0 x 30.0 x 192.0 mm
