ITSMEEME/PropBoard/modell_r04_taumel/cad/Fertigung/STEP/TM-03U_Deckel_Zahnkranz_unten.step

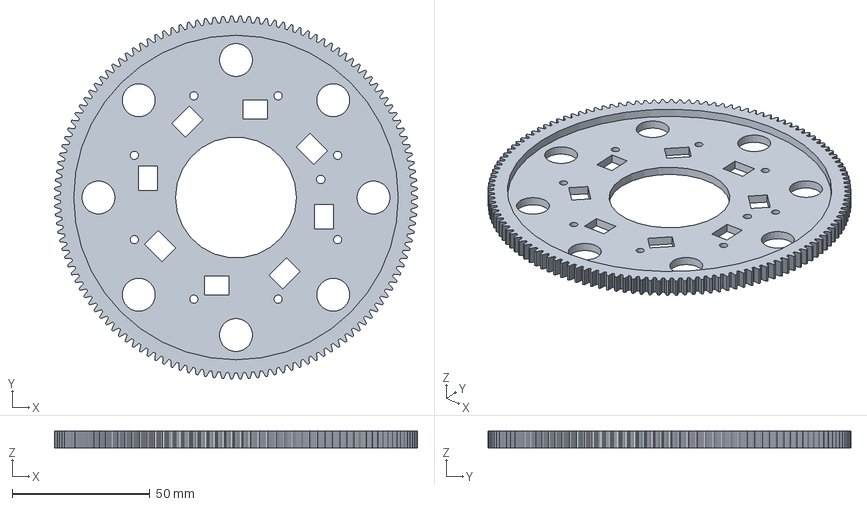
[picture p166: CAD file, 2026-10-30]
modell_r04_taumel/cad/Fertigung/STEP/TM-03U_Deckel_Zahnkranz_unten.step
132.0 x 132.0 x 6.00 mm
