ITSMEEME/PropBoard/modell_r04_taumel/cad/vorschau/Oben_feststehend_Kauf.stl

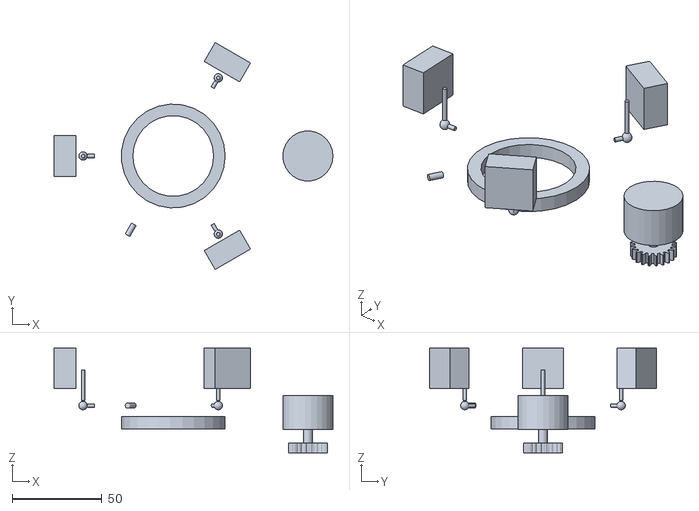
[picture p167: CAD file, 2026-10-30]
modell_r04_taumel/cad/vorschau/Oben_feststehend_Kauf.stl
155.6 x 126.6 x 58.5
