ITSMEEME/PropBoard/modell_r04_taumel/fertigung_p02/Quellen/N02_M3x12.step

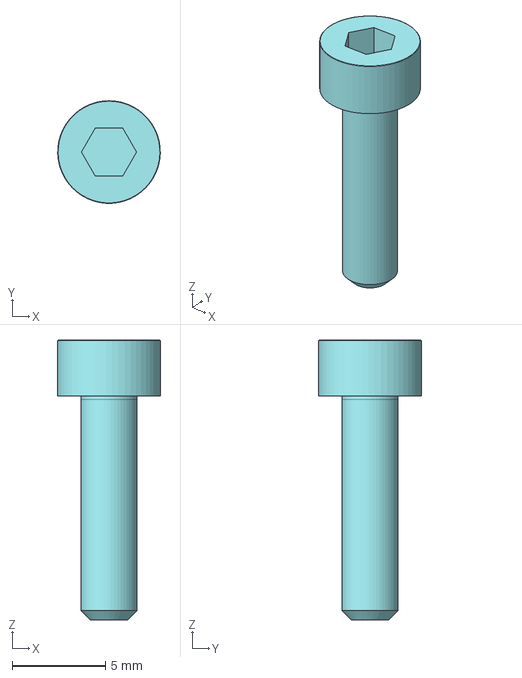
[picture p168: CAD file, 2026-10-30]
modell_r04_taumel/fertigung_p02/Quellen/N02_M3x12.step
5.50 x 5.49 x 15.0 mm
