ITSMEEME/PropBoard/modell_r04_taumel/fertigung_p04/Ausgabe/EMAX_ECOII2306_Anschlussmodell_P04.step

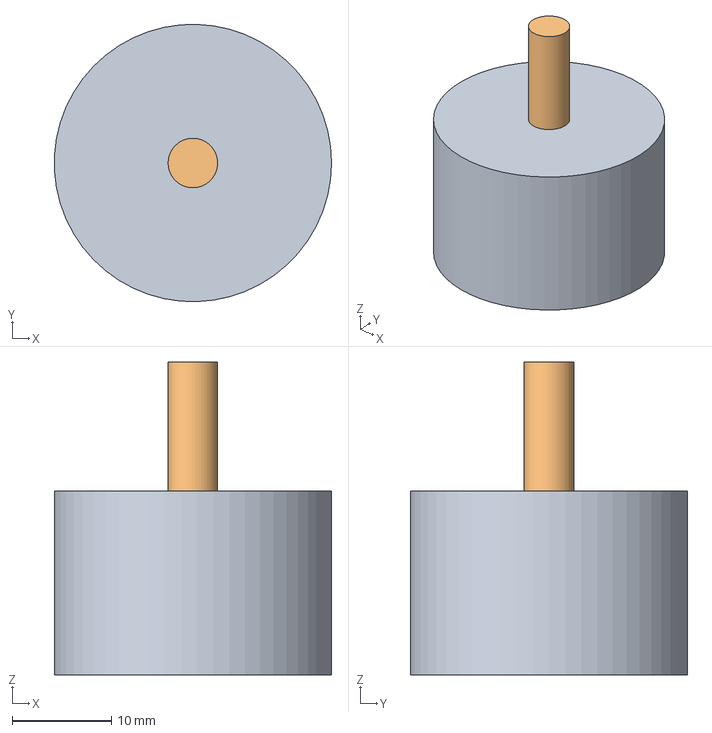
[picture p169: CAD file, 2026-10-30]
modell_r04_taumel/fertigung_p04/Ausgabe/EMAX_ECOII2306_Anschlussmodell_P04.step
28.0 x 28.0 x 31.6 mm
