ITSMEEME/PropBoard/modell_r04_taumel/fertigung_p05/Ausgabe/Kontermutter_M5.step

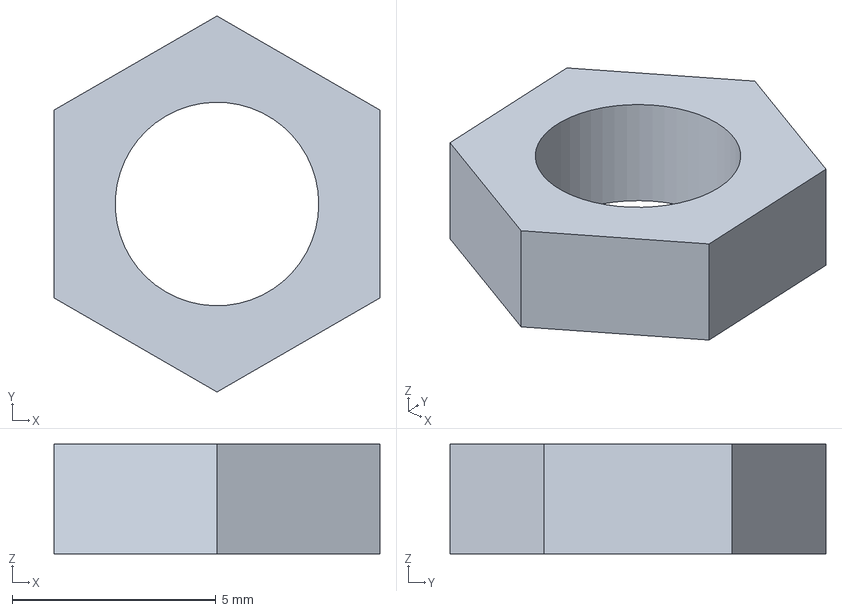
[picture p170: CAD file, 2026-10-30]
modell_r04_taumel/fertigung_p05/Ausgabe/Kontermutter_M5.step
8.00 x 9.24 x 2.70 mm
