ITSMEEME/PropBoard/modell_r04_taumel/fertigung_p05/Quellen/N01_M3x10.step

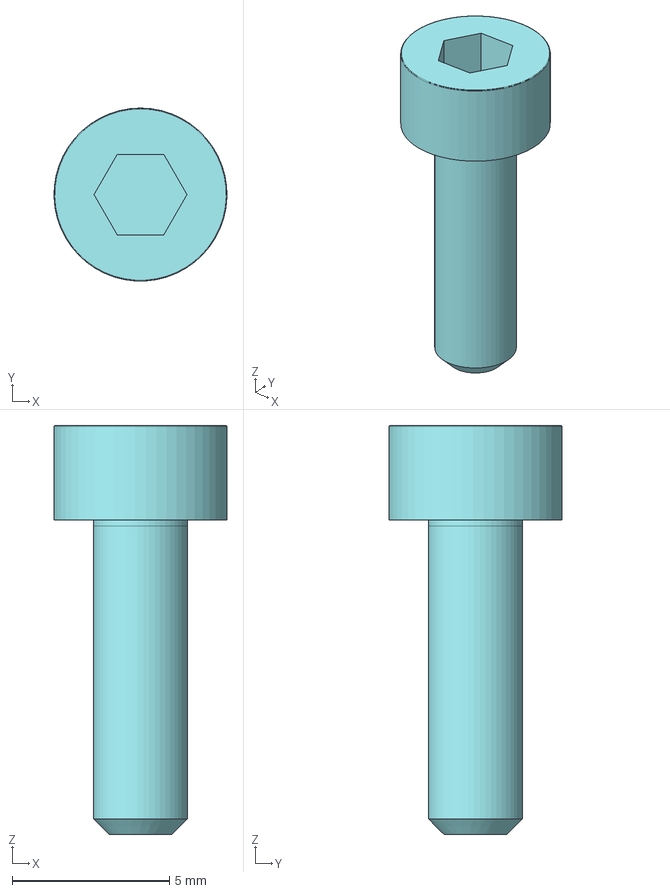
[picture p171: CAD file, 2026-10-30]
modell_r04_taumel/fertigung_p05/Quellen/N01_M3x10.step
5.50 x 5.49 x 13.0 mm
