ITSMEEME/PropBoard/modell_r04_taumel/fertigung_p07/Quellen/SB-2270SGP.STEP

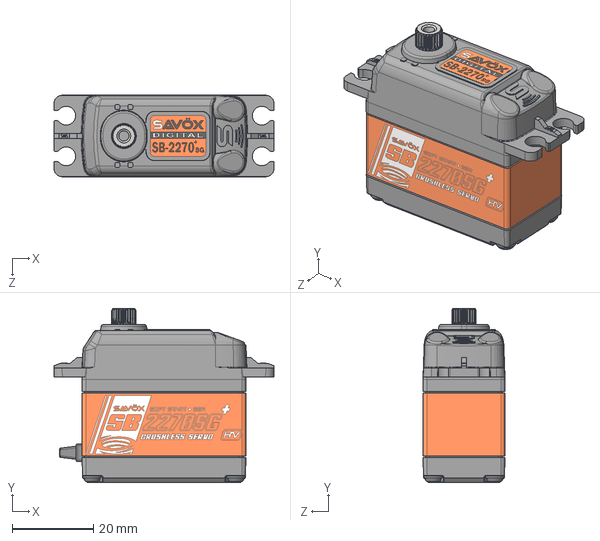
[picture p172: CAD file, 2026-10-30]
modell_r04_taumel/fertigung_p07/Quellen/SB-2270SGP.STEP
54.0 x 42.8 x 20.2 mm
