ITSMEEME/PropBoard/modell_r04_taumel/fertigung_p08/Ausgabe/P08_Anschluss_Einzelteile_ENTWURF.FCStd

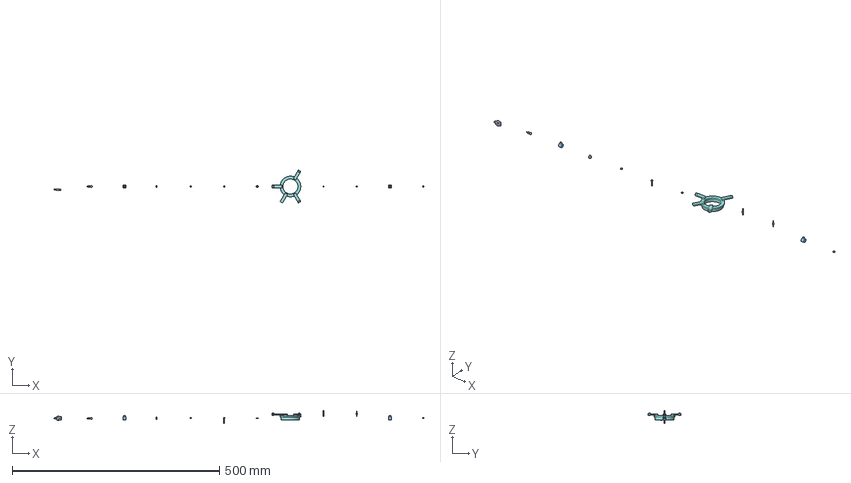
[picture p173: CAD file, 2026-10-30]
modell_r04_taumel/fertigung_p08/Ausgabe/P08_Anschluss_Einzelteile_ENTWURF.FCStd
892.0 x 79.7 x 30.6 mm
horn
ball_low
body_low
cap_low
jam_low
clamp_bolt
washer_low
swash
rod_upper
rod_lower
body_high
jam_high
