ITSMEEME/PropBoard/modell_r04_taumel/halterungen/Ausgabe/Einzelteile/H05_Akkuwanne_78x37x52.FCStd

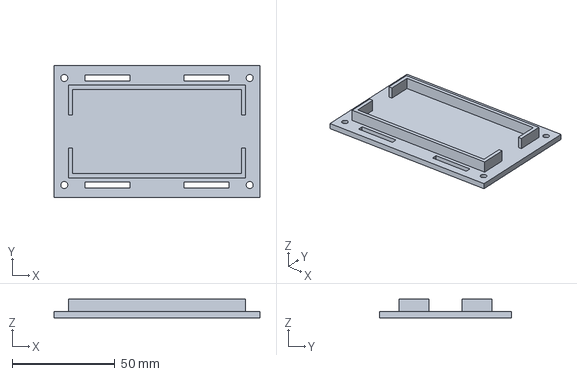
[picture p174: CAD file, 2026-10-30]
modell_r04_taumel/halterungen/Ausgabe/Einzelteile/H05_Akkuwanne_78x37x52.FCStd
100.0 x 64.0 x 9.00 mm
