ITSMEEME/PropBoard/modell_r04_taumel/halterungen/Ausgabe/STEP/H01_Rohr_Endadapter.step

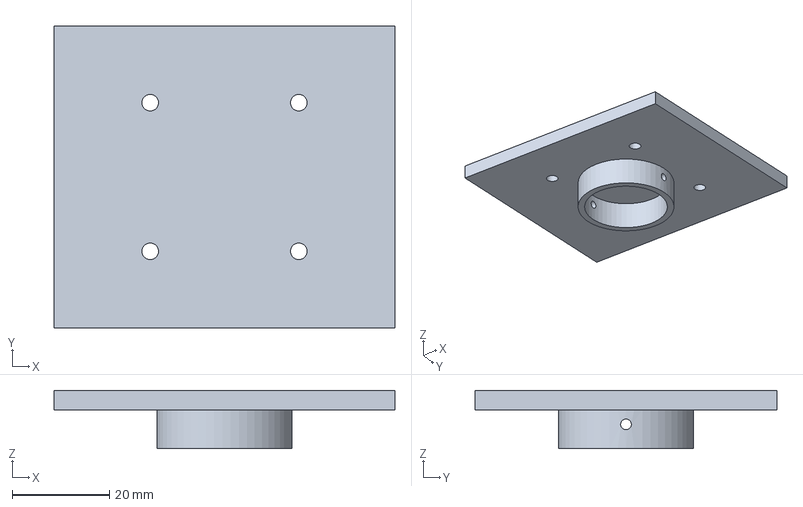
[picture p175: CAD file, 2026-10-30]
modell_r04_taumel/halterungen/Ausgabe/STEP/H01_Rohr_Endadapter.step
70.0 x 62.0 x 12.0 mm
