ITSMEEME/PropBoard/modell_r04_taumel/integration_p10/Ausgabe/STEP/Planetenbolzen_D5.step

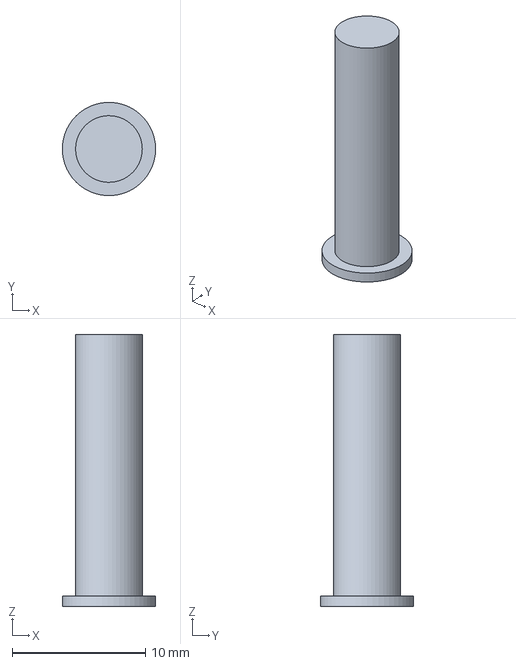
[picture p176: CAD file, 2026-10-31]
modell_r04_taumel/integration_p10/Ausgabe/STEP/Planetenbolzen_D5.step
6.99 x 7.00 x 20.4 mm
