ITSMEEME/PropBoard/modell_r04_taumel/integration_p11/Ausgabe/STEP/P11_Rollentraeger_Unten_0.step

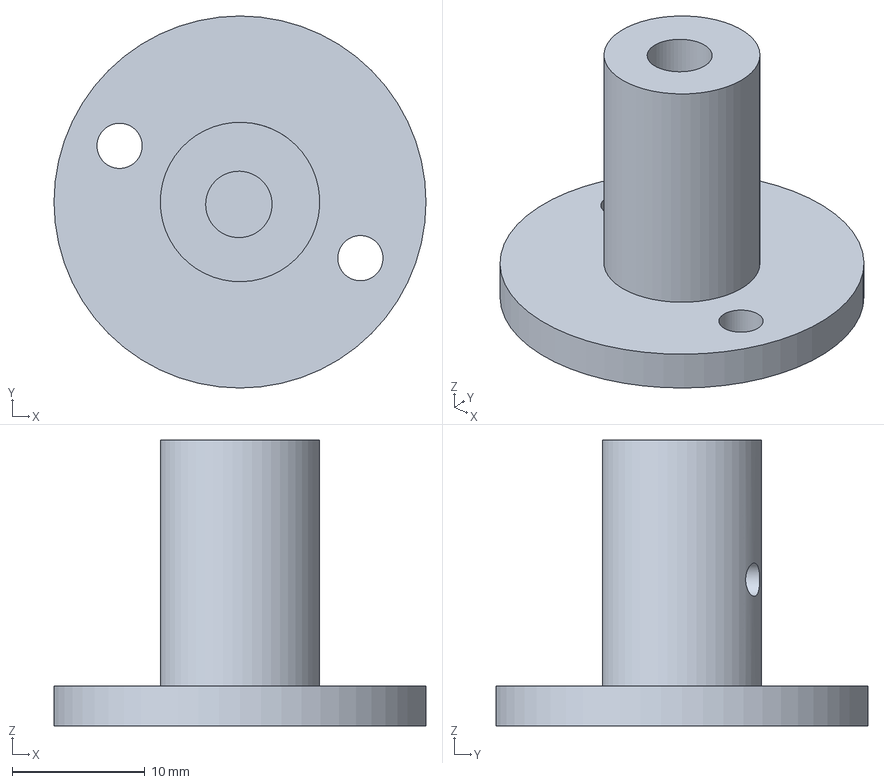
[picture p177: CAD file, 2026-11-01]
modell_r04_taumel/integration_p11/Ausgabe/STEP/P11_Rollentraeger_Unten_0.step
28.0 x 28.0 x 21.5 mm
