ITSMEEME/PropBoard/motor_drrf/Ausgabe/DRRF_K01.step

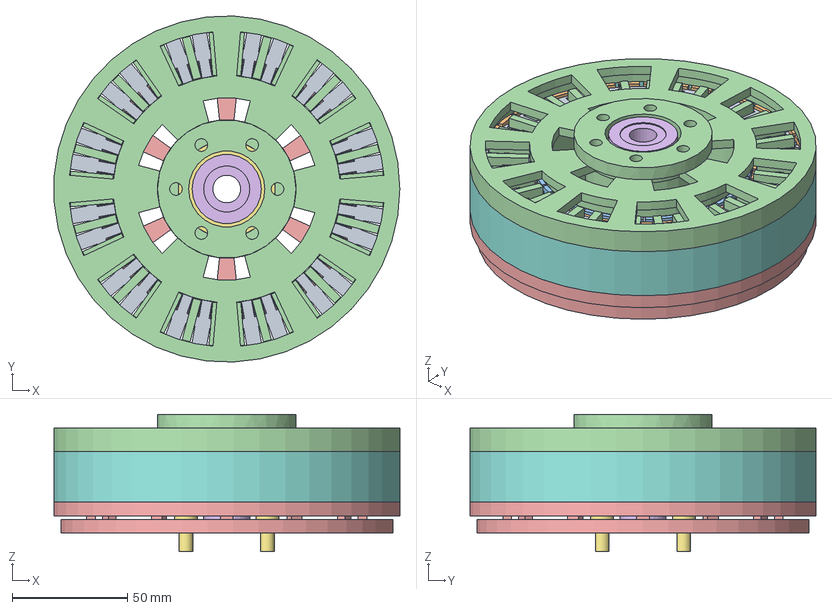
[picture p178: CAD file, 2026-11-05]
motor_drrf/Ausgabe/DRRF_K01.step
149.8 x 149.9 x 59.5 mm
Statorblechpaket
Ringspulen (36)
Statortraeger
Achse (feststehend)
Lager 2 x 6004
Rueckschluss aussen
Rueckschluss innen
Magnete aussen (42)
Magnete innen (42)
Rotorglocke
Achsmutter (Lager-Vorspannung)
Befestigung 4 x M6 (D14-Lochkreis 50)
