ITSMEEME/PropBoard/quad_r380_d01/Ausgabe/Einzelteile/QD_K02.step

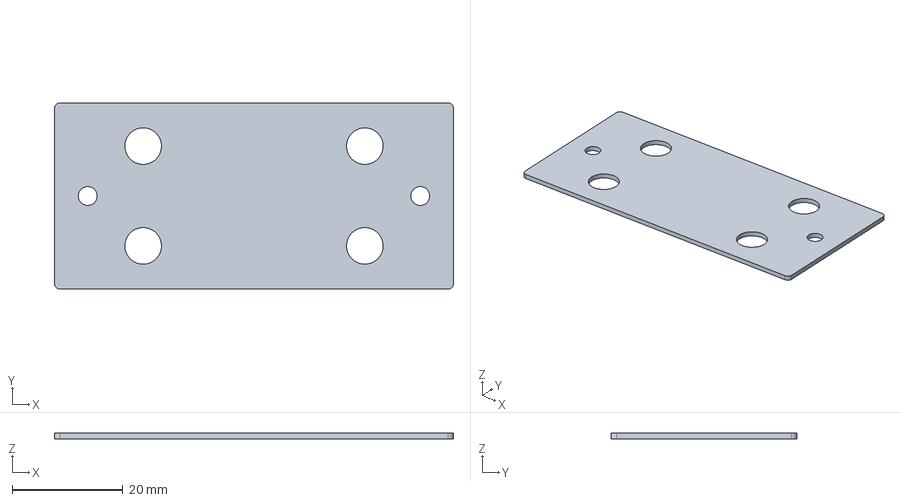
[picture p179: CAD file, 2026-11-04]
quad_r380_d01/Ausgabe/Einzelteile/QD_K02.step
72.0 x 33.6 x 1.00 mm
