ITSMEEME/PropBoard/quad_r380_d01/Ausgabe/QuadR380_D01_Mechanik.step

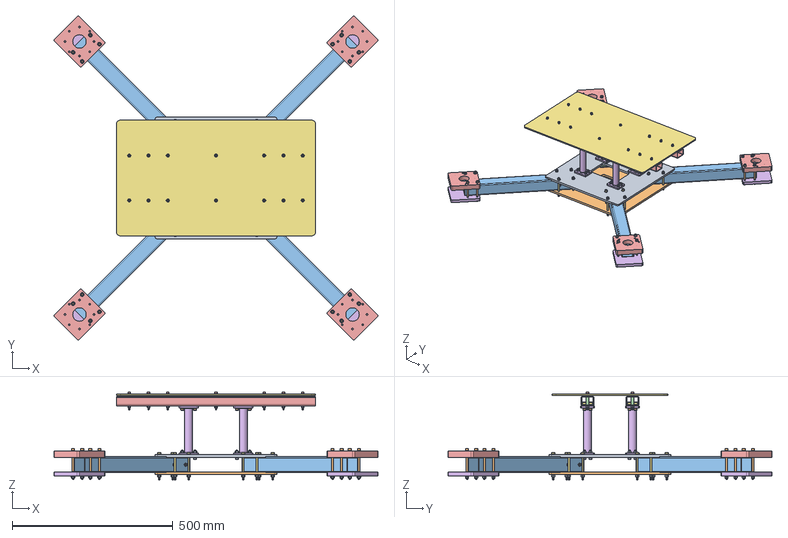
[picture p180: CAD file, 2026-11-04]
quad_r380_d01/Ausgabe/QuadR380_D01_Mechanik.step
1008.4 x 1008.4 x 273.4 mm
Zentralplatte oben
Zentralplatte unten
Ausleger 50×50×3 mit Sicherungsbohrungen x 4
Eingepasstes Wurzel-Druckstueck 43.97×43.97×135 x 4
Ausleger-Endtraeger oben, Projekteigenes IF90 x 4
Ausleger-Endtraeger unten x 4
ISO4762_M6x80 x 16
ISO7089_M6 x 96
ISO7719_M6 x 64
ISO4762_M6x90 x 16
ISO4762_M5x16 x 8
ISO7089_M5 x 36
Decktraeger 40×30×3, Laenge620 x 2
Deckstuetze, aus Vollmaterial gefertigt x 4
Kassette fuer vier ISO7719-M6-Muttern x 4
Kassetten-Abdeckblech x 4
ISO4762_M6x25 x 16
ISO4762_M6x20 x 16
ISO4762_M3x8 x 8
Hut-Druckhuelse fuer Deckverschraubung x 14
ISO4762_M5x50 x 14
ISO7719_M5 x 14
Personendeck 620×360×5
