ITSMEEME/PropBoard/quad_r380_d02/Ausgabe/D02_STAY_TUBE.step

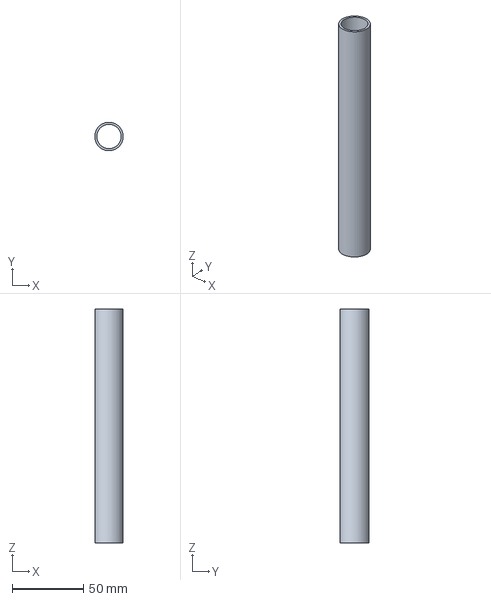
[picture p181: CAD file, 2026-11-04]
quad_r380_d02/Ausgabe/D02_STAY_TUBE.step
20.0 x 20.0 x 164.1 mm
