ITSMEEME/PropBoard/quad_r380_d03/Ausgabe/D02_HIGH_M_P.step

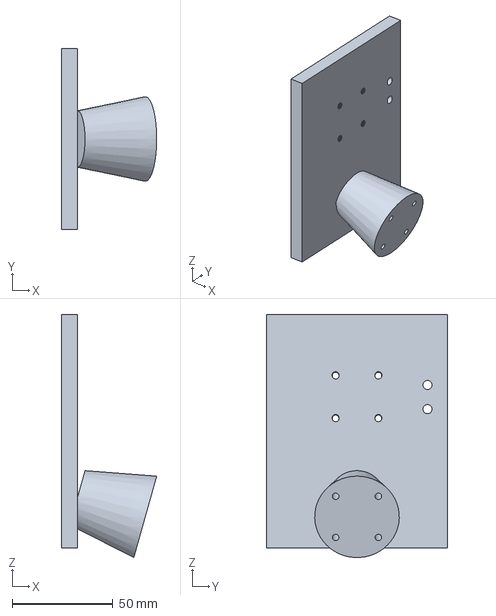
[picture p182: CAD file, 2026-11-04]
quad_r380_d03/Ausgabe/D02_HIGH_M_P.step
47.4 x 90.0 x 120.6 mm
