ITSMEEME/PropBoard/quad_r380_d04/Ausgabe/D04_HIGH_M_P.step

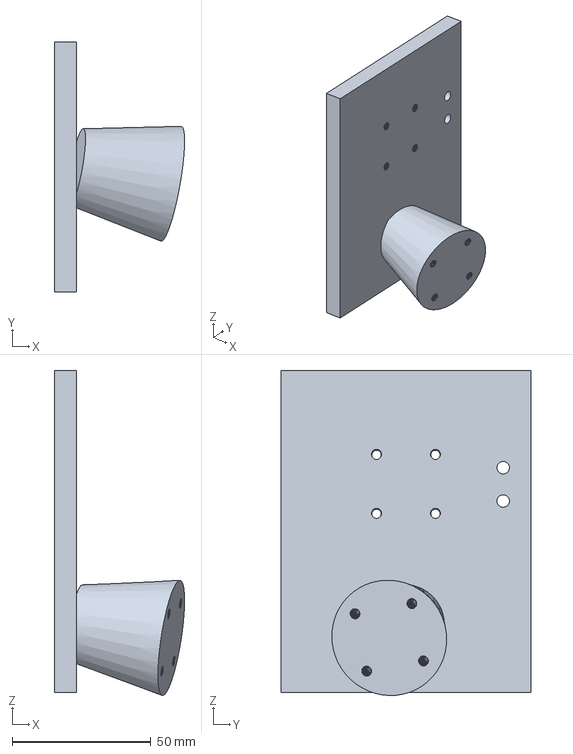
[picture p183: CAD file, 2026-11-04]
quad_r380_d04/Ausgabe/D04_HIGH_M_P.step
46.9 x 90.0 x 117.0 mm
