ITSMEEME/PropBoard/quad_r380_d05/Quellen/MN1330/MN1330.step

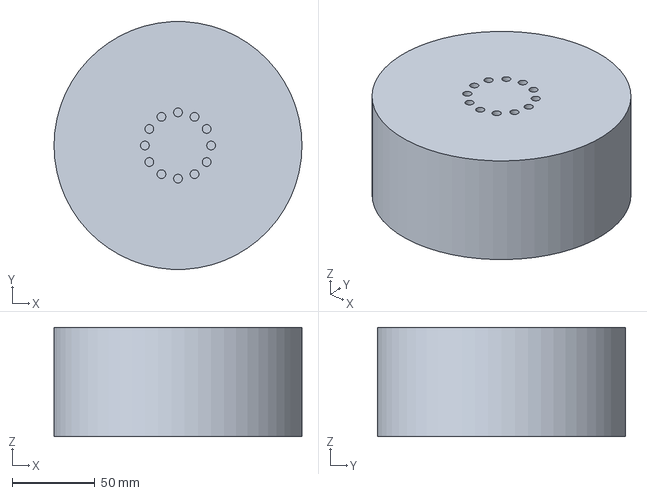
[picture p184: CAD file, 2026-11-01]
quad_r380_d05/Quellen/MN1330/MN1330.step
150.0 x 149.8 x 66.0 mm
