ITSMEEME/PropBoard/quad_r380_d06/Ausgabe/D06_BLADE_CCW.step

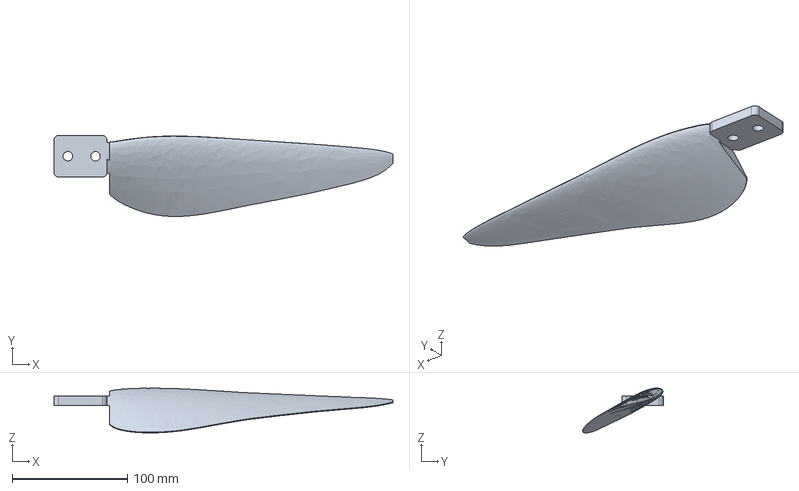
[picture p185: CAD file, 2026-11-04]
quad_r380_d06/Ausgabe/D06_BLADE_CCW.step
294.0 x 70.3 x 38.9 mm
