ITSMEEME/PropBoard/quad_r380_d07/Ausgabe/D07_CLAMP_CAP.step

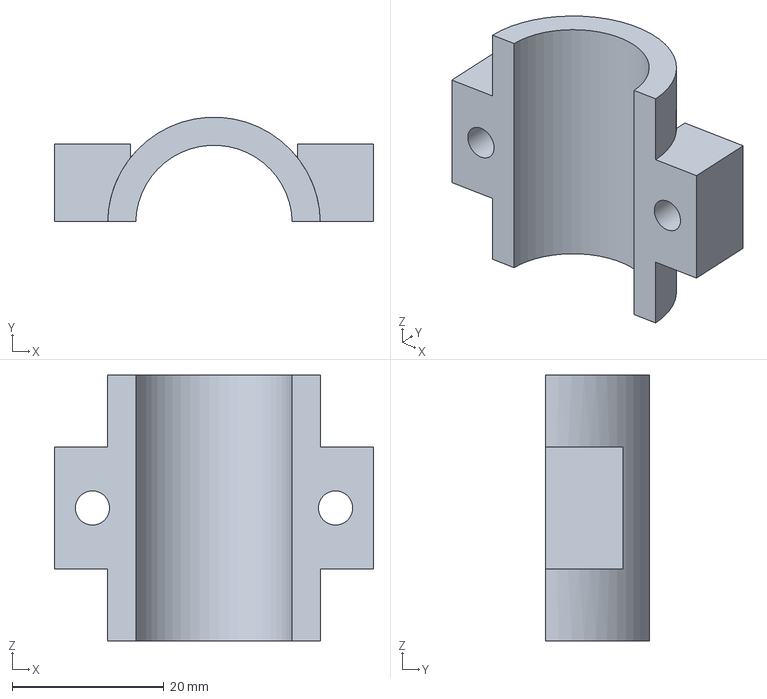
[picture p186: CAD file, 2026-11-04]
quad_r380_d07/Ausgabe/D07_CLAMP_CAP.step
42.0 x 13.7 x 35.0 mm
