ITSMEEME/PropBoard/quad_r380_d09/Ausgabe/Quad_HEPS_Parametrisch.FCStd

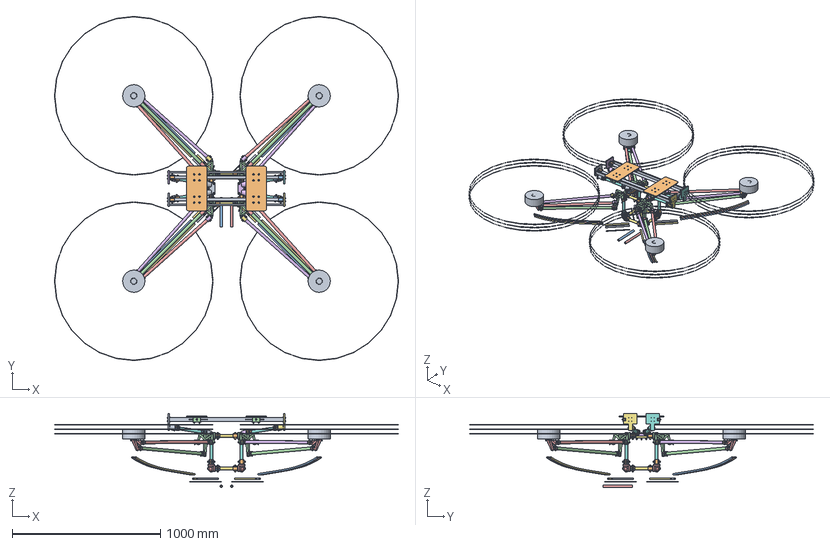
[picture p187: CAD file, 2026-11-04]
quad_r380_d09/Ausgabe/Quad_HEPS_Parametrisch.FCStd
2318.8 x 2318.8 x 500.0 mm
CBU20171005TG Rohrzuschnitt 760 x 2
Fußplatte 300 x 140 x 2
Fußschlitten oben x 4
D03 Unterbacke mit Indexierbügel x 4
Anpassbare Isolierhülse Fußschlitten x 4
ISO10642 M5x50 x 16
ISO7089_M5 x 16
ISO7719_M5 x 16
D08_D04_HIGH_M_M
P12 Rohrklemmhälfte A x 36
P12 Rohrklemmhälfte B x 36
P12 Isolierzwischenlage x 36
ISO4762_M4x16 x 96
D08_D04_HIGH_M_P
D08_D04_HIGH_P_M
D08_D04_HIGH_P_P
Indexierleiste 770 x 24 x 10 x 2
ISO7089_M4 x 8
ISO4762_M6x20 x 4
ISO7089_M6 x 16
Unterer_Kernknoten_Kompakt x 4
ISO4762_M4x10 x 128
CBU20171005TG Zuschnitt 145.061 x 8
CBU20171005TG Zuschnitt 160.0 x 4
Gemeinsamer Carbon-Strebensattel oben -1
Gemeinsamer Carbon-Strebensattel unten -1
Isolierlage Strebensattel x 2
ISO4762_M6x45 x 6
ISO7719_M6 x 6
Gemeinsamer Carbon-Strebensattel oben 1
Gemeinsamer Carbon-Strebensattel unten 1
CBU20171005TG Zuschnitt 210.178 x 4
MN1330 KV40 – Altmodell-Zeichnungsreferenz x 4
ISO4762_M6x12 x 16
P9_Rotorhuelle x 4
P9_V4_Root x 4
P9_V4_Motor x 4
P9_V4_Tube0 x 4
P9_V4_Cap0_root x 4
P9_V4_Liner0_root x 4
P9_V4_Pad0_root x 4
P9_V4_Cap0_motor x 4
P9_V4_Liner0_motor x 4
P9_V4_Pad0_motor x 4
P9_V4_Tube1 x 4
P9_V4_Cap1_root x 4
P9_V4_Liner1_root x 4
P9_V4_Pad1_root x 4
P9_V4_Cap1_motor x 4
P9_V4_Liner1_motor x 4
P9_V4_Pad1_motor x 4
P9_V4_Tube2 x 4
P9_V4_Cap2_root x 4
P9_V4_Liner2_root x 4
P9_V4_Pad2_root x 4
P9_V4_Cap2_motor x 4
P9_V4_Liner2_motor x 4
P9_V4_Pad2_motor x 4
Klemmung_Washer x 96
Klemmung_Bolt x 48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
