ITSMEEME/PropBoard/quad_r380_d13/Ausgabe/Propeller_STEP/HEP_S_28_9_CCW.step

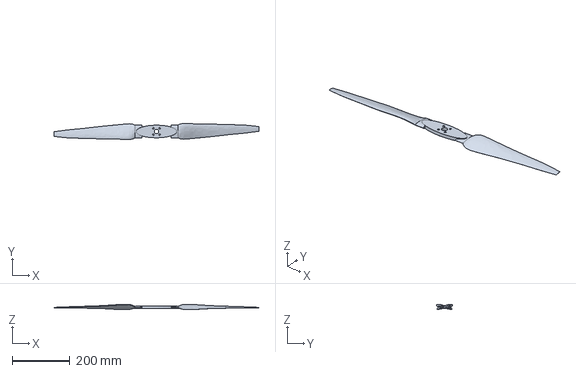
[picture p189: CAD file, 2026-11-04]
quad_r380_d13/Ausgabe/Propeller_STEP/HEP_S_28_9_CCW.step
711.2 x 56.0 x 19.1 mm
