ITSMEEME/PropBoard/quad_r380_varianten/Ausgabe/Quad_Parametrisch_V1_V4.FCStd

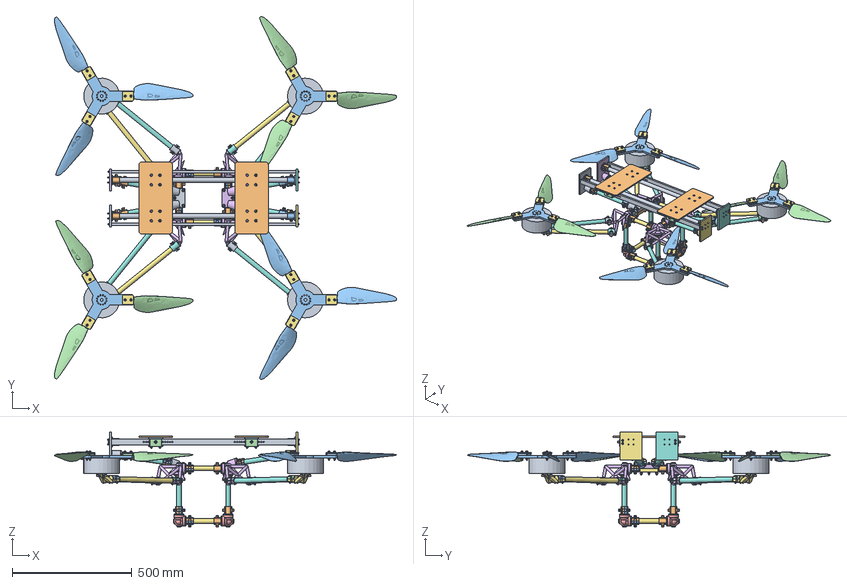
[picture p190: CAD file, 2026-11-04]
quad_r380_varianten/Ausgabe/Quad_Parametrisch_V1_V4.FCStd
1427.2 x 1514.1 x 395.0 mm
CBU20171005TG Rohrzuschnitt 760 x 2
Fußplatte 300 x 140 x 2
Fußschlitten oben x 4
D03 Unterbacke mit Indexierbügel x 4
Anpassbare Isolierhülse Fußschlitten x 4
ISO10642 M5x50 x 16
ISO7089_M5 x 64
ISO7719_M5 x 40
Schienen-Endknoten -1/-1
P12 Rohrklemmhälfte A x 36
P12 Rohrklemmhälfte B x 36
P12 Isolierzwischenlage x 36
ISO4762_M4x16 x 96
Schienen-Endknoten -1/1
Schienen-Endknoten 1/-1
Schienen-Endknoten 1/1
Indexierleiste 770 x 24 x 10 x 2
ISO7089_M4 x 8
ISO4762_M6x20 x 4
ISO7089_M6 x 16
Unterer_Kernknoten_Kompakt x 4
ISO4762_M4x10 x 128
CBU20171005TG Zuschnitt 145.061 x 8
CBU20171005TG Zuschnitt 160.0 x 4
Gemeinsamer Carbon-Strebensattel oben -1
Gemeinsamer Carbon-Strebensattel unten -1
Isolierlage Strebensattel x 2
ISO4762_M6x45 x 6
ISO7719_M6 x 6
Gemeinsamer Carbon-Strebensattel oben 1
Gemeinsamer Carbon-Strebensattel unten 1
CBU20171005TG Zuschnitt 210.178 x 4
MN1330 KV40 – Altmodell-Zeichnungsreferenz x 4
ISO4762_M6x12 x 16
Dreiblatt-Nabe mit 12×M5/PCD40 x 4
R380 CCW CFK-Blatt mit Wurzel, Haut und Stegen x 6
R380 CCW Schaumkern 1 x 6
R380 CCW Schaumkern 2 x 6
Blattwurzel-Klemmplatte 46×40×6 x 12
Blattwurzel-Druckhülse Ø8/5,5×8 x 24
Wurzelhülsen-Klebschicht radial 0,1 mm x 24
ISO4762_M5x35 x 24
R380 CW CFK-Blatt mit Wurzel, Haut und Stegen x 6
R380 CW Schaumkern 1 x 6
R380 CW Schaumkern 2 x 6
V3_Root x 4
V3_Motor x 4
V3_Tube0 x 4
V3_Cap0_root x 4
V3_Liner0_root x 4
V3_Pad0_root x 4
V3_Cap0_motor x 4
V3_Liner0_motor x 4
V3_Pad0_motor x 4
V3_Tube1 x 4
V3_Cap1_root x 4
V3_Liner1_root x 4
V3_Pad1_root x 4
V3_Cap1_motor x 4
V3_Liner1_motor x 4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
