ITSMEEME/PropBoard/vergleich_horizontal/Horizontal_Z_gegenlaeufig.step

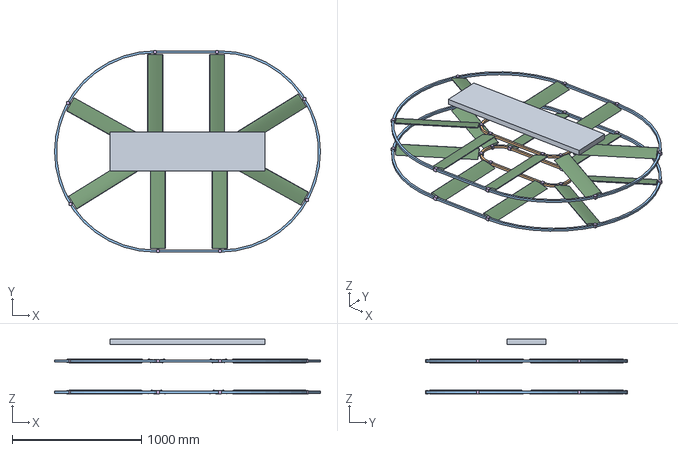
[picture p191: CAD file, 2026-10-29]
vergleich_horizontal/Horizontal_Z_gegenlaeufig.step
2056.0 x 1564.0 x 422.5 mm
