ITSMEEME/PropBoard/cad/Hexacopter_Tattu41000_8Packs.FCStd

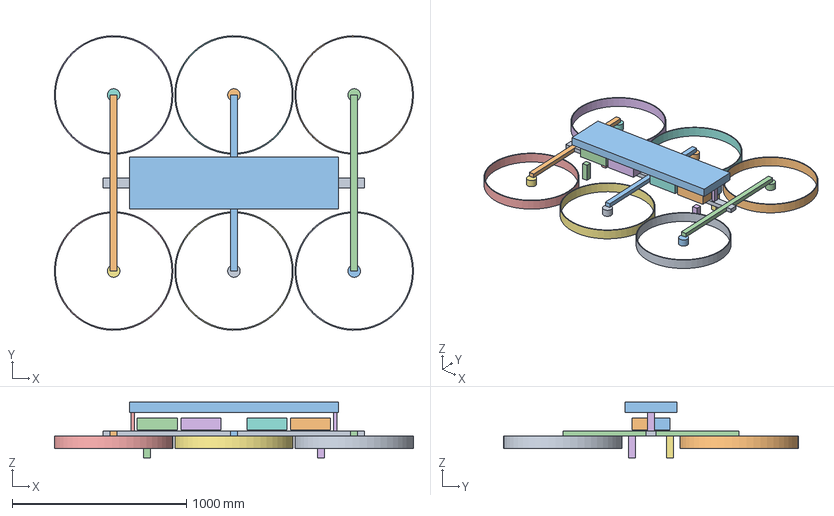
[picture p192: CAD file, 2026-10-29]
cad/Hexacopter_Tattu41000_8Packs.FCStd
2059.4 x 1689.7 x 320.0 mm
Laengstraeger
Quertraeger0
Quertraeger1
Quertraeger2
Deckstuetze0
Deckstuetze1
Motor00
Motor01
Motor10
Motor11
Motor20
Motor21
Ring00
Ring01
Ring10
Ring11
Ring20
Ring21
Standdeck
Tattu_0_0
Tattu_0_1
Tattu_1_0
Tattu_1_1
Tattu_2_0
Tattu_2_1
Tattu_3_0
Tattu_3_1
Landefuss0
Landefuss1
Landefuss2
Landefuss3
