ITSMEEME/PropBoard/entwicklung_ab/Ausgabe/P14_R800/P14_R800.FCStd

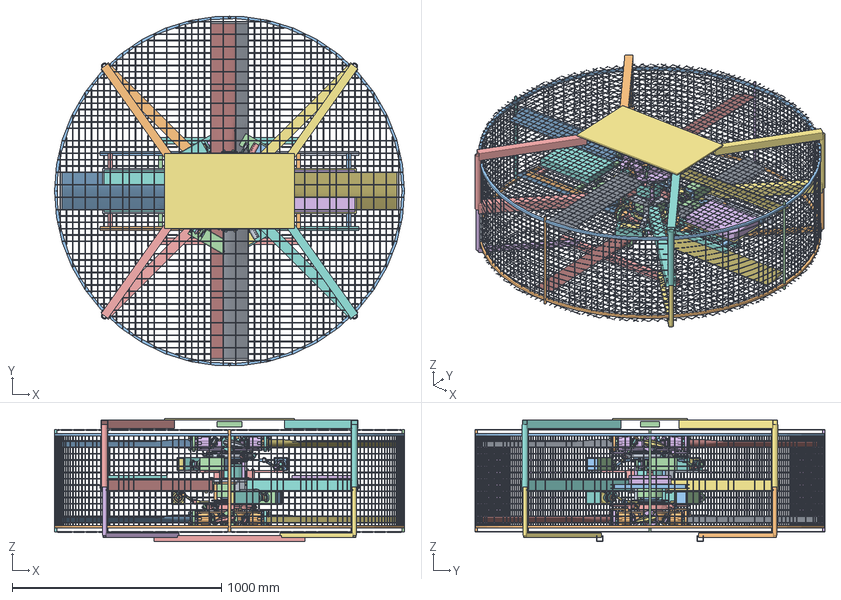
[picture p194: CAD file, 2026-11-02]
entwicklung_ab/Ausgabe/P14_R800/P14_R800.FCStd
1674.0 x 1673.9 x 589.0 mm
+1 Zentralblock
+1 Zentralanker_67.1751_67.1751
+1 Zentralankermutter_67.1751_67.1751_-101
+1 Zentralankermutter_67.1751_67.1751_96
+1 Zentralanker_-67.1751_67.1751
+1 Zentralankermutter_-67.1751_67.1751_-101
+1 Zentralankermutter_-67.1751_67.1751_96
+1 Zentralanker_-67.1751_-67.1751
+1 Zentralankermutter_-67.1751_-67.1751_-101
+1 Zentralankermutter_-67.1751_-67.1751_96
+1 Zentralanker_67.1751_-67.1751
+1 Zentralankermutter_67.1751_-67.1751_-101
+1 Zentralankermutter_67.1751_-67.1751_96
+1 A01
+1 A03
+1 MN1330
+1 A05
+1 A06O
+1 Hauptlagerbefestigung_59_0
+1 Hauptlagerdeckelbolzen_59_0
+1 Hauptlagerbefestigung_3.61271e-15_59
+1 Hauptlagerdeckelbolzen_3.61271e-15_59
+1 Hauptlagerbefestigung_-59_7.22542e-15
+1 Hauptlagerdeckelbolzen_-59_7.22542e-15
+1 Hauptlagerbefestigung_-1.08381e-14_-59
+1 Hauptlagerdeckelbolzen_-1.08381e-14_-59
+1 A02_67.1751_67.1751
+1 A02_-67.1751_67.1751
+1 A02_-67.1751_-67.1751
+1 A02_67.1751_-67.1751
+1 Statormotorbolzen_25_0
+1 Statormotorbolzen_1.53081e-15_25
+1 Statormotorbolzen_-25_3.06162e-15
+1 Statormotorbolzen_-4.59243e-15_-25
+1 Rotormotorbolzen_20_0
+1 Rotormotorbolzen_17.3205_10
+1 Rotormotorbolzen_10_17.3205
+1 Rotormotorbolzen_1.22465e-15_20
+1 Rotormotorbolzen_-10_17.3205
+1 Rotormotorbolzen_-17.3205_10
+1 Rotormotorbolzen_-20_2.44929e-15
+1 Rotormotorbolzen_-17.3205_-10
+1 Rotormotorbolzen_-10_-17.3205
+1 Rotormotorbolzen_-3.67394e-15_-20
+1 Rotormotorbolzen_10_-17.3205
+1 Rotormotorbolzen_17.3205_-10
+1 Rotornabenbolzen_48_0
+1 Rotornabenbolzen_24_41.5692
+1 Rotornabenbolzen_-24_41.5692
+1 Rotornabenbolzen_-48_5.8783e-15
+1 Rotornabenbolzen_-24_-41.5692
+1 Rotornabenbolzen_24_-41.5692
+1 Hauptlager98
+1 Hauptlager126
+1 A04
+1 A04F
+1 A04W
+1 A04N
+1 A07
+1 A08W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
