ITSMEEME/PropBoard/horizontal_z_r02/03_Batterie_R02_Detail.step

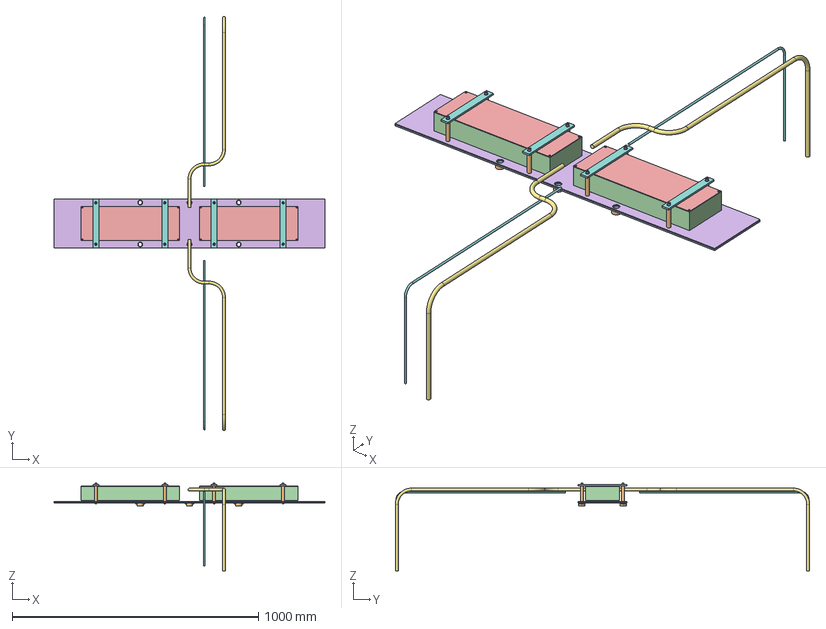
[picture p195: CAD file, 2026-10-29]
horizontal_z_r02/03_Batterie_R02_Detail.step
1100.0 x 1682.0 x 356.5 mm
