ITSMEEME/PropBoard/konstruktion/04_Ergonomie_Sitzen.step

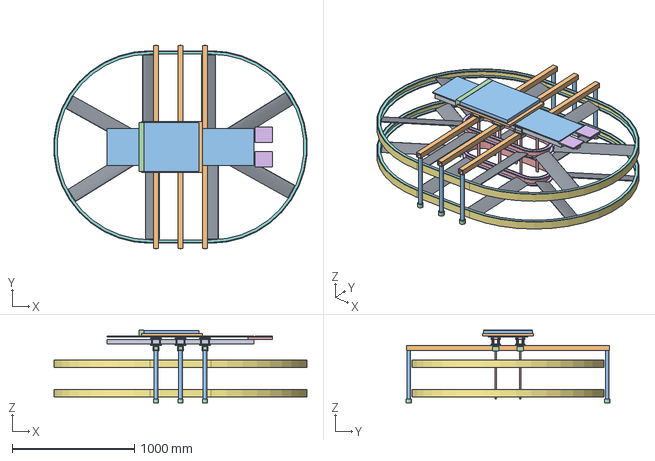
[picture p196: CAD file, 2026-10-29]
konstruktion/04_Ergonomie_Sitzen.step
2066.6 x 1663.7 x 595.0 mm
