ITSMEEME/PropBoard/kreis_r04/Kreis_R04_ohne_Aussenring.step

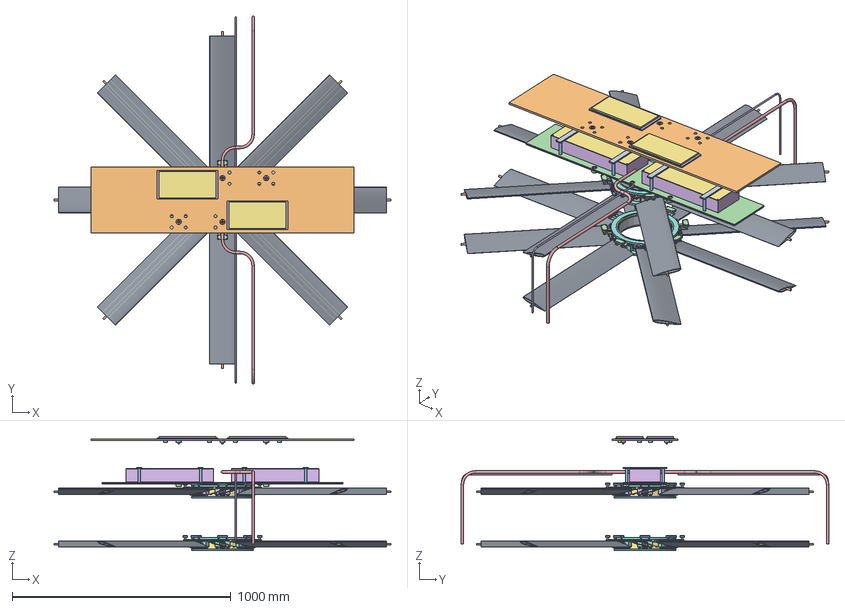
[picture p197: CAD file, 2026-10-30]
kreis_r04/Kreis_R04_ohne_Aussenring.step
1540.0 x 1681.9 x 523.0 mm
