ITSMEEME/PropBoard/kreis_r04/mn1330_p12/Ausgabe/Referenz_STEP/REF-SCHRAUBE-M3-L8-K2.4.step

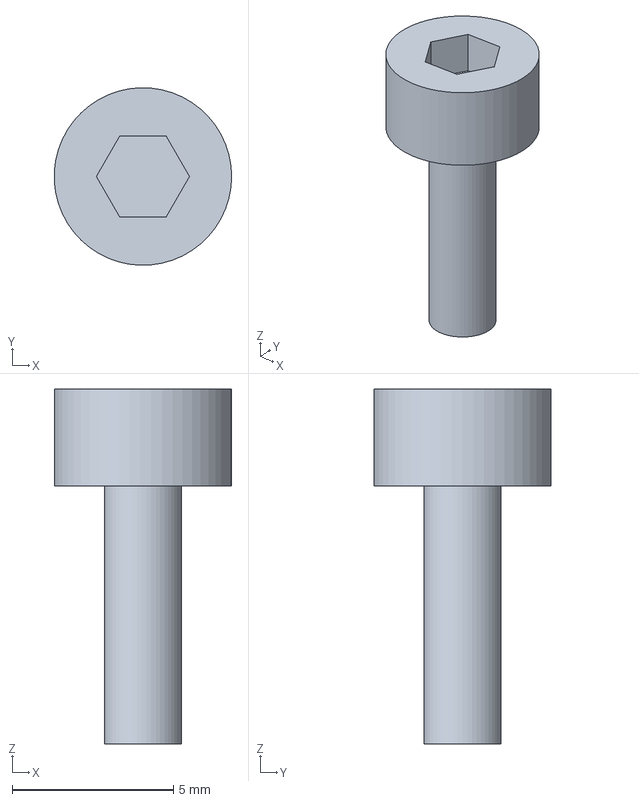
[picture p198: CAD file, 2026-11-01]
kreis_r04/mn1330_p12/Ausgabe/Referenz_STEP/REF-SCHRAUBE-M3-L8-K2.4.step
5.49 x 5.50 x 11.0 mm
