ITSMEEME/PropBoard/kreis_r04/mn1330_p12/Ausgabe/STL/REF-SCHRAUBE-M4-L14-K3.2.stl

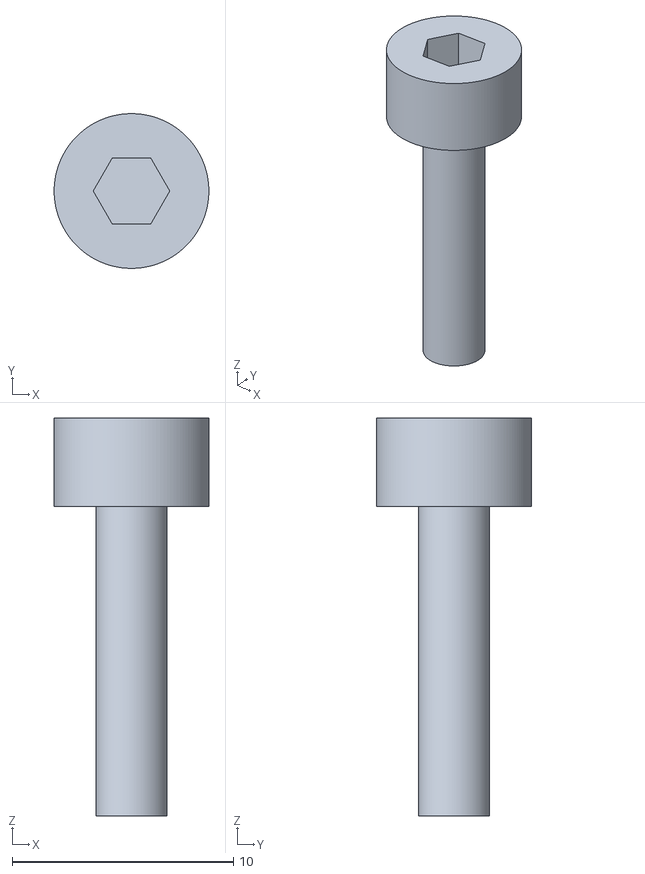
[picture p199: CAD file, 2026-11-01]
kreis_r04/mn1330_p12/Ausgabe/STL/REF-SCHRAUBE-M4-L14-K3.2.stl
7.00 x 7.00 x 18.0
