ITSMEEME/PropBoard/kreis_r04/mn1330_p12/Varianten/Aluminium/STEP/P12-004_MZ.step

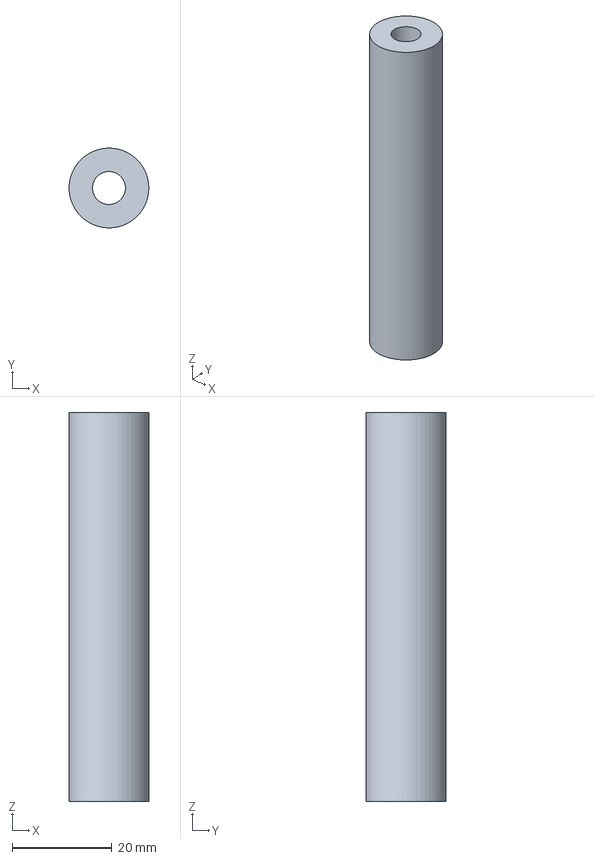
[picture p200: CAD file, 2026-11-01]
kreis_r04/mn1330_p12/Varianten/Aluminium/STEP/P12-004_MZ.step
16.0 x 16.0 x 78.0 mm
