ITSMEEME/PropBoard/kreis_r04/mn1330_p12/Varianten/Aluminium/STL/REF-7202B.stl

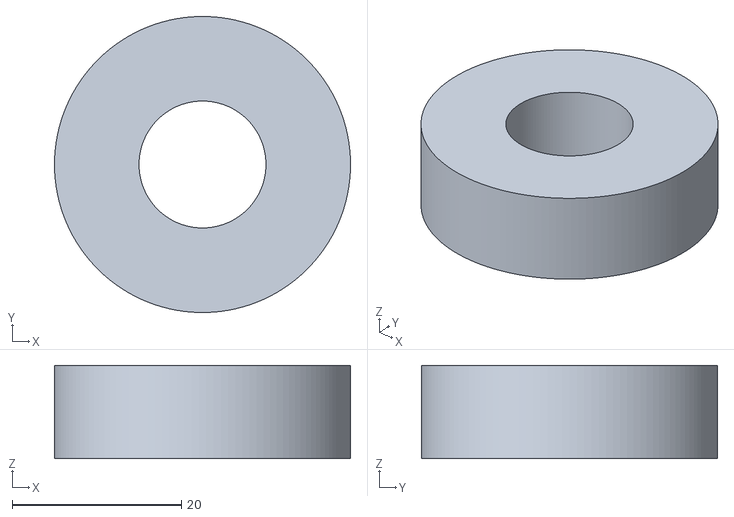
[picture p201: CAD file, 2026-11-01]
kreis_r04/mn1330_p12/Varianten/Aluminium/STL/REF-7202B.stl
35.0 x 35.0 x 11.0
