ITSMEEME/PropBoard/kreis_r04/mn1330_p13/Ausgabe/STEP_Nennkonturen/STD-7001B.step

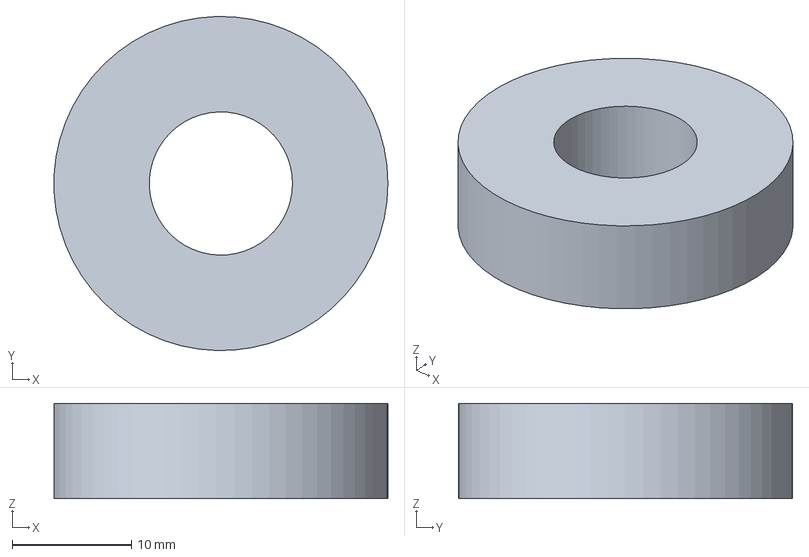
[picture p202: CAD file, 2026-11-01]
kreis_r04/mn1330_p13/Ausgabe/STEP_Nennkonturen/STD-7001B.step
28.0 x 28.0 x 8.00 mm
