ITSMEEME/PropBoard/kreis_r04/mn1330_p13/Ausgabe/STEP_Sonderteile/CFK-ROHR-006.step

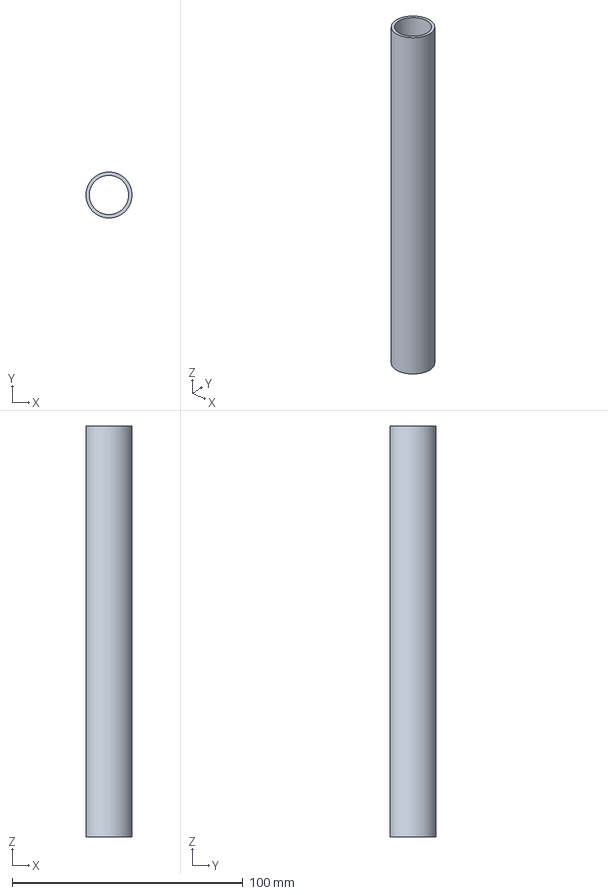
[picture p203: CAD file, 2026-11-01]
kreis_r04/mn1330_p13/Ausgabe/STEP_Sonderteile/CFK-ROHR-006.step
20.0 x 20.0 x 178.2 mm
