ITSMEEME/PropBoard/kreis_r04/mn1330_p13/Ausgabe/STL/STD-ISO7089-M6-GELENK.stl

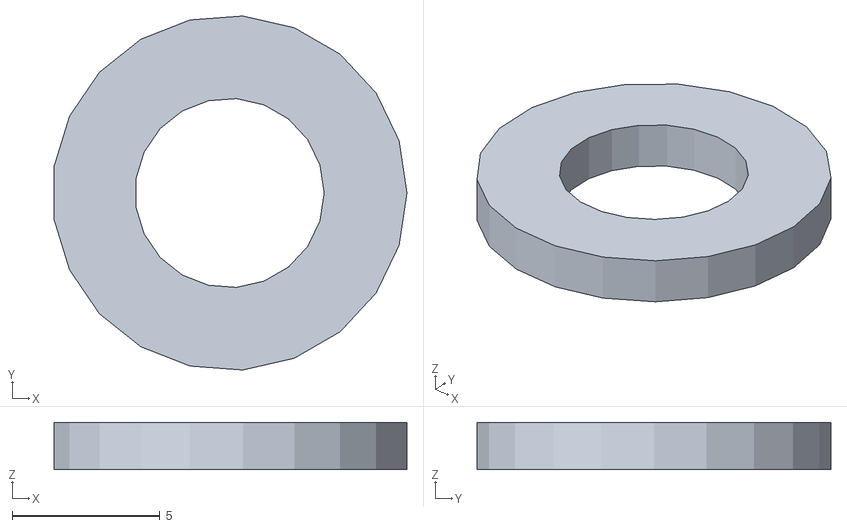
[picture p204: CAD file, 2026-11-01]
kreis_r04/mn1330_p13/Ausgabe/STL/STD-ISO7089-M6-GELENK.stl
11.9 x 12.0 x 1.60
