ITSMEEME/PropBoard/kreis_r04/mn1330_p14/Ausgabe/STEP_Referenzen/B7205.step

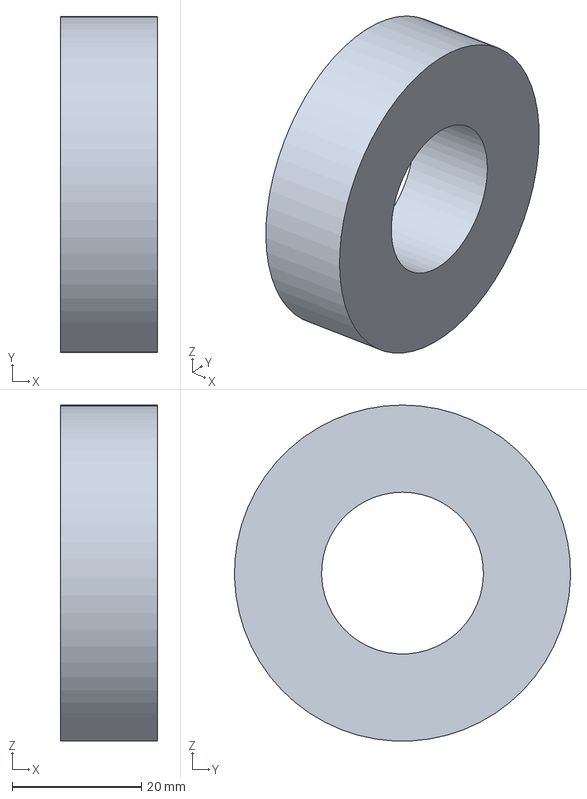
[picture p205: CAD file, 2026-11-01]
kreis_r04/mn1330_p14/Ausgabe/STEP_Referenzen/B7205.step
15.0 x 52.0 x 52.0 mm
