ITSMEEME/PropBoard/kreis_r04/mn1330_p14/Ausgabe/STL_Nenngeometrie/A06O.stl

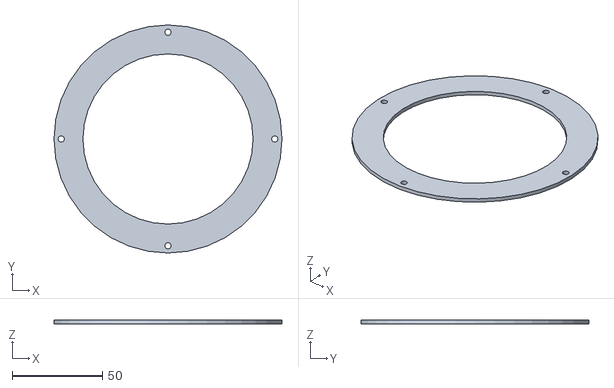
[picture p206: CAD file, 2026-11-01]
kreis_r04/mn1330_p14/Ausgabe/STL_Nenngeometrie/A06O.stl
126.0 x 126.0 x 2.00
