ITSMEEME/PropBoard/modell_r04/cad/stl/Zahnkranz_91Z_m1.stl

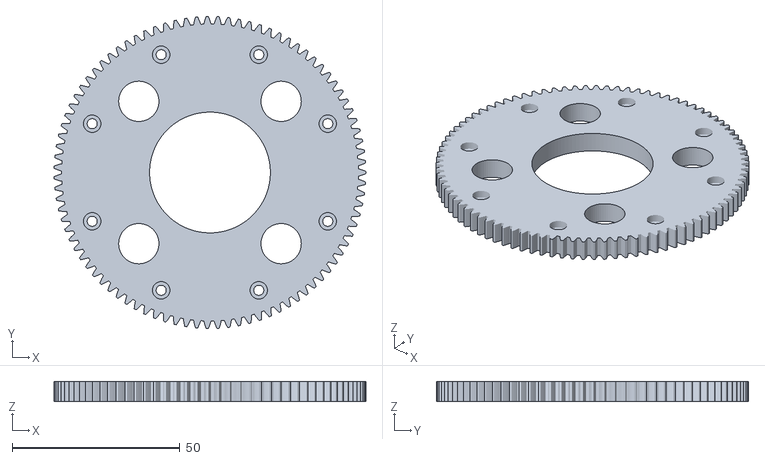
[picture p207: CAD file, 2026-10-30]
modell_r04/cad/stl/Zahnkranz_91Z_m1.stl
93.0 x 93.0 x 6.00
