ITSMEEME/PropBoard/modell_r04/cad/vorschau/Feststehend_Druck.stl

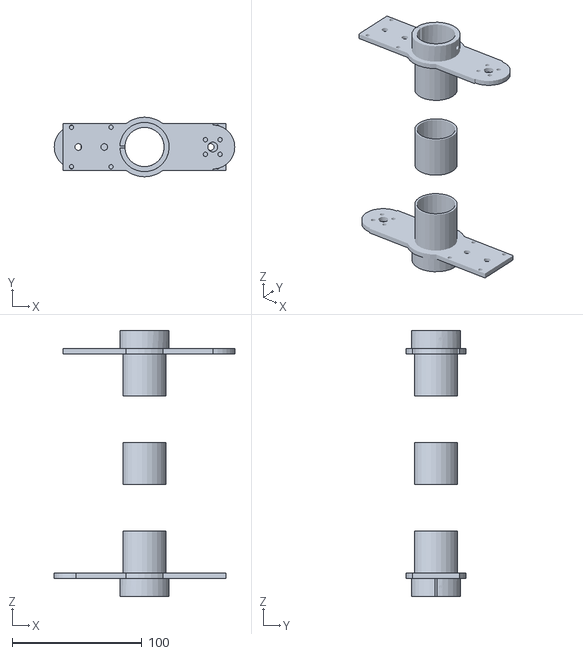
[picture p208: CAD file, 2026-10-30]
modell_r04/cad/vorschau/Feststehend_Druck.stl
139.2 x 46.0 x 205.0
