ITSMEEME/PropBoard/modell_r04_taumel/bewegung_p09/Ausgabe/Pitchhebel_oben.step

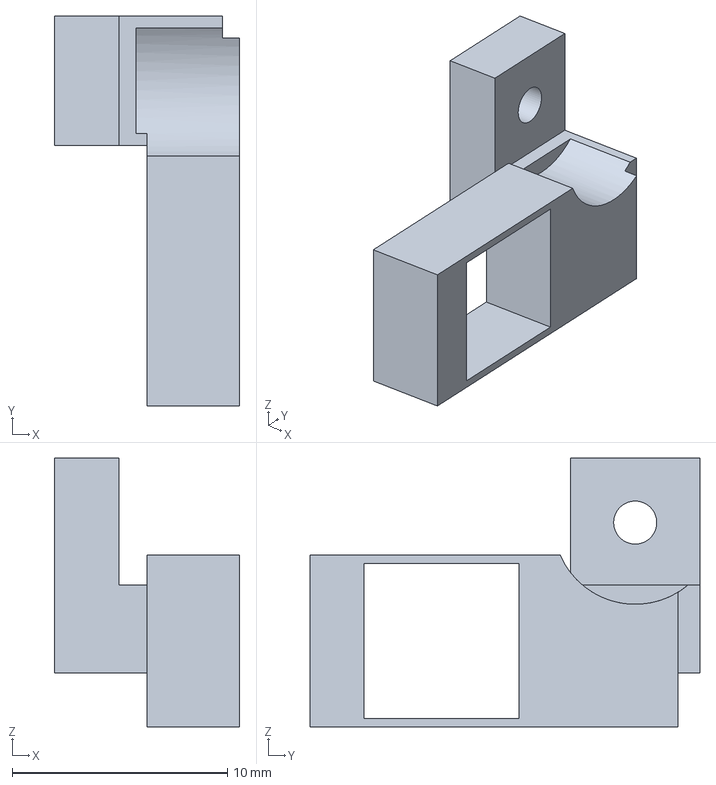
[picture p209: CAD file, 2026-10-30]
modell_r04_taumel/bewegung_p09/Ausgabe/Pitchhebel_oben.step
8.60 x 18.1 x 12.5 mm
