ITSMEEME/PropBoard/modell_r04_taumel/cad/Fertigung/Einzelteile/TM-08_Halteplatte.FCStd

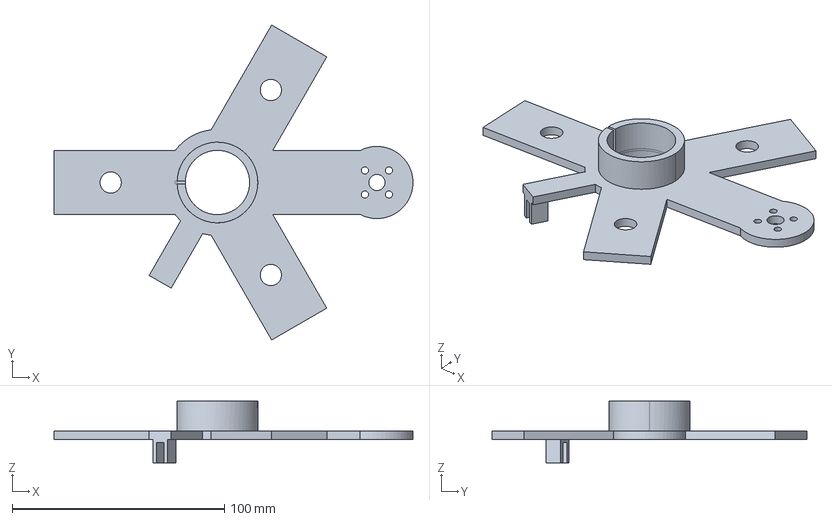
[picture p210: CAD file, 2026-10-30]
modell_r04_taumel/cad/Fertigung/Einzelteile/TM-08_Halteplatte.FCStd
169.1 x 148.4 x 29.0 mm
