ITSMEEME/PropBoard/modell_r04_taumel/cad/Fertigung/STEP/TM-07_Taumel_Drehring.step

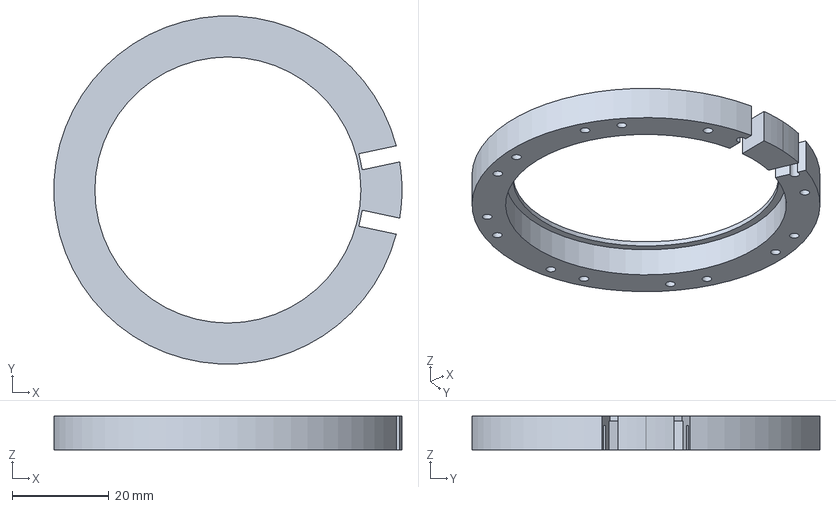
[picture p211: CAD file, 2026-10-30]
modell_r04_taumel/cad/Fertigung/STEP/TM-07_Taumel_Drehring.step
72.0 x 71.9 x 7.00 mm
