ITSMEEME/PropBoard/modell_r04_taumel/cad/stl/Pitchhebel.stl

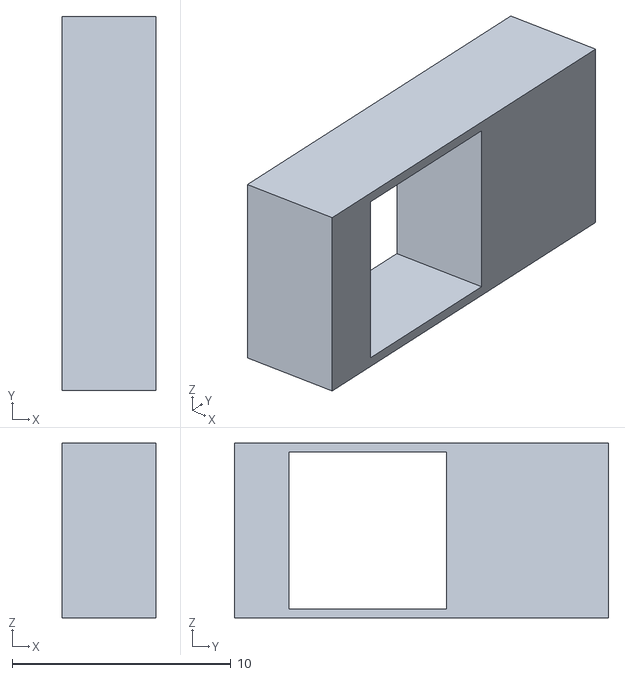
[picture p212: CAD file, 2026-10-30]
modell_r04_taumel/cad/stl/Pitchhebel.stl
4.30 x 17.1 x 8.00
