ITSMEEME/PropBoard/modell_r04_taumel/cad/vorschau/Mitte_Druck.stl

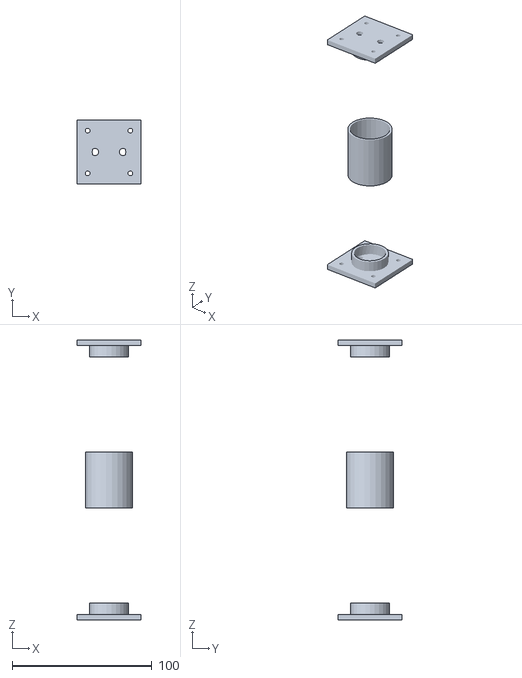
[picture p213: CAD file, 2026-10-30]
modell_r04_taumel/cad/vorschau/Mitte_Druck.stl
46.0 x 46.0 x 200.0
