ITSMEEME/PropBoard/modell_r04_taumel/fertigung_p02/Ausgabe/P02_Normteilkatalog.FCStd

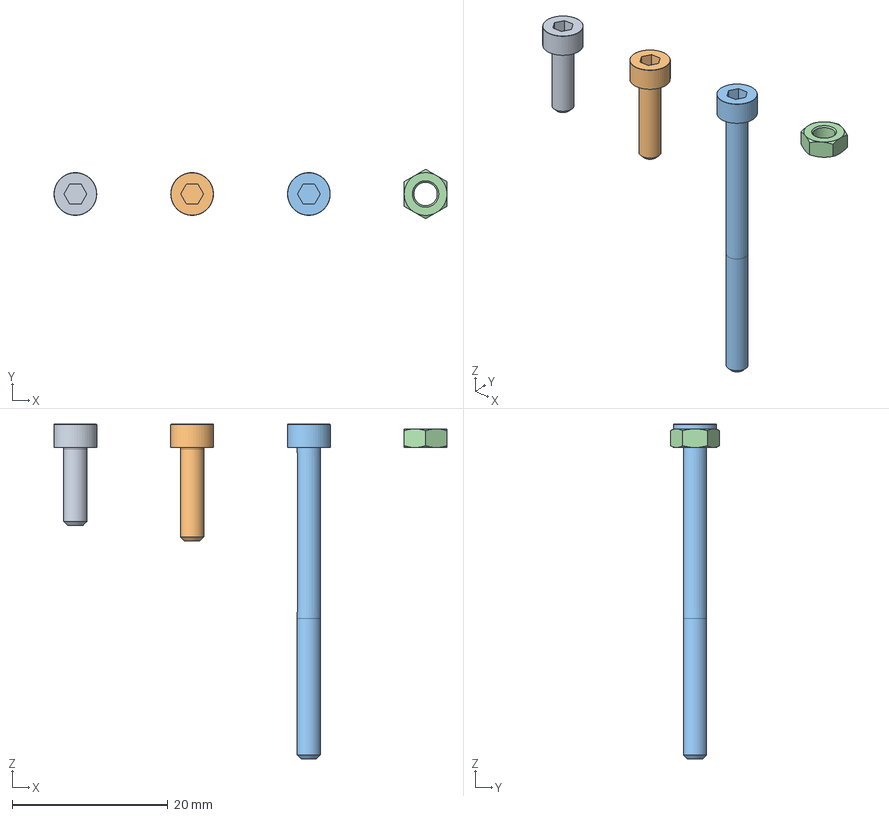
[picture p214: CAD file, 2026-10-30]
modell_r04_taumel/fertigung_p02/Ausgabe/P02_Normteilkatalog.FCStd
50.5 x 6.35 x 43.0 mm
N01_M3x10
N02_M3x12
N03_M3x40
N04_Mutter_M3
