ITSMEEME/PropBoard/modell_r04_taumel/fertigung_p04/Ausgabe/Nur_Motorbohrbild_P04_PCD16_ENTWURF.dxf

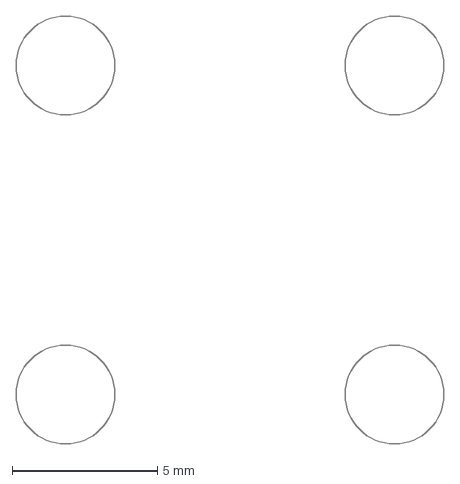
[picture p215: CAD file, 2026-10-30]
modell_r04_taumel/fertigung_p04/Ausgabe/Nur_Motorbohrbild_P04_PCD16_ENTWURF.dxf
14.7 x 14.7 mm
