ITSMEEME/PropBoard/modell_r04_taumel/fertigung_p05/Ausgabe/Ritzel_M1_Z20_M5.step

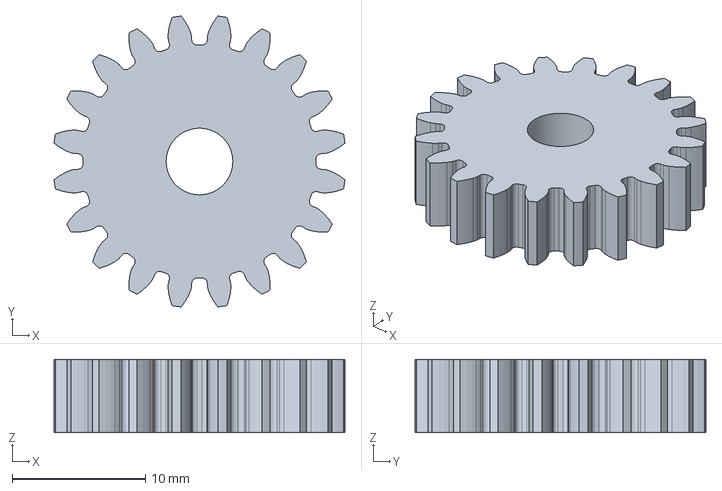
[picture p216: CAD file, 2026-10-30]
modell_r04_taumel/fertigung_p05/Ausgabe/Ritzel_M1_Z20_M5.step
21.8 x 21.8 x 5.50 mm
