ITSMEEME/PropBoard/modell_r04_taumel/fertigung_p08/Ausgabe/rod_lower.step

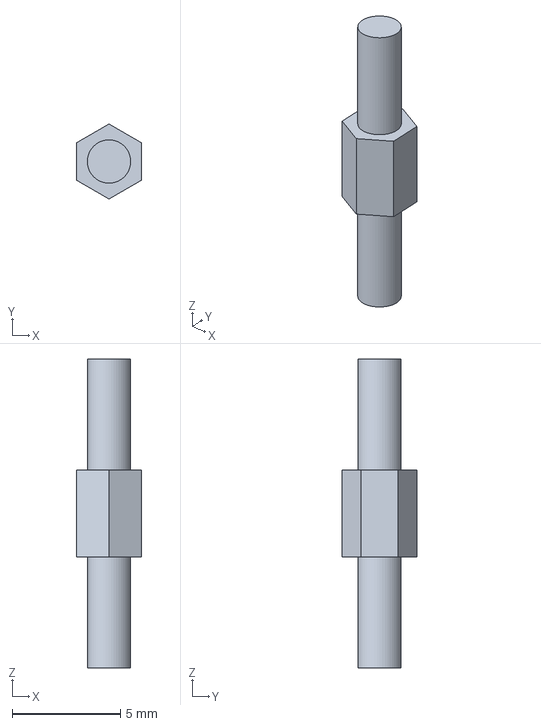
[picture p217: CAD file, 2026-10-30]
modell_r04_taumel/fertigung_p08/Ausgabe/rod_lower.step
3.00 x 3.46 x 14.3 mm
