ITSMEEME/PropBoard/modell_r04_taumel/halterungen/Ausgabe/Einzelteile/H02_ESC_Distanz_12.FCStd

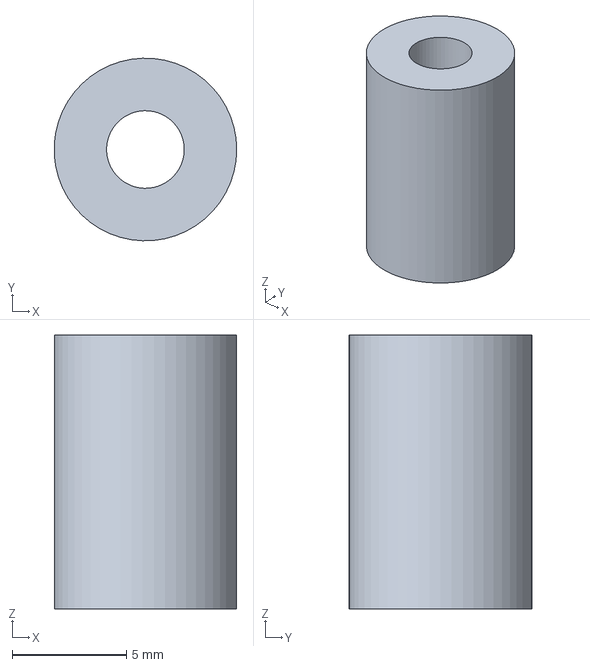
[picture p218: CAD file, 2026-10-30]
modell_r04_taumel/halterungen/Ausgabe/Einzelteile/H02_ESC_Distanz_12.FCStd
7.99 x 8.00 x 12.0 mm
