ITSMEEME/PropBoard/modell_r04_taumel/integration_p10/Ausgabe/STEP/H04_P10.step

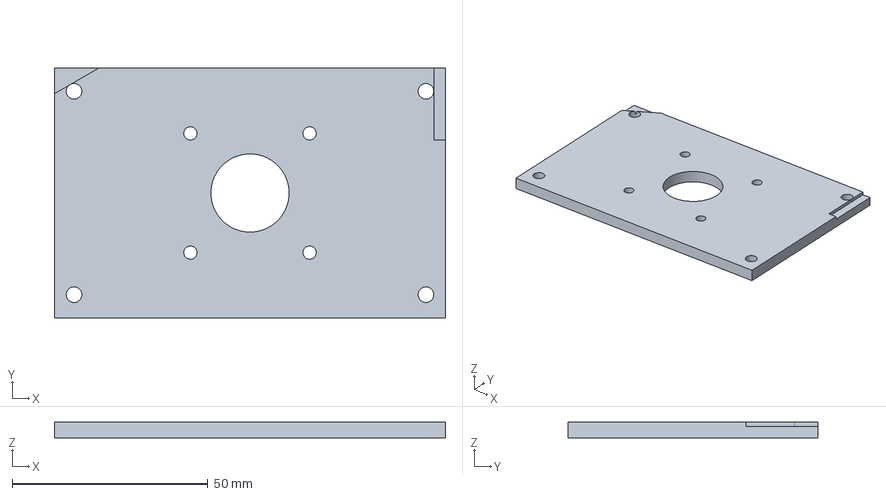
[picture p219: CAD file, 2026-10-31]
modell_r04_taumel/integration_p10/Ausgabe/STEP/H04_P10.step
100.0 x 64.0 x 4.00 mm
