ITSMEEME/PropBoard/modell_r04_taumel/integration_p11/Ausgabe/STEP/P11_MR85_Unten_2_1.step

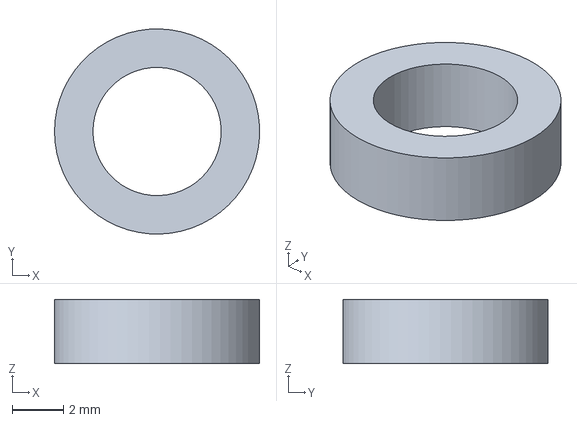
[picture p220: CAD file, 2026-11-01]
modell_r04_taumel/integration_p11/Ausgabe/STEP/P11_MR85_Unten_2_1.step
7.99 x 8.00 x 2.50 mm
