ITSMEEME/PropBoard/quad_r380_d01/Ausgabe/Einzelteile/QD_D01.step

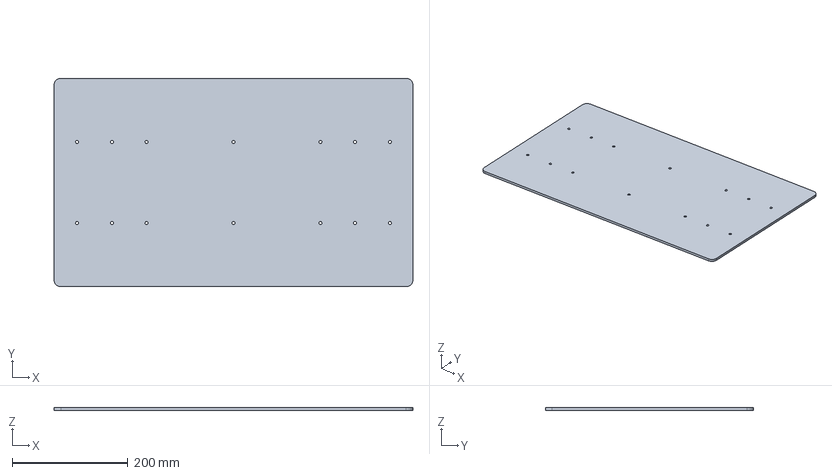
[picture p221: CAD file, 2026-11-04]
quad_r380_d01/Ausgabe/Einzelteile/QD_D01.step
620.0 x 360.0 x 5.00 mm
