ITSMEEME/PropBoard/quad_r380_d03/Ausgabe/D02_FOOT.step

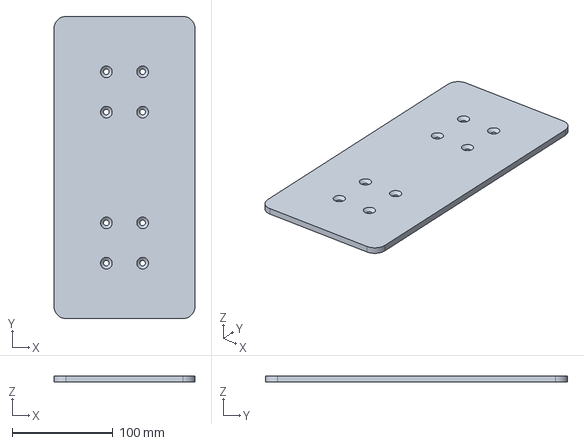
[picture p223: CAD file, 2026-11-04]
quad_r380_d03/Ausgabe/D02_FOOT.step
140.0 x 300.0 x 6.00 mm
