ITSMEEME/PropBoard/quad_r380_d04/Ausgabe/D04_SADDLE_TOP_M1.step

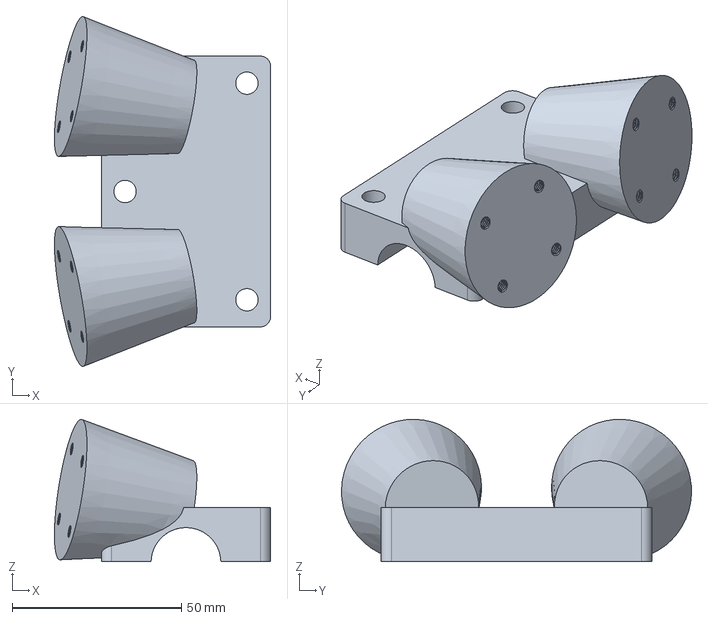
[picture p224: CAD file, 2026-11-04]
quad_r380_d04/Ausgabe/D04_SADDLE_TOP_M1.step
63.9 x 103.4 x 42.0 mm
