ITSMEEME/PropBoard/quad_r380_d05/Ausgabe/D05_MOTOR_PLATE.step

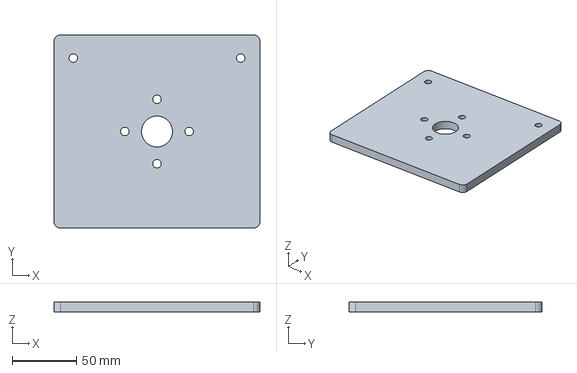
[picture p225: CAD file, 2026-11-04]
quad_r380_d05/Ausgabe/D05_MOTOR_PLATE.step
160.0 x 150.0 x 8.00 mm
