ITSMEEME/PropBoard/quad_r380_d06/Ausgabe/D06_CORE_1_CW.step

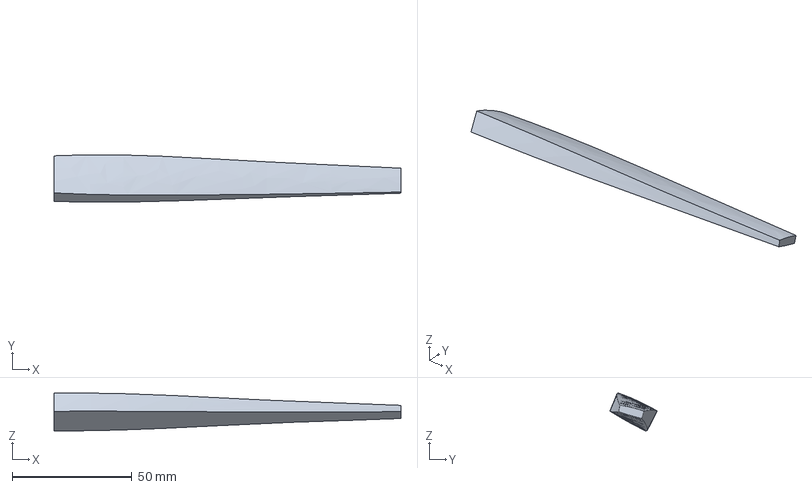
[picture p226: CAD file, 2026-11-04]
quad_r380_d06/Ausgabe/D06_CORE_1_CW.step
145.0 x 19.8 x 15.8 mm
