ITSMEEME/PropBoard/quad_r380_d07/Ausgabe/D07_END_PAD.step

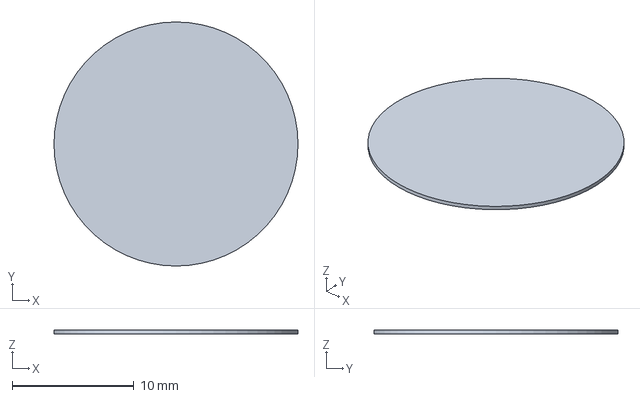
[picture p227: CAD file, 2026-11-04]
quad_r380_d07/Ausgabe/D07_END_PAD.step
20.0 x 20.0 x 0.3 mm
