ITSMEEME/PropBoard/quad_r380_d13/Ausgabe/Propeller_STEP/HEP_S_22_7p2_CCW.step

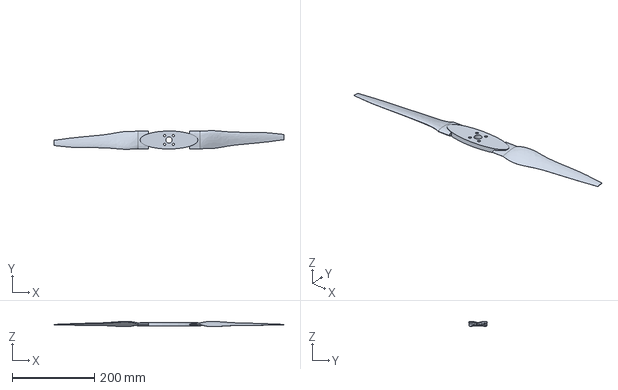
[picture p228: CAD file, 2026-11-04]
quad_r380_d13/Ausgabe/Propeller_STEP/HEP_S_22_7p2_CCW.step
558.8 x 45.4 x 13.0 mm
