ITSMEEME/PropBoard/cad/Hexacopter_650_Konzept.FCStd

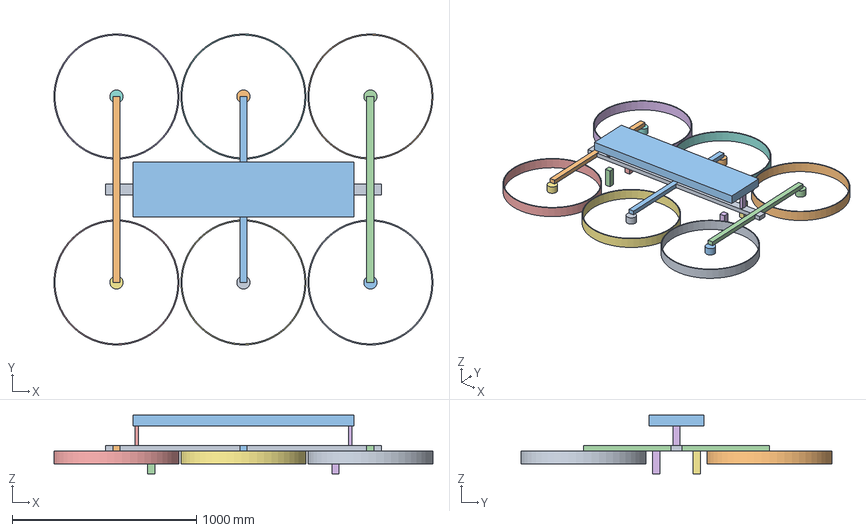
[picture p229: CAD file, 2026-10-29]
cad/Hexacopter_650_Konzept.FCStd
2059.4 x 1689.7 x 320.0 mm
Laengstraeger
Quertraeger0
Quertraeger1
Quertraeger2
Deckstuetze0
Deckstuetze1
Motor00
Motor01
Motor10
Motor11
Motor20
Motor21
Ring00
Ring01
Ring10
Ring11
Ring20
Ring21
Standdeck
Landefuss0
Landefuss1
Landefuss2
Landefuss3
