ITSMEEME/PropBoard/horizontal_z_r02/04_Referenzzeichnungen_R02.FCStd

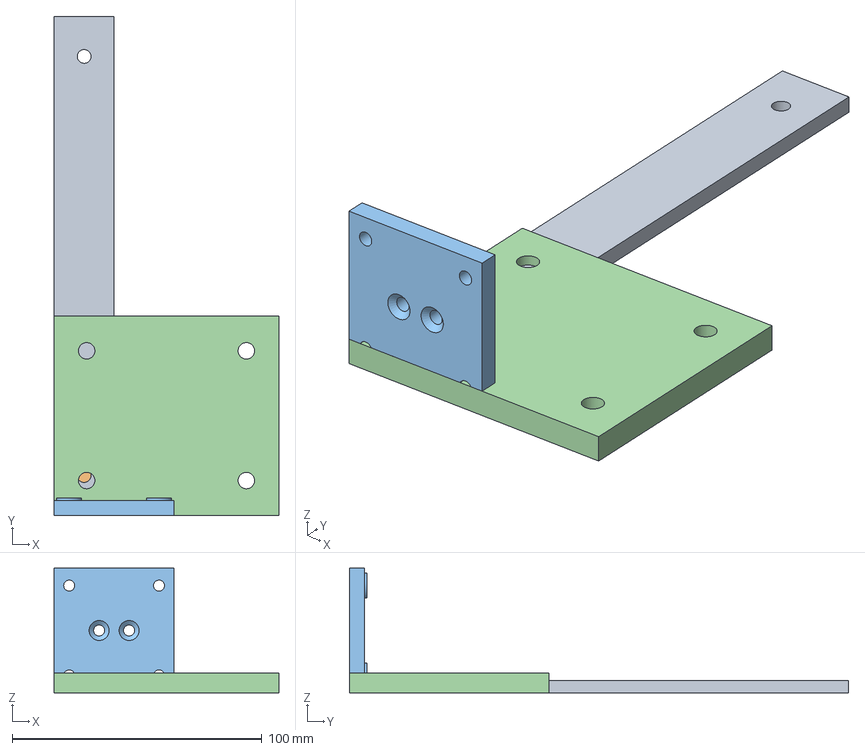
[picture p230: CAD file, 2026-10-29]
horizontal_z_r02/04_Referenzzeichnungen_R02.FCStd
90.0 x 200.0 x 50.0 mm
Quelle_R02_BAT_BRIDGE
Quelle_R02_CTRL_CASE
Quelle_R02_GUIDE_MOUNT
Quelle_R02_KNOTEN
