ITSMEEME/PropBoard/konstruktion/04_Ergonomie_Liegen.step

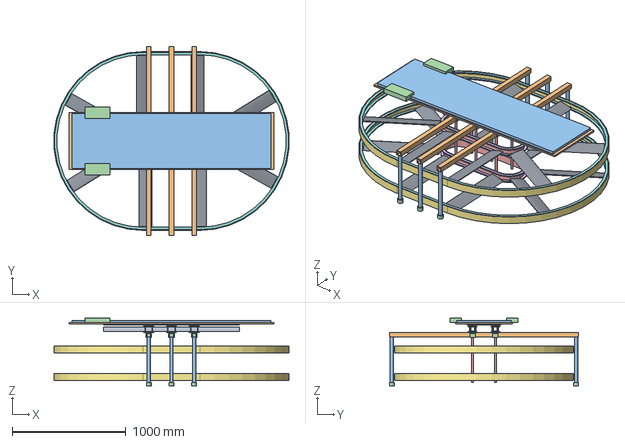
[picture p231: CAD file, 2026-10-29]
konstruktion/04_Ergonomie_Liegen.step
2066.6 x 1663.7 x 598.0 mm
