ITSMEEME/PropBoard/kreis_r04/mn1330_p12/Varianten/Aluminium/STEP/P12-027.step

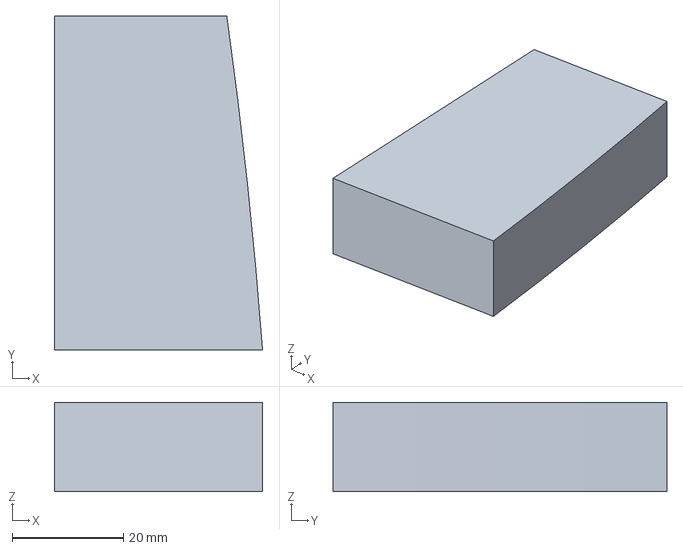
[picture p232: CAD file, 2026-11-01]
kreis_r04/mn1330_p12/Varianten/Aluminium/STEP/P12-027.step
37.4 x 60.0 x 16.0 mm
