ITSMEEME/PropBoard/kreis_r04/mn1330_p12/Varianten/Aluminium/STL/REF-MN1330.stl

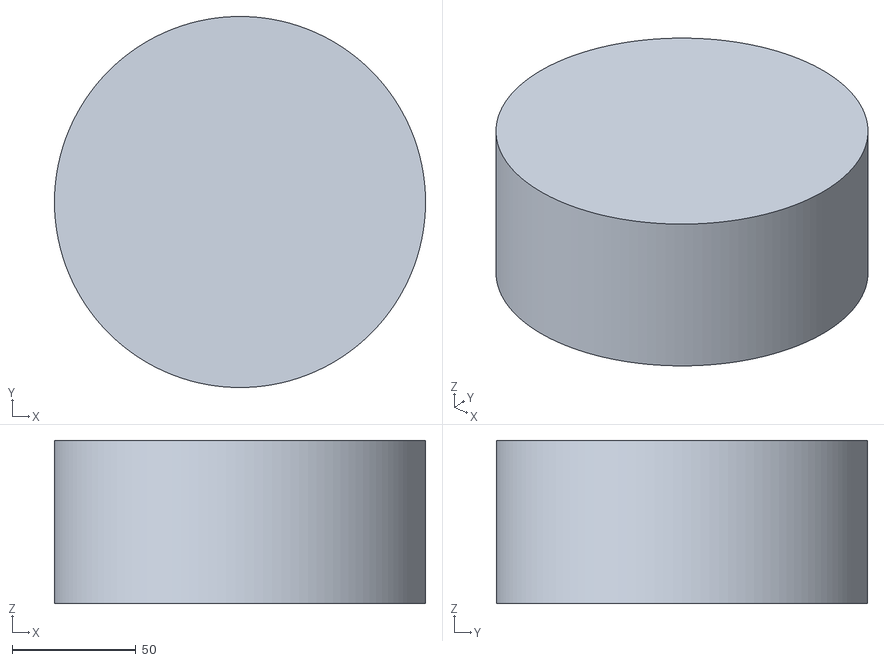
[picture p233: CAD file, 2026-11-01]
kreis_r04/mn1330_p12/Varianten/Aluminium/STL/REF-MN1330.stl
150.0 x 150.0 x 66.0
