ITSMEEME/PropBoard/kreis_r04/mn1330_p13/Ausgabe/STEP_Nennkonturen/STD-ISO4762-M5x12.step

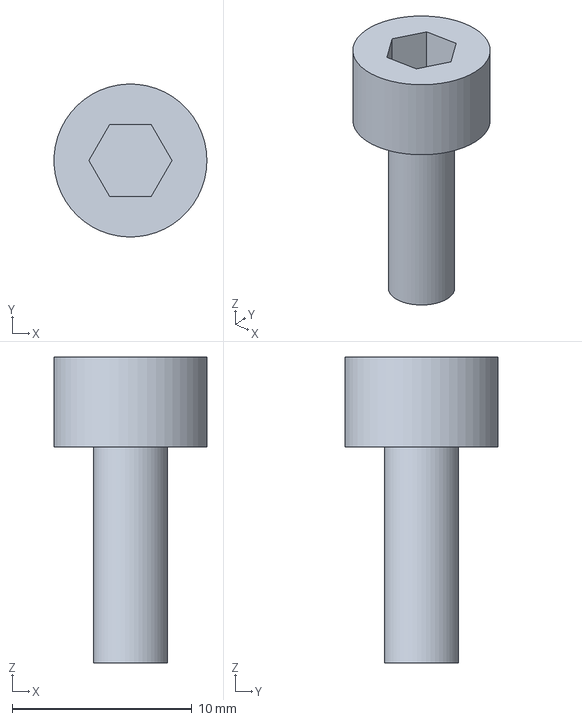
[picture p234: CAD file, 2026-11-01]
kreis_r04/mn1330_p13/Ausgabe/STEP_Nennkonturen/STD-ISO4762-M5x12.step
8.49 x 8.50 x 17.0 mm
