ITSMEEME/PropBoard/kreis_r04/mn1330_p13/Ausgabe/STEP_Sonderteile/P13-CFK-SPITZENBLOCK_MZ.step

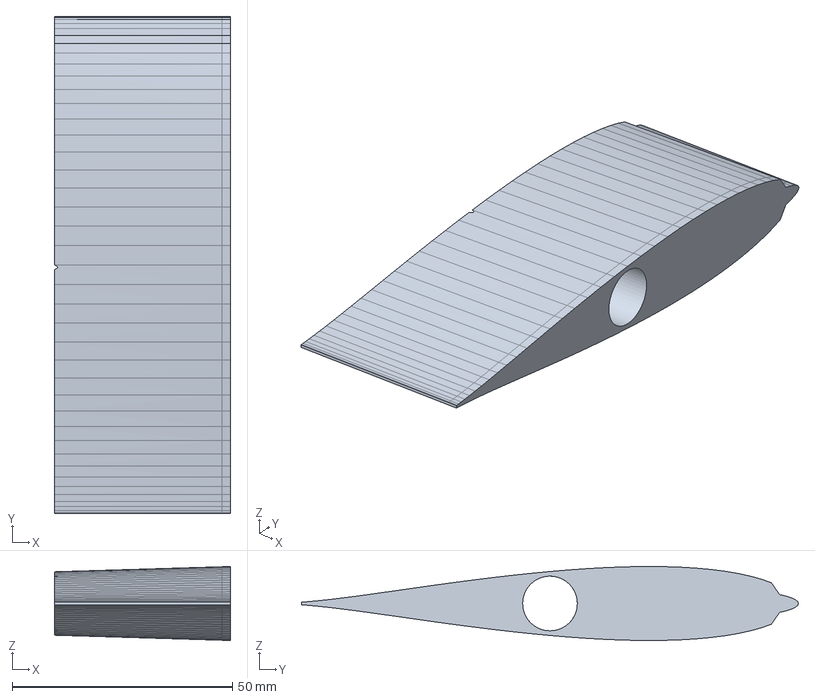
[picture p235: CAD file, 2026-11-01]
kreis_r04/mn1330_p13/Ausgabe/STEP_Sonderteile/P13-CFK-SPITZENBLOCK_MZ.step
40.0 x 112.8 x 16.8 mm
