ITSMEEME/PropBoard/kreis_r04/mn1330_p14/Ausgabe/STEP_Referenzen/B6002.step

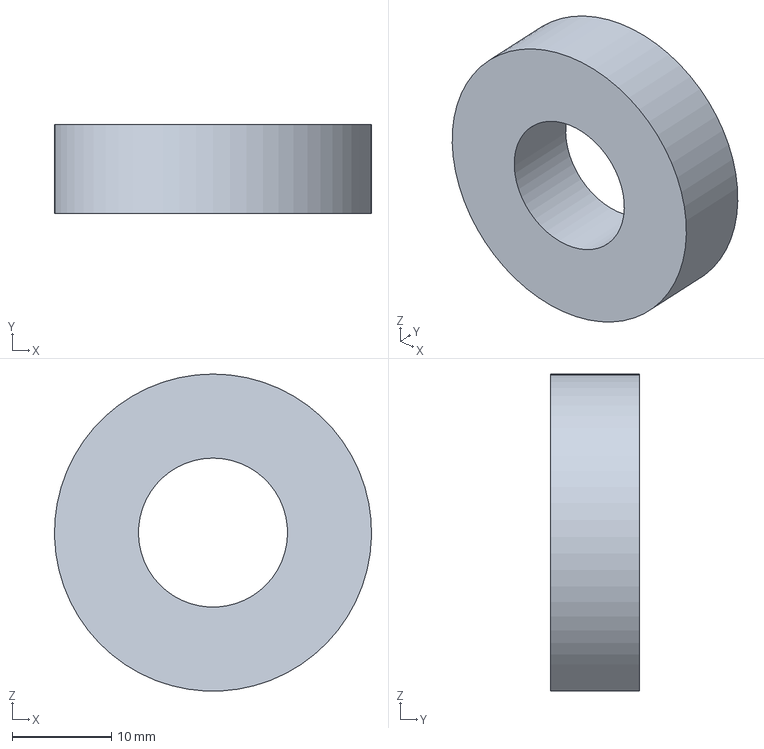
[picture p236: CAD file, 2026-11-01]
kreis_r04/mn1330_p14/Ausgabe/STEP_Referenzen/B6002.step
32.0 x 9.00 x 32.0 mm
