ITSMEEME/PropBoard/kreis_r04/mn1330_p14/Ausgabe/STEP_Sonderteile/F6_HUB.step

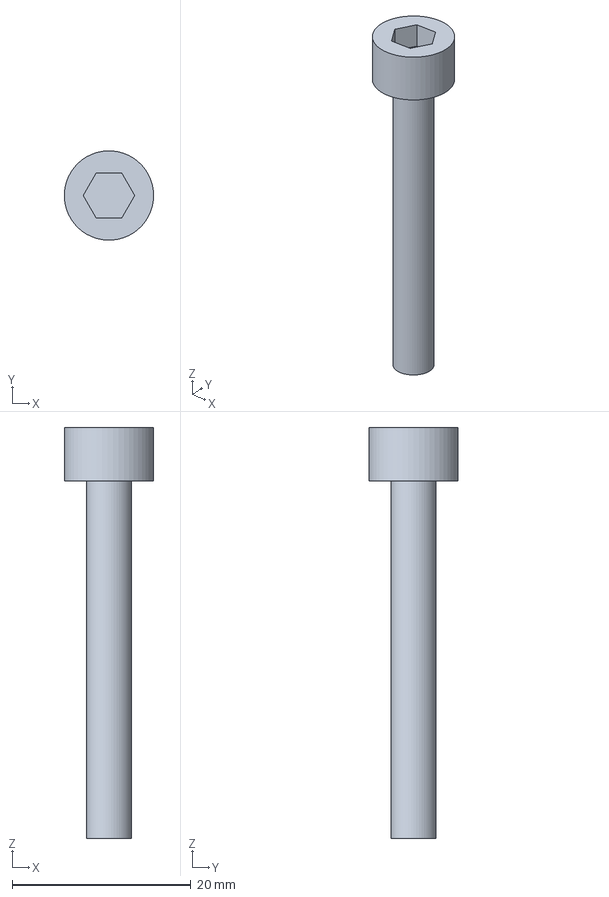
[picture p237: CAD file, 2026-11-01]
kreis_r04/mn1330_p14/Ausgabe/STEP_Sonderteile/F6_HUB.step
9.99 x 10.00 x 46.0 mm
