ITSMEEME/PropBoard/kreis_r04/mn1330_p14/Ausgabe/STL_Nenngeometrie/A26N.stl

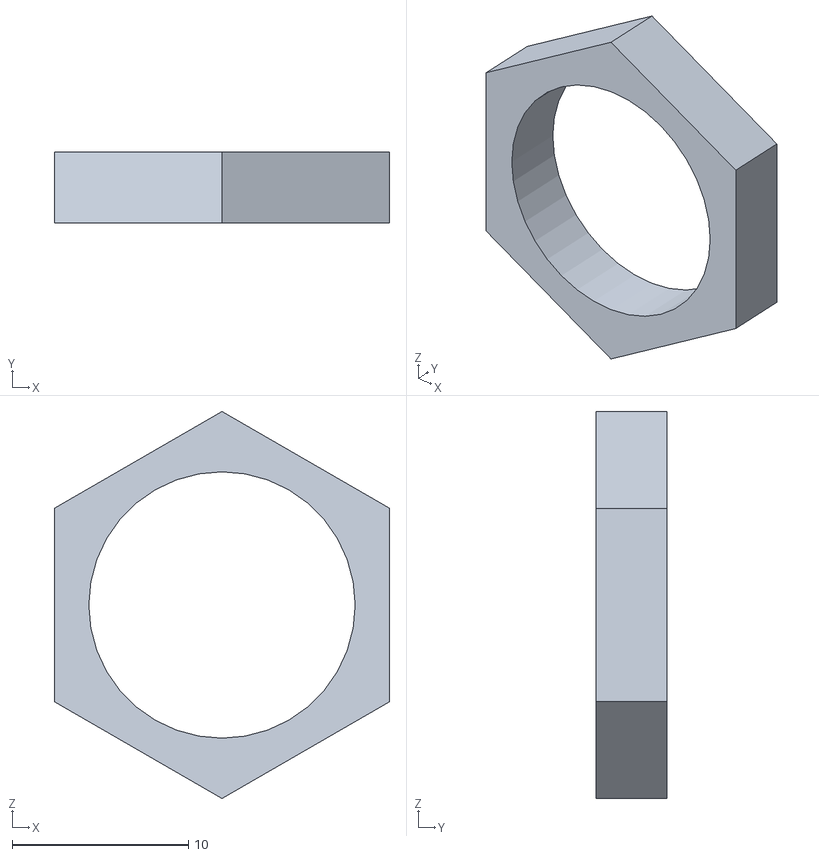
[picture p238: CAD file, 2026-11-01]
kreis_r04/mn1330_p14/Ausgabe/STL_Nenngeometrie/A26N.stl
19.0 x 4.00 x 21.9
