ITSMEEME/PropBoard/modell_r04/cad/stl/Fluegel.stl

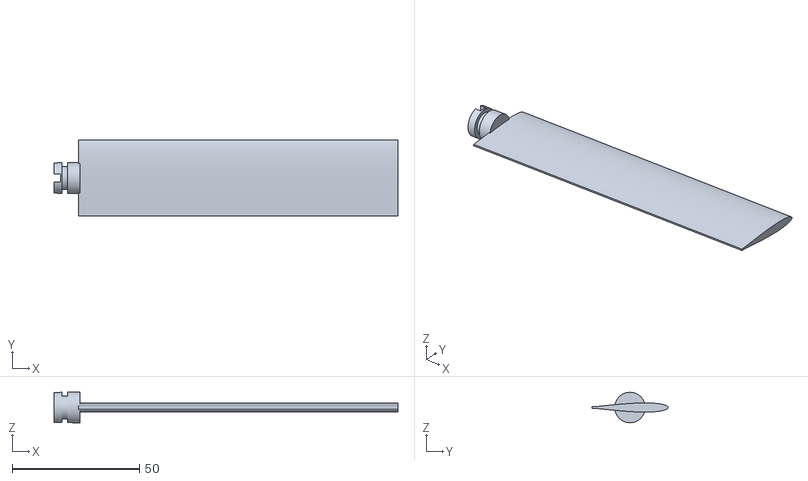
[picture p239: CAD file, 2026-10-30]
modell_r04/cad/stl/Fluegel.stl
135.2 x 30.0 x 12.0
