ITSMEEME/PropBoard/modell_r04_taumel/bewegung_p09/Ausgabe/Drehring_oben.step

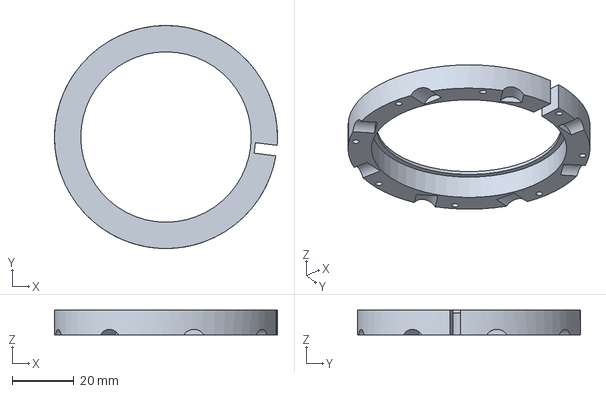
[picture p240: CAD file, 2026-10-30]
modell_r04_taumel/bewegung_p09/Ausgabe/Drehring_oben.step
72.0 x 72.0 x 8.00 mm
