ITSMEEME/PropBoard/modell_r04_taumel/cad/Fertigung/Einzelteile/TM-03O_Deckel_Zahnkranz_oben.FCStd

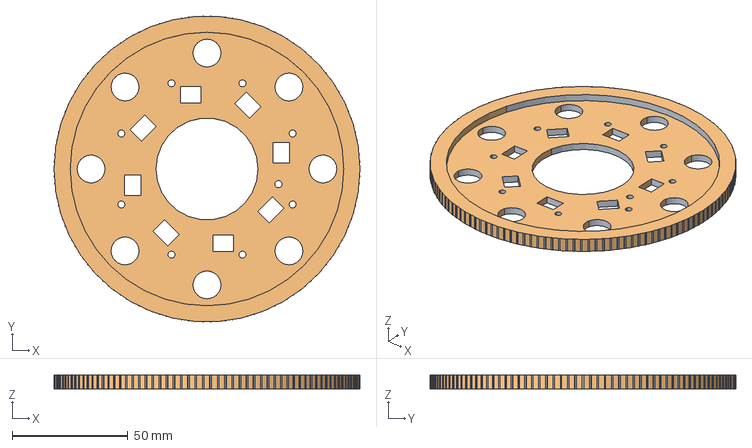
[picture p241: CAD file, 2026-10-30]
modell_r04_taumel/cad/Fertigung/Einzelteile/TM-03O_Deckel_Zahnkranz_oben.FCStd
132.0 x 132.0 x 6.00 mm
Bauteil
Zeichnungsgeometrie
