ITSMEEME/PropBoard/modell_r04_taumel/cad/vorschau/Rotor_unten_Druck.stl

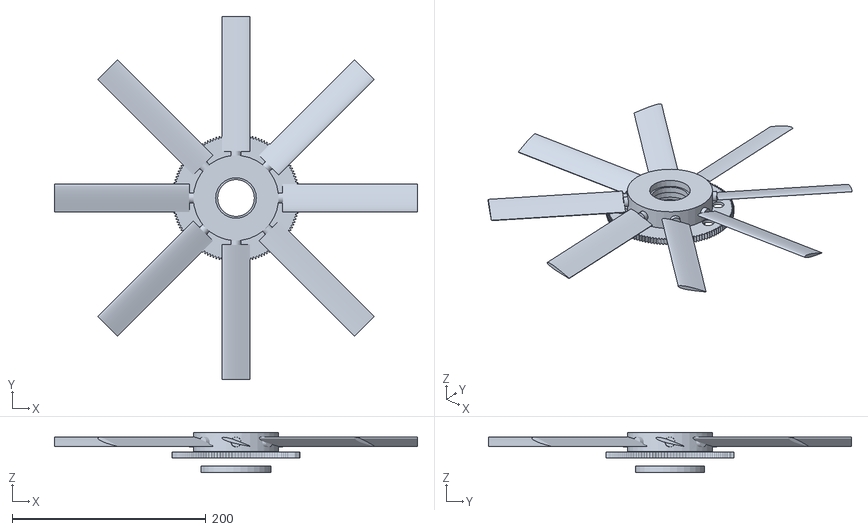
[picture p242: CAD file, 2026-10-30]
modell_r04_taumel/cad/vorschau/Rotor_unten_Druck.stl
375.0 x 375.0 x 41.7
