ITSMEEME/PropBoard/modell_r04_taumel/fertigung_p02/Quellen/N04_Mutter_M3.step

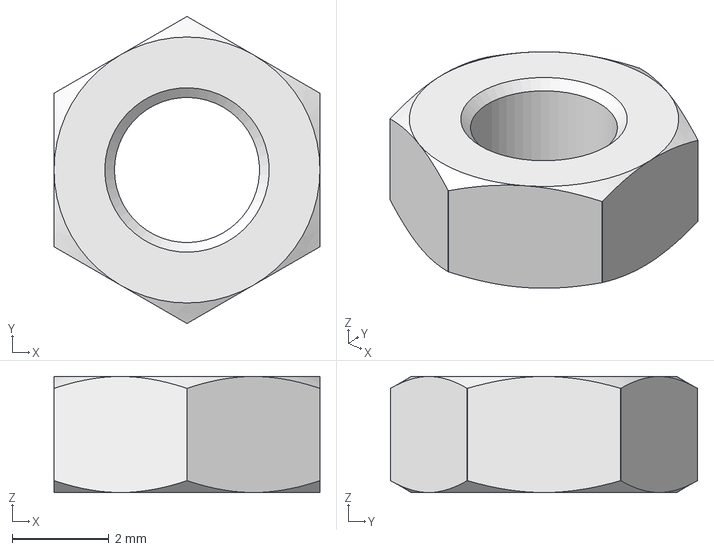
[picture p243: CAD file, 2026-10-30]
modell_r04_taumel/fertigung_p02/Quellen/N04_Mutter_M3.step
5.50 x 6.35 x 2.40 mm
