ITSMEEME/PropBoard/modell_r04_taumel/fertigung_p08/Ausgabe/body_high.step

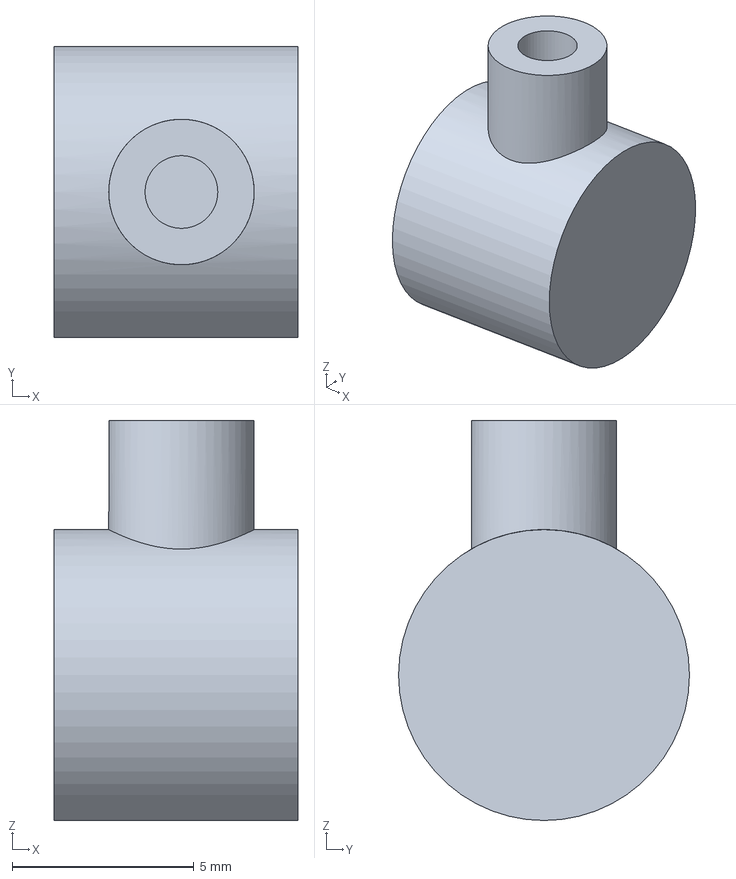
[picture p244: CAD file, 2026-10-30]
modell_r04_taumel/fertigung_p08/Ausgabe/body_high.step
6.70 x 8.00 x 11.0 mm
