ITSMEEME/PropBoard/modell_r04_taumel/halterungen/Ausgabe/Einzelteile/H06_Akku_Distanzrohr_62.FCStd

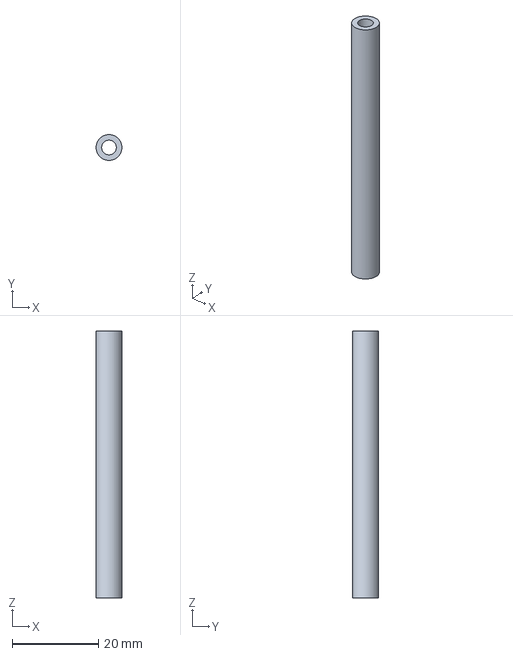
[picture p245: CAD file, 2026-10-30]
modell_r04_taumel/halterungen/Ausgabe/Einzelteile/H06_Akku_Distanzrohr_62.FCStd
5.99 x 6.00 x 62.0 mm
