ITSMEEME/PropBoard/modell_r04_taumel/halterungen/Ausgabe/STEP/H03_FC_Distanz_14_4.step

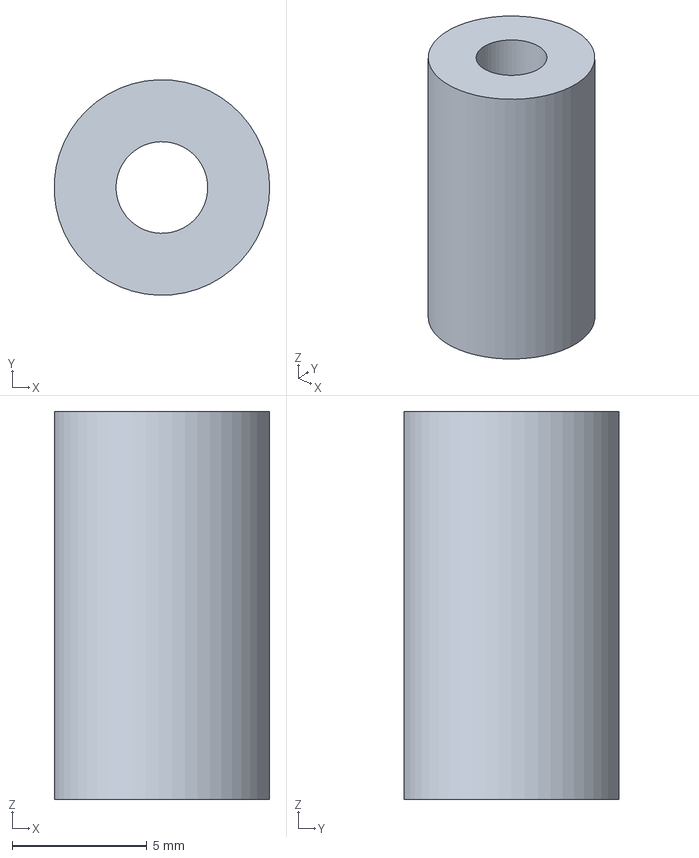
[picture p246: CAD file, 2026-10-30]
modell_r04_taumel/halterungen/Ausgabe/STEP/H03_FC_Distanz_14_4.step
7.99 x 8.00 x 14.4 mm
