ITSMEEME/PropBoard/modell_r04_taumel/integration_p10/Ausgabe/STEP/Strebe_CFK_6x4.step

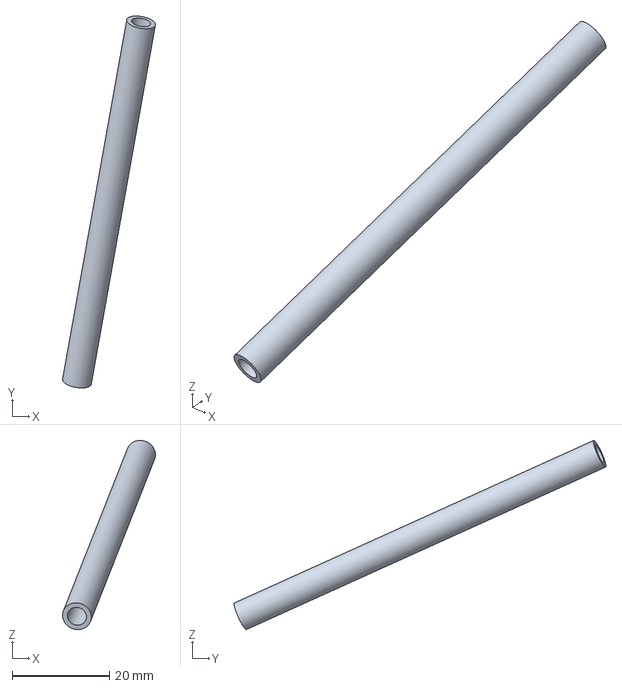
[picture p247: CAD file, 2026-10-31]
modell_r04_taumel/integration_p10/Ausgabe/STEP/Strebe_CFK_6x4.step
19.1 x 76.4 x 38.8 mm
