ITSMEEME/PropBoard/quad_r380_d03/Ausgabe/D03_INDEX_RACK.step

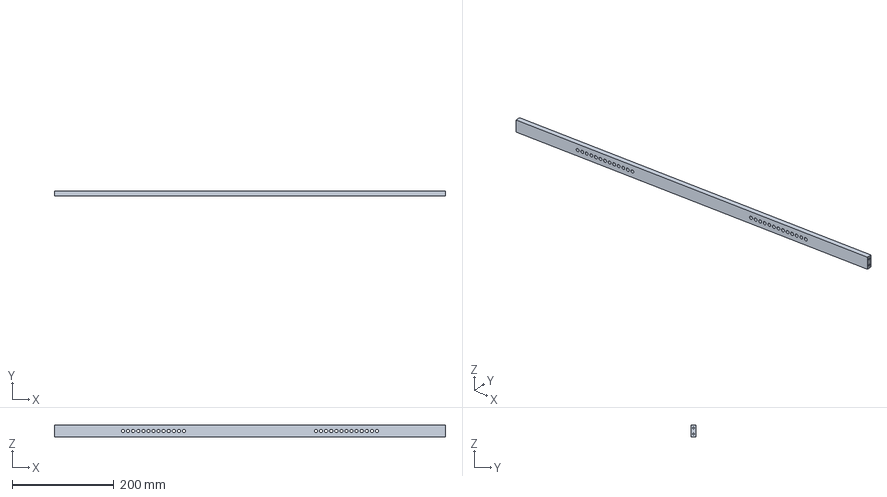
[picture p248: CAD file, 2026-11-04]
quad_r380_d03/Ausgabe/D03_INDEX_RACK.step
770.0 x 10.0 x 24.0 mm
