ITSMEEME/PropBoard/(list of files, cad)

Other CAD files:
modell_r04_taumel/fertigung_p04/Ausgabe/P04_Baugruppe_PCD16_GESPERRT.FCStd
modell_r04_taumel/fertigung_p05/Ausgabe/P05_Baugruppe_Motoranschluss_GESPERRT.FCStd
kreis_r04/Kreis_R04_Aussenring.step
kreis_r04/mn1330_p12/Ausgabe/P12_MN1330.step
kreis_r04/mn1330_p14/Ausgabe/P14_MN1330_Leichtbau.step
kreis_r04/mn1330_p14/Ausgabe/STL_Nenngeometrie/A11.stl
modell_r04_taumel/cad/R04_Taumelmodell_1zu4.step
modell_r04_taumel/cad/stl/Deckel_Zahnkranz_130Z_m1_unten.stl
modell_r04_taumel/fertigung_p02/Ausgabe/P02_Kaufteile_Integration_GESPERRT.step
modell_r04_taumel/fertigung_p06/Ausgabe/P06_Bauteilpruefung_NICHT_FERTIGUNGSBEREIT.FCStd
modell_r04_taumel/halterungen/Ausgabe/R04_Taumelmodell_Halterungen_H01.step
quad_r380_d05/Ausgabe/QuadR380_D05_MN1330.step
quad_r380_d08/Ausgabe/Quad_Parametrisch_V1_V4.FCStd
quad_r380_d11/Ausgabe/Quad_Motornahe_Reglerhalter.FCStd
quad_r380_d12/Ausgabe/Quad_Reglerhalter_Landefuesse.FCStd
quad_r380_d13/Ausgabe/Quad_Flachrippen_Mensch.FCStd
entwicklung_ab/Ausgabe/HEXA_R265/HEXA_R265.FCStd
entwicklung_ab/Ausgabe/HEXA_R265_B4/HEXA_R265_B4_Rahmen.step
entwicklung_ab/Ausgabe/HEXA_R275/HEXA_R275.FCStd
entwicklung_ab/Ausgabe/QUAD_R380/QUAD_R380.FCStd
entwicklung_ab/Ausgabe/QUAD_R400/QUAD_R400.FCStd
kreis_r04/mn1330_p14/Ausgabe/STEP_Sonderteile/F3_CAP.step
modell_r04_taumel/bewegung/Ausgabe/Cohexial_R04_M01_Neutral.step
modell_r04_taumel/fertigung_p07/Ausgabe/SB2270SGP_Originalimport_GEOMETRIEPRUEFUNG.FCStd
modell_r04_taumel/halterungen/Ausgabe/STEP/H05_Akkuwanne_78x37x52.step
multirotor_d14/Ausgabe/nativ/HEXA_HEP_S_42_16_V4.step
quad_r380_d13/Ausgabe/Quad_Standardkabelbaum.FCStd
kreis_r04/mn1330_p12/Ausgabe/Referenz_STEP/REF-SCHRAUBE-M4-L14-K3.2.step
kreis_r04/mn1330_p12/Ausgabe/STL/REF-SCHRAUBE-M4-L8-K3.2.stl
kreis_r04/mn1330_p13/Ausgabe/STL/REF-SCHRAUBE-M3-L8-K2.4.stl
modell_r04_taumel/cad/Fertigung/STEP/TM-03O_Deckel_Zahnkranz_oben.step
modell_r04_taumel/cad/stl/Halteplatte.stl
modell_r04_taumel/integration_p11/Ausgabe/STEP/P11_Exzenterbolzen_Oben_1.step
cad/Gegenlaeufiger_Fluegelumlauf.FCStd
cad/Gegenlaeufiger_Fluegelumlauf.step
horizontal_z_r02/00_Horizontal_Z_R02_Montage.FCStd
horizontal_z_r02/00_Horizontal_Z_R02_Montage.step
horizontal_z_r02/01a_Rahmenknoten_Detail.FCStd
horizontal_z_r02/01a_Rahmenknoten_Detail.step
horizontal_z_r02/01b_Rahmenknoten_Explodiert.FCStd
horizontal_z_r02/01b_Rahmenknoten_Explodiert.step
horizontal_z_r02/02_Schlitten_R02_Detail.FCStd
horizontal_z_r02/03_Batterie_R02_Detail.FCStd
konstruktion/00_PropBoard_Detail_Stehen.FCStd
konstruktion/00_PropBoard_Detail_Stehen.step
konstruktion/01_CFK_Rahmen.FCStd
konstruktion/01_CFK_Rahmen.step
konstruktion/02_Fuehrung_Antrieb_Detail.FCStd
konstruktion/02a_Schlitten_Detail.FCStd
konstruktion/02a_Schlitten_Detail.step
konstruktion/03_Batterie_Kabel.FCStd
konstruktion/03_Batterie_Kabel.step
konstruktion/04_Ergonomie_Liegen.FCStd
konstruktion/04_Ergonomie_Sitzen.FCStd
konstruktion/05_Referenzzeichnungen.FCStd
kreis_r03/Kreis_R03_Layout.FCStd
kreis_r04/Kreis_R04_Aussenring.FCStd
kreis_r04/Kreis_R04_ohne_Aussenring.FCStd
kreis_r04/mn1330_p12/Ausgabe/P12_MN1330.FCStd
kreis_r04/mn1330_p12/Ausgabe/Referenz_STEP/REF-SCHRAUBE-M4-L8-K3.2.step
kreis_r04/mn1330_p12/Ausgabe/Referenz_STEP/REF-SCHRAUBE-M5-L60-K4.1.step
kreis_r04/mn1330_p12/Ausgabe/STEP/CFK-BRUECKE-END.step
kreis_r04/mn1330_p12/Ausgabe/STEP/CFK-BRUECKE-END_MX.step
kreis_r04/mn1330_p12/Ausgabe/STEP/CFK-GUIDE-A.step
kreis_r04/mn1330_p12/Ausgabe/STEP/CFK-GUIDE-B.step
kreis_r04/mn1330_p12/Ausgabe/STEP/CFK-GUIDE-FILM.step
kreis_r04/mn1330_p12/Ausgabe/STEP/CFK-KLEMM-A.step
kreis_r04/mn1330_p12/Ausgabe/STEP/CFK-KLEMM-B.step
kreis_r04/mn1330_p12/Ausgabe/STEP/CFK-KNOTEN-000.step
kreis_r04/mn1330_p12/Ausgabe/STEP/CFK-KNOTEN-001.step
kreis_r04/mn1330_p12/Ausgabe/STEP/CFK-KNOTEN-002.step
kreis_r04/mn1330_p12/Ausgabe/STEP/CFK-KNOTEN-003.step
kreis_r04/mn1330_p12/Ausgabe/STEP/CFK-KNOTEN-004.step
kreis_r04/mn1330_p12/Ausgabe/STEP/CFK-KNOTEN-005.step
kreis_r04/mn1330_p12/Ausgabe/STEP/CFK-KNOTEN-006.step
kreis_r04/mn1330_p12/Ausgabe/STEP/CFK-KNOTEN-007.step
kreis_r04/mn1330_p12/Ausgabe/STEP/CFK-KNOTEN-008.step
kreis_r04/mn1330_p12/Ausgabe/STEP/CFK-KNOTEN-009.step
kreis_r04/mn1330_p12/Ausgabe/STEP/CFK-KNOTEN-010.step
kreis_r04/mn1330_p12/Ausgabe/STEP/CFK-KNOTEN-011.step
kreis_r04/mn1330_p12/Ausgabe/STEP/CFK-KNOTEN-012.step
kreis_r04/mn1330_p12/Ausgabe/STEP/CFK-KNOTEN-013.step
kreis_r04/mn1330_p12/Ausgabe/STEP/CFK-KNOTEN-014.step
kreis_r04/mn1330_p12/Ausgabe/STEP/CFK-KNOTEN-015.step
kreis_r04/mn1330_p12/Ausgabe/STEP/CFK-KNOTEN-016.step
kreis_r04/mn1330_p12/Ausgabe/STEP/CFK-KNOTEN-017.step
kreis_r04/mn1330_p12/Ausgabe/STEP/CFK-KNOTEN-018.step
kreis_r04/mn1330_p12/Ausgabe/STEP/CFK-KNOTEN-019.step
kreis_r04/mn1330_p12/Ausgabe/STEP/CFK-KNOTEN-020.step
kreis_r04/mn1330_p12/Ausgabe/STEP/CFK-KNOTEN-021.step
kreis_r04/mn1330_p12/Ausgabe/STEP/CFK-KNOTEN-022.step
kreis_r04/mn1330_p12/Ausgabe/STEP/CFK-KNOTEN-023.step
kreis_r04/mn1330_p12/Ausgabe/STEP/CFK-KNOTEN-024.step
kreis_r04/mn1330_p12/Ausgabe/STEP/CFK-KNOTEN-025.step
kreis_r04/mn1330_p12/Ausgabe/STEP/CFK-KNOTEN-026.step
kreis_r04/mn1330_p12/Ausgabe/STEP/CFK-KNOTEN-027.step
kreis_r04/mn1330_p12/Ausgabe/STEP/CFK-KNOTEN-028.step
kreis_r04/mn1330_p12/Ausgabe/STEP/CFK-KNOTEN-029.step
kreis_r04/mn1330_p12/Ausgabe/STEP/CFK-KNOTEN-030.step
kreis_r04/mn1330_p12/Ausgabe/STEP/CFK-KNOTEN-031.step
kreis_r04/mn1330_p12/Ausgabe/STEP/CFK-KNOTEN-032.step
kreis_r04/mn1330_p12/Ausgabe/STEP/CFK-KNOTEN-033.step
kreis_r04/mn1330_p12/Ausgabe/STEP/CFK-KNOTEN-034.step
kreis_r04/mn1330_p12/Ausgabe/STEP/CFK-KNOTEN-035.step
kreis_r04/mn1330_p12/Ausgabe/STEP/CFK-KNOTEN-036.step
kreis_r04/mn1330_p12/Ausgabe/STEP/CFK-KNOTEN-037.step
kreis_r04/mn1330_p12/Ausgabe/STEP/CFK-KNOTEN-038.step
kreis_r04/mn1330_p12/Ausgabe/STEP/CFK-KNOTEN-039.step
kreis_r04/mn1330_p12/Ausgabe/STEP/CFK-KNOTEN-040.step
kreis_r04/mn1330_p12/Ausgabe/STEP/CFK-KNOTEN-041.step
kreis_r04/mn1330_p12/Ausgabe/STEP/CFK-KNOTEN-042.step
kreis_r04/mn1330_p12/Ausgabe/STEP/CFK-KNOTEN-043.step
kreis_r04/mn1330_p12/Ausgabe/STEP/CFK-KNOTEN-044.step
kreis_r04/mn1330_p12/Ausgabe/STEP/CFK-KNOTEN-045.step
kreis_r04/mn1330_p12/Ausgabe/STEP/CFK-KNOTEN-046.step
kreis_r04/mn1330_p12/Ausgabe/STEP/CFK-KNOTEN-047.step
kreis_r04/mn1330_p12/Ausgabe/STEP/CFK-KNOTEN-048.step
kreis_r04/mn1330_p12/Ausgabe/STEP/CFK-KNOTEN-049.step
kreis_r04/mn1330_p12/Ausgabe/STEP/CFK-KNOTEN-050.step
kreis_r04/mn1330_p12/Ausgabe/STEP/CFK-ROHR-000.step
kreis_r04/mn1330_p12/Ausgabe/STEP/CFK-ROHR-001.step
kreis_r04/mn1330_p12/Ausgabe/STEP/CFK-ROHR-002.step
kreis_r04/mn1330_p12/Ausgabe/STEP/CFK-ROHR-003.step
kreis_r04/mn1330_p12/Ausgabe/STEP/CFK-ROHR-004.step
kreis_r04/mn1330_p12/Ausgabe/STEP/CFK-ROHR-005.step
kreis_r04/mn1330_p12/Ausgabe/STEP/CFK-ROHR-006.step
kreis_r04/mn1330_p12/Ausgabe/STEP/CFK-ROHR-007.step
kreis_r04/mn1330_p12/Ausgabe/STEP/CFK-ROHR-008.step
kreis_r04/mn1330_p12/Ausgabe/STEP/CFK-ROHR-009.step
kreis_r04/mn1330_p12/Ausgabe/STEP/CFK-ROHR-010.step
kreis_r04/mn1330_p12/Ausgabe/STEP/CFK-ROHR-011.step
kreis_r04/mn1330_p12/Ausgabe/STEP/CFK-ROHR-012.step
kreis_r04/mn1330_p12/Ausgabe/STEP/CFK-ROHR-013.step
kreis_r04/mn1330_p12/Ausgabe/STEP/CFK-ROHR-014.step
kreis_r04/mn1330_p12/Ausgabe/STEP/CFK-ROHR-015.step
kreis_r04/mn1330_p12/Ausgabe/STEP/CFK-ROHR-016.step
kreis_r04/mn1330_p12/Ausgabe/STEP/CFK-ROHR-017.step
kreis_r04/mn1330_p12/Ausgabe/STEP/CFK-ROHR-018.step
kreis_r04/mn1330_p12/Ausgabe/STEP/CFK-ROHR-019.step
kreis_r04/mn1330_p12/Ausgabe/STEP/CFK-ROHR-020.step
kreis_r04/mn1330_p12/Ausgabe/STEP/CFK-ROHR-021.step
kreis_r04/mn1330_p12/Ausgabe/STEP/CFK-ROHR-022.step
kreis_r04/mn1330_p12/Ausgabe/STEP/CFK-ROHR-023.step
kreis_r04/mn1330_p12/Ausgabe/STEP/CFK-ROHR-024.step
kreis_r04/mn1330_p12/Ausgabe/STEP/CFK-ROHR-025.step
kreis_r04/mn1330_p12/Ausgabe/STEP/CFK-ROHR-026.step
kreis_r04/mn1330_p12/Ausgabe/STEP/CFK-ROHR-027.step
kreis_r04/mn1330_p12/Ausgabe/STEP/CFK-ROHR-028.step
kreis_r04/mn1330_p12/Ausgabe/STEP/CFK-ROHR-029.step
kreis_r04/mn1330_p12/Ausgabe/STEP/CFK-ROHR-030.step
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
