ITSMEEME/PropBoard/kreis_r04/mn1330_p14/MONTAGE.md

# Montagefolge und geometrische Nachweise

Der Gelenkfix ersetzt die 28 Überschneidungen der alten Nennstangen durch ausgeführte Gelenkbaugruppen. Maßgebend für den tatsächlich geprüften Stand sind [Montage_Pruefung.json](Ausgabe/Montage_Pruefung.json), [Kollisionen.json](Ausgabe/Kollisionen.json) und die darin gespeicherte SHA256 der nativen Baugruppe. Die Berichte erteilen keine Fertigungsfreigabe.

## Gelenke und Einstellmaße

Ein Rotorpaar enthält 16 Pitchgestänge und sechs Servogestänge mit insgesamt44 Endgelenken. Je Rotorkopf besitzt das erste untere Servogelenk eine DIN1494-Buchse8×10×8 mit PTFE-Anlaufscheiben. Diese beiden R-Gelenke führen die stationäre Phase. Die übrigen42 Gelenke verwenden sphärische GE8E-Nennlager8×16×8 mit5mm Außenringbreite. Außen-/Innenring sind getrennte Körper; ihre sphärischen Profile sind Nennmodelle und müssen mit dem Lieferteil abgeglichen werden.

| Verbindung | Modellierter Aufbau |
|---|---|
| GE8-Auge | Alu7075-Gehäuse, Schulter,16-mm-Sitz,0,15-mm-Passscheibe, DIN472-16×1 |
| S-Gabel | 18-mm-Innenweite =5mm Distanz +8mm Innenring +5mm Distanz |
| R-Gabel | 18mm =4,7mm Distanz +0,3mm PTFE +8mm Buchse +0,3mm PTFE +4,7mm Distanz |
| Gelenkbolzen | Alu7075,Ø7,96 inØ8,2-Gabelbohrung; Kopf, Scheibe und Stahl-Splint |
| Gestänge | M6 RH unten / LH oben, SW10-Einstellhülse, zwei Kontermuttern; insgesamt±0,5mm Einstellbereich |
| Hauptflansch | 6×M6×40 von oben,Ø96-Lochkreis,12mm Gewindeeingriff in Alu7075 |
| CFK-Klemmplatten | 4×M6×25 von außen,12mm Gewindeeingriff im integralen Alu-Flansch |
| Servosattel / Träger | 4×M4×16 pro Sattel;4×M6×60 pro Ausleger zum Zentralblock |

Das [Gelenkregister](Ausgabe/Gelenk_Register.csv) nennt für alle44 Einbaustellen die RH-/LH-Bestellvariante, Lagerart, Koordinate und Bolzen-Ausziehrichtung. Die STEP-Kernkontur ist für beide Gewindehände gemeinsam; RH/LH sind getrennte Fertigungsvarianten. Die exakten Gestängelängen, Gewindeeingriffe und Endabstände stehen in `Abgeleitet.json` unter `linkages`; die44 Gelenkpositionen folgen aus `joints` eines Kopfes und dessen Starrkörperdrehung für den zweiten Kopf. Die angegebenen Einstellgrenzen schließen eine Verringerung des Gewindeeingriffs ein. Die kurzen Grundlöcher der Einstellhülsen benötigen Gewindefräsen oder ein qualifiziertes Grundlochverfahren mit dem vorgesehenen Auslauf; Werkzeugauslauf und effektiv tragender Gewindeeingriff sind vor Fertigung zu bestätigen. Kontermuttern nach Einstellung sichern und markieren; Änderungen an Gestängelängen benötigen einen neuen Kinematikabgleich.

Die Distanzlängen sind **selektiv nach dem tatsächlichen Innenring und der Gabel auszumessen**. Der Innenring wird zwischen den Distanzhülsen gehalten; die Gabel darf nicht über den Außenring verspannt werden. Ziel-Restspiel0–0,02mm ist eine Montagevorgabe zur Qualifikation, keine im CAD nachgewiesene Toleranzkette. Ringe, Buchsen und Splinte bleiben Norm-Lieferteile aus ihrem vorgesehenen Werkstoff. Aluminium-Schrauben/Bolzen erhalten keine Stahl-Festigkeitsklasse.

## Reihenfolge

1. **Hauptlager auf der Werkbank aufbauen.** Den abnehmbaren D57-Flansch weglassen. A03 über die nackte A04-Welle setzen, unteres7212 von oben aufsetzen und A05 darüberführen. A05 mit vierM4 von unten an A03 befestigen, bevor die Motoren den Zugang verdecken. A07, oberes7212 und oberen Deckel montieren. Sicherungsblech flach einsetzen, M60-Mutter aufsetzen und Vorspannung nach realem Lagerpaar einstellen. Erst anschließend die äußere Sicherungszunge umlegen; bei Demontage ersetzen.
2. **Motor und Zentrum verbinden.** Stator an A01 vor dem Zusammenbau des Zentralblocks befestigen. Die12 Rotor-M5 sind von oben innerhalb der offenen Hohlwelle erreichbar. Motorbezug65/66mm und4/6mm angenommener Gewindeeingriff bleiben OEM-Restpunkte. Druckhülsen und gemeinsame Zuganker mit den Lagerjochen verbinden. Die Servoträgerfüße besitzen Freistiche für alle diagonalen Statorarme.
3. **Taumeleinheit vormontieren.** PTFE-Folie auf die Hauptlagerpatrone bzw. in den Kugelkragen setzen. Die beiden PTFE-Kugelpfannenhälften und die untere/obere Aluminium-Pfannenhälfte um den Kugelkragen schließen; vierM3 befestigen sie.61832 von oben in den geöffneten A21-Ring einsetzen, A21C mit vierM3 schließen und die innere Klemmmutter A22 montieren. Die komplette Einheit vor Hauptflansch/Wurzelstern von oben über die Lagerpatrone führen. Vorspannung und Gleitreibung sind noch zu qualifizieren.
4. **Rotorflansch und Wurzelstern aufsetzen.** A04F über den durchgängigen D57-Sitz setzen, flaches Sicherungsblech und Haltemutter montieren, dann dessen Zunge umlegen. A09 auf denØ80-Zentrierbund setzen und die sechsM6 von oben direkt in den12-mm-Flansch schrauben. Gefangene Muttern und eine entsprechende Hilfsvorrichtung entfallen.
5. **Blattlager einsetzen.** Inneres7205 zunächst von oben in die offene Hebeltasche bei `x = root_r_mm −20mm` bringen und anschließend20mm radial nach außen in seinen Sitz schieben. Ein gerader Einbauweg von weit innerhalb der Nabe ist nicht vorgesehen. Innendistanz und äußeres7205 von außen einsetzen. Die äußere Sitzöffnung ist durchgängigØ52,1; A11O schließt sie mit sechsM6. Innendeckel mit dreiM3 montieren. Pitchwelle mit außenliegendem Integralflansch, Wurzelmandrel und Distanzen von außen durch die Lager führen. Der Flansch bleibt außerhalb der Lager; abnehmbare Schulter/Distanzen, M25-Mutter und Sicherungsblech halten das Lagerpaket axial.
6. **Pitchhebel und Flügel montieren.** Hinterdistanz, D-Hebel, Vorderdistanz und axiale Scheibe/End-M6 montieren; Hebelklemmung anschließend anziehen. CFK-Flügel auf den integralenØ32-Mandrel schieben und mit der äußeren Klemmplatte fassen. Vier von außen erreichbareM6×25 aufØ64 greifen12mm in den integralen Wellenflansch. Eine separate Innenplatte, ein loser Einsatz und die verdeckte axiale M8-Endschraube entfallen. Die obere Welle A13U hat einen um−24° indexierten Schraubenkreis; CFK und Außenplatte werden entsprechend indexiert. CFK-/Alu-Trennlage und Anzüge erst nach Laminat-/Fügeverbindungsnachweis festlegen. Die äußeren Lagerdeckelschrauben werden vor dem Wellen-/Flügelpaket montiert; zur Wartung dieses Paket zuerst ausbauen.
7. **Servoumlenkung aufbauen.** Sattel vor Welle/Kupplung auf dem Ausleger verschrauben. Den28-mm-Hebel und die Distanz zwischen den offenen Lagerböcken ausrichten. Welle mit Passfeder von hinten einschieben; die15-mm-Lagerzapfen bleiben rund. Die beiden6002 anschließend von den freien Wellenenden einsetzen, bevor das eigentliche Servogehäuse montiert wird. Schulter, Distanzring und M15-Muttern schließen den axialen Aufbau. Die Mutternsicherung sowie das tatsächliche OEM-Horn und die Gehäusebefestigung benötigen noch eine freigegebene Lieferzeichnung.
8. **Gestänge verbinden.** GE-Außenring bzw. R-Adapter gegen die Schulter einsetzen, Passscheibe und DIN472-Ring montieren. Lagerinnenring/Buchse und Distanzhülsen zwischen die Gabelwangen setzen. Kopfbolzen einführen, Scheibe auflegen und einen **geraden** Splint einstecken. Die Beine erst danach außerhalb der Querbohrung umbiegen. [Gerader Splint als STEP](Ausgabe/Montagewerkzeuge/Splint_vor_Umbiegen.step). Für Wartung Rotoren stromlos in die geprüfte Neutral-/Indexstellung bringen; Splint und Scheibe entfernen, Bolzen in Richtung Kopf ausziehen. Ausgebaute Splinte ersetzen.

## Prüfumfang und Grenzen

Der Montageprüfer kontrolliert die Bolzen mit einer **kontinuierlichen konservativen Auszugshülle** einschließlich Kopf und geschlossener Querbohrung. Die restliche Baugruppe bleibt dabei vollständig vorhanden, ausgenommen die ausdrücklich vorher entfernte Scheibe und der Splint des betreffenden Gelenks. Alle44 Bolzen beider Köpfe werden ausdrücklich gegen die vollständige Baugruppe geprüft. Die übrigen Einbau- und Bitfälle verwenden die benannten Bauteile des oberen Kerns. Nachgewiesen ist die Standardkonfiguration mit acht Blättern in neutraler Indexstellung.

Lager- und Baugruppenwege werden gegen die im Bericht benannten, bereits montierten Körper mit1–2mm Translationsschritt geprüft. Der Inbustest verwendet einen30mm langen Sechskantbit mit0,1mm Untermaß in den modellierten Steckschlüsselflächen; er ist kein vollständiger Nachweis für Hand, Ratsche oder Maschinenwerkzeug. Beim Statoranschluss fehlt in dieser Montagestufe noch der Zentralblock; bei der Hauptlagerbefestigung fehlt noch der Motor. Hauptlagerdeckel und Taumelpfannenschrauben werden vor dem Rotorstern angezogen; die äußeren Blattlagerdeckel vor dem Wellen-/Flügelpaket. Diese Reihenfolge ist Bestandteil des Nachweises.

Beim STEP-Rücklesen wird zunächst eine relative Volumenabweichung unter10⁻⁵ verlangt. Bei abweichender numerischer Integration identischer getrimmter Flächen muss stattdessen eine beidseitige Material-Differenzprüfung höchstens0,1mm³ sowie deckungsgleiche Hüllkästen unter10⁻⁵mm belegen. Gültige Einzelvolumina bleiben Voraussetzung; beide Volumenwerte und Differenzkörper sind im STEP-Bericht protokolliert.

Die Kinematikprüfung umfasst2160 Zustände für4/6/8/10/12 Blätter und360/440mm Ebenenabstand. Sie prüft Gelenkschluss, Gelenkachsen, das geführte R-Bein und Gestängedurchführungen. Der geometrische12°-Schwenkscreen der GE-Nennkontur ist keine garantierte Herstellerfreigabe. Fünf native CAD-Posen prüfen ausgewählte Nachbarpaare und die inneren Gelenkprofile. Eine vollständige dynamische Kollisionshülle aller Bauteile und Parameterkombinationen ist damit nicht nachgewiesen.

Offen bleiben insbesondere OEM-Servo-Horn/Gehäusebefestigung (Original-Download durch die Umgebung mitHTTP403 gesperrt), reale Lager-/Ringprofile, Anzugsvorgaben, Toleranzen, Montagekräfte, Verschleiß und Tragfähigkeit. Diese Punkte werden durch bestandene Nenngeometrieprüfungen nicht geschlossen. Keine Produktions-, Bestell- oder Flugfreigabe.
