ITSMEEME/PropBoard/kreis_r04/mn1330_p13/MONTAGE.md

# Vorgesehene Montagefolge

1. Material-, Halbzeug- und Kaufteilprüfung gegen freigegebene Lieferzeichnungen;
 Lagerpaare, Gewinde, Passungen und Oberflächen kennzeichnen. Dies ist noch keine
 freigegebene Anweisung für den Bau des Fluggeräts.
2. CFK-Rahmen aus gebohrungsfreien Rohrzuschnitten, getrennten Klemmen und
 Isolierlagen montieren. Knoten nach Aufspannung vermessen; Klemmvorspannung nur
 nach Rohr-/Knoten-Nachweis festlegen.
3. Zentralbrücke, Druckhülsen, Stützplatten und Rohre montieren bzw. qualifiziert
 fügen. Gemeinsame M6-Durchgangsverbindungen von beiden Seiten zugänglich halten.
4. Rotor-Innenring mit Patronen, gepaarten7201B-Lagern, abgestimmten Distanzen,
 Pitchwellen, KM1/MB1 und Deckeln aufbauen. Innenring zuerst an Driveposts ausrichten.
5. Rotorfachwerk aus20×17-Lagespeichen und30×26-V-Streben aufbauen, mit Gabelbolzen
 und Splinten sichern; Kleb-/Klemmfreigaben der CFK-Endeinsätze sind Voraussetzung.
6. Außenlagerträger und tragenden Laufbahnring montieren.608-Außenringe müssen
 definiert axial verschieblich bleiben. Die V-Kontur darf nicht durch Halter verdeckt sein.
7. Taumelscheibenhülsen, GE60ES,61820, Anschläge und axiale Deckel montieren.
 Scheren halten stationäre und rotierende Phase; sie sind kein Ersatz für die Lagerung.
8. Drei kardanisch gelagerte Aktoreinheiten je Ebene einsetzen. Gemeinsame Motorträger
 und Riemenebenen ausrichten; Verdrehsicherungsstifte/Sicherungsringe prüfen.
 Aktorgehäuse nicht zusätzlich starr mit der Fußplatte verschrauben.
9. CFK-Flügel nach qualifizierter Klebeprüfung auf Wurzelwelle und Außenzapfen
 montieren. Passfedern und axiale Endscheiben einbauen; Pitchhebel und Gestänge
 einstellen. Mindest-Gewindeeingriffe und RH/LH-Seiten markieren.
10. Motoren nach Nutzer-Lochbildern montieren. Vor Endanzug tatsächliche Gewindetiefen
 prüfen, Nabe zentrieren und Plan-/Rundlauf messen. Unbekannte Motorgewindetiefe nicht
 durch höhere Schraubenvorspannung kompensieren.
11. Führungsrollen einstellen, Lager-/Mutternsicherungen kontrollieren. Rollenachsen
 erhalten feinsteigende Mutter und eigenes zweifach abgebogenes Sicherungsblech.
12. Deckstützen, RHS-Träger mit Druckhülsen und Deck montieren; Kufen-Schweißbaugruppen
 an den vier unteren Knoten verschrauben. Einfache Tritt-/Landelasten sind separat
 nachzuweisen, bevor der Aufbau belastet wird.
13. Langsame Handbewegung über den gesamten vorgesehenen Stellraum, Messung von Spiel,
 Freigang, Rundlauf und axialen Loslagerwegen. Danach erst abgestufte unbemannte
 Prüfstandsversuche nach einem fachlich freigegebenen Prüfplan.

Endgültige Anzugsmomente, Klemm-/Lager-Vorspannungen, Schraubensicherungen,
Schmierstoffe und Austauschintervalle müssen aus den realen Lieferteilen und
Verbindungsnachweisen entstehen. Sie wurden nicht aus CAD-Nennkonturen erfunden.
