ITSMEEME/PropBoard/modell_r04_taumel/fertigung_p07/Ausgabe/STEP_Vorschau.png

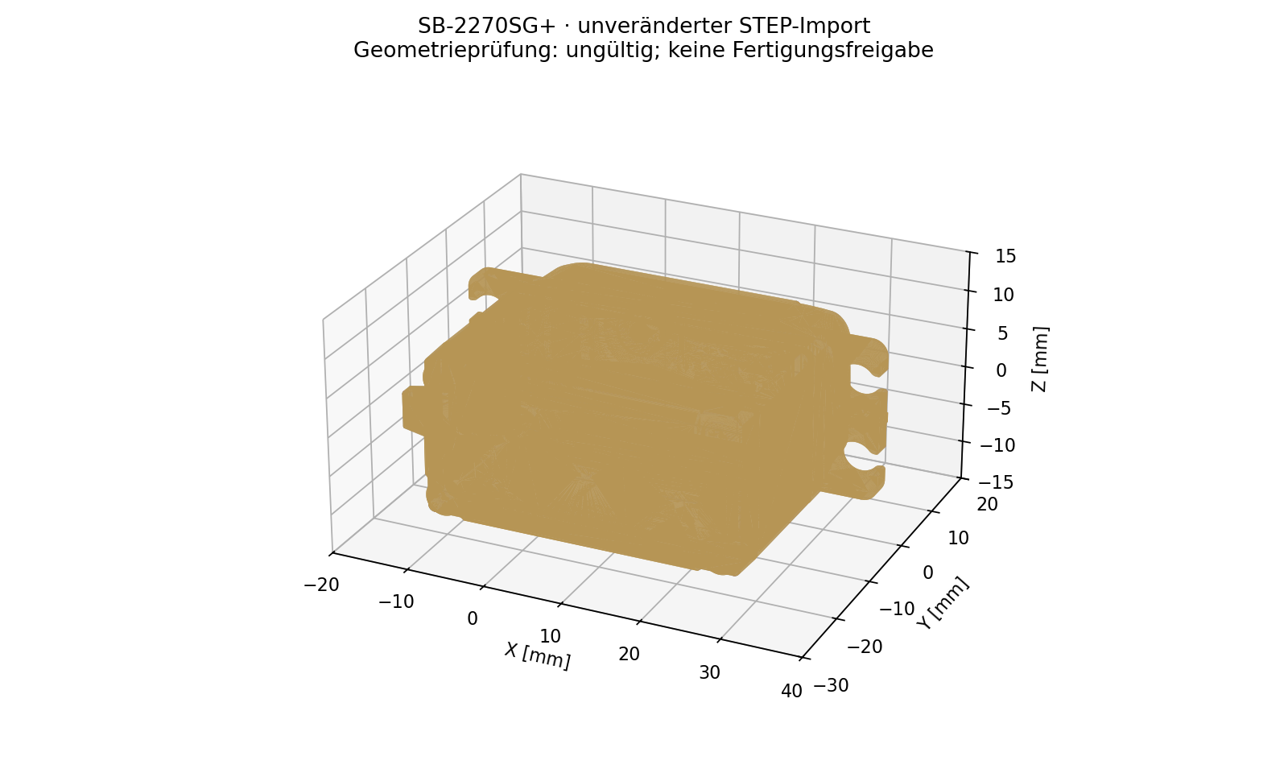
modell_r04_taumel/fertigung_p07/Ausgabe/STEP_Vorschau.png
