ITSMEEME/PropBoard/begegnung/results/Flow_Interaktiv.html

# Direkte Begegnung zweier gegenläufiger Flügel

Vorhandenes Modell: lokaler gerader 2D-Bahnausschnitt, Re = 40, künstliche Viskosität. Ebenenabstand 240 mm, Sehne 120 mm, Pitch 12°. Keine reale Fluglast, keine vollständige 3D-Strömung, kein Konvergenznachweis.

AbspielenDirekt übereinander

Oben: ← Unten: →
x horizontal, z nach oben. Bildbereich: eine periodische Länge von 480 mm, z ungefähr −360 bis +360 mm. Dunkel: bewegte Festkörperzellen.

Alle Bilder sind gespeicherte CFD-Zeitfelder; es wird keine Zwischenströmung erfunden oder interpoliert. Die Animation ist verlangsamt und zeigt keine reale Flugzeit. Die Farben ändern sich beim Umschalten der Größe; Farbbereiche bleiben innerhalb einer Größe konstant.

Spaltmittel beziehen sich auf das zentrale Rechteck |x| < 60 mm, |z| < 60 mm. Das Vorzeichen von u_z ist nach oben positiv. Cp stammt aus dem LBM-Dichtefeld, nicht aus einer Bernoulli-Schätzung. Rand- und Zeiteinflüsse sind nicht abschließend untersucht.
