ITSMEEME/PropBoard/begegnung/results/Kraefte.csv

# step | passages | encounter_phase | Cx_lower | Cz_lower | Cx_upper | Cz_upper
1.000000000000000000e+00 | 4.166666666666666934e-04 | 8.333333333333333868e-04 | -4.722222222222224985e+01 | 5.555555555555521607e+00 | 4.722222222222225696e+01 | 5.555555555555567793e+00
1.100000000000000000e+01 | 4.583333333333333356e-03 | 9.166666666666666713e-03 | -6.741190563185177176e+00 | 8.555033417165791576e+00 | 6.741190563185139872e+00 | 8.555033417165674337e+00
2.100000000000000000e+01 | 8.750000000000000833e-03 | 1.750000000000000167e-02 | -2.793984586553338367e+00 | 5.678166844448606199e+00 | 2.793984586553328153e+00 | 5.678166844448640838e+00
3.100000000000000000e+01 | 1.291666666666666657e-02 | 2.583333333333333315e-02 | -1.705760984039713879e+00 | 4.080094960453427788e+00 | 1.705760984039778494e+00 | 4.080094960453513941e+00
4.100000000000000000e+01 | 1.708333333333333232e-02 | 3.416666666666666463e-02 | -3.095892172572414669e+00 | 1.878482366289401018e+00 | 3.095892172572396461e+00 | 1.878482366289319971e+00
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
