ITSMEEME/PropBoard/cfd/results/forward_c12.csv

step | cycles | Cx | Cz | Cmoment | wall_power_proxy
1 | 0.00010721062894555556 | -0.8107676524459593 | 4.60848002241983 | 106.8312891094716 | 45.78428233837828
11 | 0.0011793169184011112 | 0.09979688535022732 | 6.366611750540943 | 27.575448043384938 | 9.76840263948812
21 | 0.002251423207856667 | 0.3305547202495429 | 2.228006847928264 | 2.959023386216537 | 1.825867621428652
31 | 0.0033235294973122226 | 0.1402225779141391 | 0.2939252100095596 | -0.1797005794180771 | 0.3791797412758366
41 | 0.004395635786767778 | 0.3154379173075412 | -1.4741707848861152 | -4.24370969425672 | -0.7721508932334517
51 | 0.0054677420762233335 | -0.0077286408288022 | -0.45012632858624824 | 1.6481330146987505 | 2.200462241741982
61 | 0.006539848365678889 | -0.1072781607286424 | -1.157067669933981 | 0.873083209764899 | 1.1693101389381202
71 | 0.007611954655134445 | 0.33457593279195463 | -1.0759163129332505 | 2.2331194149579434 | 0.086004594217322
81 | 0.00868406094459 | 0.10555973607604621 | 1.026312924099274 | 6.22818641799628 | 1.457773779559844
91 | 0.009756167234045557 | 0.19605769468542633 | 0.7580754428465684 | 5.381323425821914 | 0.5357341678493284
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
