ITSMEEME/PropBoard/cfd/results/forward_c16.csv

step | cycles | Cx | Cz | Cmoment | wall_power_proxy
1 | 8.040797170916668e-05 | 1.1822069905302135 | 5.573037881934925 | 115.82226876784956 | 48.29532408194913
11 | 0.0008844876888008335 | 0.3079250372144636 | 7.094502126902876 | 26.019274084665778 | 9.718337050090717
21 | 0.0016885674058925004 | -0.1425763204681477 | 3.90632695233206 | 9.379296520868234 | 3.396684010685389
31 | 0.0024926471229841673 | 0.21460236626634313 | 0.683819264037323 | 2.300838886842696 | -0.6966395077350803
41 | 0.0032967268400758342 | -0.23768240151823933 | -0.3261863967238626 | 4.191053583044714 | 0.5777150057954641
51 | 0.004100806557167501 | -0.2690579513931204 | 0.2650572854895039 | 5.182796866556086 | 1.3619415526969203
61 | 0.004904886274259168 | -0.02579285431621159 | 0.17384388085891064 | 7.599812204991965 | 2.7433910958238035
71 | 0.005708965991350835 | 0.36645510399496056 | 0.2545252629808695 | 4.378354580890122 | 2.117399040260166
81 | 0.006513045708442501 | 0.0003435506097412185 | -0.9819756827889572 | 2.7013726994789162 | -0.1021864896891775
91 | 0.0073171254255341685 | 0.052128334370594616 | -0.6745755278950347 | 7.742112653556423 | 0.46842643427246416
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
