ITSMEEME/PropBoard/cfd/results/rest_control.csv

step | cycles | Cx | Cz | Cmoment | wall_power_proxy
1 | 8.040797170916668e-05 | 0.0 | -6.071532165918825e-14 | -4.336808689942018e-14 | 0.0
11 | 0.0008844876888008335 | 0.0 | -6.071532165918825e-14 | -4.336808689942018e-14 | 0.0
21 | 0.0016885674058925004 | 0.0 | -6.071532165918825e-14 | -4.336808689942018e-14 | 0.0
31 | 0.0024926471229841673 | 0.0 | -5.637851296924623e-14 | -4.7704895589362195e-14 | 0.0
41 | 0.0032967268400758342 | 2.236166980751353e-15 | 2.168404344971009e-14 | 5.204170427930421e-14 | 0.0
51 | 0.004100806557167501 | -6.708500942254059e-15 | 7.37257477290143e-14 | -2.6020852139652106e-14 | 0.0
61 | 0.004904886274259168 | -1.2265037076242269e-14 | -5.204170427930421e-14 | -7.806255641895632e-14 | 0.0
71 | 0.005708965991350835 | -4.160625836913123e-14 | -1.1709383462843448e-13 | 2.1250362580715887e-13 | 0.0
81 | 0.006513045708442501 | -6.152847328855238e-14 | 9.324138683375338e-14 | 1.3877787807814457e-13 | 0.0
91 | 0.0073171254255341685 | -4.092863201132779e-14 | 1.973247953923618e-13 | 6.158268339717665e-13 | 0.0
101 | 0.008121205142625836 | 7.968885967768458e-14 | 9.324138683375338e-14 | 4.336808689942018e-14 | 0.0
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
