ITSMEEME/PropBoard/cfd/results/reverse_c16.csv

step | cycles | Cx | Cz | Cmoment | wall_power_proxy
1 | 8.040797170916668e-05 | 0.7859361071702118 | 5.440950285126127 | -111.31774415655622 | 47.74873421801192
11 | 0.0008844876888008335 | 0.9529733896054012 | 7.414005373904729 | -26.444528845640317 | 10.042023874846034
21 | 0.0016885674058925004 | 0.22440705547377177 | 3.583539455631931 | -11.795899968768163 | 3.690327136587575
31 | 0.0024926471229841673 | 0.0983586188098307 | 1.5447244374112172 | -6.681641280873234 | 2.8540425830107985
41 | 0.0032967268400758342 | -0.4061310948048309 | 0.3122370318661379 | -5.955148182868342 | 2.895701741936143
51 | 0.004100806557167501 | -0.2593816781649481 | -0.22414080465454392 | -3.3862016167048465 | 1.709696709127547
61 | 0.004904886274259168 | -0.5483671297364863 | -0.425317267581393 | 0.8334410573764992 | -0.11755045649041661
71 | 0.005708965991350835 | -0.08185328505102932 | 0.13635894473940008 | -0.0687850384823837 | 1.2436877833500708
81 | 0.006513045708442501 | -0.3273972596847961 | -0.8682457416246696 | -1.4167274572191522 | 1.444556137939741
91 | 0.0073171254255341685 | -0.6085265256644116 | -0.36239885532993166 | -7.457404950567239 | 1.5237711593054926
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
