ITSMEEME/PropBoard/cfd/results/zero_pitch_c12.csv

step | cycles | Cx | Cz | Cmoment | wall_power_proxy
1 | 0.00010721062894555556 | 1.880729368538188e-12 | 8.00285763583967e-12 | 109.23353909460162 | 43.3566958161684
11 | 0.0011793169184011112 | 6.719162263616832e-12 | 1.0662766965670773e-11 | 30.562188697557634 | 8.972667349433
21 | 0.002251423207856667 | 1.3722385496424867e-12 | 4.7184478546569145e-12 | 19.2626721158891 | 5.183988064549905
31 | 0.0033235294973122226 | -7.384772047341891e-13 | -5.134329737986146e-12 | 3.8942324061967097 | 1.6819510527576453
41 | 0.004395635786767778 | -5.417938956272146e-12 | -7.794690818722453e-12 | 7.3598321670181255 | 2.717594829217236
51 | 0.0054677420762233335 | 4.123879334081796e-09 | -3.2173085087276266e-10 | 4.82581144221419 | 1.250294565472883
61 | 0.006539848365678889 | 1.4193570815919144e-08 | -9.010847623613926e-10 | 3.5893427258821333 | 1.1885719749502979
71 | 0.007611954655134445 | -4.5109303571857815e-08 | -2.5798879236630745e-07 | 8.124832072919547 | 1.520006475272114
81 | 0.00868406094459 | -1.0041412598876635e-06 | -4.015295272200939e-06 | 6.503086658818256 | 1.7580134995109344
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
