ITSMEEME/PropBoard/begegnung/results/Begegnung_Druck.png

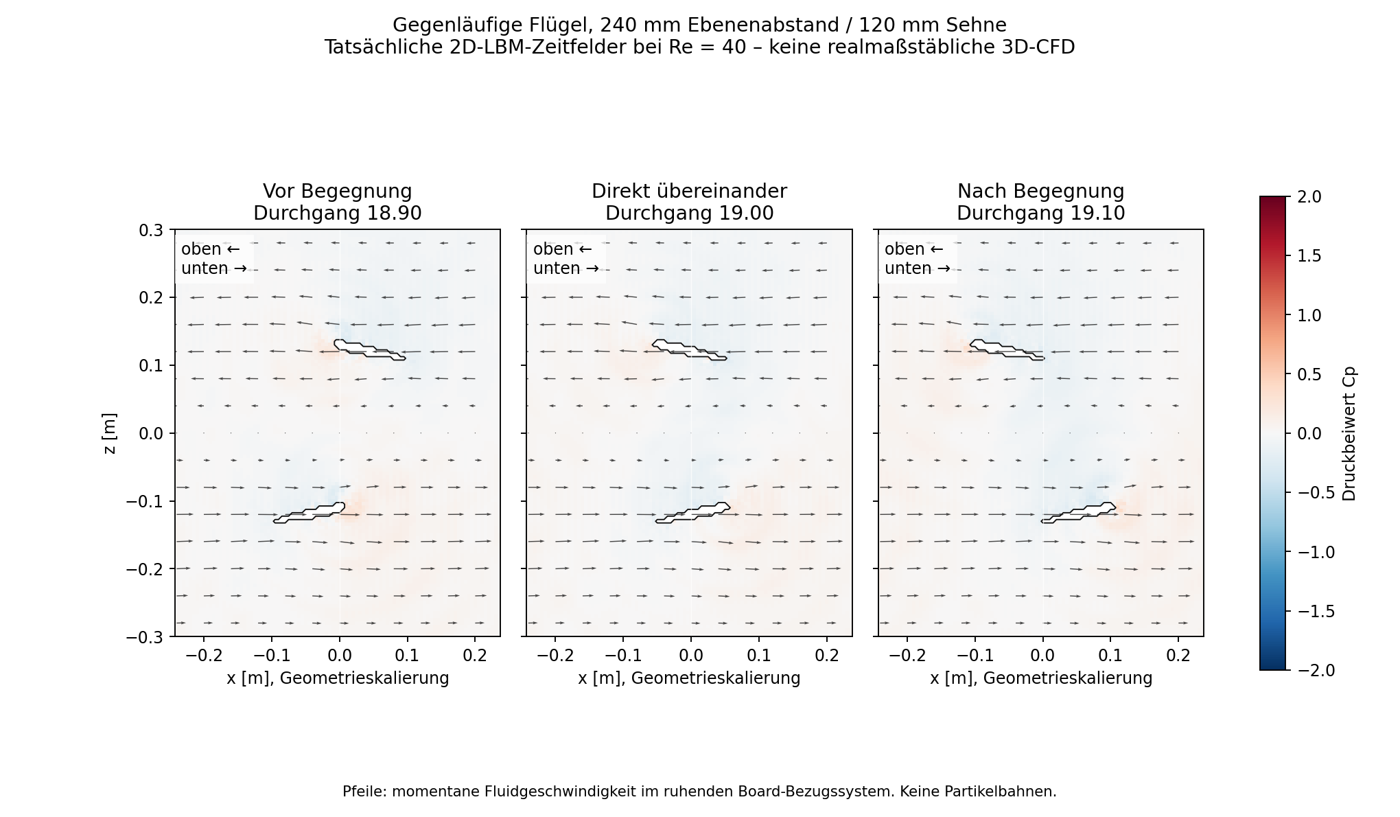
begegnung/results/Begegnung_Druck.png
