ITSMEEME/PropBoard/begegnung/results/Begegnung_Flow.gif

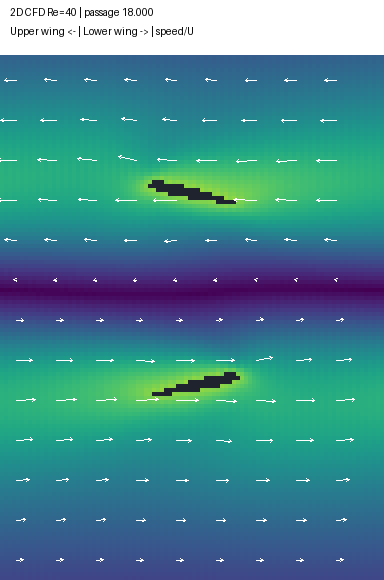
begegnung/results/Begegnung_Flow.gif
