ITSMEEME/PropBoard/begegnung/results/Begegnung_Geschwindigkeit.png

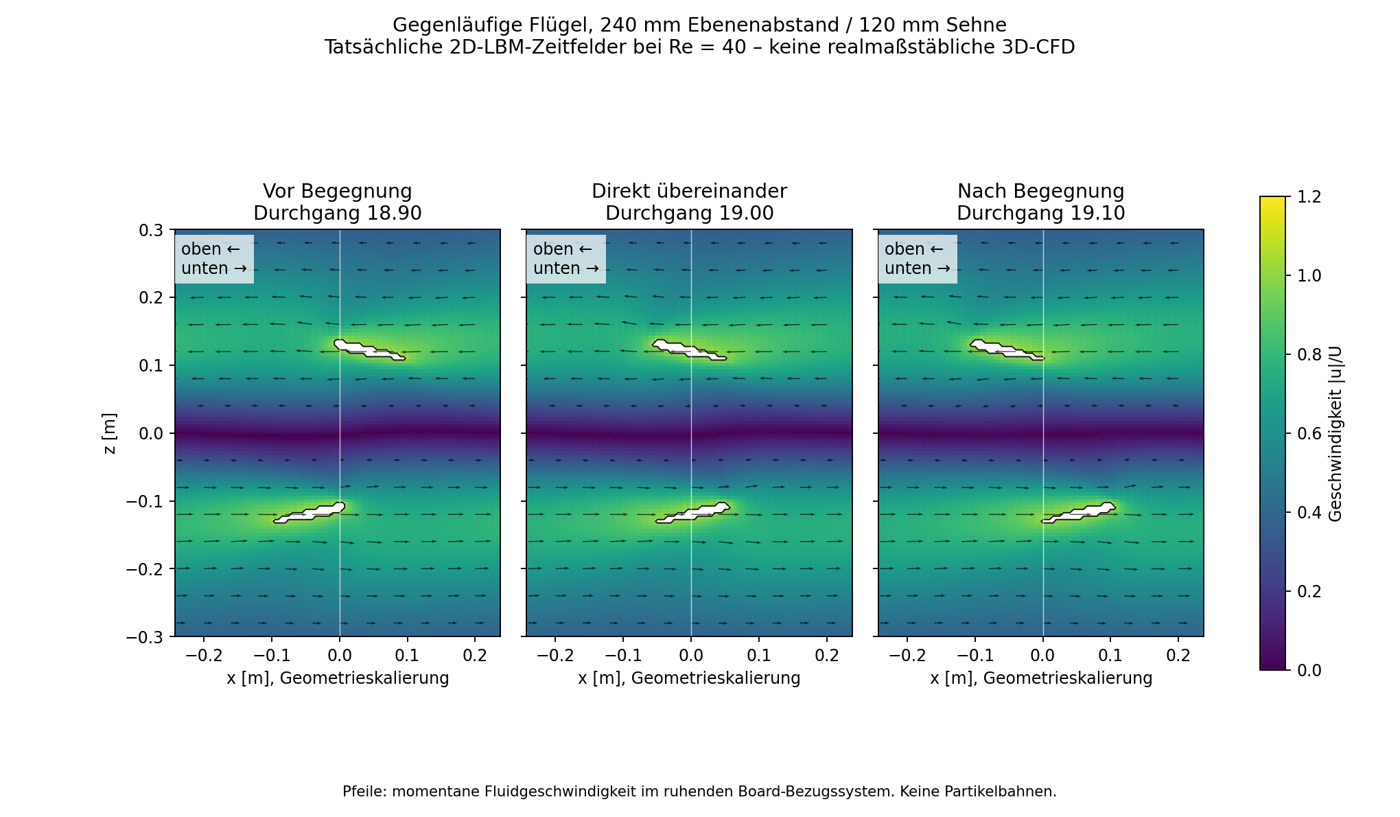
begegnung/results/Begegnung_Geschwindigkeit.png
