ITSMEEME/PropBoard/begegnung/results/Begegnung_Kraefte.png

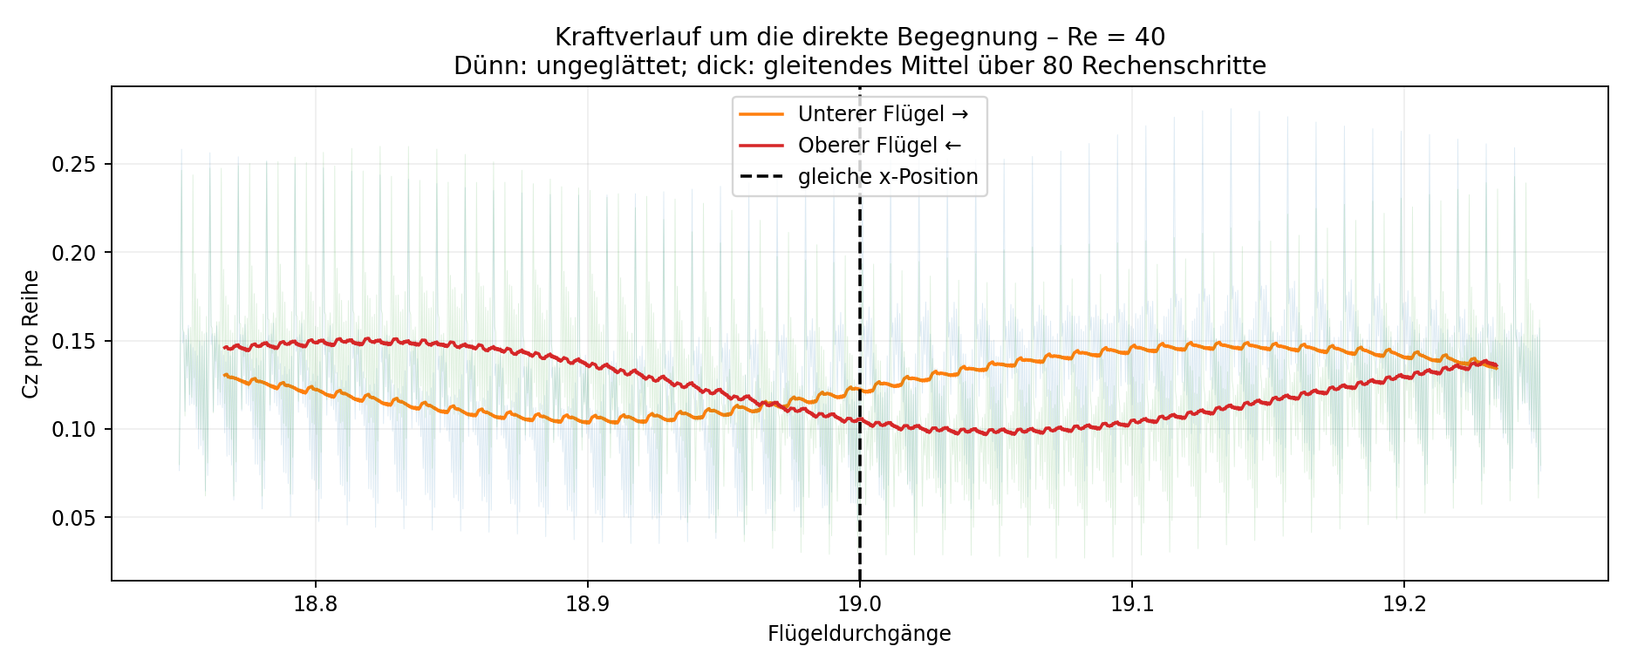
begegnung/results/Begegnung_Kraefte.png
