ITSMEEME/PropBoard/begegnung/results/Begegnung_Wirbel.png

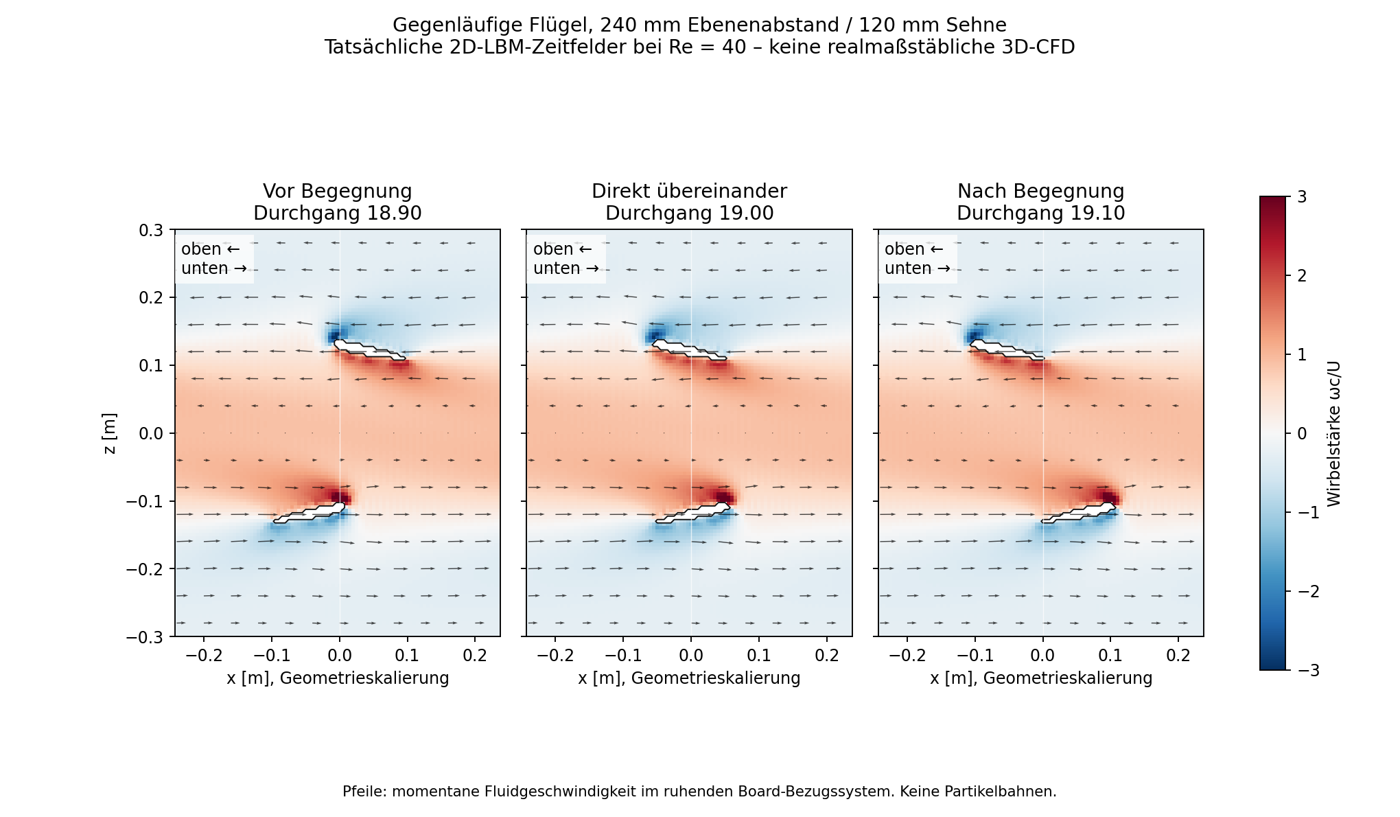
begegnung/results/Begegnung_Wirbel.png
