ITSMEEME/PropBoard/begegnung/results/Flow_Ansicht.png

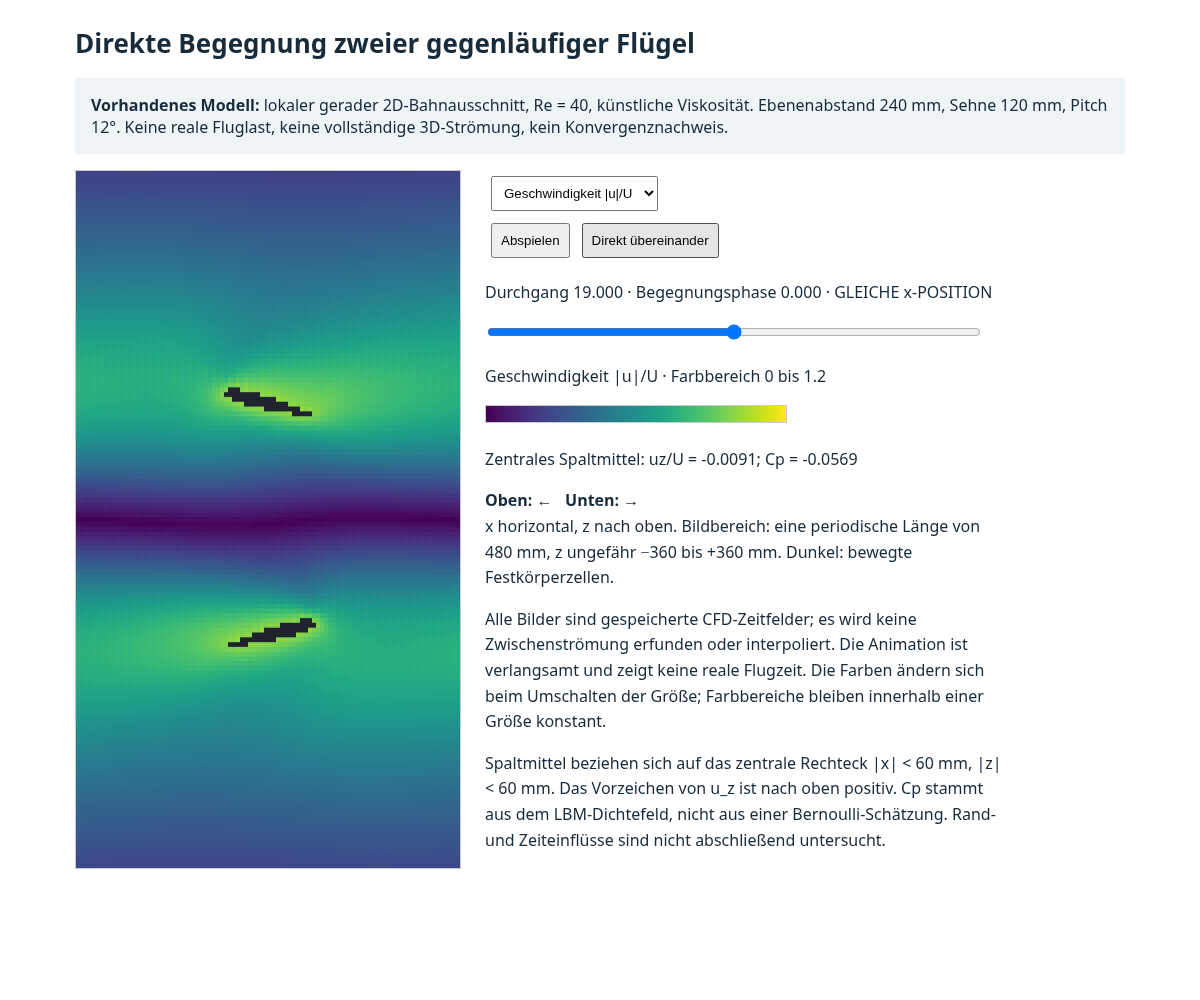
begegnung/results/Flow_Ansicht.png
