ITSMEEME/PropBoard/cfd/results/forward_c12_Stroemung.png

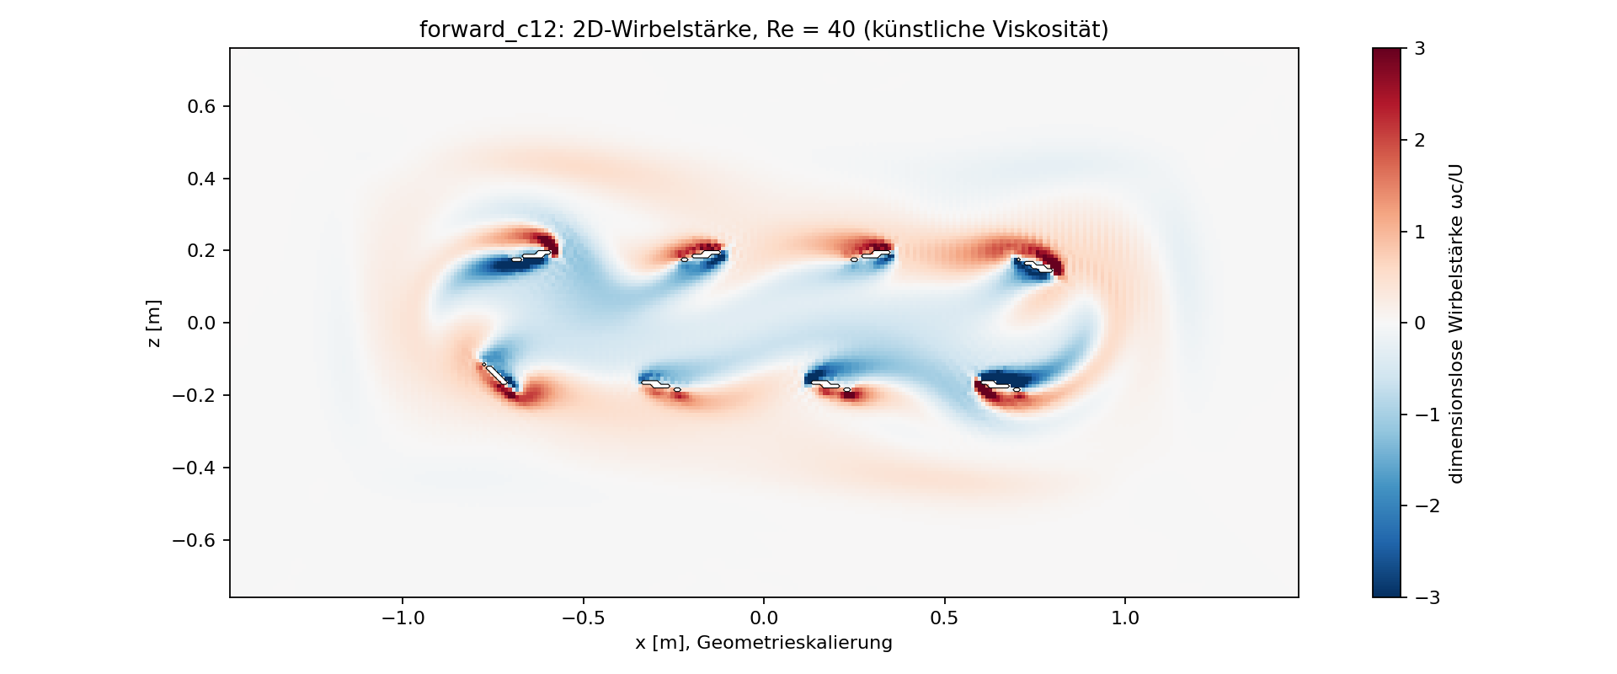
cfd/results/forward_c12_Stroemung.png
