ITSMEEME/PropBoard/cfd/results/reverse_c16_Stroemung.png

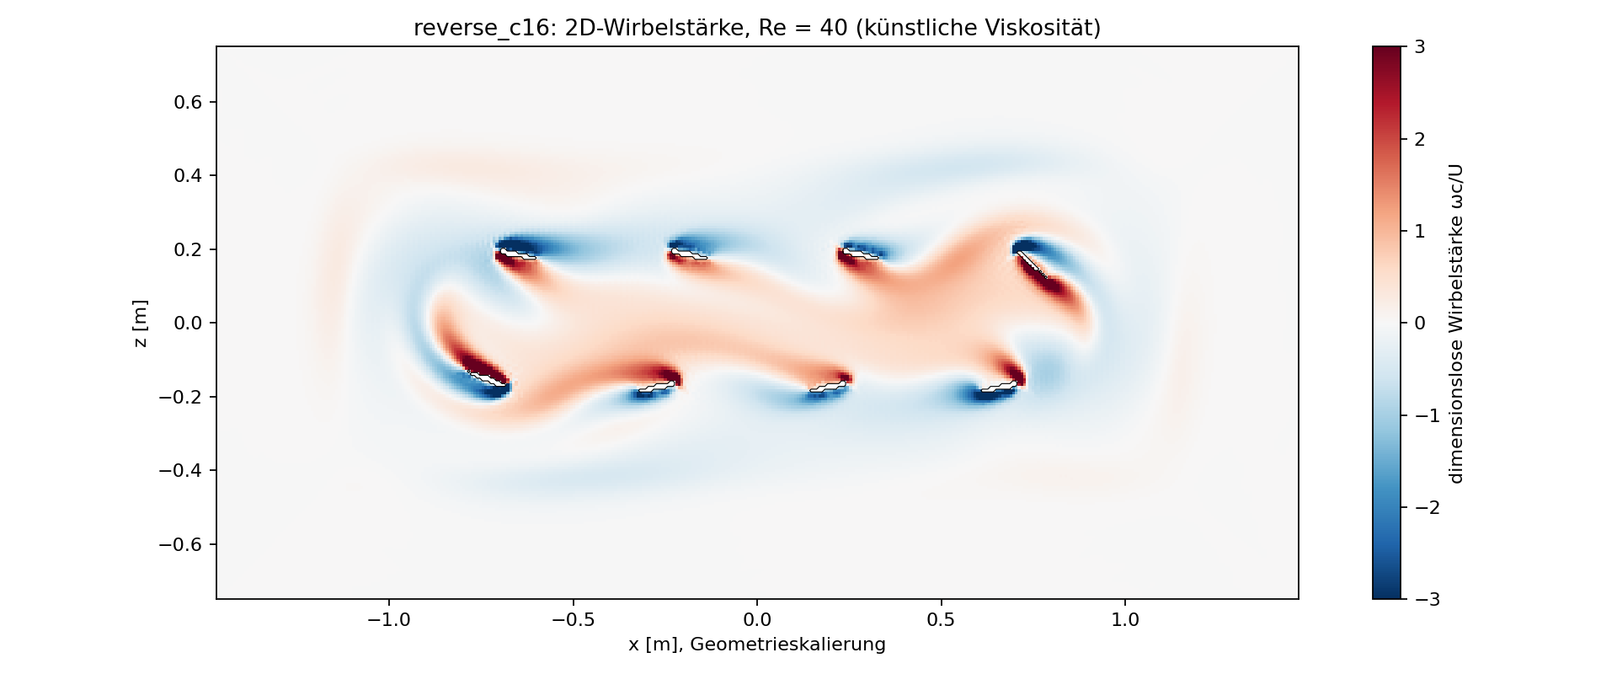
cfd/results/reverse_c16_Stroemung.png
