ITSMEEME/PropBoard/quad_r380_d01/Bauteilpruefblaetter.pdf

# QD_P01 · Zentralplatte oben

### D01 · Bauteilprüfblatt · Maße in mm · keine Fertigungsfreigabe

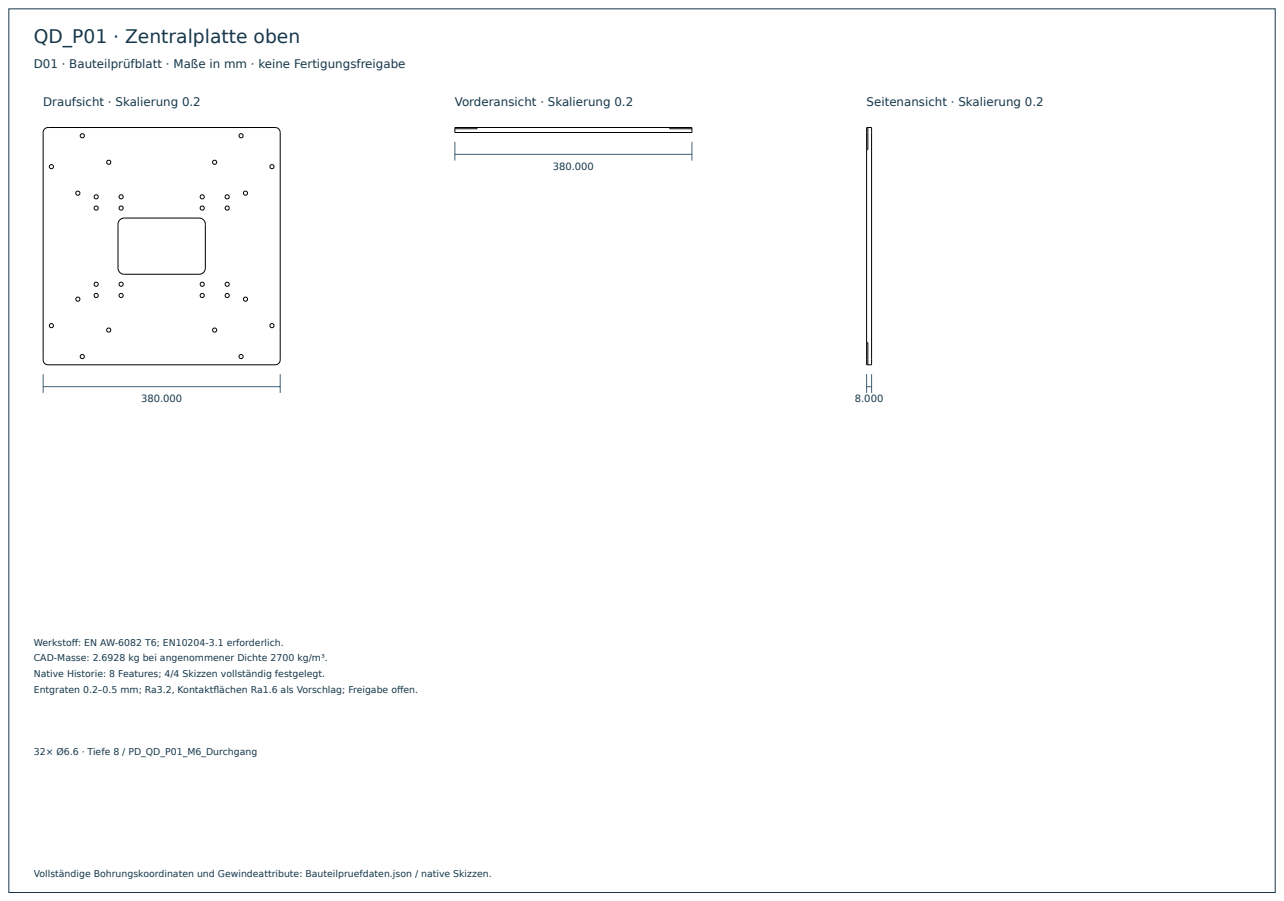
[picture p263: page 1]
Draufsicht · Skalierung 0.2; Vorderansicht · Skalierung 0.2; Seitenansicht · Skalierung 0.2; 32× Ø6.6 · Tiefe 8 / PD_QD_P01_M6_Durchgang

Werkstoff: EN AW-6082 T6; EN10204-3.1 erforderlich.
CAD-Masse: 2.6928 kg bei angenommener Dichte 2700 kg/m³.
Native Historie: 8 Features; 4/4 Skizzen vollständig festgelegt.
Entgraten 0.2–0.5 mm; Ra3.2, Kontaktflächen Ra1.6 als Vorschlag; Freigabe offen.

Vollständige Bohrungskoordinaten und Gewindeattribute: Bauteilpruefdaten.json / native Skizzen.

# QD_P02 · Zentralplatte unten

### D01 · Bauteilprüfblatt · Maße in mm · keine Fertigungsfreigabe

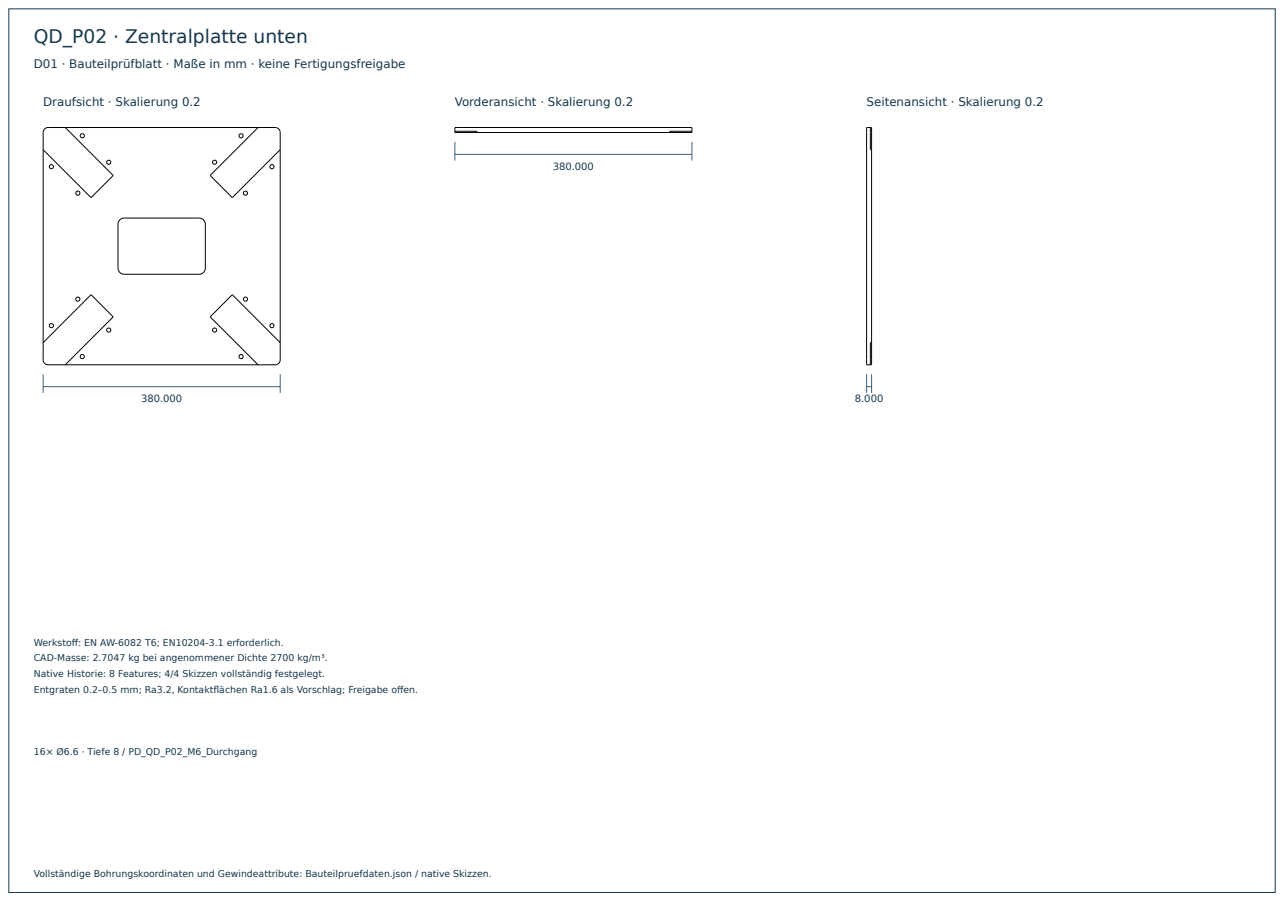
[picture p264: page 2]
Draufsicht · Skalierung 0.2; Vorderansicht · Skalierung 0.2; Seitenansicht · Skalierung 0.2; 16× Ø6.6 · Tiefe 8 / PD_QD_P02_M6_Durchgang

Werkstoff: EN AW-6082 T6; EN10204-3.1 erforderlich.
CAD-Masse: 2.7047 kg bei angenommener Dichte 2700 kg/m³.
Native Historie: 8 Features; 4/4 Skizzen vollständig festgelegt.
Entgraten 0.2–0.5 mm; Ra3.2, Kontaktflächen Ra1.6 als Vorschlag; Freigabe offen.

# QD_R01 · Ausleger 50×50×3 mit Sicherungsbohrungen

### D01 · Bauteilprüfblatt · Maße in mm · keine Fertigungsfreigabe

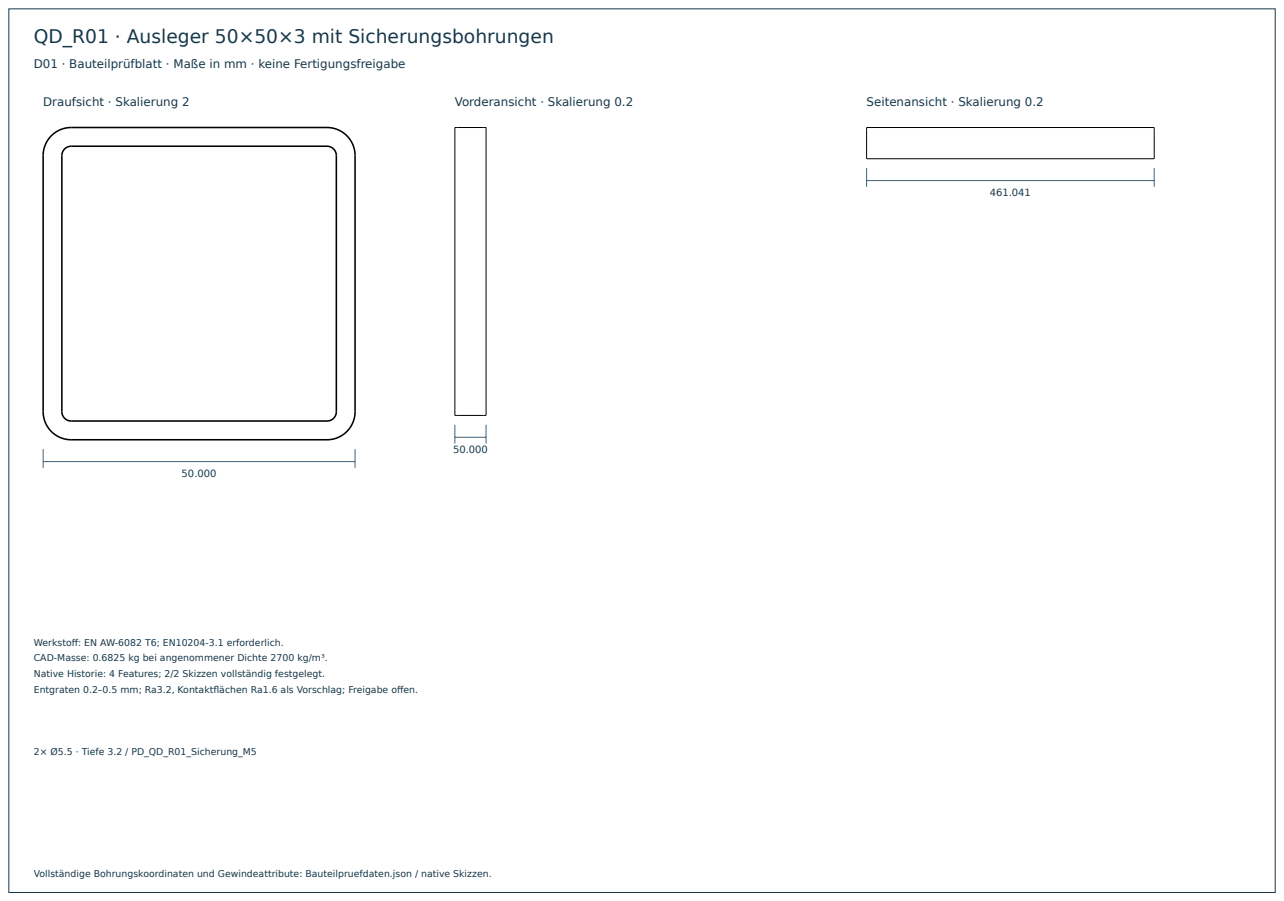
[picture p265: page 3]
Draufsicht · Skalierung 2; Vorderansicht · Skalierung 0.2; Seitenansicht · Skalierung 0.2; 2× Ø5.5 · Tiefe 3.2 / PD_QD_R01_Sicherung_M5

Werkstoff: EN AW-6082 T6; EN10204-3.1 erforderlich.
CAD-Masse: 0.6825 kg bei angenommener Dichte 2700 kg/m³.
Native Historie: 4 Features; 2/2 Skizzen vollständig festgelegt.
Entgraten 0.2–0.5 mm; Ra3.2, Kontaktflächen Ra1.6 als Vorschlag; Freigabe offen.

# QD_E01 · Eingepasstes Wurzel-Druckstueck 43.97×43.97×135

### D01 · Bauteilprüfblatt · Maße in mm · keine Fertigungsfreigabe

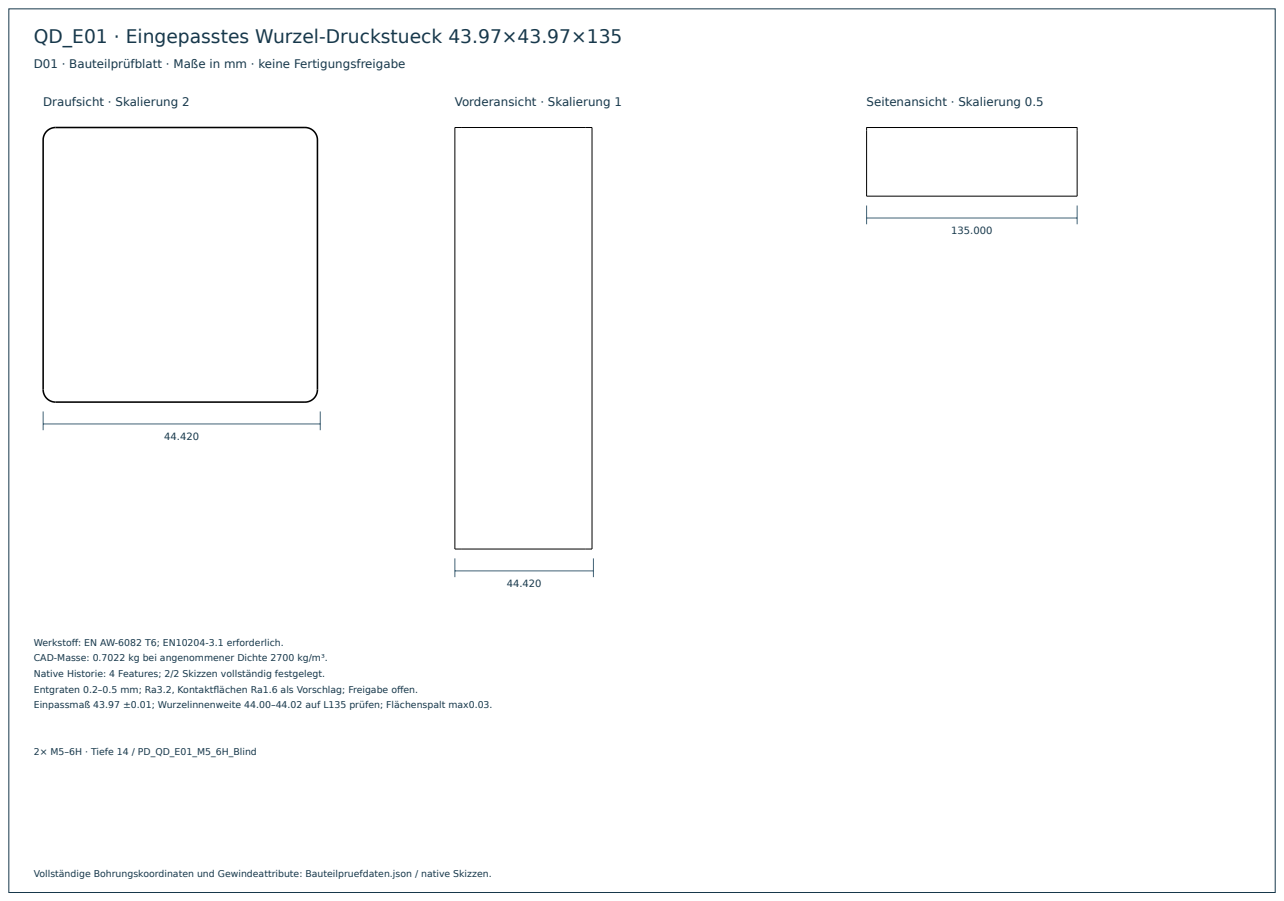
[picture p266: page 4]
Draufsicht · Skalierung 2; Vorderansicht · Skalierung 1; Seitenansicht · Skalierung 0.5; 2× M5–6H · Tiefe 14 / PD_QD_E01_M5_6H_Blind

Werkstoff: EN AW-6082 T6; EN10204-3.1 erforderlich.
CAD-Masse: 0.7022 kg bei angenommener Dichte 2700 kg/m³.
Native Historie: 4 Features; 2/2 Skizzen vollständig festgelegt.
Entgraten 0.2–0.5 mm; Ra3.2, Kontaktflächen Ra1.6 als Vorschlag; Freigabe offen.
Einpassmaß 43.97 ±0.01; Wurzelinnenweite 44.00–44.02 auf L135 prüfen; Flächenspalt max0.03.

# QD_M01 · Ausleger-Endtraeger oben, Projekteigenes IF90

### D01 · Bauteilprüfblatt · Maße in mm · keine Fertigungsfreigabe

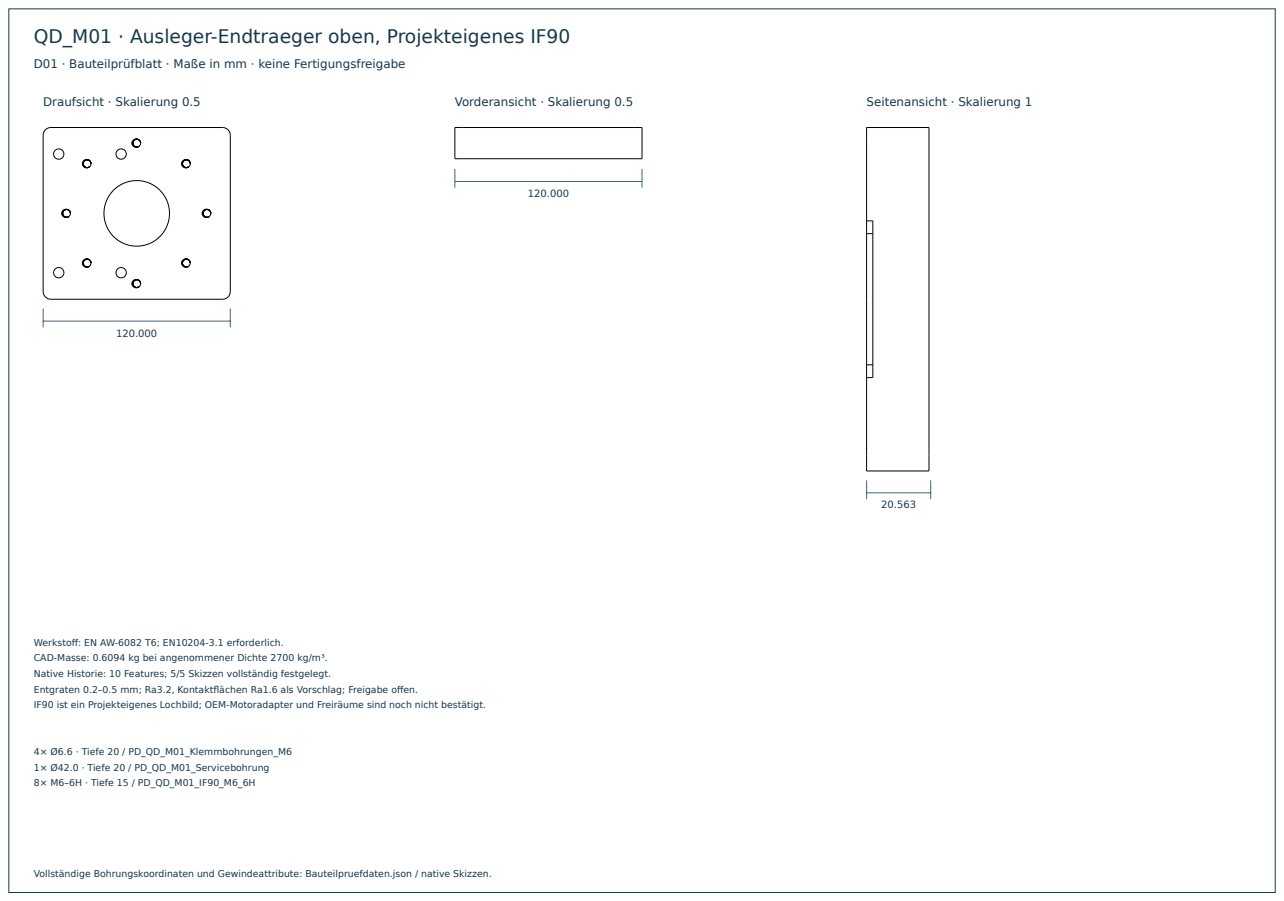
[picture p267: page 5]
Draufsicht · Skalierung 0.5; Vorderansicht · Skalierung 0.5; Seitenansicht · Skalierung 1; 4× Ø6.6 · Tiefe 20 / PD_QD_M01_Klemmbohrungen_M6 1× Ø42.0 · Tiefe 20 / PD_QD_M01_Servicebohrung 8× M6–6H · Tiefe 15 / PD_QD_M01_IF90_M6_6H

Werkstoff: EN AW-6082 T6; EN10204-3.1 erforderlich.
CAD-Masse: 0.6094 kg bei angenommener Dichte 2700 kg/m³.
Native Historie: 10 Features; 5/5 Skizzen vollständig festgelegt.
Entgraten 0.2–0.5 mm; Ra3.2, Kontaktflächen Ra1.6 als Vorschlag; Freigabe offen.
IF90 ist ein Projekteigenes Lochbild; OEM-Motoradapter und Freiräume sind noch nicht bestätigt.

# QD_M02 · Ausleger-Endtraeger unten

### D01 · Bauteilprüfblatt · Maße in mm · keine Fertigungsfreigabe

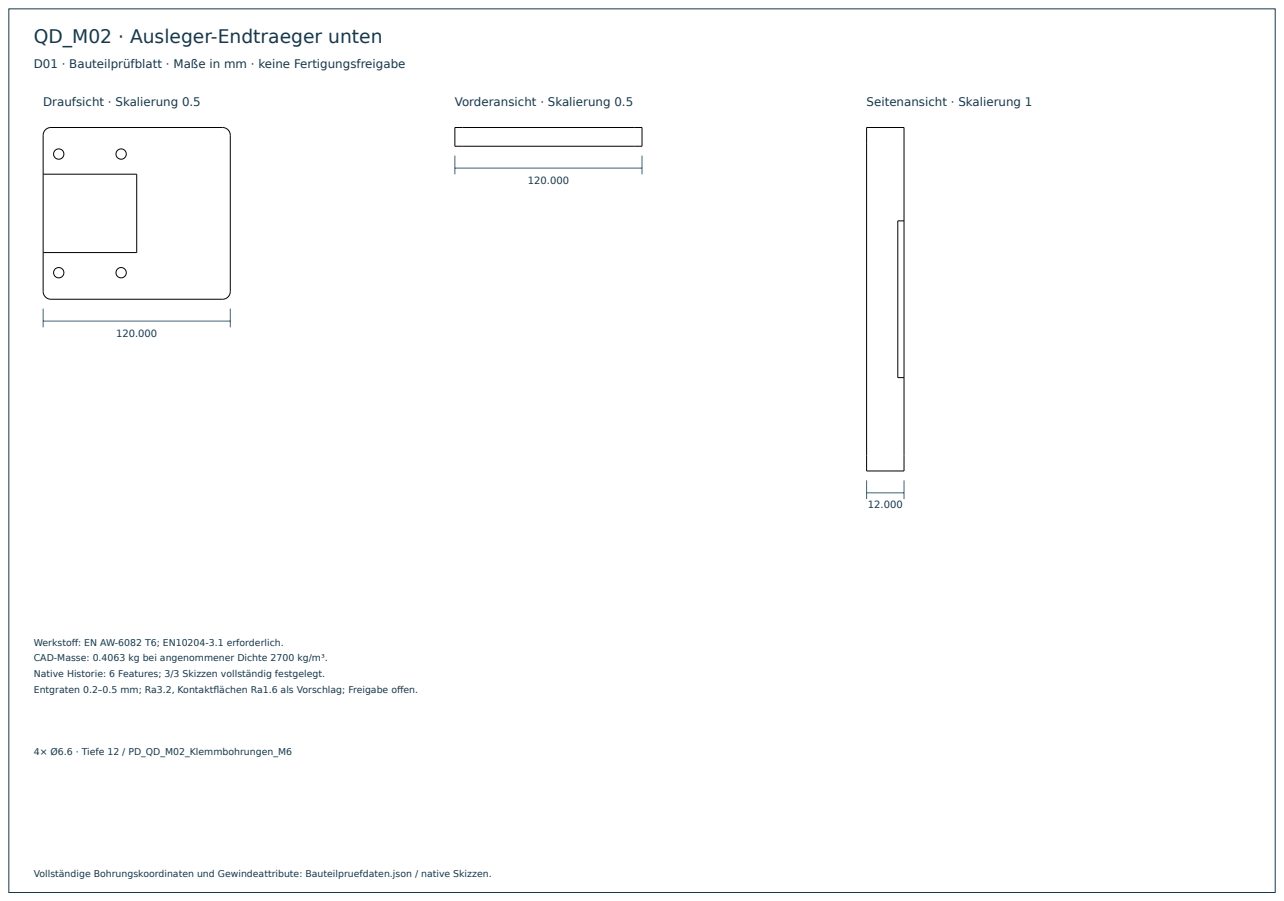
[picture p268: page 6]
Draufsicht · Skalierung 0.5; Vorderansicht · Skalierung 0.5; Seitenansicht · Skalierung 1; 4× Ø6.6 · Tiefe 12 / PD_QD_M02_Klemmbohrungen_M6

Werkstoff: EN AW-6082 T6; EN10204-3.1 erforderlich.
CAD-Masse: 0.4063 kg bei angenommener Dichte 2700 kg/m³.
Native Historie: 6 Features; 3/3 Skizzen vollständig festgelegt.
Entgraten 0.2–0.5 mm; Ra3.2, Kontaktflächen Ra1.6 als Vorschlag; Freigabe offen.

# QD_R02 · Decktraeger 40×30×3, Laenge620

### D01 · Bauteilprüfblatt · Maße in mm · keine Fertigungsfreigabe

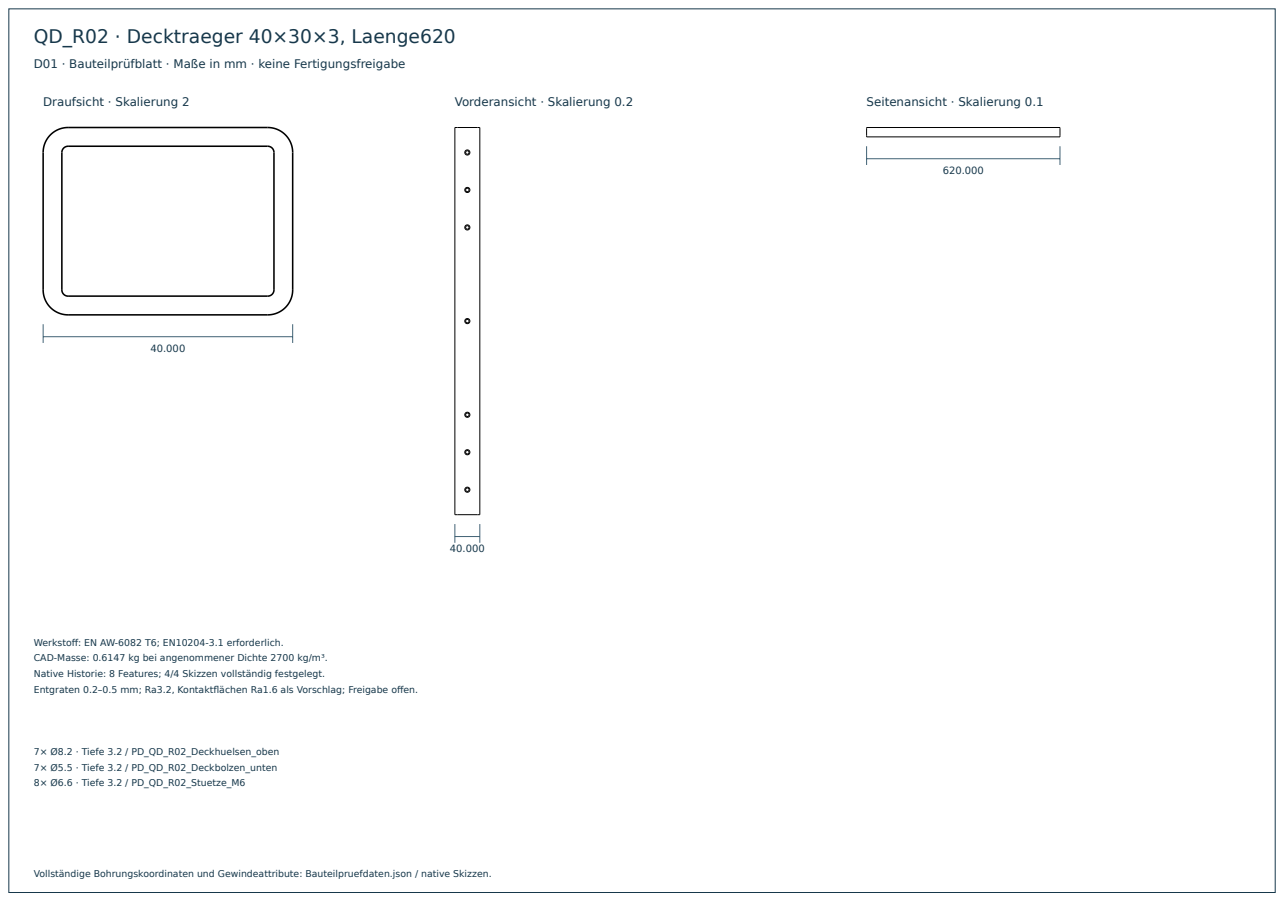
[picture p269: page 7]
Draufsicht · Skalierung 2; Vorderansicht · Skalierung 0.2; Seitenansicht · Skalierung 0.1; 7× Ø8.2 · Tiefe 3.2 / PD_QD_R02_Deckhuelsen_oben 7× Ø5.5 · Tiefe 3.2 / PD_QD_R02_Deckbolzen_unten 8× Ø6.6 · Tiefe 3.2 / PD_QD_R02_Stuetze_M6

Werkstoff: EN AW-6082 T6; EN10204-3.1 erforderlich.
CAD-Masse: 0.6147 kg bei angenommener Dichte 2700 kg/m³.
Native Historie: 8 Features; 4/4 Skizzen vollständig festgelegt.
Entgraten 0.2–0.5 mm; Ra3.2, Kontaktflächen Ra1.6 als Vorschlag; Freigabe offen.

# QD_S01 · Deckstuetze, aus Vollmaterial gefertigt

### D01 · Bauteilprüfblatt · Maße in mm · keine Fertigungsfreigabe

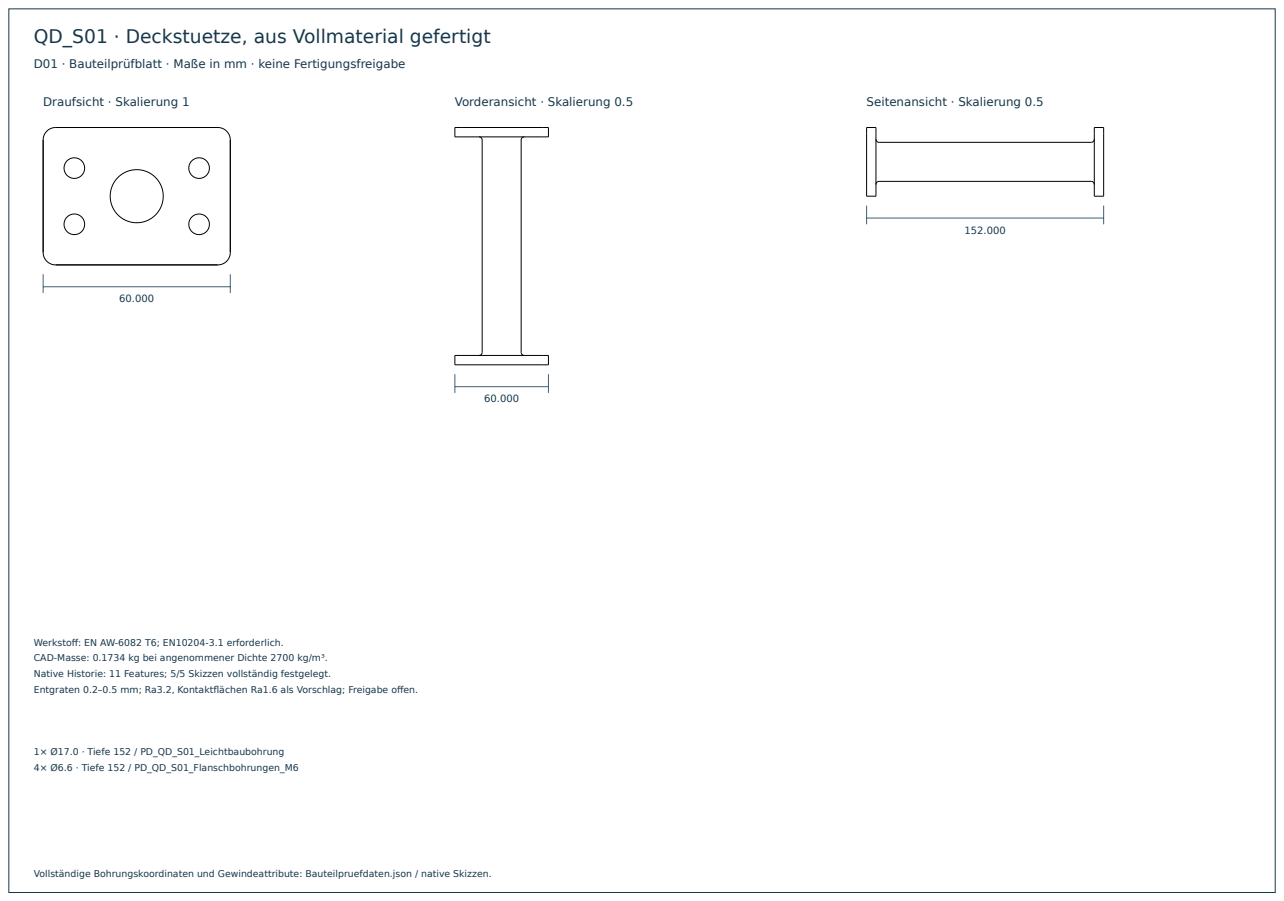
[picture p270: page 8]
Draufsicht · Skalierung 1; Vorderansicht · Skalierung 0.5; Seitenansicht · Skalierung 0.5; 1× Ø17.0 · Tiefe 152 / PD_QD_S01_Leichtbaubohrung 4× Ø6.6 · Tiefe 152 / PD_QD_S01_Flanschbohrungen_M6

Werkstoff: EN AW-6082 T6; EN10204-3.1 erforderlich.
CAD-Masse: 0.1734 kg bei angenommener Dichte 2700 kg/m³.
Native Historie: 11 Features; 5/5 Skizzen vollständig festgelegt.
Entgraten 0.2–0.5 mm; Ra3.2, Kontaktflächen Ra1.6 als Vorschlag; Freigabe offen.

# QD_K01 · Kassette fuer vier ISO7719-M6-Muttern

### D01 · Bauteilprüfblatt · Maße in mm · keine Fertigungsfreigabe

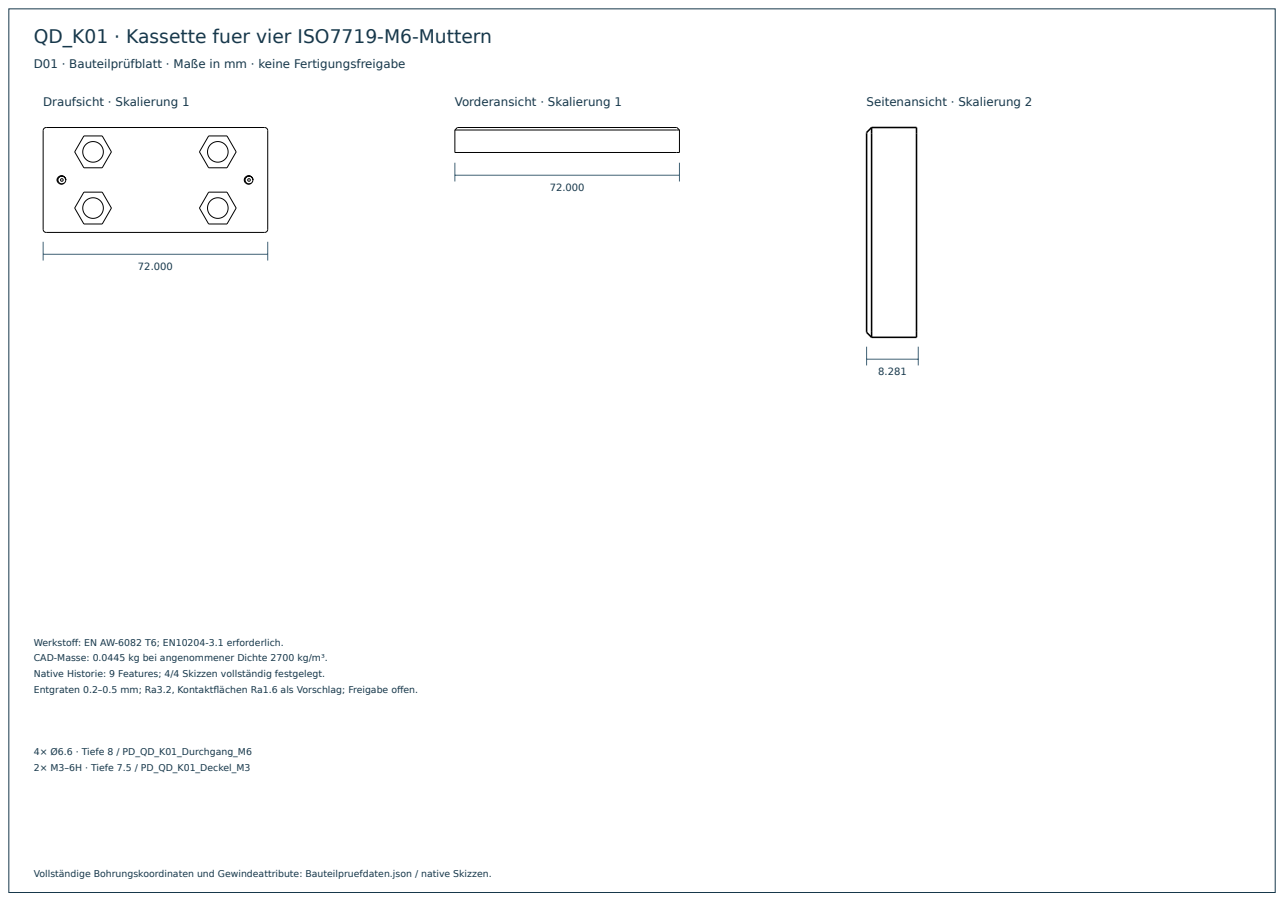
[picture p271: page 9]
Draufsicht · Skalierung 1; Vorderansicht · Skalierung 1; Seitenansicht · Skalierung 2; 4× Ø6.6 · Tiefe 8 / PD_QD_K01_Durchgang_M6 2× M3–6H · Tiefe 7.5 / PD_QD_K01_Deckel_M3

Werkstoff: EN AW-6082 T6; EN10204-3.1 erforderlich.
CAD-Masse: 0.0445 kg bei angenommener Dichte 2700 kg/m³.
Native Historie: 9 Features; 4/4 Skizzen vollständig festgelegt.
Entgraten 0.2–0.5 mm; Ra3.2, Kontaktflächen Ra1.6 als Vorschlag; Freigabe offen.

# QD_K02 · Kassetten-Abdeckblech

### D01 · Bauteilprüfblatt · Maße in mm · keine Fertigungsfreigabe

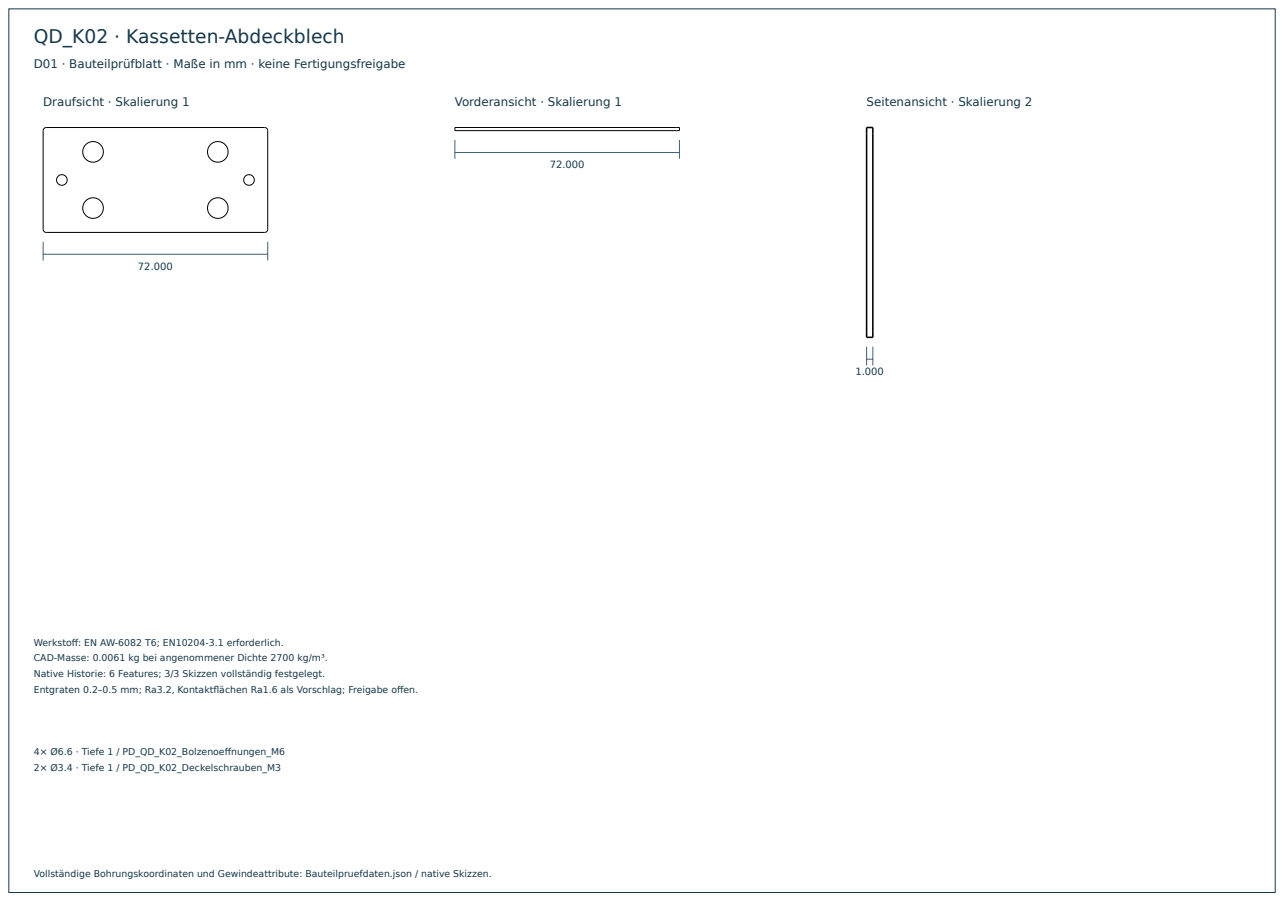
[picture p272: page 10]
Draufsicht · Skalierung 1; Vorderansicht · Skalierung 1; Seitenansicht · Skalierung 2; 4× Ø6.6 · Tiefe 1 / PD_QD_K02_Bolzenoeffnungen_M6 2× Ø3.4 · Tiefe 1 / PD_QD_K02_Deckelschrauben_M3

Werkstoff: EN AW-6082 T6; EN10204-3.1 erforderlich.
CAD-Masse: 0.0061 kg bei angenommener Dichte 2700 kg/m³.
Native Historie: 6 Features; 3/3 Skizzen vollständig festgelegt.
Entgraten 0.2–0.5 mm; Ra3.2, Kontaktflächen Ra1.6 als Vorschlag; Freigabe offen.

# QD_H01 · Hut-Druckhuelse fuer Deckverschraubung

### D01 · Bauteilprüfblatt · Maße in mm · keine Fertigungsfreigabe

### Draufsicht · Skalierung 2

12.000

### Vorderansicht · Skalierung 2

12.000

### Seitenansicht · Skalierung 2

29.000

Werkstoff: EN AW-6082 T6; EN10204-3.1 erforderlich.
CAD-Masse: 0.0024 kg bei angenommener Dichte 2700 kg/m³.
Native Historie: 6 Features; 3/3 Skizzen vollständig festgelegt.
Entgraten 0.2–0.5 mm; Ra3.2, Kontaktflächen Ra1.6 als Vorschlag; Freigabe offen.

1× Ø5.5 · Tiefe 29 / PD_QD_H01_Durchgang_M5

# QD_D01 · Personendeck 620×360×5

### D01 · Bauteilprüfblatt · Maße in mm · keine Fertigungsfreigabe

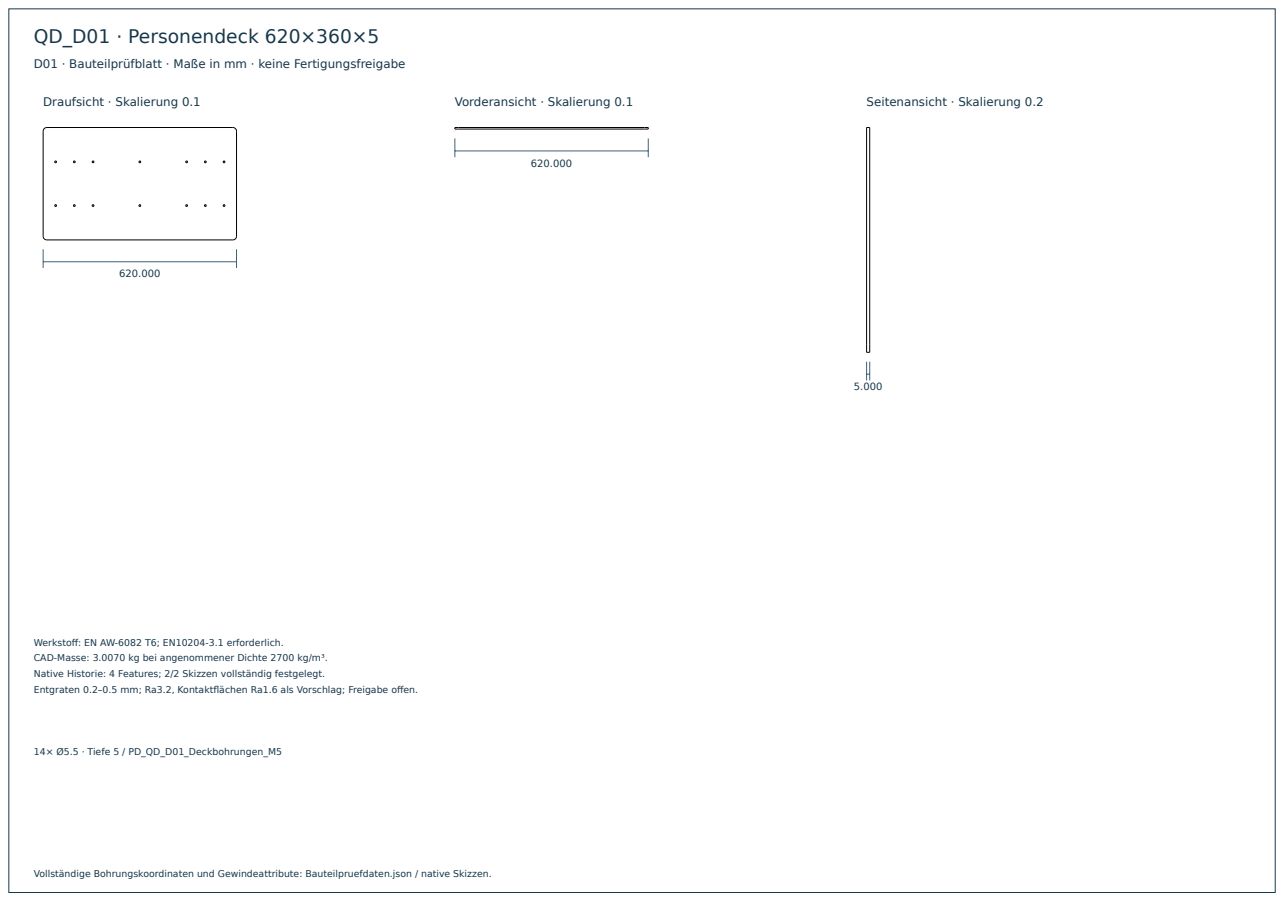
[picture p273: page 12]
Draufsicht · Skalierung 0.1; Vorderansicht · Skalierung 0.1; Seitenansicht · Skalierung 0.2; 14× Ø5.5 · Tiefe 5 / PD_QD_D01_Deckbohrungen_M5

Werkstoff: EN AW-6082 T6; EN10204-3.1 erforderlich.
CAD-Masse: 3.0070 kg bei angenommener Dichte 2700 kg/m³.
Native Historie: 4 Features; 2/2 Skizzen vollständig festgelegt.
Entgraten 0.2–0.5 mm; Ra3.2, Kontaktflächen Ra1.6 als Vorschlag; Freigabe offen.
