ITSMEEME/PropBoard/horizontal_z_r02/Referenzblaetter.pdf

## VORENTWURF - NICHT ZUR FERTIGUNG FREIGEGEBEN

## R02-BAT-BRIDGE

24 x 200 x 5 mm; 2 x D5.5

Lochmitten ab links/unten: (12,16), (12,184)

M5x80 mit zwei Scheiben und Mutter; Distanzrohre 63.5 mm

Geometrische Rueckhaltung; Stoss-/Brand-/Landelast offen

## PropBoard - R02-BAT-BRIDGE

Alle Masse mm. Werkstoff-/Toleranz-/Lastfreigabe fehlt.

Referenzansicht; Massstab 0.9:1

Keine Gewinde oder Passungen freigegeben.

## R02-CTRL-CASE

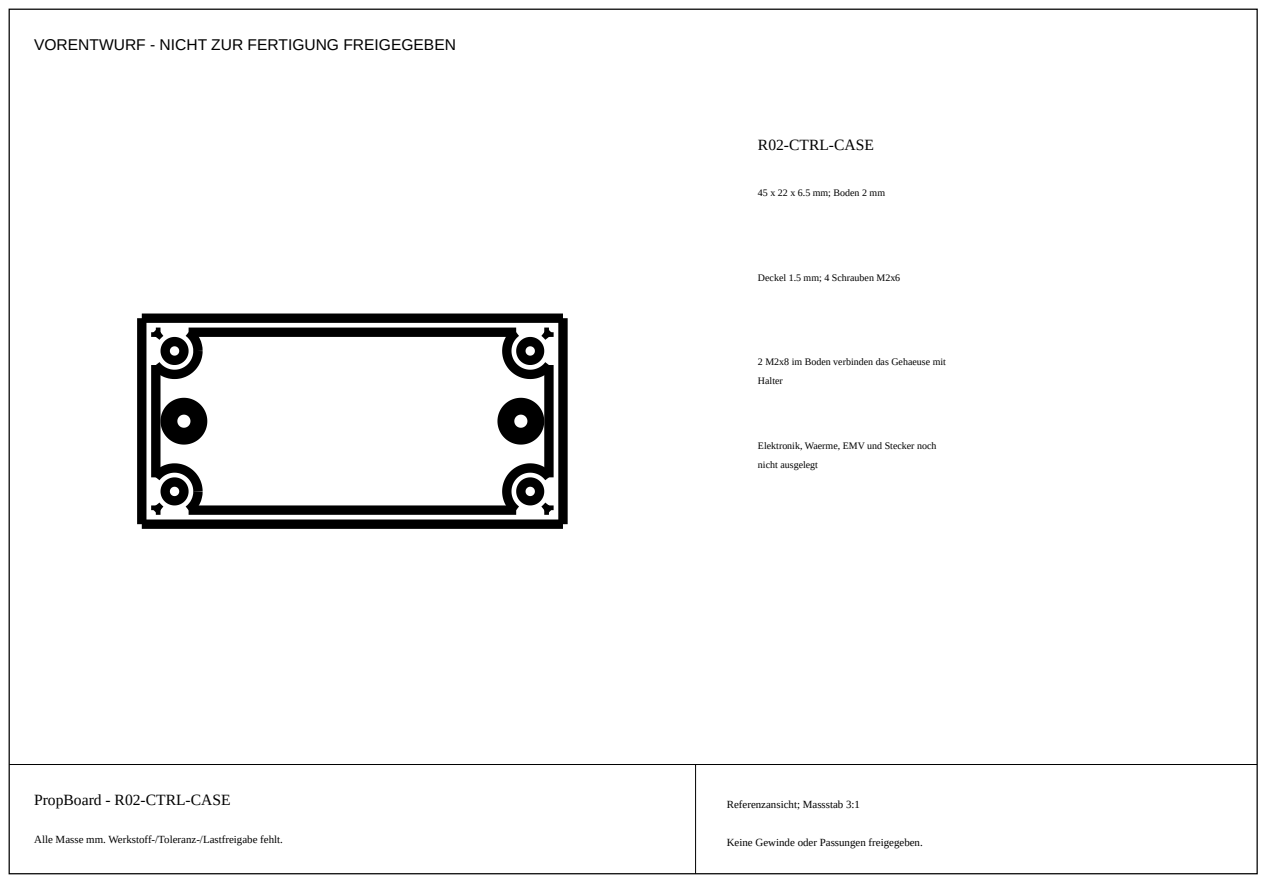
[picture p274: page 2]
Referenzansicht; Massstab 3:1

45 x 22 x 6.5 mm; Boden 2 mm

Deckel 1.5 mm; 4 Schrauben M2x6

2 M2x8 im Boden verbinden das Gehaeuse mit
Halter

Elektronik, Waerme, EMV und Stecker noch
nicht ausgelegt

PropBoard - R02-CTRL-CASE

## R02-GUIDE-MOUNT

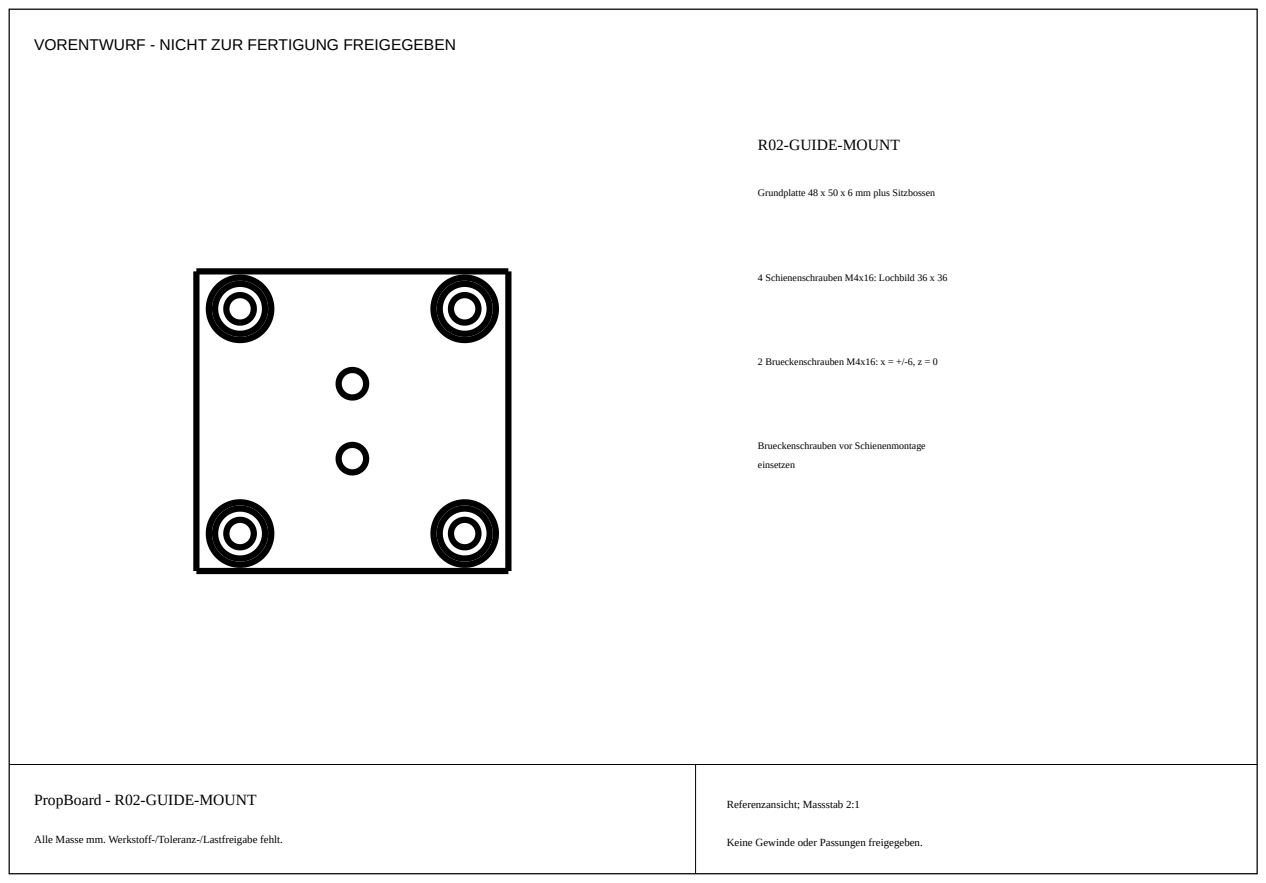
[picture p275: page 3]
4 Schienenschrauben M4x16: Lochbild 36 x 36; 2 Brueckenschrauben M4x16: x = +/-6, z = 0; Referenzansicht; Massstab 2:1

Grundplatte 48 x 50 x 6 mm plus Sitzbossen

Brueckenschrauben vor Schienenmontage
einsetzen

PropBoard - R02-GUIDE-MOUNT

## R02-KNOTEN

90 x 80 x 8 mm; 4 x D6.6

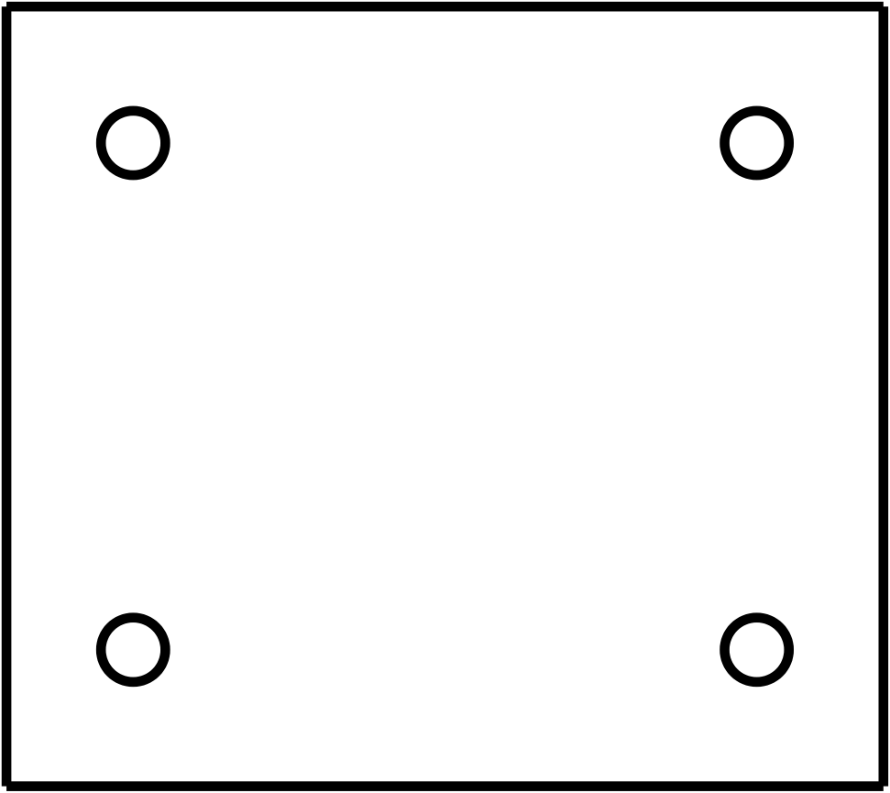
[picture p276: figure]

Lochbild 64 x 52; Randabstand 13 / 14 mm

Mittlere Knotenplatte: z = 286 bis 294 mm

CFK-Klemmdruck, Legierung, Passungen und Momente offen

## PropBoard - R02-KNOTEN

Referenzansicht; Massstab 1.5:1
