ITSMEEME/PropBoard/quad_r380_d09/Ausgabe/Propeller_Struktur_Vergleich.pdf

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

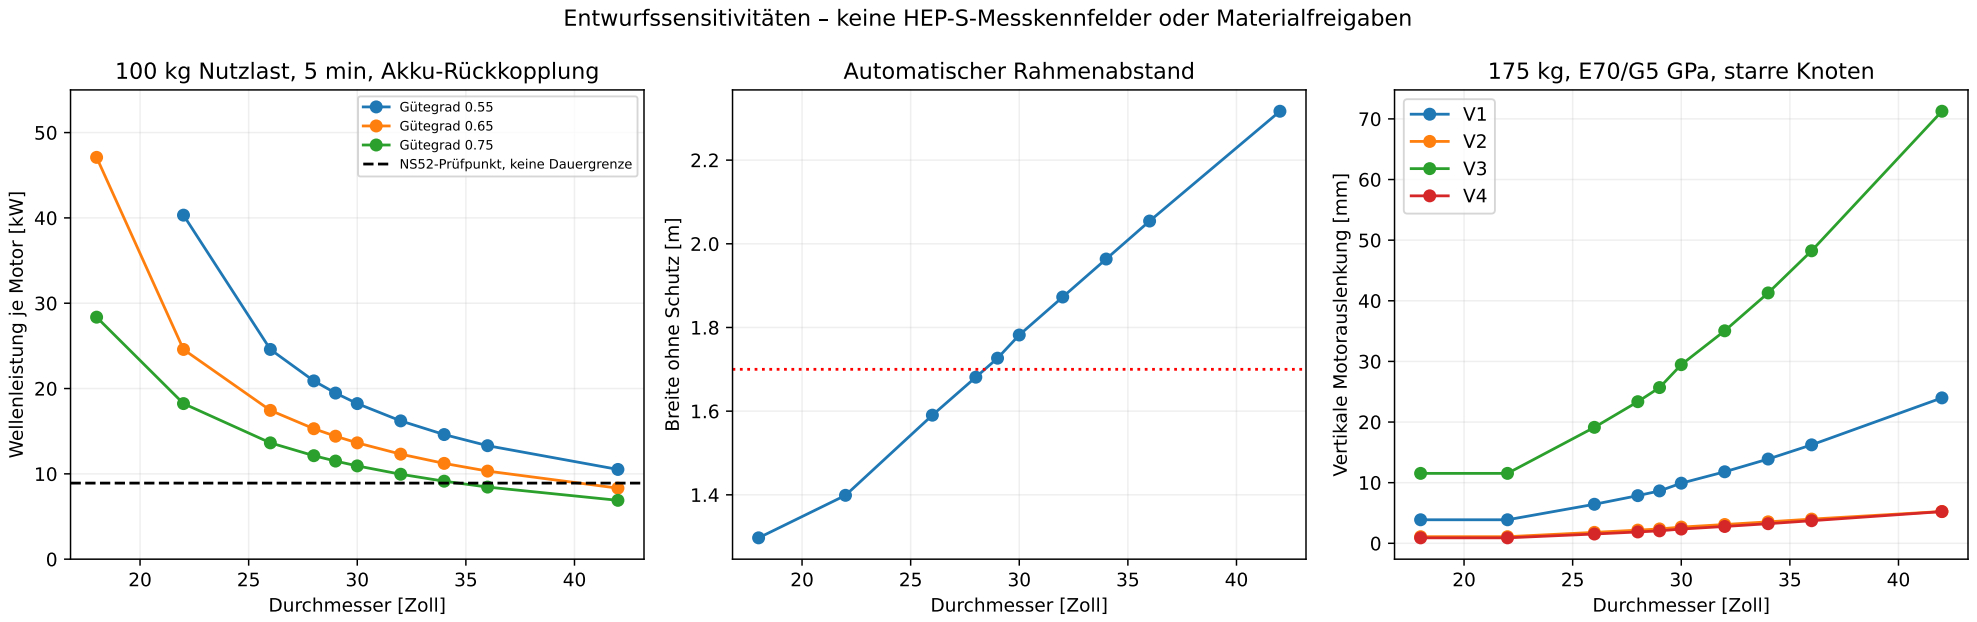
[picture p277: page 1]
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
