ITSMEEME/PropBoard/quad_r380_d12/Ausgabe/Festigkeit/04_Alufuss_Bodenauflage.pdf

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

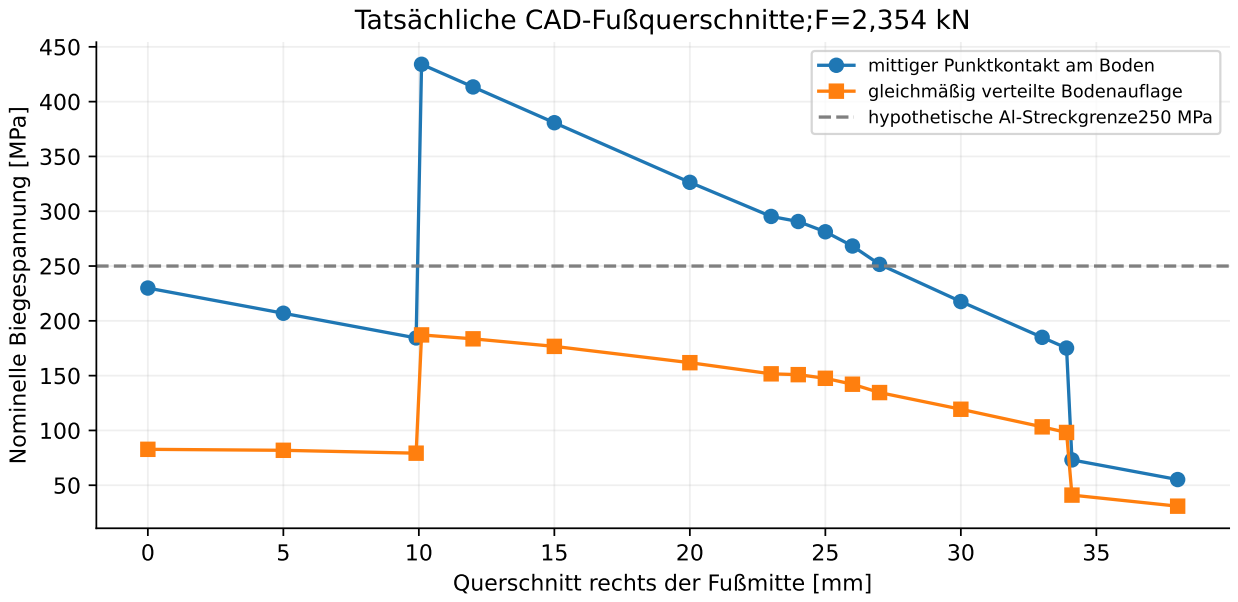
[picture p281: page 1]
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
