ITSMEEME/PropBoard/modell_r04_taumel/halterungen/Ausgabe/Halterungen_H01_Zeichnungen.pdf

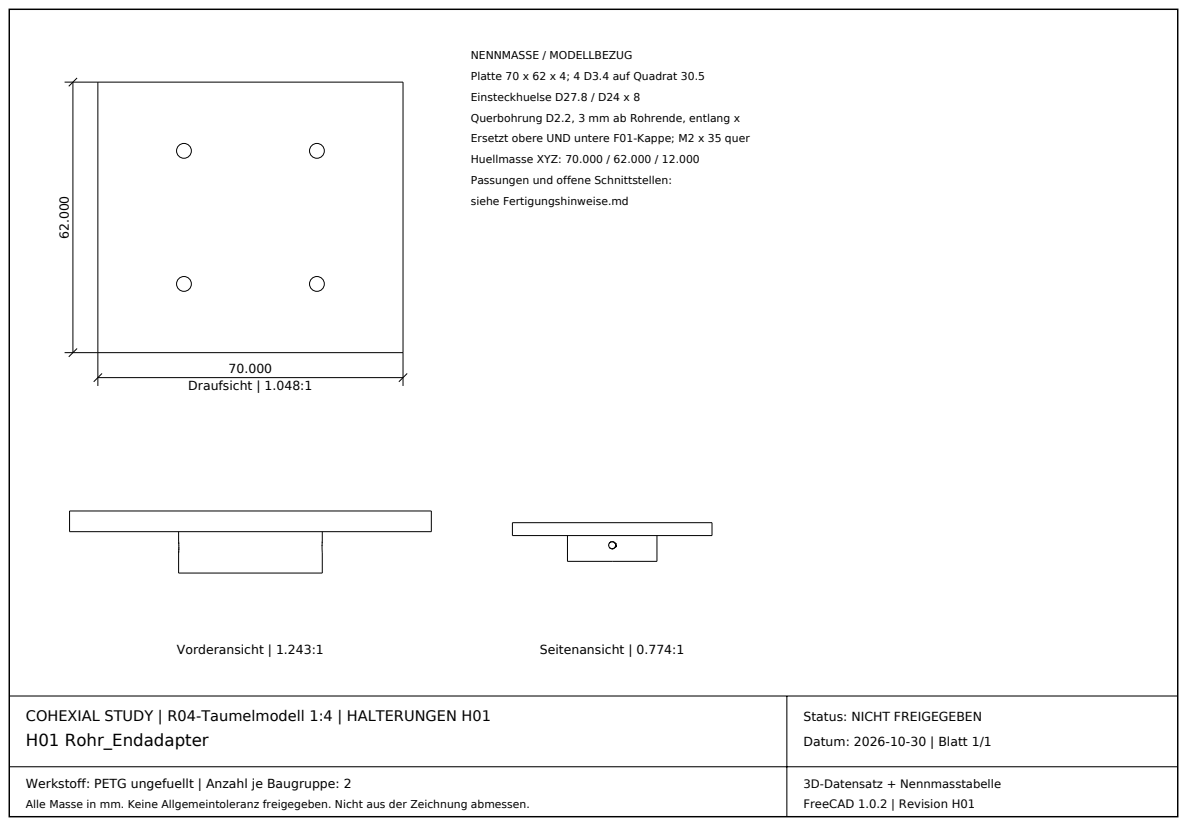
[picture p282: page 1]
Datum: 2026-10-30 | Blatt 1/1; 3D-Datensatz + Nennmasstabelle; FreeCAD 1.0.2 | Revision H01; Draufsicht | 1.048:1; Vorderansicht | 1.243:1; Seitenansicht | 0.774:1

NENNMASSE / MODELLBEZUG
Platte 70 x 62 x 4; 4 D3.4 auf Quadrat 30.5
Einsteckhuelse D27.8 / D24 x 8
Querbohrung D2.2, 3 mm ab Rohrende, entlang x
Ersetzt obere UND untere F01-Kappe; M2 x 35 quer
Huellmasse XYZ: 70.000 / 62.000 / 12.000
Passungen und offene Schnittstellen:
siehe Fertigungshinweise.md

COHEXIAL STUDY | R04-Taumelmodell 1:4 | HALTERUNGEN H01
H01 Rohr_Endadapter

Status: NICHT FREIGEGEBEN

Werkstoff: PETG ungefuellt | Anzahl je Baugruppe: 2

Alle Masse in mm. Keine Allgemeintoleranz freigegeben. Nicht aus der Zeichnung abmessen.

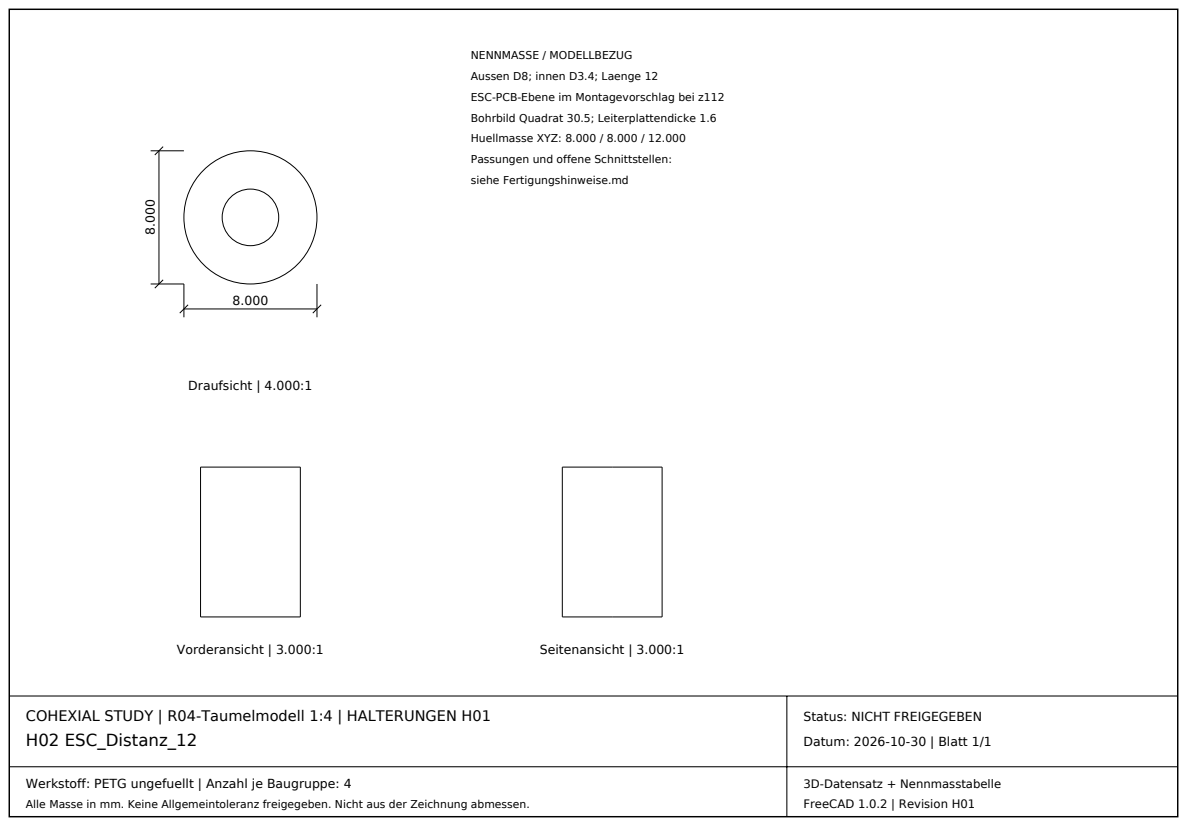
[picture p283: page 2]
Datum: 2026-10-30 | Blatt 1/1; Draufsicht | 4.000:1; Vorderansicht | 3.000:1; Seitenansicht | 3.000:1

NENNMASSE / MODELLBEZUG
Aussen D8; innen D3.4; Laenge 12
ESC-PCB-Ebene im Montagevorschlag bei z112
Bohrbild Quadrat 30.5; Leiterplattendicke 1.6
Huellmasse XYZ: 8.000 / 8.000 / 12.000
Passungen und offene Schnittstellen:
siehe Fertigungshinweise.md

COHEXIAL STUDY | R04-Taumelmodell 1:4 | HALTERUNGEN H01
H02 ESC_Distanz_12

Status: NICHT FREIGEGEBEN

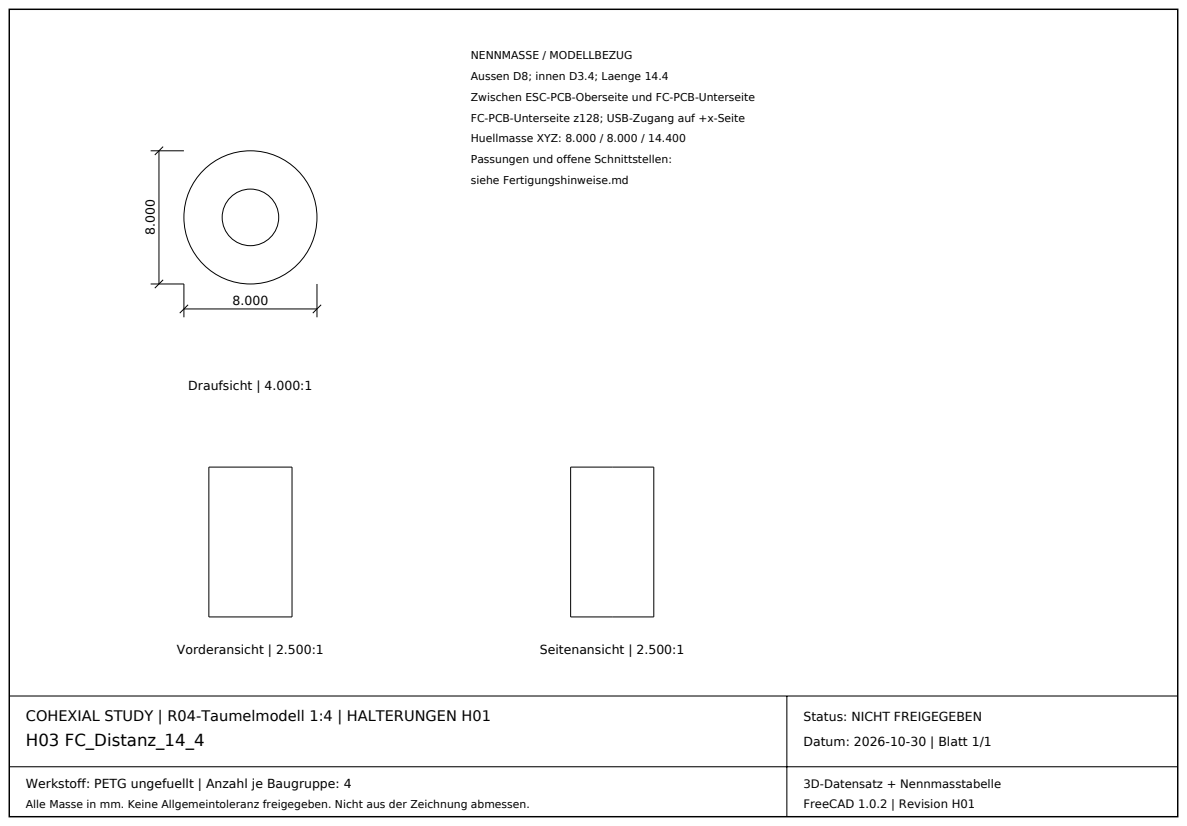
[picture p284: page 3]
Datum: 2026-10-30 | Blatt 1/1; Draufsicht | 4.000:1; Vorderansicht | 2.500:1; Seitenansicht | 2.500:1

NENNMASSE / MODELLBEZUG
Aussen D8; innen D3.4; Laenge 14.4
Zwischen ESC-PCB-Oberseite und FC-PCB-Unterseite
FC-PCB-Unterseite z128; USB-Zugang auf +x-Seite
Huellmasse XYZ: 8.000 / 8.000 / 14.400
Passungen und offene Schnittstellen:
siehe Fertigungshinweise.md

COHEXIAL STUDY | R04-Taumelmodell 1:4 | HALTERUNGEN H01
H03 FC_Distanz_14_4

Status: NICHT FREIGEGEBEN

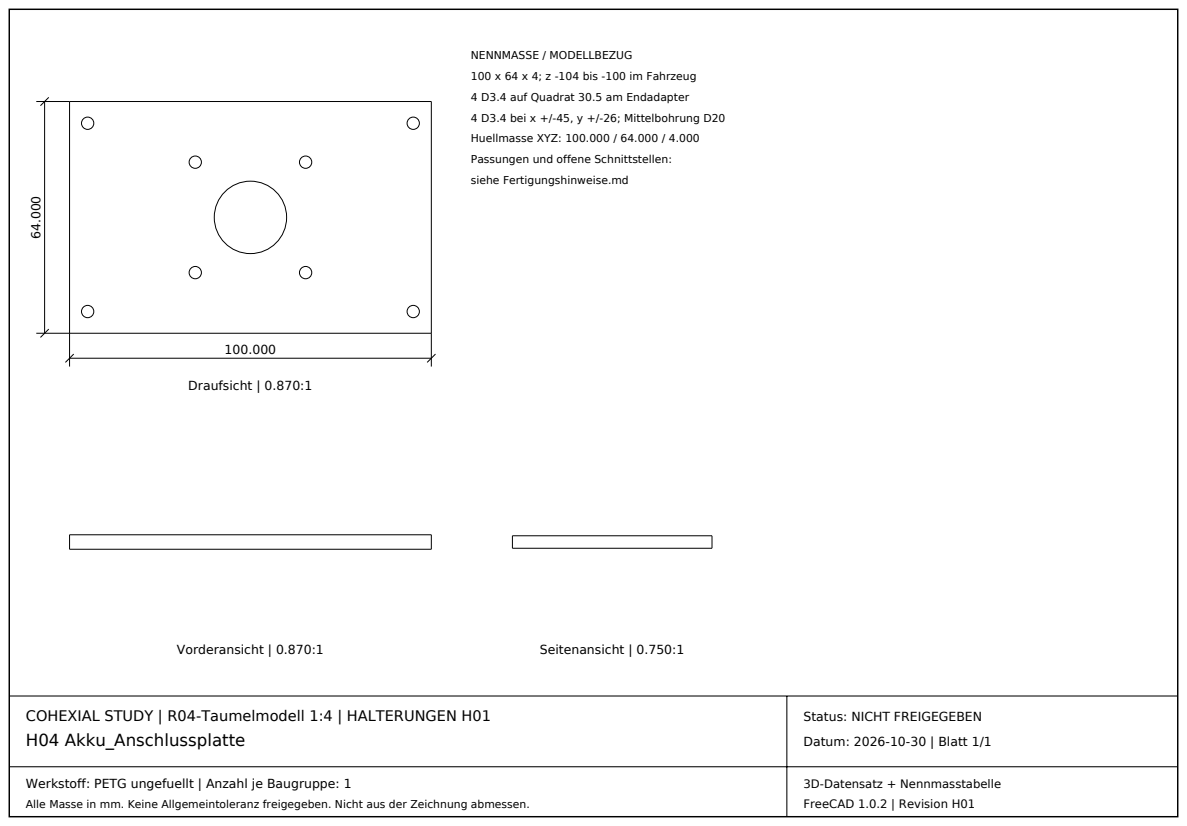
[picture p285: page 4]
Datum: 2026-10-30 | Blatt 1/1; Draufsicht | 0.870:1; Vorderansicht | 0.870:1; Seitenansicht | 0.750:1

NENNMASSE / MODELLBEZUG
100 x 64 x 4; z -104 bis -100 im Fahrzeug
4 D3.4 auf Quadrat 30.5 am Endadapter
4 D3.4 bei x +/-45, y +/-26; Mittelbohrung D20
Huellmasse XYZ: 100.000 / 64.000 / 4.000
Passungen und offene Schnittstellen:
siehe Fertigungshinweise.md

COHEXIAL STUDY | R04-Taumelmodell 1:4 | HALTERUNGEN H01
H04 Akku_Anschlussplatte

Status: NICHT FREIGEGEBEN

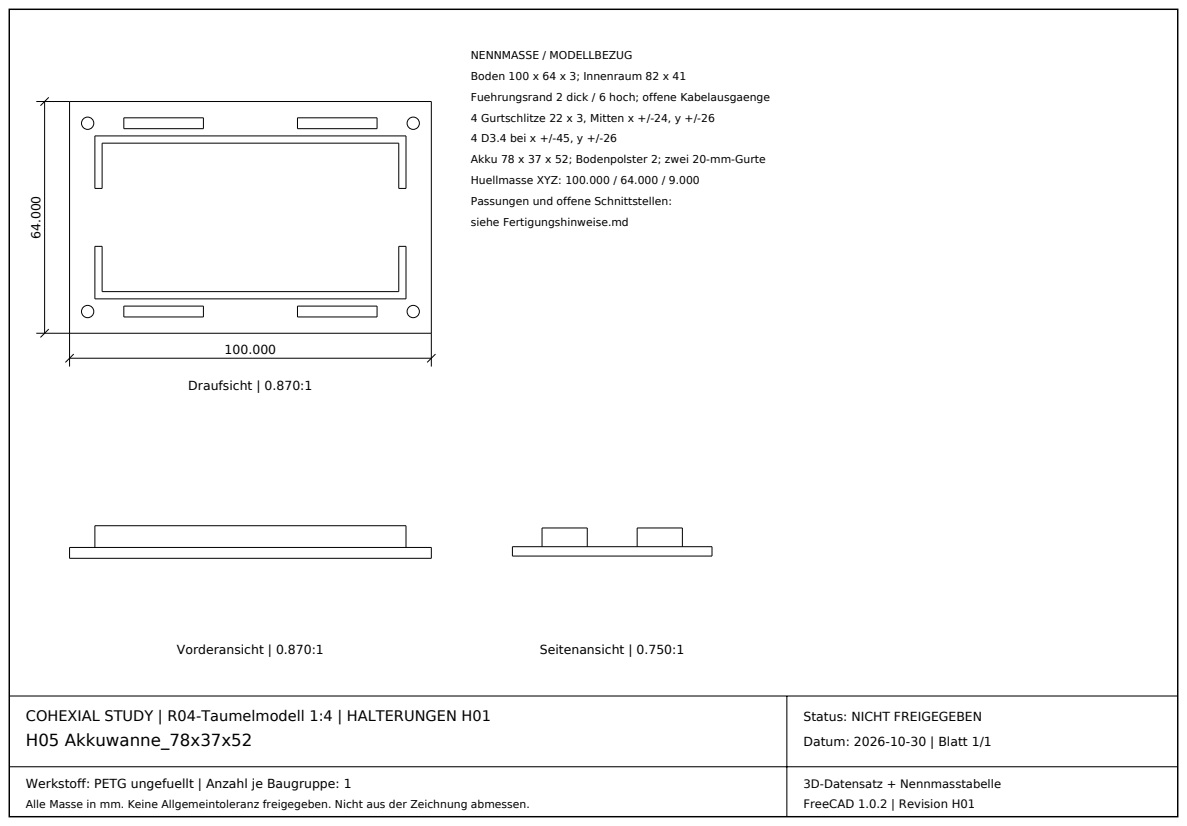
[picture p286: page 5]
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

NENNMASSE / MODELLBEZUG
Boden 100 x 64 x 3; Innenraum 82 x 41
Fuehrungsrand 2 dick / 6 hoch; offene Kabelausgaenge
4 Gurtschlitze 22 x 3, Mitten x +/-24, y +/-26
4 D3.4 bei x +/-45, y +/-26
Akku 78 x 37 x 52; Bodenpolster 2; zwei 20-mm-Gurte
Huellmasse XYZ: 100.000 / 64.000 / 9.000
Passungen und offene Schnittstellen:
siehe Fertigungshinweise.md

COHEXIAL STUDY | R04-Taumelmodell 1:4 | HALTERUNGEN H01
H05 Akkuwanne_78x37x52

Status: NICHT FREIGEGEBEN

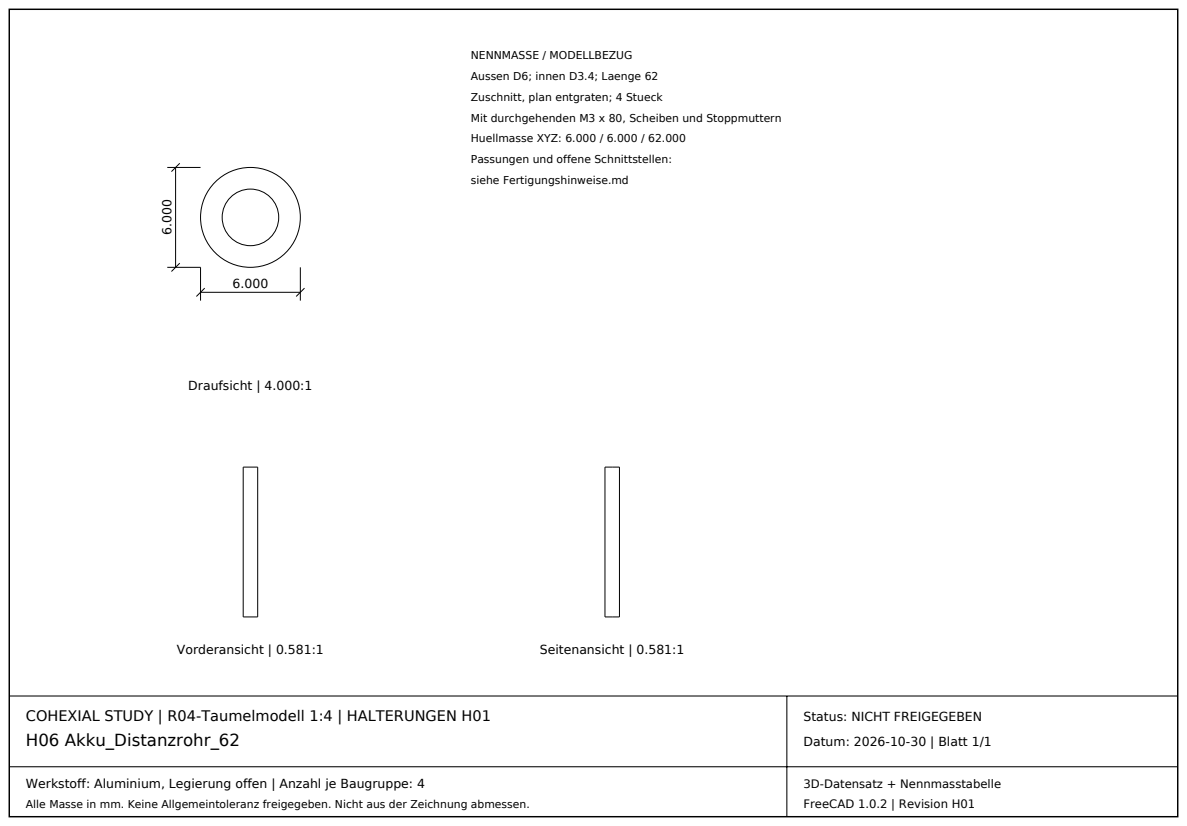
[picture p287: page 6]
Datum: 2026-10-30 | Blatt 1/1; Draufsicht | 4.000:1; Vorderansicht | 0.581:1; Seitenansicht | 0.581:1

NENNMASSE / MODELLBEZUG
Aussen D6; innen D3.4; Laenge 62
Zuschnitt, plan entgraten; 4 Stueck
Mit durchgehenden M3 x 80, Scheiben und Stoppmuttern
Huellmasse XYZ: 6.000 / 6.000 / 62.000
Passungen und offene Schnittstellen:
siehe Fertigungshinweise.md

COHEXIAL STUDY | R04-Taumelmodell 1:4 | HALTERUNGEN H01
H06 Akku_Distanzrohr_62

Status: NICHT FREIGEGEBEN

Werkstoff: Aluminium, Legierung offen | Anzahl je Baugruppe: 4

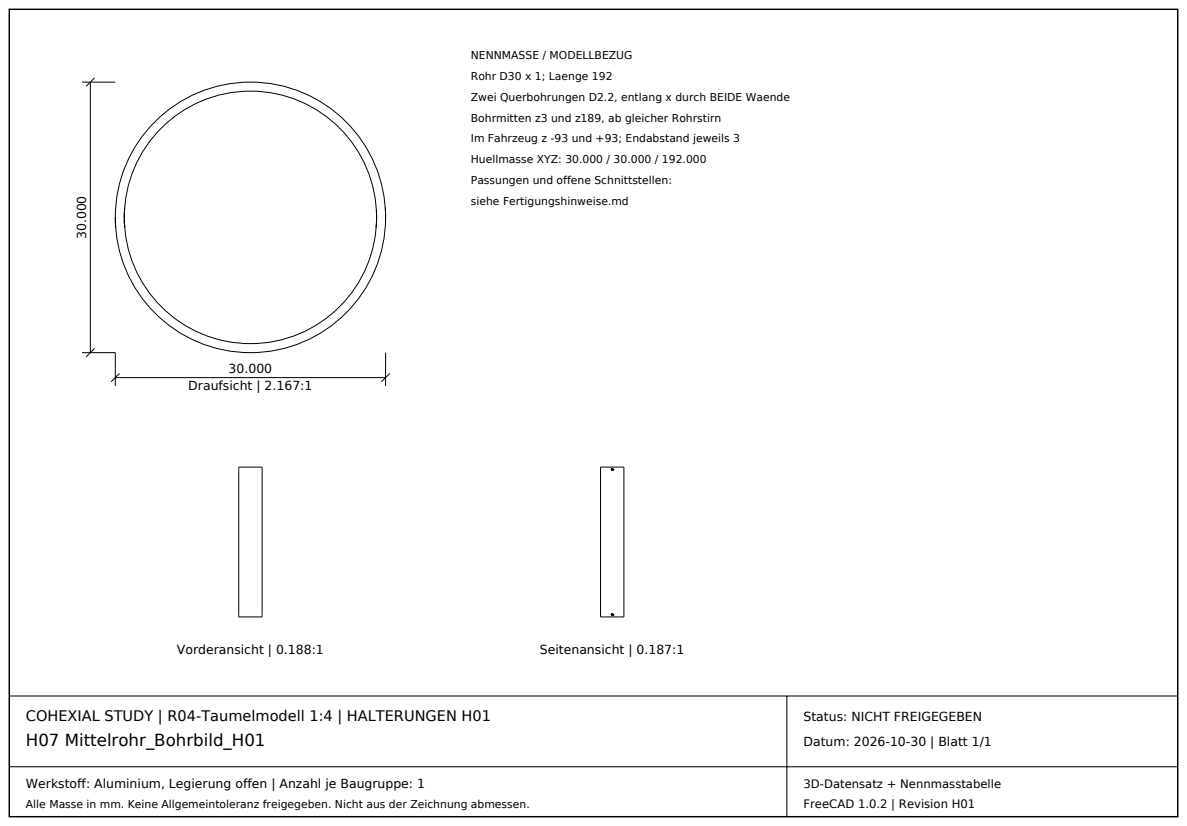
[picture p288: page 7]
Datum: 2026-10-30 | Blatt 1/1; Draufsicht | 2.167:1; Vorderansicht | 0.188:1; Seitenansicht | 0.187:1

NENNMASSE / MODELLBEZUG
Rohr D30 x 1; Laenge 192
Zwei Querbohrungen D2.2, entlang x durch BEIDE Waende
Bohrmitten z3 und z189, ab gleicher Rohrstirn
Im Fahrzeug z -93 und +93; Endabstand jeweils 3
Huellmasse XYZ: 30.000 / 30.000 / 192.000
Passungen und offene Schnittstellen:
siehe Fertigungshinweise.md

COHEXIAL STUDY | R04-Taumelmodell 1:4 | HALTERUNGEN H01
H07 Mittelrohr_Bohrbild_H01

Status: NICHT FREIGEGEBEN

Werkstoff: Aluminium, Legierung offen | Anzahl je Baugruppe: 1
