ITSMEEME/PropBoard/modell_r04_taumel/cad/Fertigung/Fertigungszeichnungen_F01.pdf

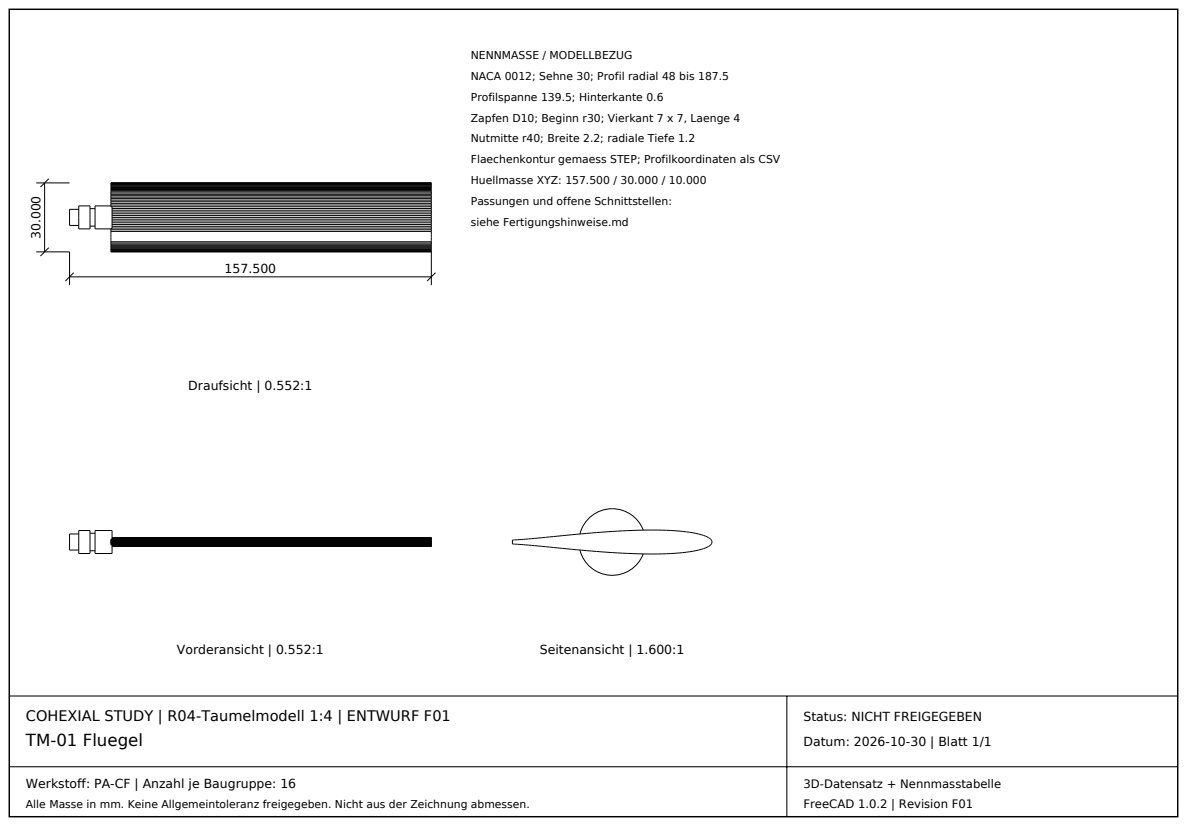
[picture p289: page 1]
Datum: 2026-10-30 | Blatt 1/1; 3D-Datensatz + Nennmasstabelle; FreeCAD 1.0.2 | Revision F01; Draufsicht | 0.552:1; Vorderansicht | 0.552:1; Seitenansicht | 1.600:1

NENNMASSE / MODELLBEZUG
NACA 0012; Sehne 30; Profil radial 48 bis 187.5
Profilspanne 139.5; Hinterkante 0.6
Zapfen D10; Beginn r30; Vierkant 7 x 7, Laenge 4
Nutmitte r40; Breite 2.2; radiale Tiefe 1.2
Flaechenkontur gemaess STEP; Profilkoordinaten als CSV
Huellmasse XYZ: 157.500 / 30.000 / 10.000
Passungen und offene Schnittstellen:
siehe Fertigungshinweise.md

COHEXIAL STUDY | R04-Taumelmodell 1:4 | ENTWURF F01
TM-01 Fluegel

Status: NICHT FREIGEGEBEN

Werkstoff: PA-CF | Anzahl je Baugruppe: 16

Alle Masse in mm. Keine Allgemeintoleranz freigegeben. Nicht aus der Zeichnung abmessen.

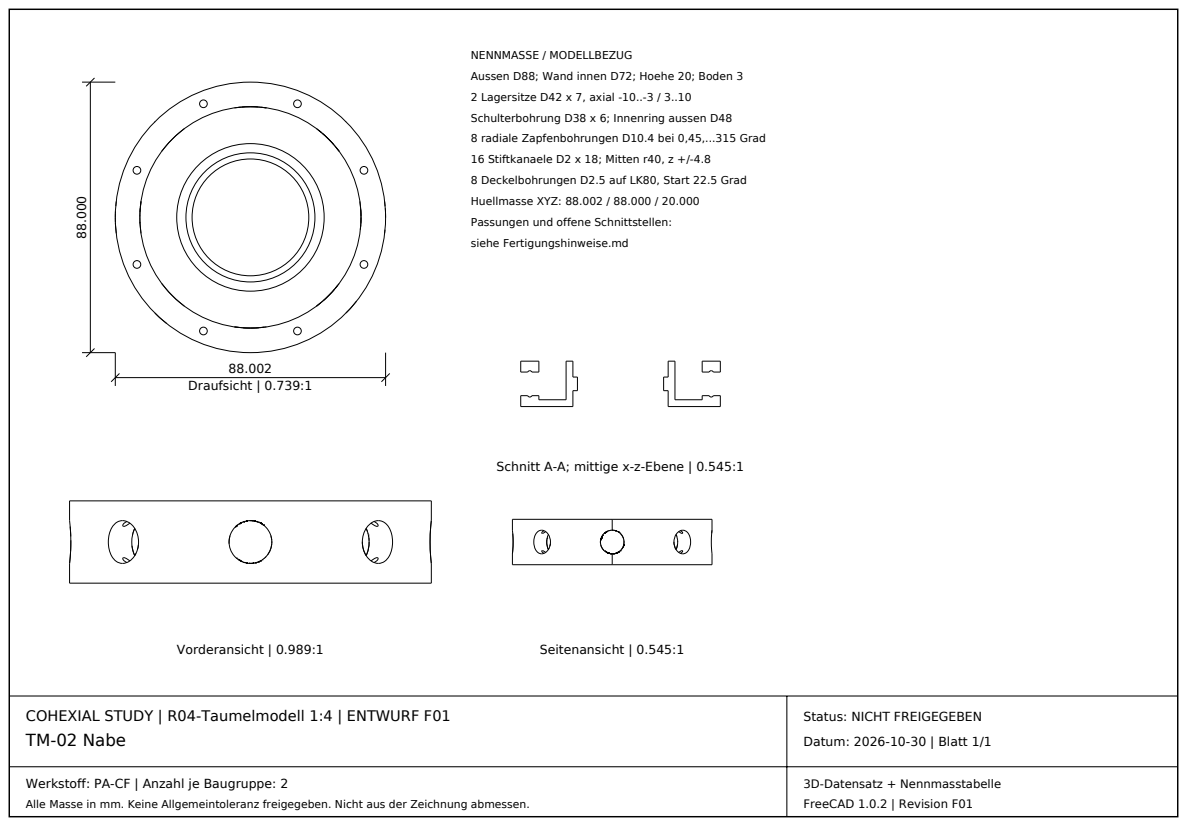
[picture p290: page 2]
Datum: 2026-10-30 | Blatt 1/1; Draufsicht | 0.739:1; Vorderansicht | 0.989:1; Seitenansicht | 0.545:1

NENNMASSE / MODELLBEZUG
Aussen D88; Wand innen D72; Hoehe 20; Boden 3
2 Lagersitze D42 x 7, axial -10..-3 / 3..10
Schulterbohrung D38 x 6; Innenring aussen D48
8 radiale Zapfenbohrungen D10.4 bei 0,45,...315 Grad
16 Stiftkanaele D2 x 18; Mitten r40, z +/-4.8
8 Deckelbohrungen D2.5 auf LK80, Start 22.5 Grad
Huellmasse XYZ: 88.002 / 88.000 / 20.000
Passungen und offene Schnittstellen:
siehe Fertigungshinweise.md

Schnitt A-A; mittige x-z-Ebene | 0.545:1

COHEXIAL STUDY | R04-Taumelmodell 1:4 | ENTWURF F01
TM-02 Nabe

Status: NICHT FREIGEGEBEN

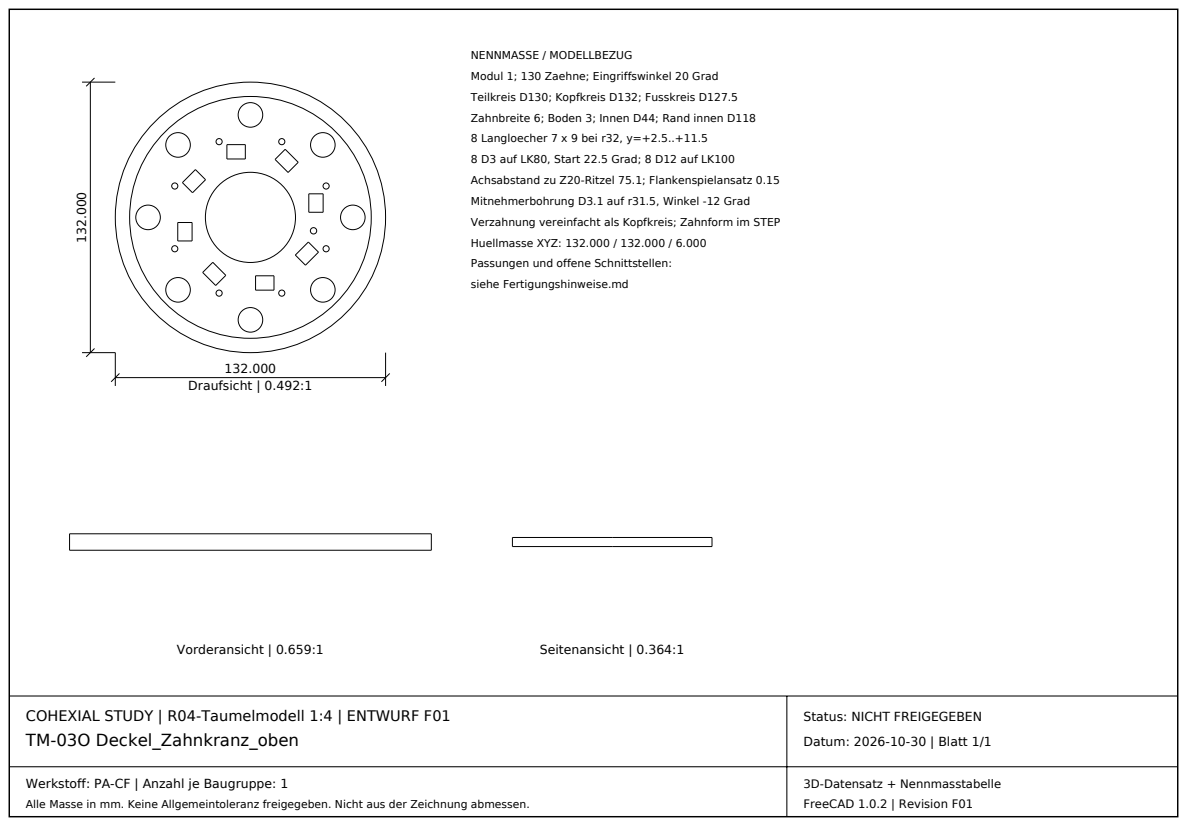
[picture p291: page 3]
Datum: 2026-10-30 | Blatt 1/1; Draufsicht | 0.492:1; Vorderansicht | 0.659:1; Seitenansicht | 0.364:1

NENNMASSE / MODELLBEZUG
Modul 1; 130 Zaehne; Eingriffswinkel 20 Grad
Teilkreis D130; Kopfkreis D132; Fusskreis D127.5
Zahnbreite 6; Boden 3; Innen D44; Rand innen D118
8 Langloecher 7 x 9 bei r32, y=+2.5..+11.5
8 D3 auf LK80, Start 22.5 Grad; 8 D12 auf LK100
Achsabstand zu Z20-Ritzel 75.1; Flankenspielansatz 0.15
Mitnehmerbohrung D3.1 auf r31.5, Winkel -12 Grad
Verzahnung vereinfacht als Kopfkreis; Zahnform im STEP
Huellmasse XYZ: 132.000 / 132.000 / 6.000
Passungen und offene Schnittstellen:
siehe Fertigungshinweise.md

COHEXIAL STUDY | R04-Taumelmodell 1:4 | ENTWURF F01
TM-03O Deckel_Zahnkranz_oben

Status: NICHT FREIGEGEBEN

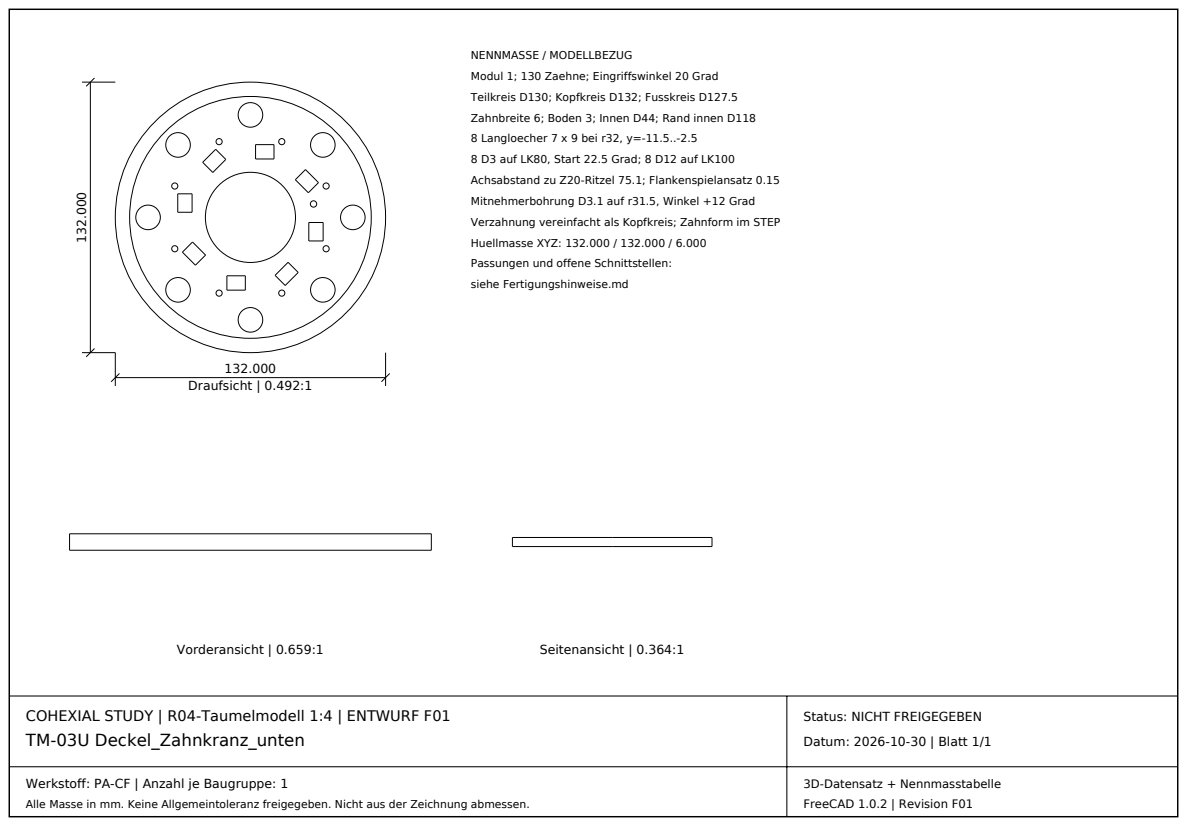
[picture p292: page 4]
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

NENNMASSE / MODELLBEZUG
Modul 1; 130 Zaehne; Eingriffswinkel 20 Grad
Teilkreis D130; Kopfkreis D132; Fusskreis D127.5
Zahnbreite 6; Boden 3; Innen D44; Rand innen D118
8 Langloecher 7 x 9 bei r32, y=-11.5..-2.5
8 D3 auf LK80, Start 22.5 Grad; 8 D12 auf LK100
Achsabstand zu Z20-Ritzel 75.1; Flankenspielansatz 0.15
Mitnehmerbohrung D3.1 auf r31.5, Winkel +12 Grad
Verzahnung vereinfacht als Kopfkreis; Zahnform im STEP
Huellmasse XYZ: 132.000 / 132.000 / 6.000
Passungen und offene Schnittstellen:
siehe Fertigungshinweise.md

COHEXIAL STUDY | R04-Taumelmodell 1:4 | ENTWURF F01
TM-03U Deckel_Zahnkranz_unten

Status: NICHT FREIGEGEBEN

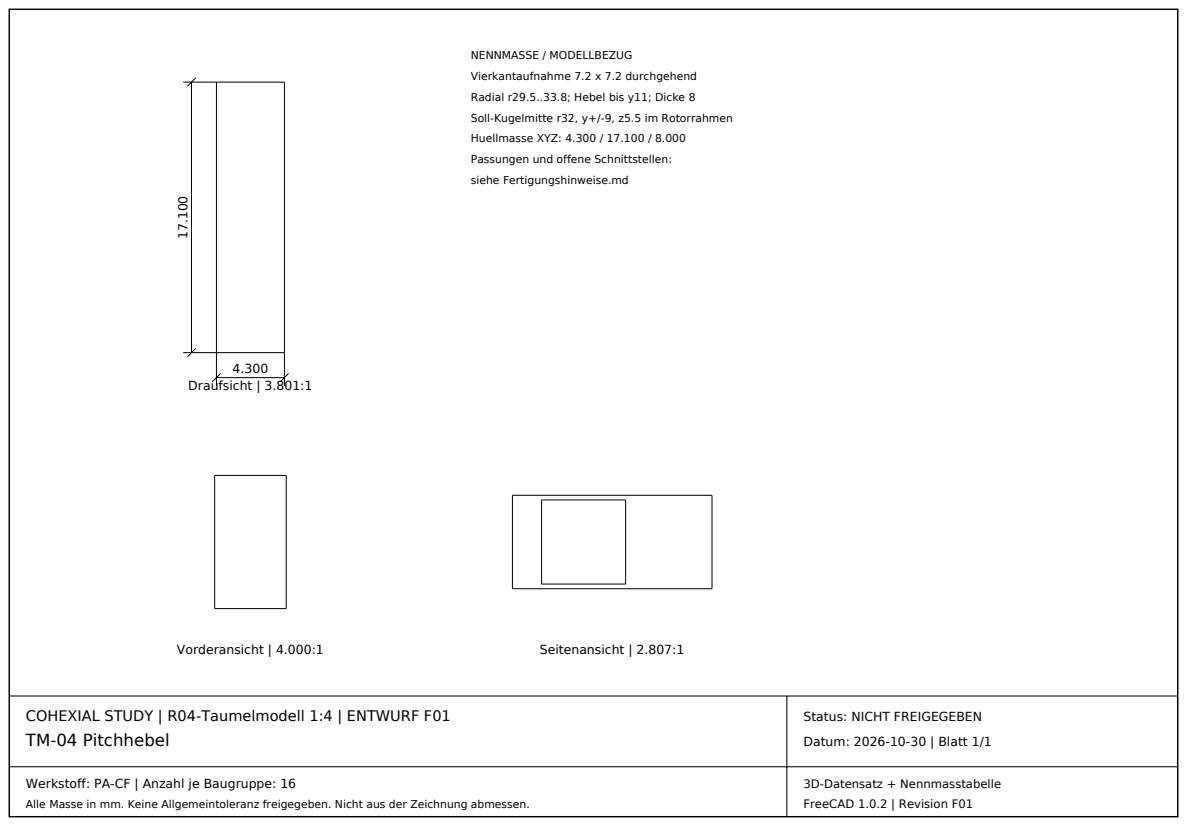
[picture p293: page 5]
Datum: 2026-10-30 | Blatt 1/1; Draufsicht | 3.801:1; Vorderansicht | 4.000:1; Seitenansicht | 2.807:1

NENNMASSE / MODELLBEZUG
Vierkantaufnahme 7.2 x 7.2 durchgehend
Radial r29.5..33.8; Hebel bis y11; Dicke 8
Soll-Kugelmitte r32, y+/-9, z5.5 im Rotorrahmen
Huellmasse XYZ: 4.300 / 17.100 / 8.000
Passungen und offene Schnittstellen:
siehe Fertigungshinweise.md

COHEXIAL STUDY | R04-Taumelmodell 1:4 | ENTWURF F01
TM-04 Pitchhebel

Status: NICHT FREIGEGEBEN

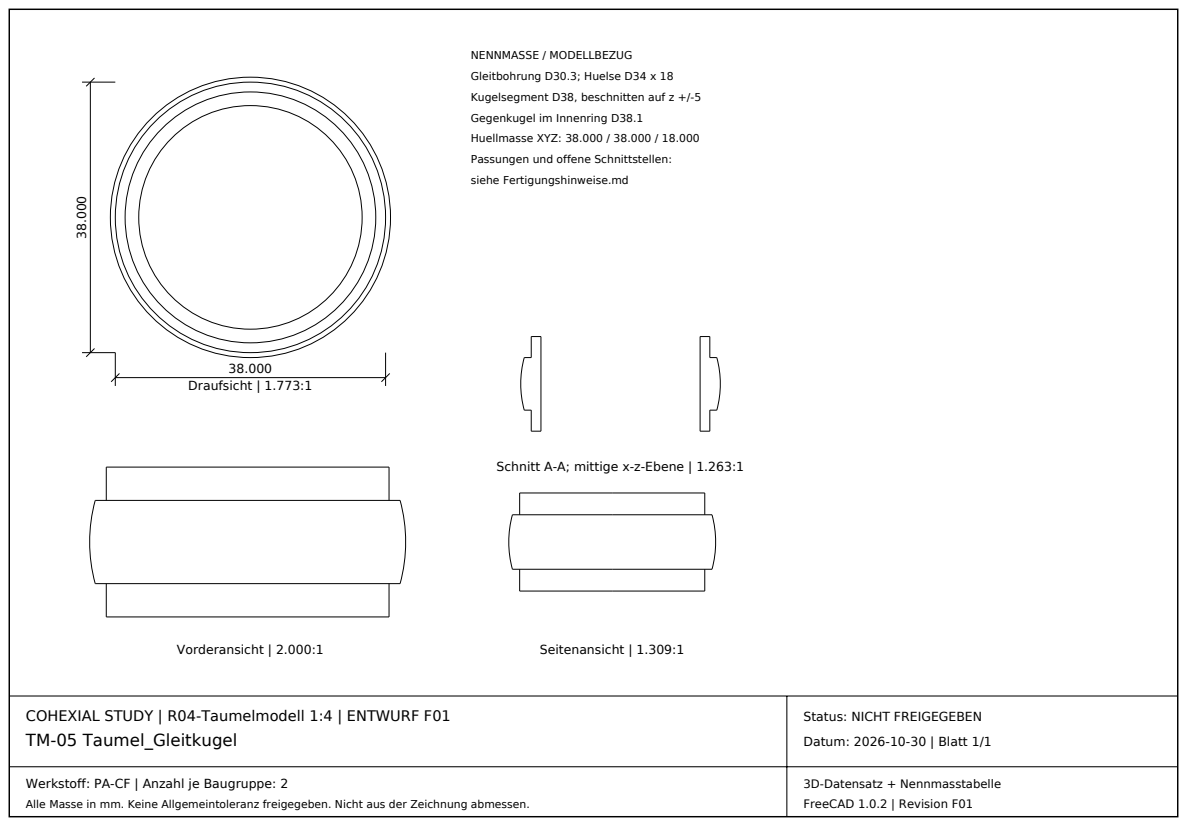
[picture p294: page 6]
Datum: 2026-10-30 | Blatt 1/1; Draufsicht | 1.773:1; Vorderansicht | 2.000:1; Seitenansicht | 1.309:1

NENNMASSE / MODELLBEZUG
Gleitbohrung D30.3; Huelse D34 x 18
Kugelsegment D38, beschnitten auf z +/-5
Gegenkugel im Innenring D38.1
Huellmasse XYZ: 38.000 / 38.000 / 18.000
Passungen und offene Schnittstellen:
siehe Fertigungshinweise.md

Schnitt A-A; mittige x-z-Ebene | 1.263:1

COHEXIAL STUDY | R04-Taumelmodell 1:4 | ENTWURF F01
TM-05 Taumel_Gleitkugel

Status: NICHT FREIGEGEBEN

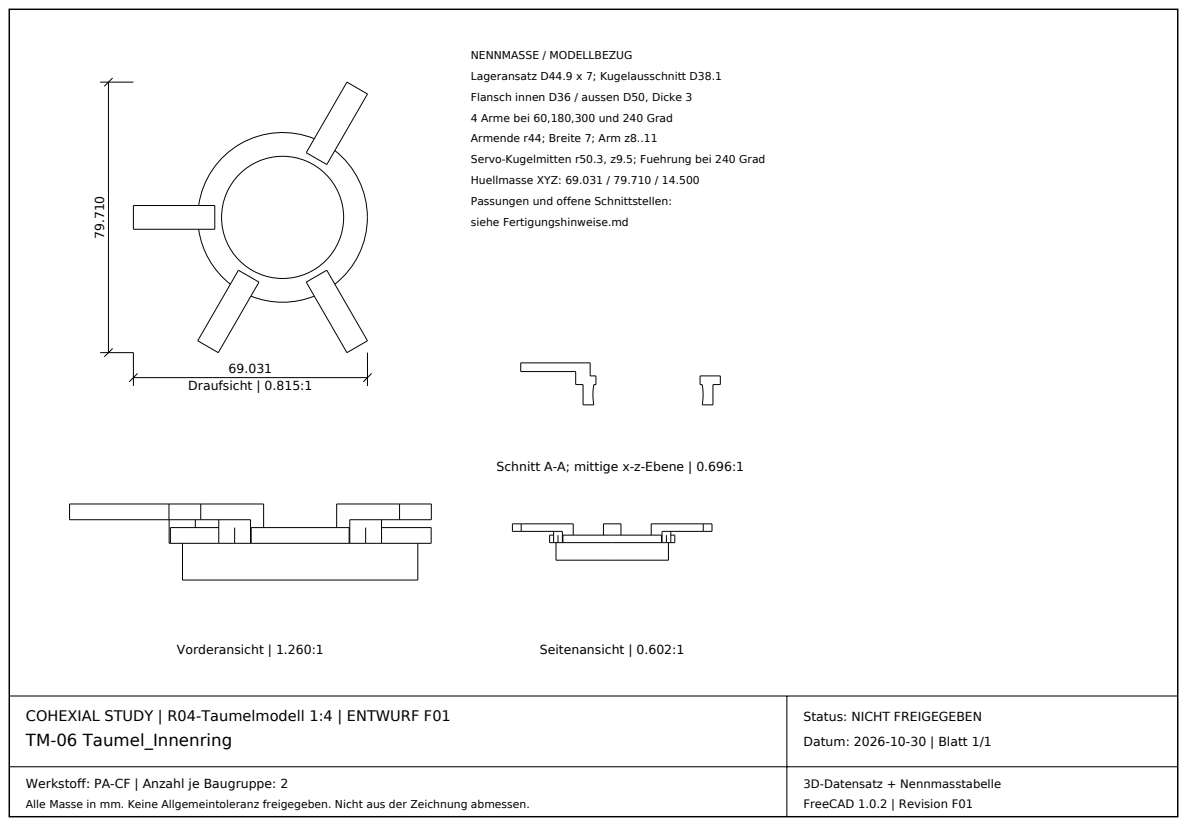
[picture p295: page 7]
Datum: 2026-10-30 | Blatt 1/1; Draufsicht | 0.815:1; Vorderansicht | 1.260:1; Seitenansicht | 0.602:1

NENNMASSE / MODELLBEZUG
Lageransatz D44.9 x 7; Kugelausschnitt D38.1
Flansch innen D36 / aussen D50, Dicke 3
4 Arme bei 60,180,300 und 240 Grad
Armende r44; Breite 7; Arm z8..11
Servo-Kugelmitten r50.3, z9.5; Fuehrung bei 240 Grad
Huellmasse XYZ: 69.031 / 79.710 / 14.500
Passungen und offene Schnittstellen:
siehe Fertigungshinweise.md

Schnitt A-A; mittige x-z-Ebene | 0.696:1

COHEXIAL STUDY | R04-Taumelmodell 1:4 | ENTWURF F01
TM-06 Taumel_Innenring

Status: NICHT FREIGEGEBEN

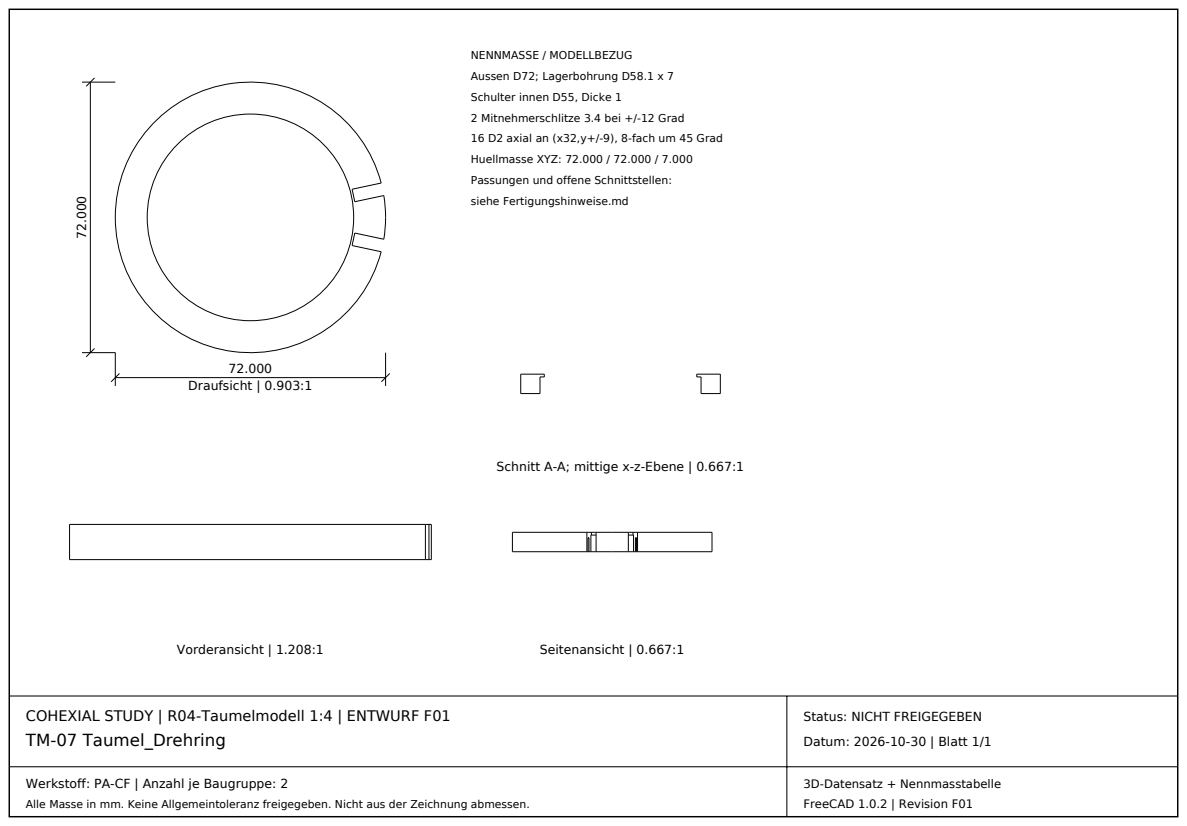
[picture p296: page 8]
Datum: 2026-10-30 | Blatt 1/1; Draufsicht | 0.903:1; Vorderansicht | 1.208:1; Seitenansicht | 0.667:1

NENNMASSE / MODELLBEZUG
Aussen D72; Lagerbohrung D58.1 x 7
Schulter innen D55, Dicke 1
2 Mitnehmerschlitze 3.4 bei +/-12 Grad
16 D2 axial an (x32,y+/-9), 8-fach um 45 Grad
Huellmasse XYZ: 72.000 / 72.000 / 7.000
Passungen und offene Schnittstellen:
siehe Fertigungshinweise.md

Schnitt A-A; mittige x-z-Ebene | 0.667:1

COHEXIAL STUDY | R04-Taumelmodell 1:4 | ENTWURF F01
TM-07 Taumel_Drehring

Status: NICHT FREIGEGEBEN

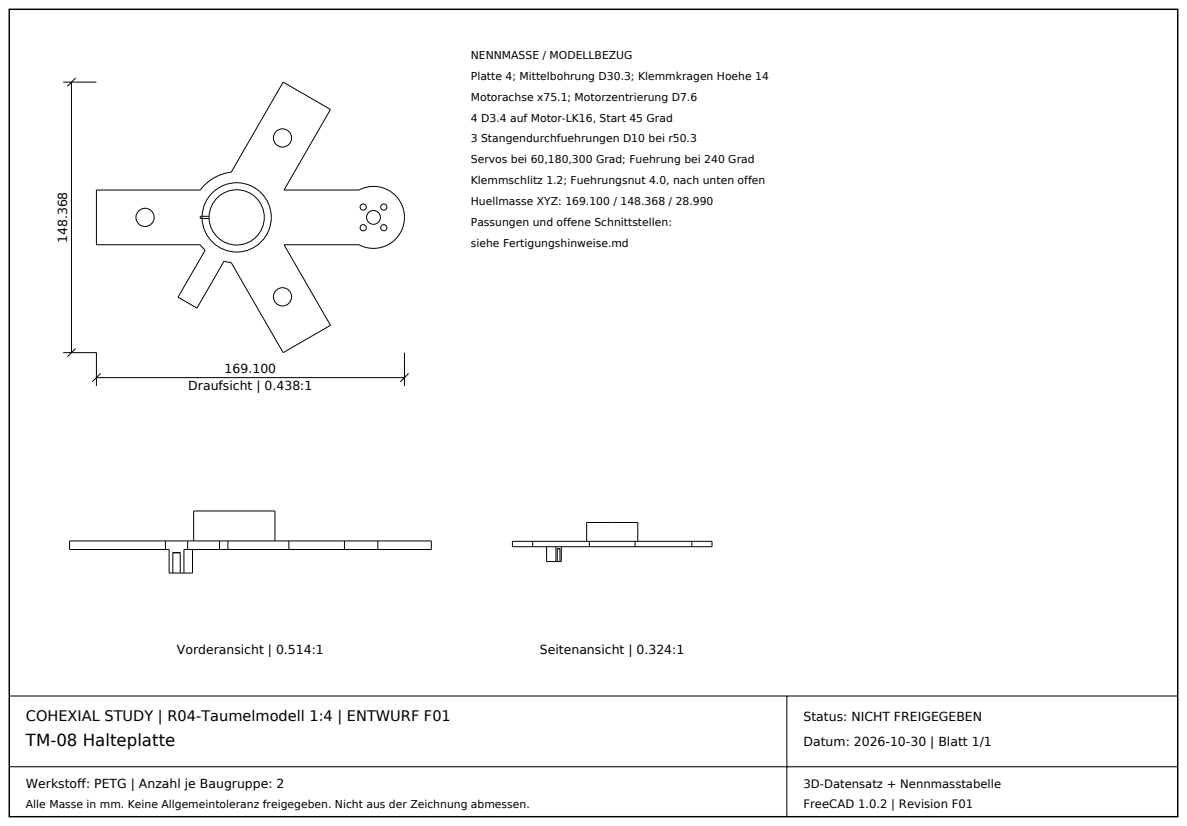
[picture p297: page 9]
Datum: 2026-10-30 | Blatt 1/1; Draufsicht | 0.438:1; Vorderansicht | 0.514:1; Seitenansicht | 0.324:1

NENNMASSE / MODELLBEZUG
Platte 4; Mittelbohrung D30.3; Klemmkragen Hoehe 14
Motorachse x75.1; Motorzentrierung D7.6
4 D3.4 auf Motor-LK16, Start 45 Grad
3 Stangendurchfuehrungen D10 bei r50.3
Servos bei 60,180,300 Grad; Fuehrung bei 240 Grad
Klemmschlitz 1.2; Fuehrungsnut 4.0, nach unten offen
Huellmasse XYZ: 169.100 / 148.368 / 28.990
Passungen und offene Schnittstellen:
siehe Fertigungshinweise.md

COHEXIAL STUDY | R04-Taumelmodell 1:4 | ENTWURF F01
TM-08 Halteplatte

Status: NICHT FREIGEGEBEN

Werkstoff: PETG | Anzahl je Baugruppe: 2

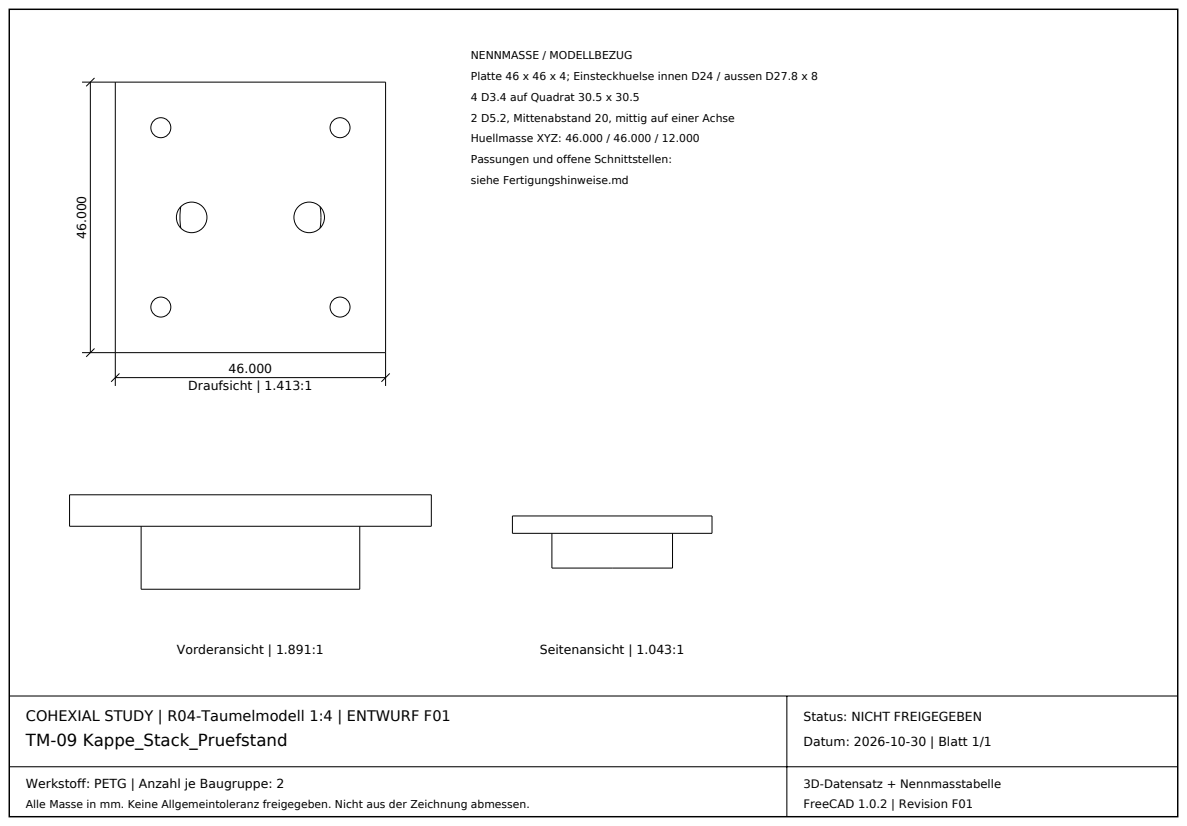
[picture p298: page 10]
Datum: 2026-10-30 | Blatt 1/1; Draufsicht | 1.413:1; Vorderansicht | 1.891:1; Seitenansicht | 1.043:1

NENNMASSE / MODELLBEZUG
Platte 46 x 46 x 4; Einsteckhuelse innen D24 / aussen D27.8 x 8
4 D3.4 auf Quadrat 30.5 x 30.5
2 D5.2, Mittenabstand 20, mittig auf einer Achse
Huellmasse XYZ: 46.000 / 46.000 / 12.000
Passungen und offene Schnittstellen:
siehe Fertigungshinweise.md

COHEXIAL STUDY | R04-Taumelmodell 1:4 | ENTWURF F01
TM-09 Kappe_Stack_Pruefstand

Status: NICHT FREIGEGEBEN

Werkstoff: PETG | Anzahl je Baugruppe: 2

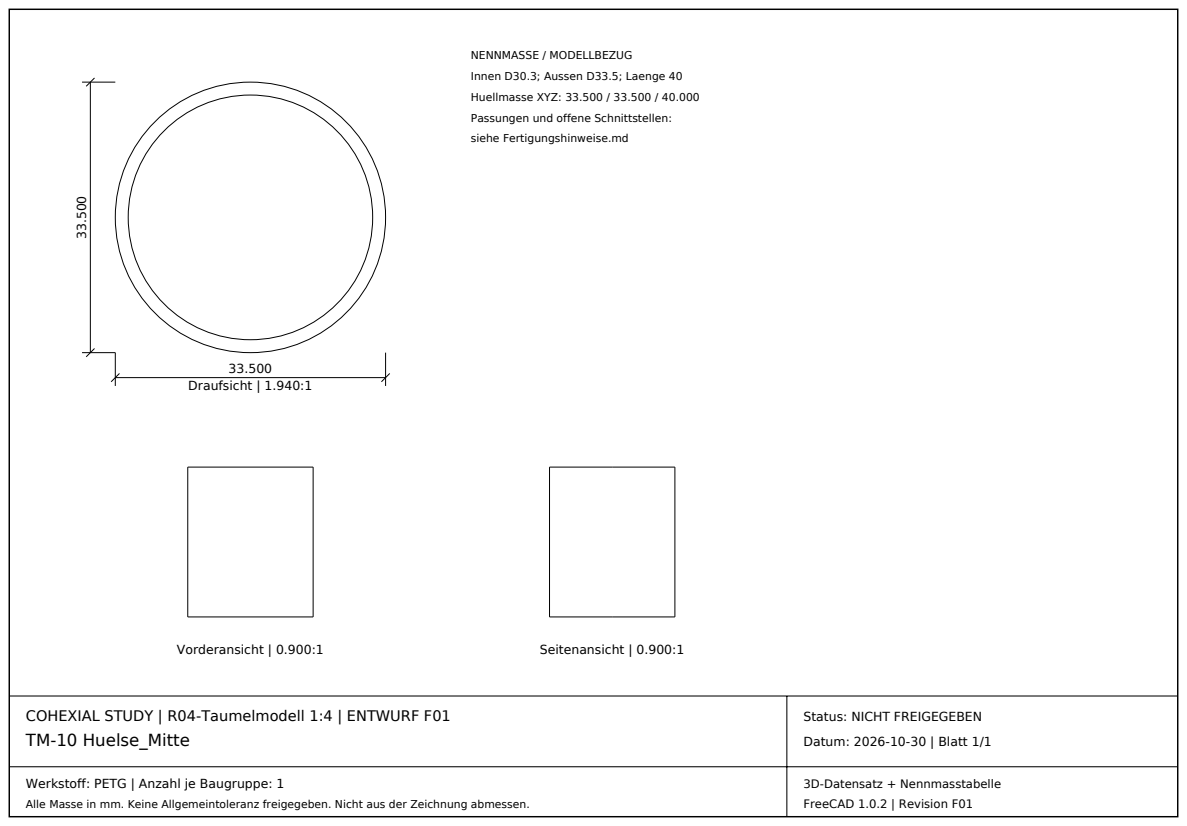
[picture p299: page 11]
Datum: 2026-10-30 | Blatt 1/1; Draufsicht | 1.940:1; Vorderansicht | 0.900:1; Seitenansicht | 0.900:1

NENNMASSE / MODELLBEZUG
Innen D30.3; Aussen D33.5; Laenge 40
Huellmasse XYZ: 33.500 / 33.500 / 40.000
Passungen und offene Schnittstellen:
siehe Fertigungshinweise.md

COHEXIAL STUDY | R04-Taumelmodell 1:4 | ENTWURF F01
TM-10 Huelse_Mitte

Status: NICHT FREIGEGEBEN

Werkstoff: PETG | Anzahl je Baugruppe: 1

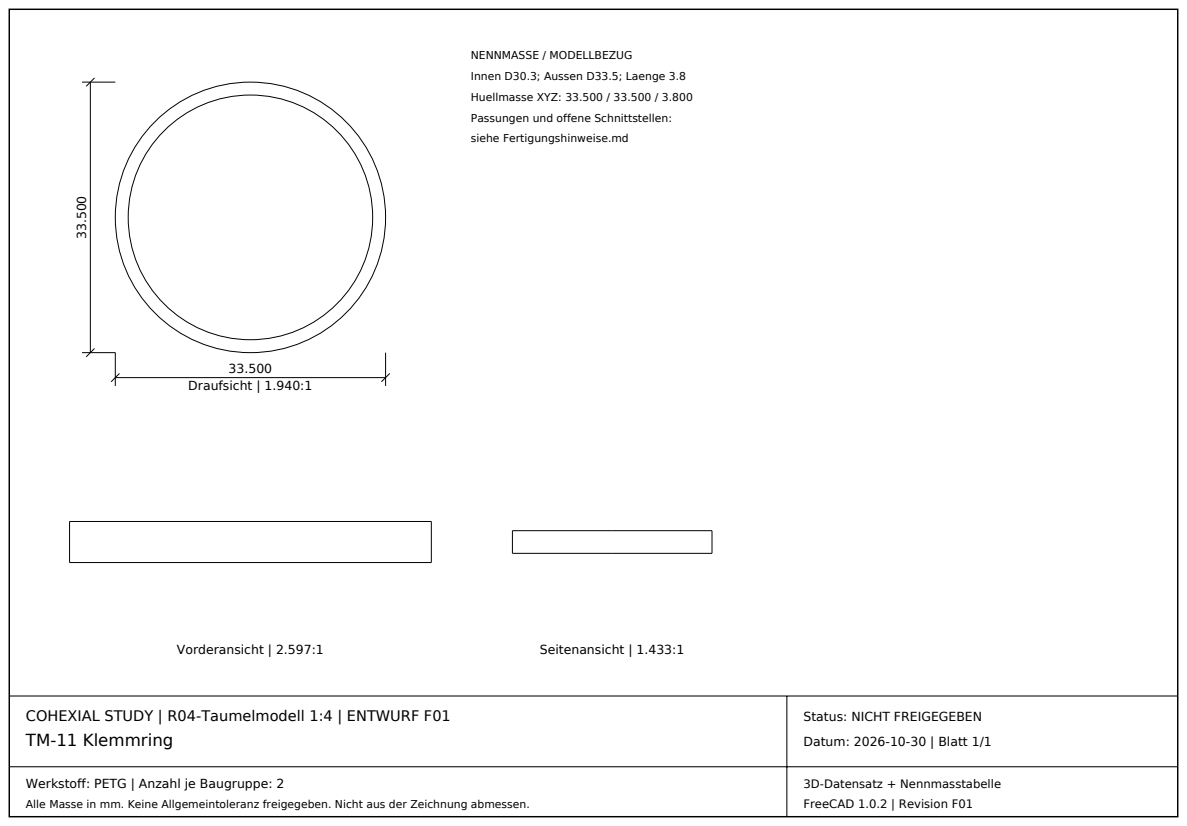
[picture p300: page 12]
Datum: 2026-10-30 | Blatt 1/1; Draufsicht | 1.940:1; Vorderansicht | 2.597:1; Seitenansicht | 1.433:1

NENNMASSE / MODELLBEZUG
Innen D30.3; Aussen D33.5; Laenge 3.8
Huellmasse XYZ: 33.500 / 33.500 / 3.800
Passungen und offene Schnittstellen:
siehe Fertigungshinweise.md

COHEXIAL STUDY | R04-Taumelmodell 1:4 | ENTWURF F01
TM-11 Klemmring

Status: NICHT FREIGEGEBEN

Werkstoff: PETG | Anzahl je Baugruppe: 2

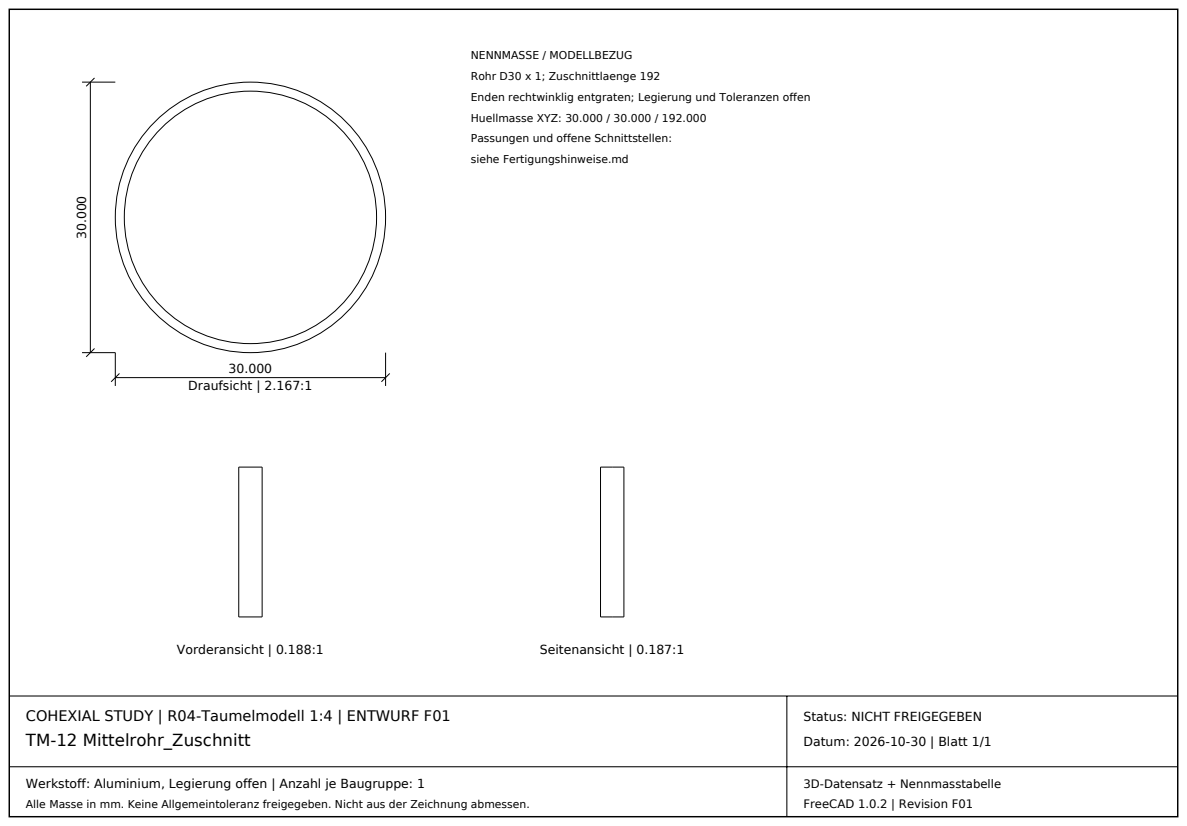
[picture p301: page 13]
Datum: 2026-10-30 | Blatt 1/1; Draufsicht | 2.167:1; Vorderansicht | 0.188:1; Seitenansicht | 0.187:1

NENNMASSE / MODELLBEZUG
Rohr D30 x 1; Zuschnittlaenge 192
Enden rechtwinklig entgraten; Legierung und Toleranzen offen
Huellmasse XYZ: 30.000 / 30.000 / 192.000
Passungen und offene Schnittstellen:
siehe Fertigungshinweise.md

COHEXIAL STUDY | R04-Taumelmodell 1:4 | ENTWURF F01
TM-12 Mittelrohr_Zuschnitt

Status: NICHT FREIGEGEBEN

Werkstoff: Aluminium, Legierung offen | Anzahl je Baugruppe: 1
