ITSMEEME/PropBoard/quad_r380_d05/motorbetrieb_pruefen.py

"""Conditional constraints of the user-selected legacy motor, not a flight release."""
from pathlib import Path
import json,math
H=Path(__file__).resolve().parent;O=H/'Ausgabe';motor=json.loads((H/'Quellen/MN1330/Motor_Daten.json').read_text());r=json.loads((O/'Status.json').read_text());demand=json.loads((H.parent/'quad_r380_d01/Ausgabe/Antriebsanforderungen.json').read_text());basic=motor['basic'];kv=basic['kv'];series=basic['series_cells'];radius=.38;area=4*math.pi*radius**2;rho=1.225;power=4*basic['max_power_180s_W'];cases=[]
for mass in [100+r['mass_modeled_kg'],150,175,200]:
 ideal=(mass*9.81)**1.5/math.sqrt(2*rho*area);cases.append(dict(mass_kg=mass,ideal_hover_shaft_lower_bound_kW=ideal/1000,above_four_3400W=ideal>power))
v=dict(selected_motor='MN1330 KV40',motor_choice_fixed_by_user=True,series_cells_reference=series,full_cell_voltage_reference_V=4.2,nominal_cell_voltage_assumed_V=3.6,full_pack_V=series*4.2,nominal_pack_V=series*3.6,ideal_no_load_full_rpm=kv*series*4.2,ideal_no_load_nominal_rpm=kv*series*3.6,reference_r380_hover_rpm=[x['rpm'] for x in demand],reference_r380_scope='Prior assumed3-blade model, not a measured real rotor',motor_power_3400W_duration_s=180,motor_power_3400W_side_unknown=True,maximum_bench_input_W=max(x['input_power_W'] for x in motor['test']['points']),maximum_bench_duration_s=motor['test']['duration_s'],continuous_rating_verified=False,ideal_disk_area_m2=area,ideal_air_density_kg_m3=rho,ideal_hover_cases=cases,ideal_hover_out_of_ground_effect=True,ideal_hover_no_external_lift=True,ideal_hover_ignores_profile_swirl_and_electrical_losses=True,flight_release=False,interpretation='Old R3803-blade rpm demand exceeds KV40 no-load speed at24S. Even granting3400W as shaft power, four motors provide13.6kW in that reference case, below the ideal hover lower bound at modeled partial vehicle mass. Higher bench points have unknown duration and do not prove continuous operation.')
(O/'MN1330_Betriebsgrenzen.json').write_text(json.dumps(v,indent=2,ensure_ascii=False));print('Legacy motor conditional bounds updated')
