ITSMEEME/PropBoard/(commit log)

2026-10-29 Add PropBoard CAD models, CFD studies and construction documentation
    [00_PropBoard_Detail_Stehen.FCStd, 00_PropBoard_Detail_Stehen.step, 01_CFK_Rahmen.FCStd, 01_CFK_Rahmen.step, 02_Fuehrung_Antrieb_Detail.FCStd, 02_Fuehrung_Antrieb_Detail.step, 02a_Schlitten_Detail.FCStd, 02a_Schlitten_Detail.step]
2026-10-29 Detail Horizontal Z R02 assembly and document feasibility limits
    Add native FreeCAD assemblies, STEP exports, connection and screw registers, reference drawings, verified review archive and technical reports. Document the unproven payload and power targets and remaining manufacturing interfaces.
    [00_Horizontal_Z_R02_Montage.FCStd, 00_Horizontal_Z_R02_Montage.step, 01a_Rahmenknoten_Detail.FCStd, 01a_Rahmenknoten_Detail.step, 01b_Rahmenknoten_Explodiert.FCStd, 01b_Rahmenknoten_Explodiert.step, 02_Schlitten_R02_Detail.FCStd, 02_Schlitten_R02_Detail.step]
2026-10-30 Reconstruct Kreis R03/R04 circular-track revisions (CFD study incomplete)
    The original R03/R04 working state lived in an unreachable cloud workspace
    and was never pushed; it could not be found or backed up. This commit is a
    labelled reconstruction from the hand-over description:
    - kreis_r03: geometric R02/R03 comparison (-26.1 % swept area per level),
    FreeCAD layout model from the saved R02 files (1744 result bodies).
    - kreis_r04: shared profile with 0.8 mm trailing edge, two FreeCAD variants
    (with outer ring 1744 bodies; without 948, 796 removed, 16 motor/encoder
    envelopes mirrored inward), wing position/clearance check, mass scenarios
    (312 analytic cases), Euler-Bernoulli shaft mo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
    [Auftriebsanforderungen.csv, CAD_Volumen.csv, CFD_Ergebnisse.csv, Kreis_R03_Layout.FCStd, Kreis_R03_Layout.step, Kreis_R04_Aussenring.FCStd, Kreis_R04_Aussenring.step, Kreis_R04_ohne_Aussenring.FCStd]
2026-10-30 taumel cohexial study
    [Feststehend_Druck.stl, Feststehend_Kauf.stl, Fluegel.stl, Halteplatte.stl, Huelse_Aussen.stl, Huelse_Mitte.stl, Mitnehmer.stl, Nabe.stl]
2026-10-30 Create FreeCAD manufacturing draft F01 for coaxial swashplate model
    [Deckel_Zahnkranz_130Z_m1_oben.stl, Deckel_Zahnkranz_130Z_m1_unten.stl, Druckorientierung.csv, Fertigungsstueckliste.csv, Fluegel.stl, Halteplatte.stl, Huelse_Mitte.stl, Kappe_Stack_Pruefstand.stl]
2026-10-30 Add H01 electronics and battery holders with independent mechanism audit
    [H01_Rohr_Endadapter.FCStd, H01_Rohr_Endadapter.step, H01_Rohr_Endadapter.stl, H02_ESC_Distanz_12.FCStd, H02_ESC_Distanz_12.step, H02_ESC_Distanz_12.stl, H03_FC_Distanz_14_4.FCStd, H03_FC_Distanz_14_4.step]
2026-10-30 Add R04 motion and flight simulation with purchased-part CAD and P05 motor interfaces
    [9g_Servo_hohe_Reibung.json, Aero_Vorlage.csv, Cohexial_R04_M01_Bewegung.FCStd, Cohexial_R04_M01_Neutral.step, EMAX_ECOII2306_Anschlussmodell_P04.FCStd, EMAX_ECOII2306_Anschlussmodell_P04.step, EMAX_ECOII2306_Anschlussmodell_P05.step, Fertigungsstatus_P02.csv]
2026-10-30 Add continuous servo-to-blade CAD animation and detailed linkage models
    [Axialscheibe.step, Axialschraube.step, Bauteile_und_offene_Fertigungspunkte.csv, Drehring_oben.step, Gelenktraeger_oben.step, Gewindeeinsatz.step, Haltekappe.step, Kugelbolzen.step]
2026-10-31 Add P10: servo mounts, ring-gear planetary stage, wiring harness, landing gear and 3D flight simulator
    CAD (modell_r04_taumel/integration_p10, FreeCAD 1.0.2, native P10 assembly):
    - Servo brackets: the six SB-2270SG+ servos no longer float. Their tabs are
    bolted (4x M3x12) to a printed web, which stands on feet bolted to new
    servo outriggers on the regenerated mounting plate. Load path runs to the
    centre tube. Tab dimensions measured from the supplied STEP.
    - Planetary stage: internal ring gear Z130 (m1) in the rotor lid replaces the
    one-sided external mesh.
    - Driven planet is the existing EMAX pinion on the motor, now at
    r=54.8 mm / 330 deg on a motor bridge.
    - Two POM idler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
    [9g_Servo_hohe_Reibung.json, Deckel_Hohlrad_Z130_oben.step, Fahrwerksknoten.step, H01_P10_Kabeldurchfuehrung.step, H04_P10.step, Halteplatte_P10.step, Kabelliste_P10.csv, Kufe_CFK_8x6.step]
2026-10-31 Add simulator calibration, parameter studies, obstacles and Betaflight SITL
2026-10-31 Implement P11 direct drive and live visual physics bench
    [Kabelliste_P11.csv, Motoranforderungen_P11.json, P11_Distanz_Oben_0.step, P11_Distanz_Oben_1.step, P11_Distanz_Unten_0.step, P11_Distanz_Unten_1.step, P11_Exzenterbolzen_Oben_0.step, P11_Exzenterbolzen_Oben_1.step]
2026-11-01 Add parametric P12 CFK frame and local CFD optimization workflow
    [CFK-BRUECKE-END.step, CFK-BRUECKE-END.stl, CFK-BRUECKE-END_MX.step, CFK-BRUECKE-END_MX.stl, CFK-GUIDE-A.step, CFK-GUIDE-A.stl, CFK-GUIDE-B.step, CFK-GUIDE-B.stl]
2026-11-01 Add P13 mechanical RFQ design and P12 fastening geometry
    Integrate the supplied motor mounting drawing and add bearing, pitch, swashplate, actuator, CFK blade and landing-gear geometry with supplier inquiry files. Preserve the documented 32 open collisions, mass and size limits, and exclude the rejected P13 aggregate STEP. Include updated P12 fastening references and verified delivery archives.
    [Beschaffungsfamilien.csv, CFK-BRUECKE-END.step, CFK-BRUECKE-END.stl, CFK-GUIDE-A.step, CFK-GUIDE-A.stl, CFK-GUIDE-B.step, CFK-GUIDE-B.stl, CFK-GUIDE-FILM.step]
2026-11-01 Add P14 lightweight model with closed joints and assembly proofs
    Remove the outer frame and tip supports, strengthen the centre and retain
    root-mounted CFK blades with six PH54 servo references per rotor pair.
    Replace nominal links with 44 separable joints and make the bearing, shaft
    and root retention accessible for assembly. Add CAD mass and inertia for
    4/6/8/10/12 blades and a separate parameterized flight development bench.
    Include MN1330 data with the 180-second power qualifier, source-bound
    reports, native/STEP exports, assembly instructions and the portable ZIP.
    OEM servo interfaces, supplier profiles/tolerances and strength/fatigue
    qualification remain explicit release gates.
    Valid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
    [A01.step, A01.stl, A02.step, A02.stl, A03.step, A03.stl, A04.step, A04.stl]
2026-11-01 Add interactive P14 flight simulator with WASD controls
    Add position/angle flight control, takeoff and landing, keyboard, standard
    gamepad and multitouch input, follow/orbit cameras and navigation telemetry.
    Keep blade-count and rotor-pair changes tied to the actual CAD mass and
    inertia variants. Link the P14 simulator from H01 and the technical bench.
    Preserve documented MN1330 power/time limits and require explicit selection
    of free motor assumptions for training. Include operating instructions,
    source-bound test reports and the updated portable delivery package.
    Validation: 13 pilot/controller checks, 11 flight-browser checks, 19 existing
    physics/data checks and 9 technical-browser chec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
2026-11-02 Add propulsion study comparing 1 to 10 motors and rotor layouts
    [Batterie_Rueckkopplung.csv, Einzelrotoren_1_bis_10.csv, Einzelrotoren_Motorkombinationen.csv, Kompakt_Motorkombinationen.csv, Kompakte_Anordnungen.csv, Mischanordnungen.csv, Motorkombinationen.csv, Motormassen_Sensitivitaet.csv]
2026-11-02 Add P14 four-blade and quad/hexa CAD development with validation
    [Batterie_Rueckkopplung.csv, HEXA_R265.FCStd, HEXA_R265_B4.FCStd, HEXA_R265_B4_Rahmen.step, HEXA_R265_Rahmen.step, HEXA_R275.FCStd, HEXA_R275_Rahmen.step, Hochlauf_Screen.csv]
2026-11-04 Add detailed Quad CAD variants and HEP-S diameter study with verification limits
    [Blattstationen.csv, CFK_FILM.step, CFK_KLEMM_A.step, CFK_KLEMM_B.step, D02_ARM_TUBE.step, D02_CENTRAL_BOTTOM.step, D02_CENTRAL_TOP.step, D02_FOOT.step]
2026-11-04 Route DC and signal inside carbon arms and lighten frame nodes
    [Quad_HEPS_Innenverkabelung.FCStd]
2026-11-04 Add motor-near ESC mounts and verify all 50 configurations
    [ISO4762_M3x6.step, Quad_Motornahe_Reglerhalter.FCStd, iso4762def.csv]
2026-11-04 Add landing load study and parameterized internal cable harness
    [Landestoss_Uebersicht.csv, Lastfallmatrix_linear.csv, Pinbelegung.csv, Quad_Reglerhalter_Landefuesse.FCStd, Quad_Standardkabelbaum.FCStd, Statik_Uebersicht.csv, Zuschnitt.csv]
2026-11-04 Add photo-based propellers, scale human and checked lightweight arm joints
    [HEP_S_18_6p7_CCW.step, HEP_S_18_6p7_CW.step, HEP_S_22_7p2_CCW.step, HEP_S_22_7p2_CW.step, HEP_S_26_8p8_CCW.step, HEP_S_26_8p8_CW.step, HEP_S_28_9_CCW.step, HEP_S_28_9_CW.step]
2026-11-05 Add D14 multirotor layouts and global flight simulator
    D14: Quad/Hexa/Okto/Koax with paired V-arms in triangle connectors,
    motor mounts, adapted foot slider, corner feet at cube height,
    V200A ESC holders and D13 propellers; 120 configurations collision-checked.
    Flugsimulator: 6-DOF physics for all D14 models (BEMT rotors with VRS,
    stall, ground effect, coax/wake interference; fitted MN1330 motor;
    24-cell battery; Dryden wind and gusts; arm load limits; motor failure),
    status dashboard, test programs and hover analysis of all 120 models.
    Claude-Session: https://claude.ai/code/session_01XgfAnj1fD892Q9N7umyMFE
    [HEXA_HEP_S_42_16_V1.FCStd, HEXA_HEP_S_42_16_V1.step, HEXA_HEP_S_42_16_V2.FCStd, HEXA_HEP_S_42_16_V2.step, HEXA_HEP_S_42_16_V3.FCStd, HEXA_HEP_S_42_16_V3.step, KOAX_HEP_S_42_16_V1.FCStd, KOAX_HEP_S_42_16_V1.step]
